Seeed-Studio/OSHW-Jetson-Series/README.md

# Open Source Hardware - NVIDIA Jetson Carrier Board

Copyright (c) [Seeed Studio](https://www.seeedstudio.com/). All rights reserved.

<div align="center">
    
</div>

## Overview

This project contains the open-source hardware design files for Seeed Studio's **NVIDIA Jetson hardware series** — including the `reComputer` and `reServer` carrier boards, mini PCs, and industrial computers based on **Jetson Nano, Jetson Xavier NX, Jetson Orin NX/Orin Nano, Jetson AGX Orin, and Jetson AGX Thor**.

For every product you will find its **BRD / DSN circuit design source files** (created in Cadence **Allegro 17.4**), **visualized PDF schematics**, plus the full supporting resource set: **datasheets, 3D models, mechanical drawings (DXF), user manuals, firmware, and certifications** (CE / EUDOC / FCC / KC / ROHS / REACH / UKDOC / UKCA).

## Product Matrix

### reComputer Jetson carrier boards & mini PCs

| Product | README | Highlights |
|---|---|---|
| [reComputer Industrial J201](/reComputer%20Jetson%20carrier%20board/reComputer%20Industrial%20J201/) | [README](/reComputer%20Jetson%20carrier%20board/reComputer%20Industrial%20J201/README.md) | Industrial carrier board for Jetson Xavier NX / TX2 NX |
| [reComputer Industrial J30-J40](/reComputer%20Jetson%20carrier%20board/reComputer%20Industrial%20J30-J40/) | — | Industrial carrier board series for Jetson Orin NX / Orin Nano |
| [reComputer J202](/reComputer%20Jetson%20carrier%20board/reComputer%20J202/) | [README](/reComputer%20Jetson%20carrier%20board/reComputer%20J202/README.md) | Carrier board for Jetson Xavier NX / TX2 NX |
| [reComputer J301-J401](/reComputer%20Jetson%20carrier%20board/reComputer%20J301-J401/) | — | Carrier board for Jetson Orin NX / Orin Nano |
| [reComputer J401](/reComputer%20Jetson%20carrier%20board/reComputer%20J401/) | [README](/reComputer%20Jetson%20carrier%20board/reComputer%20J401/README.md) | Carrier board for Jetson Orin NX / Orin Nano |
| [reComputer J401B](/reComputer%20Jetson%20carrier%20board/reComputer%20J401B/) | — | Carrier board for Jetson Orin NX / Orin Nano |
| [reComputer J101](/reComputer%20Jetson%20carrier%20board/reComputer%20J101/) | — | Carrier board for Jetson Nano / TX2 NX |
| [reComputer J1010](/reComputer%20Jetson%20carrier%20board/reComputer%20J1010/) | — | Carrier board & mini PC for Jetson Nano |
| [reComputer J1020 v2](/reComputer%20Jetson%20carrier%20board/reComputer%20J1020%20v2/) | — | Carrier board & mini PC for Jetson Xavier NX |
| [reComputer Classic J501](/reComputer%20Jetson%20carrier%20board/reComputer%20Classic%20J501/) | — | Carrier board for Jetson AGX Orin |
| [reComputer Mini J401](/reComputer%20Jetson%20carrier%20board/reComputer%20Mini%20J401/) | — | Mini PC for Jetson Orin NX / Orin Nano |
| [reComputer Mini J501](/reComputer%20Jetson%20carrier%20board/reComputer%20Mini%20J501/) | — | Mini PC for Jetson AGX Orin |
| [reComputer Robotics J401](/reComputer%20Jetson%20carrier%20board/reComputer%20Robotics%20J401/) | — | Robotics carrier board for Jetson Orin NX / Orin Nano |
| [reComputer Robotics J501](/reComputer%20Jetson%20carrier%20board/reComputer%20Robotics%20J501/) | — | Robotics carrier board for Jetson AGX Orin |
| [reComputer Robotics J601](/reComputer%20Jetson%20carrier%20board/reComputer%20Robotics%20J601/) | — | Robotics carrier board for Jetson AGX Thor |
| [reComputer Rugged J401](/reComputer%20Jetson%20carrier%20board/reComputer%20Rugged%20J401/) | — | Rugged carrier board for Jetson Orin NX / Orin Nano |
| [reComputer Super J401](/reComputer%20Jetson%20carrier%20board/reComputer%20Super%20J401/) | — | High-performance carrier board for Jetson Orin NX / Orin Nano |
| [reComputer A203 v2](/reComputer%20Jetson%20carrier%20board/reComputer%20A203%20v2/) | — | Mini PC for Jetson Orin Nano / Orin NX |
| [reComputer A205](/reComputer%20Jetson%20carrier%20board/reComputer%20A205/) | — | Mini PC for Jetson Orin NX |
| [reComputer A205E](/reComputer%20Jetson%20carrier%20board/reComputer%20A205E/) | — | Legacy A205E mini PC for Jetson Orin NX |
| [reComputer A206](/reComputer%20Jetson%20carrier%20board/reComputer%20A206/) | — | Mini PC for Jetson Orin NX / Orin Nano |
| [reComputer A608](/reComputer%20Jetson%20carrier%20board/reComputer%20A608/) | — | Mini PC for Jetson Orin NX / Orin Nano |
| [reComputer A203E](/reComputer%20Jetson%20carrier%20board/reComputer%20A203E/) | — | Legacy A203E mini PC for Jetson Orin Nano |
| [Mini AI Computer T906](/reComputer%20Jetson%20carrier%20board/Mini%20AI%20Computer%20T906/) | — | AI computer with Jetson Orin NX / Orin Nano |
| [Jetson SUB Mini PC](/reComputer%20Jetson%20carrier%20board/Jetson%20SUB%20Mini%20PC/) | — | Legacy Jetson SUB Mini PC |
| [Jetson Xavier AGX H01](/reComputer%20Jetson%20carrier%20board/Jetson%20Xavier%20AGX%20H01/) | — | Carrier board & dev kit for Jetson AGX Xavier |
| [Jetson-Mate](/reComputer%20Jetson%20carrier%20board/Jetson-Mate/) | — | Expansion board and accessory pack |

> 27 reComputer / mini-PC products above. Design-source carriers (BRD/DSN/PDF) are archived for the main boards; the remaining folders carry full asset sets (datasheet / 3D / schematic / firmware / certificates) per product.

### reServer Jetson carrier boards

| Product | README | Highlights |
|---|---|---|
| [reServer Industrial J401](/reServer%20Jetson%20carrier%20board/reServer%20Industrial%20J401/) | [README](/reServer%20Jetson%20carrier%20board/reServer%20Industrial%20J401/README.md) | Industrial carrier board for Jetson Orin NX / Orin Nano |
| [reServer Industrial J30-J40](/reServer%20Jetson%20carrier%20board/reServer%20Industrial%20J30-J40/) | — | Industrial carrier board series |
| [reServer Industrial J501](/reServer%20Jetson%20carrier%20board/reServer%20Industrial%20J501/) | — | Industrial carrier board for Jetson AGX Orin |
| [reServer J2032](/reServer%20Jetson%20carrier%20board/reServer%20J2032/) | [README](/reServer%20Jetson%20carrier%20board/reServer%20J2032/README.md) | Carrier board for Jetson Xavier NX / TX2 NX |

## Repository Structure

```
.
├── LICENSE
├── README.md
├── reComputer Jetson carrier board/   # one folder per reComputer product
│   ├── <product>/
│   │   ├── README.md                  # product overview (for main boards)
│   │   ├── Datasheet/                 # datasheets & pin descriptions
│   │   ├── Schematic/                 # DSN sources + PDF schematics
│   │   ├── Layout/                    # BRD layout files + PDF previews
│   │   ├── 3D Model/                  # STP / STL 3D models
│   │   ├── Mechanical/                # DXF mechanical drawings
│   │   ├── Manual/                    # user manuals, assembly & reference guides
│   │   ├── Firmware/                  # firmware / driver packages
│   │   └── Certificate/               # CE / EUDOC / FCC / KC / ROHS / REACH / UKDOC / UKCA
│   └── Jetpack resource bundles       # flash & peripheral assets (per product)
└── reServer Jetson carrier board/     # one folder per reServer product
    └── <product>/                     # same structure as reComputer
```

> **Note on large files:** 3D CAD files larger than GitHub's 100 MiB per-file limit are shipped compressed as `.stp.gz` / `.step.gz` (same content, ~5–10× smaller) — e.g. `reServer Industrial J501/…/RESERVER_AGX_ORIN_CARRIER_BOARD.stp.gz` and `reComputer Robotics J601/…/reComputer_J601.step.gz`.

## Open-Hardware Design Files

The design files were prepared in Cadence **Allegro 17.4**. Per main carrier board:

- **BRD** and **PDF** files → product **`/Layout`** subdirectory
- **DSN** files → product **`/Schematic`** subdirectory
- **PDF** visualized schematics → product **`/Schematic`** subdirectory

## Product Documentation

Beyond the open-hardware design files, every product folder archives the complete supporting documentation:

- **Datasheet/** — official datasheets, pin descriptions, carrier-board specifications
- **3D Model/** — STEP / STL mechanical models of boards and mini PCs
- **Mechanical/** — DXF drawings (outline, mounting holes, connectors)
- **Manual/** — getting-started, assembly, and reference guides
- **Firmware/** — BSP / driver / flashing packages per board
- **Certificate/** — per-SKU compliance certificates (CE, EUDOC, FCC, KC, ROHS, REACH, UKDOC, UKCA)

See the [project wiki](https://wiki.seeedstudio.com/NVIDIA_Jetson/) for the full hardware-interfaces and flashing documentation for each product.

## Related Links

- **[Wiki]** [reComputer J202 carrier board](https://wiki.seeedstudio.com/reComputer_J2021_J202_Flash_Jetpack/)
- **[Wiki]** [reComputer J401 carrier board](https://wiki.seeedstudio.com/J401_carrierboard_Hardware_Interfaces_Usage/)
- **[Wiki]** [reComputer Industrial Getting Started](https://wiki.seeedstudio.com/reComputer_Industrial_Getting_Started/)
- **[Wiki]** [reServer Industrial Getting Started](https://wiki.seeedstudio.com/reServer_Industrial_Getting_Started/)
- **[Wiki]** [reServer J2032 Getting Started](https://wiki.seeedstudio.com/reServer_J2032_Getting_Started/)
- **[Course]** [YOLOv8 on NVIDIA Jetson](https://wiki.seeedstudio.com/YOLOv8-DeepStream-TRT-Jetson/)
- **[Course]** [Custom Local LLM](https://wiki.seeedstudio.com/Finetune_LLM_on_Jetson/)
- **[Course]** [Local Voice Chatbot](https://wiki.seeedstudio.com/Local_Voice_Chatbot/)
- **[Course]** [A-LOAM 3D SLAM](https://wiki.seeedstudio.com/a_loam/)
- **[🛒 Buy]** [reComputer industrial J201](https://www.seeedstudio.com/reComputer-Industrial-J2012-p-5685.html)
- **[🛒 Buy]** [reComputer J202](https://www.seeedstudio.com/reComputer-J202-Carrier-Board-for-Jetson-Xavier-NX-p-5397.html)
- **[🛒 Buy]** [reComputer J401](https://www.seeedstudio.com/reComputer-J401-Carrier-Board-for-Jetson-Orin-NX-Orin-Nano-p-5636.html)
- **[🛒 Buy]** [reServer industrial J401](https://www.seeedstudio.com/reServer-industrial-J4012-p-5747.html)
- **[🛒 Buy]** [reServer J2032](https://www.seeedstudio.com/reServer-Jetson-20-1-H2-p-5337.html)

## Customization

Seeed Agile ODM Service empowers device makers and integrators with our customizable services tailored to their specific hardware needs. Learn more at **https://www.seeedstudio.com/odm**

### Seeed ODM Custom Design for NVIDIA Jetson includes:
- **Modify form factors**
- **Image flashing**
- **Customize logo**

## Licensing

This project is published under the [Apache-2.0](./LICENSE) license.
