Seeed-Studio/OSHW-Jetson-Series/reComputer Jetson carrier board/reComputer J401/README.md

# reComputer J401 - Carrier Board for Jetson Orin NX/Orin Nano

Copyright (c) [Seeed Studio](https://www.seeedstudio.com/). All rights reserved.

<div align="center">
    
</div>

## KeyFeatures
- **Exceptional Performance Carrier Board**: Support the NVIDIA Jetson Orin NX/Orin Nano module, leveraging powerful computing power to take on tough tasks with ease.
- **Versatile Connectivity**: Offer 1x Gigabit Ethernet port for networking, 4x USB 3.2 Type-A (10Gbps) ports,1x USB2.0 Type-C port, 1x CAN connector for fast data transfer.
- **Flexible Storage and Wireless Expansion**: Mount with 1x M.2 Key M 2280 and 1x M.2 Key E slots, offering ample space for flexible storage and wireless connectivity expansion.
- **Advanced Peripherals Supported**: Assemble 2x 15 pins CSI camera connector, 1x HDMI 2.1, 1x fan, 1x RTC for multiple peripherals.
- **Wide Range of Input Voltages**: From 9-19V DC, providing flexibility in power supply options.
- **Flexible [Customization](https://www.seeedstudio.com/odm.html)**: inlcudes changing accessories modules, logo, and hardware interfaces modification based on original design.

## Project structure 
The main directory contains subdirectories for reComputer and reServer hardware open-source files, a **LICENSE** file, and a **README** file. The subdirectories reComputer and reServer provide the **BRD**, **DSN** circuit design source files, and visualized **PDF** schematic files for the following five carrier boards. 

Specifically, 
- the **BRD** and **PDF** files are placed in the each product's **/Layout** subdirectory, 
- the **DSN** files in the each product's **/Schematic** subdirectory.

The design files were preapared in Cadence **Allegro 17.4**.

## Related Links
For more information on the carrier board, please refer to the following links:
- **[Wiki]** [reComputer J202 carrier board](https://wiki.seeedstudio.com/reComputer_J2021_J202_Flash_Jetpack/);
- **[Wiki]** [reComputer J401 carrier board](https://wiki.seeedstudio.com/J401_carrierboard_Hardware_Interfaces_Usage/);
- **[Wiki]** [reComputer Industrial Getting Started](https://wiki.seeedstudio.com/reComputer_Industrial_Getting_Started/);
- **[Wiki]** [reServer Industrial Getting Started](https://wiki.seeedstudio.com/reServer_Industrial_Getting_Started/);
- **[Wiki]** [reServer J2032 Getting Started](https://wiki.seeedstudio.com/reServer_J2032_Getting_Started/);
- **[Course]** [YOLOv8 on NVIDIA Jetson](https://wiki.seeedstudio.com/YOLOv8-DeepStream-TRT-Jetson/)
- **[Course]** [Custom Local LLM](https://wiki.seeedstudio.com/Finetune_LLM_on_Jetson/)
- **[Course]** [Local Voice Chatbot](https://wiki.seeedstudio.com/Local_Voice_Chatbot/)
- **[Course]** [A-LOAM 3D SLAM](https://wiki.seeedstudio.com/a_loam/)
- **[🛒Buy]** [reComputer industrial J201](https://www.seeedstudio.com/reComputer-Industrial-J2012-p-5685.html);
- **[🛒Buy]**[reComputer J202](https://www.seeedstudio.com/reComputer-J202-Carrier-Board-for-Jetson-Xavier-NX-p-5397.html);
- **[🛒Buy]**[reComputer J401](https://www.seeedstudio.com/reComputer-J401-Carrier-Board-for-Jetson-Orin-NX-Orin-Nano-p-5636.html);
- **[🛒Buy]**[reServer industrial J401](https://www.seeedstudio.com/reServer-industrial-J4012-p-5747.html);
- **[🛒Buy]**[reServer J2032](https://www.seeedstudio.com/reServer-Jetson-20-1-H2-p-5337.html);

## Customization 
Seeed Agile ODM Service empowers device makers and integrators with our customizable services tailored to their specific hardware needs. Learn more at **https://www.seeedstudio.com/odm**

### Seeed ODM Custom Design for NVIDIA Jetson includes:
- **Modify form factors;**
- **Image flashing;**
- **Customize logo**

## Licensing
This project is published under the [Apache-2.0](../../LICENSE) license.
