Seeed-Studio/OSHW-Jetson-Series/reComputer Jetson carrier board/Jetson SUB Mini PC/Certificate/102110637-CE.pdf

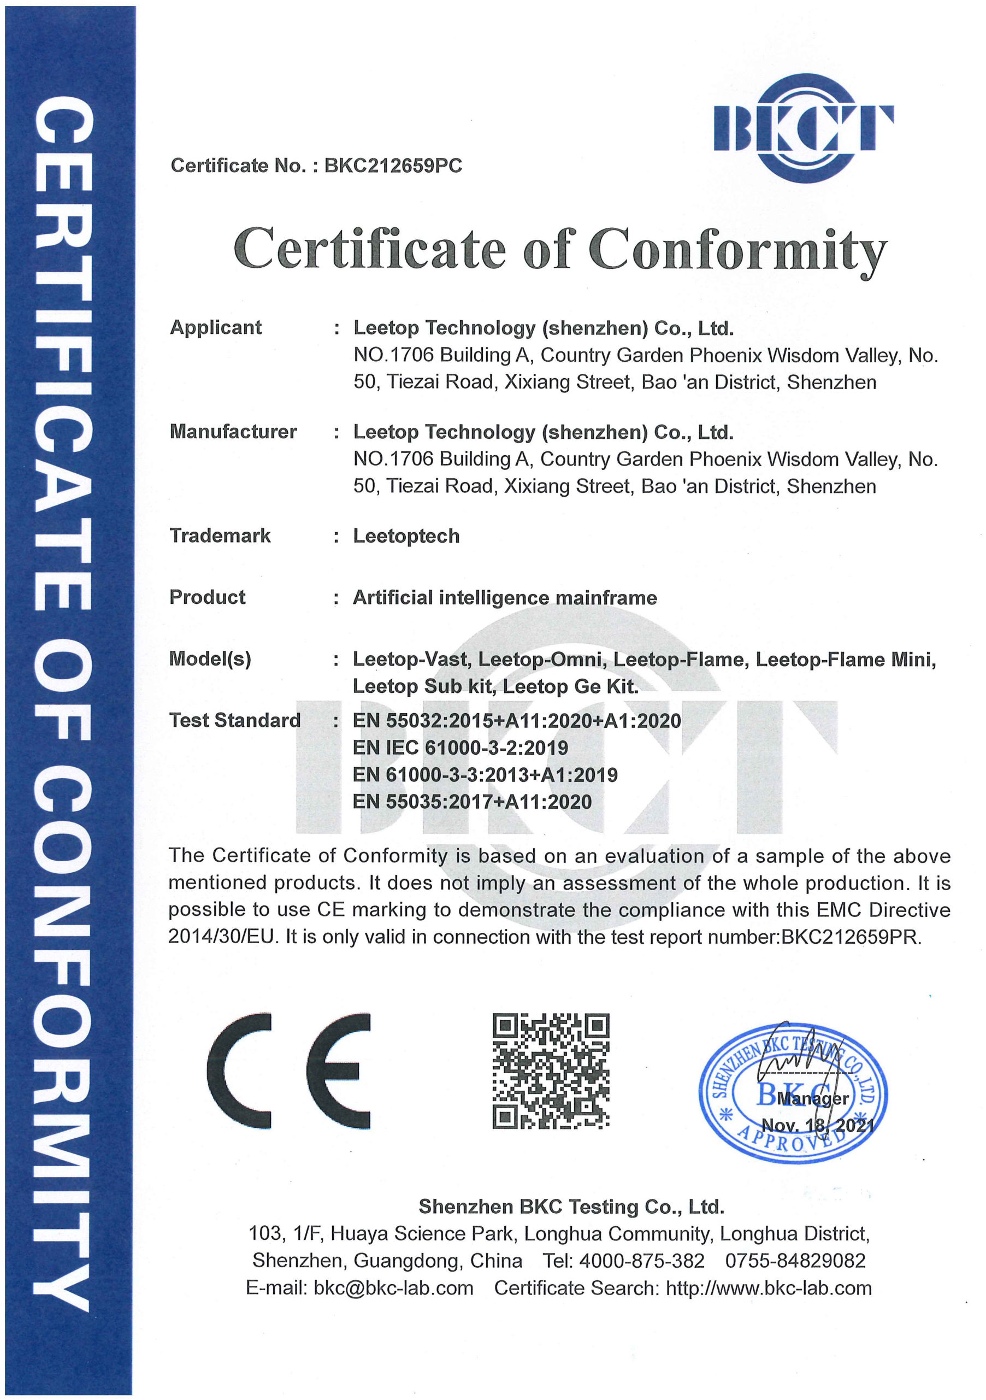
[picture p1: page 1]
