Seeed-Studio/OSHW-Jetson-Series/reComputer Jetson carrier board/Jetson SUB Mini PC/Certificate/102110637-EUDOC.pdf

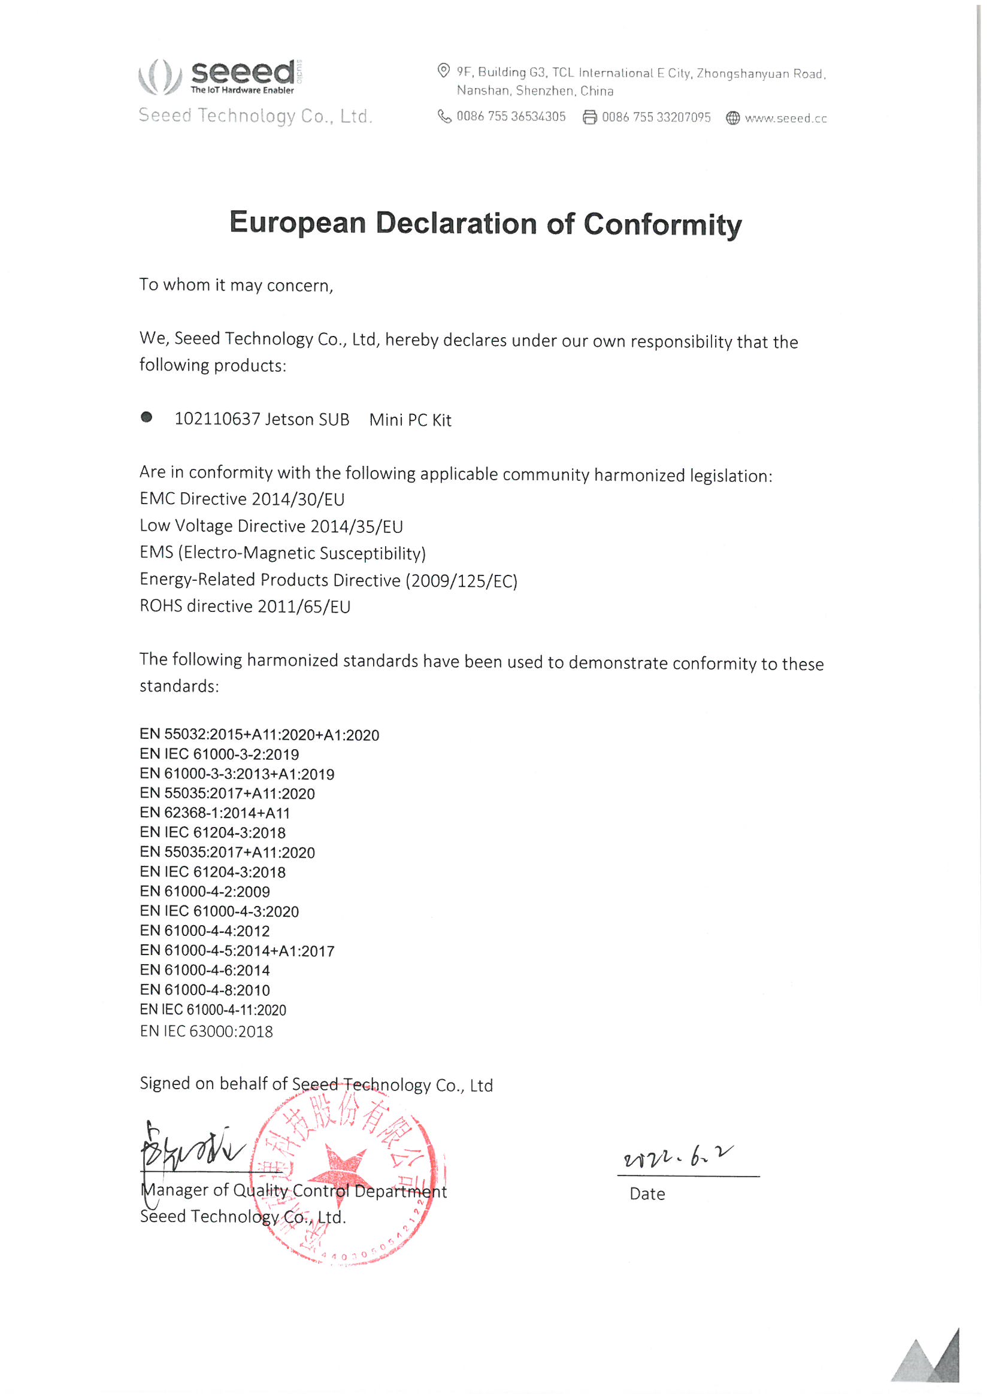
[picture p2: page 1]
