Seeed-Studio/OSHW-Jetson-Series/reComputer Jetson carrier board/Jetson SUB Mini PC/Certificate/102110637-FCC.pdf

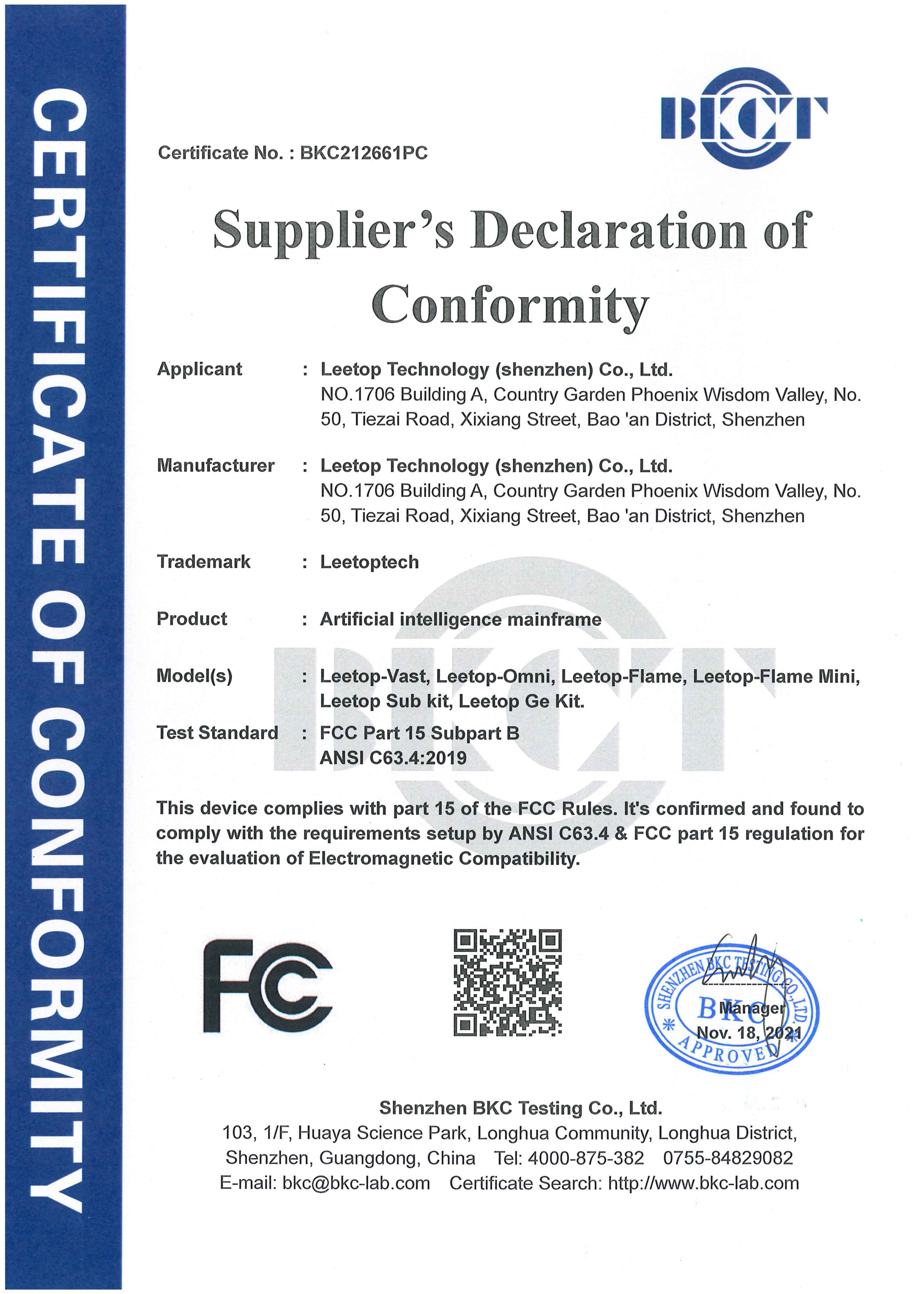
[picture p3: page 1]
