Seeed-Studio/OSHW-Jetson-Series/reComputer Jetson carrier board/Jetson SUB Mini PC/Certificate/102110637-UKDOC.pdf

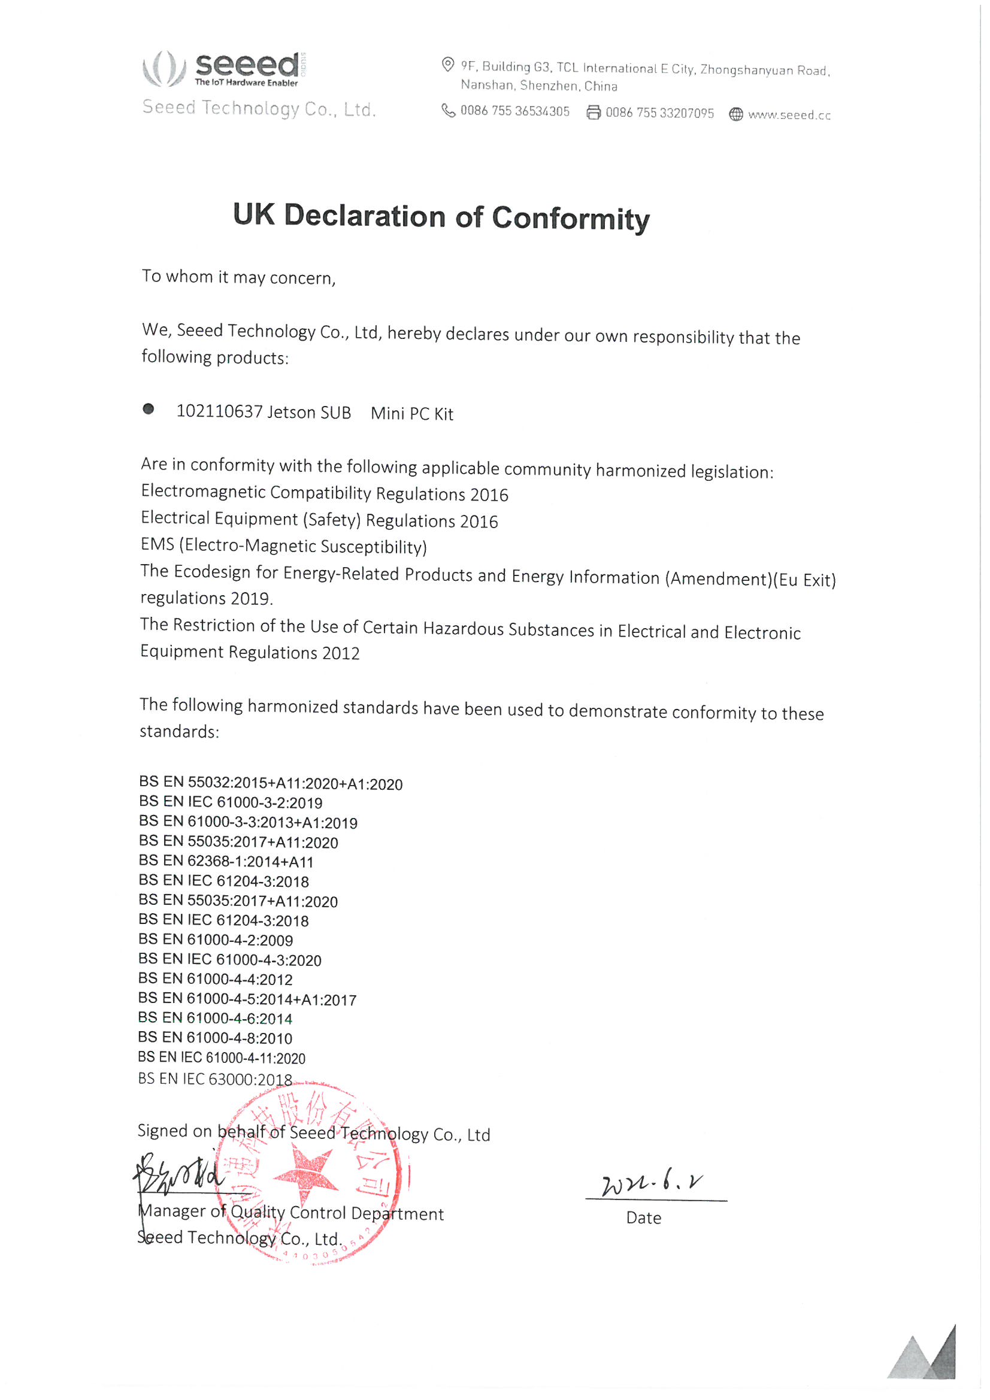
[picture p4: page 1]
