Seeed-Studio/OSHW-Jetson-Series/reComputer Jetson carrier board/Jetson Xavier AGX H01/Certificate/110991666-EUDOC.pdf

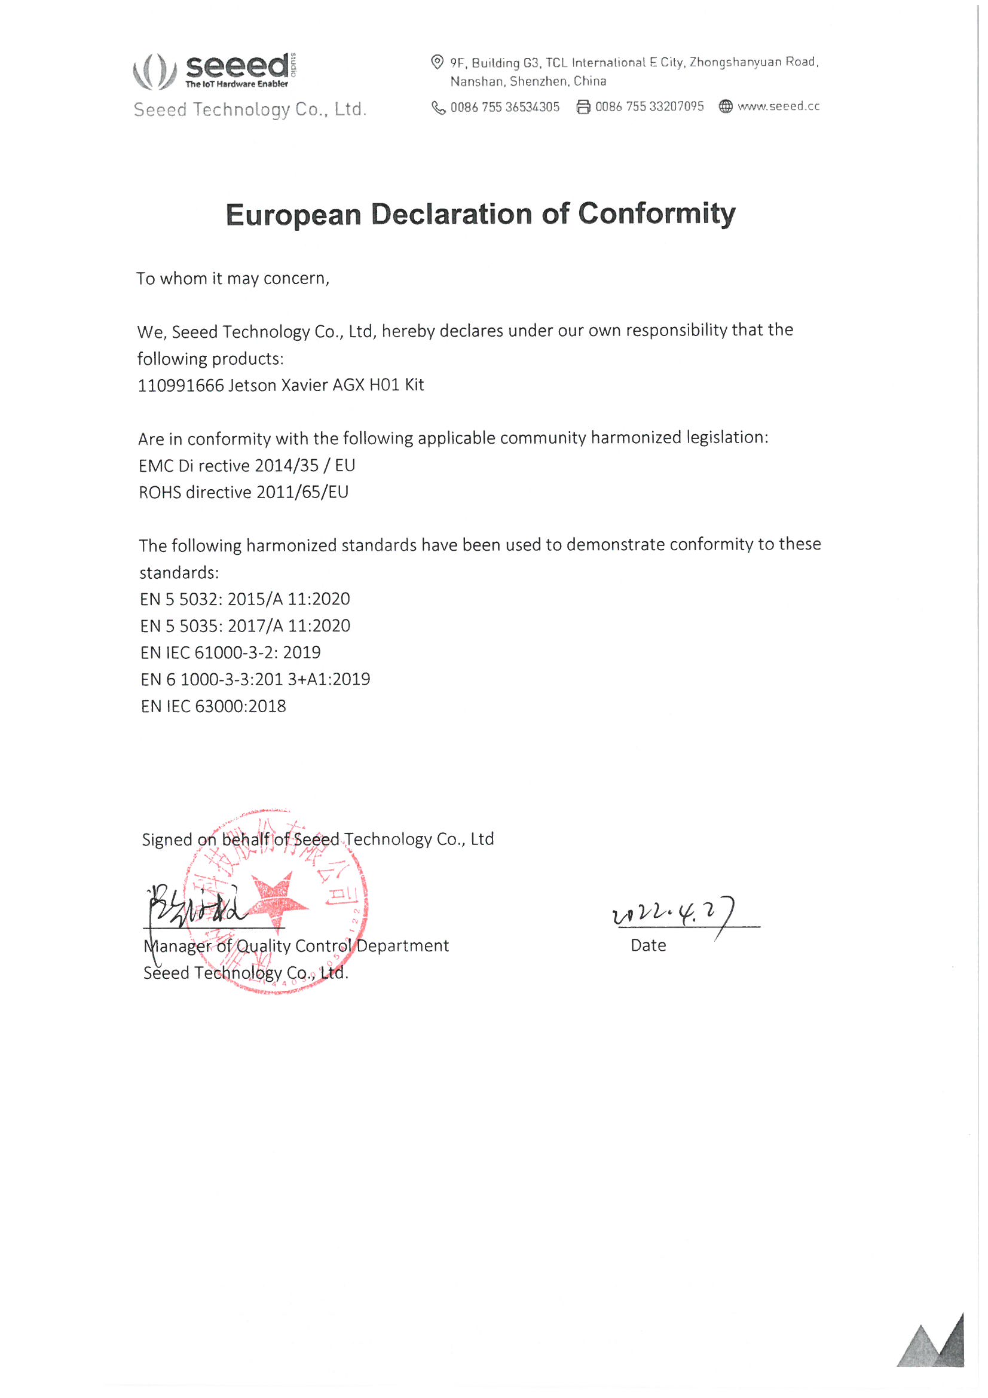
[picture p5: page 1]
