Seeed-Studio/OSHW-Jetson-Series/reComputer Jetson carrier board/Jetson Xavier AGX H01/Certificate/110991666-UKDOC.pdf

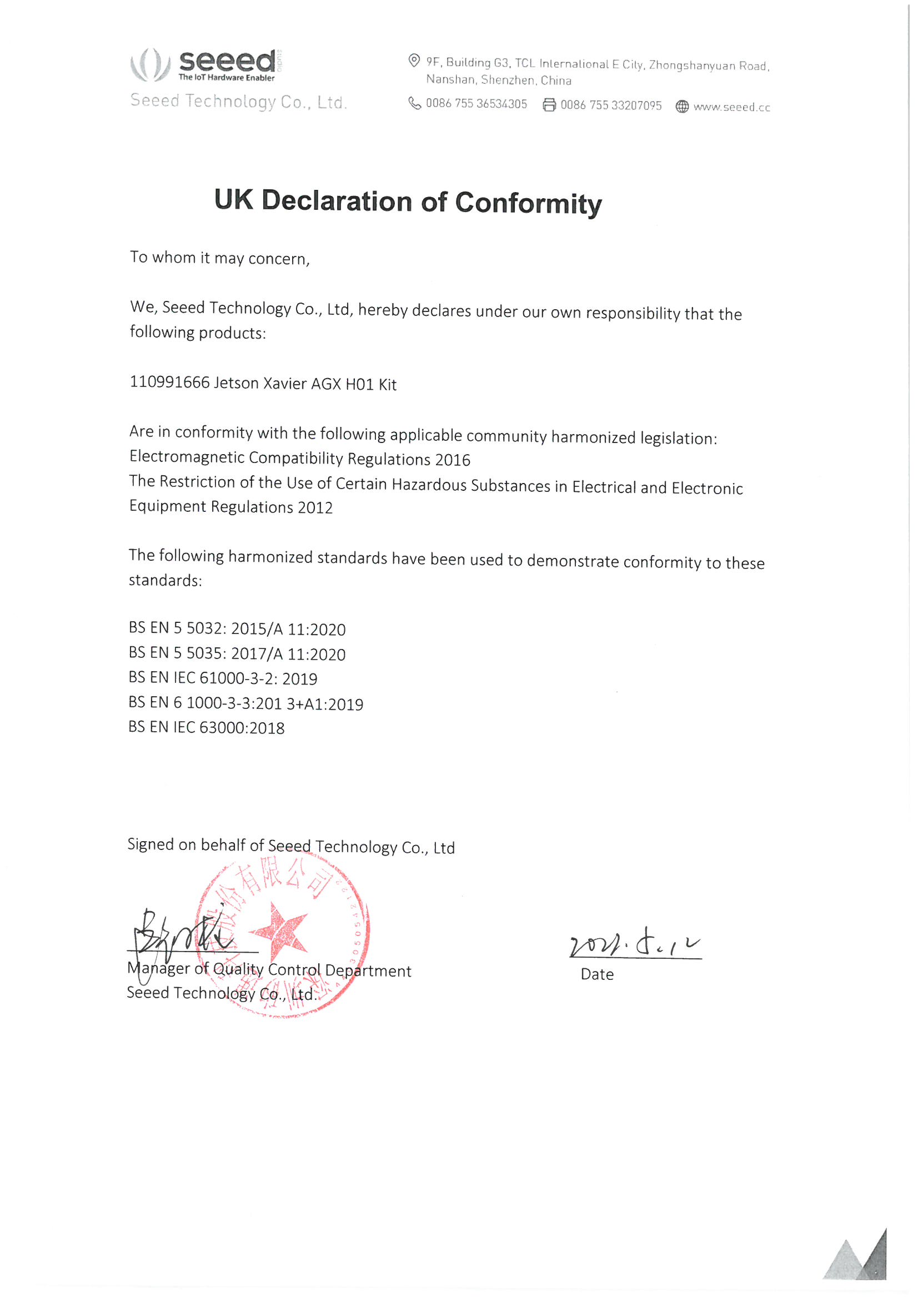
[picture p6: page 1]
