Seeed-Studio/OSHW-Jetson-Series/reComputer Jetson carrier board/Jetson Xavier AGX H01/Certificate/114110207-CE.pdf

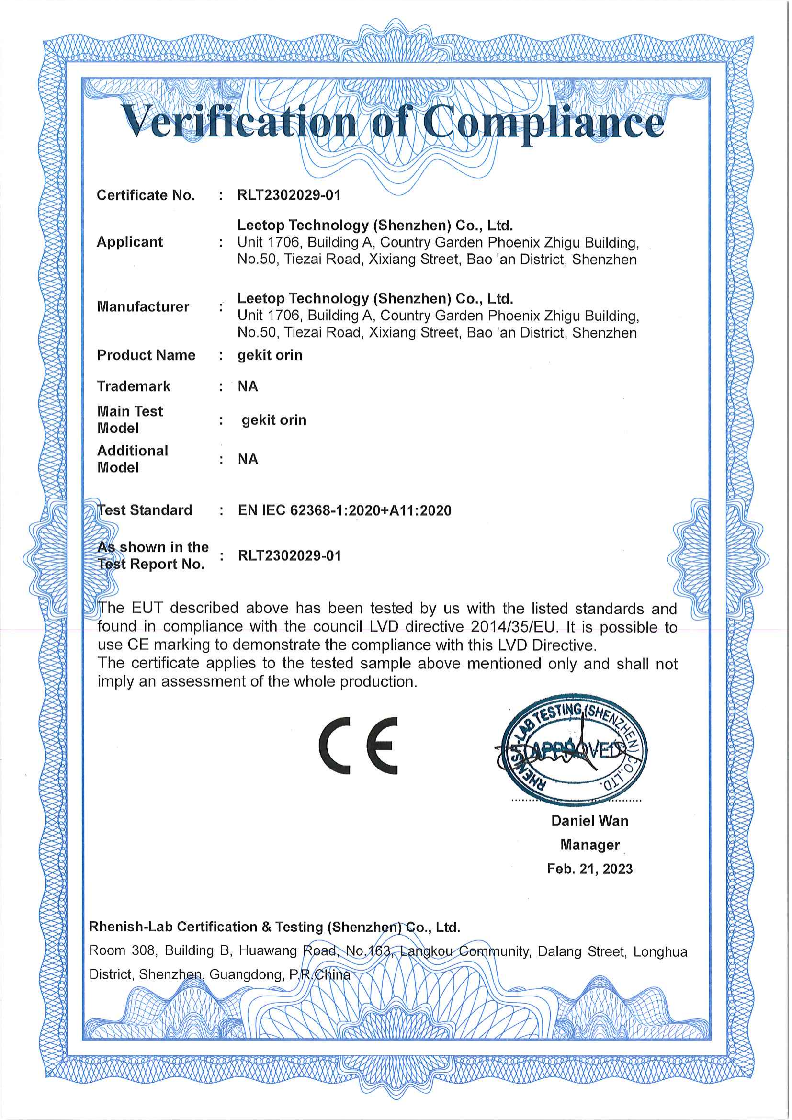
[picture p7: page 1]
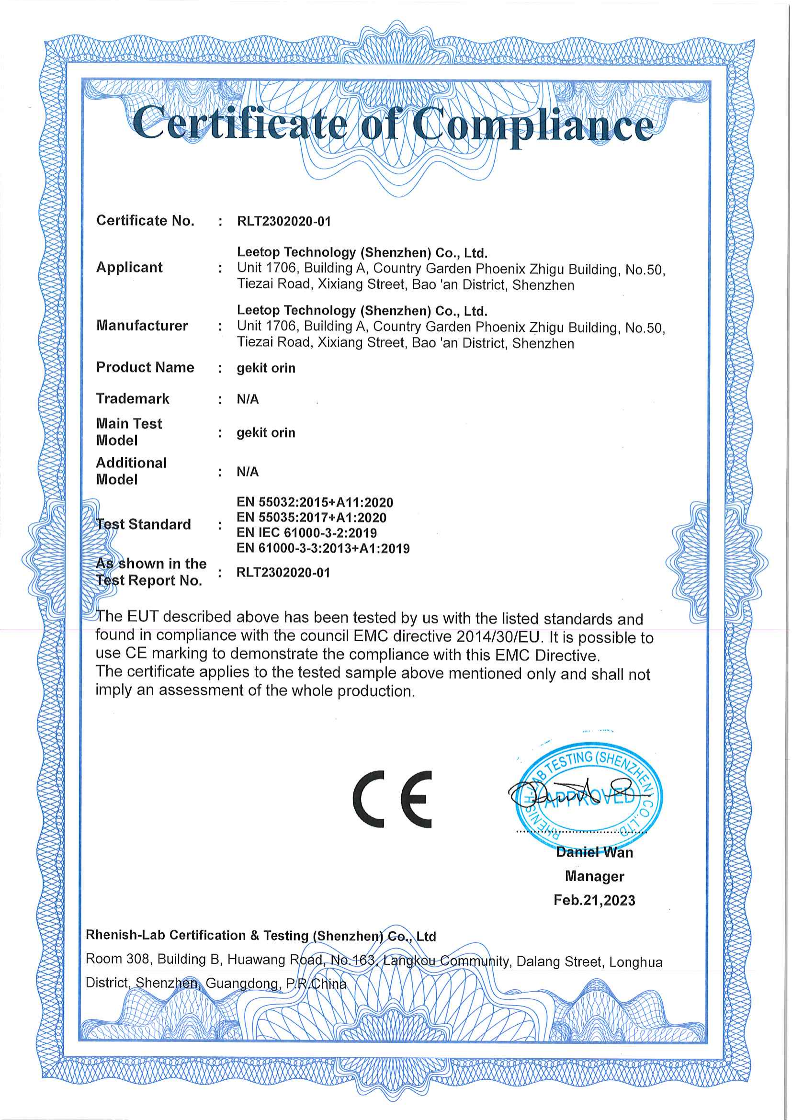
[picture p8: page 2]
