Seeed-Studio/OSHW-Jetson-Series/reComputer Jetson carrier board/Jetson Xavier AGX H01/Certificate/114110207-EUDOC.pdf

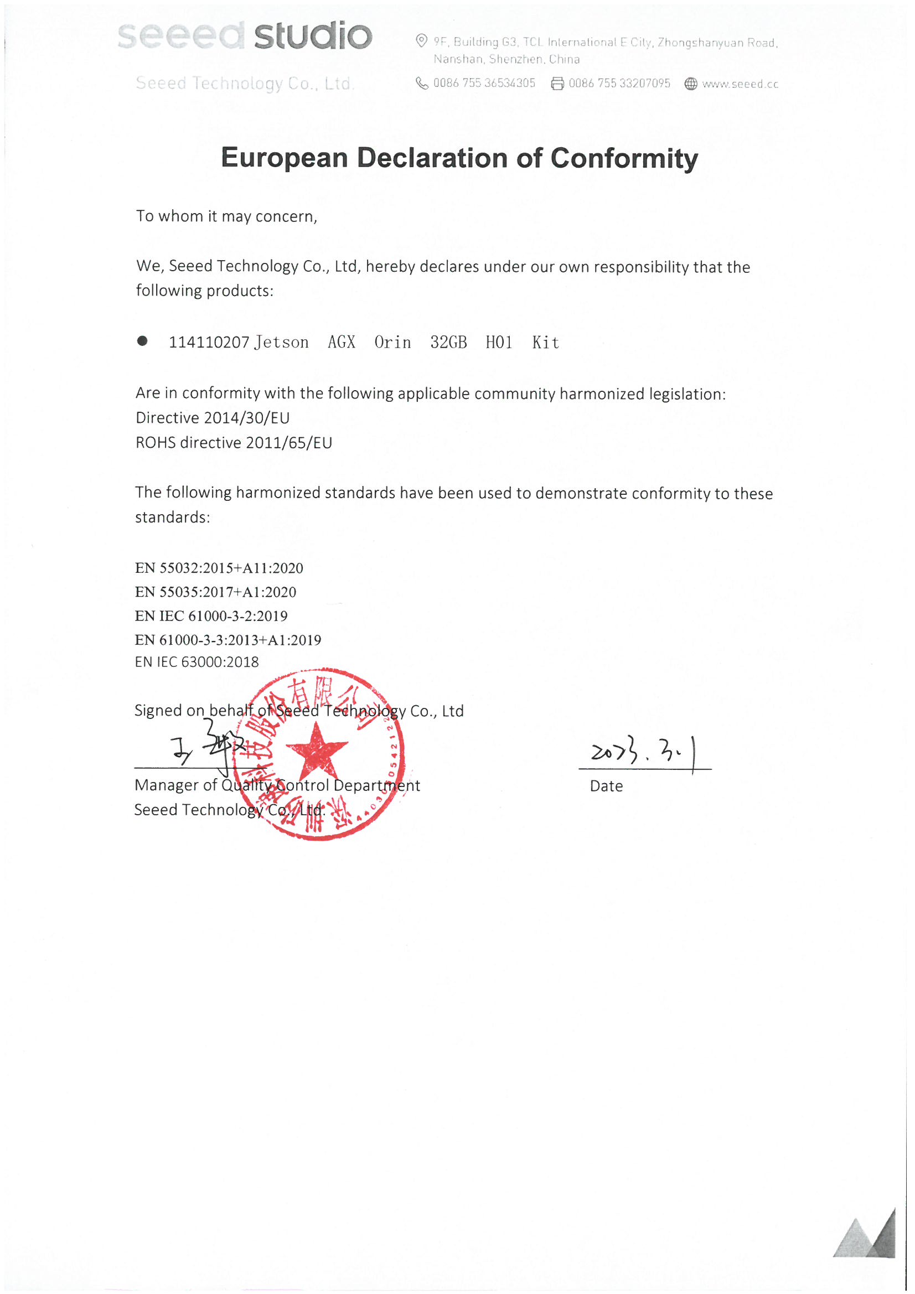
[picture p9: page 1]
