Seeed-Studio/OSHW-Jetson-Series/reComputer Jetson carrier board/Jetson Xavier AGX H01/Certificate/114110207-FCC.pdf

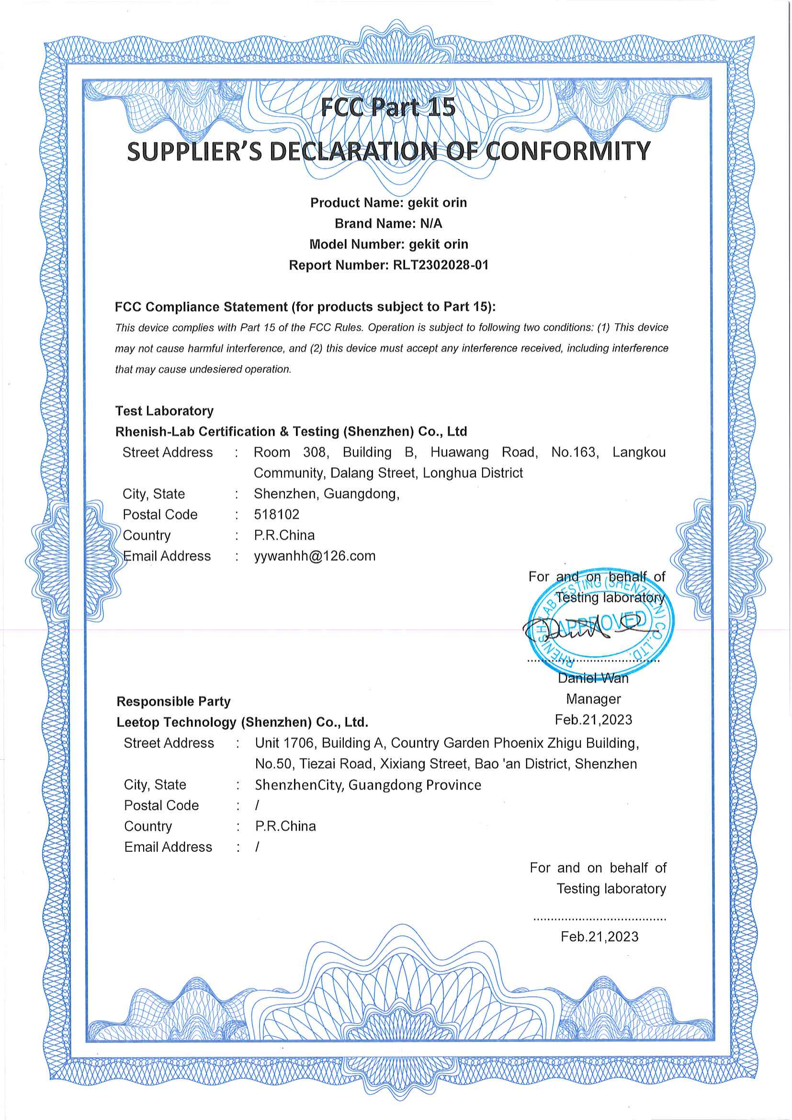
[picture p10: page 1]
