Seeed-Studio/OSHW-Jetson-Series/reComputer Jetson carrier board/Jetson Xavier AGX H01/Certificate/114110207-ROHS.pdf

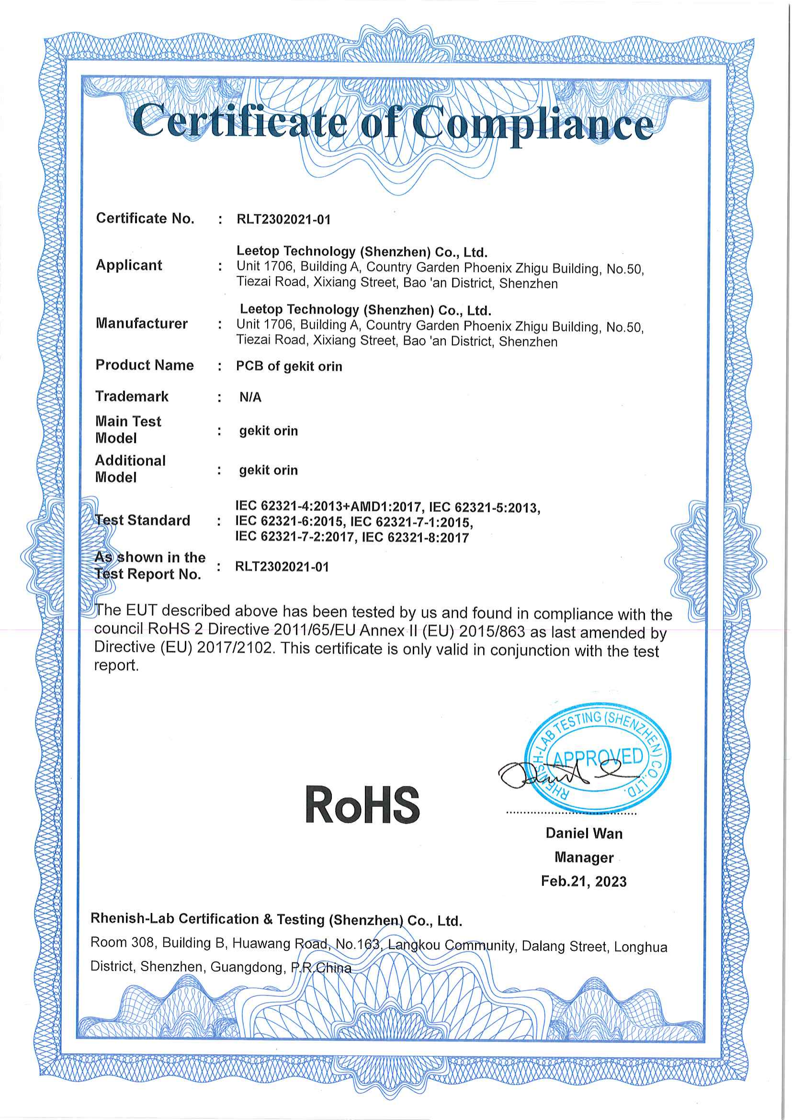
[picture p11: page 1]
