Seeed-Studio/OSHW-Jetson-Series/reComputer Jetson carrier board/reComputer A203 v2/Certificate/103110043-CE.pdf

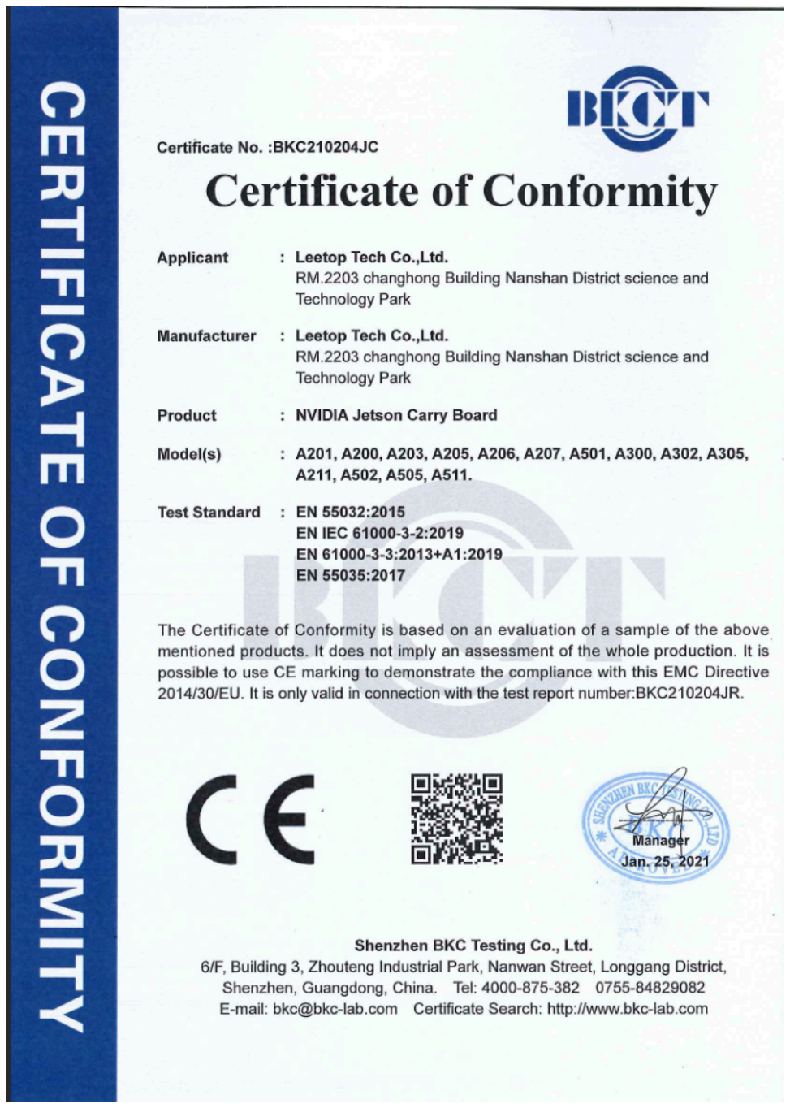
[picture p12: page 1]
