Seeed-Studio/OSHW-Jetson-Series/reComputer Jetson carrier board/reComputer A203 v2/Certificate/103110043-EUDOC.pdf

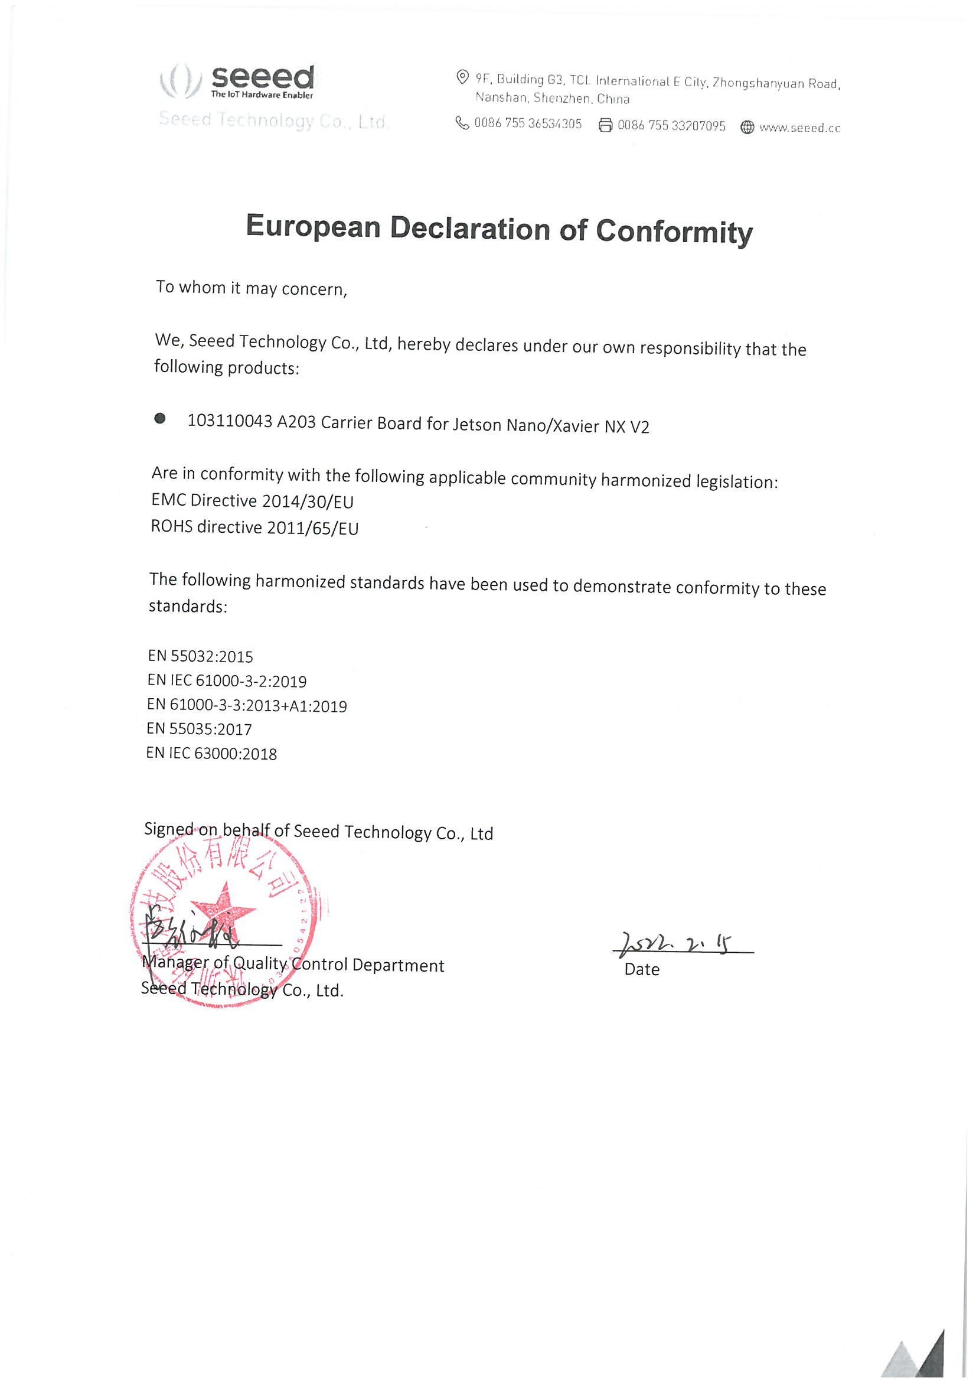
[picture p13: page 1]
