Seeed-Studio/OSHW-Jetson-Series/reComputer Jetson carrier board/reComputer A203 v2/Certificate/103110043-FCC.pdf

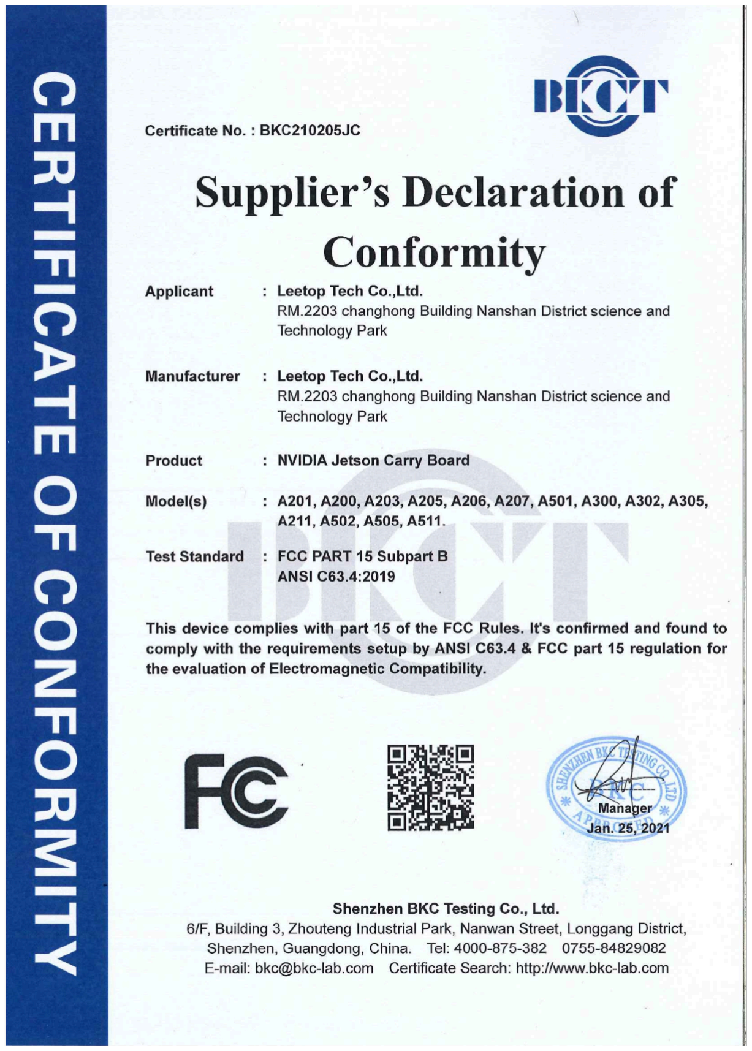
[picture p14: page 1]
