Seeed-Studio/OSHW-Jetson-Series/reComputer Jetson carrier board/reComputer A203 v2/Certificate/103110043-UKDOC.pdf

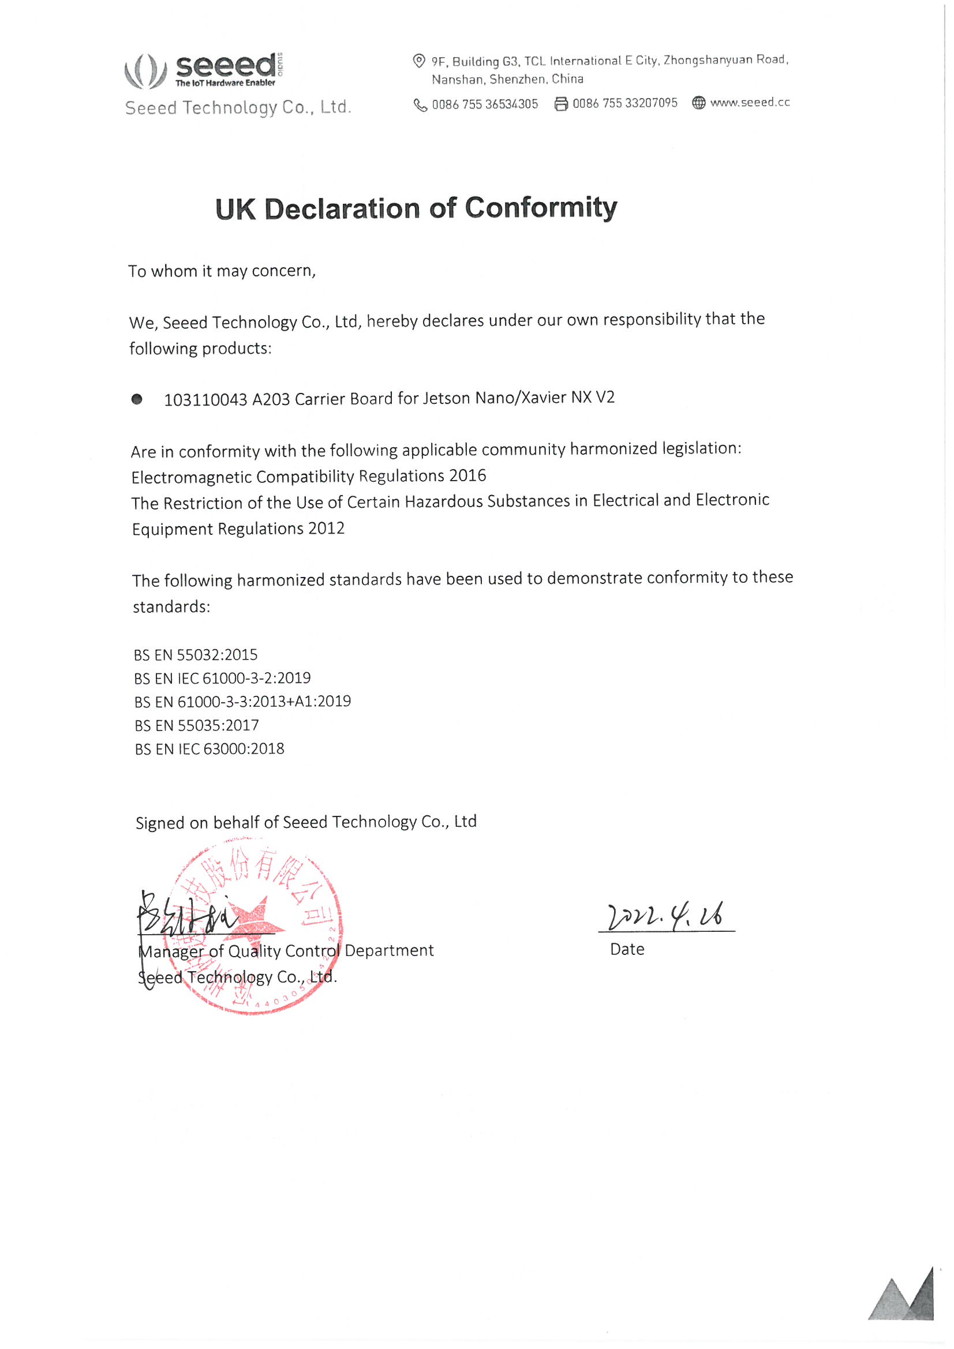
[picture p15: page 1]
