Seeed-Studio/OSHW-Jetson-Series/reComputer Jetson carrier board/reComputer A203 v2/Certificate/114110049-EUDOC.pdf

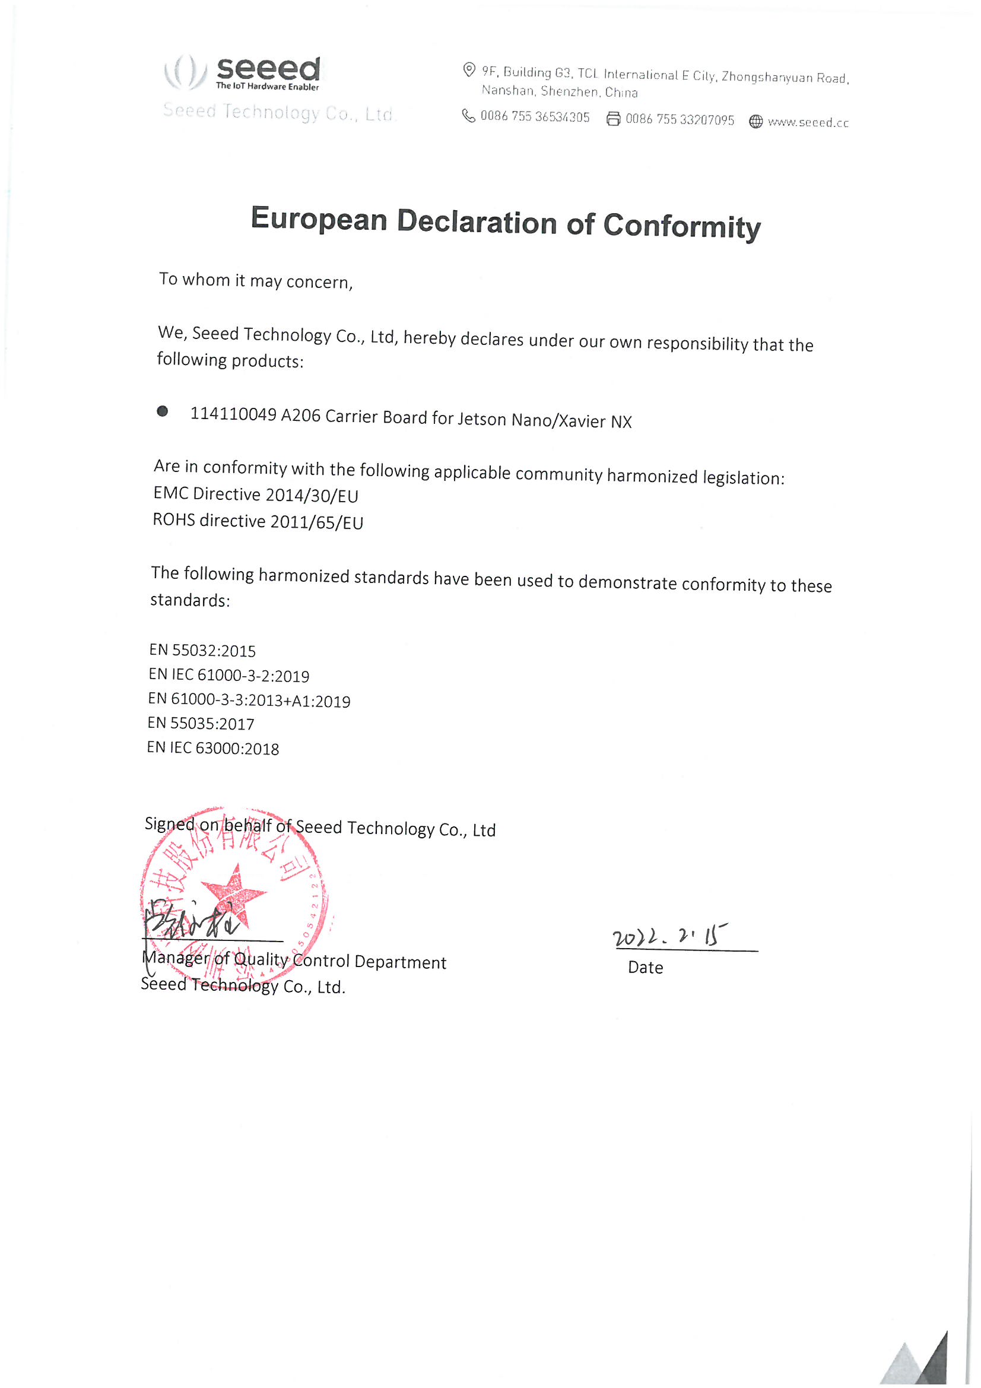
[picture p16: page 1]
