Seeed-Studio/OSHW-Jetson-Series/reComputer Jetson carrier board/reComputer A203 v2/Certificate/114110049-UKDOC.pdf

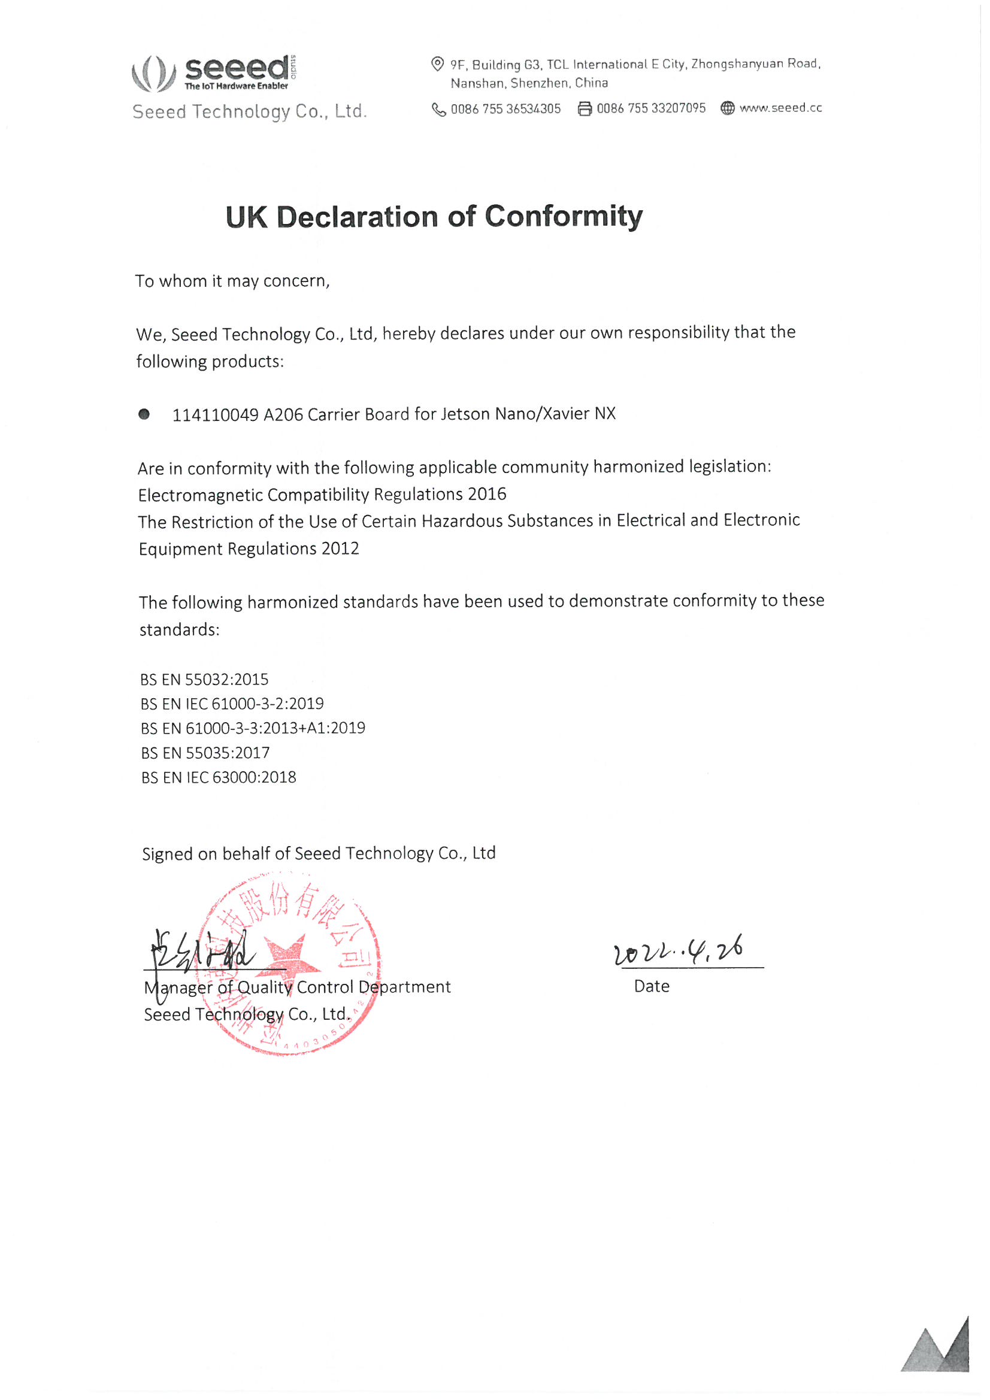
[picture p17: page 1]
