Seeed-Studio/OSHW-Jetson-Series/reComputer Jetson carrier board/reComputer A205/Certificate/114110048-EUDOC.pdf

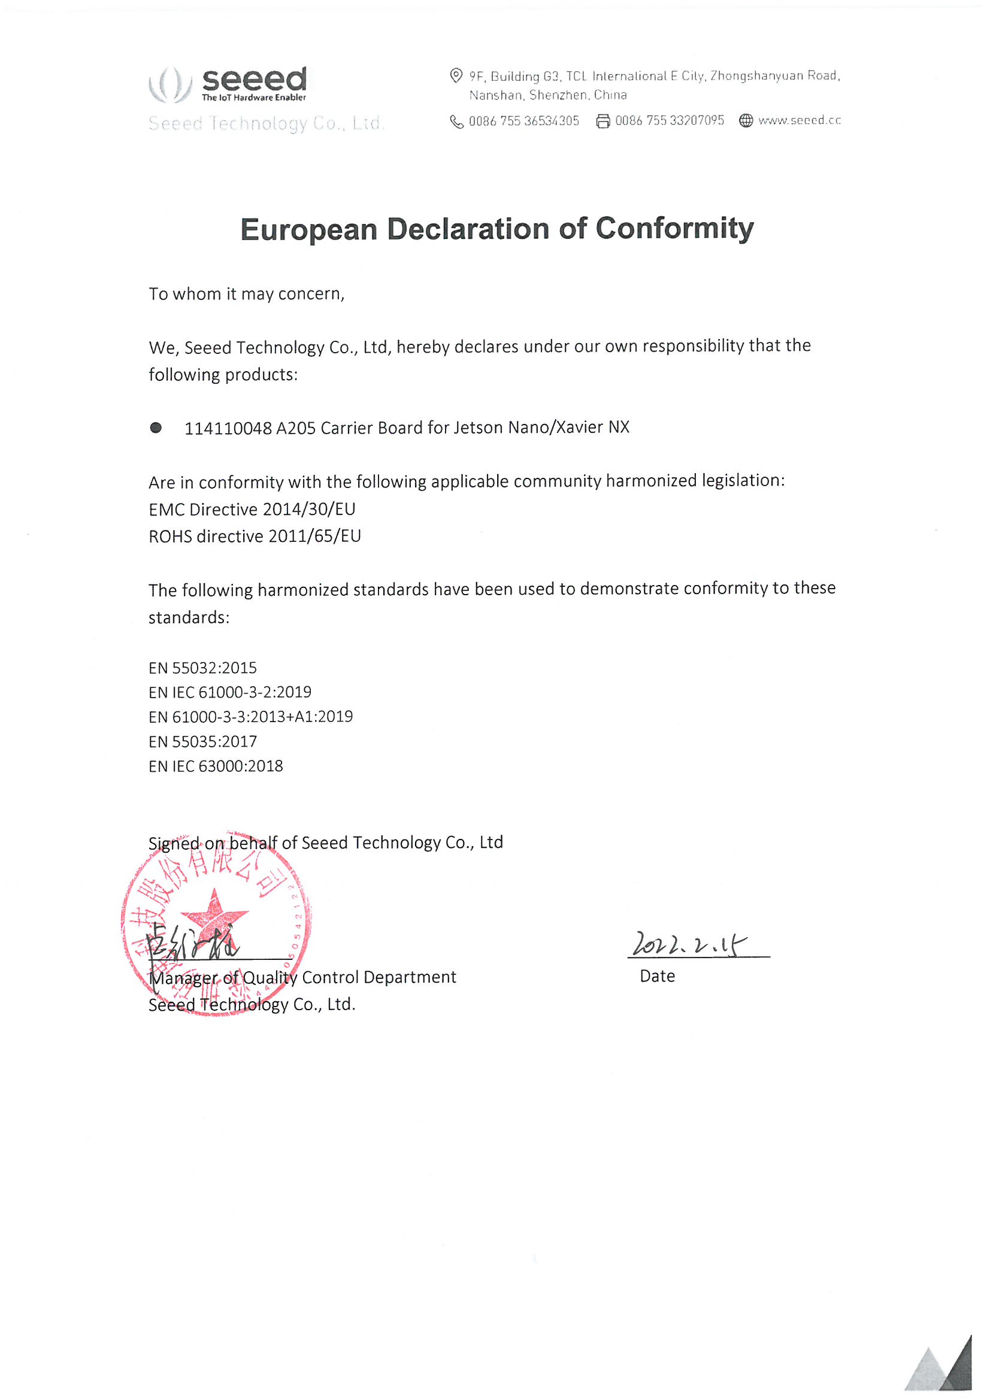
[picture p18: page 1]
