Seeed-Studio/OSHW-Jetson-Series/reComputer Jetson carrier board/reComputer A205/Certificate/114110048-UKDOC.pdf

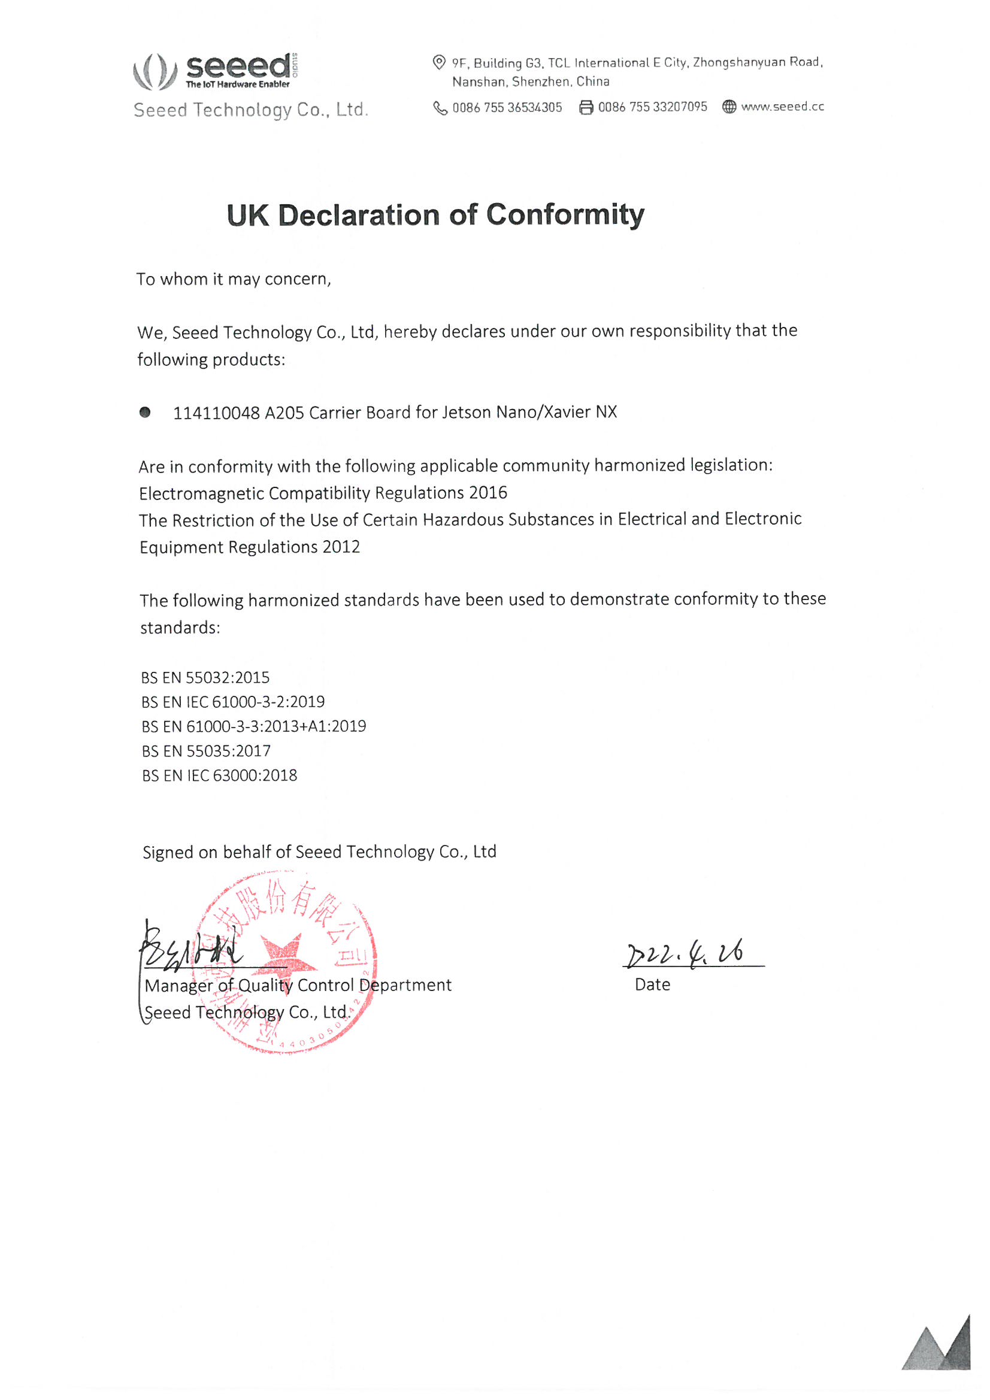
[picture p19: page 1]
