Seeed-Studio/OSHW-Jetson-Series/reComputer Jetson carrier board/reComputer A608/Certificate/102110840-CE.pdf

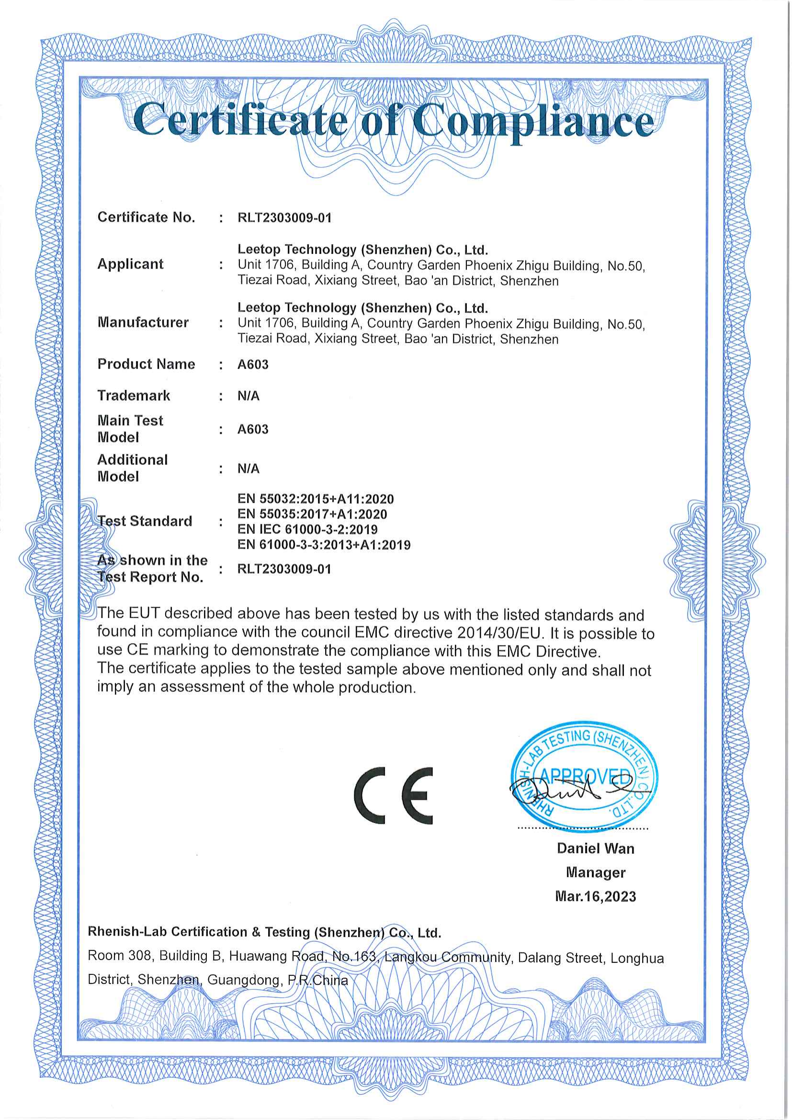
[picture p20: page 1]
