Seeed-Studio/OSHW-Jetson-Series/reComputer Jetson carrier board/reComputer A608/Certificate/102110840-EUDOC.pdf

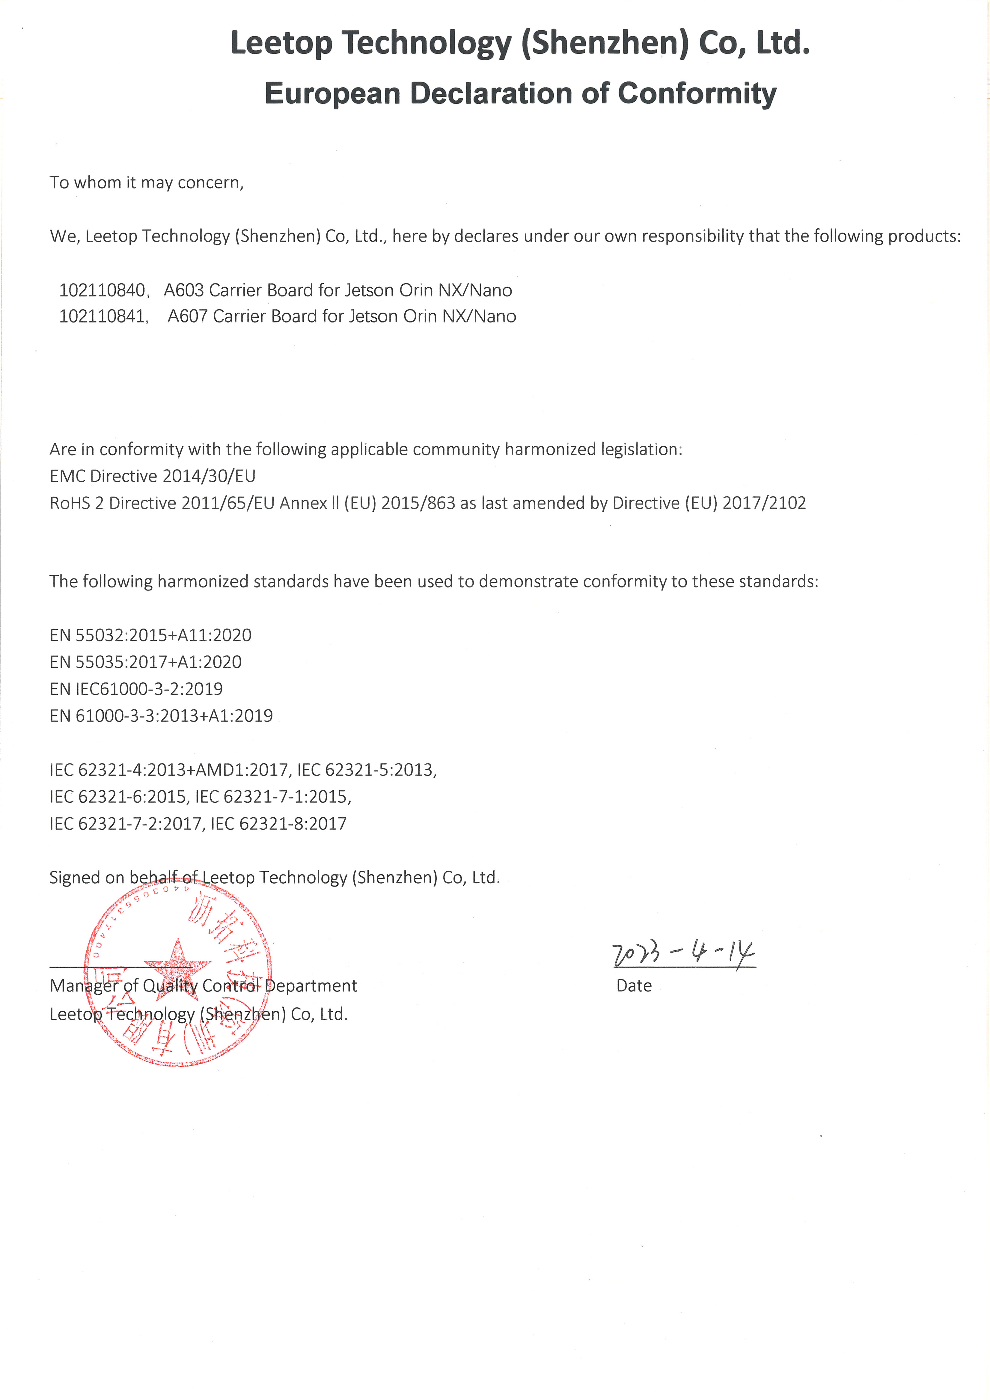
[picture p21: page 1]
