Seeed-Studio/OSHW-Jetson-Series/reComputer Jetson carrier board/reComputer A608/Certificate/102110840-ROHS.pdf

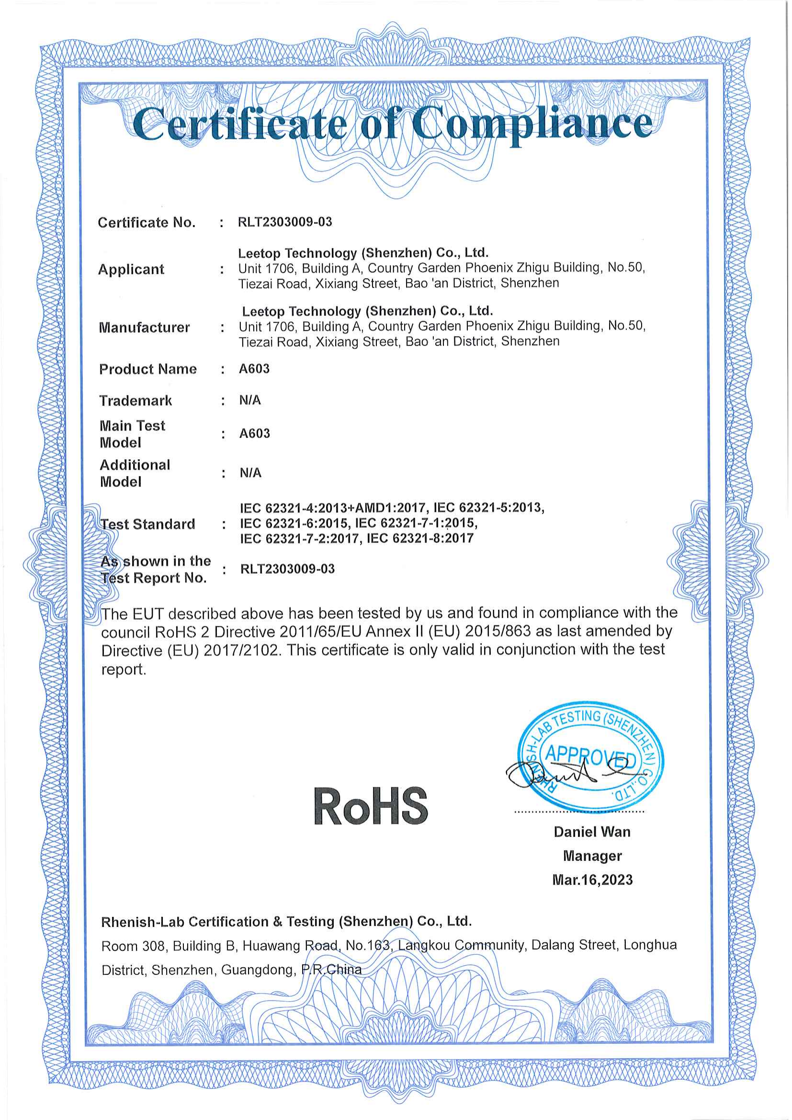
[picture p22: page 1]
