Seeed-Studio/OSHW-Jetson-Series/reComputer Jetson carrier board/reComputer A608/Certificate/102110841-CE.pdf

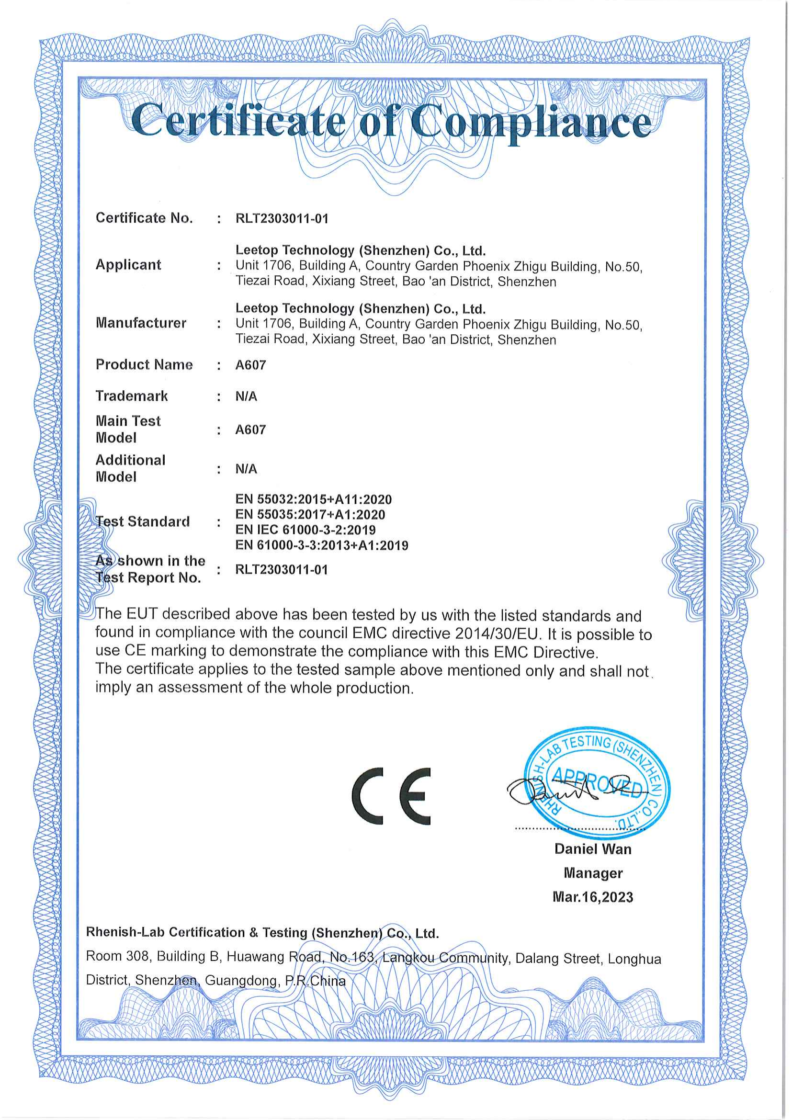
[picture p23: page 1]
