Seeed-Studio/OSHW-Jetson-Series/reComputer Jetson carrier board/reComputer A608/Certificate/102110841-ROHS.pdf

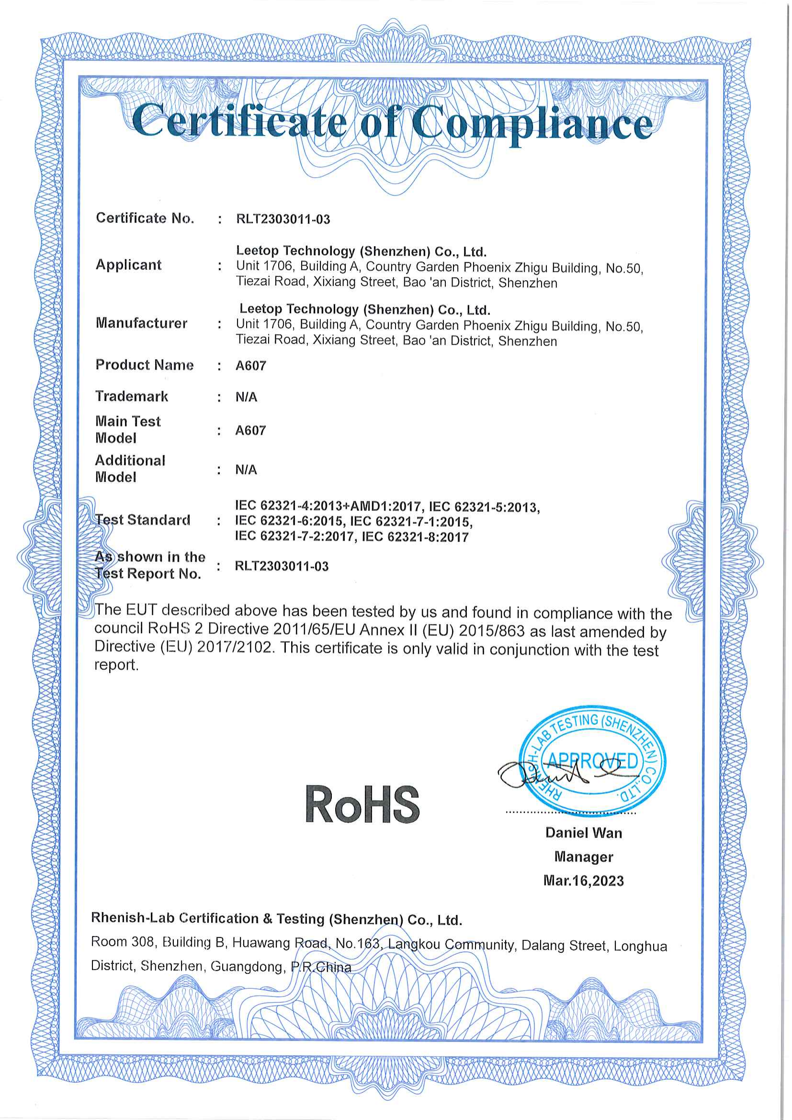
[picture p24: page 1]
