Seeed-Studio/OSHW-Jetson-Series/reComputer Jetson carrier board/reComputer A608/Certificate/105110001-EUDOC.pdf

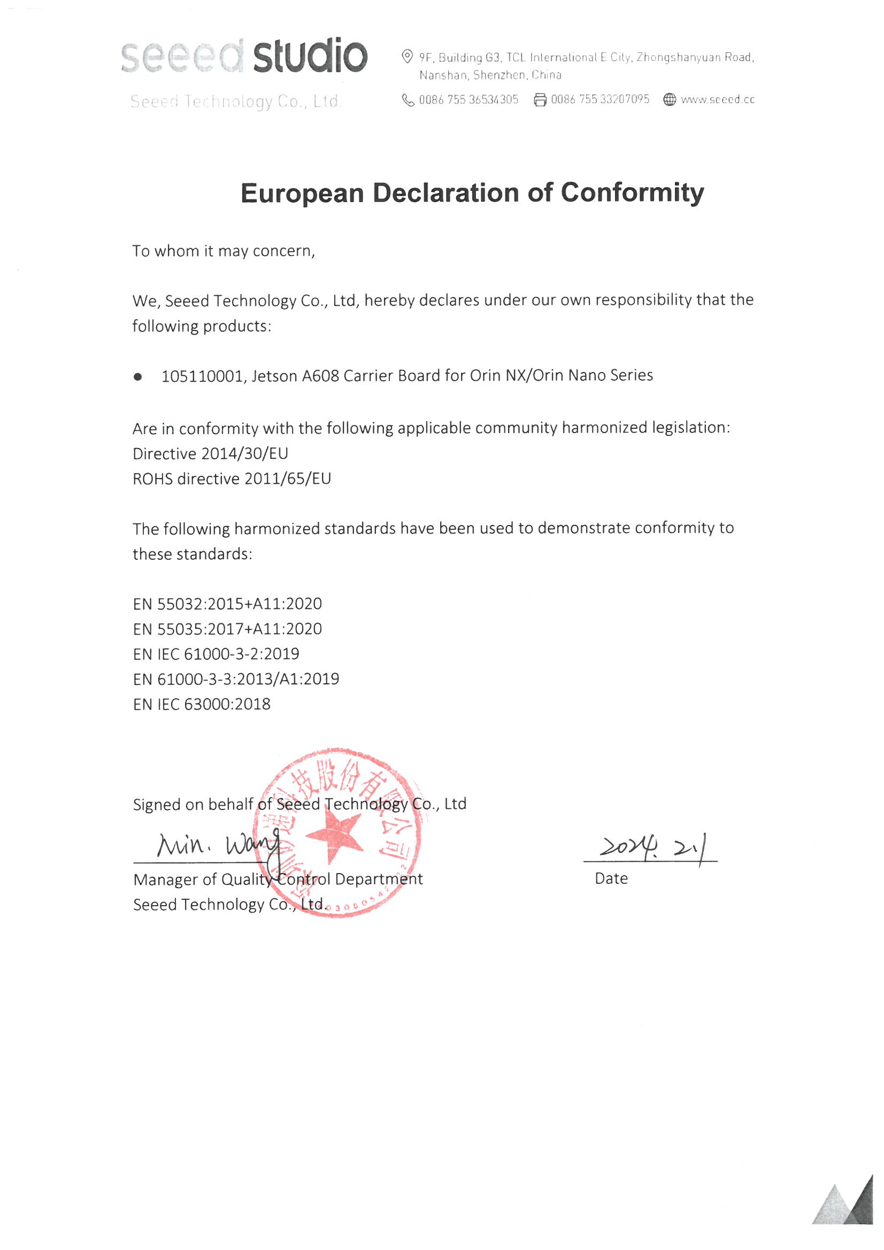
[picture p25: page 1]
