Seeed-Studio/OSHW-Jetson-Series/reComputer Jetson carrier board/reComputer A608/Certificate/105110001-UKDOC.pdf

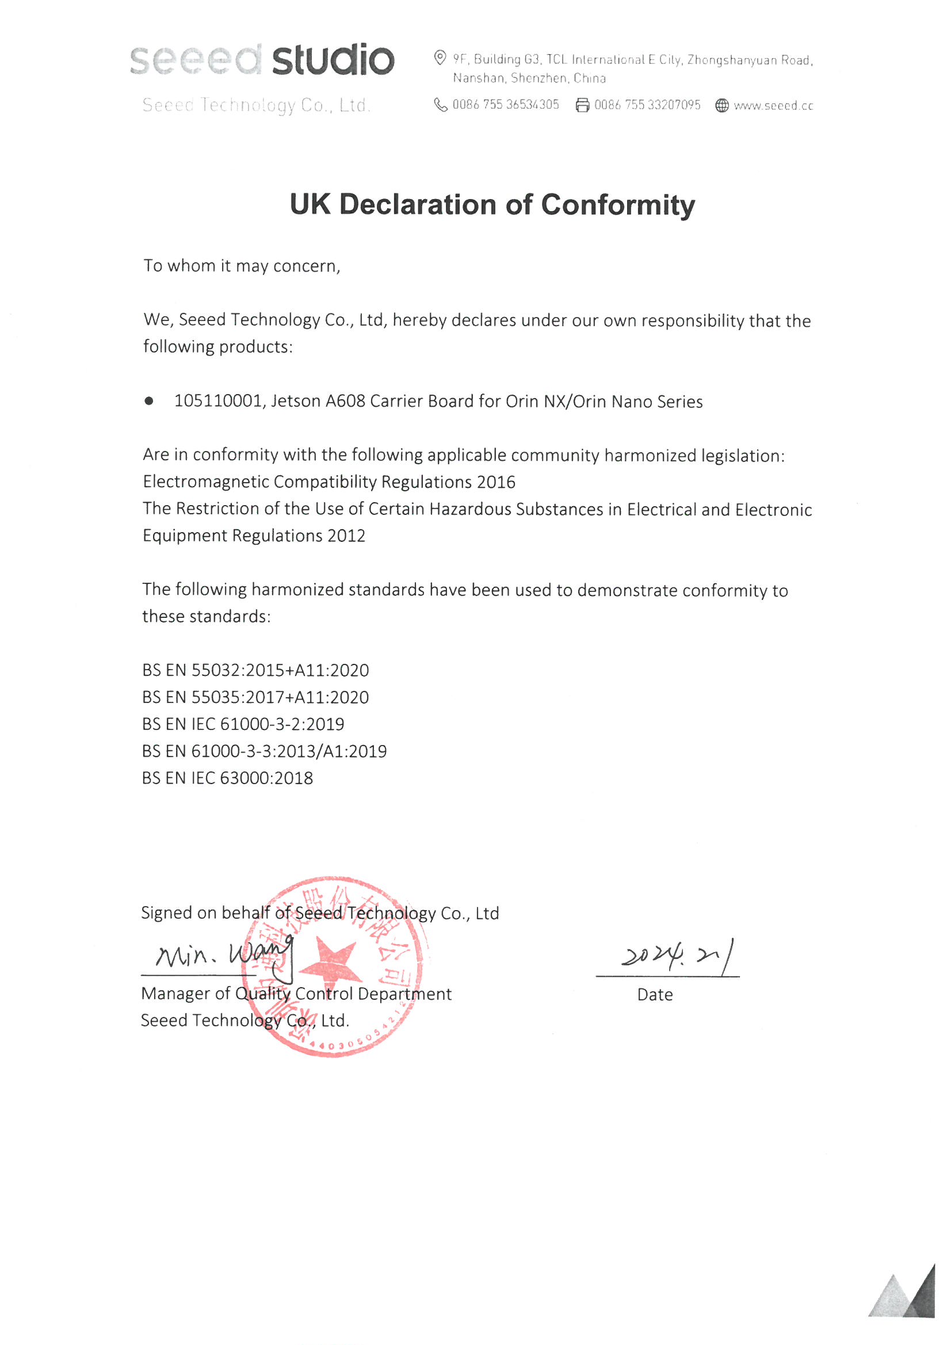
[picture p26: page 1]
