Seeed-Studio/OSHW-Jetson-Series/reComputer Jetson carrier board/Jetson Xavier AGX H01/3D Model/GEKIT_A505_整机3D.stl

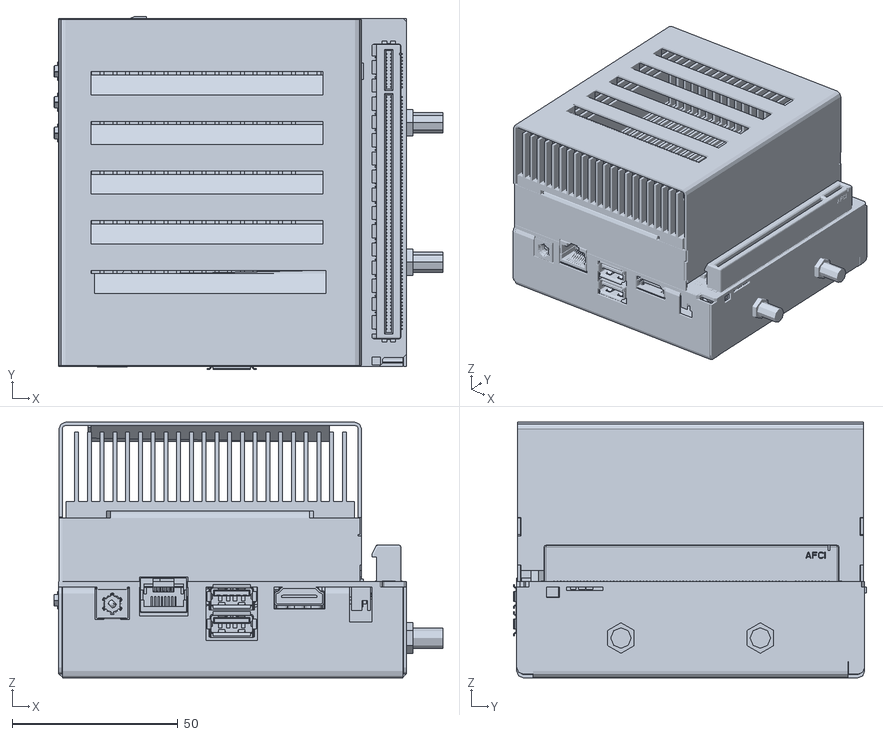
[picture p27: CAD file, 2026-10-08]
reComputer Jetson carrier board/Jetson Xavier AGX H01/3D Model/GEKIT_A505_整机3D.stl
117.5 x 106.7 x 77.2
