Seeed-Studio/OSHW-Jetson-Series/reComputer Jetson carrier board/reComputer A203 v2/3D Model/203_paba.stp

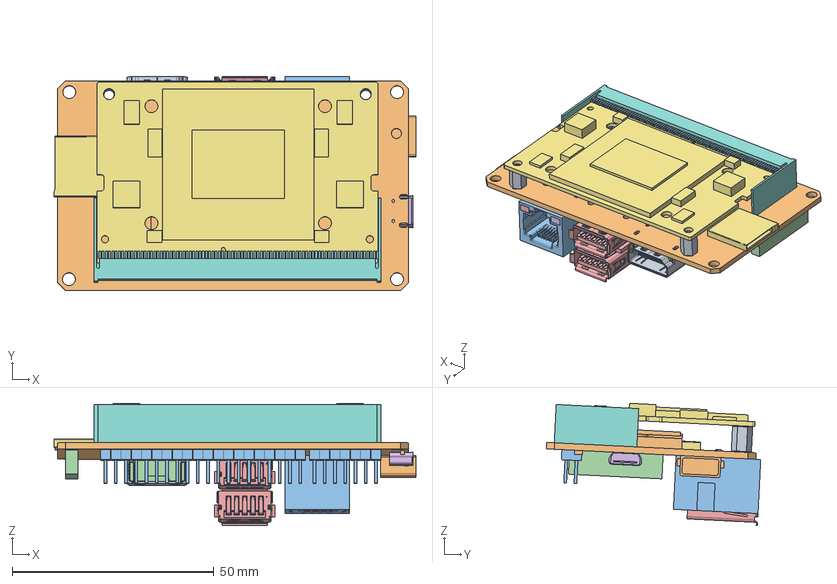
[picture p28: CAD file, 2026-10-08]
reComputer Jetson carrier board/reComputer A203 v2/3D Model/203_paba.stp
89.7 x 53.1 x 30.3 mm
WAIK_1_3_7_1_2_1_1_1_1_1_1
ADMI2E549752QKYR_5_19_2_1_2_1_1
HHF-14A000-2SA-N_2_19_3_1_1_1_1
M-UB04-H-A0_1_19_2_1_2_1_1_1_1_ x 2
DIANYUAN_1_2_1_1_3_1_1_1_1_1_1
TF_CARD_1_10_1_2_1_1_1_1_1_1
HXB_1_3_1_1_1_1_1_1_1_1_1
M3X6_5MM_2_1_1_1_1_1_1_1_1_1 x 2
DY_1_2_1_1_1_1_1_1
MANIFOLD_SOLID_BREP_207417_1_1_ x 27
FIT_1_1
LED1_1_1
LED2_1_1
P3636-ENVELOPE_2_3_1_1_1_1_1
