Seeed-Studio/OSHW-Jetson-Series/reComputer Jetson carrier board/reComputer A203E/3D Model/A203_Mini_PC_3D.stp

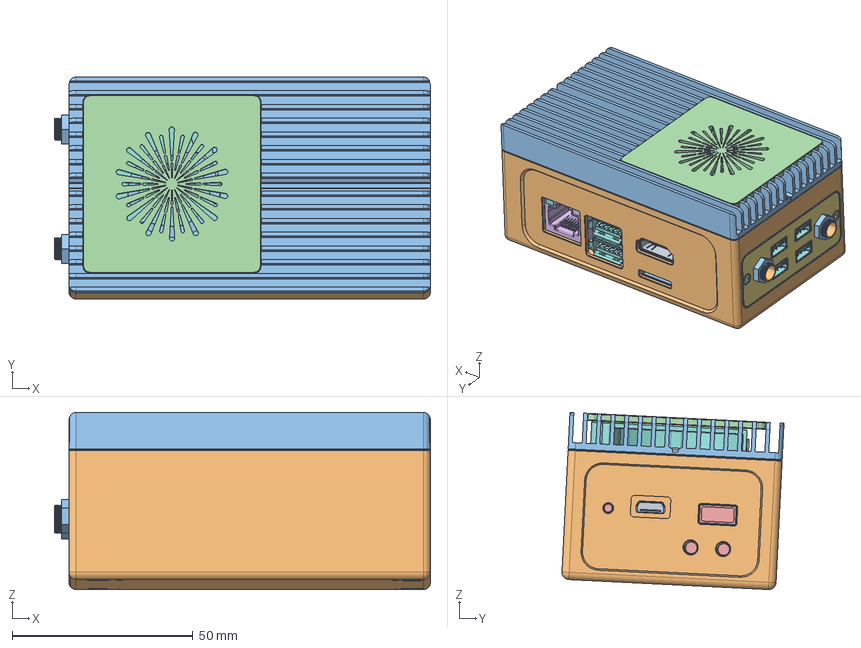
[picture p29: CAD file, 2026-10-08]
reComputer Jetson carrier board/reComputer A203E/3D Model/A203_Mini_PC_3D.stp
104.0 x 61.4 x 49.0 mm
WK-A_33_2_1_17_2_1_5
SRK_100X60X10_16_1_1_4_2_6_10
GB-1_11_1_1_1_1_1_3
WAIK_1_3_7_1_2_1_1_1_1_1_1
ADMI2E549752QKYR_5_19_2_1_2_1_1
HHF-14A000-2SA-N_2_19_3_1_1_1_1
M-UB04-H-A0_1_19_2_1_2_1_1_1_1_ x 2
DIANYUAN_1_2_1_1_3_1_1_1_1_1_1
TF_CARD_1_10_1_2_1_1_1_1_1_1
HXB_1_3_1_1_1_1_1_1_1_1_1
M3X6_5MM_2_1_1_1_1_1_1_1_1_1 x 2
DY_1_2_1_1_1_1_1_1
MANIFOLD_SOLID_BREP_207417_1_1_ x 35
FIT_1_1
LED1_1_1
LED2_1_1
PM_20_254_2_ASM_2_1_1_1_1_2_1_1
XJ_PCB_5_3_1_1_1_6_1_1_1
SIM_11_2_1_1_1_1_1_1_1_1
XP_1_1_1_1_1
KK1_19_2_1_1_1_1_1 x 2
5G_1_1_1_1_1_1_1_1_1
CEB-1_1_1_3
4PIN_DZ_1_1 x 4
CB_PCB_1_1
TX-1_1_1_1_1_1_1_1 x 2
TX-LS_1_1_1_1_1_1_1_1_1_1 x 2
M2X4_1_1_1 x 3
LED_4_1_1
P3636-ENVELOPE_2_3_1_1_1_1_1
M2_5X10_1 x 4
A201023042G-BASE-20170713_1_1
4007-COVER-1029_6_1_1
JD_1_1 x 4
