Seeed-Studio/OSHW-Jetson-Series/reComputer Jetson carrier board/reComputer A205/3D Model/FL_A205_PCBA_3D.stp

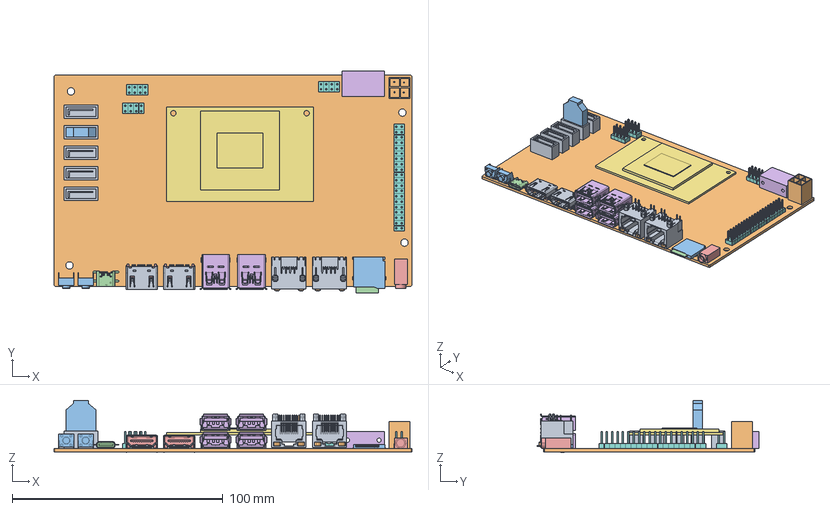
[picture p30: CAD file, 2026-10-08]
reComputer Jetson carrier board/reComputer A205/3D Model/FL_A205_PCBA_3D.stp
169.9 x 105.6 x 24.9 mm
PCB_205_1
NO_OFF_1 x 2
TYPE_C_1
HDMI_1_1 x 2
PRT0017_1_1 x 4
PRT0018_1_1 x 4
PRT0019_1_1 x 2
PRT0020_1_1 x 2
PRT0021_1_1 x 2
PRT0022_1_1 x 2
PRT0023_1_1 x 2
PRT0024_1_1 x 2
PRT0025_1_1 x 2
PRT0026_1_1 x 2
PRT0027_1_1 x 2
PRT0028_1_1 x 2
PRT0029_1_1 x 2
TF_1_1
CARD_1
E_JACK_1
DC_2PIN_1
HX_PCB_1
DY_254 x 32
STA_JT x 5
CT_11
STA_JT_1
