Seeed-Studio/OSHW-Jetson-Series/reComputer Jetson carrier board/reComputer A205E/3D Model/A205E_PCBA_3D.stp

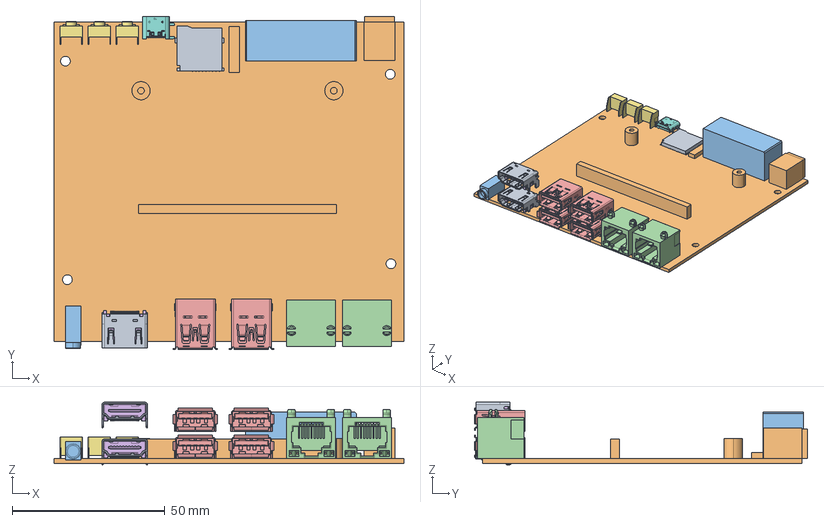
[picture p31: CAD file, 2026-10-08]
reComputer Jetson carrier board/reComputer A205E/3D Model/A205E_PCBA_3D.stp
114.6 x 109.1 x 20.5 mm
A205E_PCB_2_2_3_1_1_1_2
EJ_4_1_1_4_1_1_2_1_1_1
ADMI2E549752QKYR_5_4_1_1_3_1_3_ x 2
M-UB04-H-A0_1_4_1_1_3_1_1_2_1_1 x 4
HHF-14A000-2SA-N_2_19_3_1_1_3_1 x 2
KK1_4_1_1_3_1_1_2_1_1_1 x 3
T-C_4_1_1_3_2_1_2_1_1_1
MANIFOLD_SOLID_BREP_335740_1_1_
DC-1_3_2_1_2_1_1_1
2X10PIN_DZ_2_2_1_2_1_1_1
