Seeed-Studio/OSHW-Jetson-Series/reComputer Jetson carrier board/reComputer A206/3D Model/nk_206_pcb_A.stp

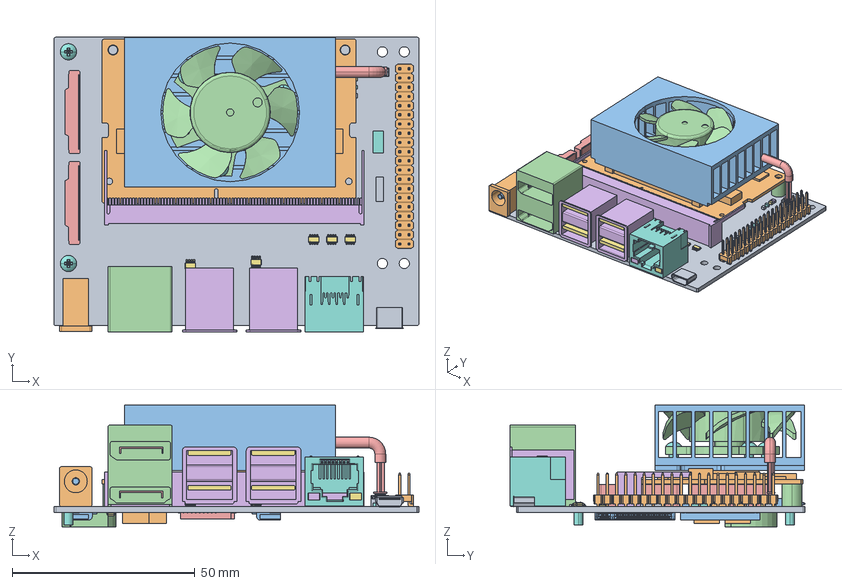
[picture p32: CAD file, 2026-10-08]
reComputer Jetson carrier board/reComputer A206/3D Model/nk_206_pcb_A.stp
100.0 x 80.7 x 33.4 mm
206-PCB
DC-1
ZZ-DC
DP_HDMI
DP_XX
USB_3 x 2
USB_X x 2
FLY_CORE x 2
ADMI2E549752QKYR_5_19_2_3
DIANYUAN_1_1
M2_5_CU
HDMI x 2
HXB_1_3_1_1_1_1_1_1_1
PRT0001
PRT0002
PRT0003 x 2
DC_12
SD
MANIFOLD_SOLID_BREP_335740_1_1_
D1_1
D_2
SPM-M2-L5 x 5
FE
P3636-ENVELOPE_2_3_1_1_1
LF_NX_001___V1_1_10_20
FENGSHAN_1
XC_1
