Seeed-Studio/OSHW-Jetson-Series/reComputer Jetson carrier board/reComputer A608/3D Model/A607_pcba.stp

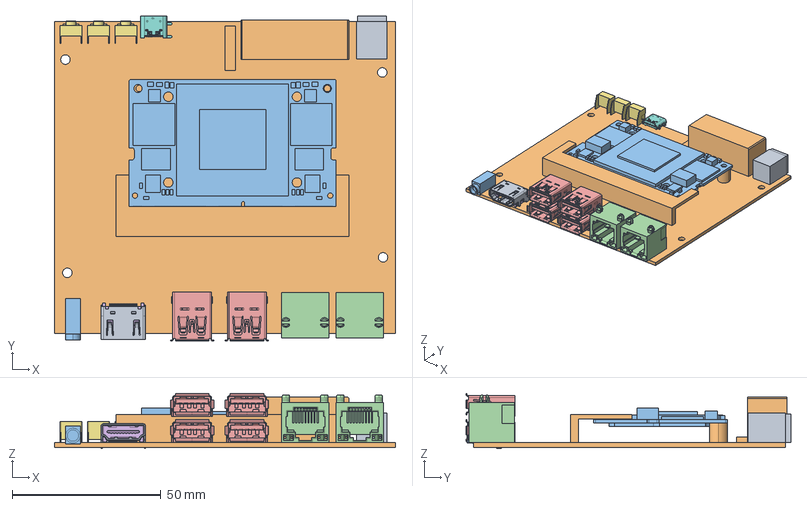
[picture p33: CAD file, 2026-10-08]
reComputer Jetson carrier board/reComputer A608/3D Model/A607_pcba.stp
114.6 x 109.1 x 18.6 mm
PRT0005_1
PRT0006_1
PRT0007_1 x 2
PRT0008_1 x 4
PRT0009_1
PRT0011_1 x 3
PRT0012_1
PRT0014_1
PRT0015_1
ORIN_NX_PCBA
