Seeed-Studio/OSHW-Jetson-Series/reComputer Jetson carrier board/reComputer Robotics J401/Mechanical/Mechanical_reComputer_Robotics_PCBA.dxf

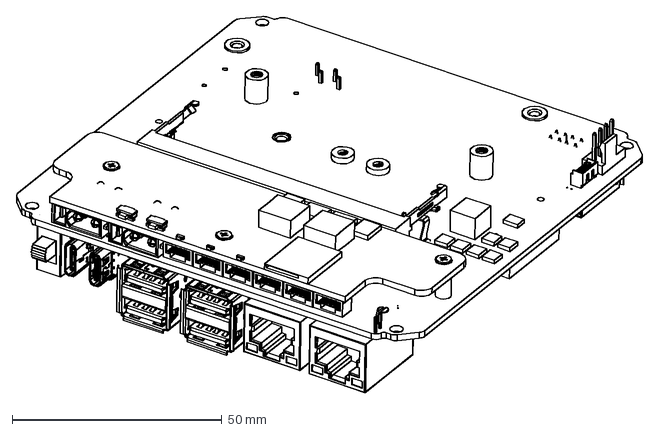
[picture p34: CAD file, 2026-10-08]
reComputer Jetson carrier board/reComputer Robotics J401/Mechanical/Mechanical_reComputer_Robotics_PCBA.dxf
149.3 x 89.7 mm
