Seeed-Studio/OSHW-Jetson-Series/reComputer Jetson carrier board/reComputer Super J401/Mechanical/Mechanical_reComputer_Super_PCBA.dxf

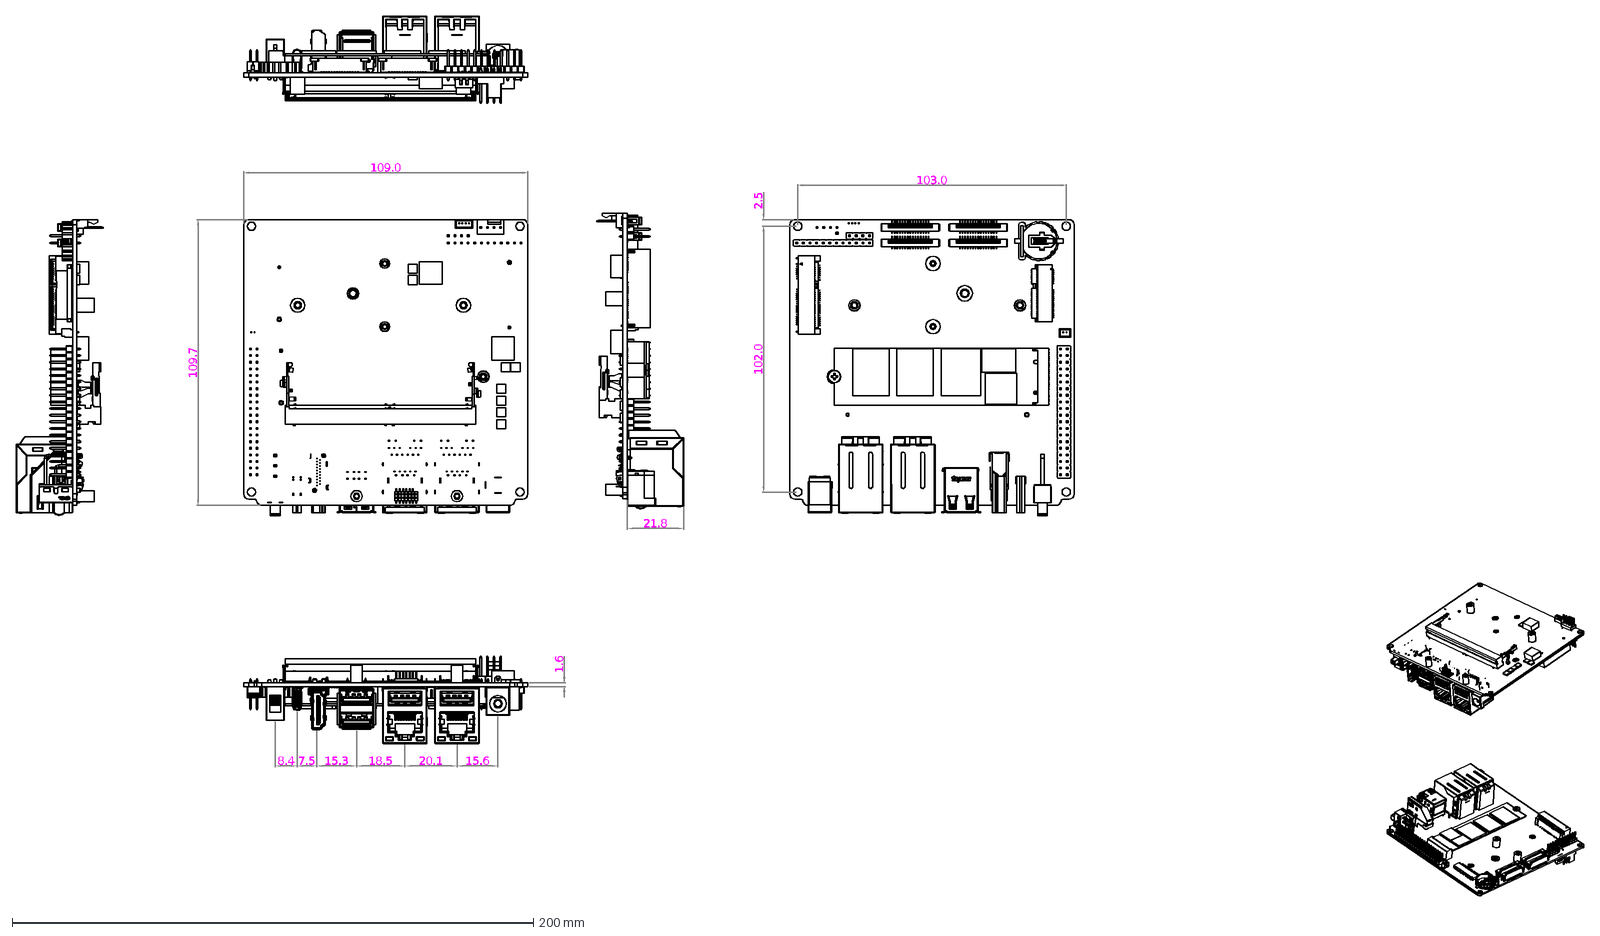
[picture p35: CAD file, 2026-10-08]
reComputer Jetson carrier board/reComputer Super J401/Mechanical/Mechanical_reComputer_Super_PCBA.dxf
109.0
109.7
103.0
102.0
2.5
1.6
21.8
8.4
7.5
15.3
20.1
18.5
15.6
