Seeed-Studio/OSHW-Jetson-Series/reComputer Jetson carrier board/reComputer A205E/3D Model/A205E_Mini_PC_3D.stp

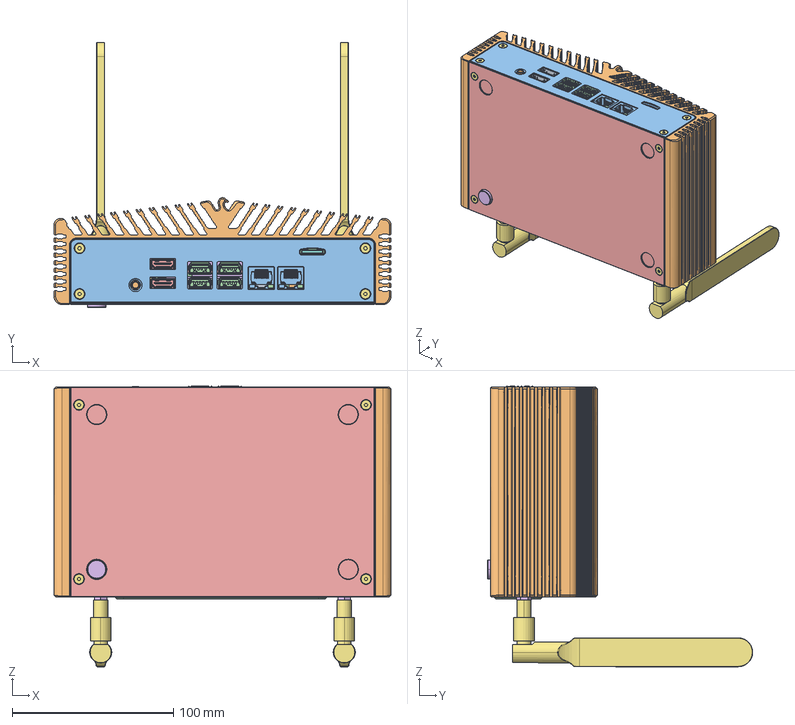
[picture p36: CAD file, 2026-10-08]
reComputer Jetson carrier board/reComputer A205E/3D Model/A205E_Mini_PC_3D.stp
209.0 x 164.6 x 174.0 mm
A_9_1_2_1_2
B_7_1_2_15_3
C_6_1_2_1_4
D_7_1_1_4_3
MANIFOLD_SOLID_BREP_157436_1_1_
PM-1_ASM_4_ASM_1_ASM_1_ASM_1_AS
0000_T_ASM_4_ASM_1_ASM_1_ASM_1_ x 2
P-M3-6_5_1_1_2_1 x 16
M3_6_4_1_1_2_1 x 3
L_ZHIJIA_1_1
A205E_PCB_2_2_3_1_1_1
EJ_4_1_1_4_1_1_2_1_1
ADMI2E549752QKYR_5_4_1_1_3_1_3_ x 2
M-UB04-H-A0_1_4_1_1_3_1_1_2_1_1 x 4
HHF-14A000-2SA-N_2_19_3_1_1_3_1 x 2
CPU_6_1_1_3_1_1_2_1_1
KK1_4_1_1_3_1_1_2_1_1 x 3
T-C_4_1_1_3_2_1_2_1_1
MANIFOLD_SOLID_BREP_335740_1_1_
DC-1_3_2_1_2_1_1
2X10PIN_DZ_2_2_1_2_1_1
MBXJ_1_14_1_2
TX-1_4_1_1_1 x 2
TX-LS_4_1_1_1_1 x 2
0000_TX_1_1_1_1_1 x 2
LED_1
LED_2
LED_3
LED_4
PIN
LED6 x 2
LED8 x 2
817_44502_002_04_Y0509-1__S1_0_
A205___8_06_1_1_3
PM_20_254_2_ASM_2_1_1_1_1_2_1_1
XJ_PCB_5_3_1_1_1_6_1_1_1
SIM_11_2_1_1_1_1_1_1_1_1
XP_1_1_1_1_1
KK1_19_2_1_1_1_1_1 x 2
5G_1_1_1_1_1_1_1_1_1
M2_5X8 x 2
R2662 x 2
