Seeed-Studio/OSHW-Jetson-Series/reComputer Jetson carrier board/reComputer A608/3D Model/A608_3D_File.stp

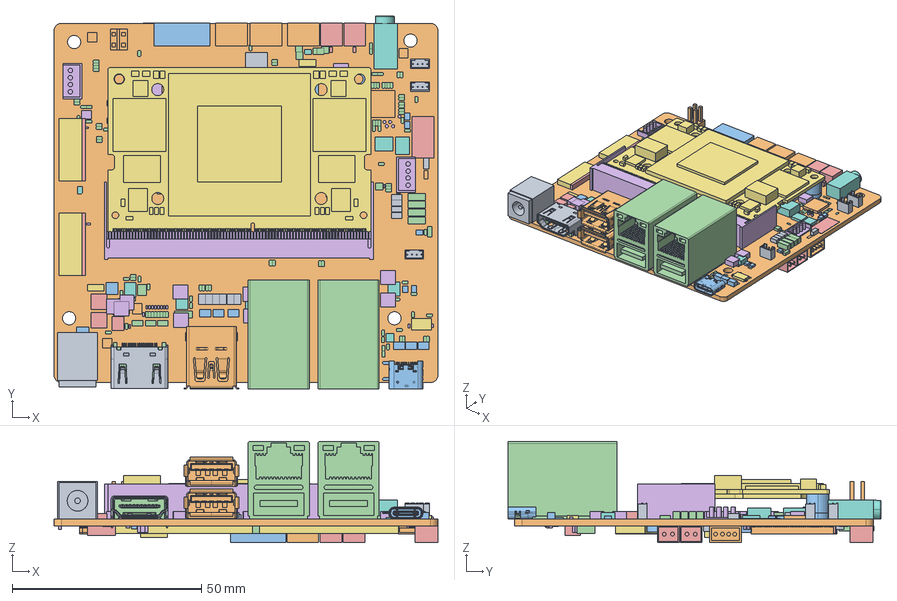
[picture p39: CAD file, 2026-10-08]
reComputer Jetson carrier board/reComputer A608/3D Model/A608_3D_File.stp
101.5 x 98.6 x 26.7 mm
A608_V10_20230724_1_2
SOT_523_1_1 x 12
C1206_1_1 x 7
SOT23-6_1_1
RT8279GSP_1_1
MWSA0605S_1_1
MULTI_SMD_DFN08_SON08_1_1 x 2
XSOP10_P050_030X030_1_1
XTAL-3225-4P-TXC_1_1_1 x 4
USON_10_1_1X2_6_1_1 x 9
SOT23-5_1_7X3_1_1
C0402_1_1 x 32
SOT_23_THIN_1_1 x 2
MWSA0503S_1_1 x 2
LCM_2012_1_1 x 12
QFN48_6X6_1_1 x 2
H3_6_1_4 x 6
TSLP10_P050_025X010_1_1 x 3
CON_067_M2_KEY_E_C_1_3
QFN010R_P040_0018X0014_1_1
ZIF_0_5PITCH_22P_2MM_1_2 x 2
DFN08_P040_018X012_1_1 x 2
QFN28_5X5_1_1
PI3AUX221ZTAEX_1_1
SO8_1_1 x 2
LED_0603_1_1
1_25MMPITCH_4PIN_SMD_MOLEX_1_1
R1206_1_1 x 2
SOT-23-5_1_6X3_1_1 x 4
QFN088Q_1_1
GH1_25_WT_4P_1_3 x 5
CON_067_M2_KEY_B_30X42_52_1_4
DFN08_P050_030X020_T016X016_1_1
TP-0_8_1_1 x 11
VQFN_20_4_5X2_5_1_1
X2QFN_1_6X1_6_1_1
SC70-5_1_1 x 4
MARK_1_1 x 6
SIM-12707H137_1_2
DFN1006-2L_1_1 x 6
ZIF_0_5PITCH_8P_2MM_1_3 x 2
Q_FET_N_ENH_SC70_6_1_1 x 2
L2016_1_1
C0805_1_1 x 10
C0603_1_1 x 5
GH1_25_WT_9P_1_2 x 2
SOD523_1_1
SMB_1_1
B550C_1_1
R0402_1_1 x 2
R0805_1_1
QFN020Q_T018X018_1_1
QFN_20_4_65X3_65_1_1 x 2
CON_2X2_2_54_SMD_1_3
SOT-23_1_1
SC70_5_1_1
DFN_3X3_1_1 x 2
SOT323_1_1 x 3
CON_067_SMT_M2_KEY_M_1_3
IND_SMD_0603_1_1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
