Seeed-Studio/OSHW-Jetson-Series/(list of files, cad)

Other CAD files:
reComputer Jetson carrier board/reComputer A203 v2/Mechanical/A203_V2_BOTTOM.dwg
reComputer Jetson carrier board/reComputer A205/Mechanical/A205_BOTTOM.dwg
reComputer Jetson carrier board/reComputer A206/Mechanical/A206_BOTTOM.dwg
reComputer Jetson carrier board/reComputer A203 v2/Mechanical/A203_V2_top.dwg
reComputer Jetson carrier board/reComputer A205/Mechanical/A205_TOP.dwg
reComputer Jetson carrier board/reComputer A206/Mechanical/A206_TOP.dwg
reComputer Jetson carrier board/reComputer Super J401/Mechanical/Mechanical_reComputer_Super.dxf
