Seeed-Studio/OSHW-Jetson-Series/reComputer Jetson carrier board/reComputer Super J401/Datasheet/reComputer_Super_Temperature_Test_Report.pdf

reComputer Super

© 2008-2025 Seeed Technology Co., Ltd. All rights reserved. | 1 / 4

# reComputer Super

# Temperature Test Report

Test | Conditions | Results
Temperature Humidity Biased | 65℃ / 85% RH, 168 hours, Power ON | Pass
Operational Low Temp | -20℃, 24 hours, Full load operation | Pass
Operational High Temp | 65℃, 24 hours, Full load operation, 25W mode; 60℃, 4.5 hours, Full load operation, 40W mode | Pass

Test Conditions:
- CPU & GPU at full load, 40W mode
- Fan at full speed
- 2*USB HUB each loaded with 2A, no display connected
Chamber Temperature | Operation Time | Input Voltage | Module Mode | CPU Frequency | GPU Frequency | CPU Temperature | GPU Temperature | Power
60℃ | 4.5H | 19V | 40W | ～1.5GHz | 1.2GHz | 92.6℃ | 90℃ | ～33.6W
65℃ | 4.5H | 19V | 25W | ～0.8GHz | 0.4GHz | 95.8℃ | 98.9℃ | ～18W

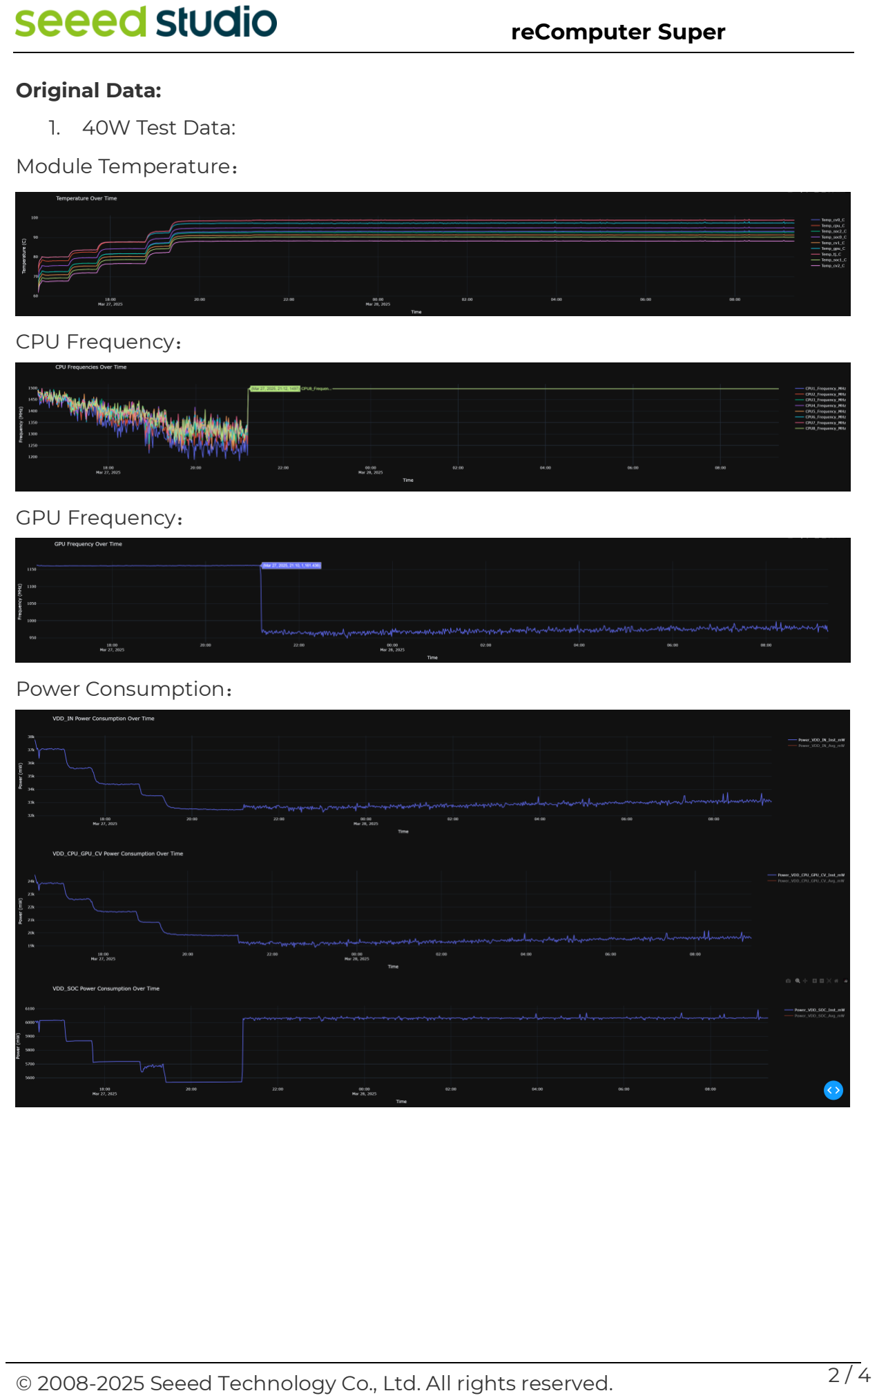
[picture p40: page 2]

© 2008-2025 Seeed Technology Co., Ltd. All rights reserved. | 2 / 4

Original Data:
1. 40W Test Data:
Module Temperature：

CPU Frequency：

GPU Frequency：

Power Consumption：

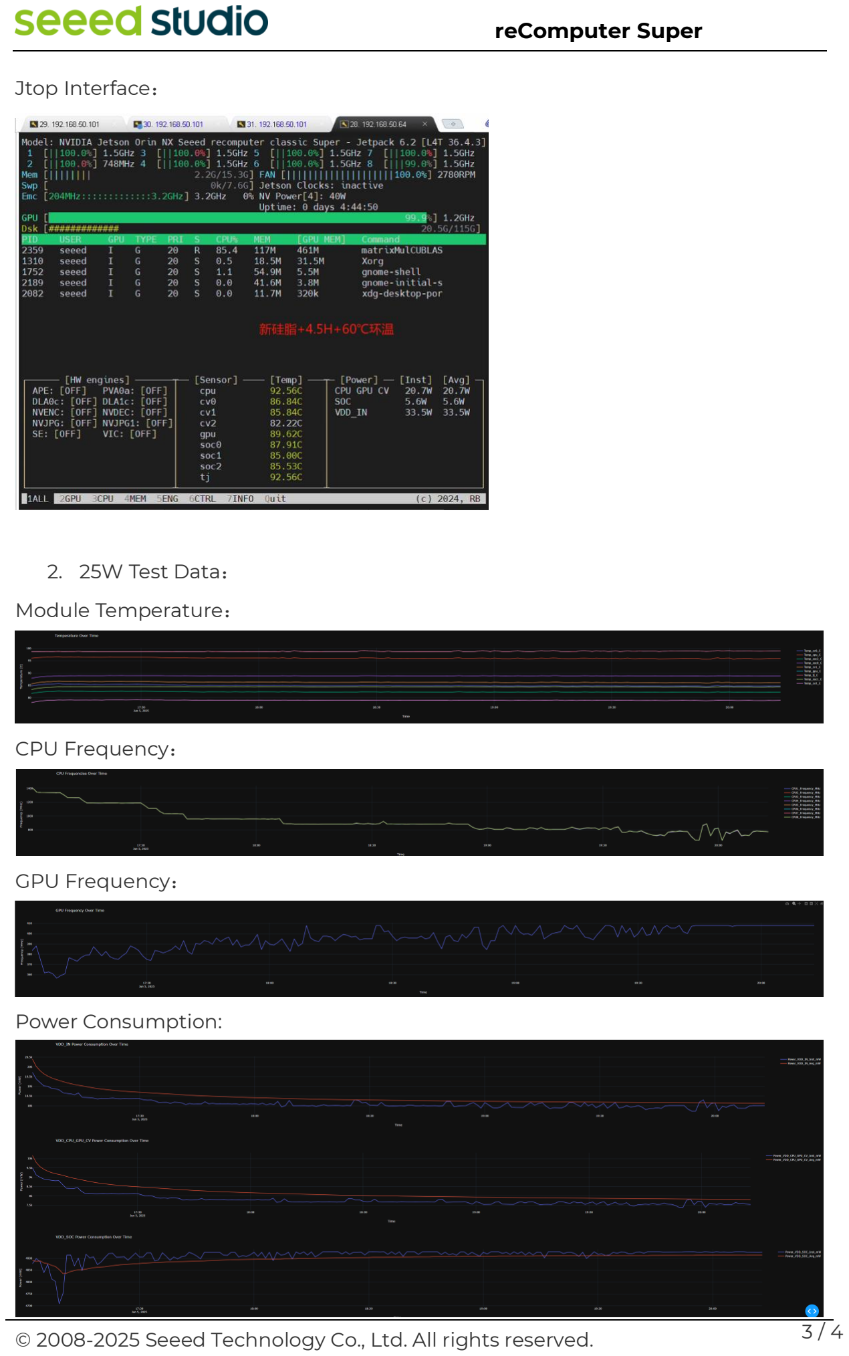
[picture p41: page 3]

© 2008-2025 Seeed Technology Co., Ltd. All rights reserved. | 3 / 4

Jtop Interface：

2. 25W Test Data：
Module Temperature：

CPU Frequency：

GPU Frequency：

Power Consumption:

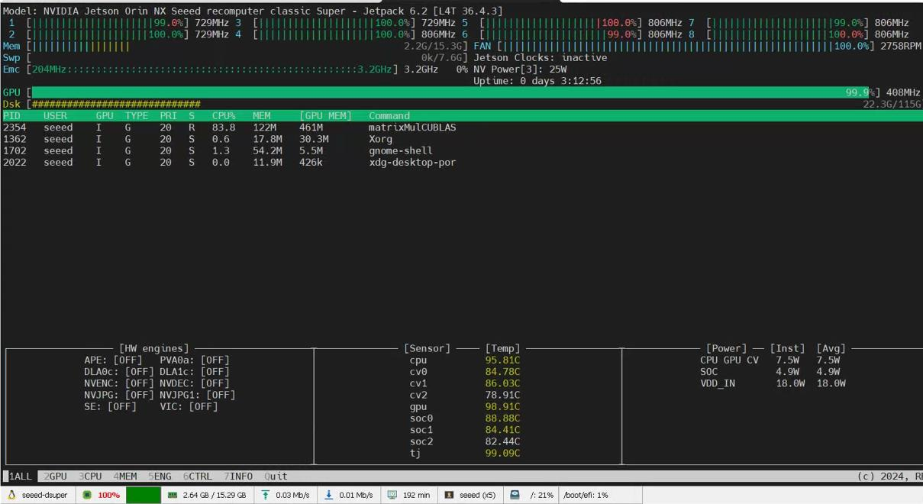
[picture p42: figure]

© 2008-2025 Seeed Technology Co., Ltd. All rights reserved. | 4 / 4

Jtop Interface：
