Seeed-Studio/OSHW-Jetson-Series/(threads)

Thread 1 (2025-04-01):

Is J401 support Orin nx super mode?

kyo-tom, 2025-04-01:
Is J401 support Orin nx super mode?

bigbearishappy, 2025-04-07:
Sorry, J401 don't support Orin nx super mode. Because the VDD_IN on J401 carrier board is 5V now. But the the super mode with orin nx need 8V on VDD_IN.

Closed 2025-04-08.

Thread 2 (2025-07-09):

Dual IMX477 Cameras on J401 Carrier Board?

kneave, 2025-07-09:
I've been trying to get help running two IMX477 cameras for over a week now, they're apparently supported but I cant get one to work when plugged in to CAM0.

Info at the following link, I'm not sure if Seeed care about the forums at all or just expect the community to provide support for them, I'm regretting giving them money either way and right now there's zero chance of us using them as a supplier for the product we're developing.

If anyone can shed some light on this, I'd appreciate it.

https://forum.seeedstudio.com/t/dual-imx477-cameras-with-jetson-orin-nano-j401-board/292999

ackPeng, 2025-07-11:
@kneave HI, thank you very much for your use. I just tested it and there are indeed some problems. I will continue to debug and share with you any progress. I am very sorry for the bad experience you have. If you have any questions in the future, you can raise an issue on GitHub so that I can see it more promptly.

kneave, 2025-07-11:
Thank you for confirming that, good to know it wasn't me doing something stupid!

ackPeng, 2025-07-11:
Of course, I tested the imx219 and imx477 cameras, and they both failed to work properly on CAM1. It seems that there is something wrong with CSI2 or some other configuration.

ackPeng, 2025-07-14:
Select dual-channel imx477 in jetson-io, then restart, and light up the camera after restart. Then I found that CAM0 can work normally, but CAM1 can't

kneave, 2025-07-14:
That's really odd, cam1 has always worked for me and it's always cam0 that doesn't.

Are there any logs or config info I cam get you to compare systems?

ackPeng, 2025-07-15:
[csi_camera.tar.gz](https://github.com/user-attachments/files/21225080/csi_camera.tar.gz)

ackPeng, 2025-07-15:
@kneave Please try using this overlay. After my test, both cameras can work.

kneave, 2025-07-15:
I copied these files to `/boot` and renamed them to overwrite the existing files, the ones you provided have `seeed` at the end which didn't match the originals.

Looks like this has solved the issue, thanks for that, but I need to do more testing to confirm image quality and performance is ok.

kneave, 2025-07-18:
I'm seeing some strange behaviour but I think that's due to compression artifacts, I can consistently stream from both cameras now at least.

Considering the fix is adjusting one of the device trees, can you see how long this issue has been present for please? I'm intrigued as to how this wasn't spotted in testing?

Closed 2025-07-21.
