Seeed-Studio/OSHW-Jetson-Series/reComputer Jetson carrier board/Jetson-Mate/Schematic/Jetson-Mate-Schematics-V1.0.pdf

# Revision History

Oct. 16 2020 | 1. Initial release v1.0

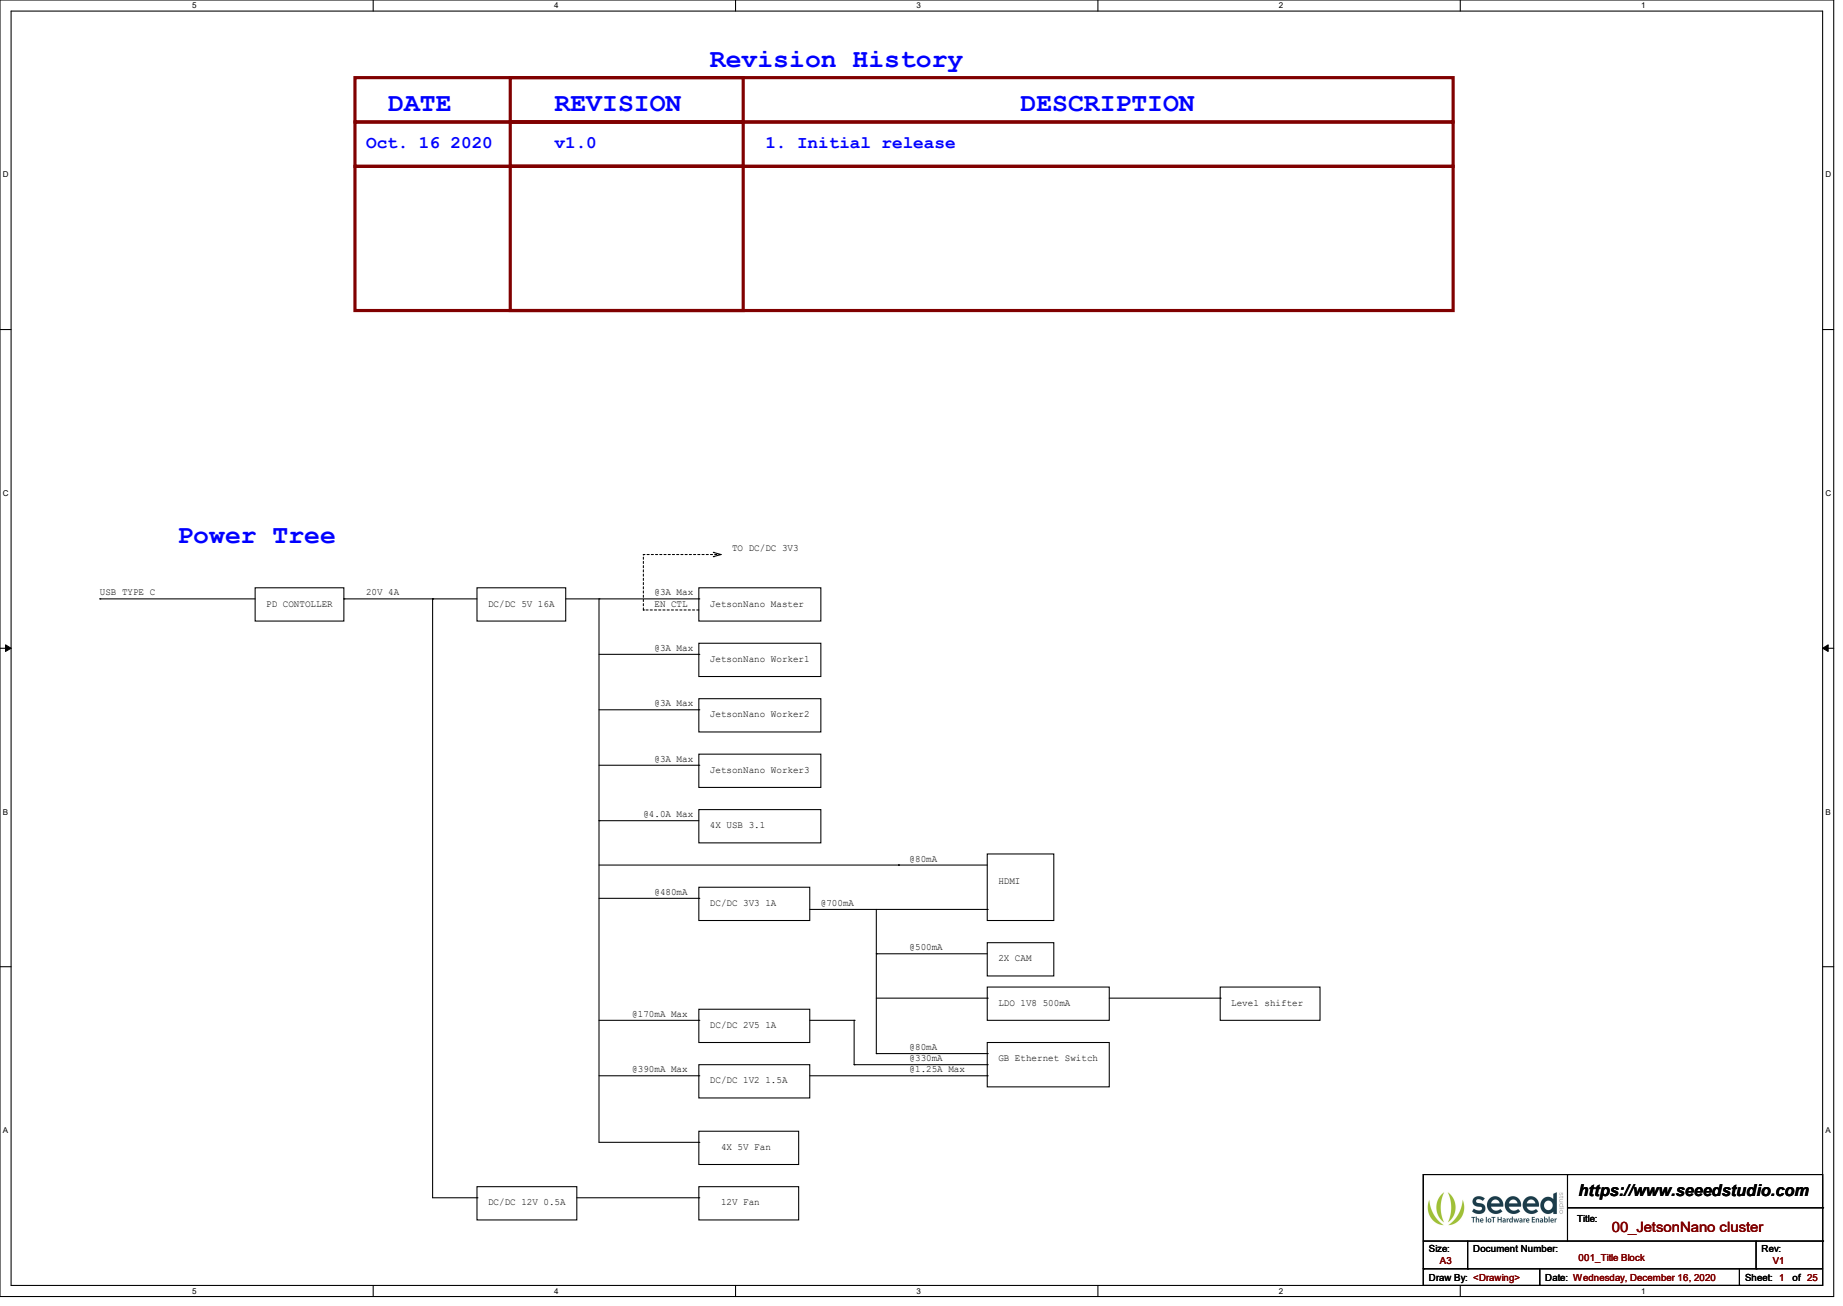
[picture p43: page 1]
USB TYPE C; JetsonNano Master; JetsonNano Worker1; JetsonNano Worker2; JetsonNano Worker3; @3A Max; EN CTL; 12V Fan; @390mA Max; 2X CAM; 4X USB 3.1; @170mA Max; @4.0A Max; @1.25A Max; HDMI; PD CONTOLLER; 4X 5V Fan; LDO 1V8 500mA; Level shifter; DATE; DESCRIPTION REVISION; Power Tree; Title: Size:; Document Number:; Rev: Draw By:; Date:; Sheet:; https://www.seeedstudio.com A3; V1 <Drawing>; Wednesday, December 16, 2020; 00_JetsonNano cluster 001_Title Block Title: Size: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

GB Ethernet Switch

# CAM[0..6] PWR_BUTT0 PWR_BUTT1 PWR_BUTT2 PWR_BUTT3

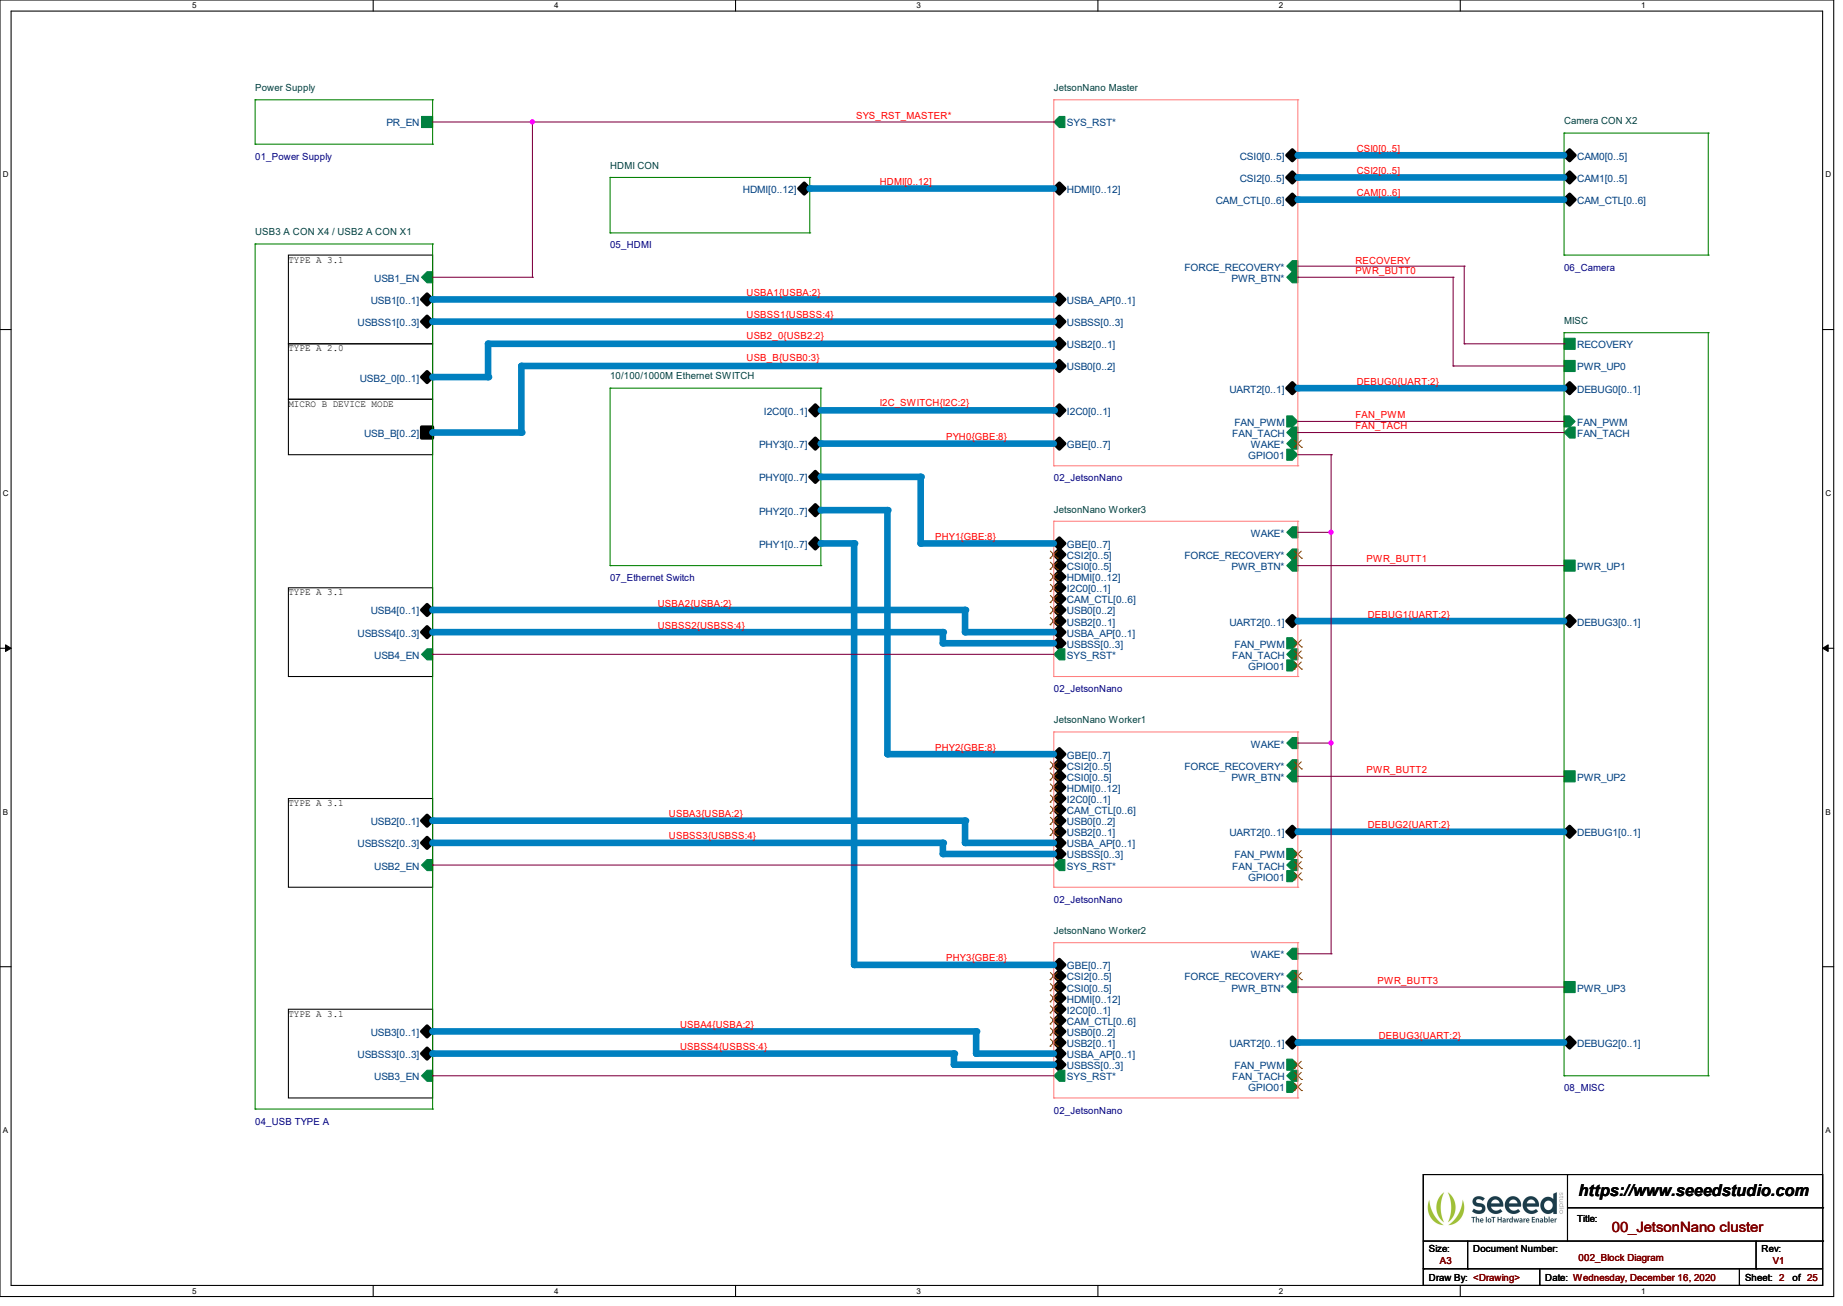
[picture p44: page 2]
TYPE A 3.1; TYPE A 2.0; https://www.seeedstudio.com A3; V1 <Drawing>; Wednesday, December 16, 2020; 00_JetsonNano cluster 002_Block Diagram; HDMI CON; 05_HDMI; HDMI[0..12]; JetsonNano Worker2; 02_JetsonNano GBE[0..7] USB0[0..2] USBA_AP[0..1] USBSS[0..3] HDMI[0..12] CAM_CTL[0..6] CSI2[0..5] CSI0[0..5] SYS_RST*; PWR_BTN* FORCE_RECOVERY* USB2[0..1]; UART2[0..1] FAN_TACH; FAN_PWM WAKE* GPIO01; USB3 A CON X4 / USB2 A CON X1; 04_USB TYPE A; USB1[0..1]; USB2[0..1] USB3[0..1]; USBSS1[0..3]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

MISC
PWR_UP0 PWR_UP1 PWR_UP2 PWR_UP3
DEBUG0{UART:2} DEBUG1{UART:2} DEBUG2{UART:2} DEBUG3{UART:2}

MICRO B DEVICE MODE

USBA3{USBA:2} USBSS3{USBSS:4} USBA4{USBA:2} USBSS4{USBSS:4}

# TYPE C 20V IN 4A

R0402 R9

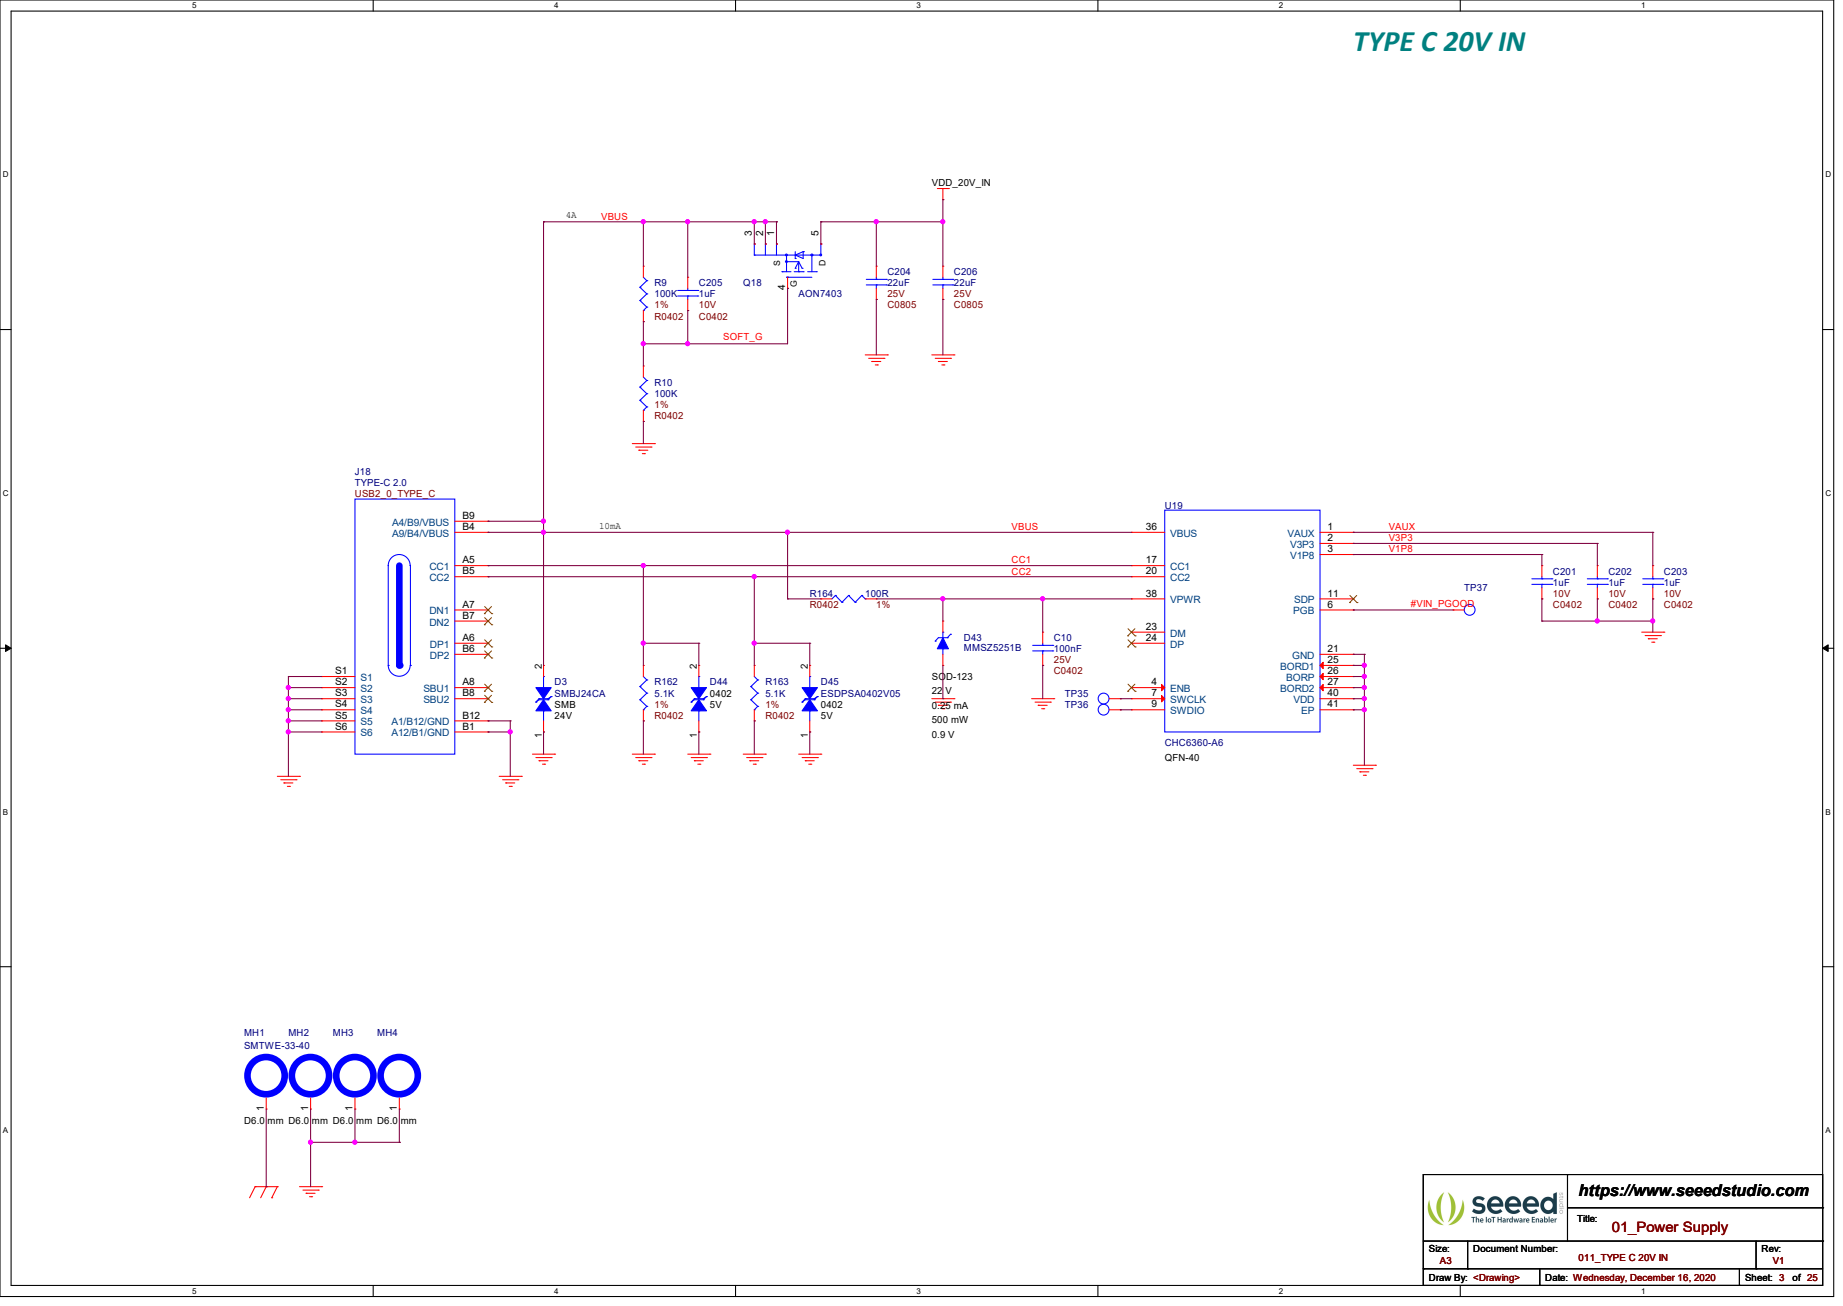
[picture p45: page 3]

# POWER SUPPLY FOR JETSON VDD_20V_IN

25VR84 | 105K R0402 | 1%

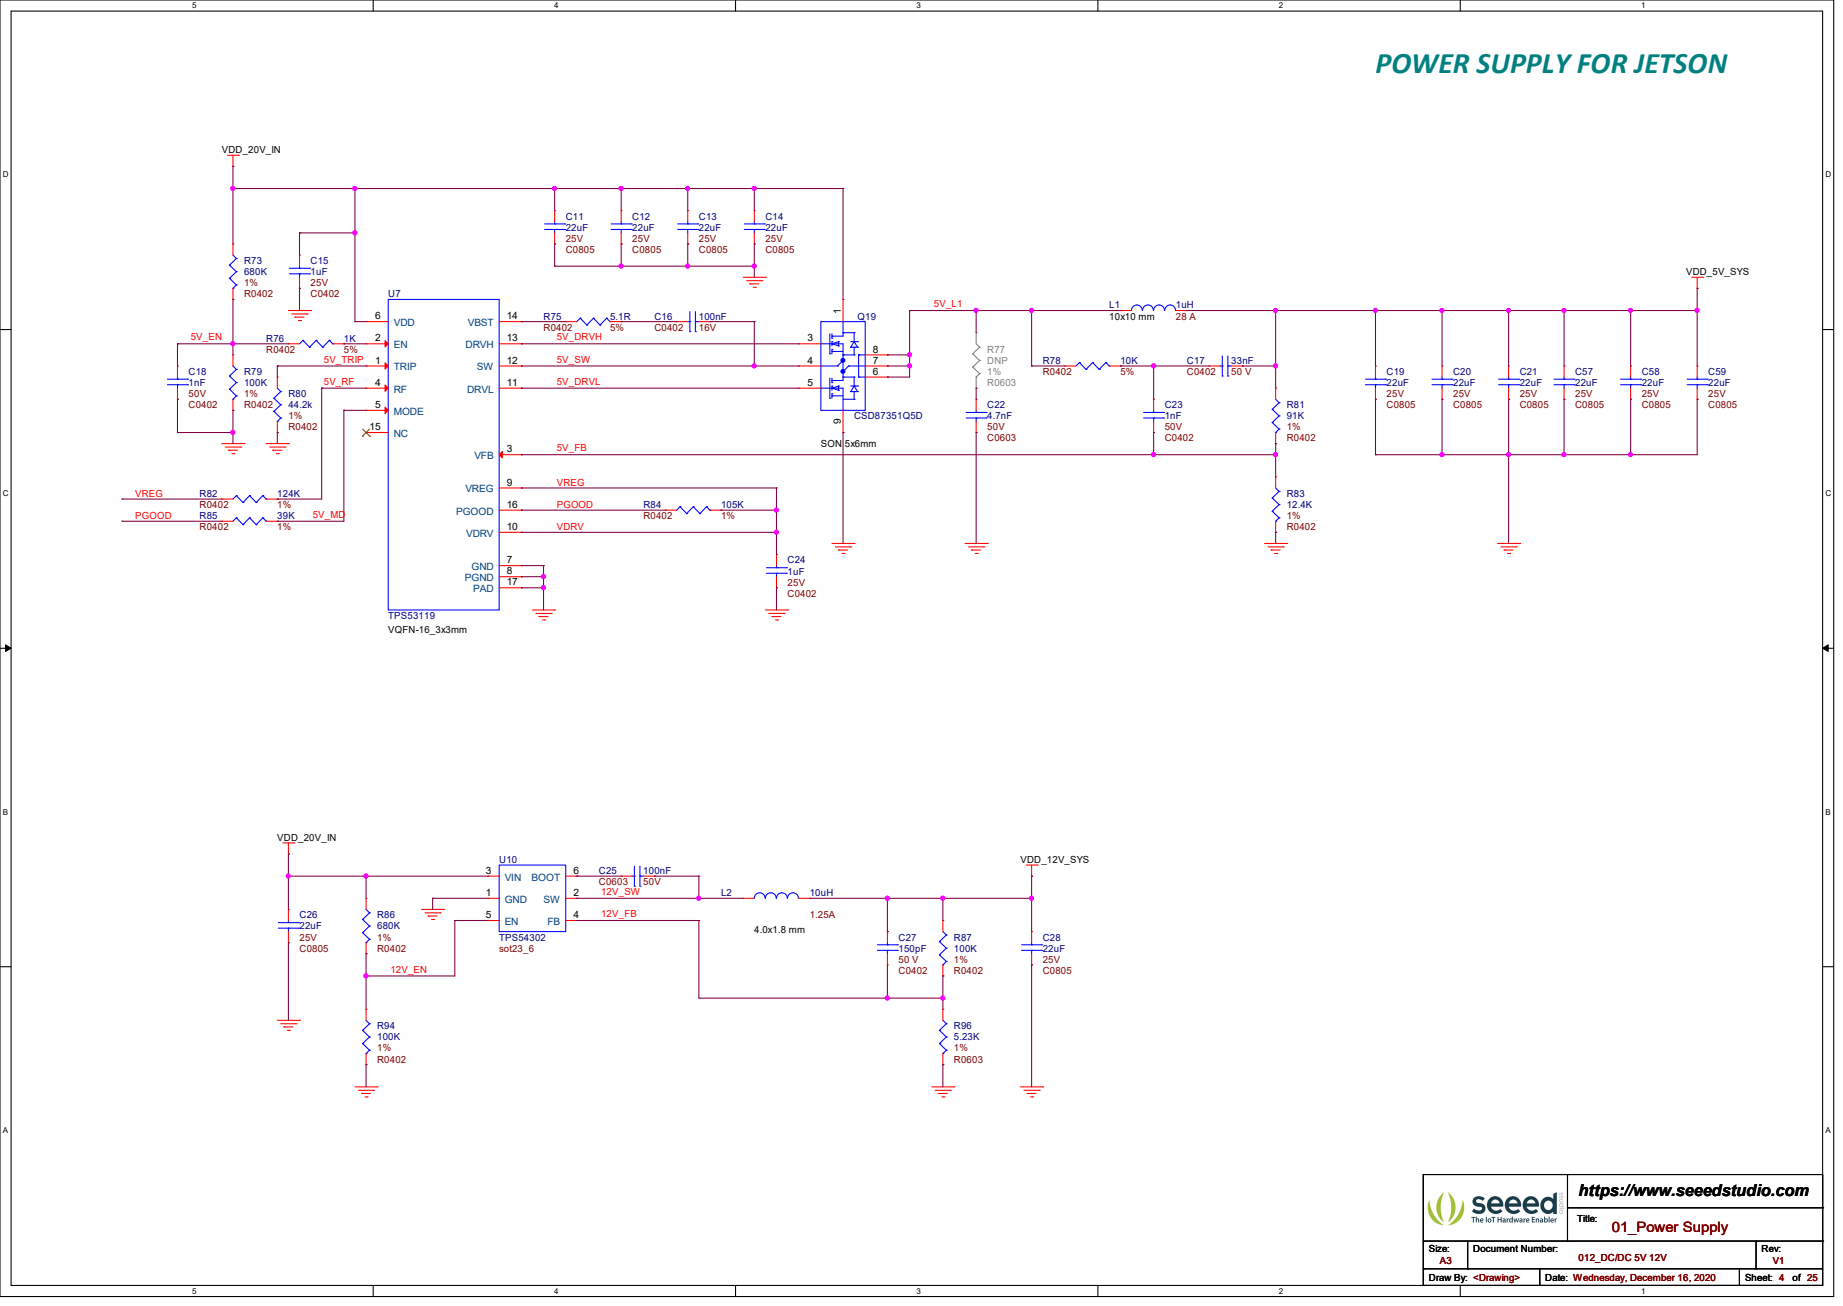
[picture p46: page 4]

# POWER SUPPLY FOR PERIPHERALS

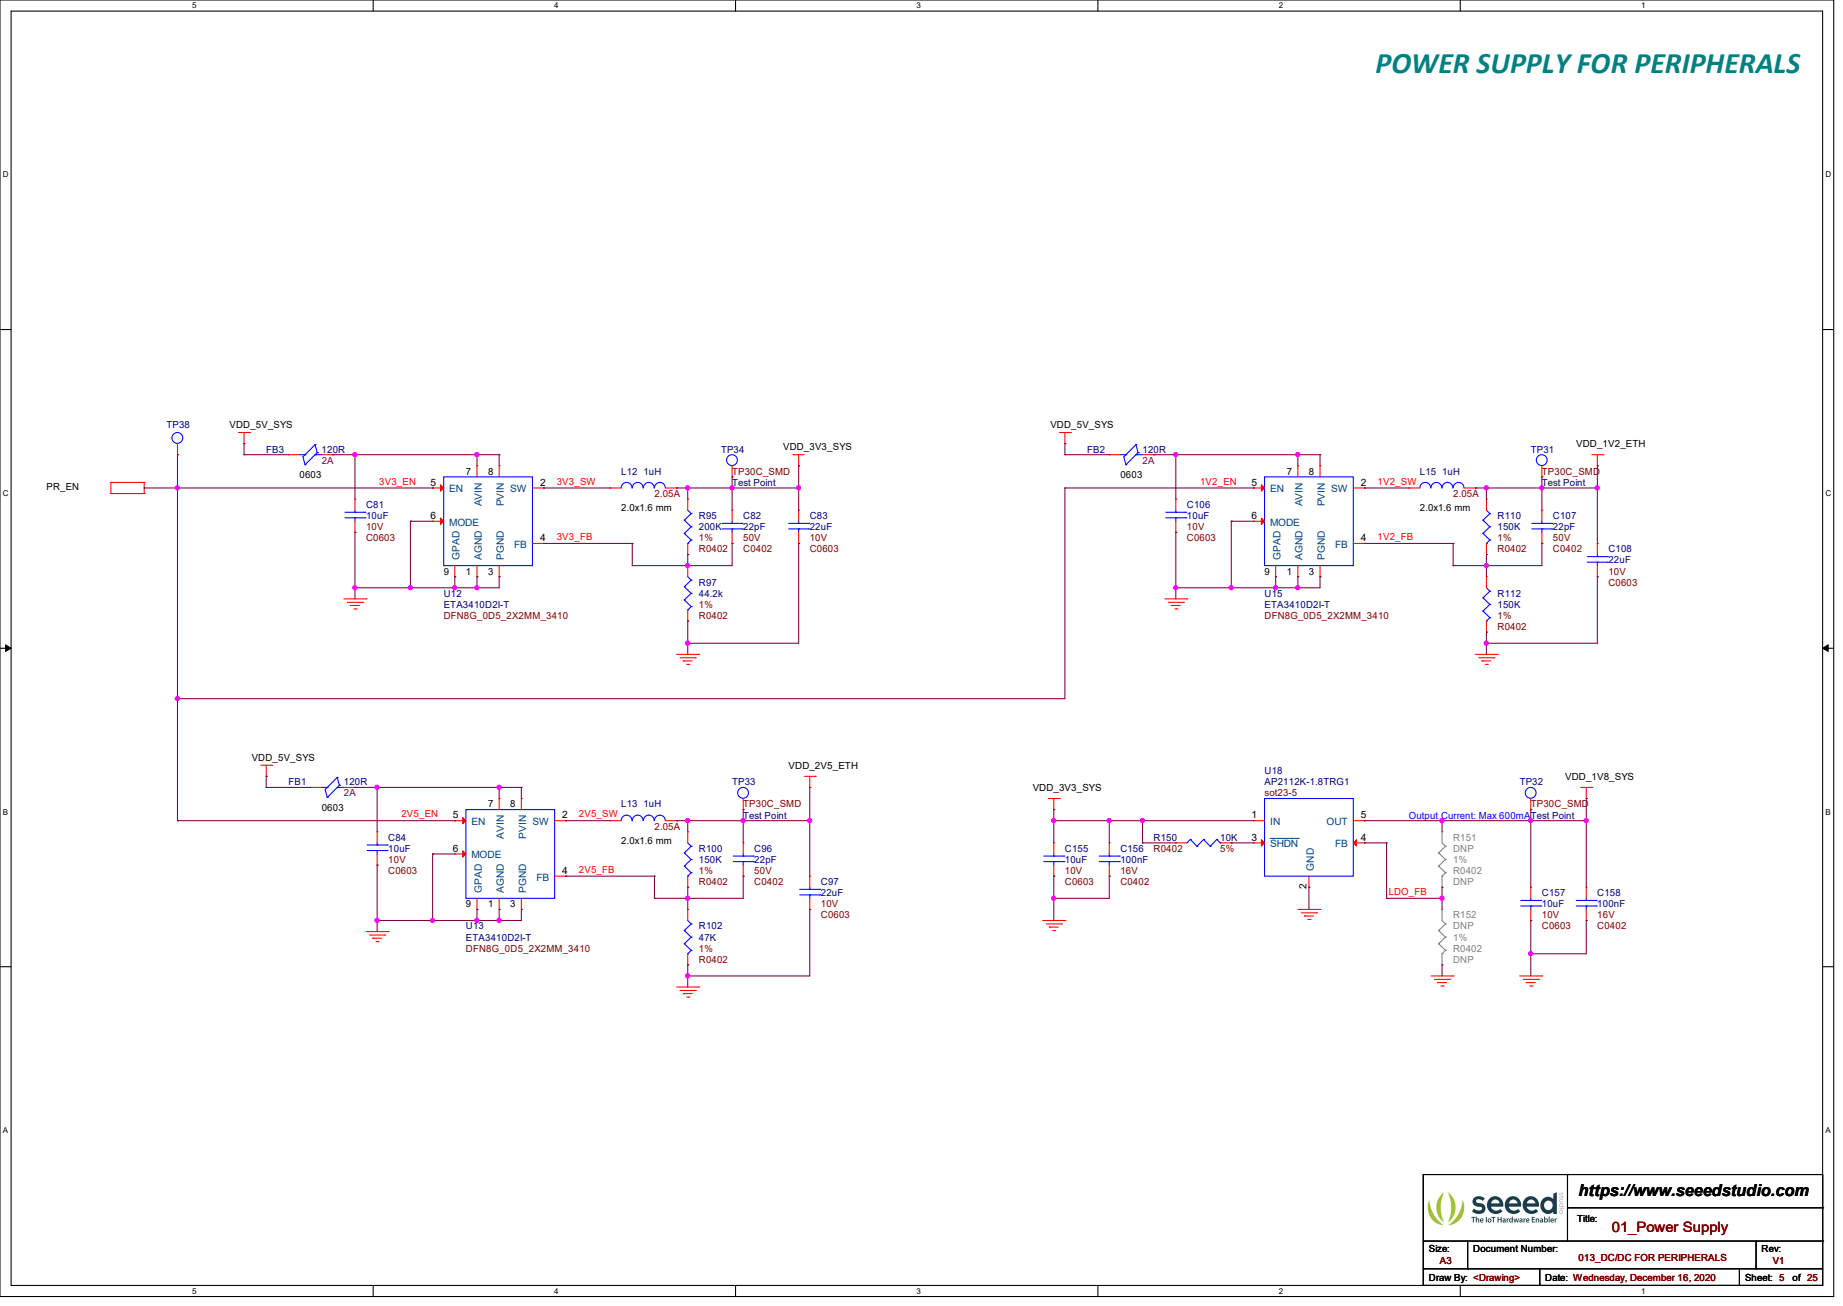
[picture p47: page 5]

01_Power Supply 013_DC/DC FOR PERIPHERALS

# UART, I2C, CAN and GPIOs

B2 | A | C1 B C2 | Q3

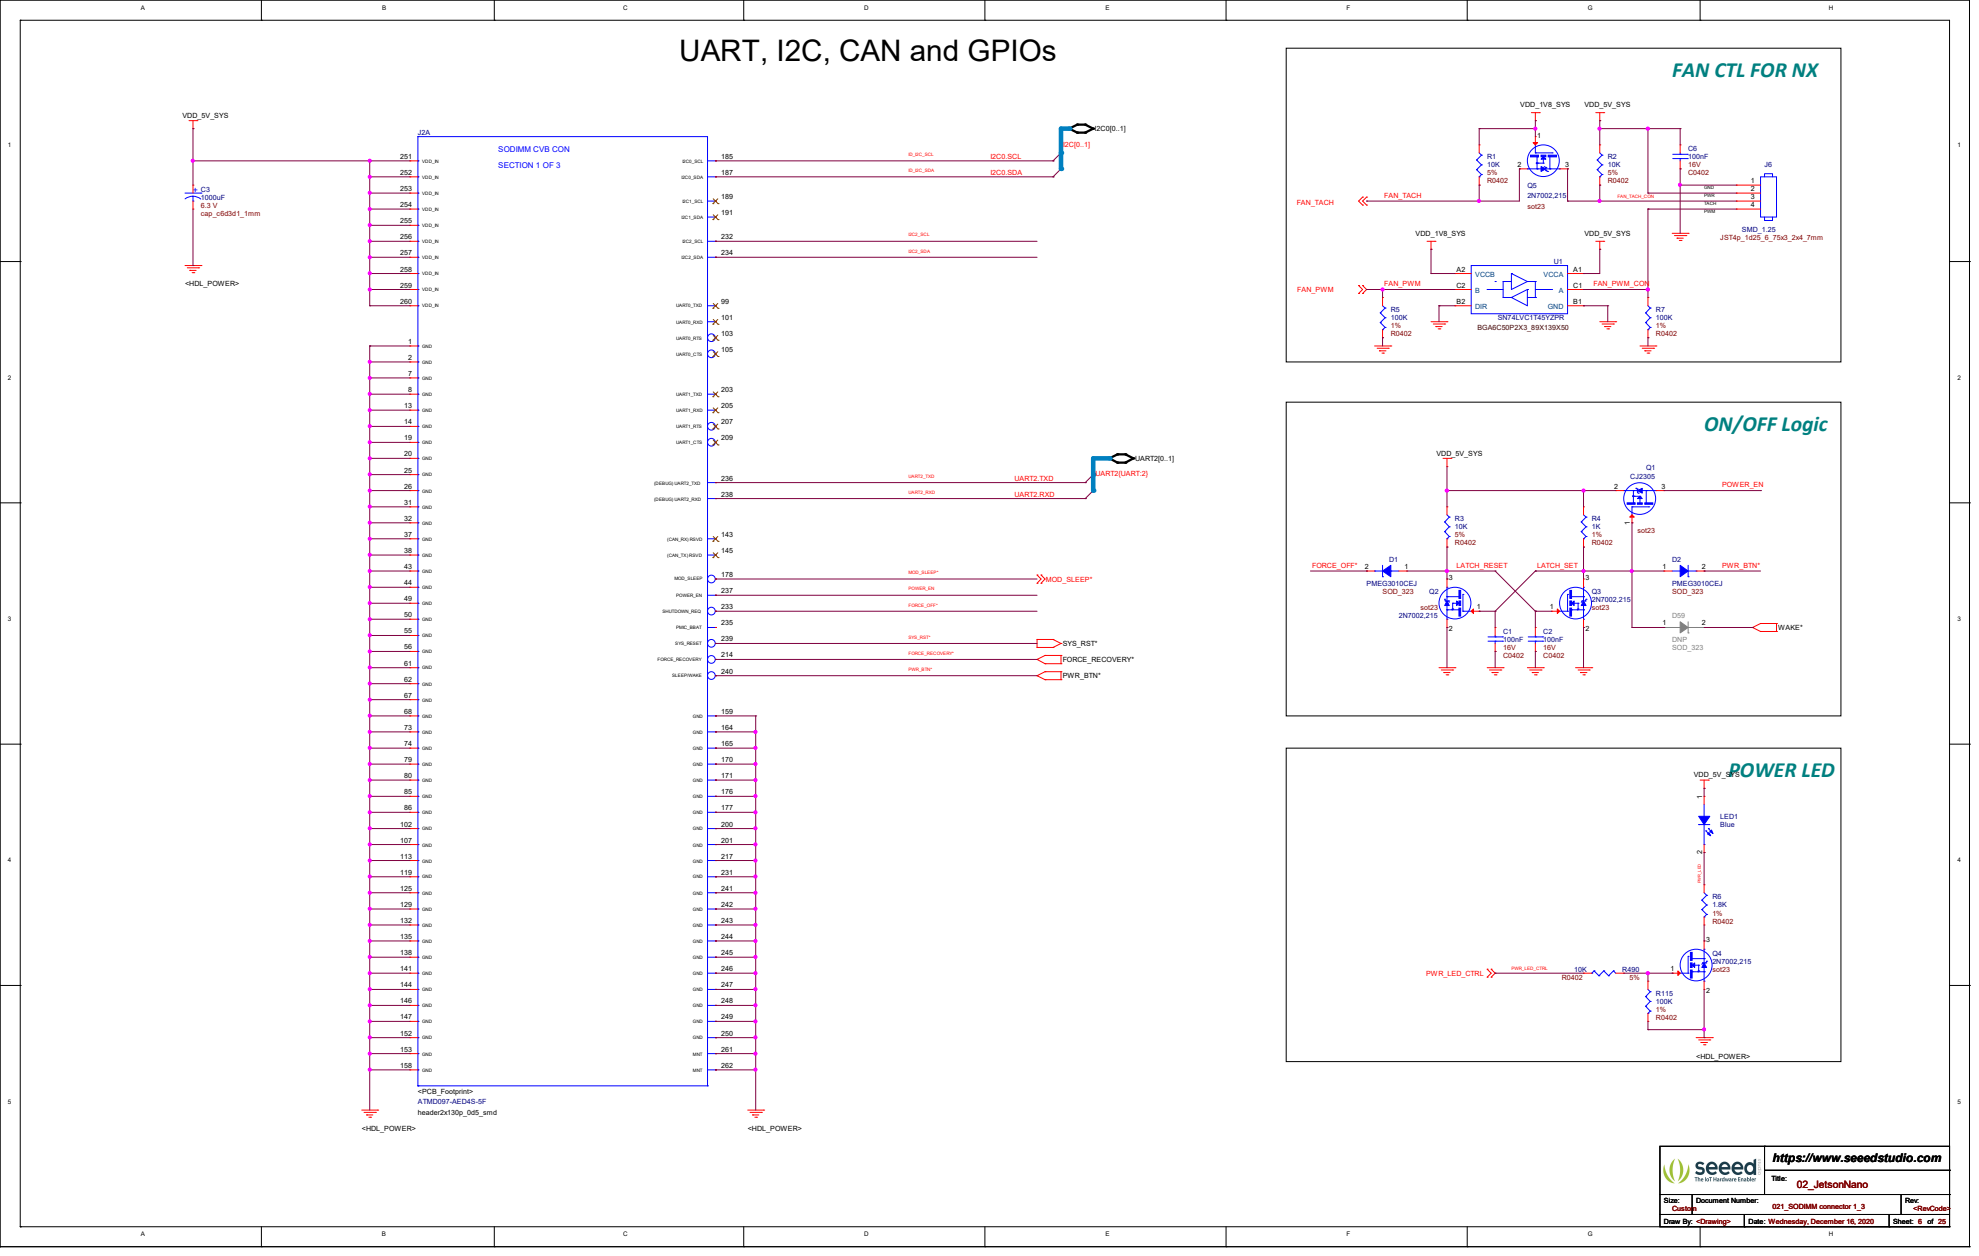
[picture p48: page 6]

# UART, I2C, CAN and GPIOs

B2 | A | C1 B C2 | Q16

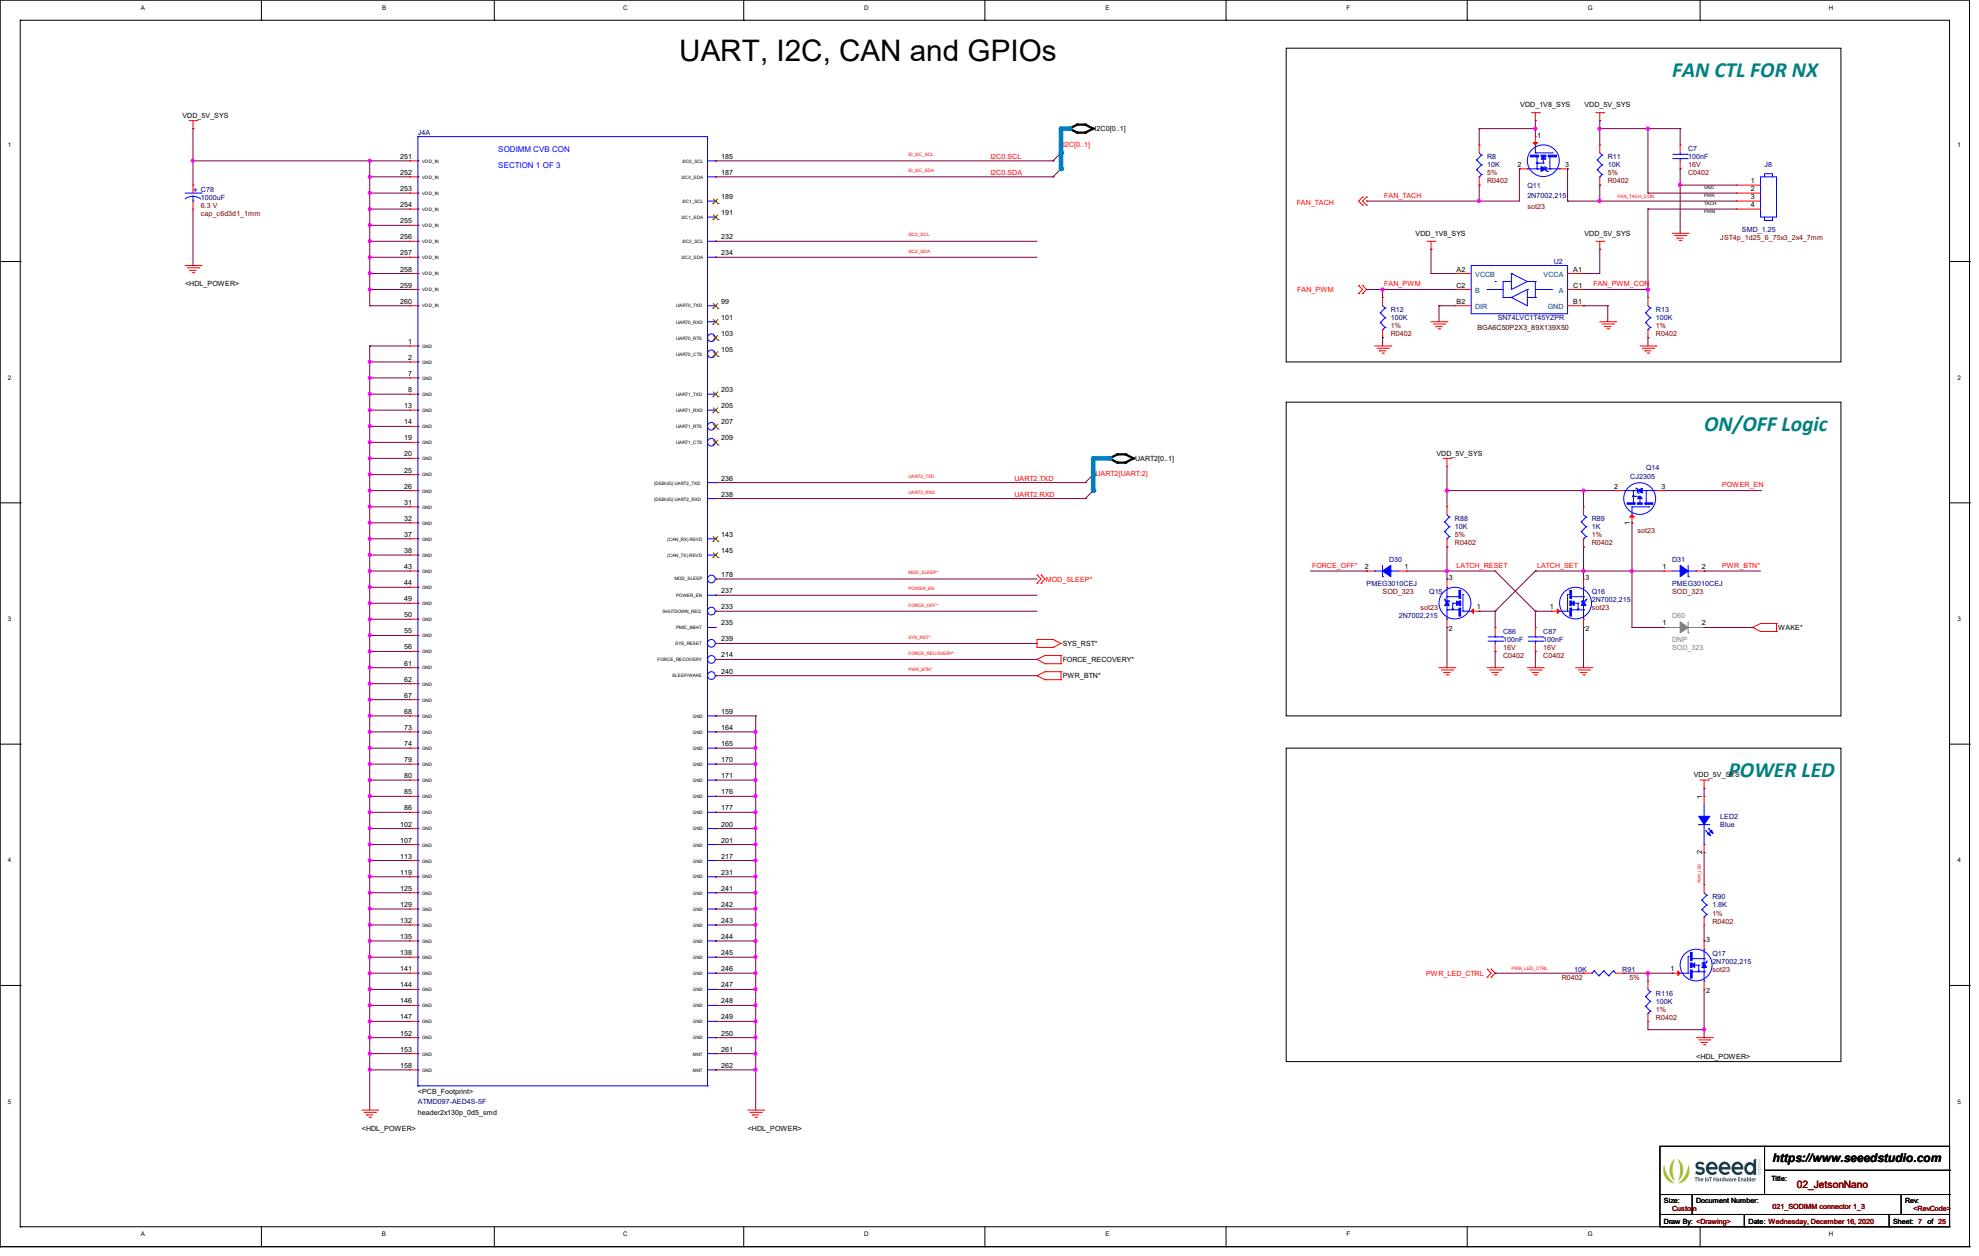
[picture p49: page 7]

# UART, I2C, CAN and GPIOs

B2 | A | C1 B C2 | Q22

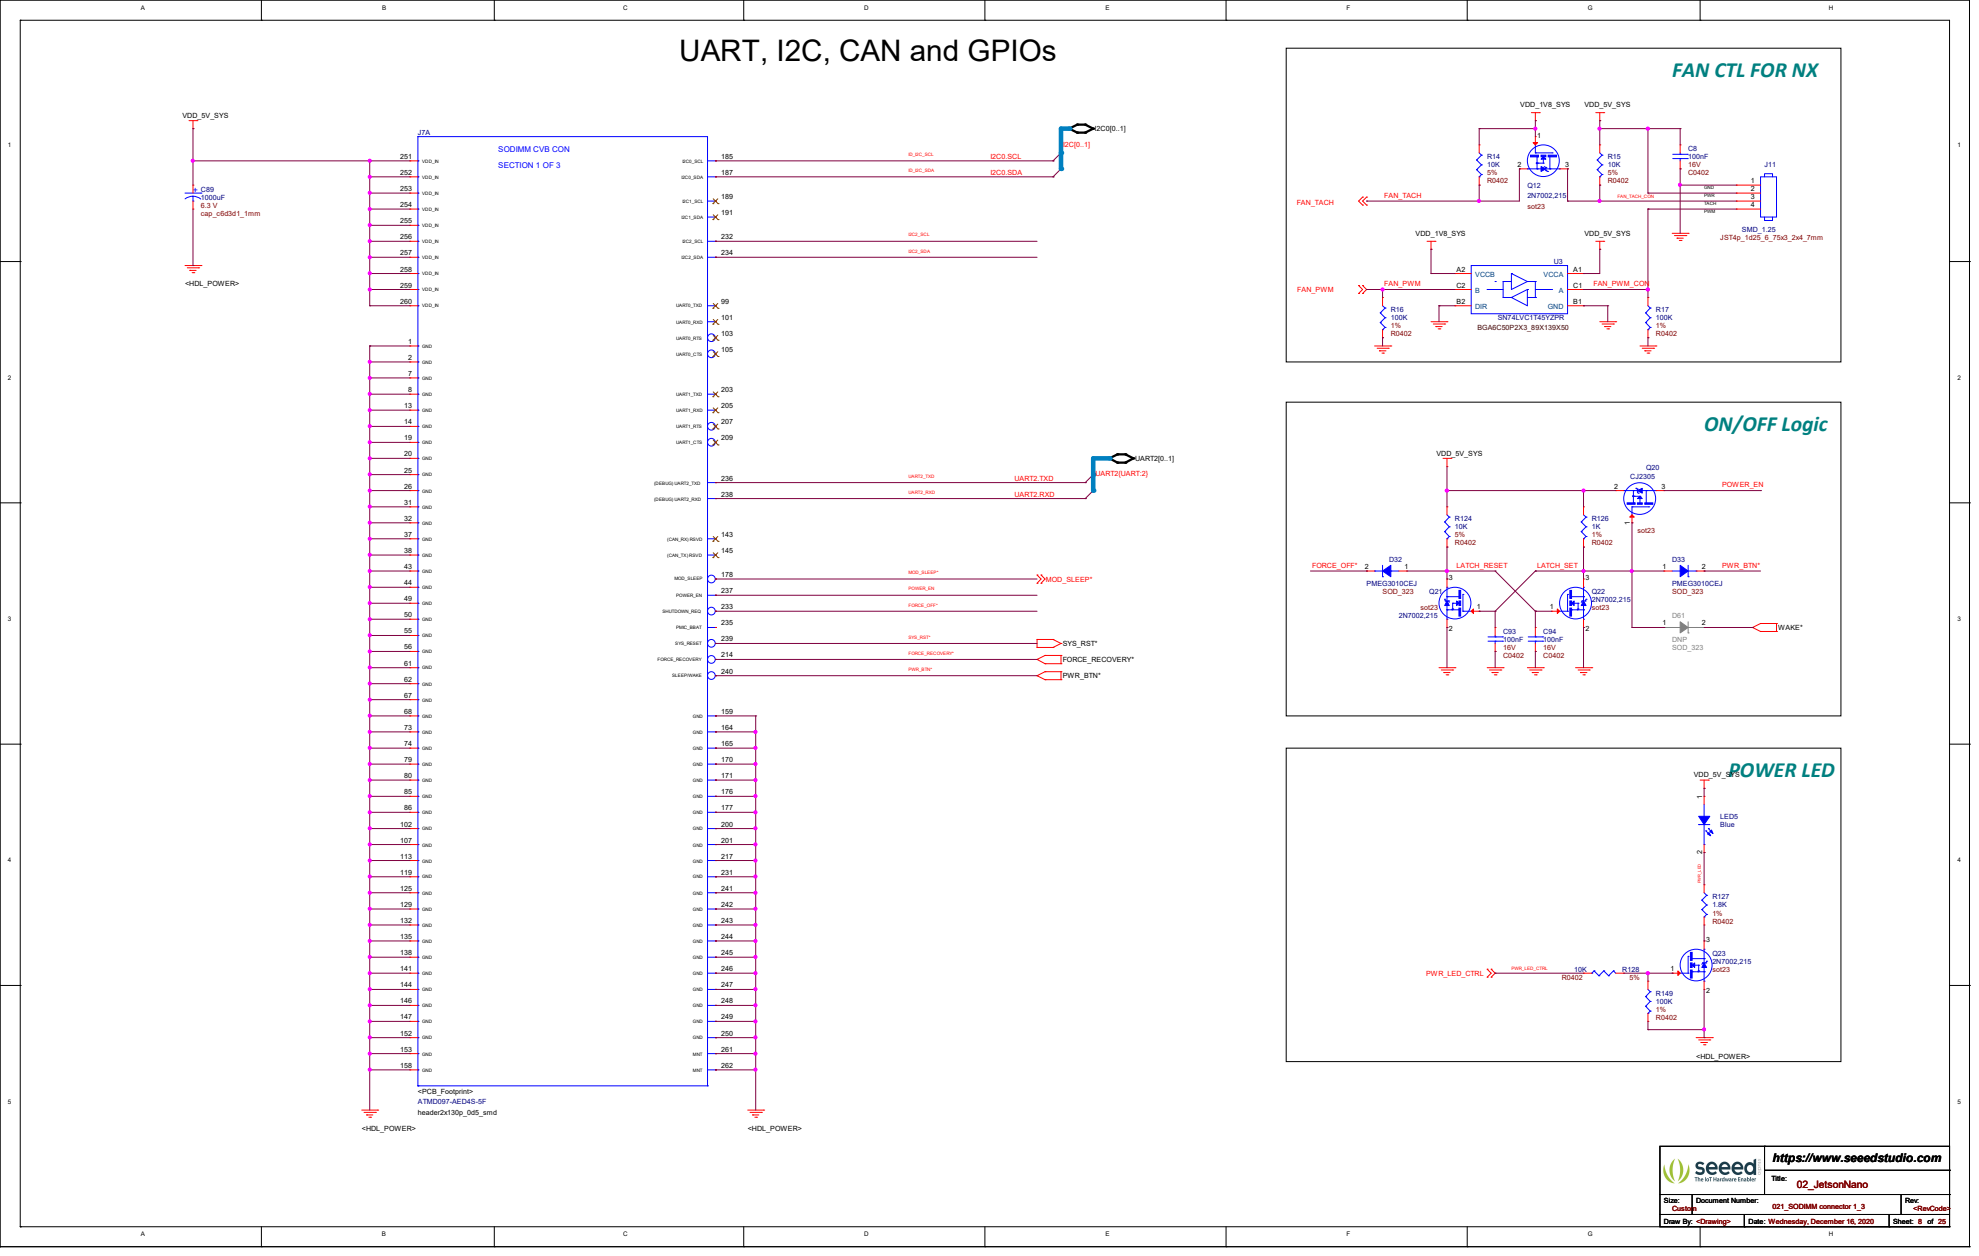
[picture p50: page 8]

# UART, I2C, CAN and GPIOs

B2 | A | C1 B C2 | Q30

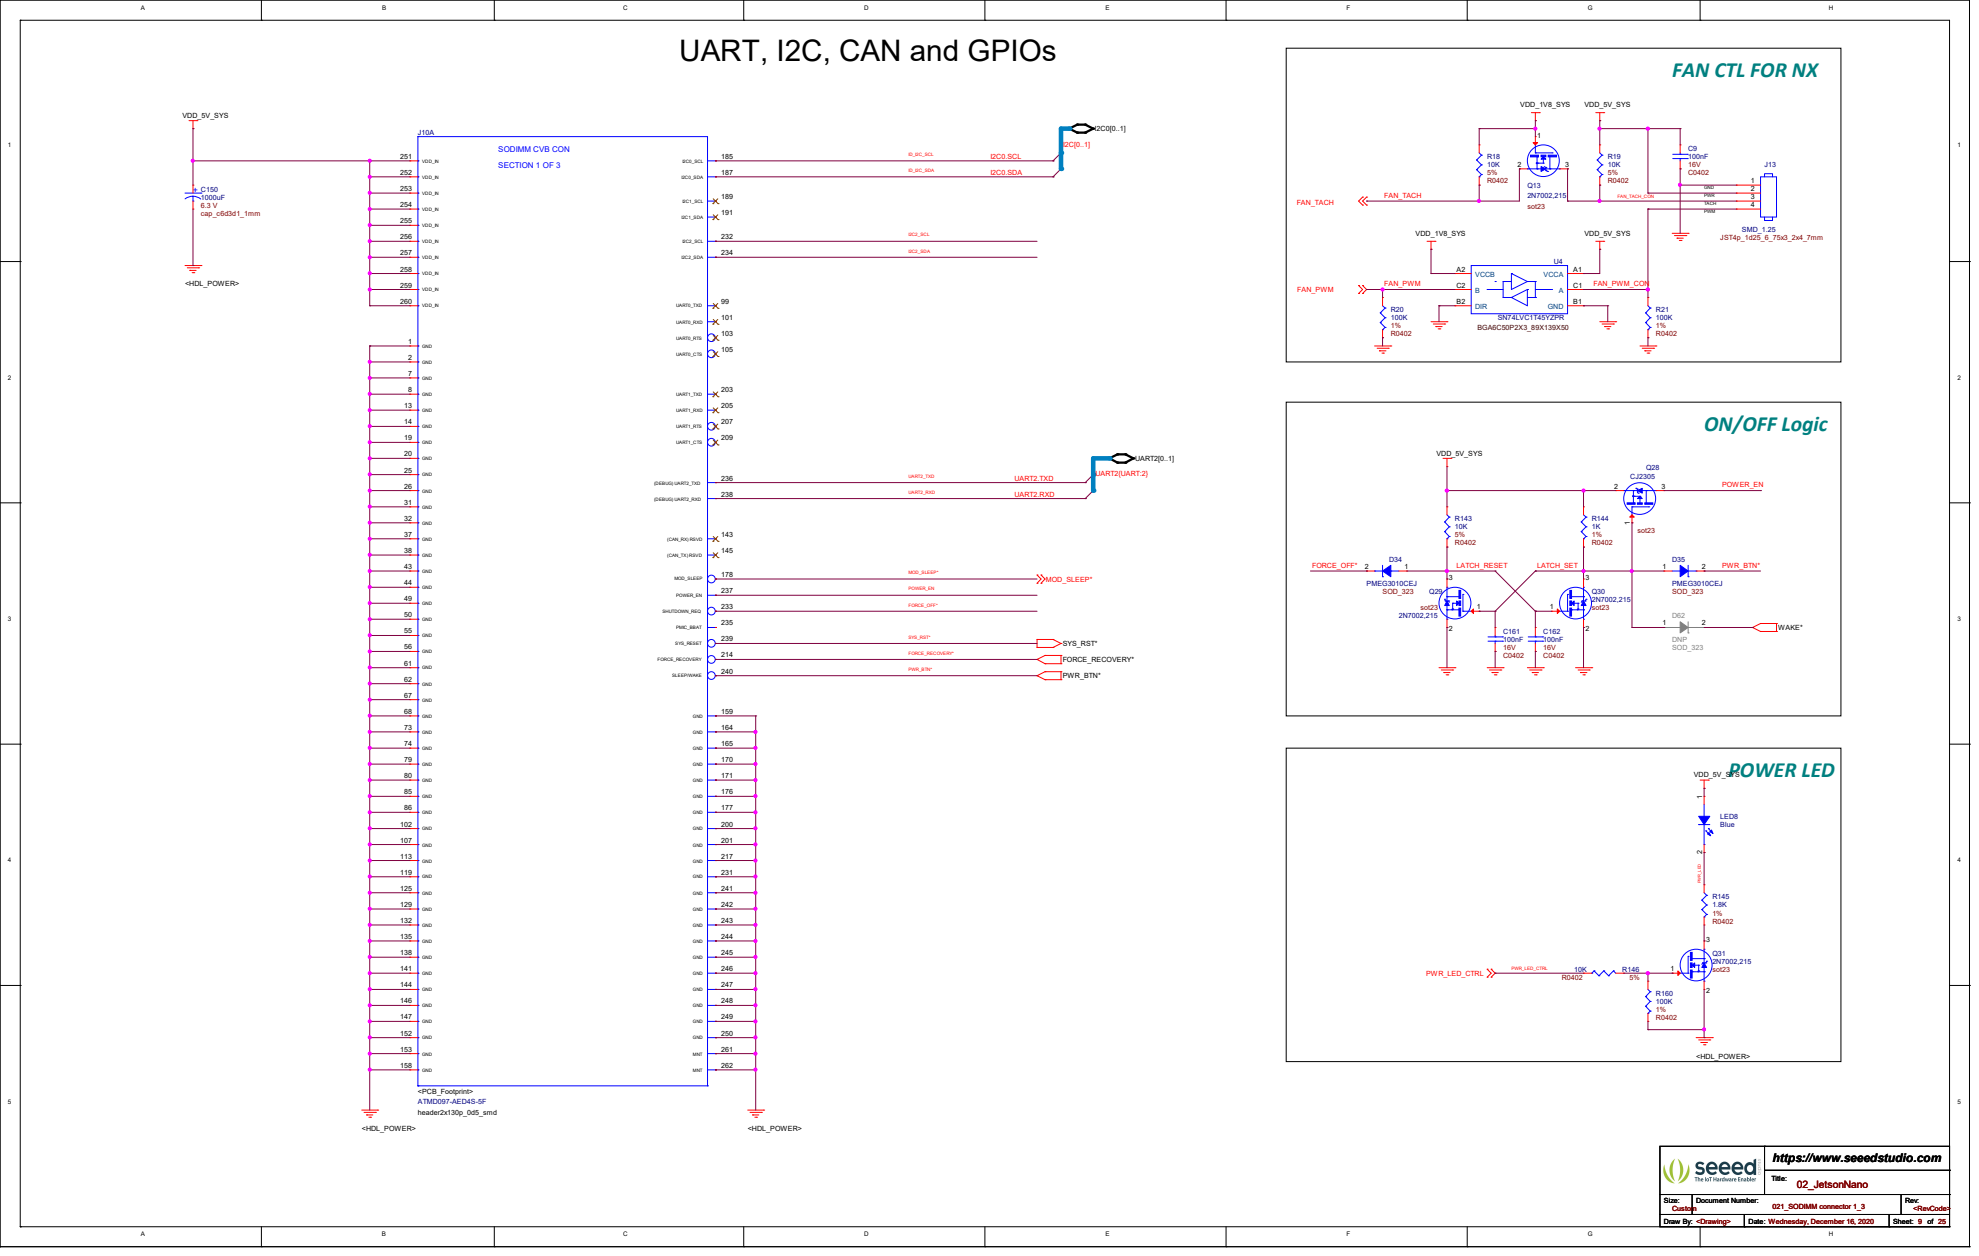
[picture p51: page 9]

# GPIOs, USB2.0, I2S, SPI, GBe and CSI

# USB0[0..2] USBA_AP[0..1] USB2[0..1]

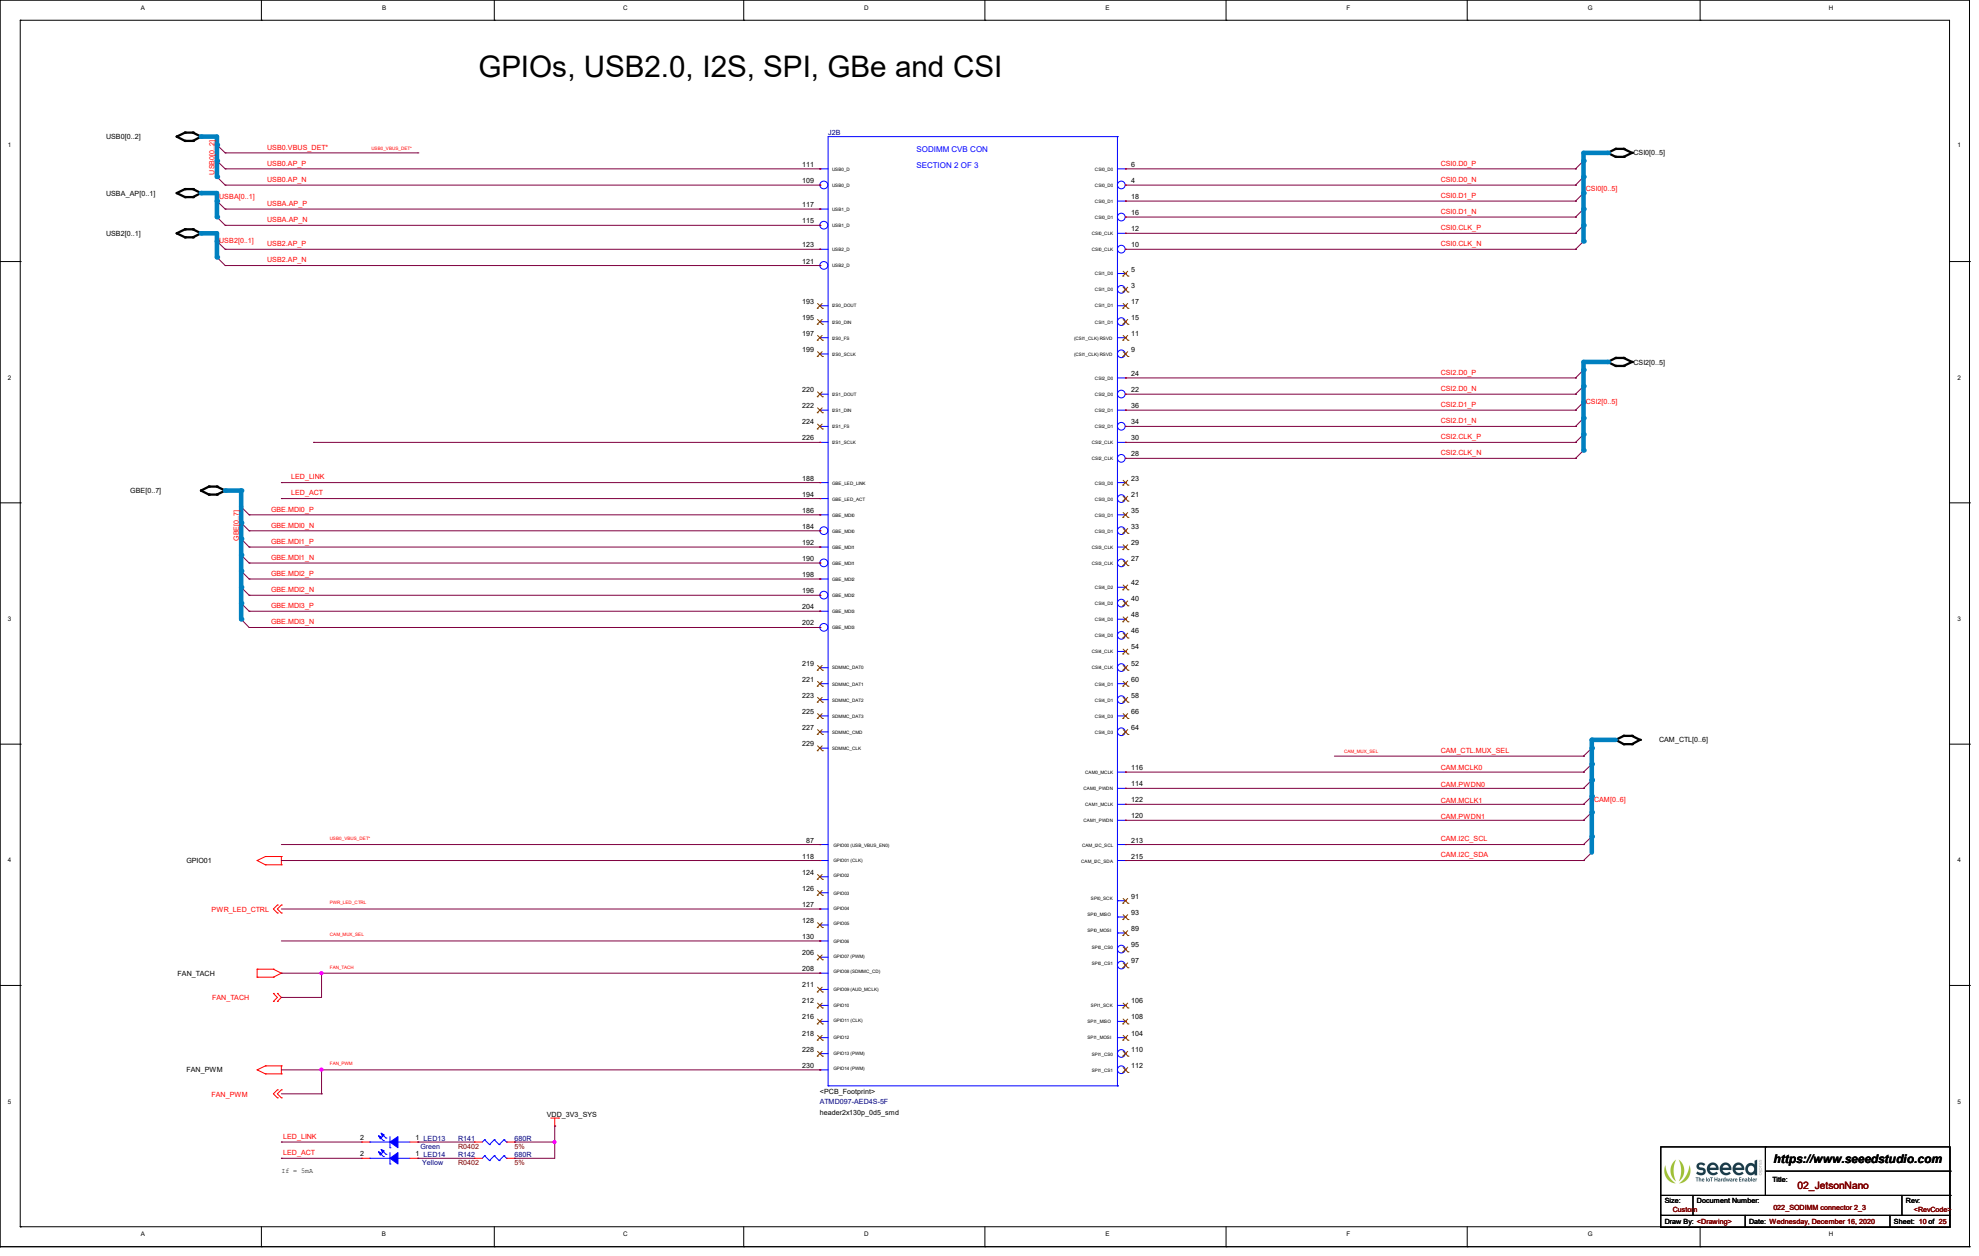
[picture p52: page 10]
CSI0[0..5] CSI2[0..5] GBE[0..7]; CAM_CTL[0..6] FAN_PWM; GPIO01 FAN_TACH; VDD_3V3_SYS; FAN_TACH; PWR_LED_CTRL FAN_PWM; Title: Size:; Document Number:; Rev: Draw By:; Date:; Sheet:; https://www.seeedstudio.com Custom; <RevCode>; <Drawing>; Wednesday, December 16, 2020; 02_JetsonNano; 022_SODIMM connector 2_3 Title: Size:; 022_SODIMM connector 2_3 R142; LED13 Green; SECTION 2 OF 3; <PCB_Footprint> ATMD097-AED4S-5F; header2x130p_0d5_smd; CSI1_D0; CSI0_D0; (CSI1_CLK) RSVD; CSI0_CLK; CSI1_D1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

SODIMM CVB CON J2B

LED_LINK GBE.MDI0_N GBE.MDI0_P GBE.MDI1_N GBE.MDI1_P GBE.MDI2_N GBE.MDI2_P GBE.MDI3_N GBE.MDI3_P

CAM.MCLK0 CAM.PWDN0 CAM.MCLK1 CAM.PWDN1 CAM.I2C_SCL CAM.I2C_SDA

# GPIOs, USB2.0, I2S, SPI, GBe and CSI

# USB0[0..2] USBA_AP[0..1] USB2[0..1]

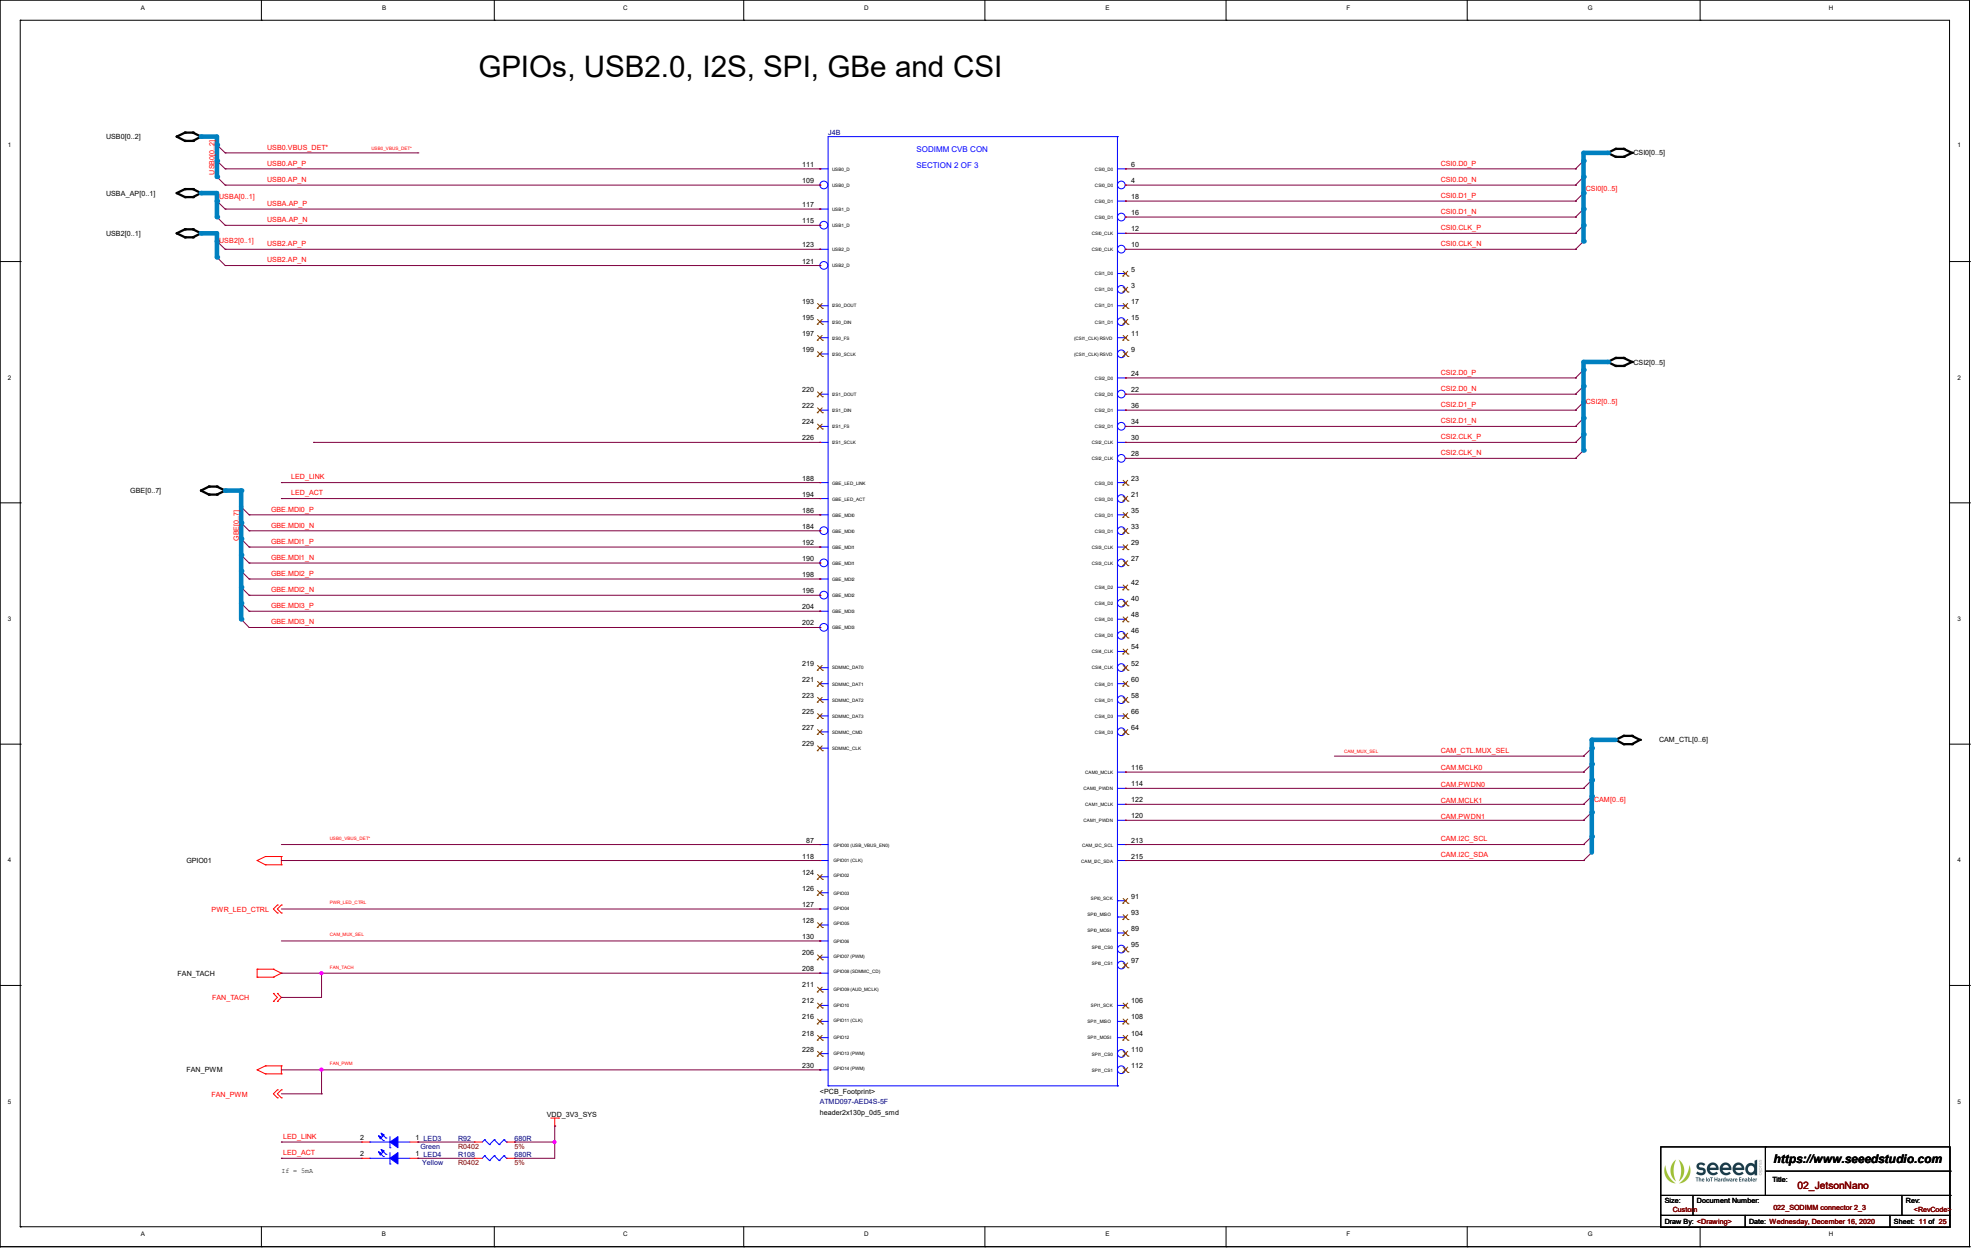
[picture p53: page 11]
CSI0[0..5] CSI2[0..5] GBE[0..7]; CAM_CTL[0..6] FAN_PWM; GPIO01 FAN_TACH; VDD_3V3_SYS; FAN_TACH; PWR_LED_CTRL FAN_PWM; Title: Size:; Document Number:; Rev: Draw By:; Date:; Sheet:; https://www.seeedstudio.com Custom; <RevCode>; <Drawing>; Wednesday, December 16, 2020; 02_JetsonNano; 022_SODIMM connector 2_3 Title: Size:; 022_SODIMM connector 2_3 R108; LED3 Green; SECTION 2 OF 3; <PCB_Footprint> ATMD097-AED4S-5F; header2x130p_0d5_smd; CSI1_D0; CSI0_D0; (CSI1_CLK) RSVD; CSI0_CLK; CSI1_D1; CSI0_D1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

SODIMM CVB CON J4B

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

CAM.MCLK0 CAM.PWDN0 CAM.MCLK1 CAM.PWDN1 CAM.I2C_SCL CAM.I2C_SDA

# GPIOs, USB2.0, I2S, SPI, GBe and CSI

# USB0[0..2] USBA_AP[0..1] USB2[0..1]

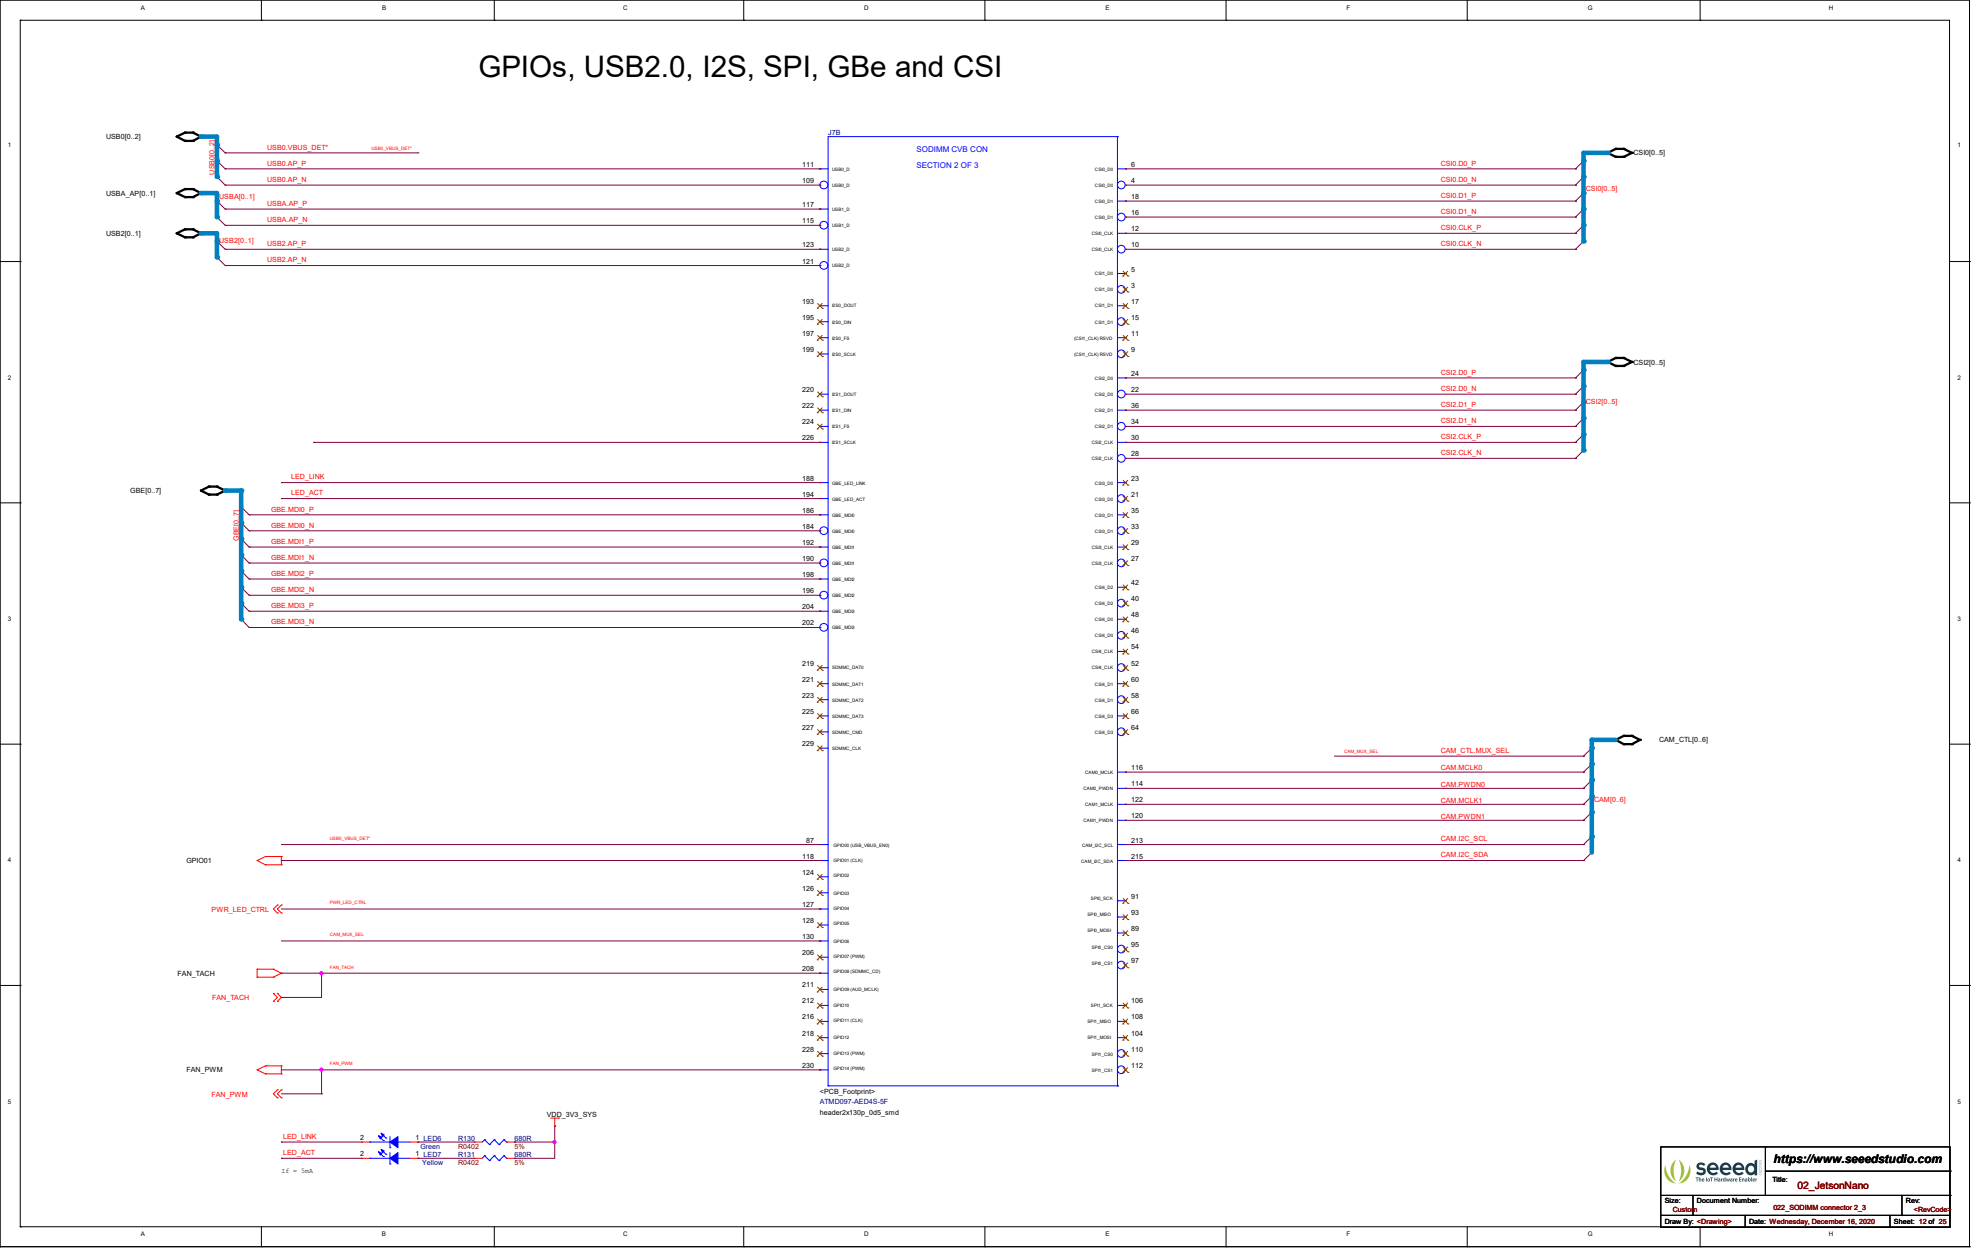
[picture p54: page 12]
CSI0[0..5] CSI2[0..5] GBE[0..7]; CAM_CTL[0..6] FAN_PWM; GPIO01 FAN_TACH; VDD_3V3_SYS; FAN_TACH; PWR_LED_CTRL FAN_PWM; Title: Size:; Document Number:; Rev: Draw By:; Date:; Sheet:; https://www.seeedstudio.com Custom; <RevCode>; <Drawing>; Wednesday, December 16, 2020; 02_JetsonNano; 022_SODIMM connector 2_3 Title: Size:; 022_SODIMM connector 2_3 R131; LED6 Green; SECTION 2 OF 3; <PCB_Footprint> ATMD097-AED4S-5F; header2x130p_0d5_smd; CSI1_D0; CSI0_D0; (CSI1_CLK) RSVD; CSI0_CLK; CSI1_D1; CSI0_D1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

SODIMM CVB CON J7B

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

CAM.MCLK0 CAM.PWDN0 CAM.MCLK1 CAM.PWDN1 CAM.I2C_SCL CAM.I2C_SDA

# GPIOs, USB2.0, I2S, SPI, GBe and CSI

# USB0[0..2] USBA_AP[0..1] USB2[0..1]

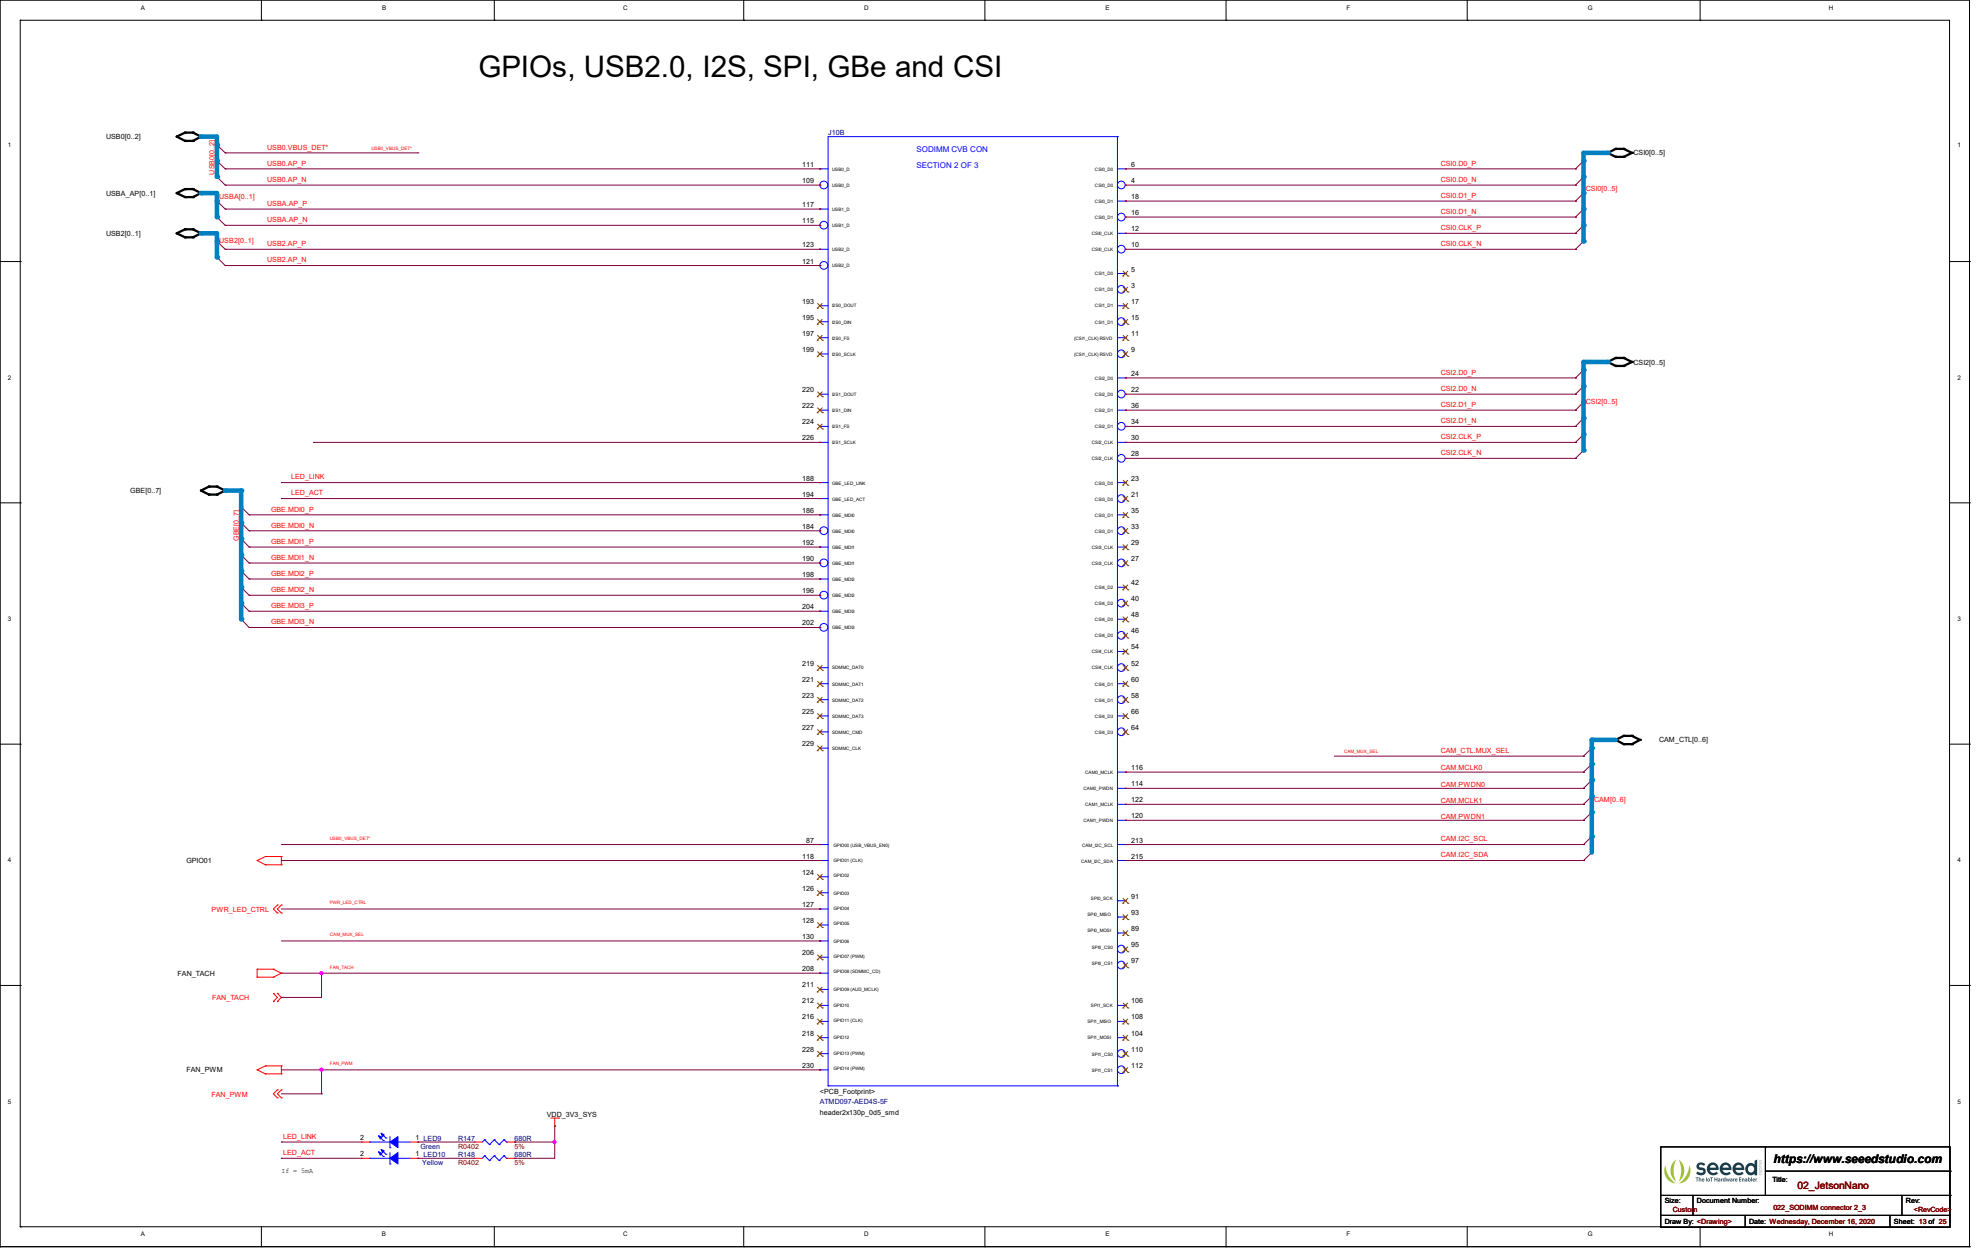
[picture p55: page 13]
CSI0[0..5] CSI2[0..5] GBE[0..7]; CAM_CTL[0..6] FAN_PWM; GPIO01 FAN_TACH; VDD_3V3_SYS; FAN_TACH; PWR_LED_CTRL FAN_PWM; Title: Size:; Document Number:; Rev: Draw By:; Date:; Sheet:; https://www.seeedstudio.com Custom; <RevCode>; <Drawing>; Wednesday, December 16, 2020; 02_JetsonNano; 022_SODIMM connector 2_3 Title: Size:; 022_SODIMM connector 2_3 R148; LED9 Green; SECTION 2 OF 3; <PCB_Footprint> ATMD097-AED4S-5F; header2x130p_0d5_smd; CSI1_D0; CSI0_D0; (CSI1_CLK) RSVD; CSI0_CLK; CSI1_D1; CSI0_D1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

SODIMM CVB CON J10B

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

CAM.MCLK0 CAM.PWDN0 CAM.MCLK1 CAM.PWDN1 CAM.I2C_SCL CAM.I2C_SDA

# HDMI, DP, DSI, USBSS and PCIe

# DSI_CLK 77

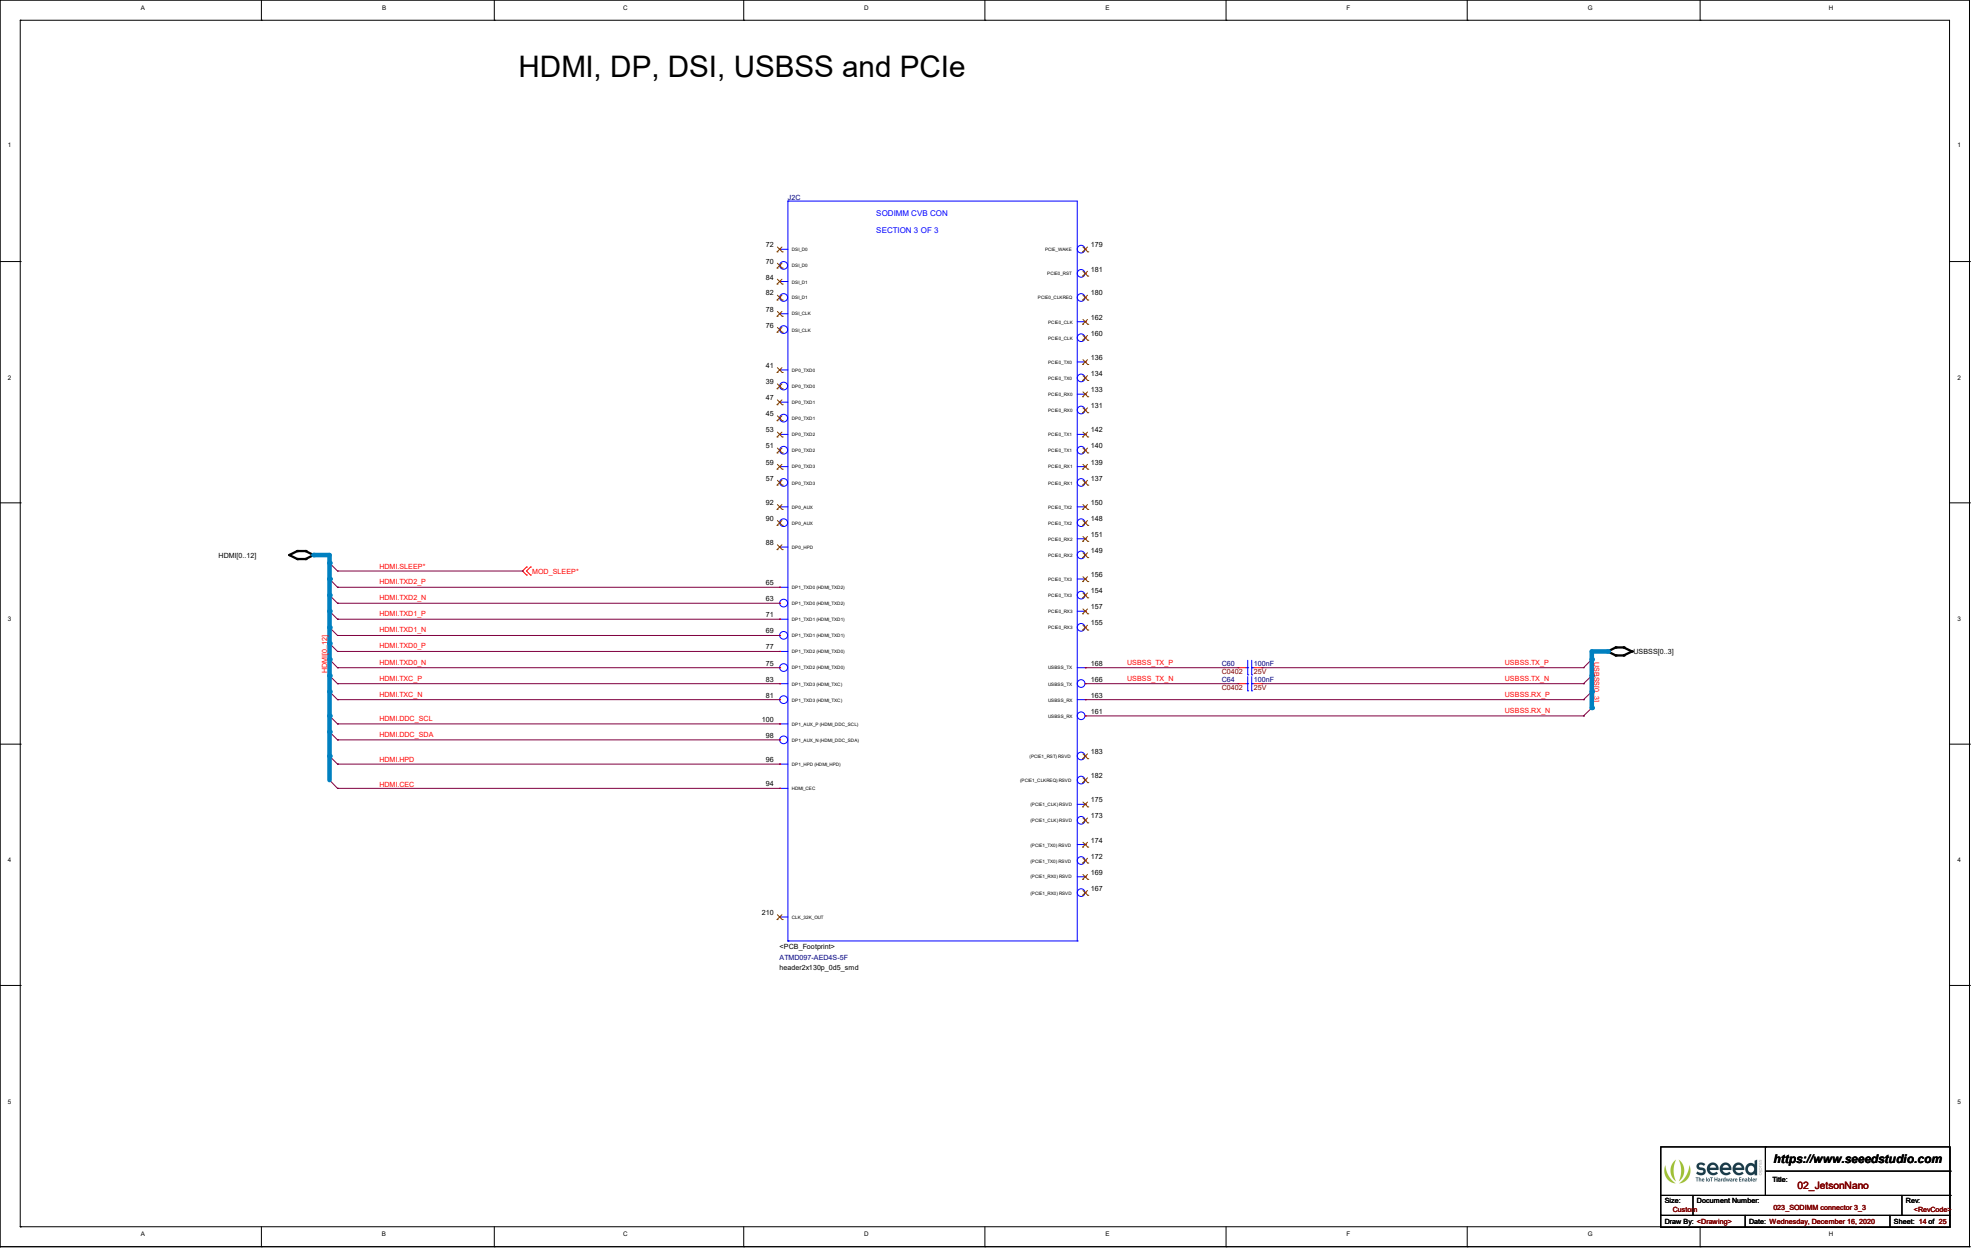
[picture p56: page 14]
USBSS[0..3] HDMI[0..12]; MOD_SLEEP*; Title: Size:; Document Number:; Rev: Draw By:; Date:; Sheet:; https://www.seeedstudio.com Custom; <RevCode>; <Drawing>; Wednesday, December 16, 2020; 02_JetsonNano; 023_SODIMM connector 3_3 Title: Size:; 023_SODIMM connector 3_3; SECTION 3 OF 3; <PCB_Footprint> ATMD097-AED4S-5F; header2x130p_0d5_smd; DP0_TXD0 41 DP0_TXD0 45; DP0_TXD1 47 DP0_TXD1 51; DP0_TXD2 53 DP0_TXD2 57; DP0_TXD3 59 DP0_TXD3 63; DP1_TXD0 (HDMI_TXD2) 65 DP1_TXD0 (HDMI_TXD2) 69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

SODIMM CVB CON J2C

HDMI.DDC_SCL HDMI.DDC_SDA HDMI.HPD

# HDMI, DP, DSI, USBSS and PCIe

# DSI_CLK 77

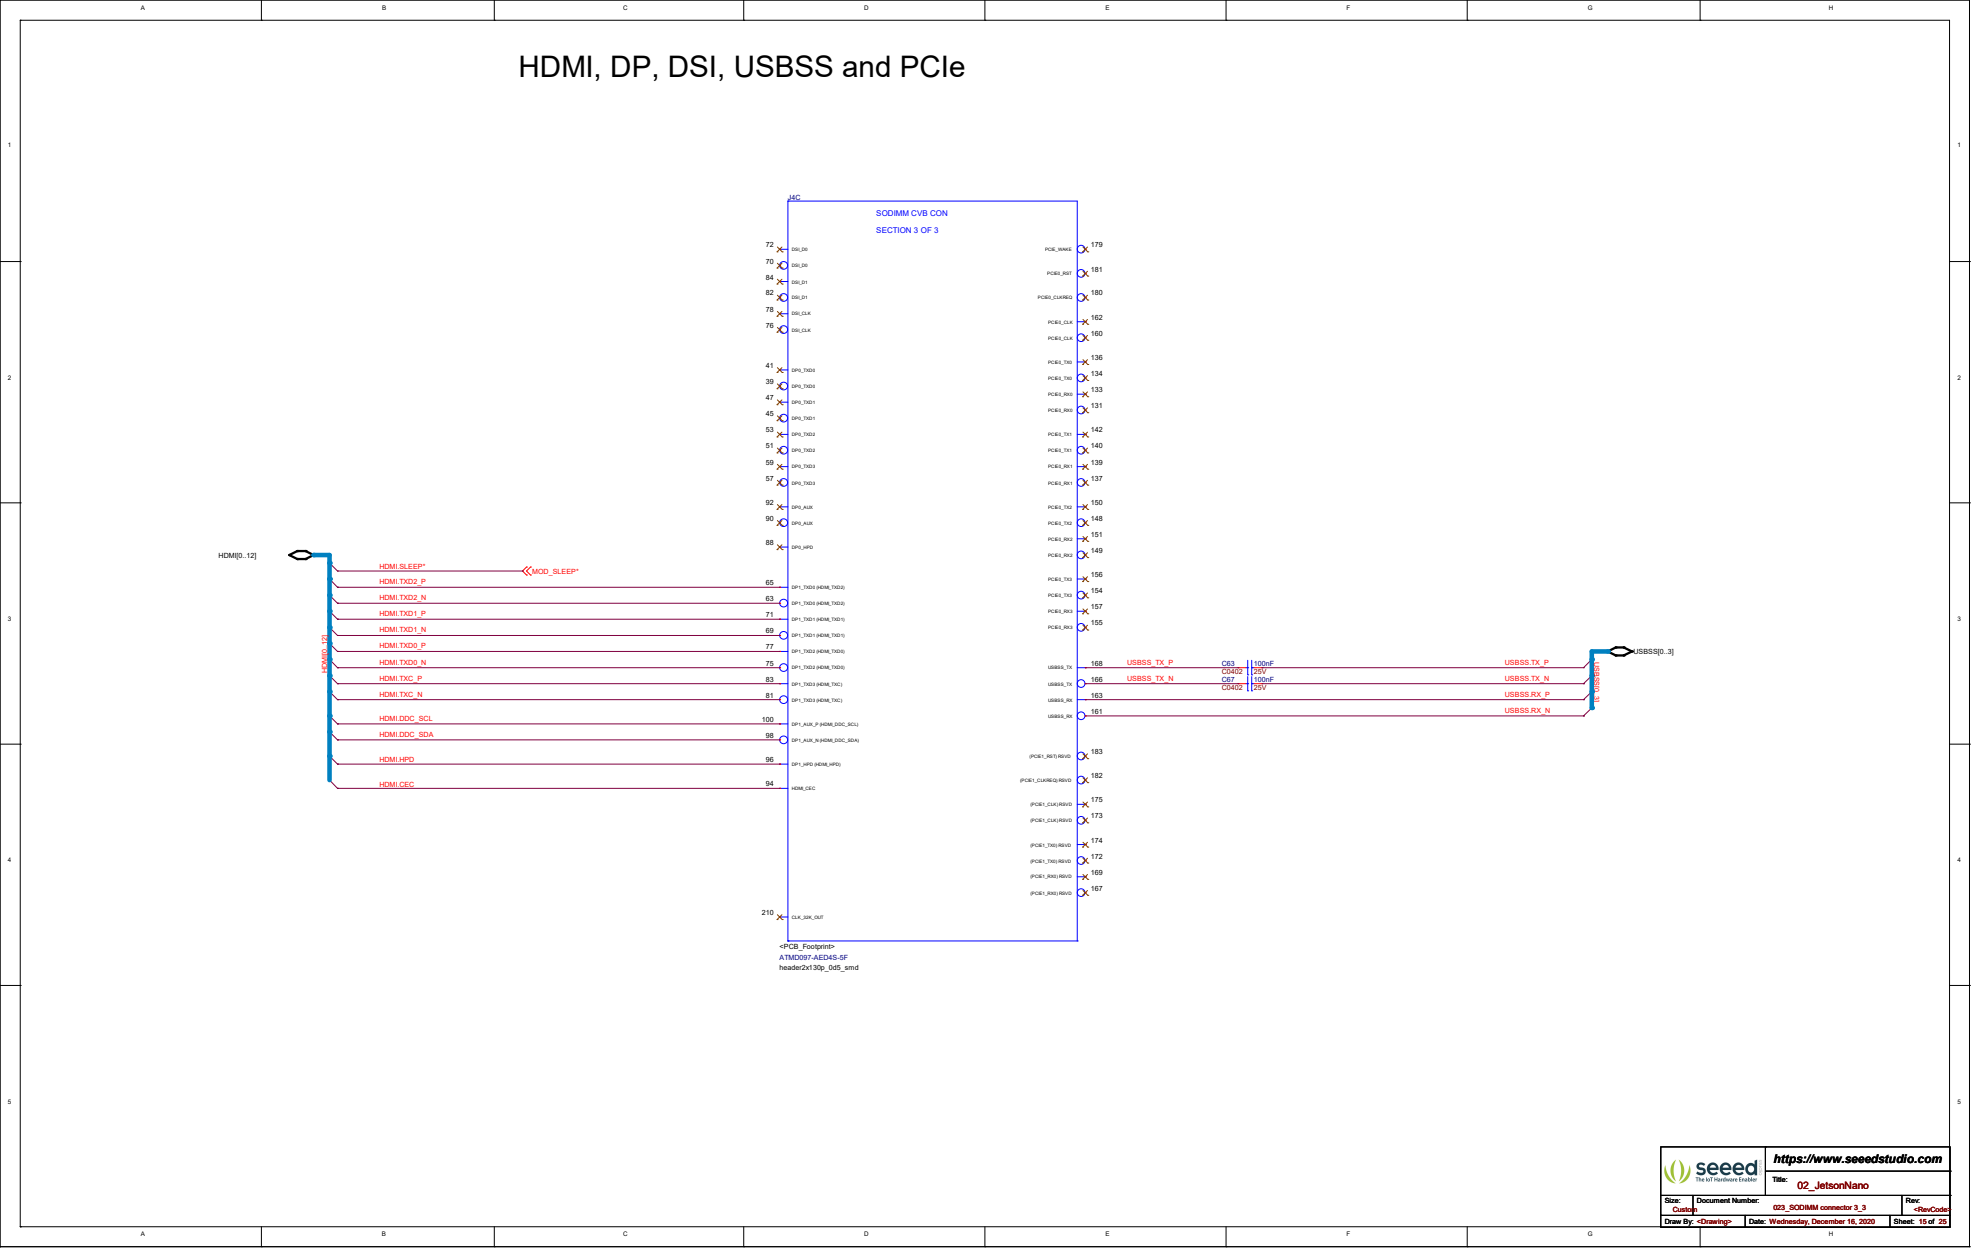
[picture p57: page 15]
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

SODIMM CVB CON J4C

HDMI.DDC_SCL HDMI.DDC_SDA HDMI.HPD

# HDMI, DP, DSI, USBSS and PCIe

# DSI_CLK 77

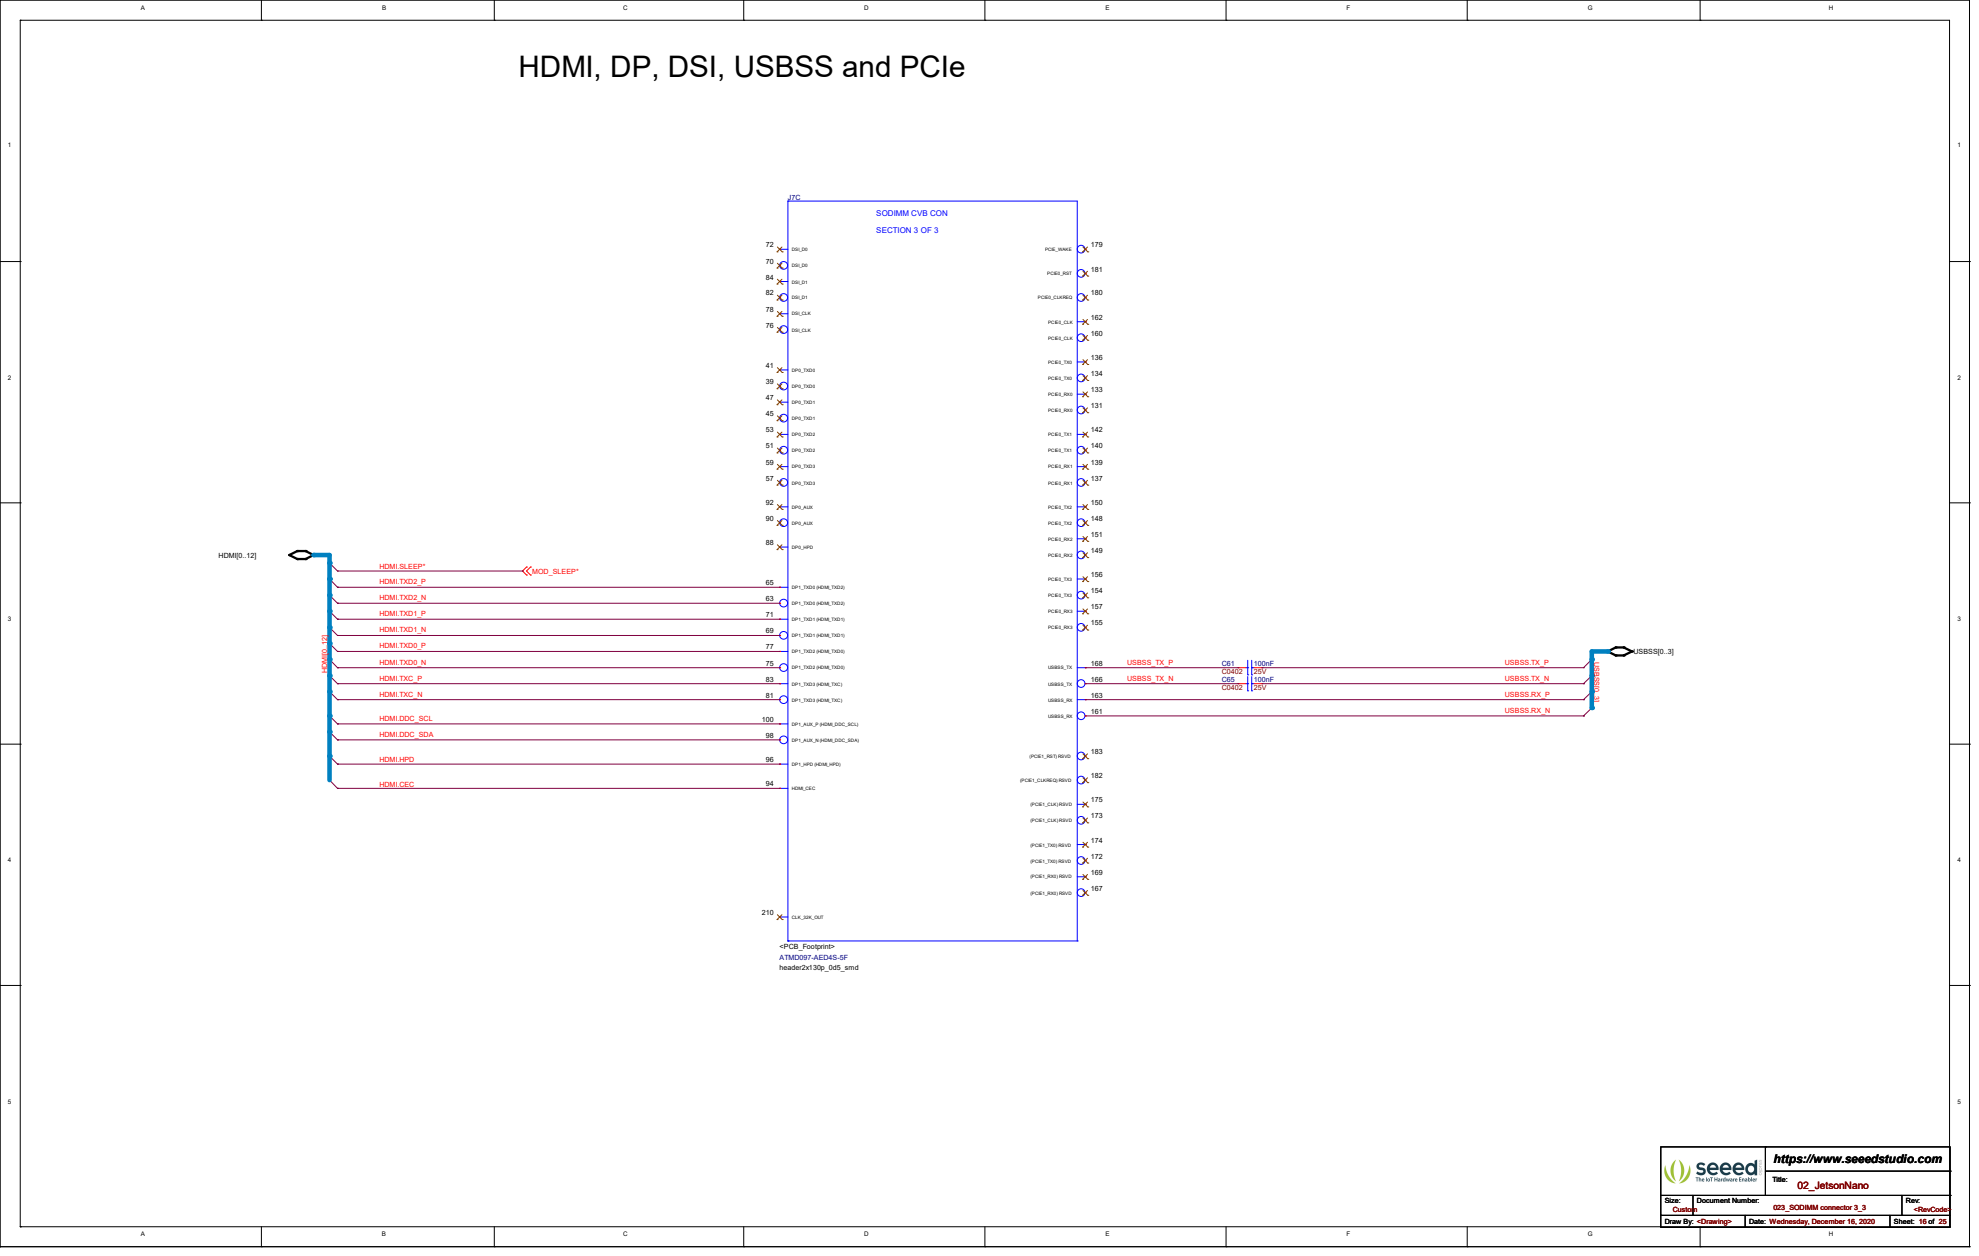
[picture p58: page 16]
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

SODIMM CVB CON J7C

HDMI.DDC_SCL HDMI.DDC_SDA HDMI.HPD

# HDMI, DP, DSI, USBSS and PCIe

# DSI_CLK 77

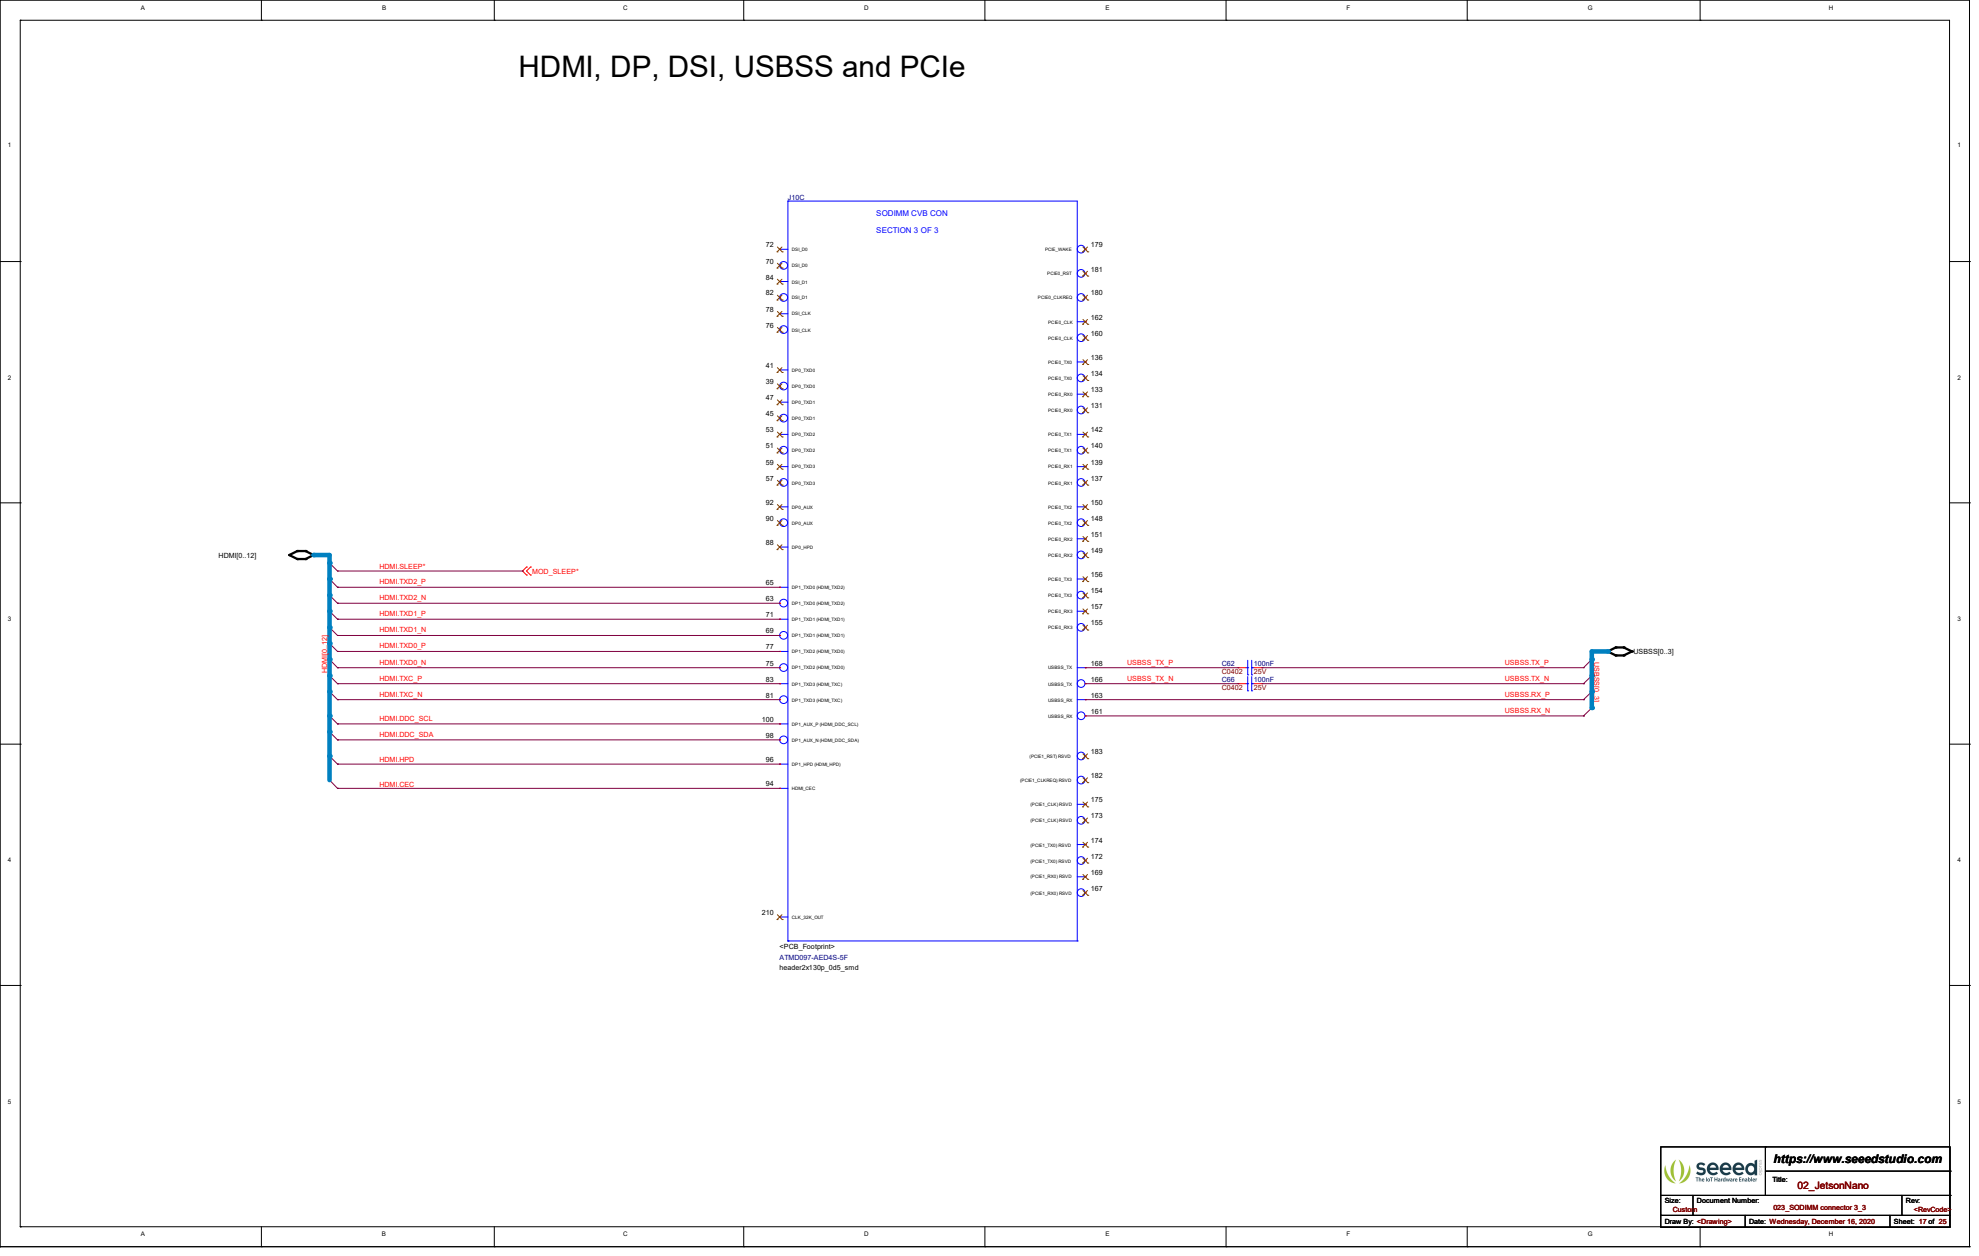
[picture p59: page 17]
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

SODIMM CVB CON J10C

HDMI.DDC_SCL HDMI.DDC_SDA HDMI.HPD

# USB 3.1 TYPE A x2 1A

# 25V D40B

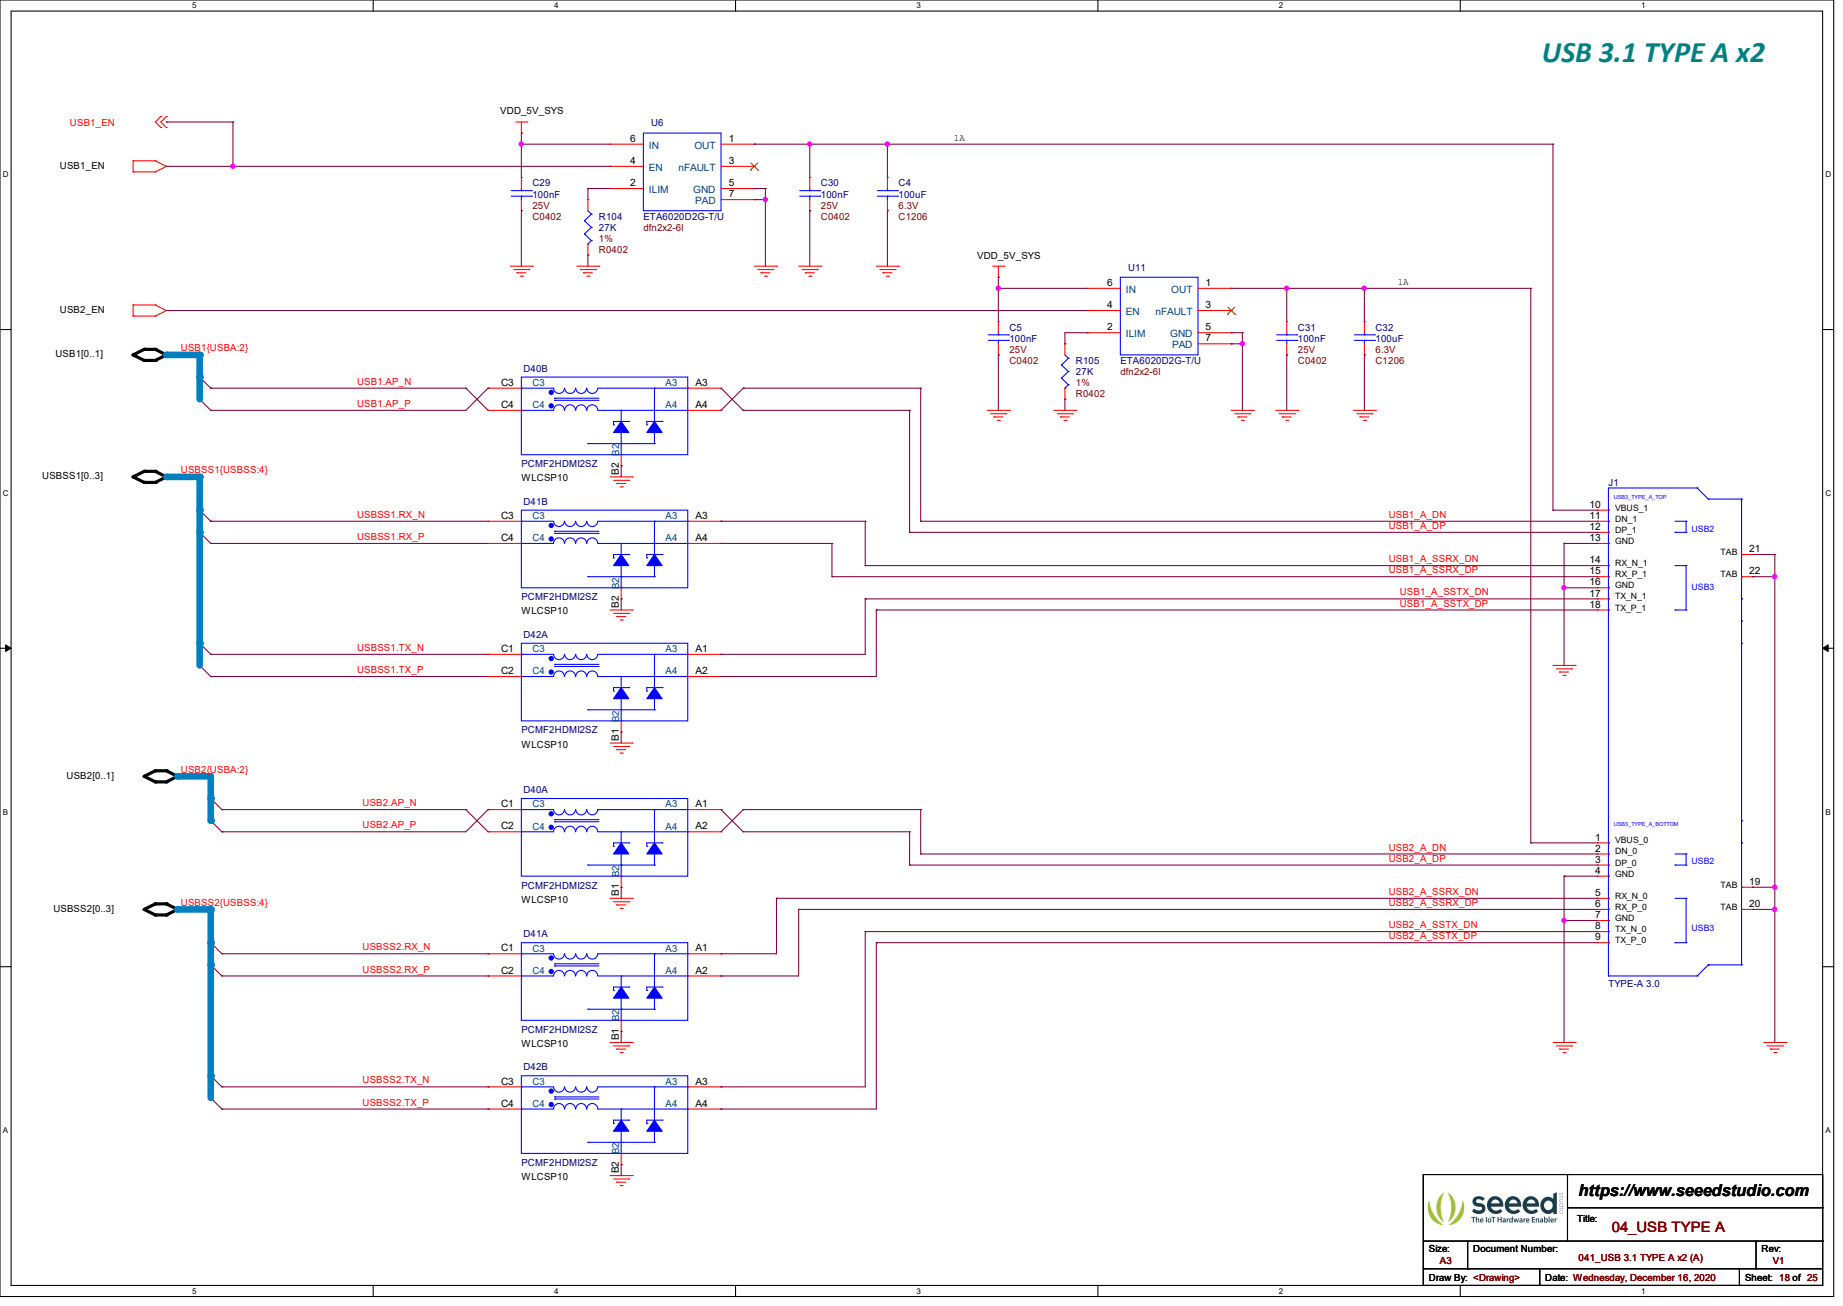
[picture p60: page 18]

# USB 3.1 TYPE A x2 1A

# 25V D38B

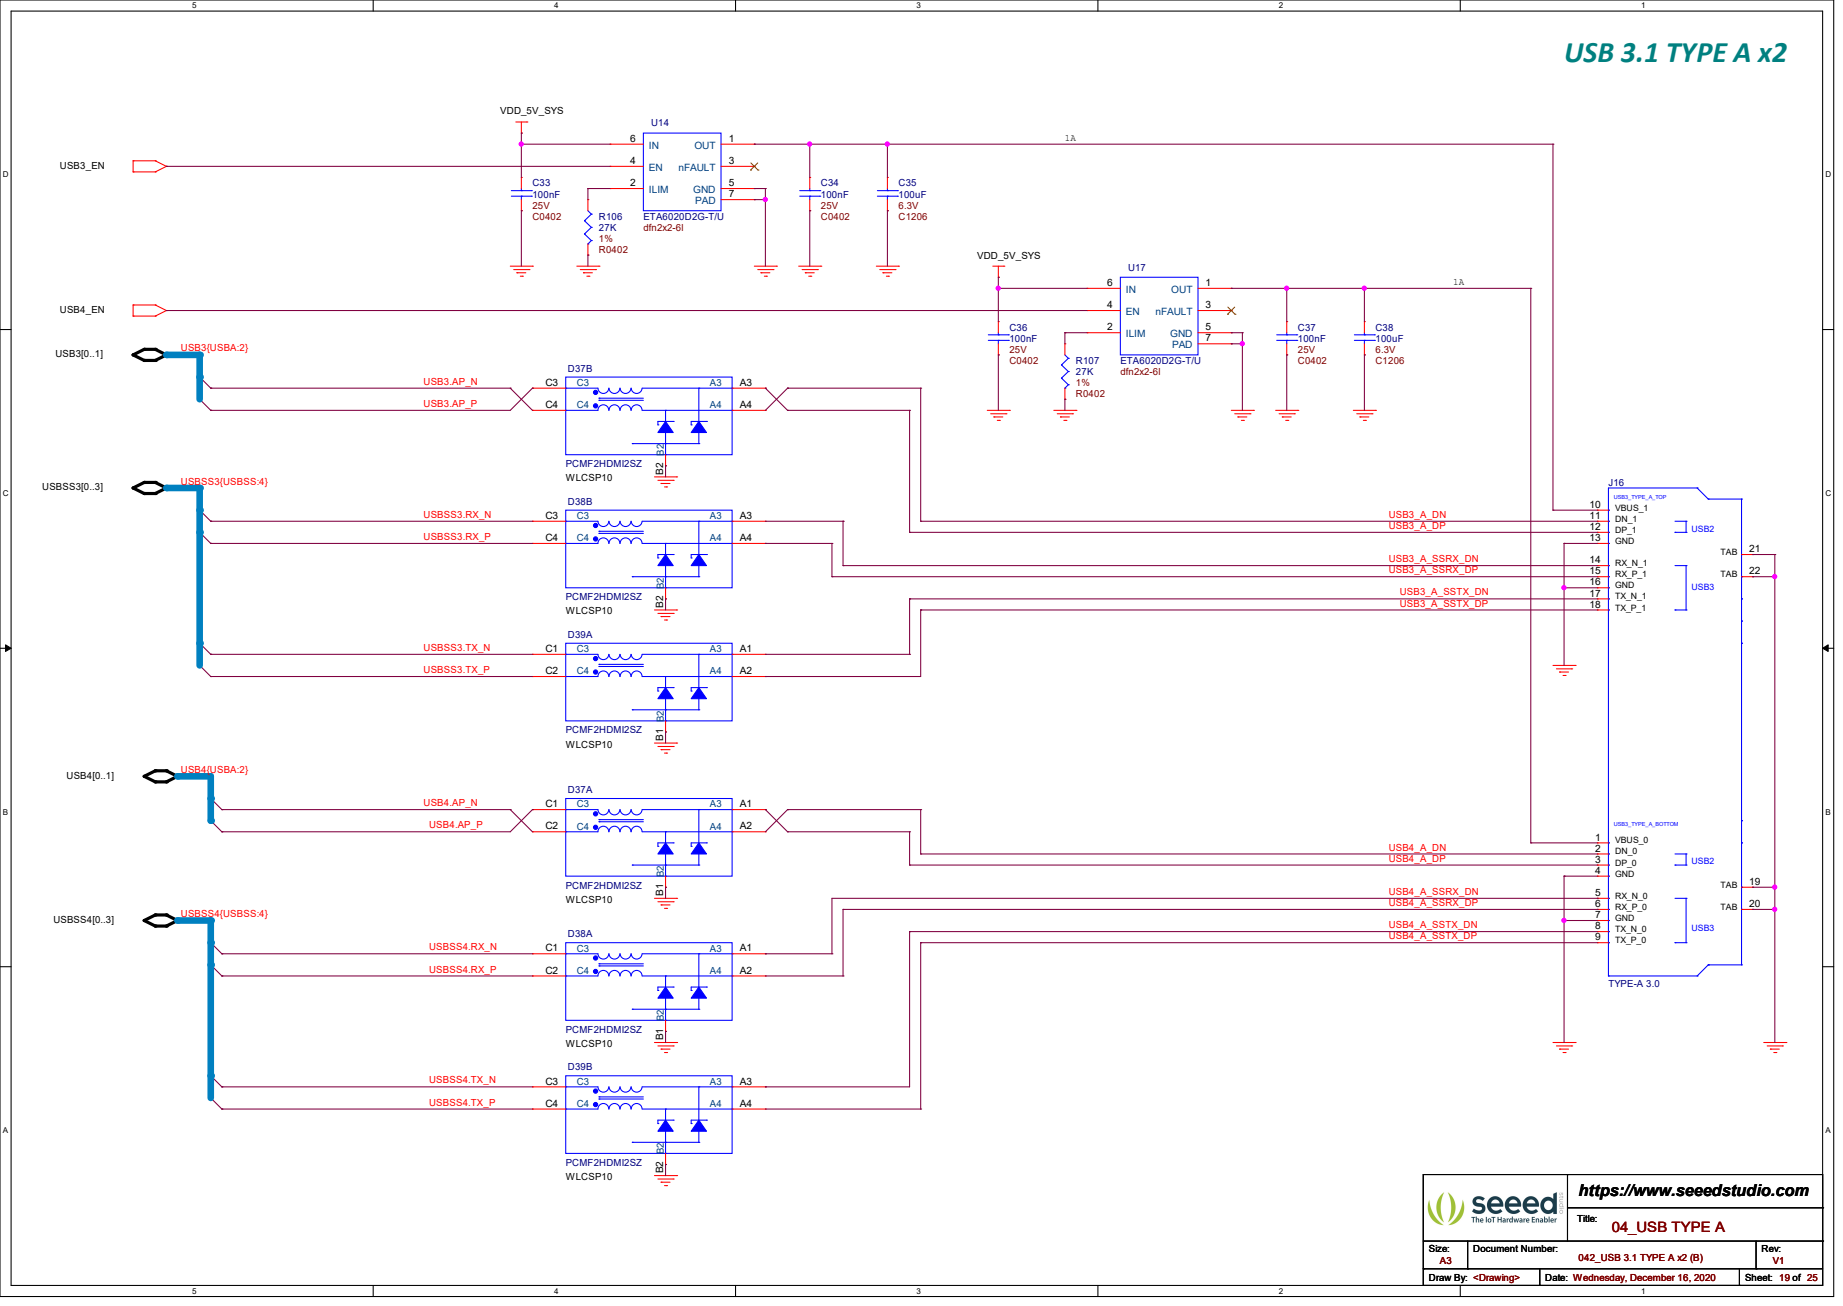
[picture p61: page 19]

# USB 2.0 TYPE A

# USB2_0[0..1] USB_B[0..2]

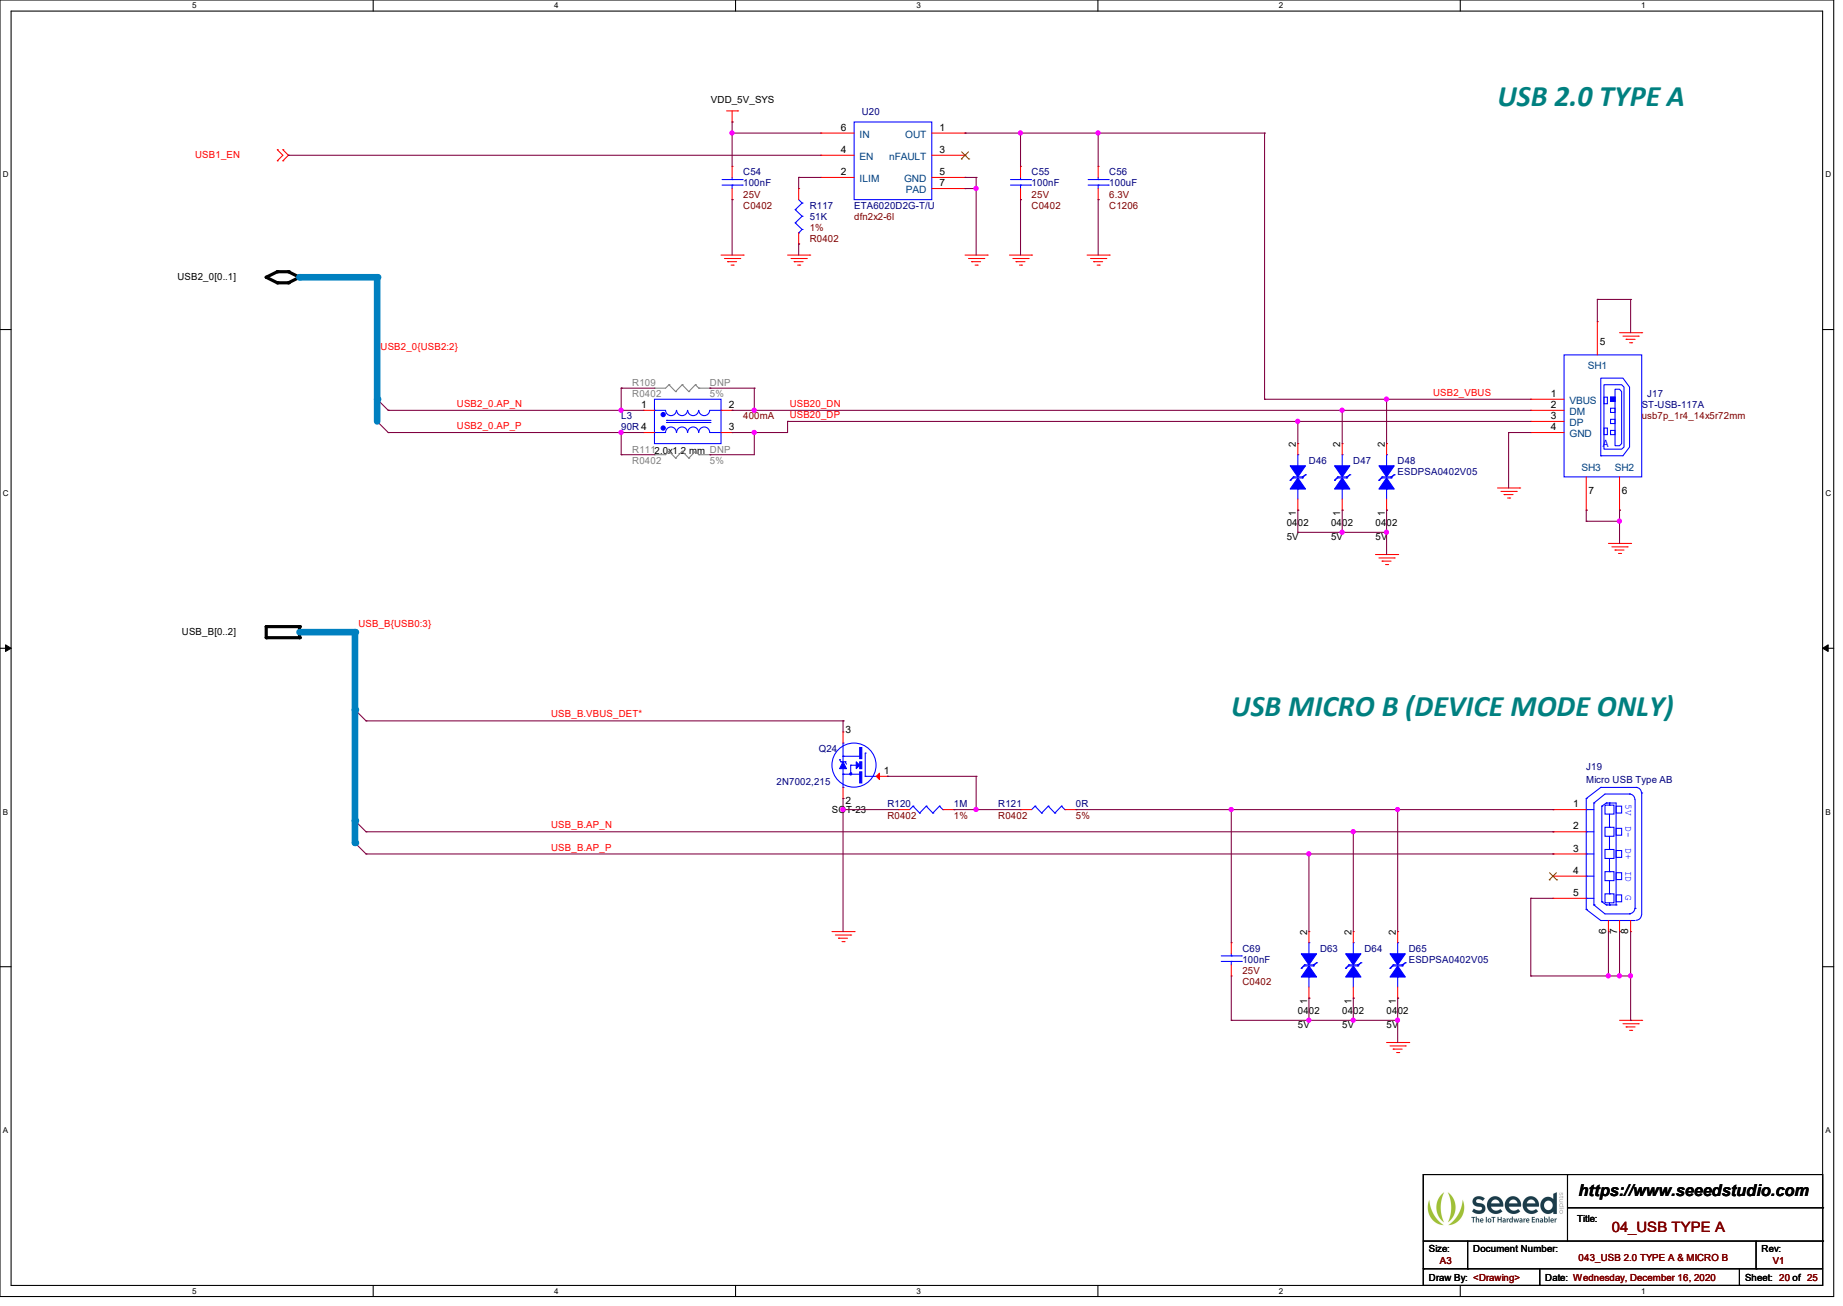
[picture p62: page 20]

USB MICRO B (DEVICE MODE ONLY)

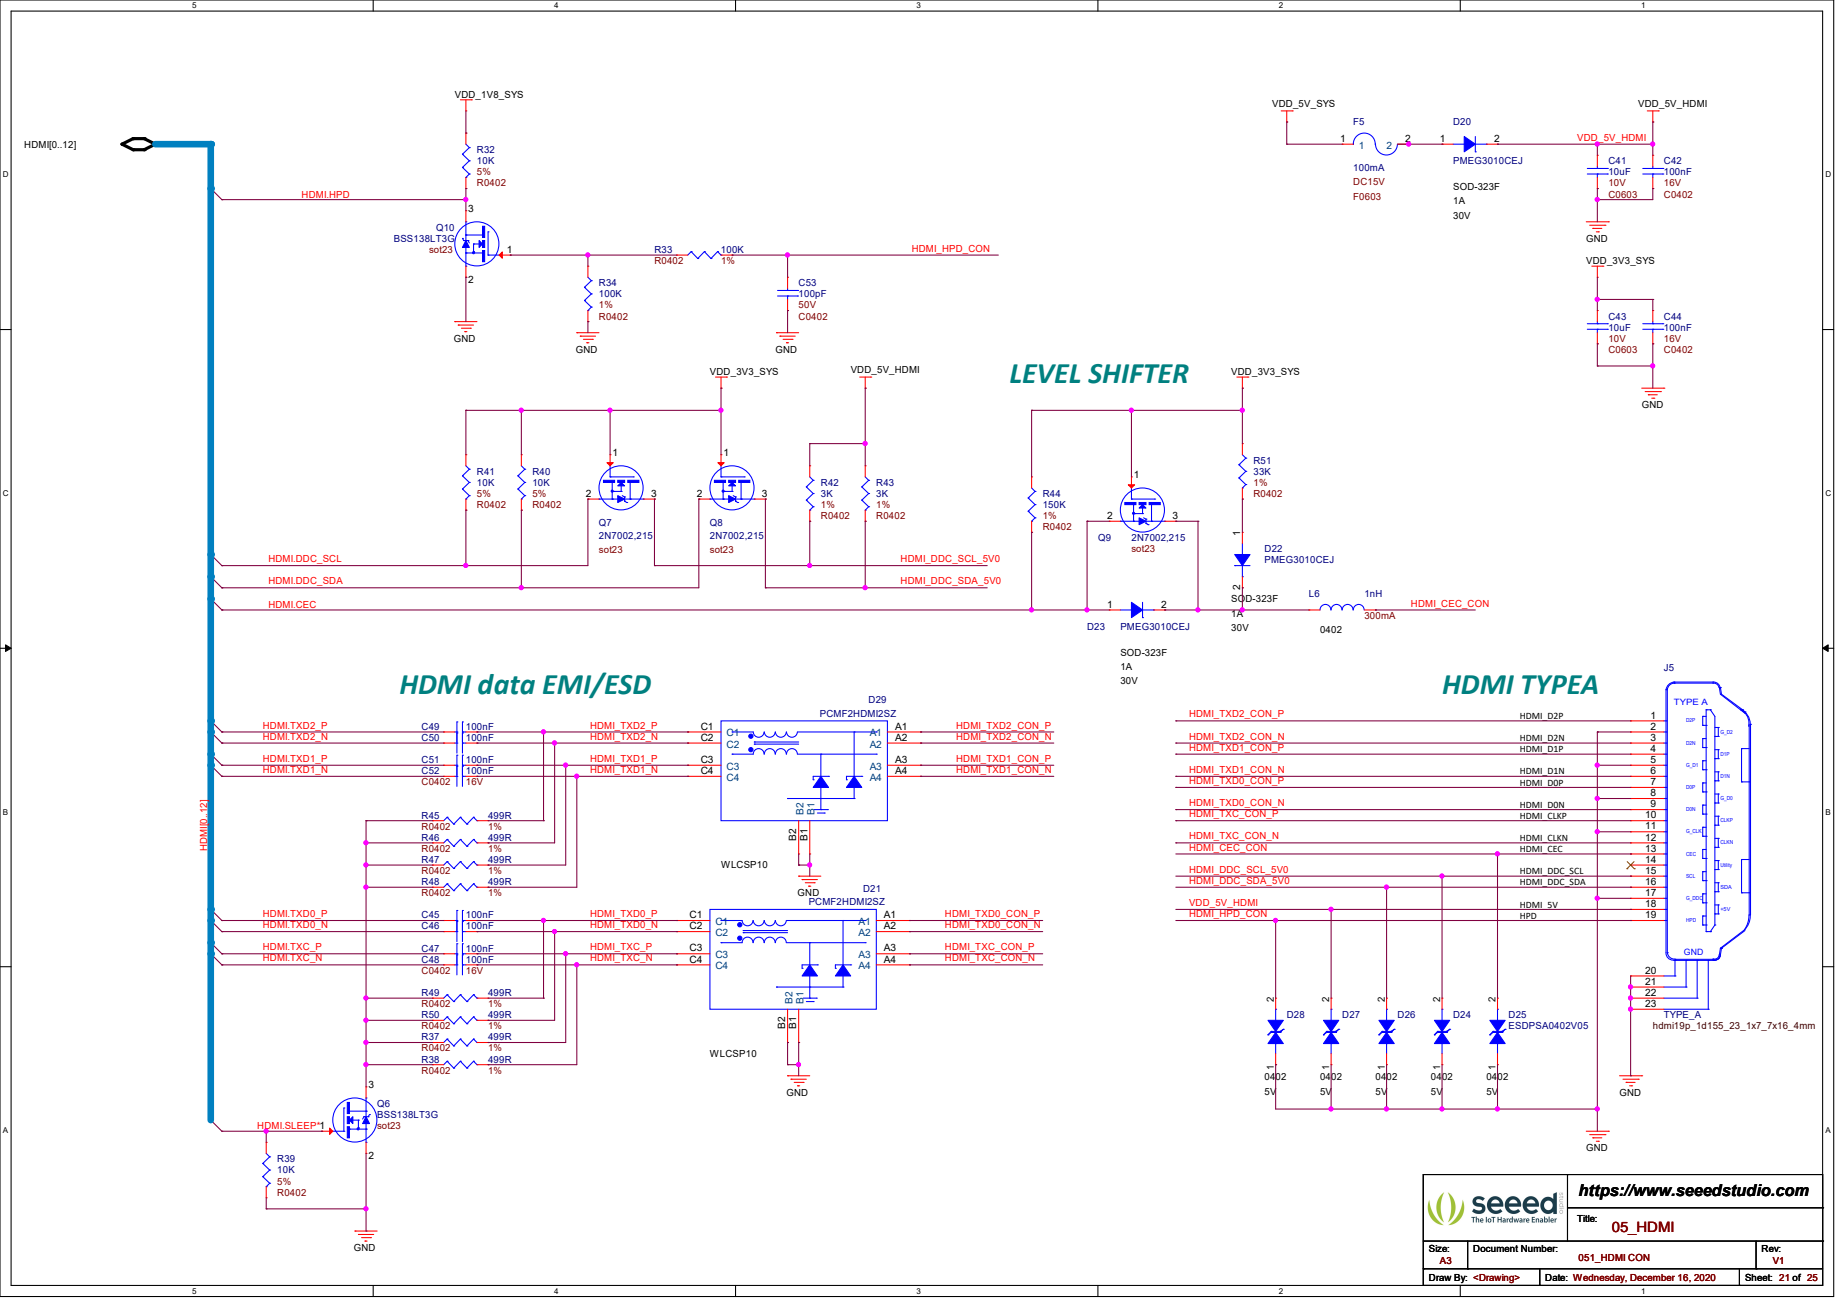
[picture p63: page 21]

# CAMERA CONNECTOR

# J15 YL002-007

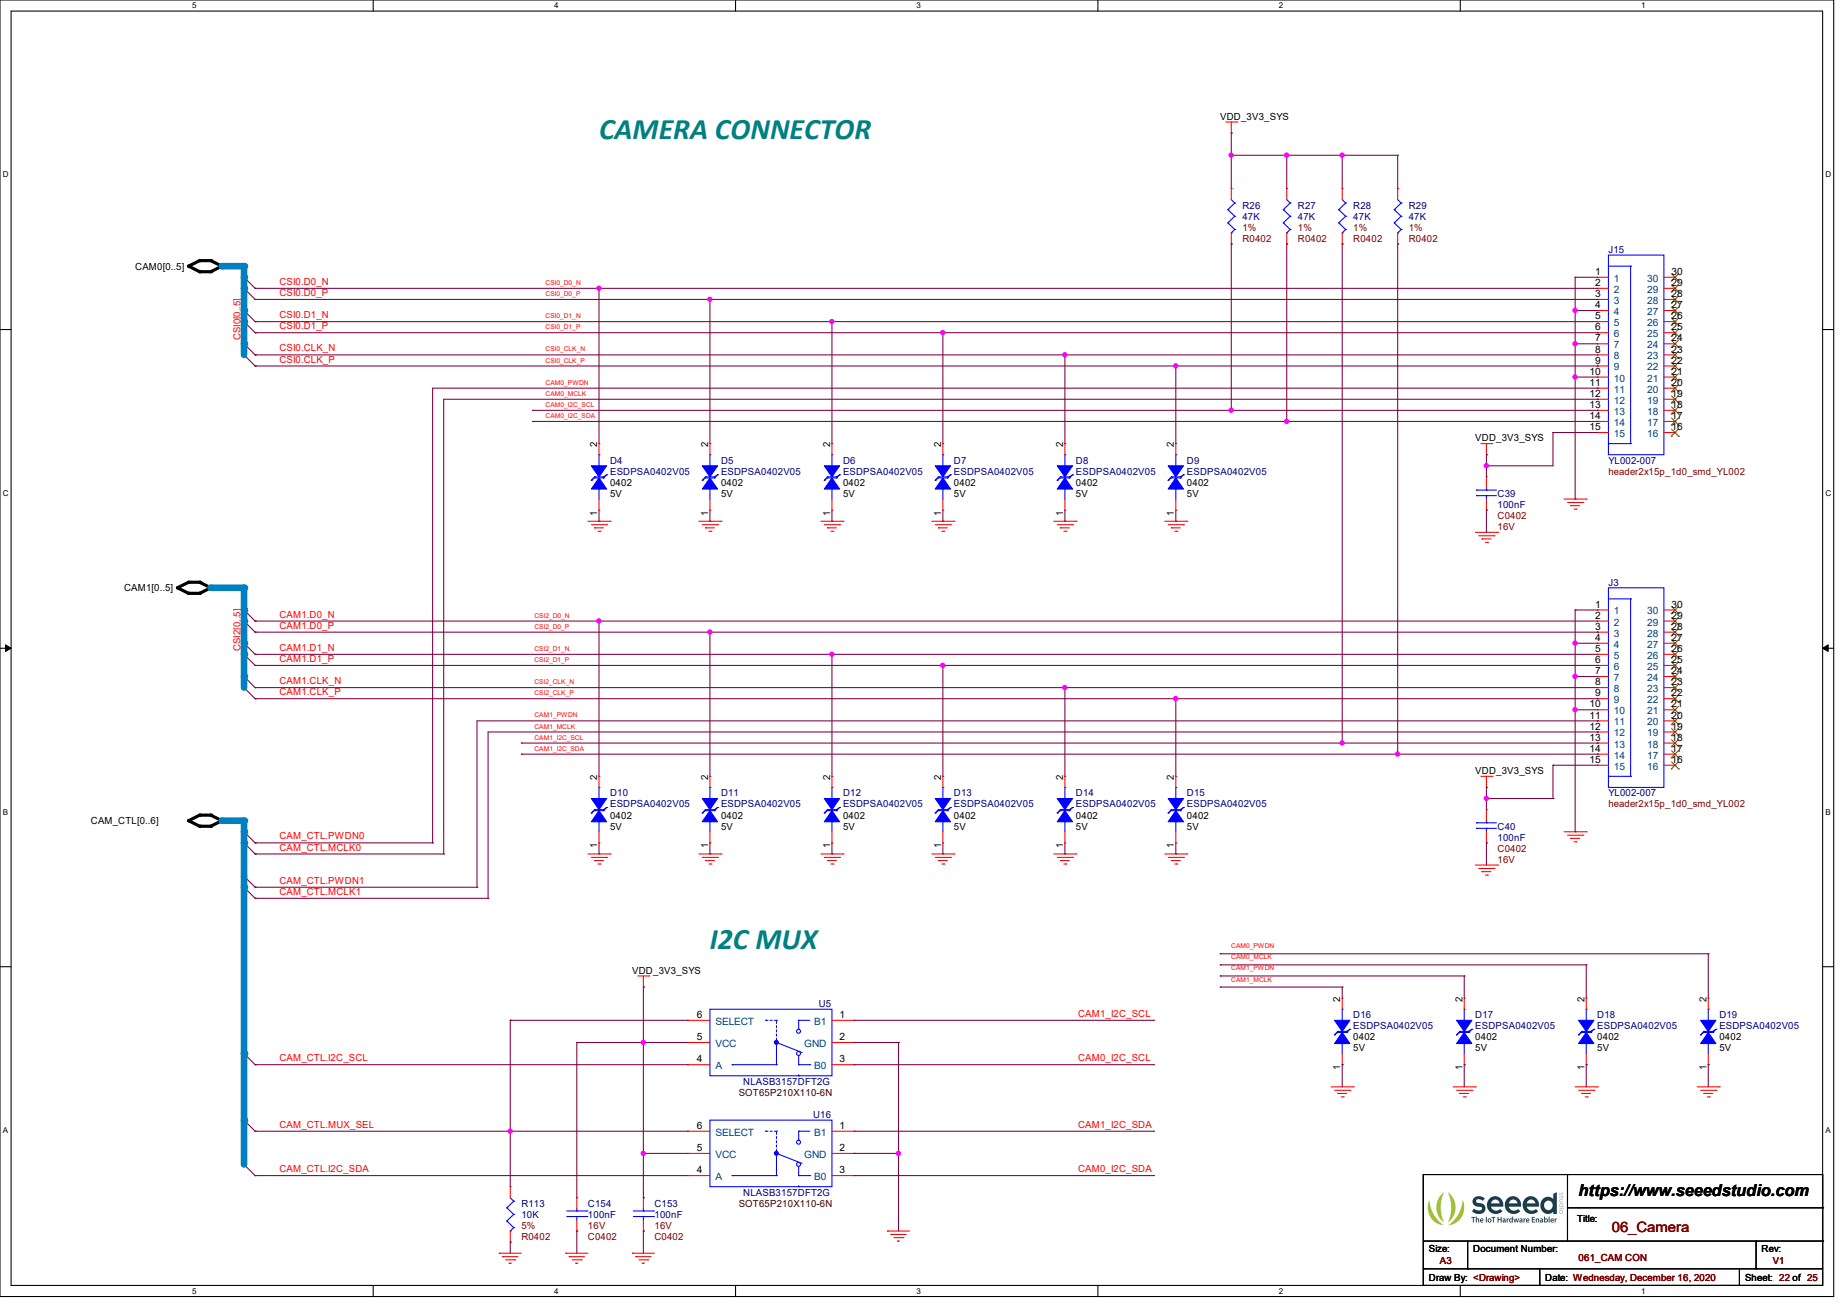
[picture p64: page 22]

# GIGABIT ETHERNET SWITCH

C123 | 100nF C116 | 100nF

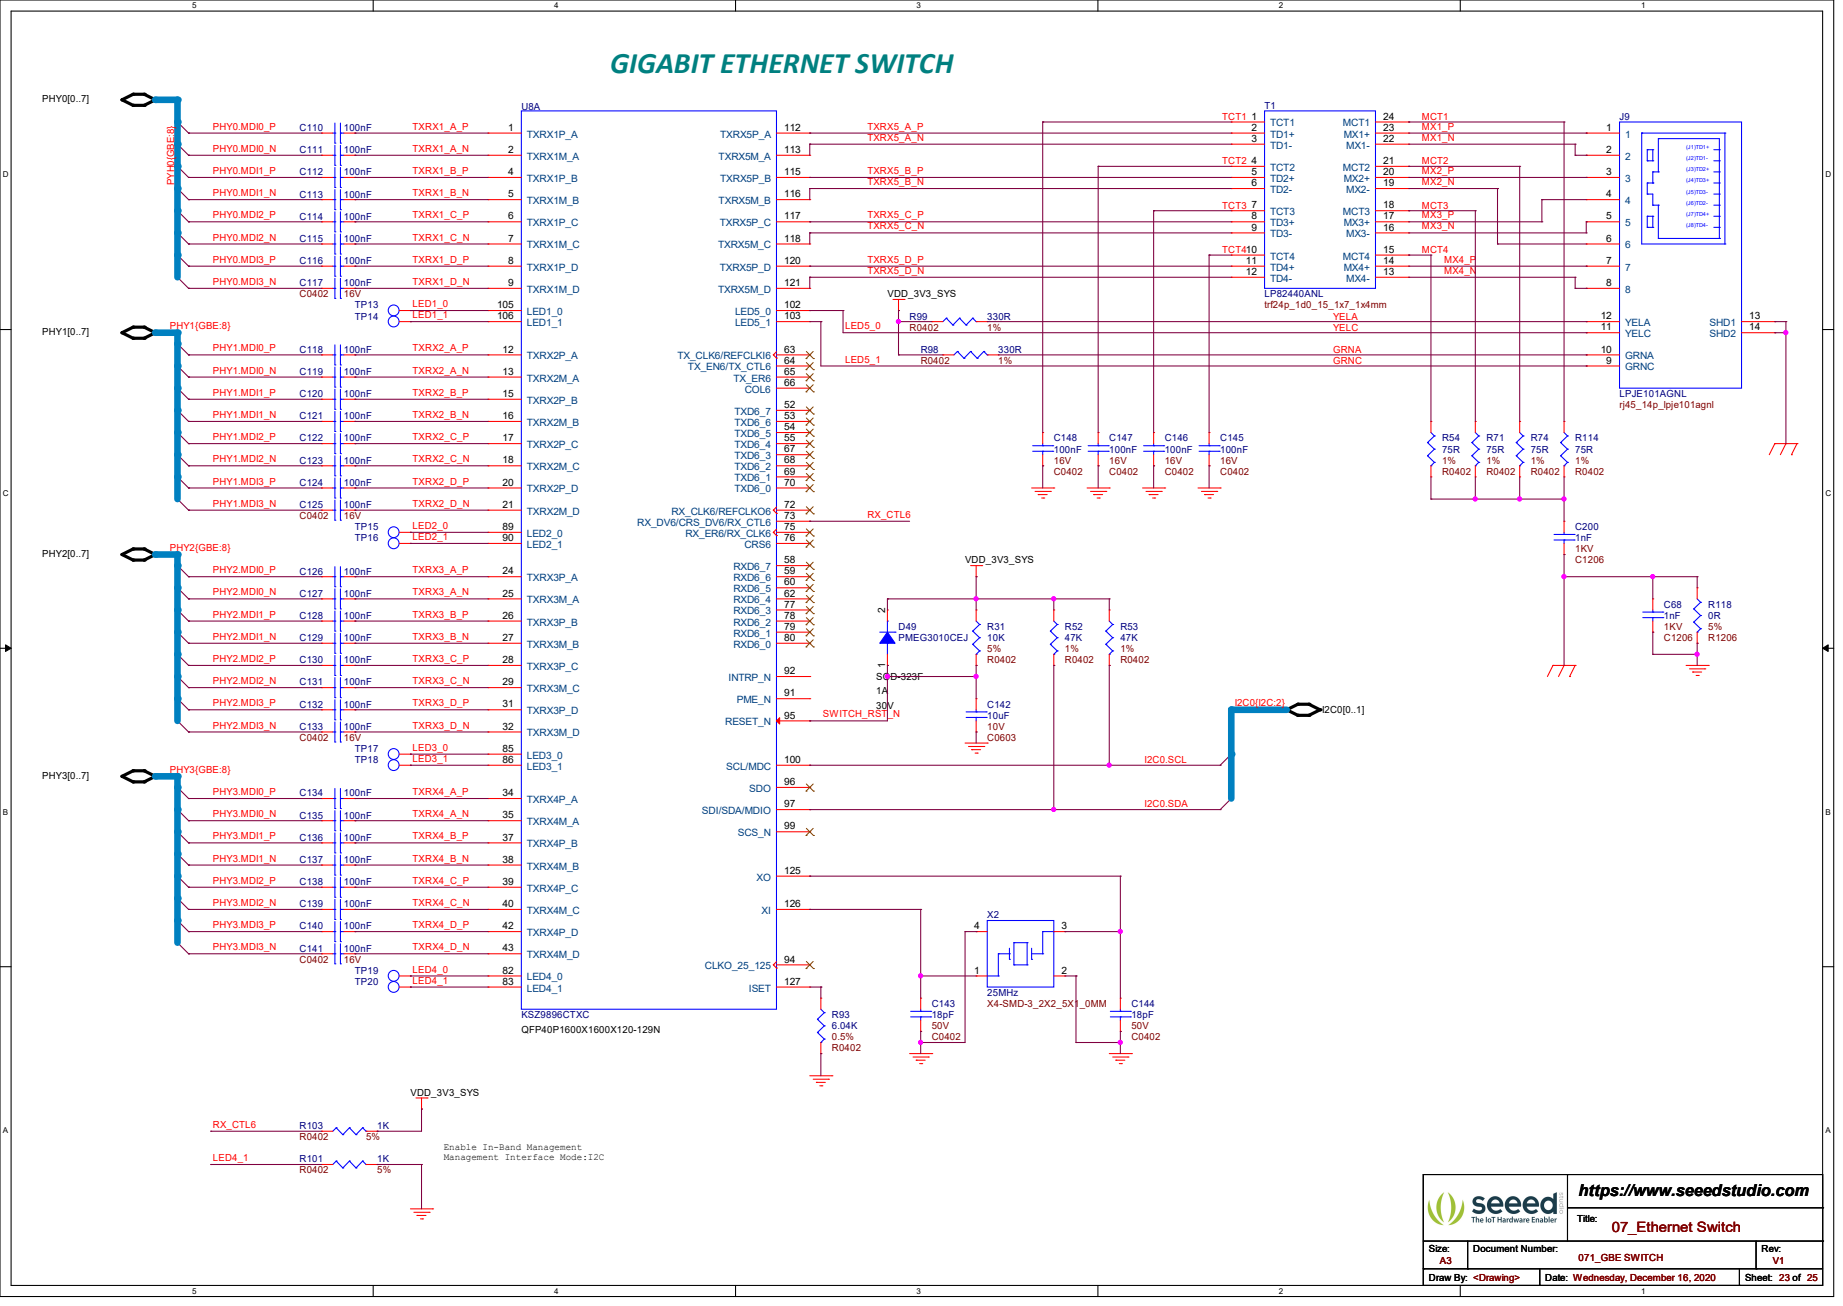
[picture p65: page 23]

INTRP_N 92 PME_N 91 RESET_N 95 RXD6_0 80 RXD6_1 79 RXD6_2 78 RXD6_3 77 RXD6_4 62 RXD6_5 60 RXD6_6 59 RXD6_7 58 RX_CLK6/REFCLKO6 72 RX_DV6/CRS_DV6/RX_CTL6 73 RX_ER6/RX_CLK6 75 SCL/MDC 100 SCS_N 99 SDI/SDA/MDIO 97 SDO 96 XI 126 CLKO_25_125 94

A A Enable In-Band Management

GIGABIT ETHERNET SWITCH POWER | VDD_3V3_SYS

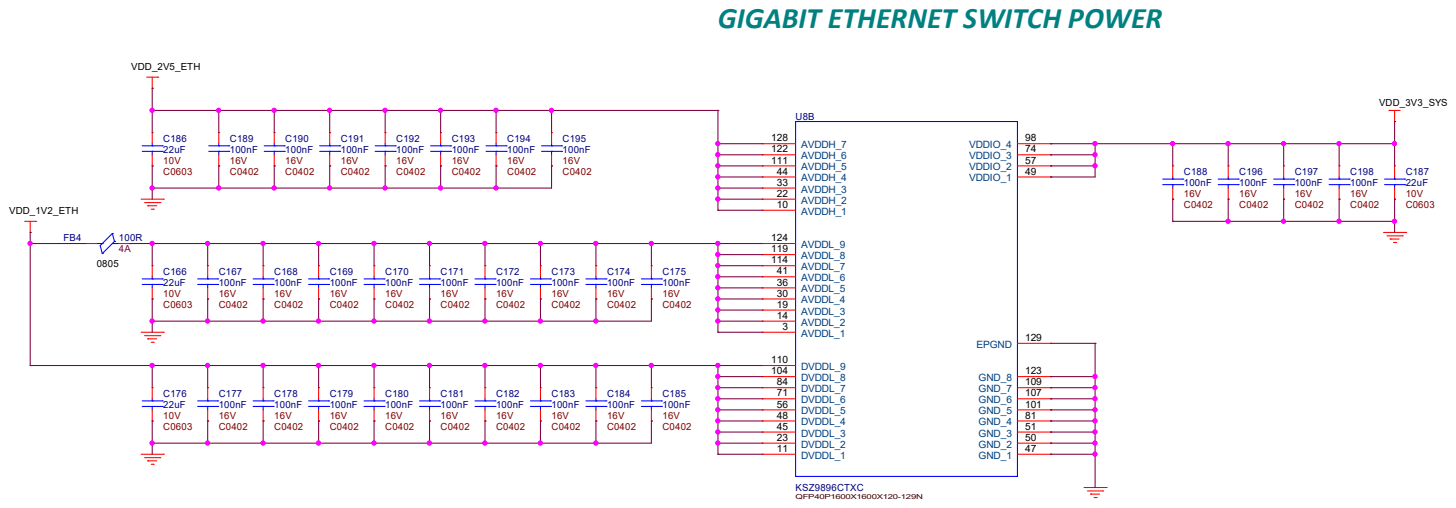
[picture p66: page 24]

# DEBUG INTERFACE

# U23 TXS0108ERGYR

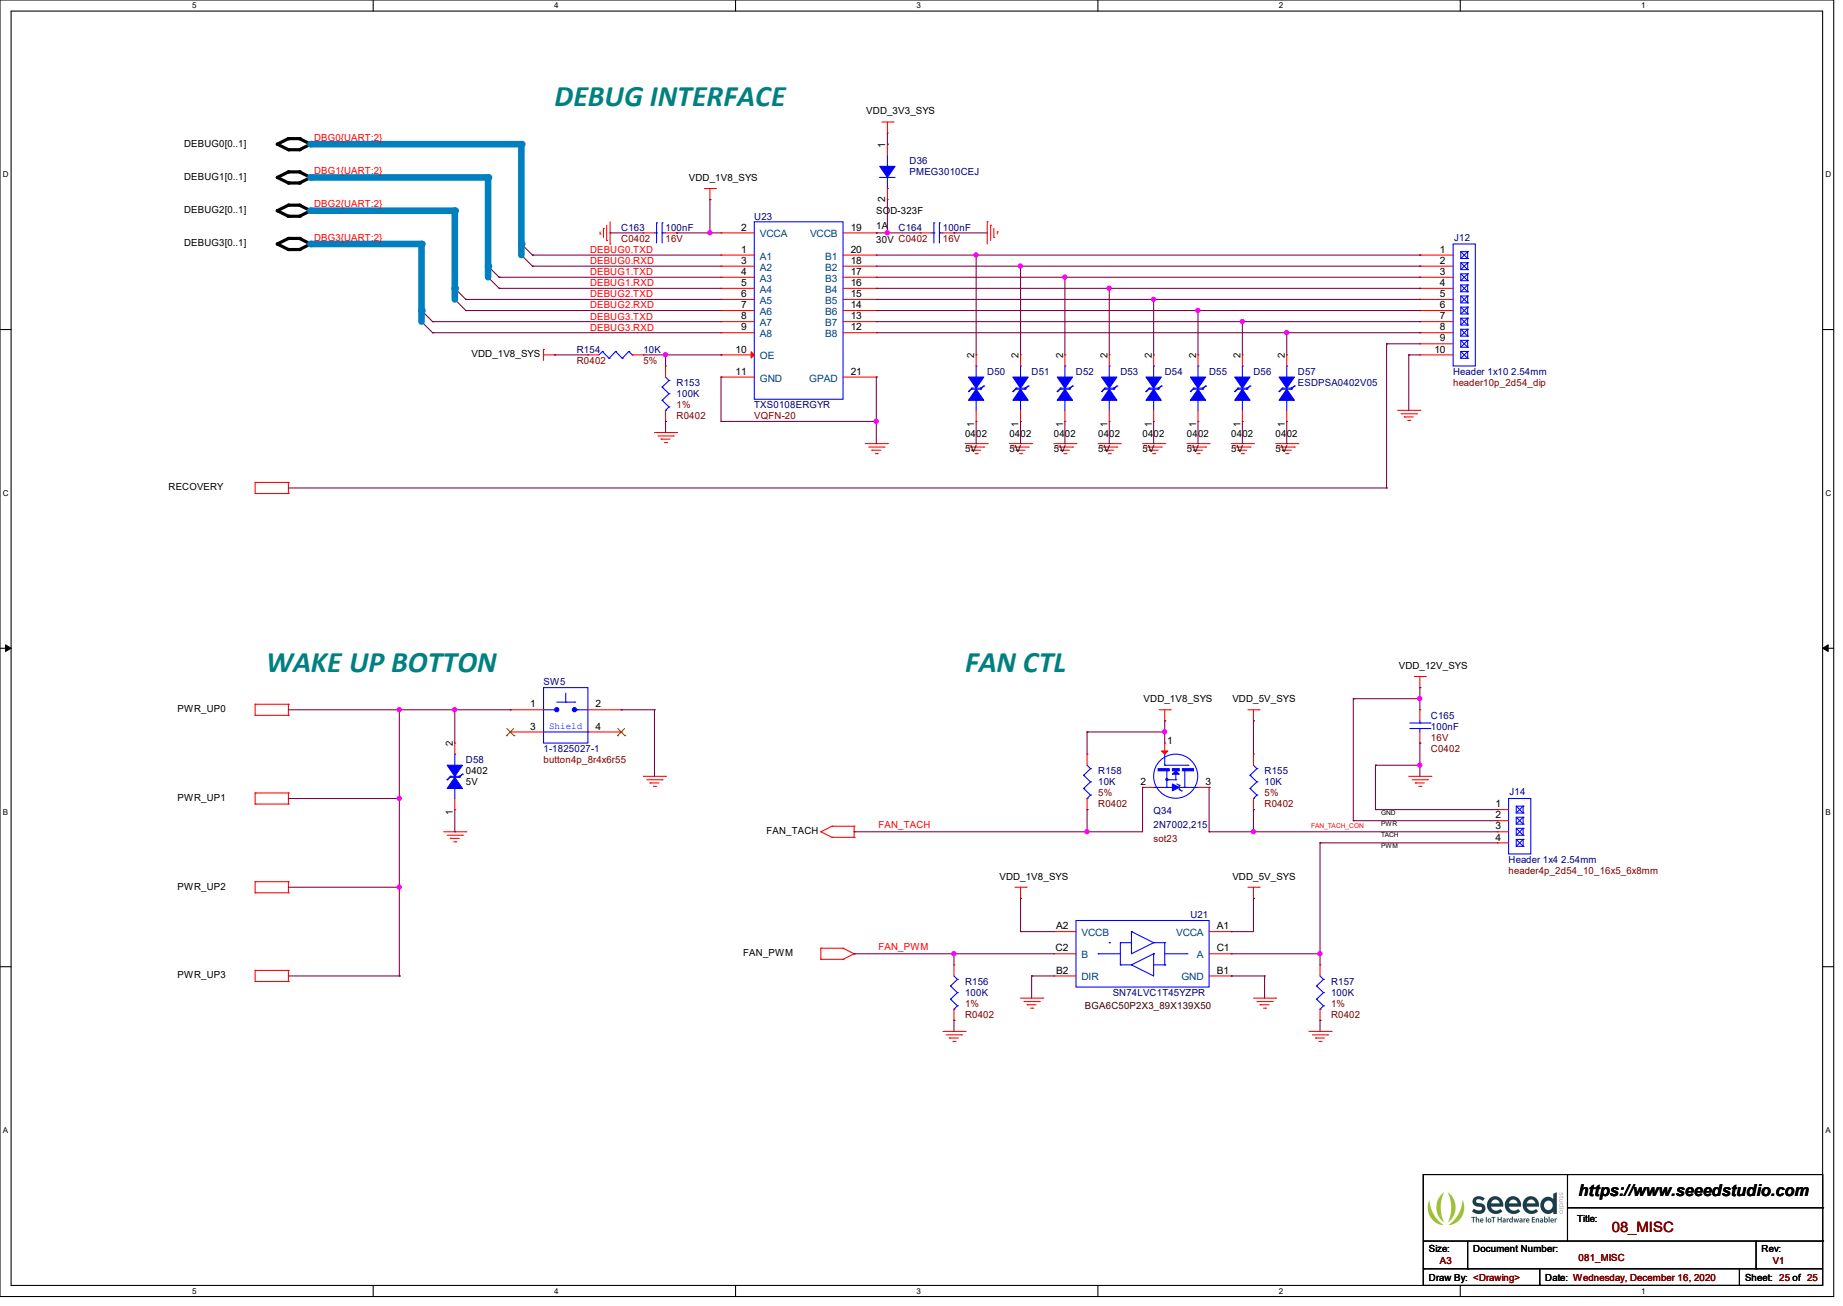
[picture p67: page 25]

DBG0{UART:2} DBG1{UART:2} DBG2{UART:2} DBG3{UART:2}
