Seeed-Studio/OSHW-Jetson-Series/reComputer Jetson carrier board/reComputer J1010/Schematic/reComputer J101_V2.0_SCH_240822.pdf

DATE | SCH Name | DESCRIPTION

# 01 Table of Contents

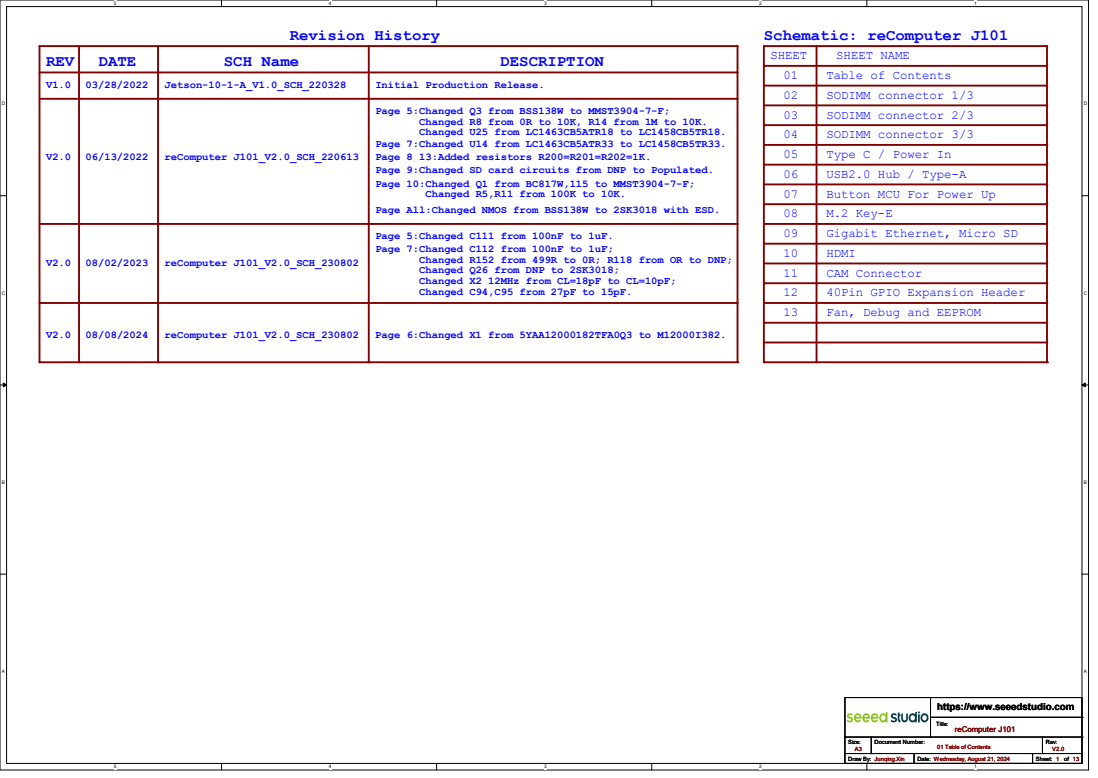
[picture p91: page 1]

02 | SODIMM connector 1/3
03 | SODIMM connector 2/3
04 | SODIMM connector 3/3
05 | Type C / Power In
06 | USB2.0 Hub / Type-A
07 | Button MCU For Power Up
08 | M.2 Key-E

Page 5:Changed Q3 from BSS138W to MMST3904-7-F;

Changed R8 from 0R to 10K, R14 from 1M to 10K.
Changed U25 from LC1463CB5ATR18 to LC1458CB5TR18.

Page 7:Changed U14 from LC1463CB5ATR33 to LC1458CB5TR33.
Page 8 13:Added resistors R200=R201=R202=1K.
Page 9:Changed SD card circuits from DNP to Populated.
Page 10:Changed Q1 from BC817W,115 to MMST3904-7-F;

Page All:Changed NMOS from BSS138W to 2SK3018 with ESD.

Page 5:Changed C111 from 100nF to 1uF.
Page 7:Changed C112 from 100nF to 1uF;

Gigabit Ethernet, Micro SD

Changed R152 from 499R to 0R; R118 from OR to DNP;
Changed Q26 from DNP to 2SK3018;
Changed X2 12MHz from CL=18pF to CL=10pF;
Changed C94,C95 from 27pF to 15pF.

10 | HDMI
11 | CAM Connector
12 | 40Pin GPIO Expansion Header

13 Fan, Debug and EEPROM

reComputer J101 01 Table of Contents

# UART, I2C, CAN and GPIOs

ID_I2C_SCL | [12] UART0_TXD | [8] UART0_RXD | [8] UART0_RTS | [8] UART0_CTS | [8] UART1_TXD | [12] UART1_RXD | [12] UART1_RTS | [12] UART1_CTS | [12] UART2_TXD | [13] UART2_RXD | [13] MOD_SLEEP* | [9,10,13] POWER_EN | [7] SHUTDOWN_REQ* | [7] SYS_RST* | [7,13] FORCE_RECOVERY* | [13]

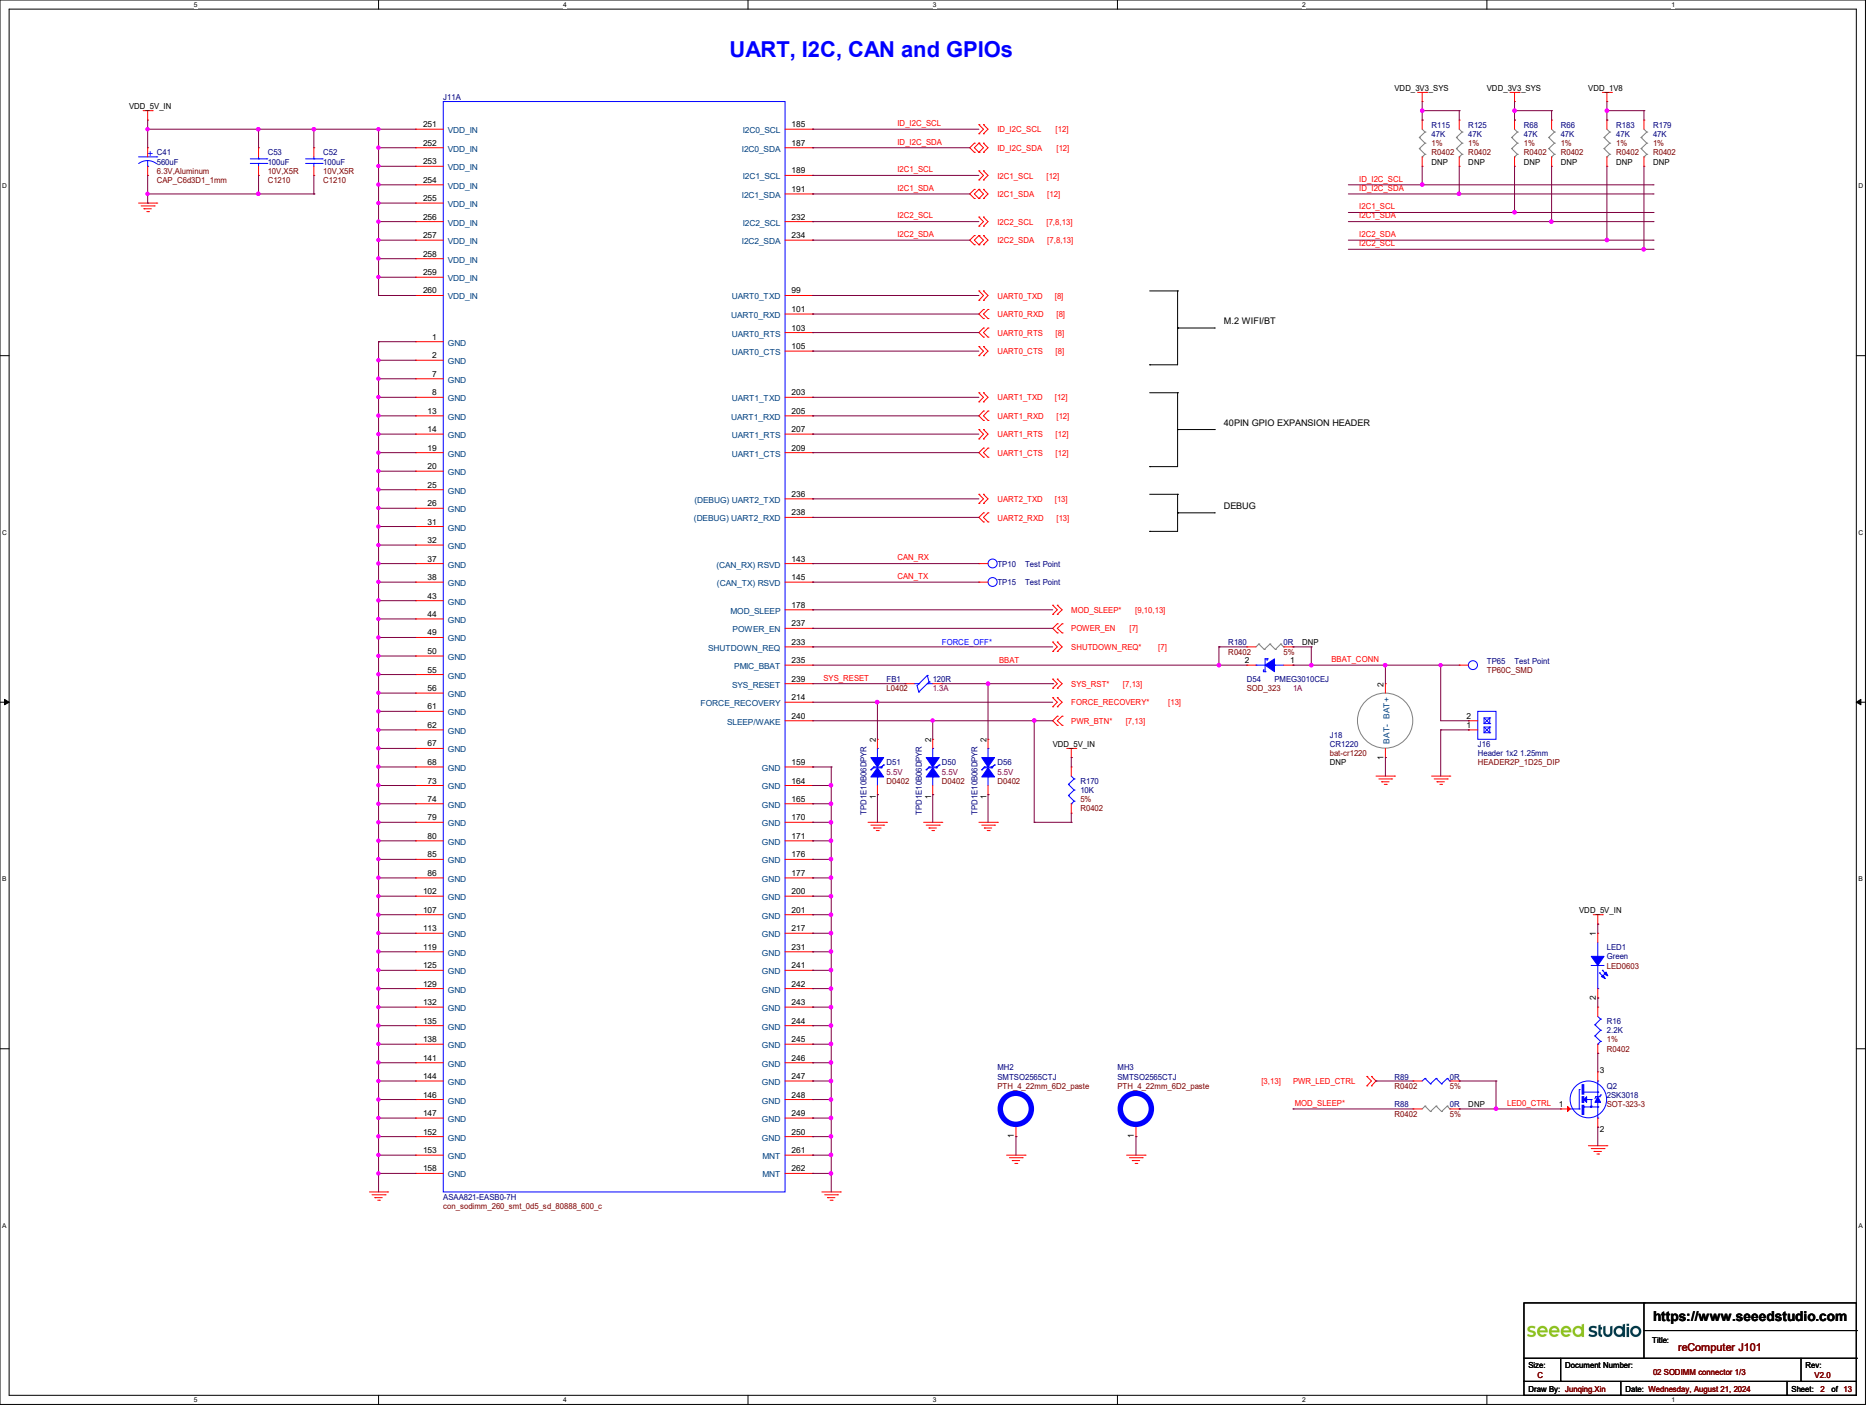
[picture p92: page 2]

VDD_IN 251 VDD_IN 252 VDD_IN 253 VDD_IN 254 VDD_IN 255 VDD_IN 256 VDD_IN 257 VDD_IN 258 VDD_IN 259 VDD_IN 260 GND 1 GND 2 GND 7 GND 8 GND 13 GND 14 GND 19 GND 20 GND 25 GND 26 GND 31 GND 32 GND 37 GND 38 GND 43 GND 44 GND 49 GND 50 GND 55 GND 56 GND 61 GND 62 GND 67 GND 68 GND 73 GND 74 GND 79 GND 80 GND 85 GND 86 GND 102 GND 107 GND 113 GND 119 GND 125 GND 129 GND 132 GND 135 GND 138 GND 141 GND 144 GND 146 GND 147 GND 152 GND 153 GND 158

# GPIOs, USB2.0, I2S, SPI, GBe and CSI

# TP32 Test Point TP35 Test Point TP47 Test Point

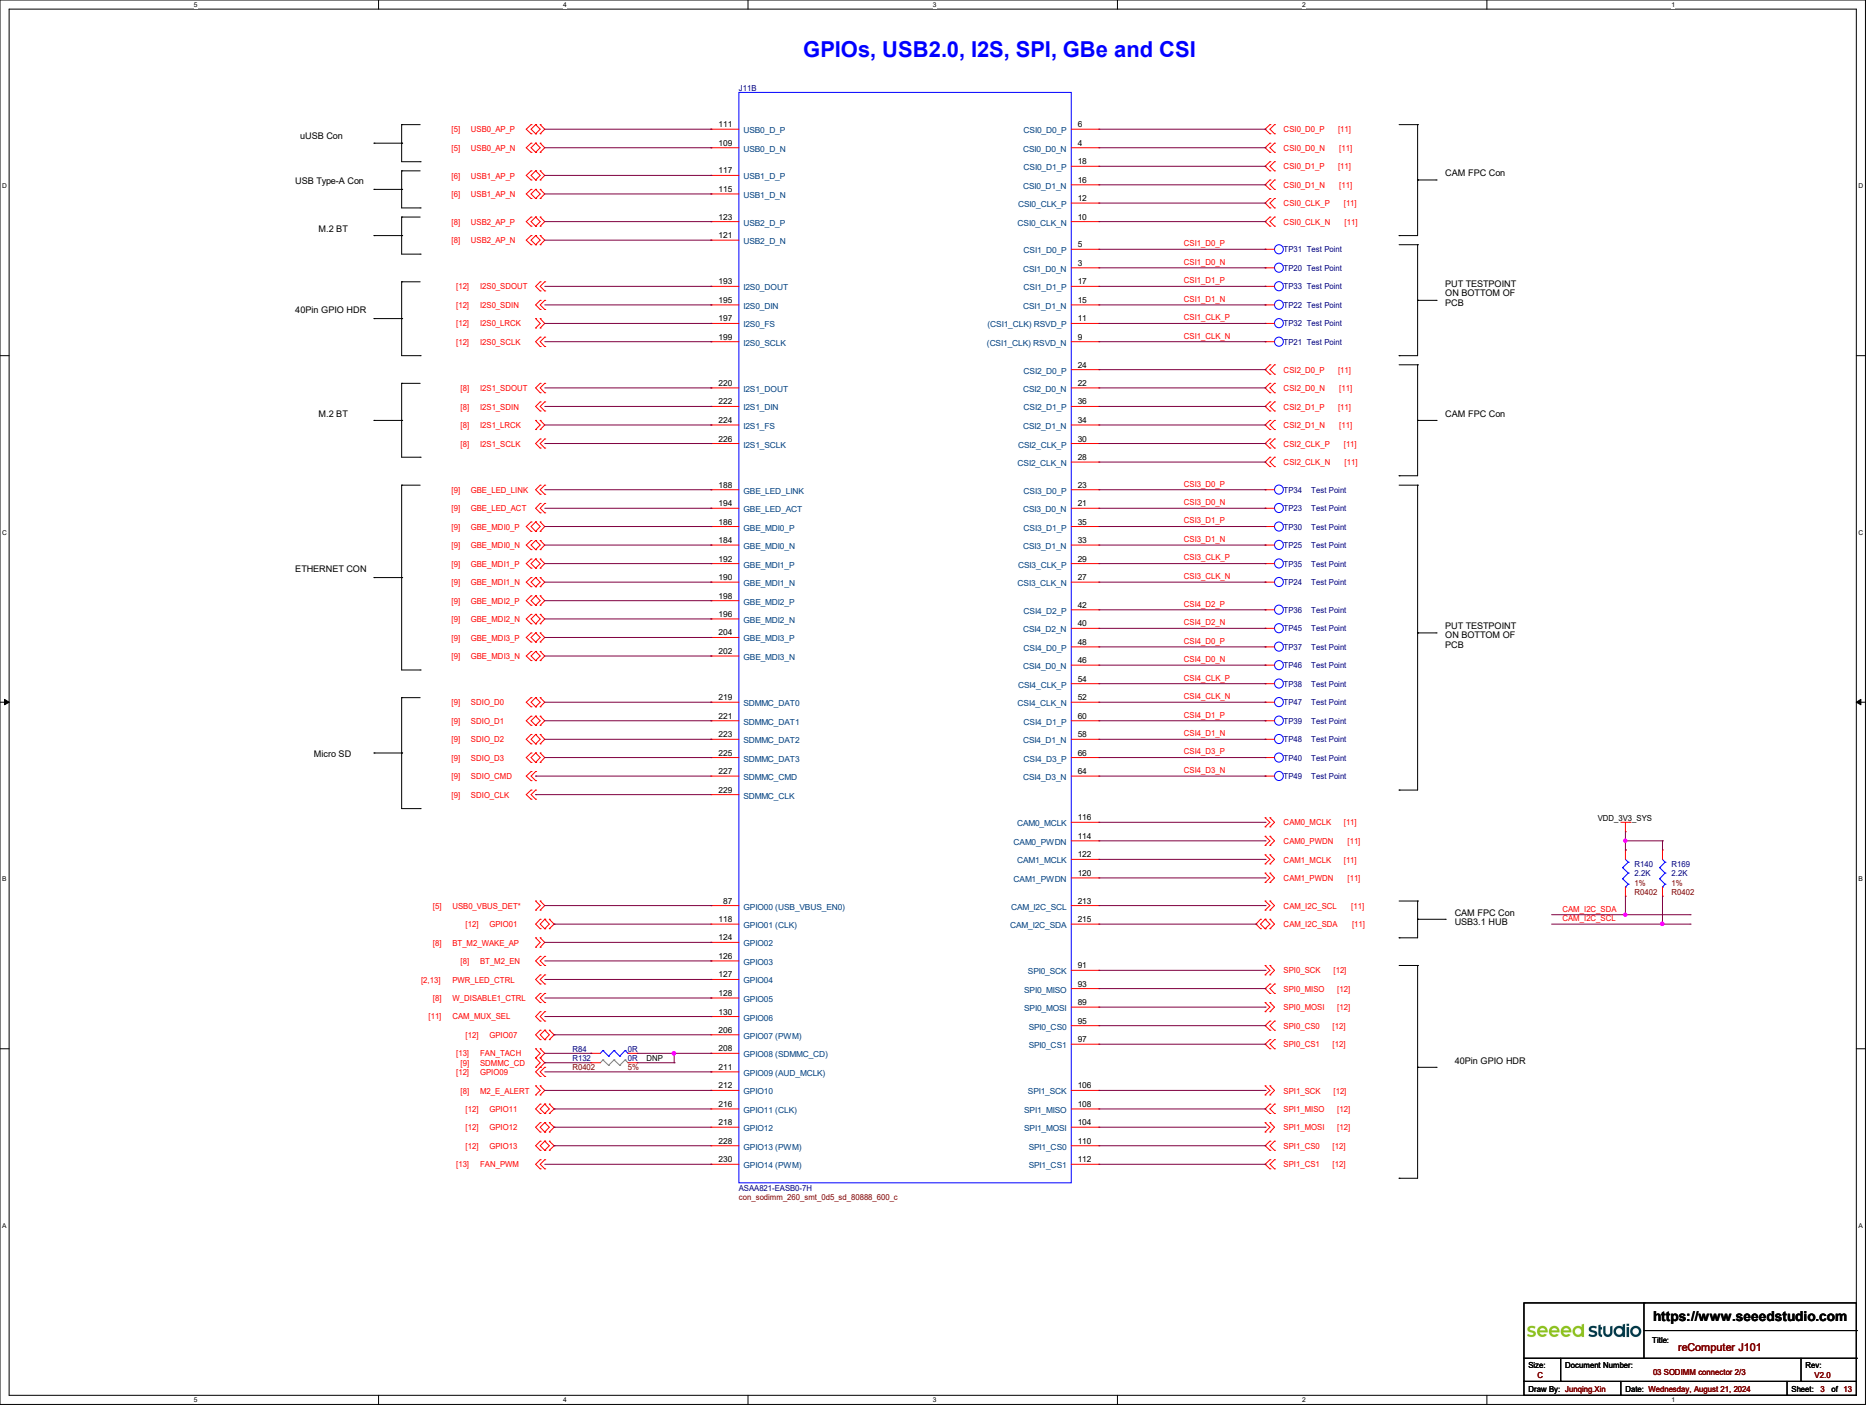
[picture p93: page 3]

I2S1_SCLK 226 GBE_LED_LINK 188 GBE_LED_ACT 194 GBE_MDI0_P 186 GBE_MDI0_N 184 GBE_MDI1_P 192 GBE_MDI1_N 190 GBE_MDI2_P 198 GBE_MDI2_N 196 GBE_MDI3_P 204 GBE_MDI3_N 202 SDMMC_DAT0 219 SDMMC_DAT1 221 SDMMC_DAT2 223 SDMMC_DAT3 225 SDMMC_CMD 227 SDMMC_CLK 229 GPIO00 (USB_VBUS_EN0) 87 GPIO01 (CLK) 118 GPIO02 124 GPIO03 126 GPIO04 127 GPIO05 128 GPIO06 130 GPIO07 (PWM) 206 GPIO08 (SDMMC_CD) 208 GPIO09 (AUD_MCLK) 211 GPIO10 212 GPIO11 (CLK) 216 GPIO12 218 GPIO13 (PWM) 228 GPIO14 (PWM) 230

CAM FPC Con
TP34 Test Point TP36 Test Point TP48 Test Point TP23 Test Point
TP45 Test Point TP40 Test Point TP30 Test Point

R0402 TP37 Test Point TP49 Test Point TP25 Test Point

# HDMI, DP, DSI, USBSS and PCIe

# Test Point TP41 Test Point TP28

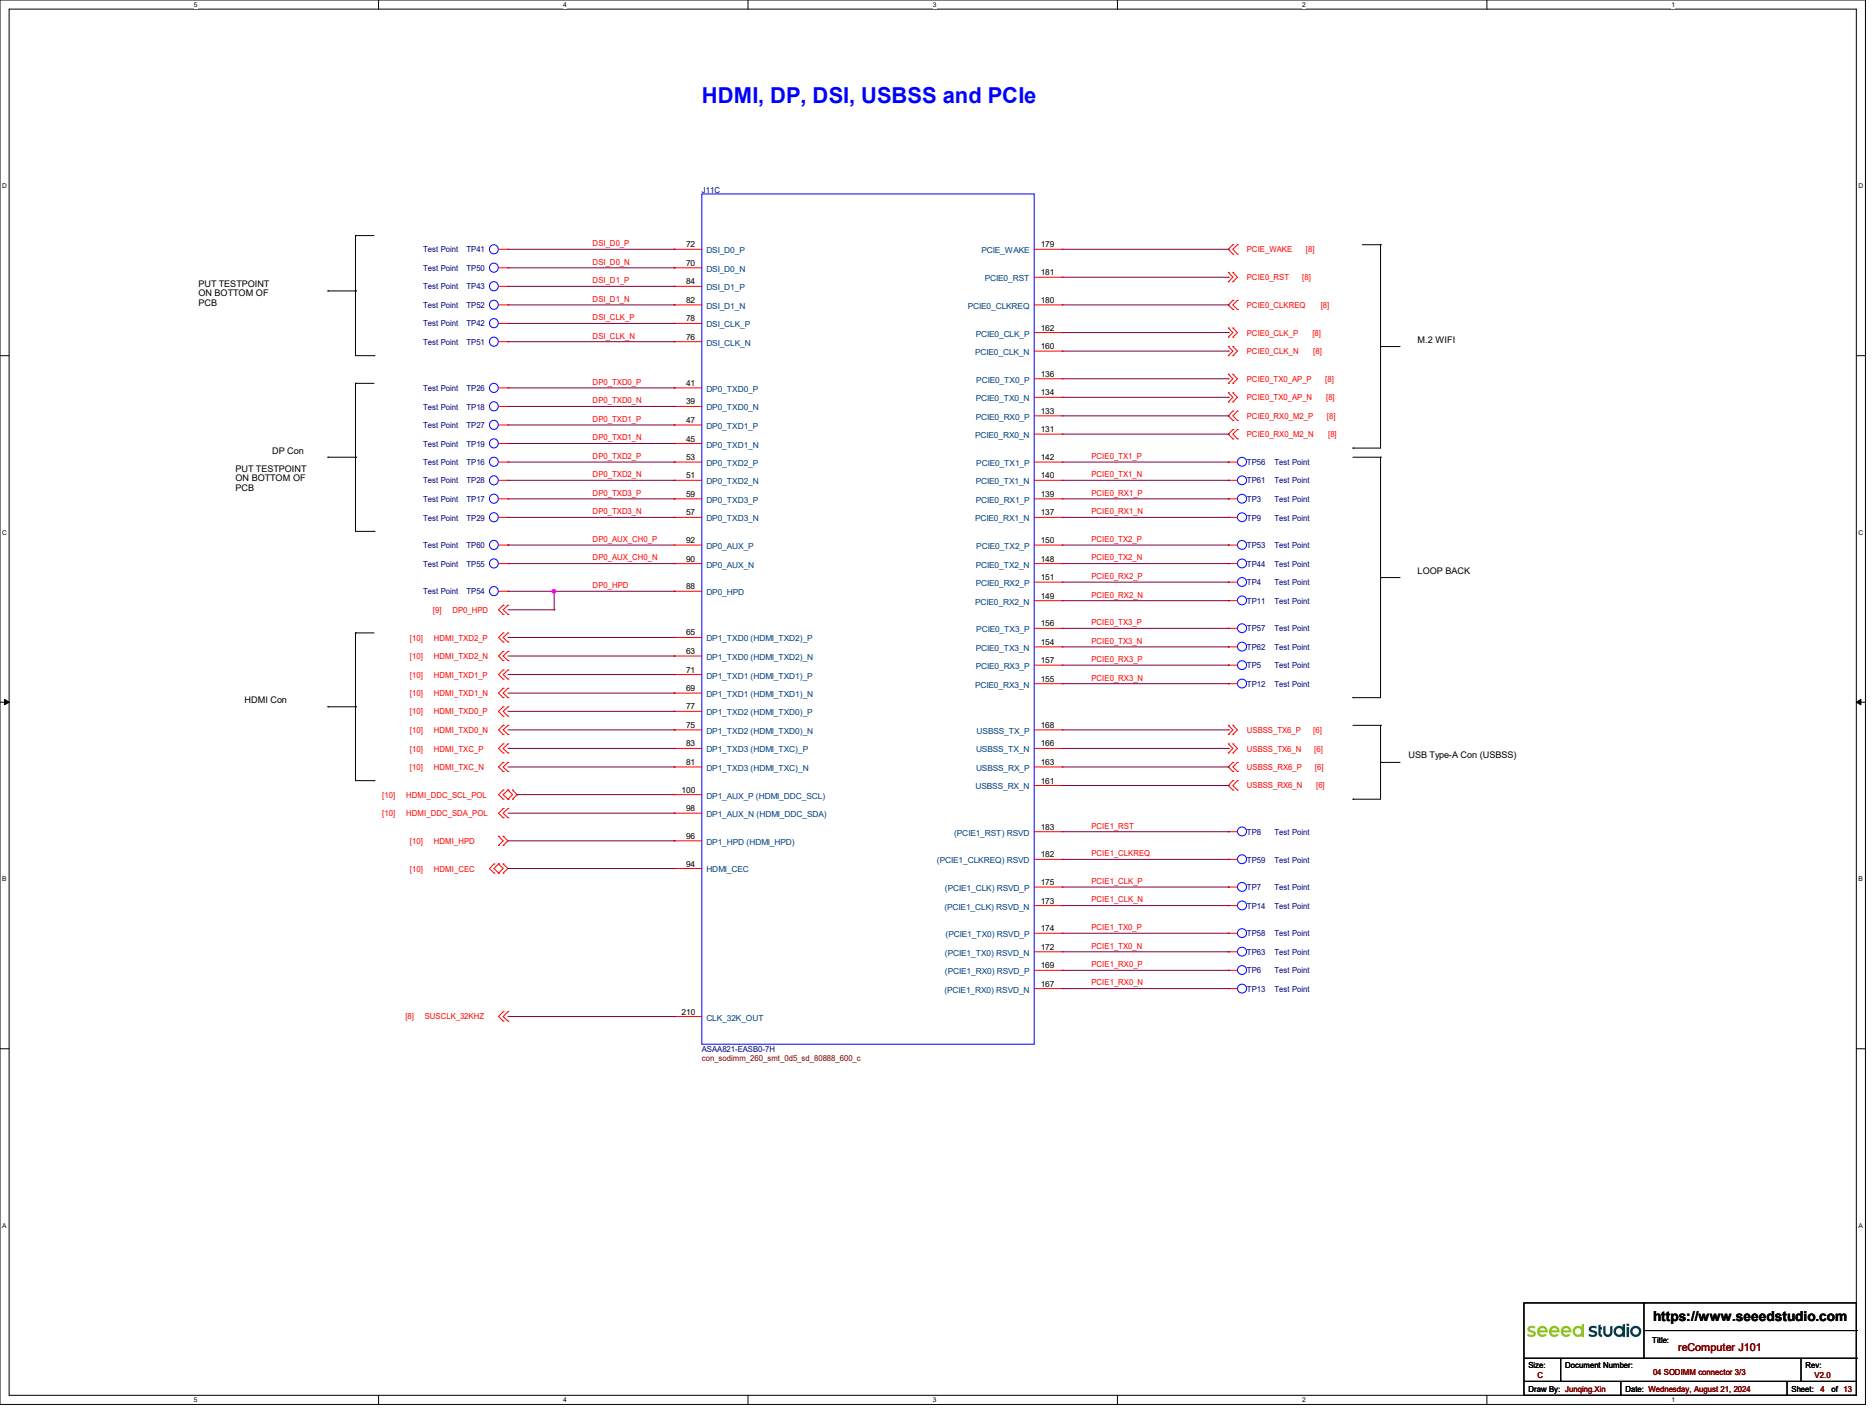
[picture p94: page 4]

Test Point TP51 Test Point TP19

TP44 Test Point Test Point TP54 Test Point TP16

TP11 Test Point TP56 Test Point Test Point TP17

USB Type-A Con (USBSS)

# USB Type C 1

## MAX: 3A

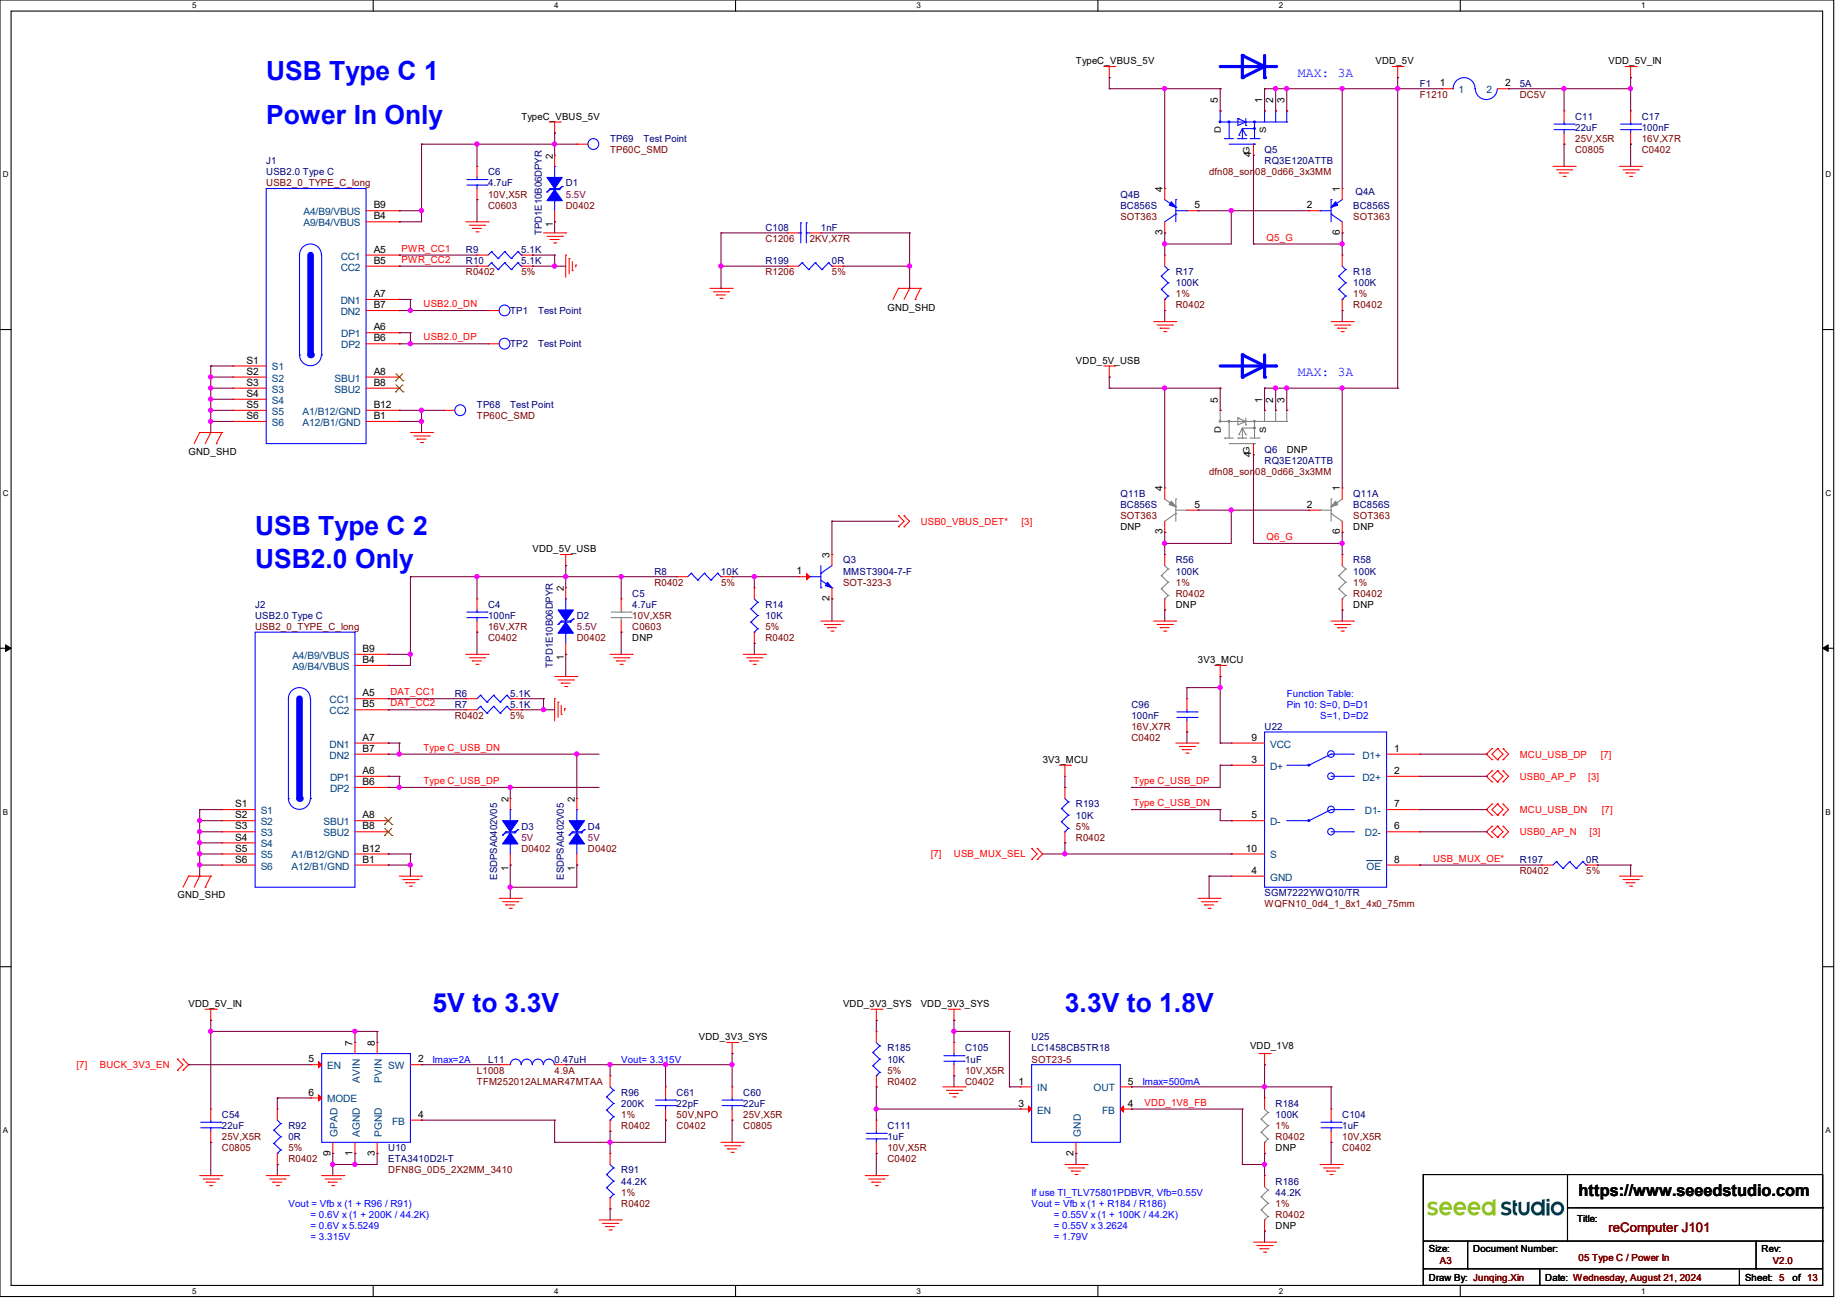
[picture p95: page 5]

USB2_0_TYPE_C_long CC1 A5 DP1 A6 DN1 A7 SBU1 A8 A1/B12/GND B12 A12/B1/GND B1 A9/B4/VBUS B4 CC2 B5 DP2 B6 DN2 B7 SBU2 B8 A4/B9/VBUS B9 S1 S1 S2 S2 S3 S3 S4 S4 S5 S5 S6 S6

reComputer J101 05 Type C / Power In

# LED2 23 PWRJ 24 GND_EP 25

# XRSTJ BUSJ VBUSM

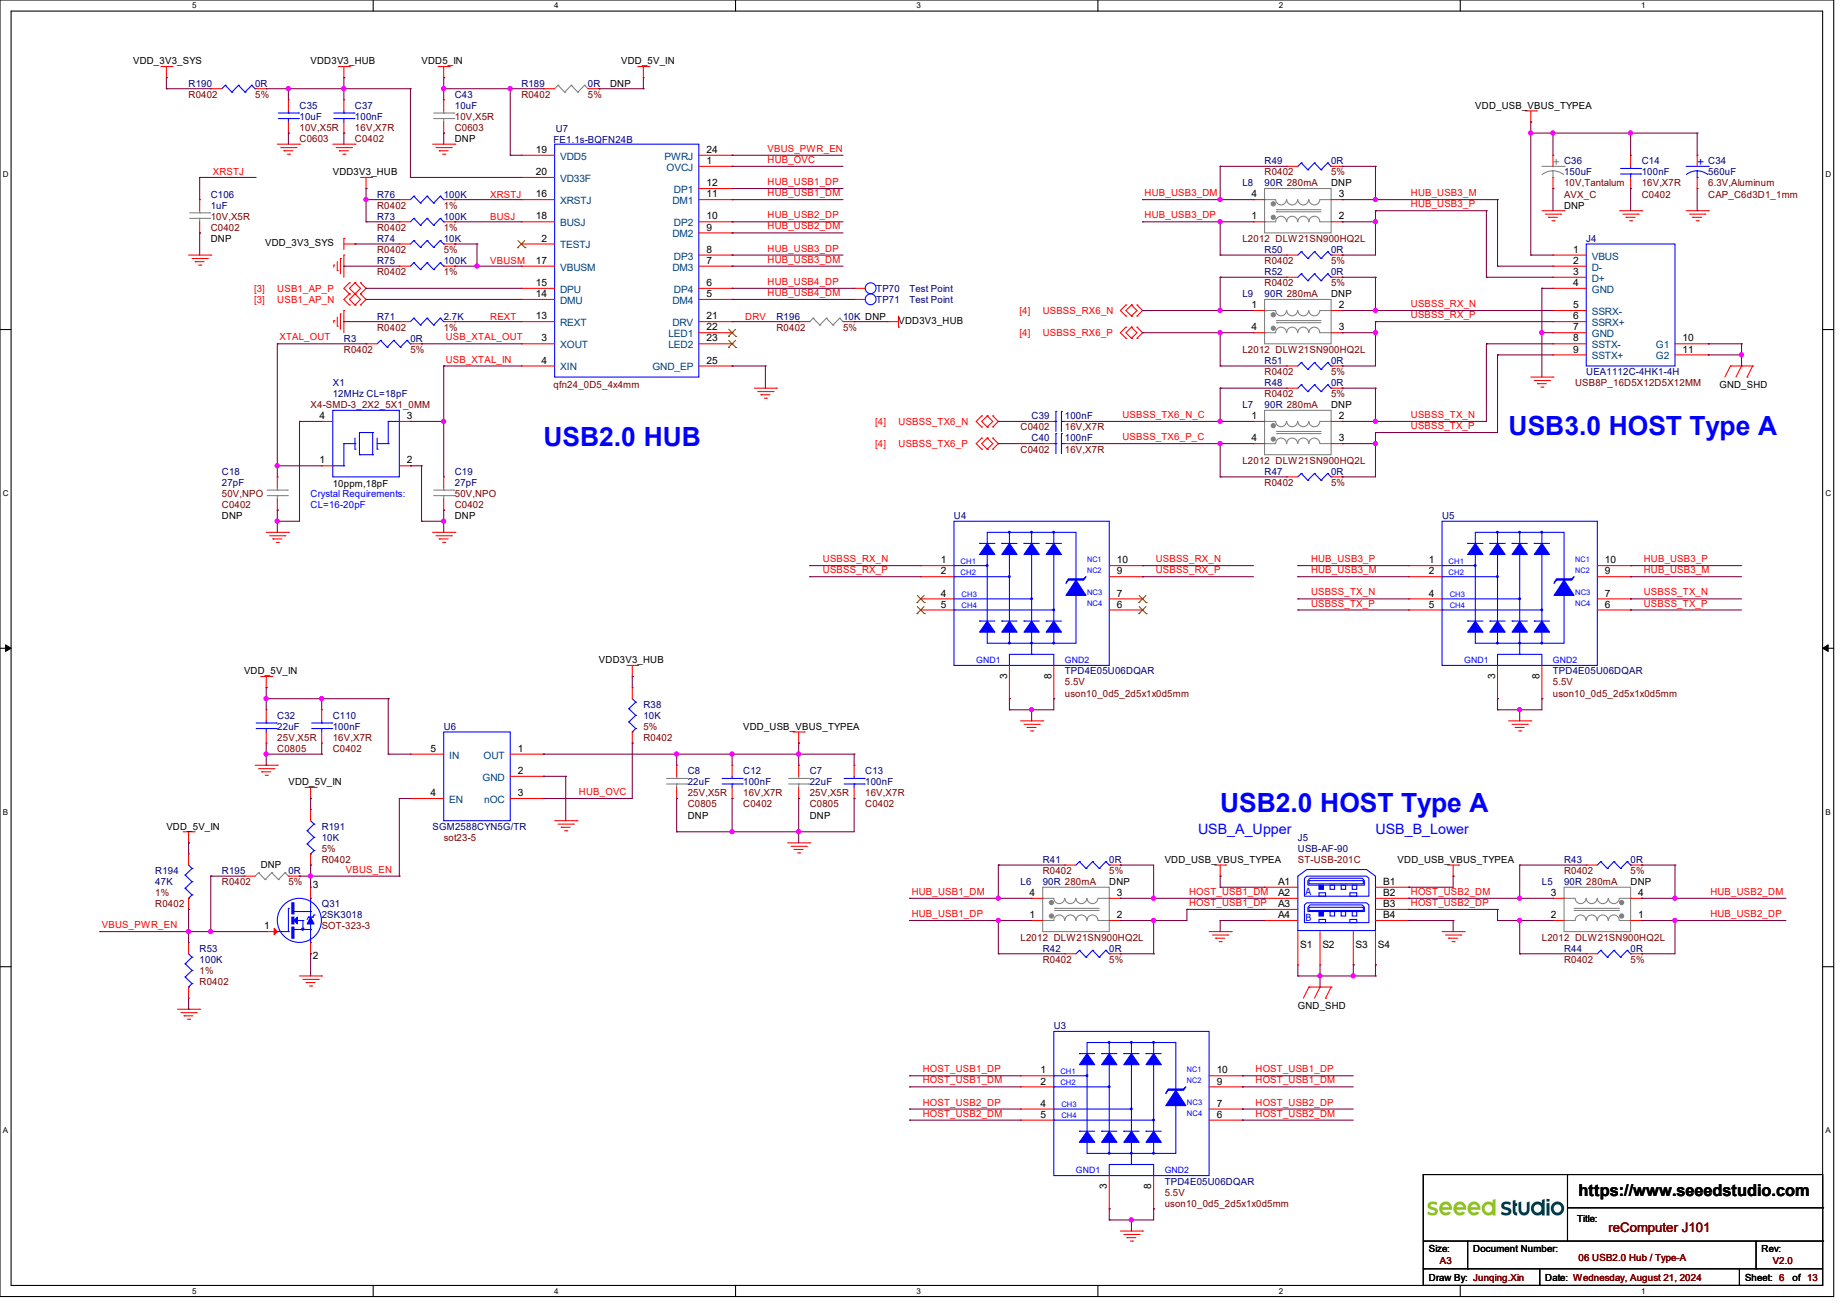
[picture p96: page 6]

USB3.0 HOST Type A Crystal Requirements:
USB2.0 HUB CL=16-20pF

# Button MCU For Power Up

# MCU

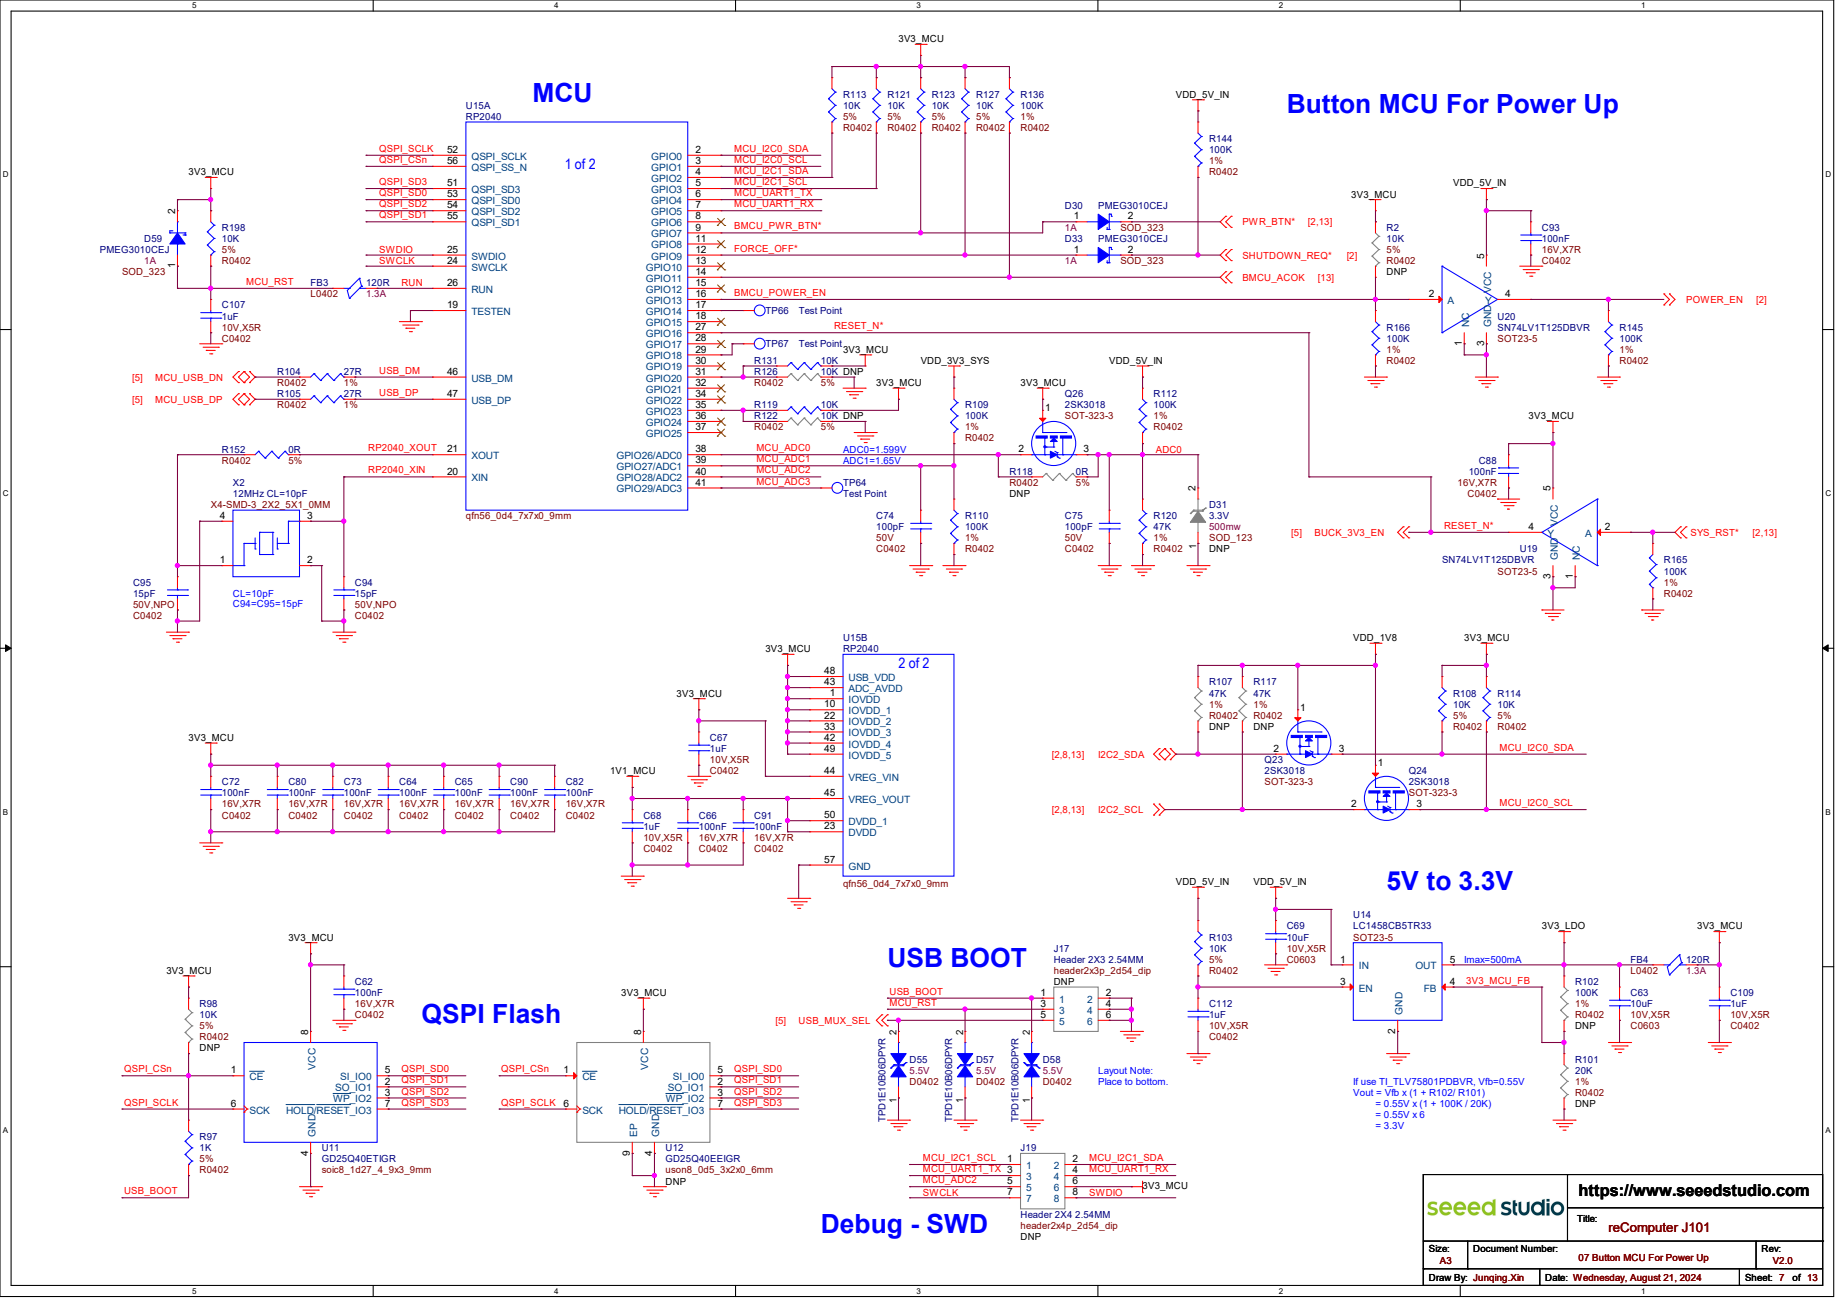
[picture p97: page 7]

GPIO0 2 GPIO1 3 GPIO2 4 GPIO3 5 GPIO4 6 GPIO5 7 GPIO6 8 GPIO7 9 GPIO8 11 GPIO9 12 GPIO10 13 GPIO11 14 GPIO12 15 GPIO13 16 GPIO14 17 GPIO15 18 GPIO16 27 GPIO17 28 GPIO18 29 GPIO19 30 GPIO20 31 GPIO21 32 GPIO22 34 GPIO23 35 GPIO24 36 GPIO25 37 GPIO26/ADC0 38 GPIO27/ADC1 39 GPIO28/ADC2 40 GPIO29/ADC3 41 RUN 26 SWCLK 24 SWDIO 25 TESTEN 19 XIN 20 XOUT 21

reComputer J101 07 Button MCU For Power Up

LED1# (I)(OD) 6 PCM_CLK/I2S_SCK(I/O)(0/1.8V) 8 PCM_SYNC/I2S_WS(I/O)(0/1.8V) 10 PCM_IN/I2S_SD_IN(I)(0/1.8V) 12 PCM_OUT/I2S_SD_OUT(O)(0/1.8V) 14 LED2#(I)(OD) 16 GND 18 UART_WAKE#(I)(0/3.3V) 20 UART_RXD(I)(0/1.8V) 22 UART_TXD(O)(0/1.8V) 32 UART_CTS(I)(0/1.8V) 34 UART_RTS(O)(0/1.8V) 36 VENDOR_DEFINED1 38 VENDOR_DEFINED2 40 VENDOR_DEFINED3 42 COEX3(I/O)(0/1.8V) 44 COEX2(I/O)(0/1.8V) 46 COEX1(I/O)(0/1.8V) 48 SUSCLK(32kHz) (O)(0/3.3V) 50 PERST0#(O)(0/3.3V) 52 W_DISABLE2#(O)(0/3.3V) 54 W_DISABLE1#(O)(0/3.3V) 56 I2C_DATA(I/O)(0/1.8V) 58 I2C_CLK(O)(0/1.8V) 60 ALERT#(I)(0/1.8V) 62 RSVD 64 UIM_SWP/PERST1# 66 UIM_POWER_SNK/CLKREQ1# 68 UIM_POWER_SRC/GPIO1/PEWAKE1# 70 3.3V 72 3.3V 74 | SH¹ ⁷⁶ SH² ⁷⁷ R201 | 1K R0402 | 5%

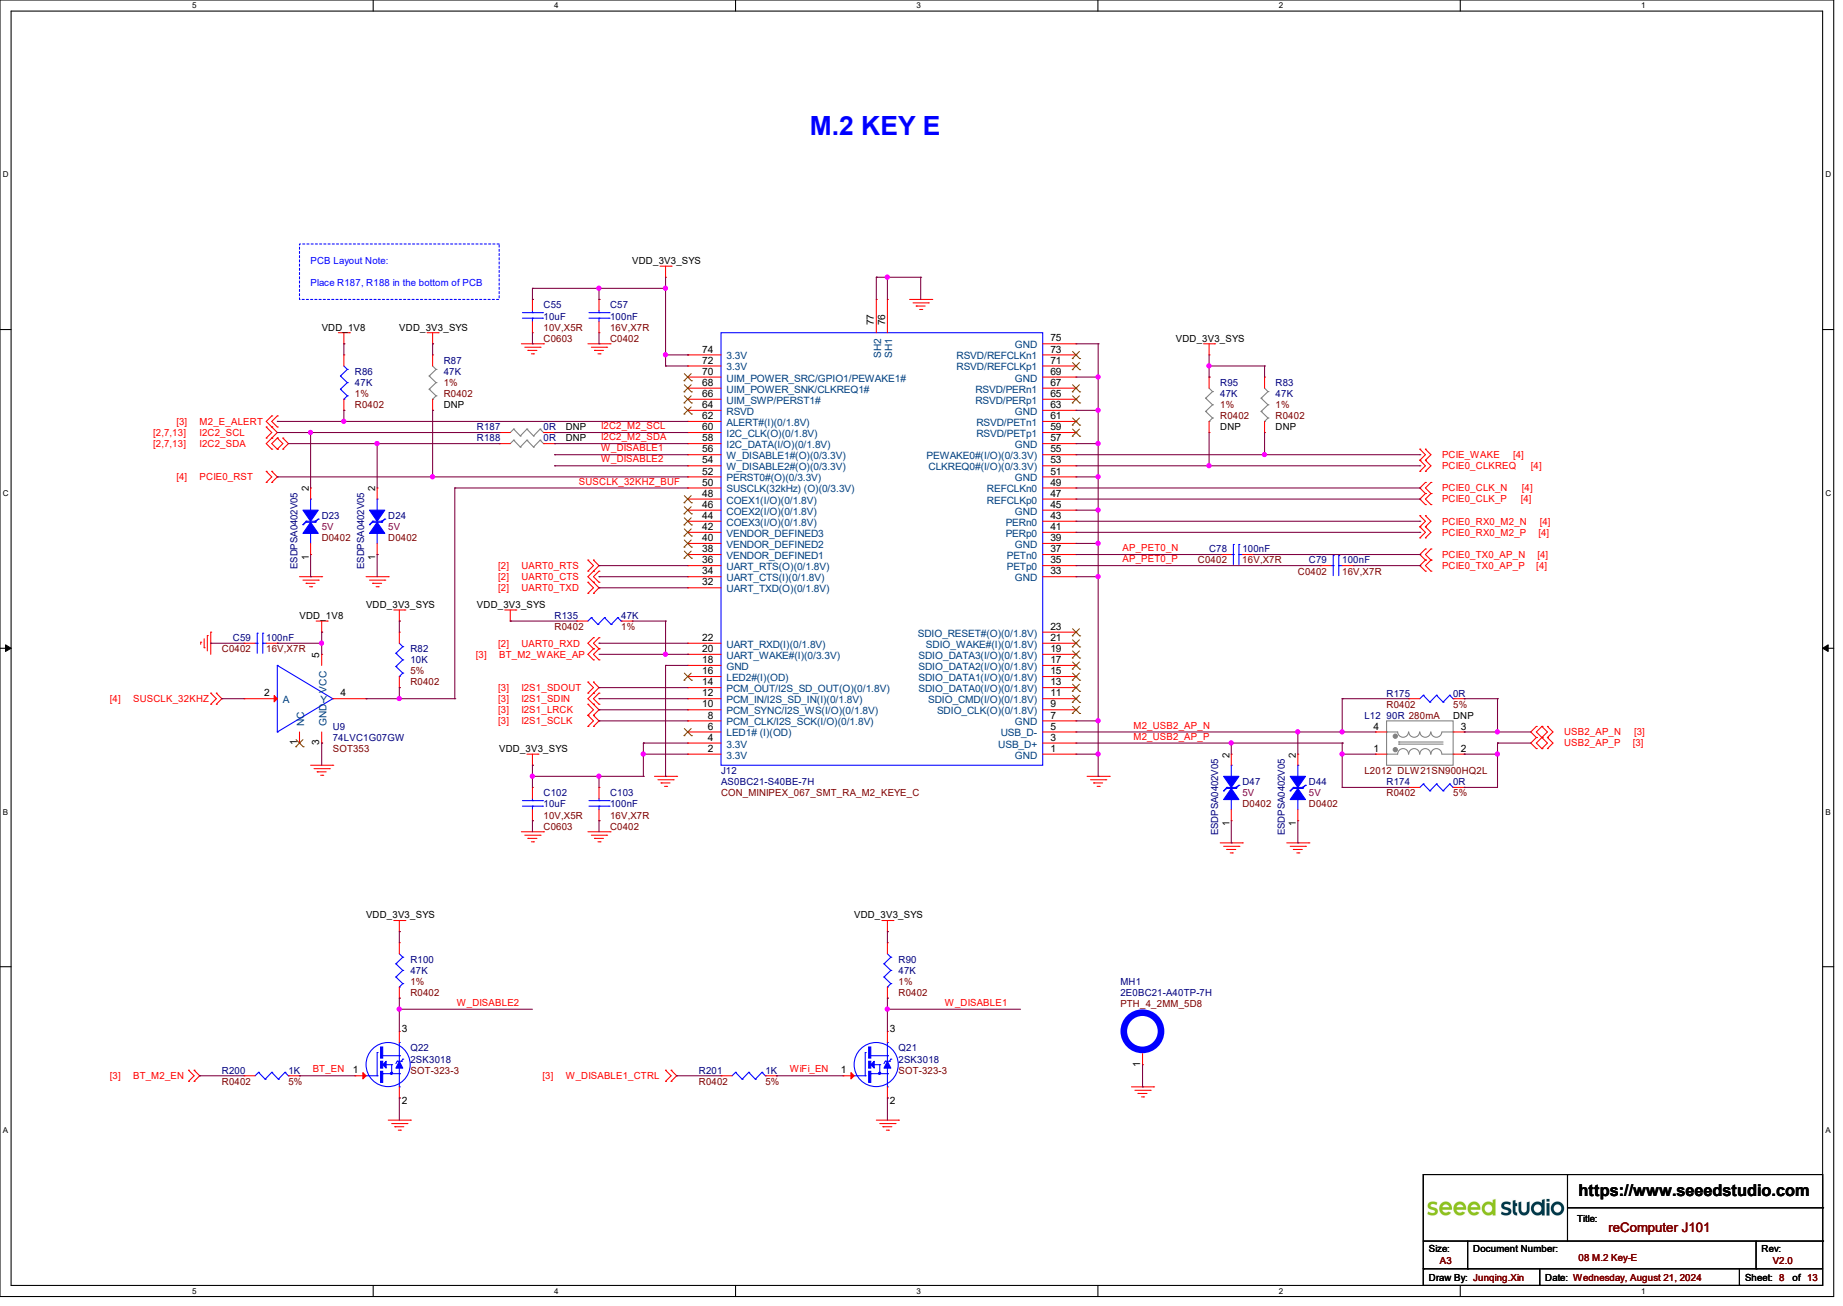
[picture p98: page 8]

Place R187, R188 in the bottom of PCB

# Gigabit Ethernet with PoE

SHIELD_1 19 | SHIELD_2 20 | MCT_1 4 | MCT_2 5

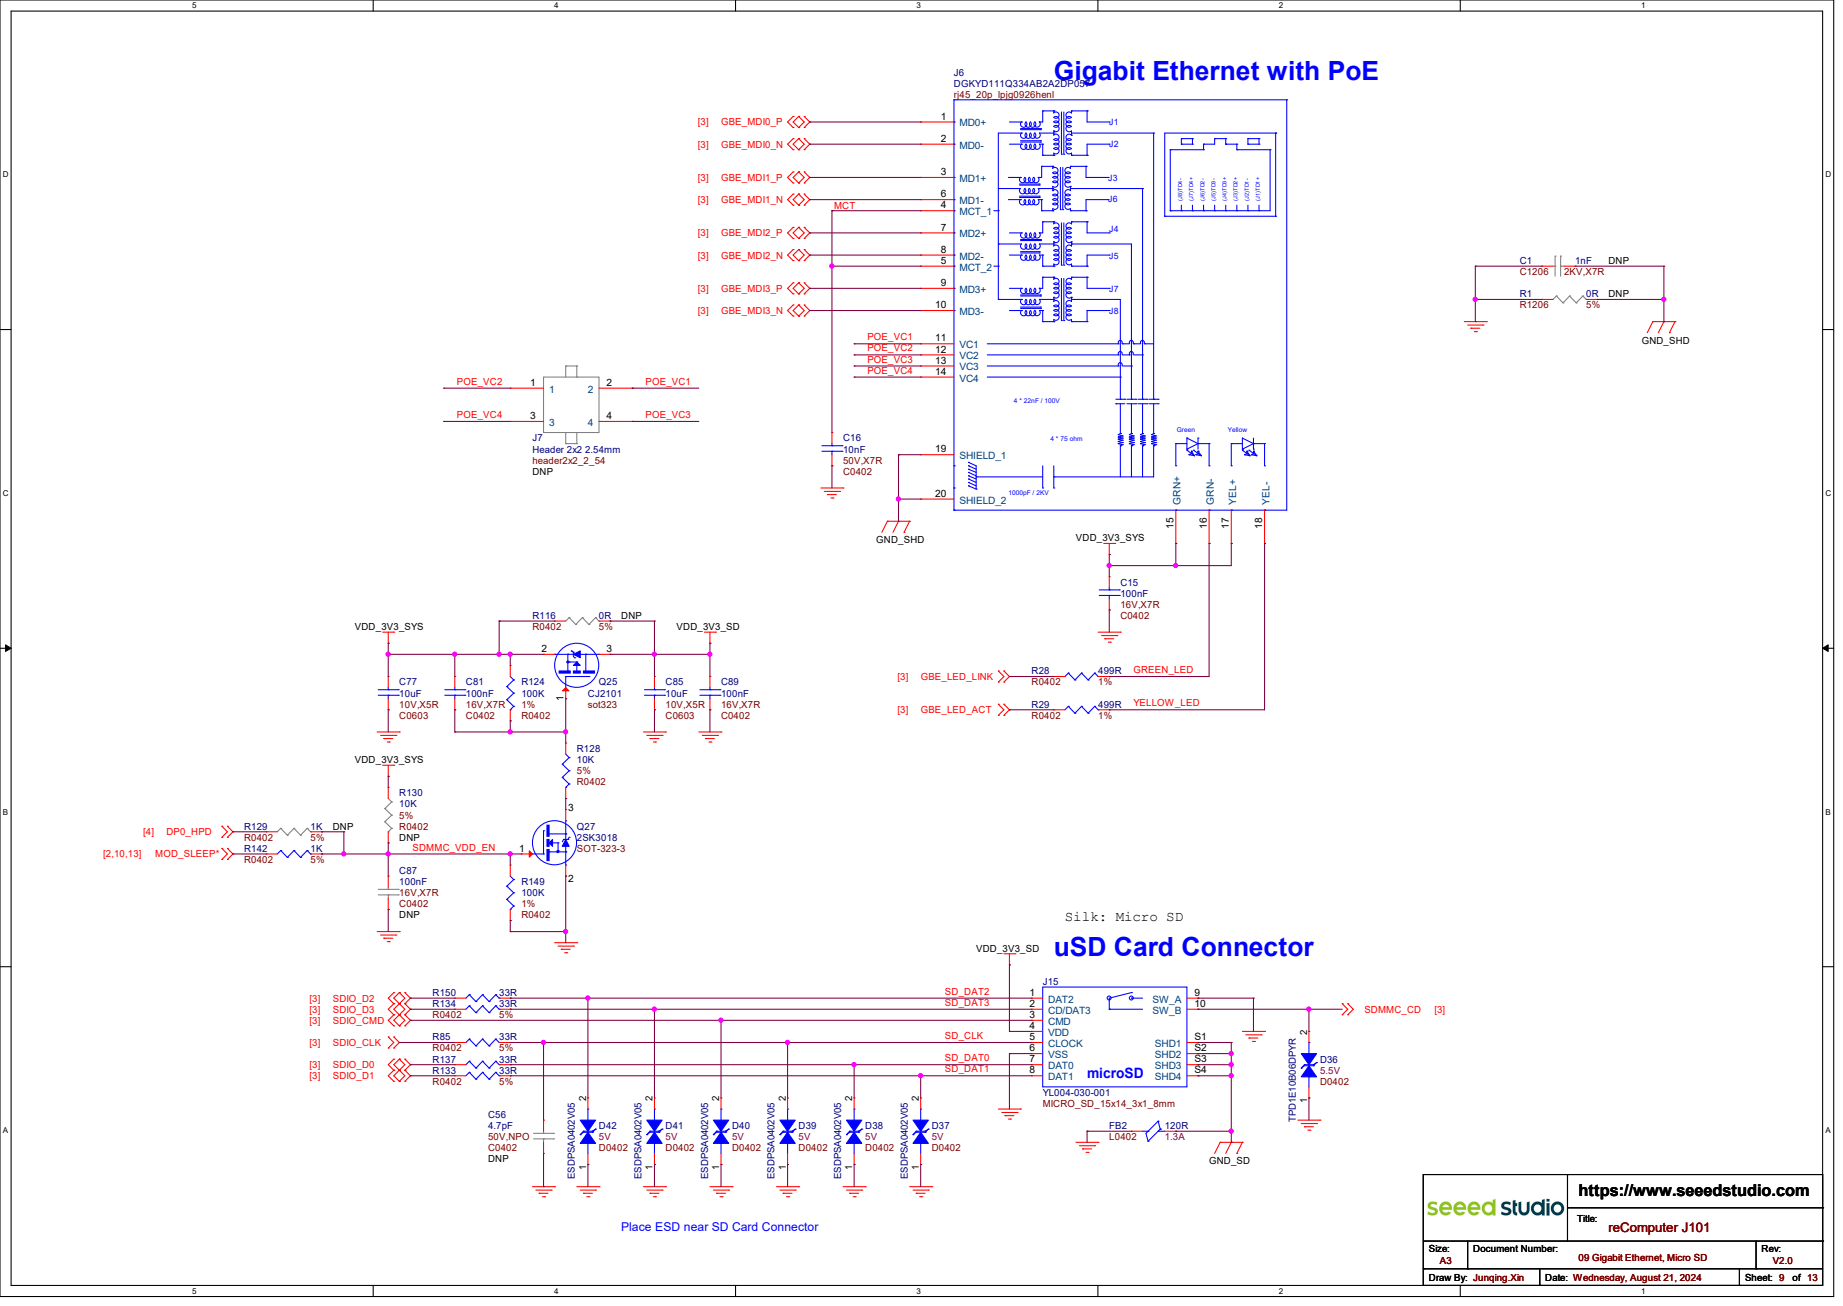
[picture p99: page 9]

Place ESD near SD Card Connector

reComputer J101 09 Gigabit Ethernet, Micro SD

# HDMI Connector

2 3 Q16

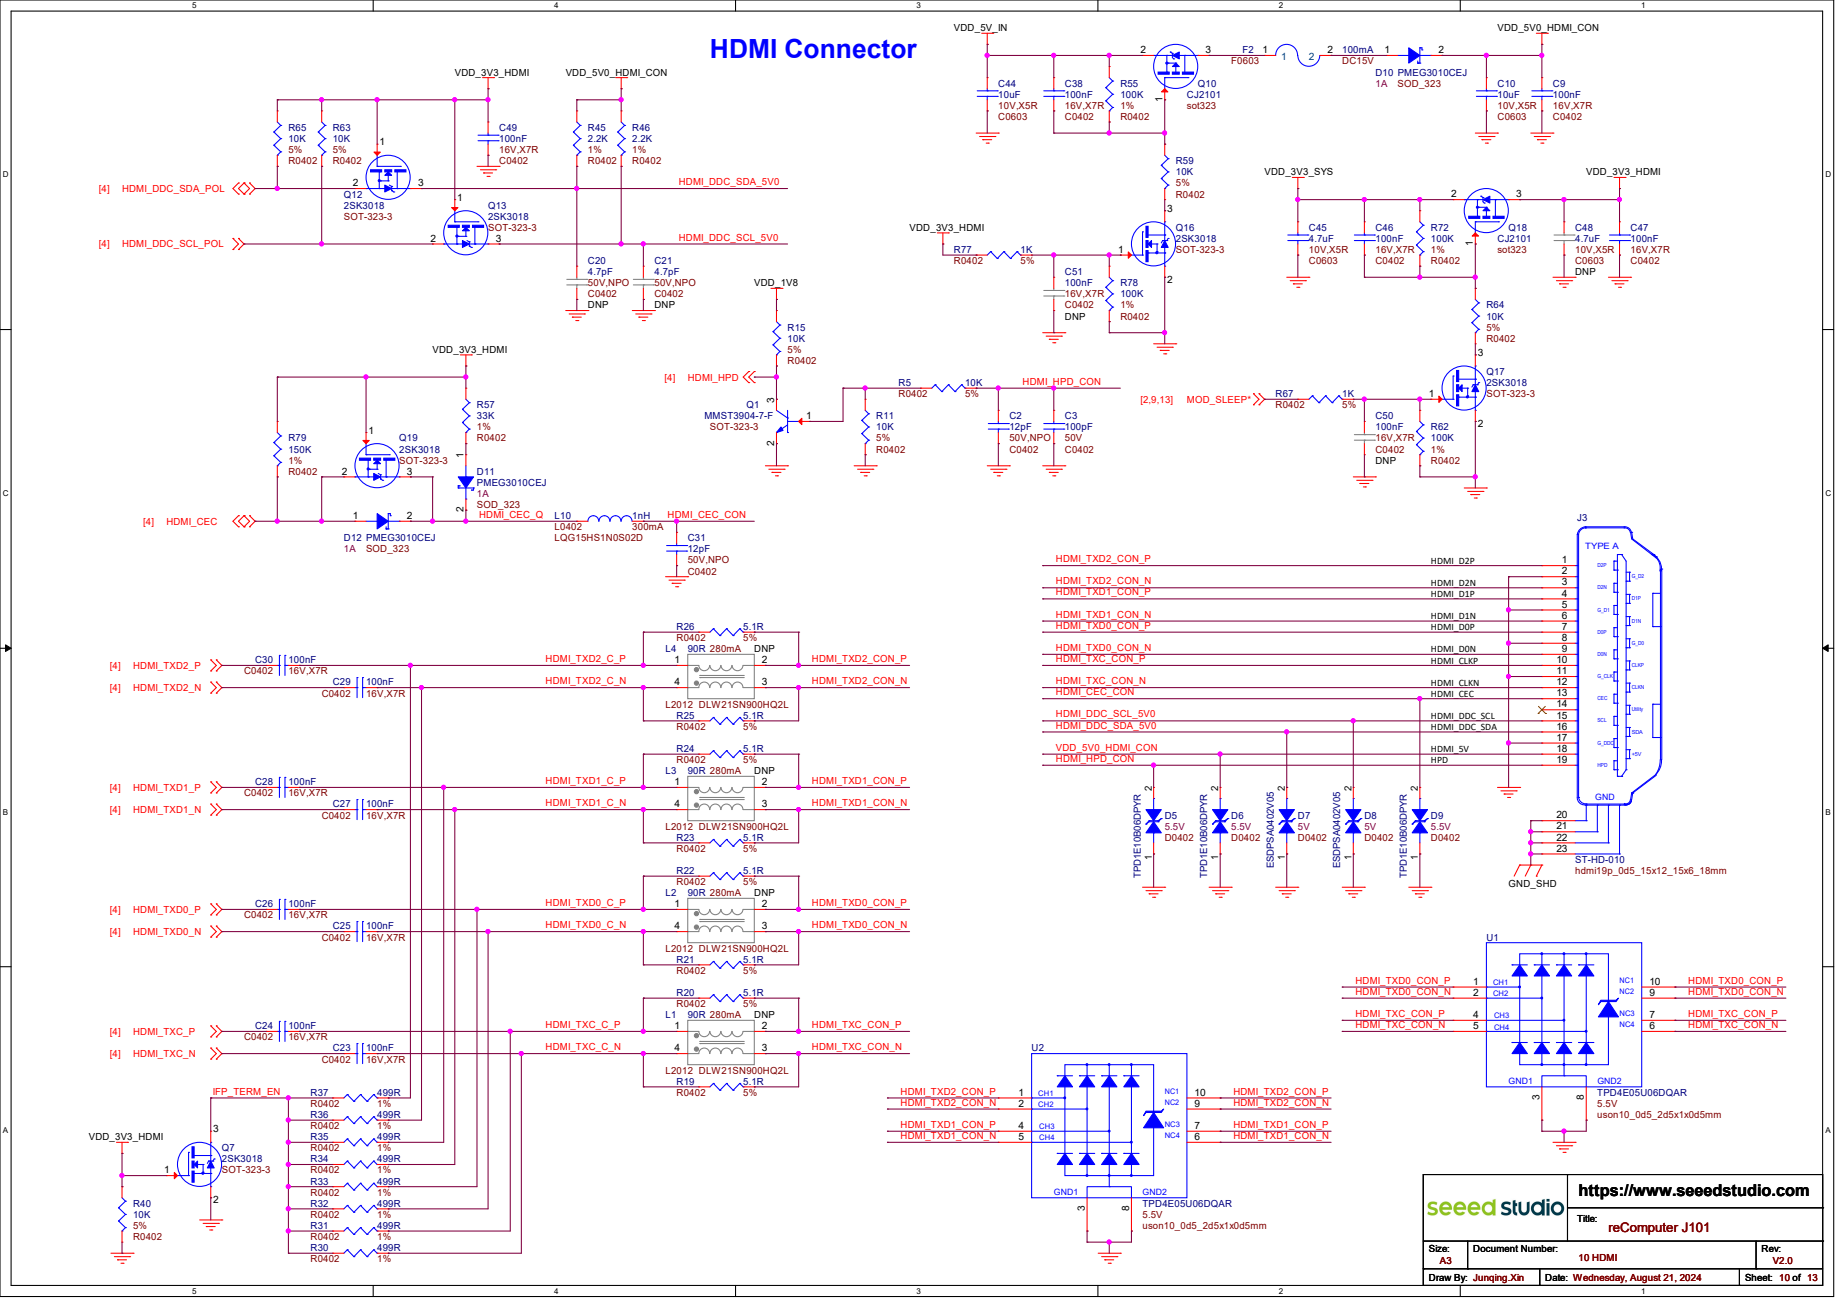
[picture p100: page 10]

# CSI CAM CONNECTOR

# J9YL002-007

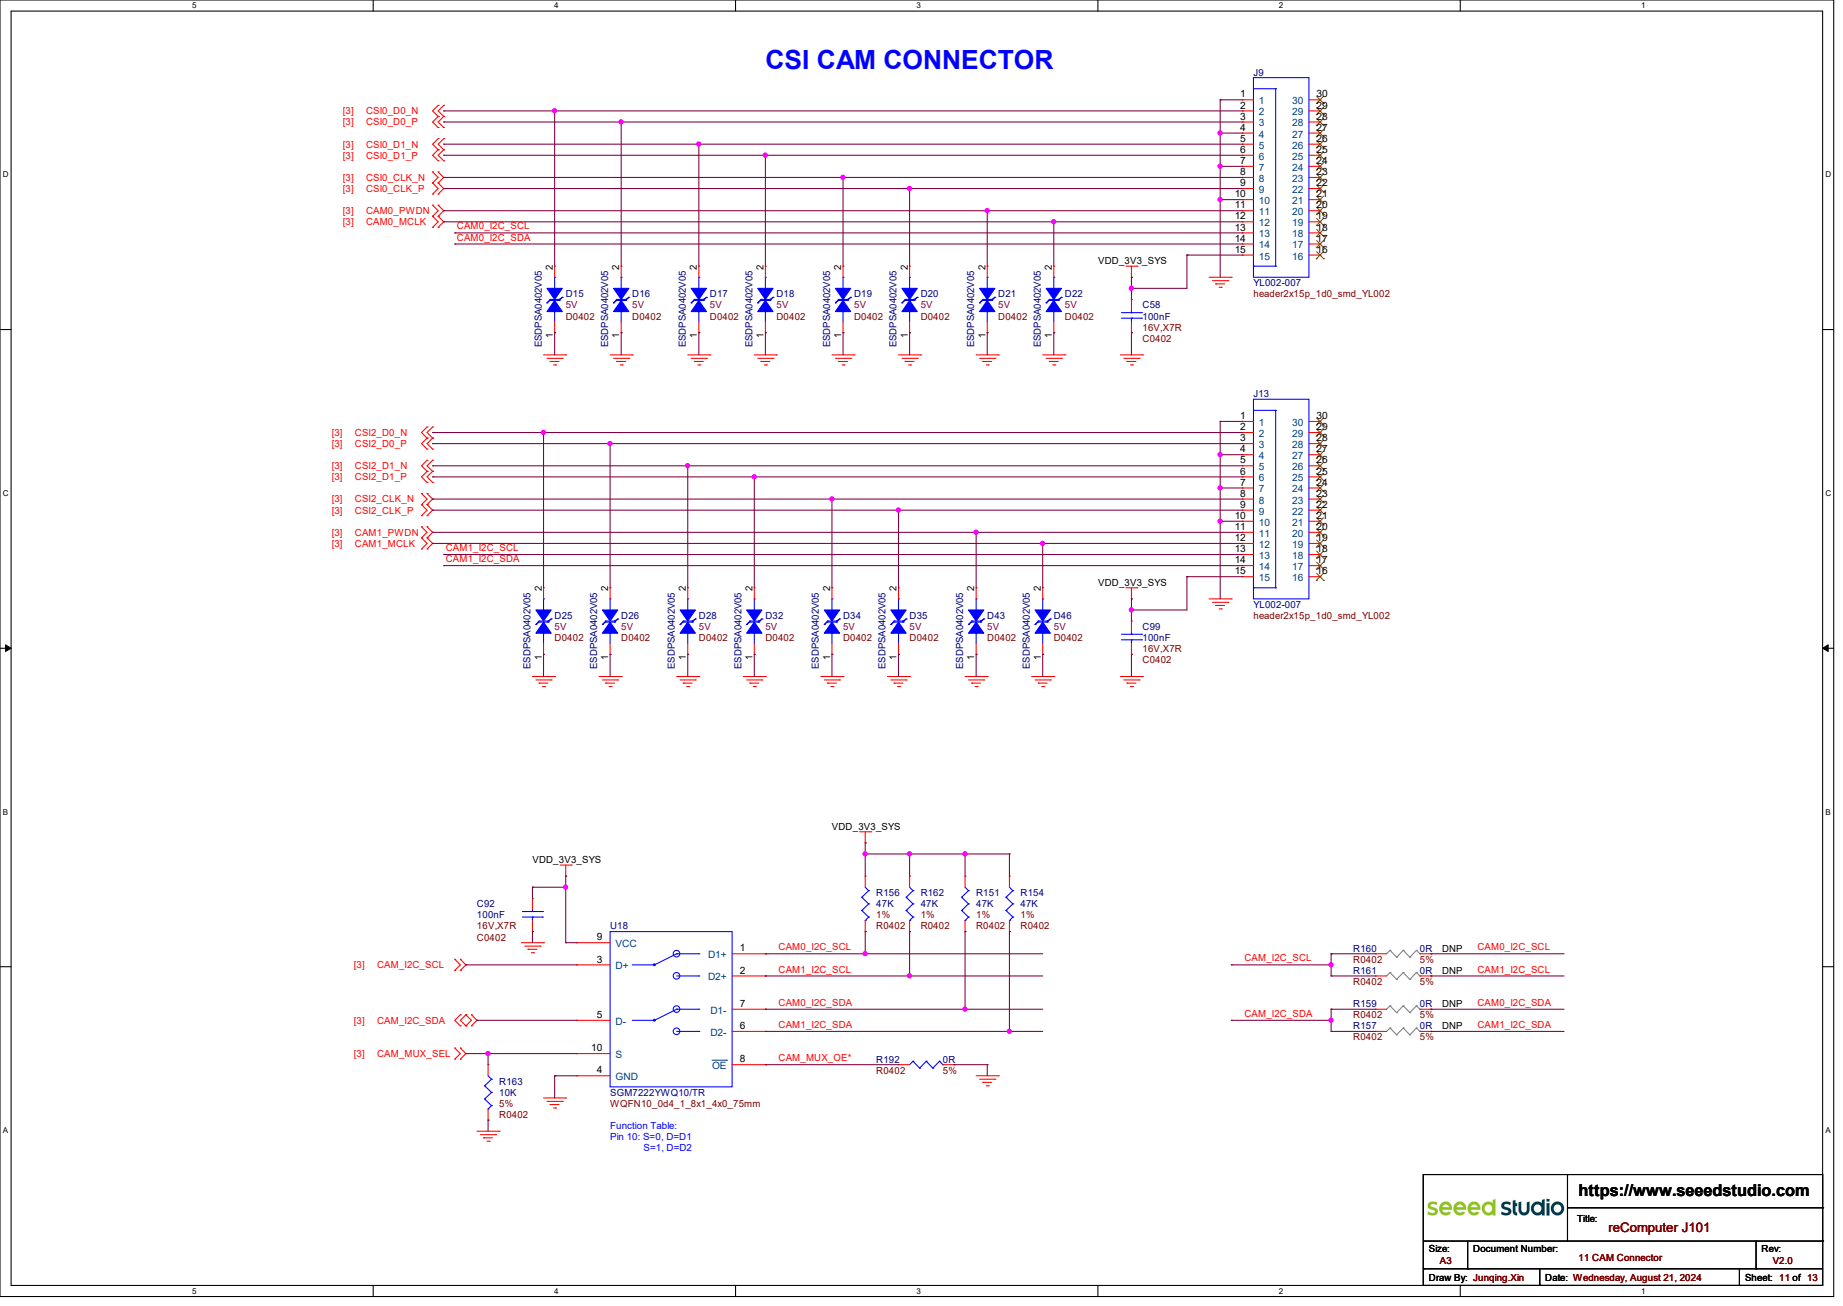
[picture p101: page 11]

# 40PIN GPIO EXPANSION HEADER & LEVEL SHIFTERS

# U16 TXB0108PWR

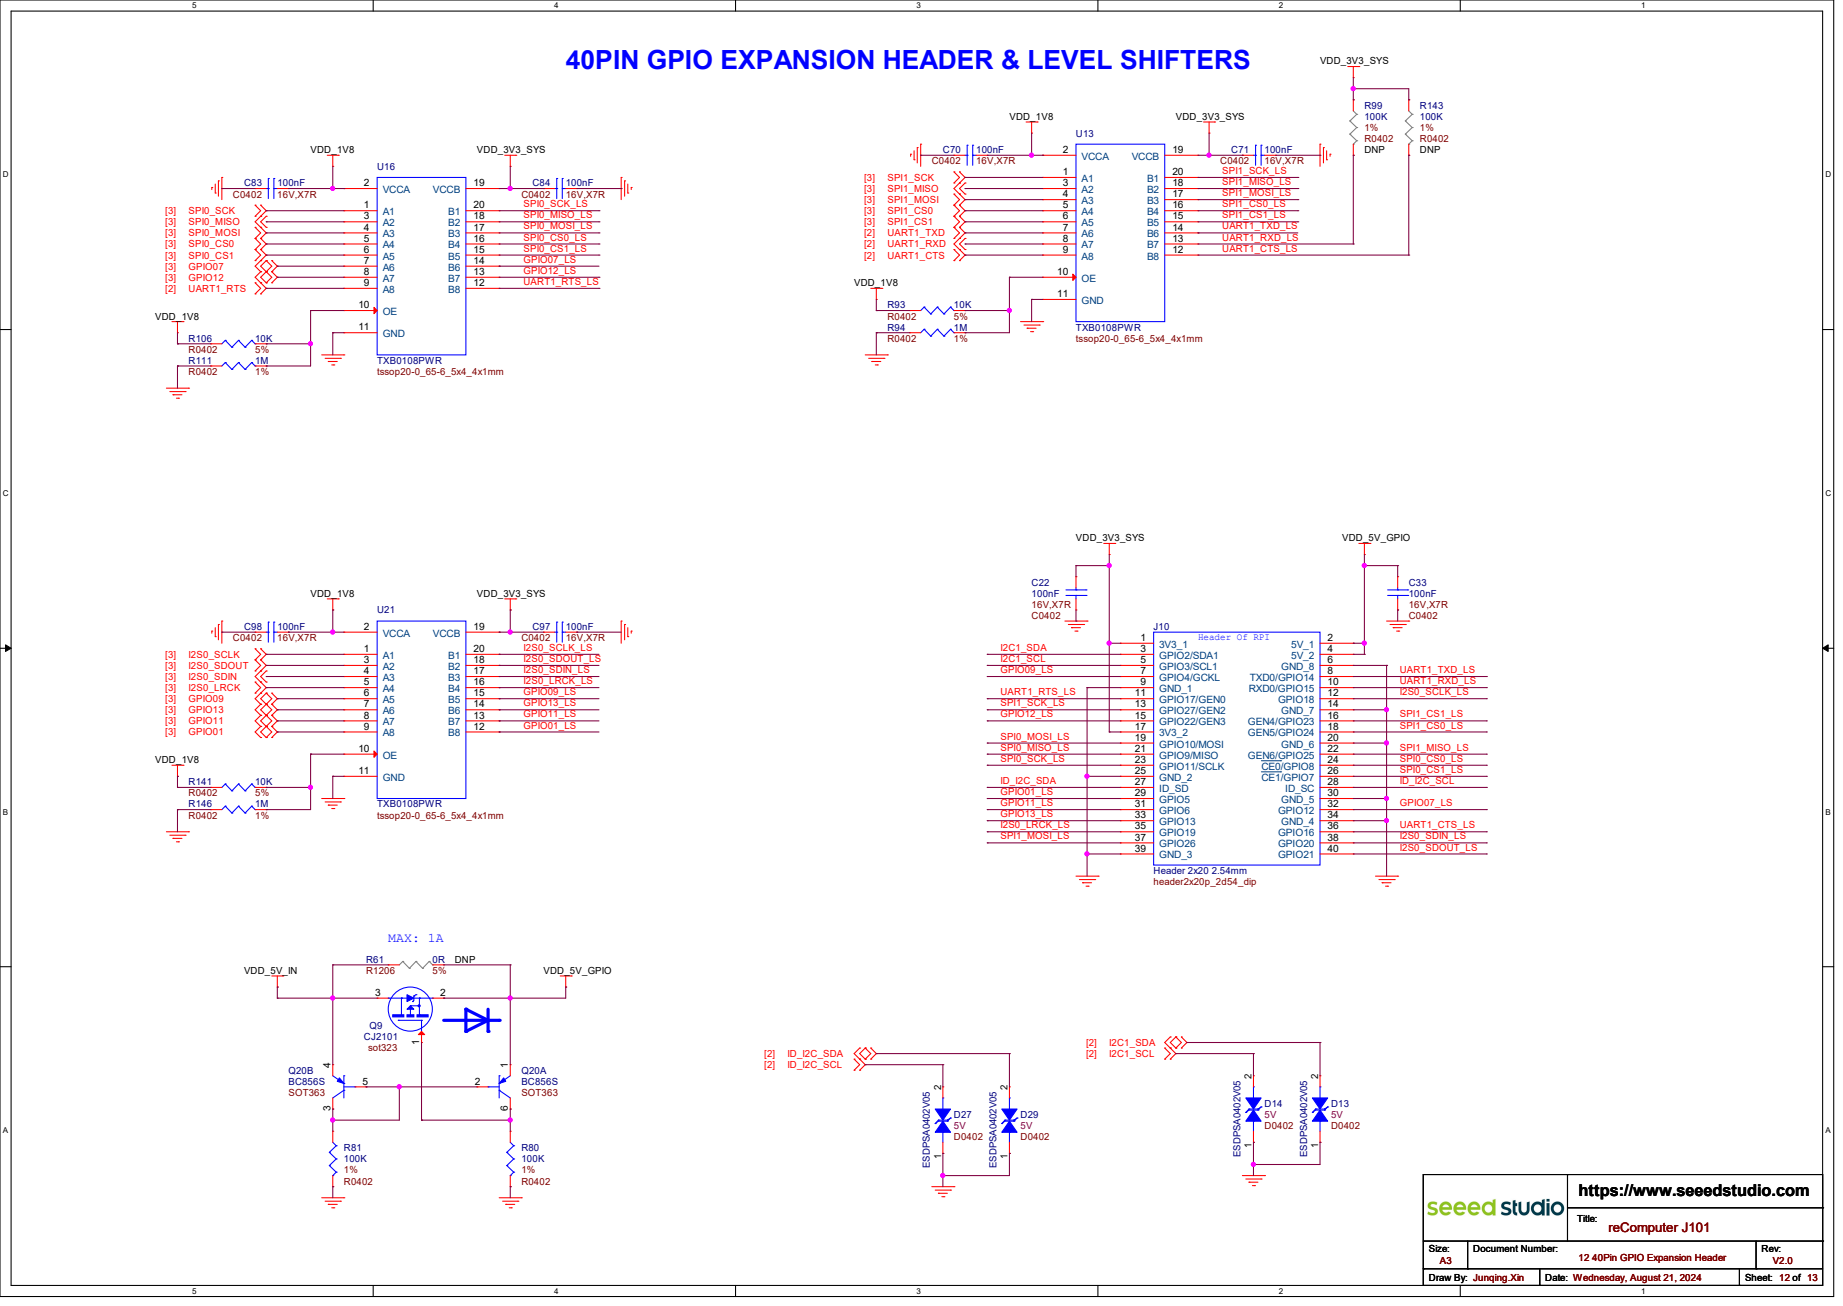
[picture p102: page 12]

reComputer J101 12 40Pin GPIO Expansion Header

SoC Fan Header 4pin | Carrier Board Config

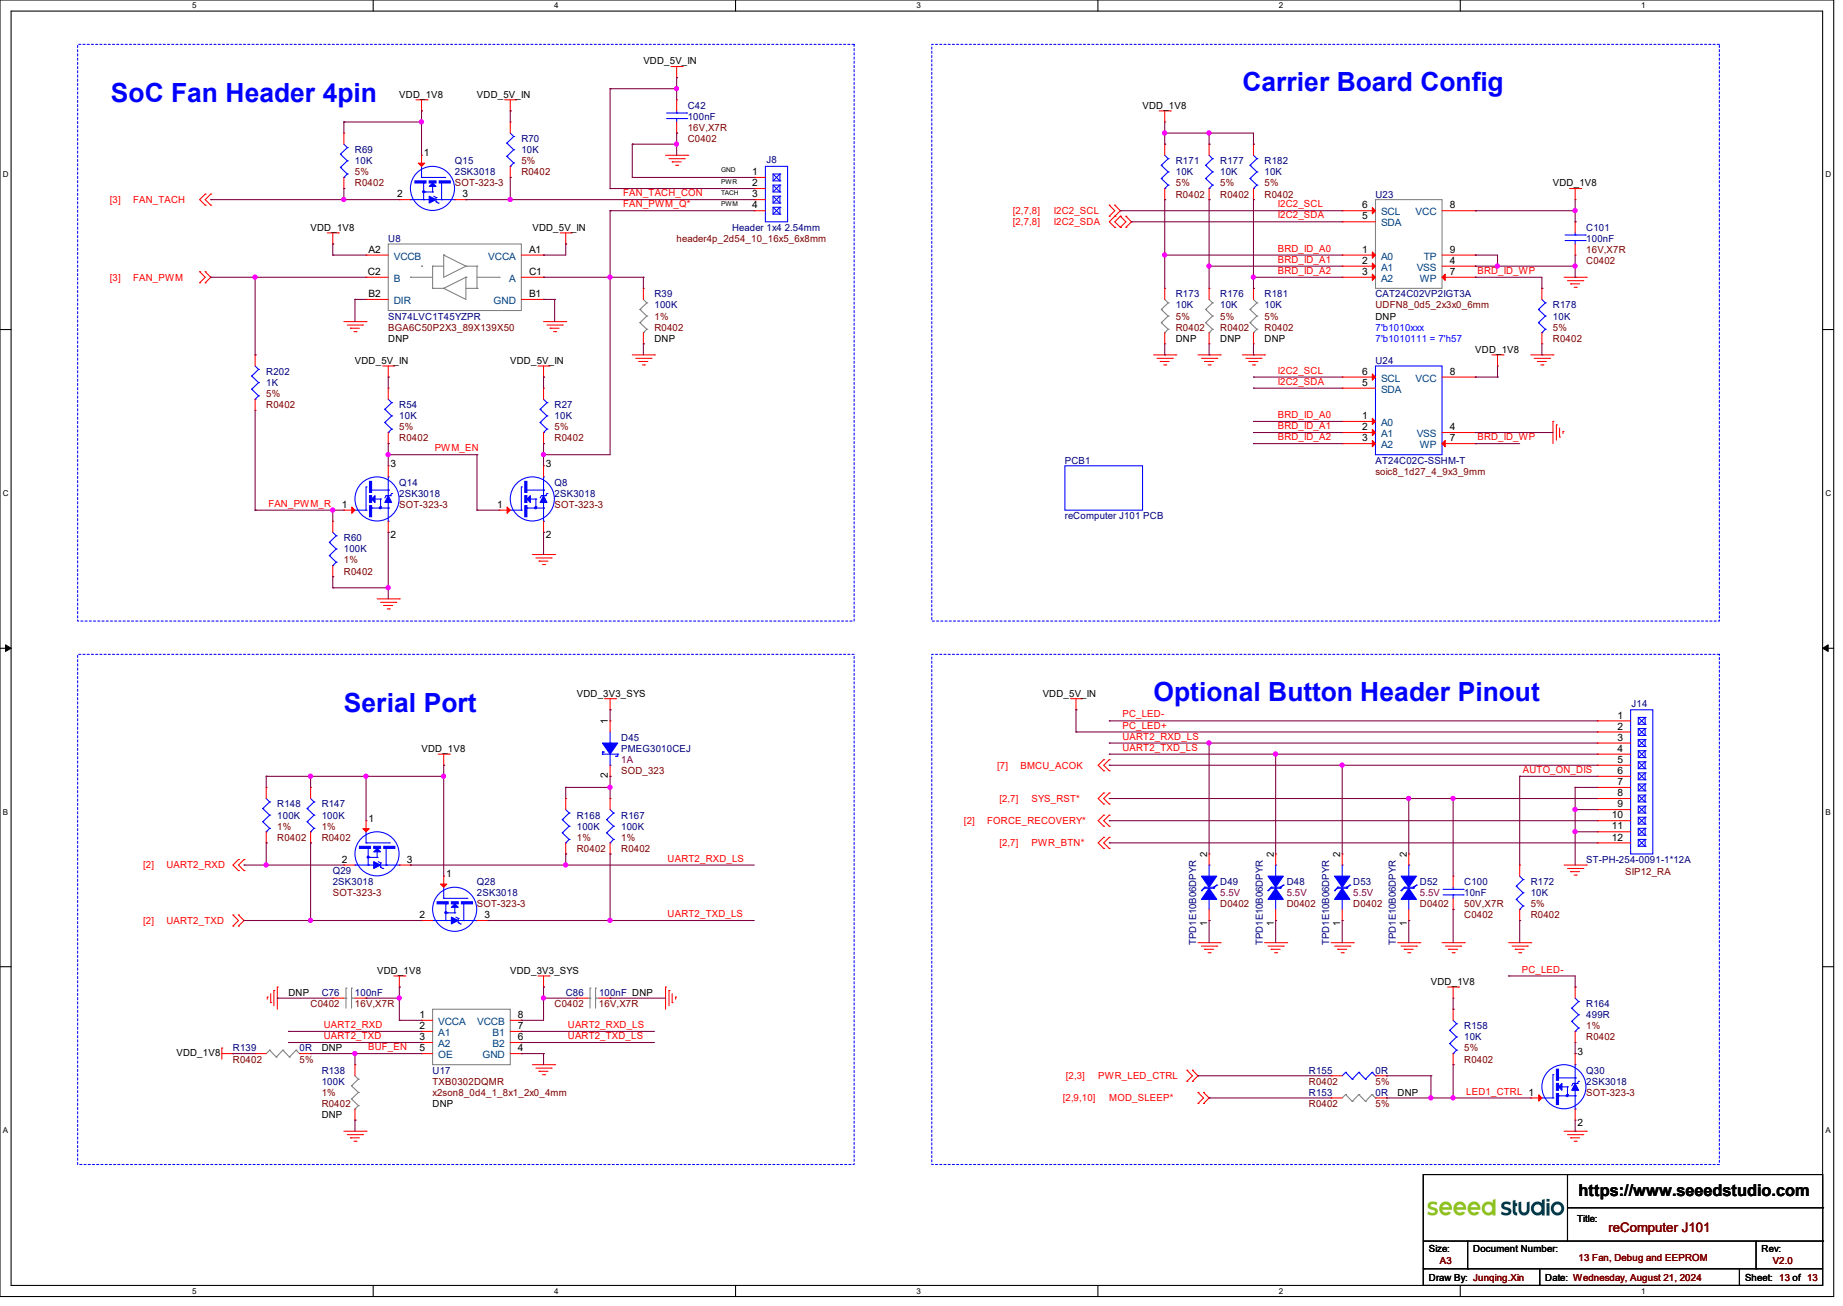
[picture p103: page 13]

reComputer J101 13 Fan, Debug and EEPROM
