Seeed-Studio/OSHW-Jetson-Series/reComputer Jetson carrier board/reComputer J1020 v2/Schematic/reComputer J202_V1.0_SCH_PDF_240822.pdf

02 | Block Diagram

# 03 Power Tree

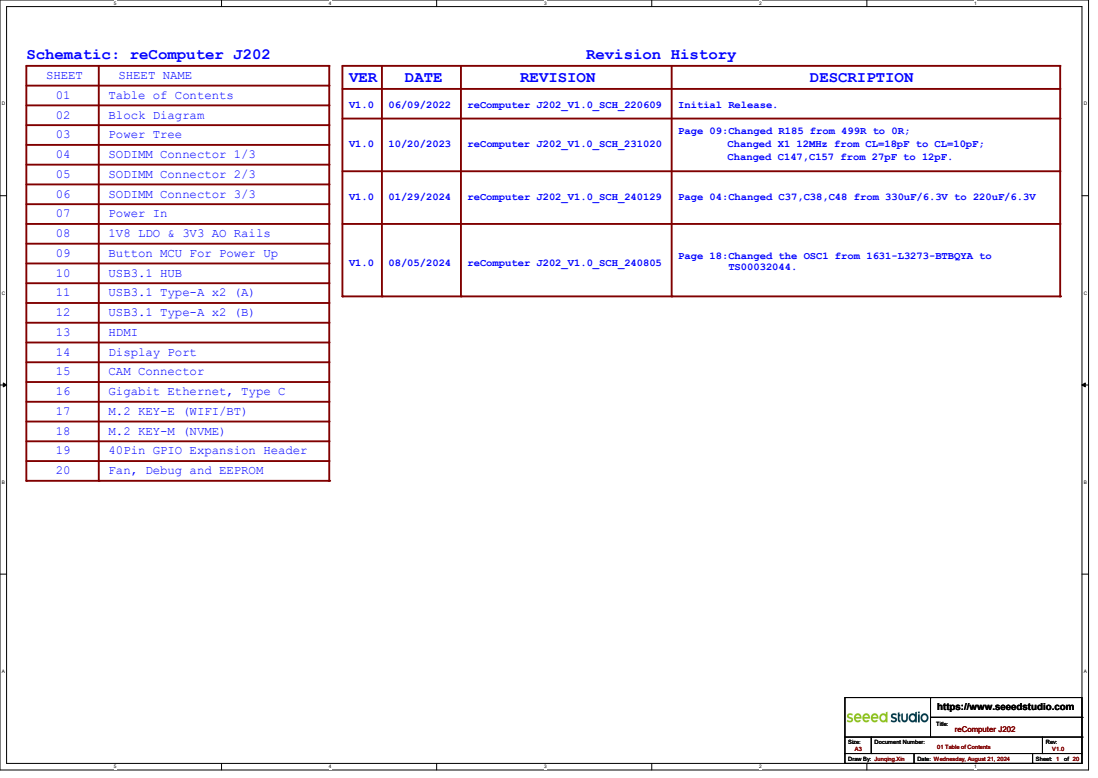
[picture p104: page 1]
SHEET NAME; REVISION; VER; Initial Release.; DESCRIPTION; reComputer J202_V1.0_SCH_220609; Revision History; DATE; reComputer J202_V1.0_SCH_240805; Page 18:Changed the OSC1 from 1631-L3273-BTBQYA to; Title: Size:; Document Number:; Rev: Draw By:; Date:; Sheet:; https://www.seeedstudio.com A3; Junqing.Xin; Wednesday, August 21, 2024; reComputer J202 01 Table of Contents Title: Size:

Schematic: reComputer J202
SHEET
01 Table of Contents

V1.0 | 10/20/2023 | reComputer J202_V1.0_SCH_231020 | Page 09:Changed R185 from 499R to 0R; Changed X1 12MHz from CL=18pF to CL=10pF; Changed C147,C157 from 27pF to 12pF.

04 | SODIMM Connector 1/3
05 | SODIMM Connector 2/3
06 | SODIMM Connector 3/3
07 | Power In

V1.0 | 01/29/2024 | reComputer J202_V1.0_SCH_240129 | Page 04:Changed C37,C38,C48 from 330uF/6.3V to 220uF/6.3V

1V8 LDO & 3V3 AO Rails

09 | Button MCU For Power Up
10 USB3.1 HUB
11 USB3.1 Type-A x2 (A)
12 | USB3.1 Type-A x2 (B)
13 HDMI
14 | Display Port
15 | CAM Connector
16 Gigabit Ethernet, Type C
17 | M.2 KEY-E (WIFI/BT)
18 | M.2 KEY-M (NVME)
19 | 40Pin GPIO Expansion Header
20 | Fan, Debug and EEPROM

reComputer J202 01 Table of Contents

# BASEBOARD CIRCUIT

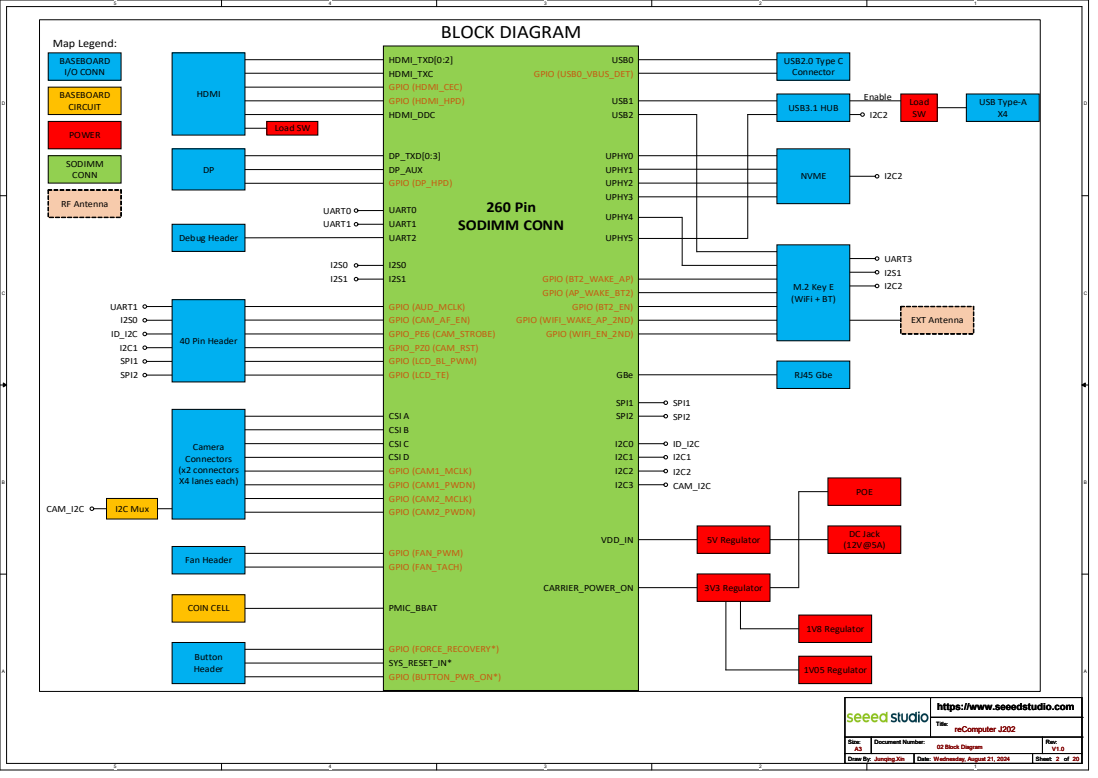
[picture p105: page 2]
POWER; BASEBOARD I/O CONN; SODIMM CONN; RF Antenna; Map Legend:; BLOCK DIAGRAM; HDMI_TXD[0:2]; HDMI; Load SW; HDMI_TXC GPIO (HDMI_CEC) GPIO (HDMI_HPD) HDMI_DDC; DP_TXD[0:3] DP_AUX GPIO (DP_HPD); UART0 UART1 UART2; GPIO (AUD_MCLK) GPIO (CAM_AF_EN) GPIO_PE6 (CAM_STROBE) GPIO_PZ0 (CAM_RST) GPIO (LCD_BL_PWM) GPIO (LCD_TE); CSI A CSI B CSI C CSI D GPIO (CAM1_MCLK) GPIO (CAM1_PWDN) GPIO (CAM2_MCLK) GPIO (CAM2_PWDN); GPIO (FAN_PWM) GPIO (FAN_TACH); PMIC_BBAT; SYS_RESET_IN*; GPIO (FORCE_RECOVERY*)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

reComputer J202 02 Block Diagram

# Jetson Xavier NX

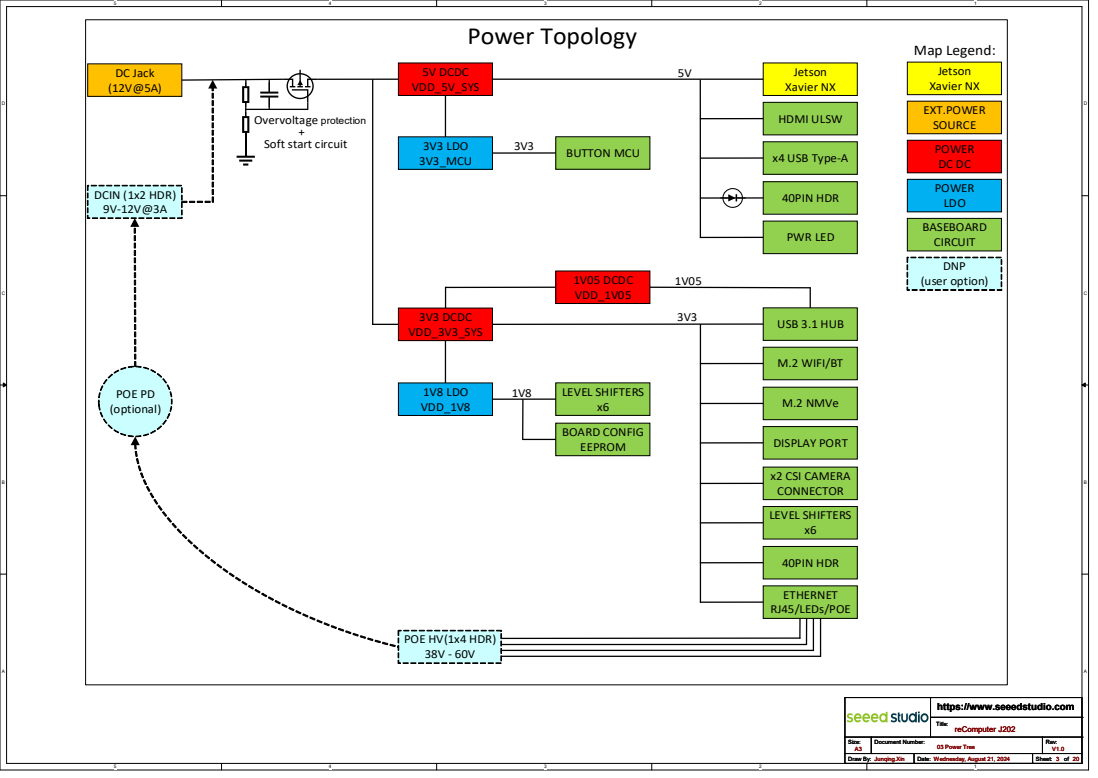
[picture p106: page 3]
BUTTON MCU; BOARD CONFIG EEPROM; LEVEL SHIFTERS x6; 3V3 DCDC VDD_3V3_SYS; 5V DCDC VDD_5V_SYS; 1V05 DCDC VDD_1V05; USB 3.1 HUB; M.2 WIFI/BT; M.2 NMVe; DISPLAY PORT; x2 CSI CAMERA CONNECTOR; 40PIN HDR; ETHERNET RJ45/LEDs/POE; HDMI ULSW; x4 USB Type-A; PWR LED; 3V3 LDO 3V3_MCU; 1V8 LDO VDD_1V8; DCIN (1x2 HDR) 9V-12V@3A; POE PD (optional); DC Jack (12V@5A); Jetson Xavier NX; EXT.POWER SOURCE; POWER DC DC; POWER LDO; BASEBOARD CIRCUIT; DNP (user option); Map Legend:; Power Topology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

Overvoltage protection
Soft start circuit +

POE HV(1x4 HDR)

reComputer J202 03 Power Tree

# UART, I2C, CAN and GPIOs

ID_I2C_SCL | [19] UART0_TXD | [17] UART0_RXD | [17] UART0_RTS | [17] UART0_CTS | [17] UART1_TXD | [19] UART1_RXD | [19] UART1_RTS | [19] UART1_CTS | [19] UART2_TXD | [20] UART2_RXD | [20] MOD_SLEEP* | [13,20] POWER_EN | [9,14] SHUTDOWN_REQ* | [7,9] SYS_RST* | [9,20] FORCE_RECOVERY* | [20]

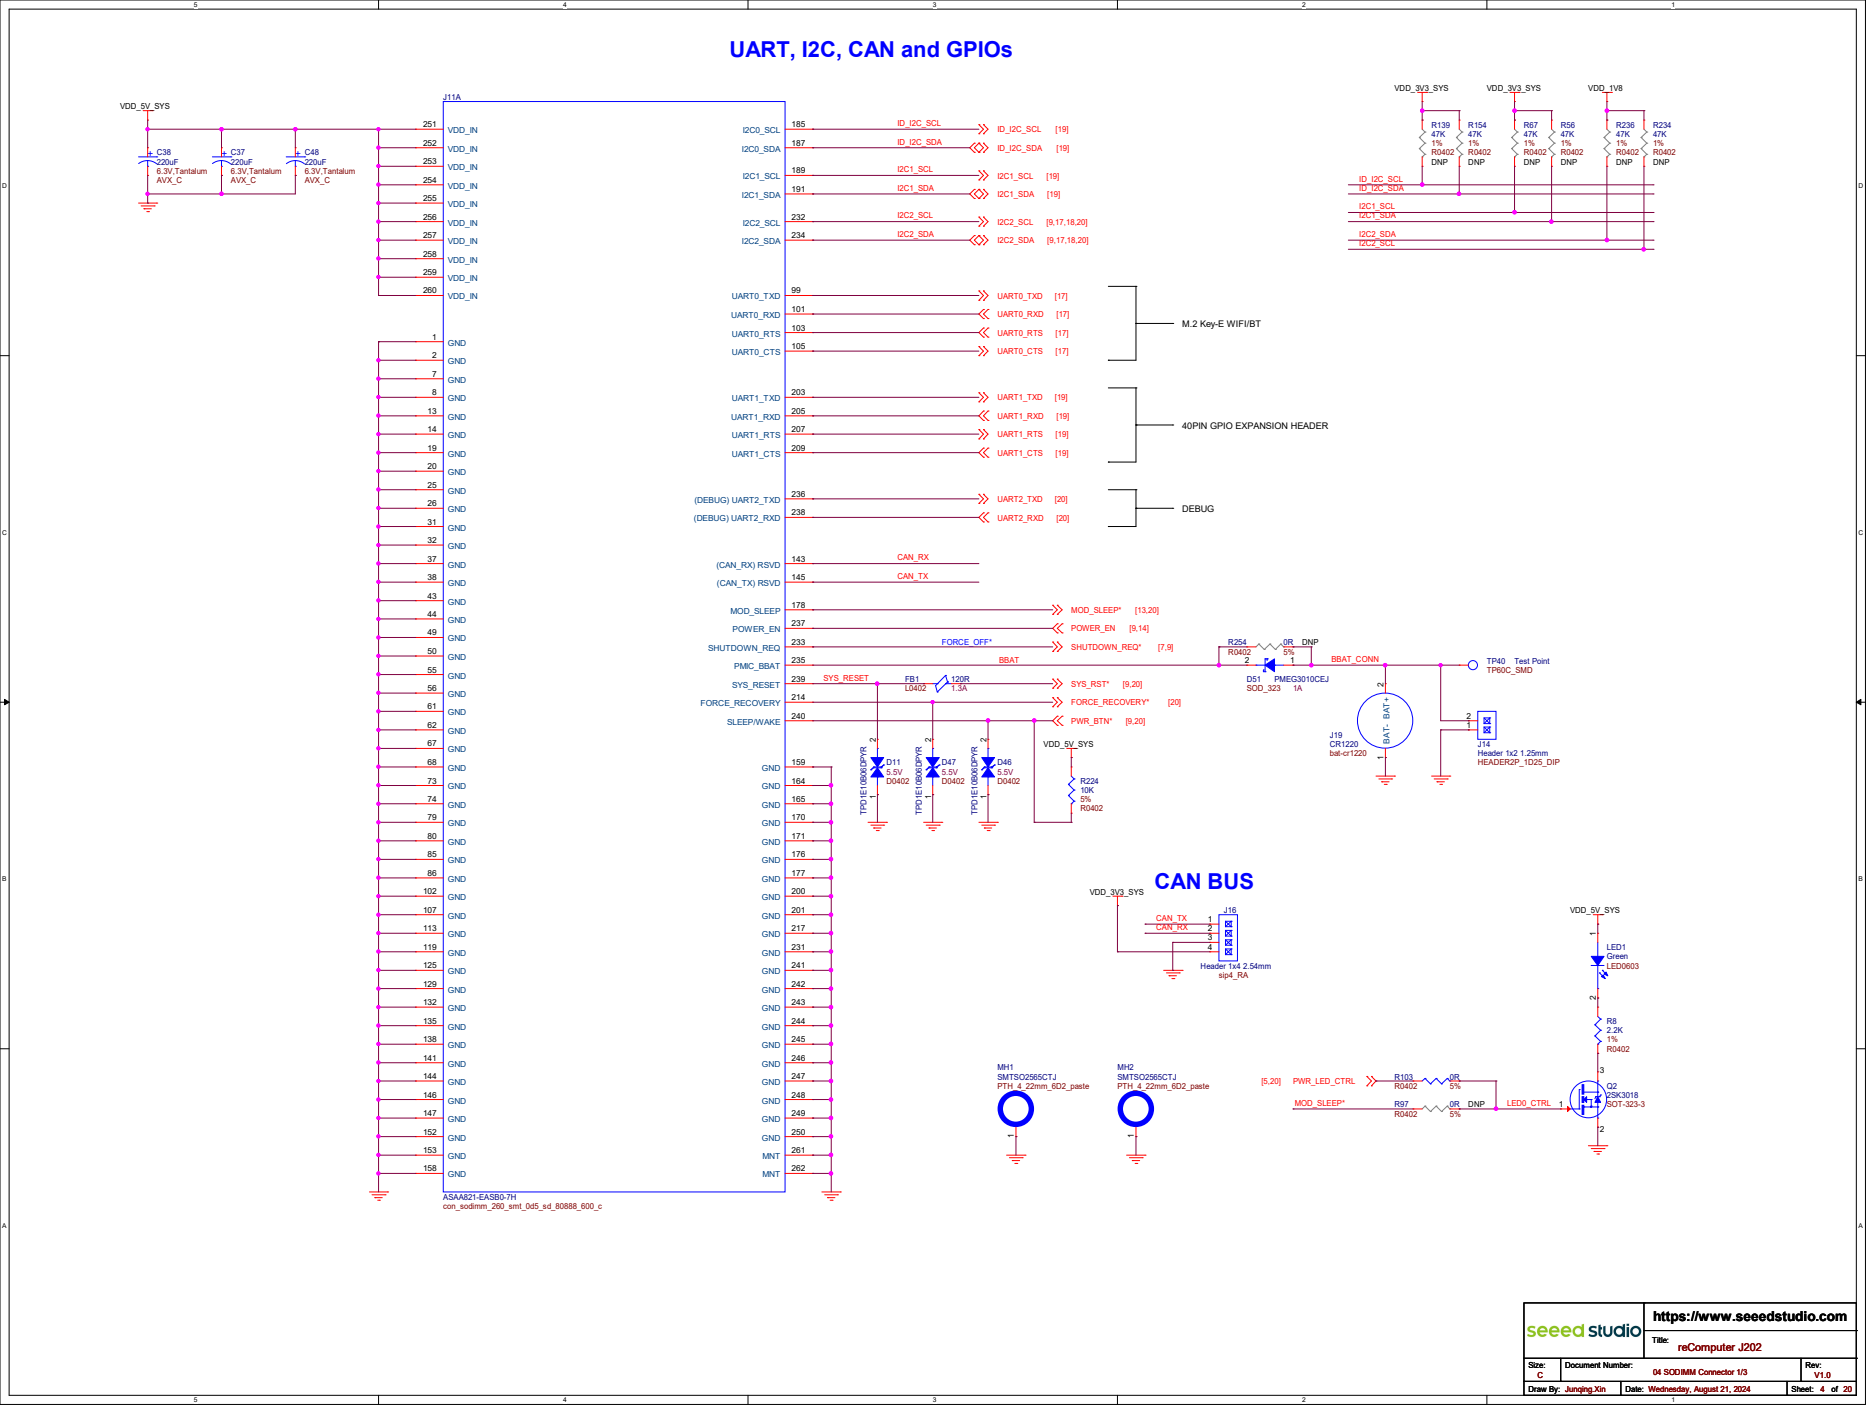
[picture p107: page 4]

VDD_IN 251 VDD_IN 252 VDD_IN 253 VDD_IN 254 VDD_IN 255 VDD_IN 256 VDD_IN 257 VDD_IN 258 VDD_IN 259 VDD_IN 260 GND 1 GND 2 GND 7 GND 8 GND 13 GND 14 GND 19 GND 20 GND 25 GND 26 GND 31 GND 32 GND 37 GND 38 GND 43 GND 44 GND 49 GND 50 GND 55 GND 56 GND 61 GND 62 GND 67 GND 68 GND 73 GND 74 GND 79 GND 80 GND 85 GND 86 GND 102 GND 107 GND 113 GND 119 GND 125 GND 129 GND 132 GND 135 GND 138 GND 141 GND 144 GND 146 GND 147 GND 152 GND 153 GND 158

# GPIOs, USB2.0, I2S, SPI, GBe and CSI

CSI0_D0_P 6 CSI0_D0_N 4 CSI0_D1_P 18 CSI0_D1_N 16 CSI0_CLK_P 12 CSI0_CLK_N 10 CSI1_D0_P 5 CSI1_D0_N 3 CSI1_D1_P 17 CSI1_D1_N 15

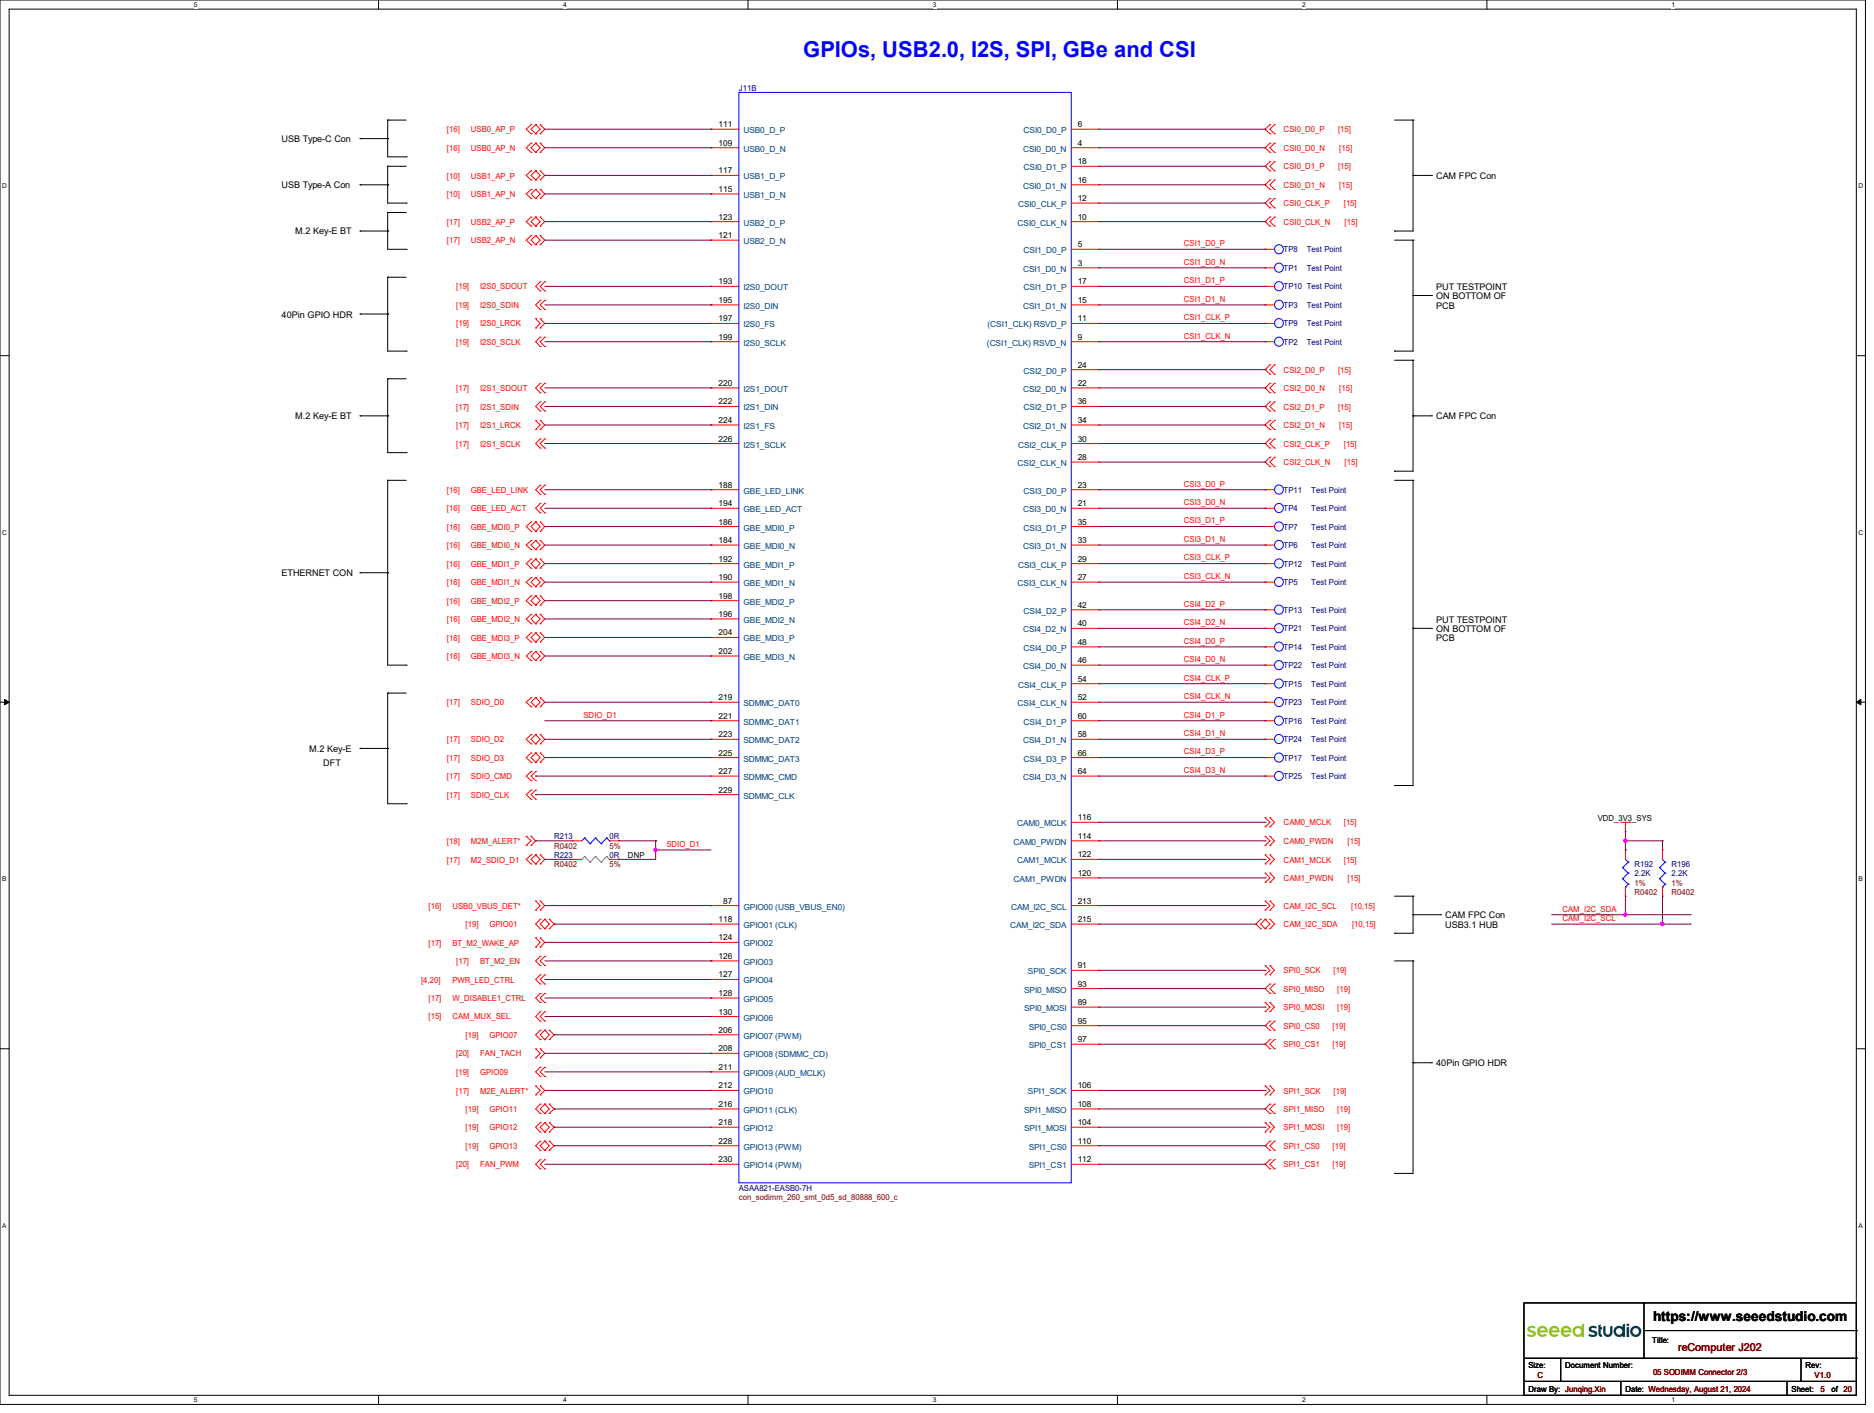
[picture p108: page 5]

[17] USB2_AP_N
I2S1_SCLK 226 GBE_LED_LINK 188 GBE_LED_ACT 194 GBE_MDI0_P 186 GBE_MDI0_N 184 GBE_MDI1_P 192 GBE_MDI1_N 190 GBE_MDI2_P 198 GBE_MDI2_N 196 GBE_MDI3_P 204 GBE_MDI3_N 202 SDMMC_DAT0 219 SDMMC_DAT1 221 SDMMC_DAT2 223 SDMMC_DAT3 225 SDMMC_CMD 227 SDMMC_CLK 229 GPIO00 (USB_VBUS_EN0) 87 GPIO01 (CLK) 118 GPIO02 124 GPIO03 126 GPIO04 127 GPIO05 128 GPIO06 130 GPIO07 (PWM) 206 GPIO08 (SDMMC_CD) 208 GPIO09 (AUD_MCLK) 211 GPIO10 212 GPIO11 (CLK) 216 GPIO12 218 GPIO13 (PWM) 228 GPIO14 (PWM) 230

CAM FPC Con
TP12 Test Point TP23 Test Point

# HDMI, DP, DSI, USBSS and PCIe

PCIE_WAKE | [17,18] PCIE0_RST | [18] PCIE0_CLKREQ | [18] PCIE0_CLK_P | [18] PCIE0_CLK_N | [18] PCIE0_TX0_P | [18] PCIE0_TX0_N | [18] PCIE0_RX0_P | [18] PCIE0_RX0_N | [18]

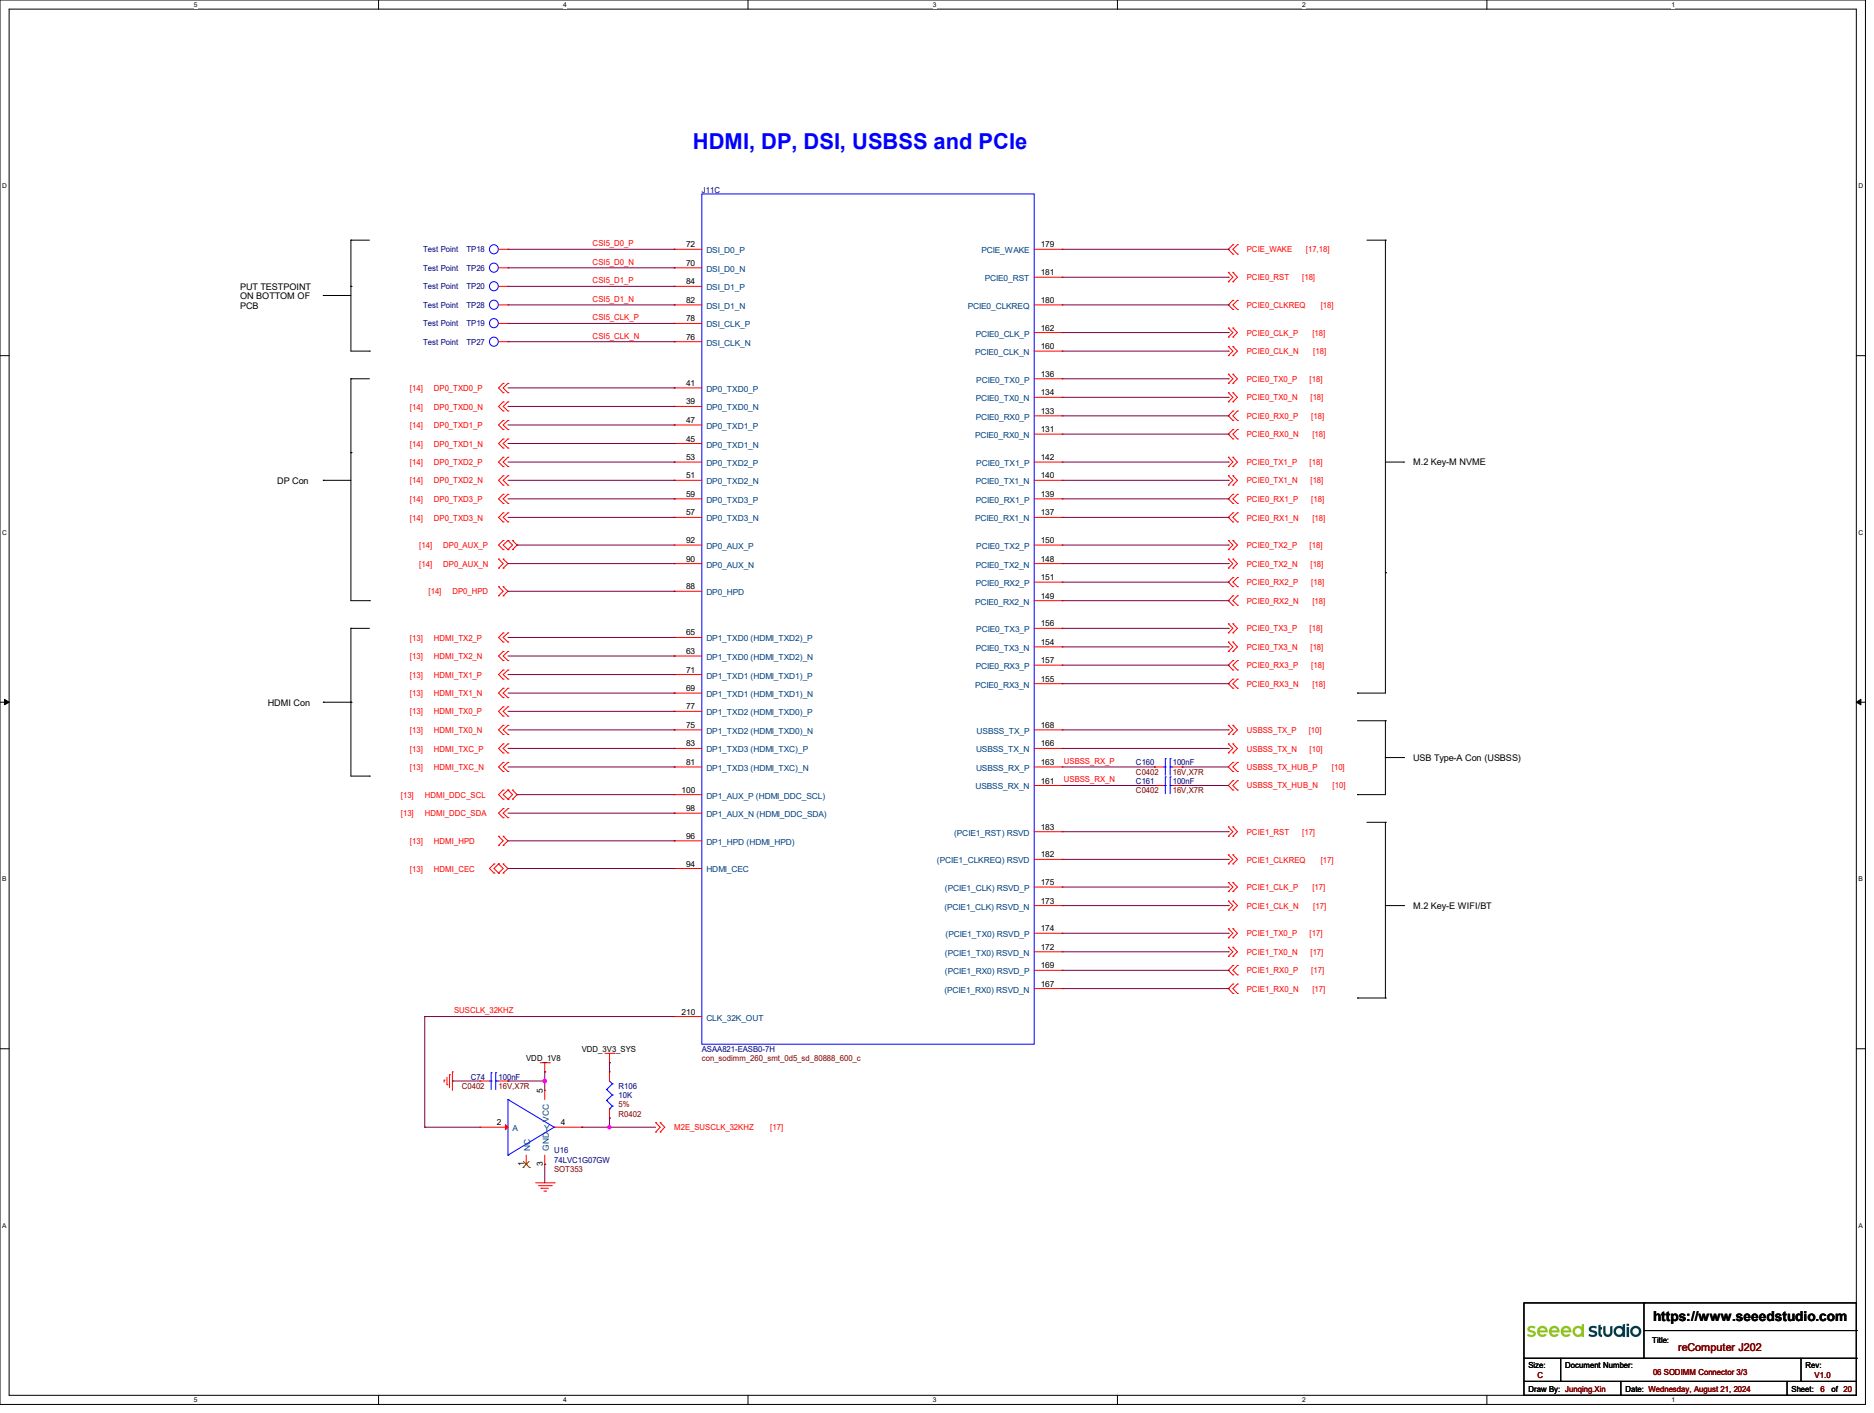
[picture p109: page 6]

Test Point TP18 Test Point TP26

USB Type-A Con (USBSS)

# U43 SOT23-5 DNP

R0805 C188

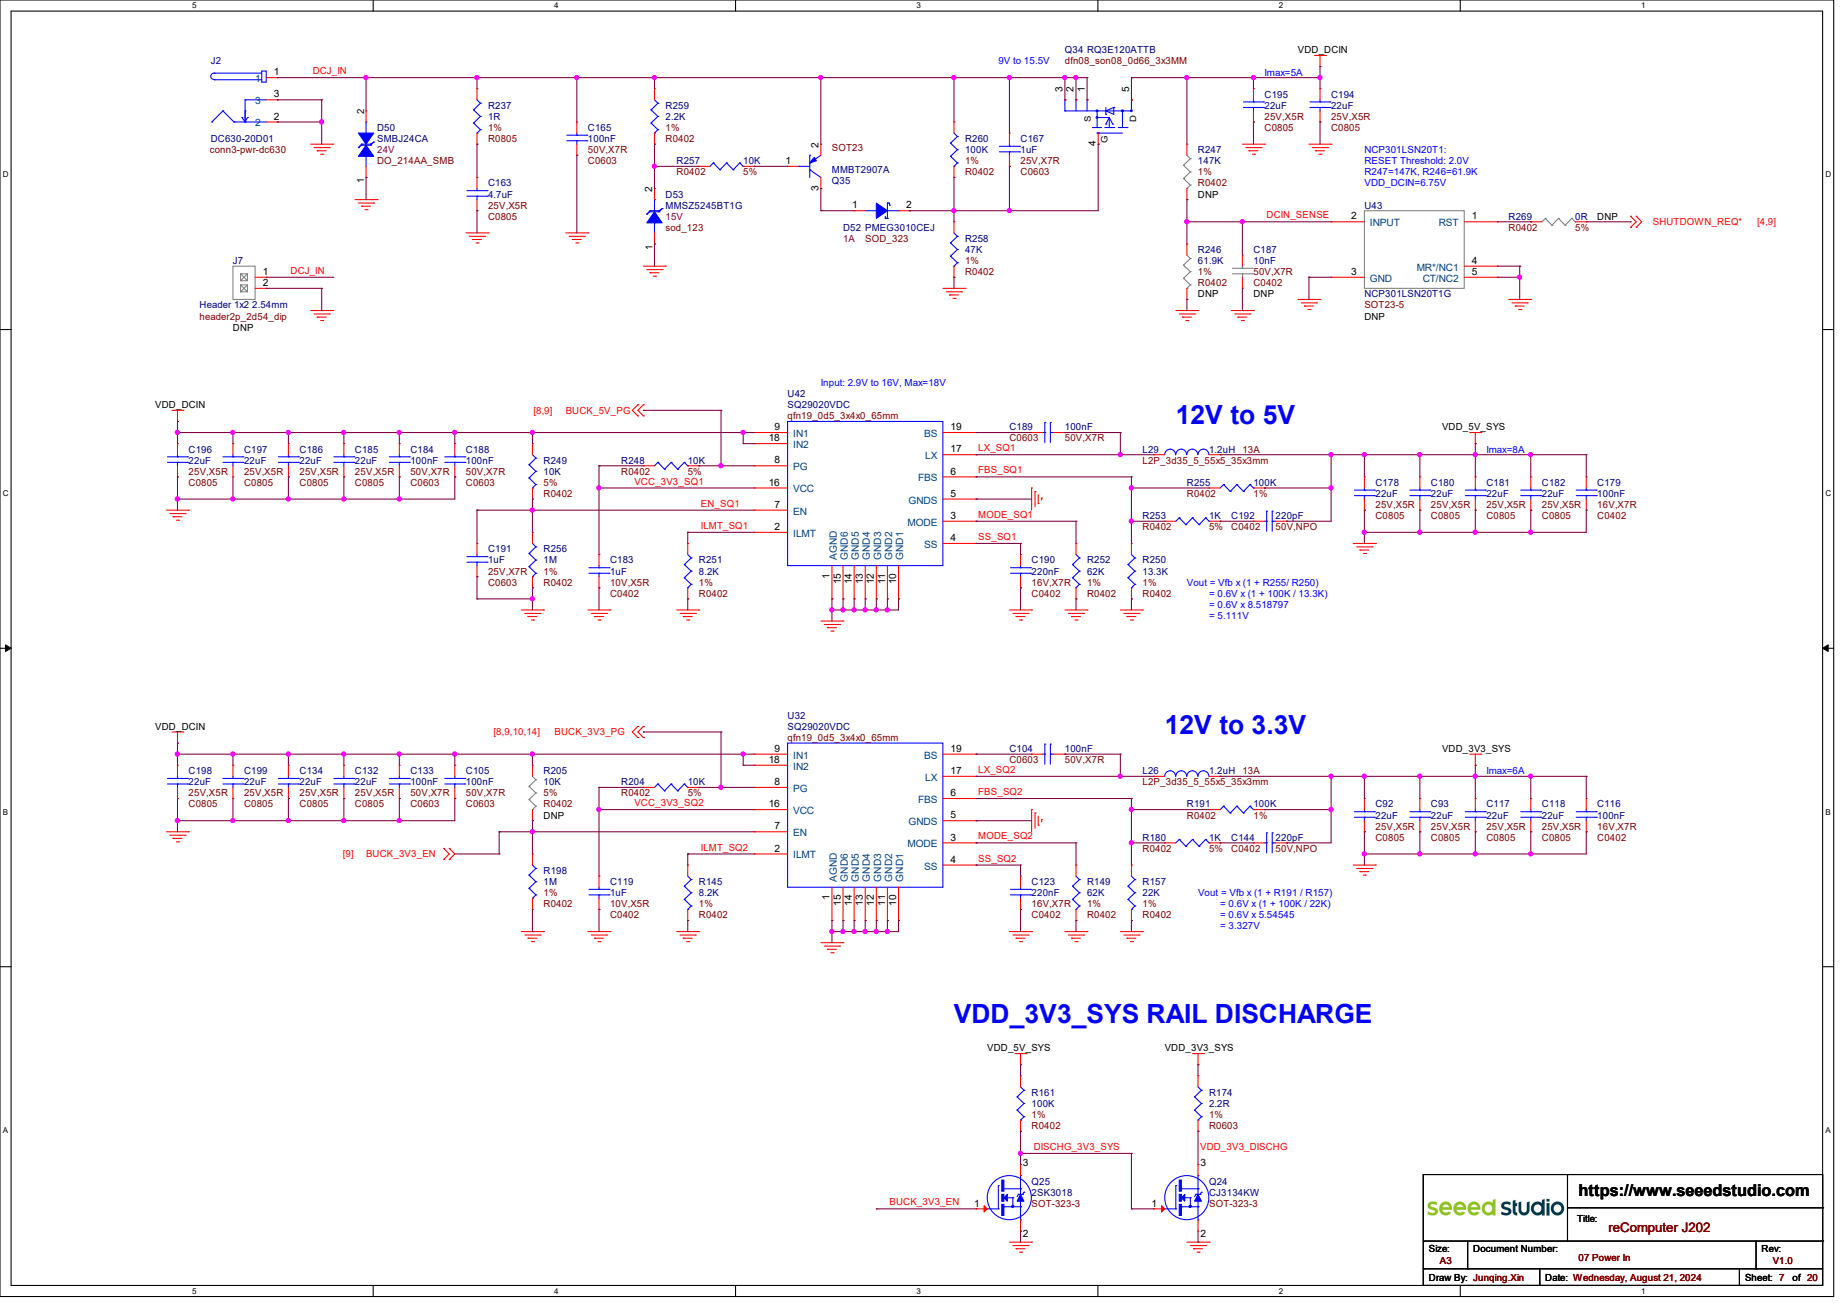
[picture p110: page 7]

# 3.3V to 1.8V

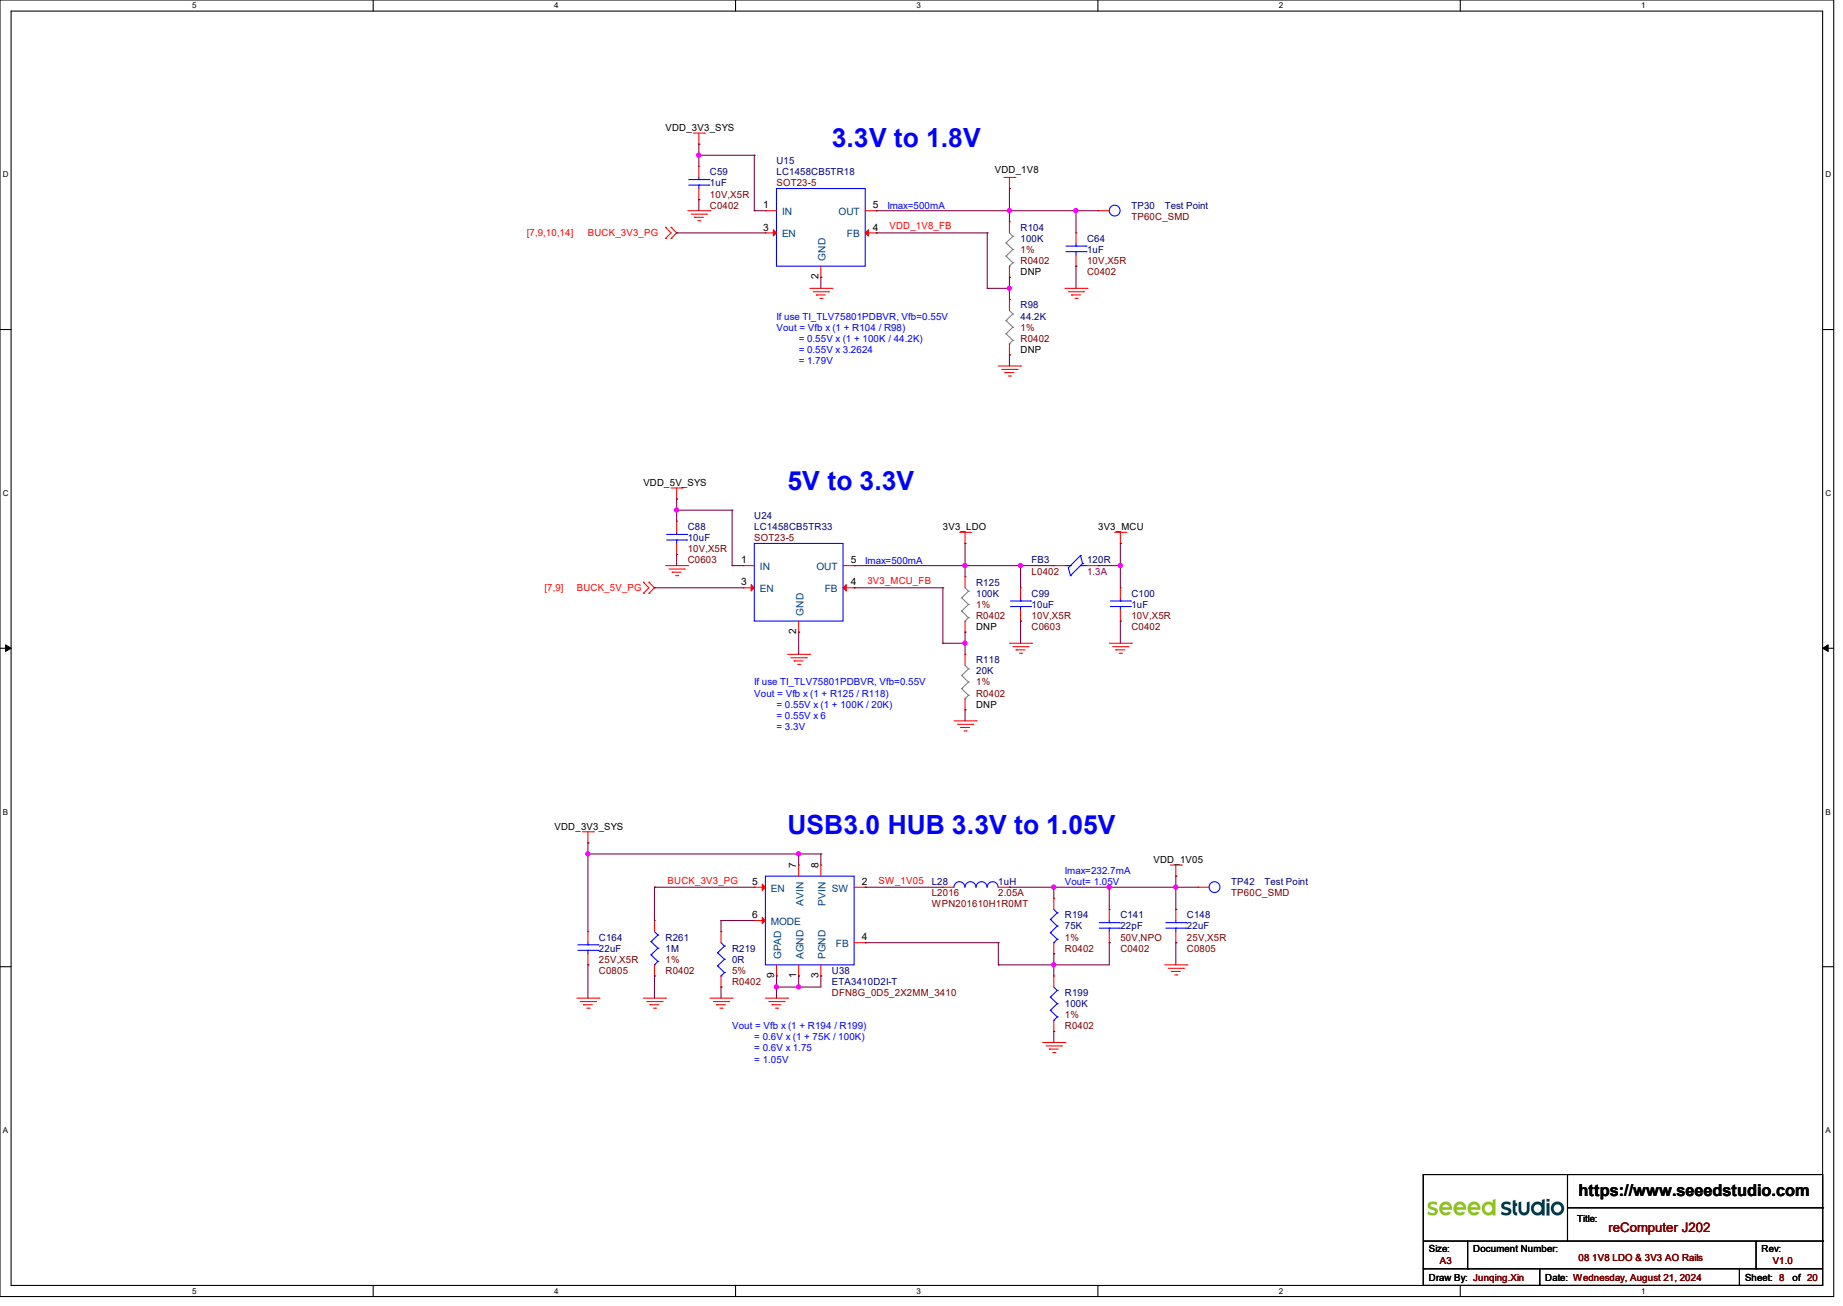
[picture p111: page 8]

reComputer J202 08 1V8 LDO & 3V3 AO Rails

# Button MCU For Power Up MCU

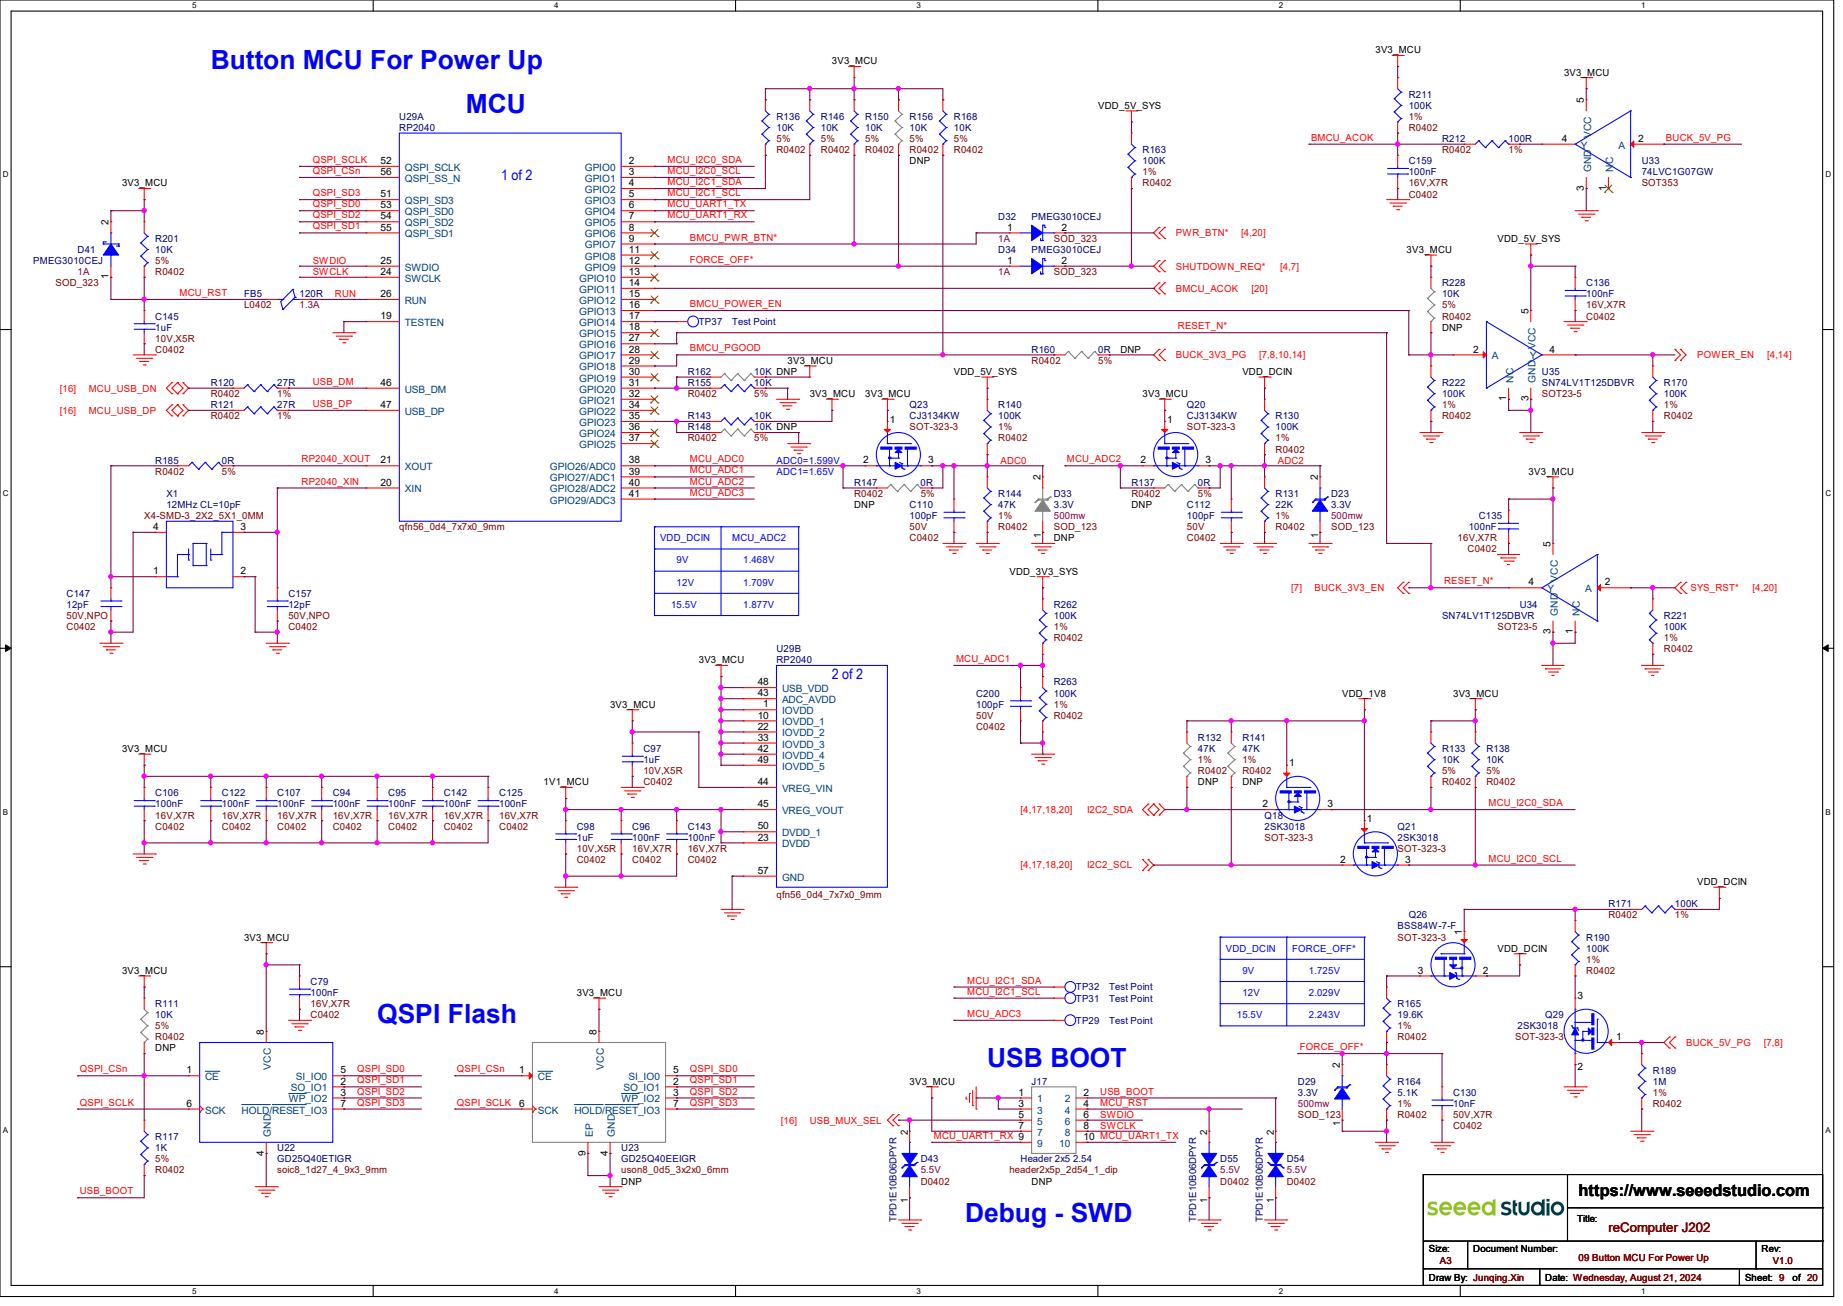
[picture p112: page 9]

GPIO0 2 GPIO1 3 GPIO2 4 GPIO3 5 GPIO4 6 GPIO5 7 GPIO6 8 GPIO7 9 GPIO8 11 GPIO9 12 GPIO10 13 GPIO11 14 GPIO12 15 GPIO13 16 GPIO14 17 GPIO15 18 GPIO16 27 GPIO17 28 GPIO18 29 GPIO19 30 GPIO20 31 GPIO21 32 GPIO22 34 GPIO23 35 GPIO24 36 GPIO25 37 GPIO26/ADC0 38 GPIO27/ADC1 39 GPIO28/ADC2 40 GPIO29/ADC3 41 RUN 26 SWCLK 24 SWDIO 25 TESTEN 19 XIN 20 XOUT 21

VDD_DCIN

9V | 1.468V | VDD_3V3_SYS

VDD_DCIN 9V | FORCE_OFF* 15.5V 1.725V

reComputer J202 09 Button MCU For Power Up

# VCC33_4 62 GPIO5/EXTPWRON/WAKE 63 GPIO6 / USBSUS 64 GPIO7 / SMDAT 65 GPIO8 / SMCLK 66

VDD_3 67 RESET# 68 USBLED1 / SPISI 69 USBLED2 / SPICK 70 USBLED3 / SPISO 71 USBLED4 / SPICS 72

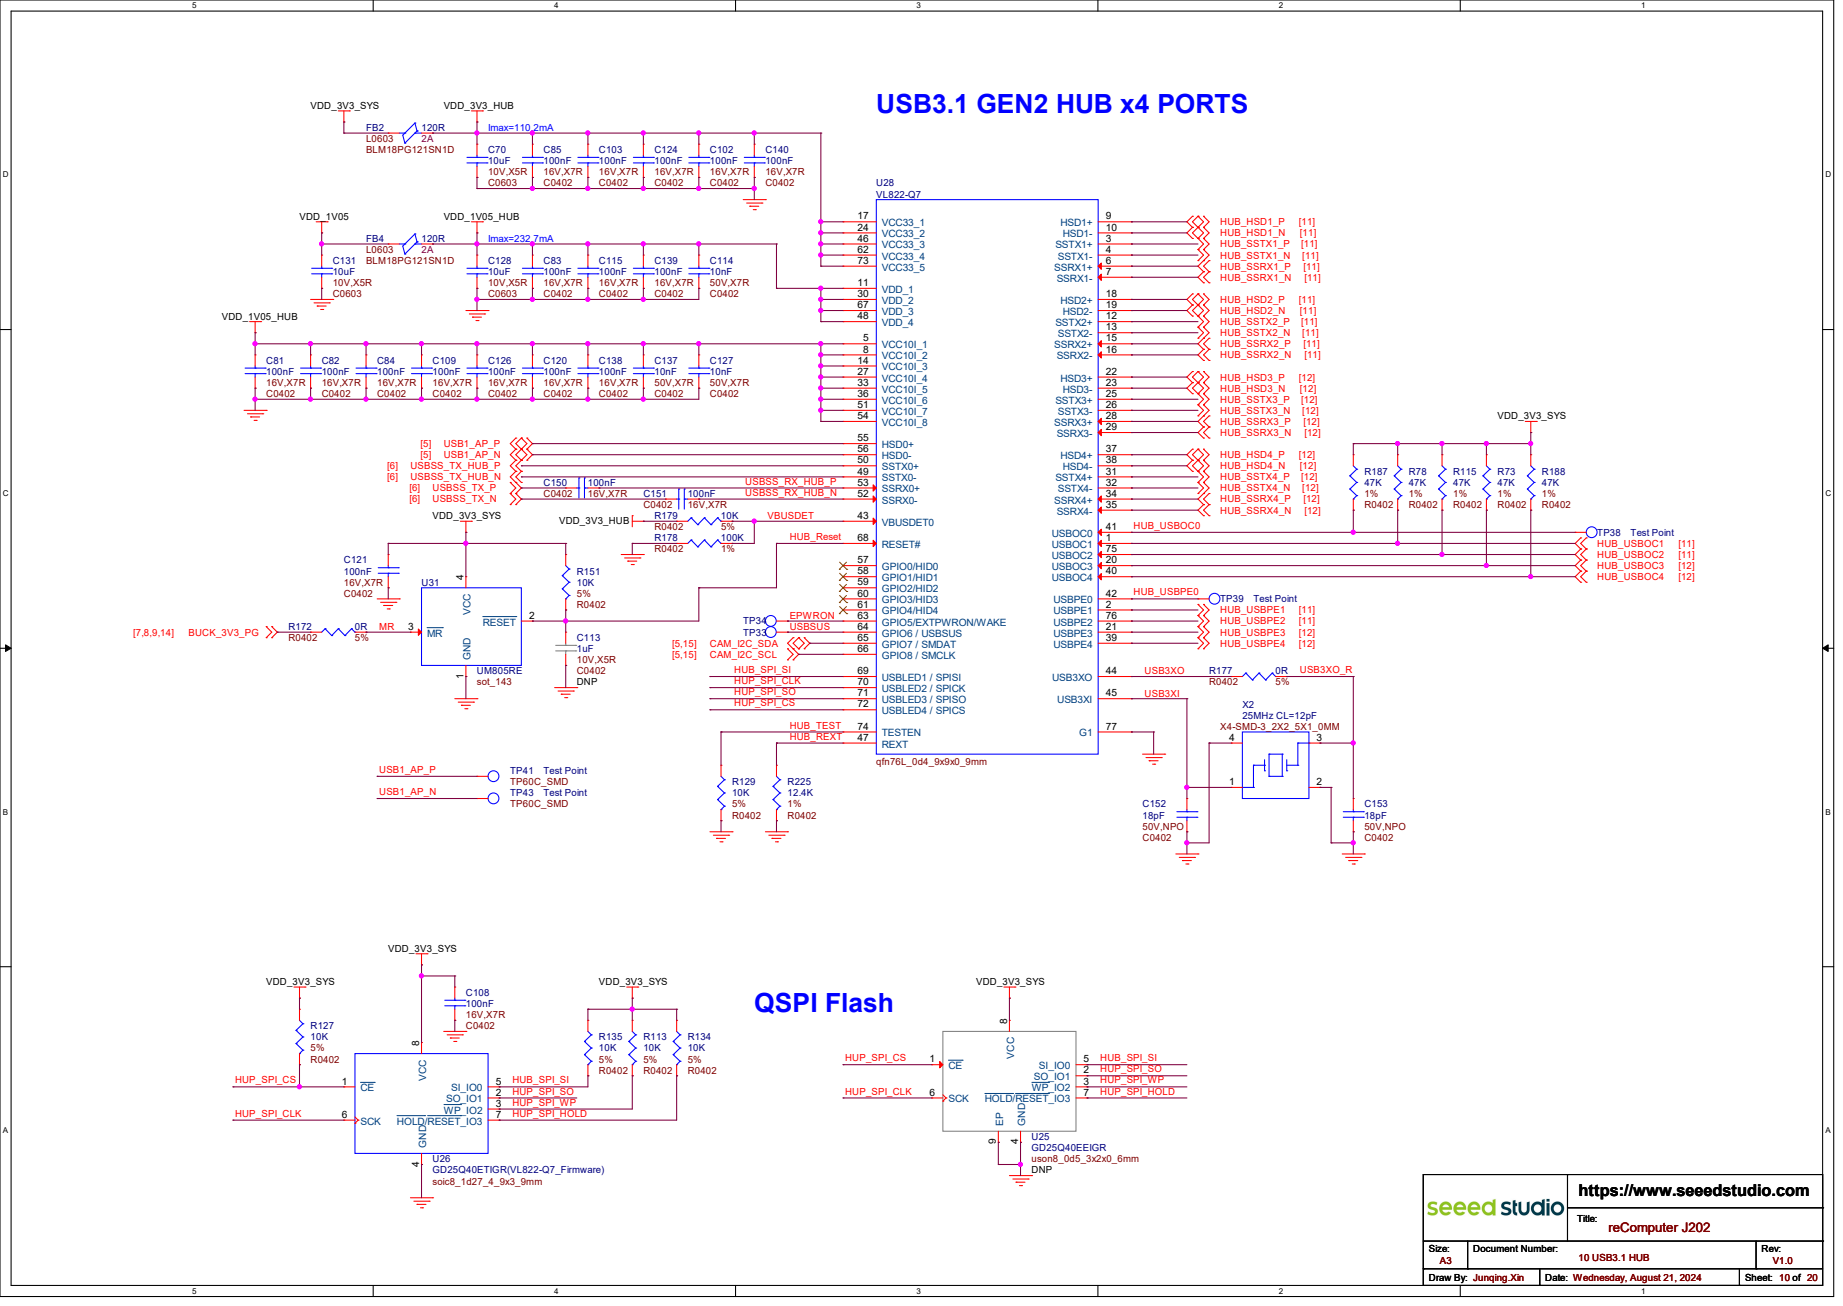
[picture p113: page 10]

# USB3.1 TYPE-A x2 (A)

# VDD_VBUS_A GND_SHD GND_SHD

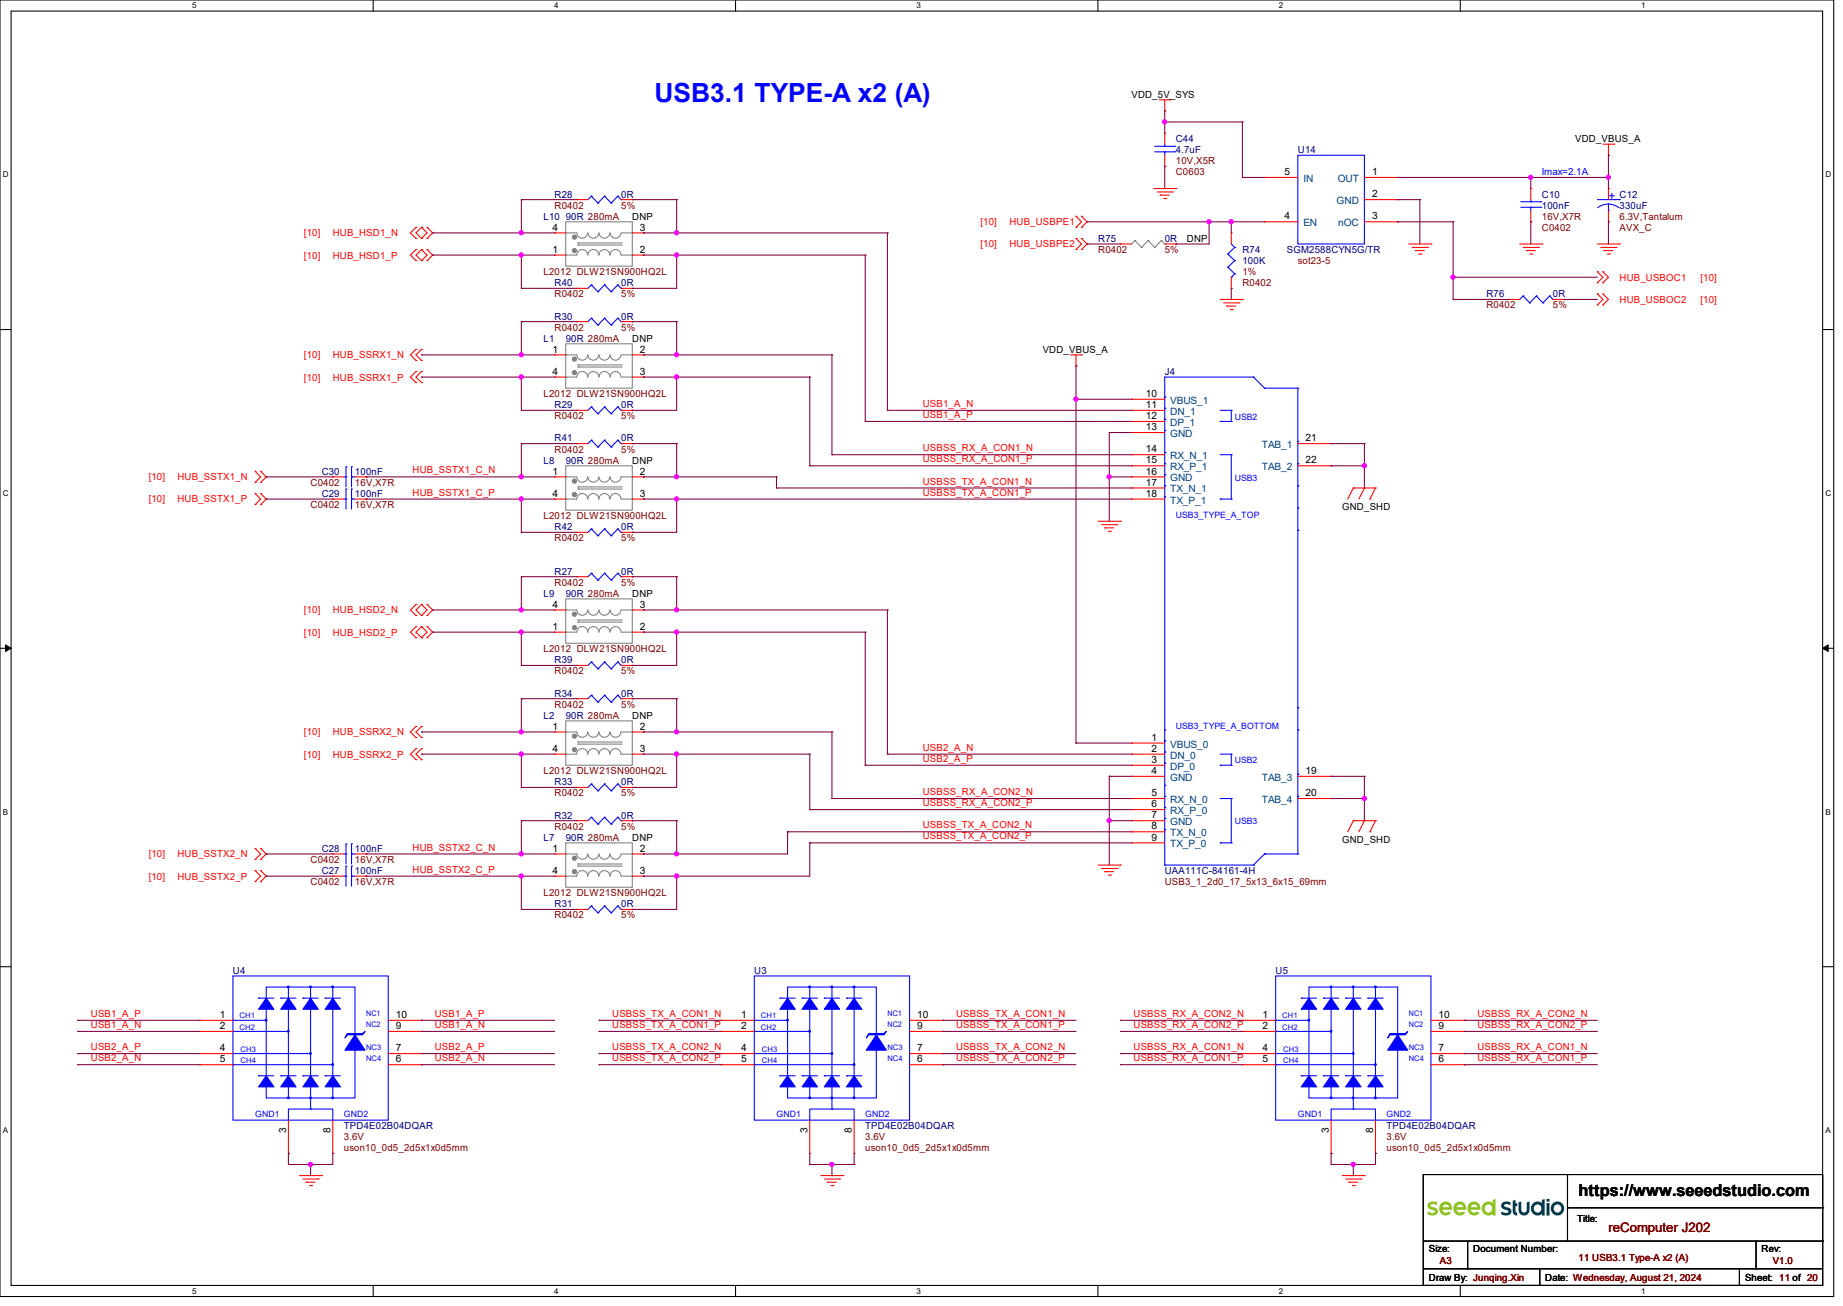
[picture p114: page 11]

# USB3.1 TYPE-A x2 (B)

# Imax=2.1A GND_SHD GND_SHD

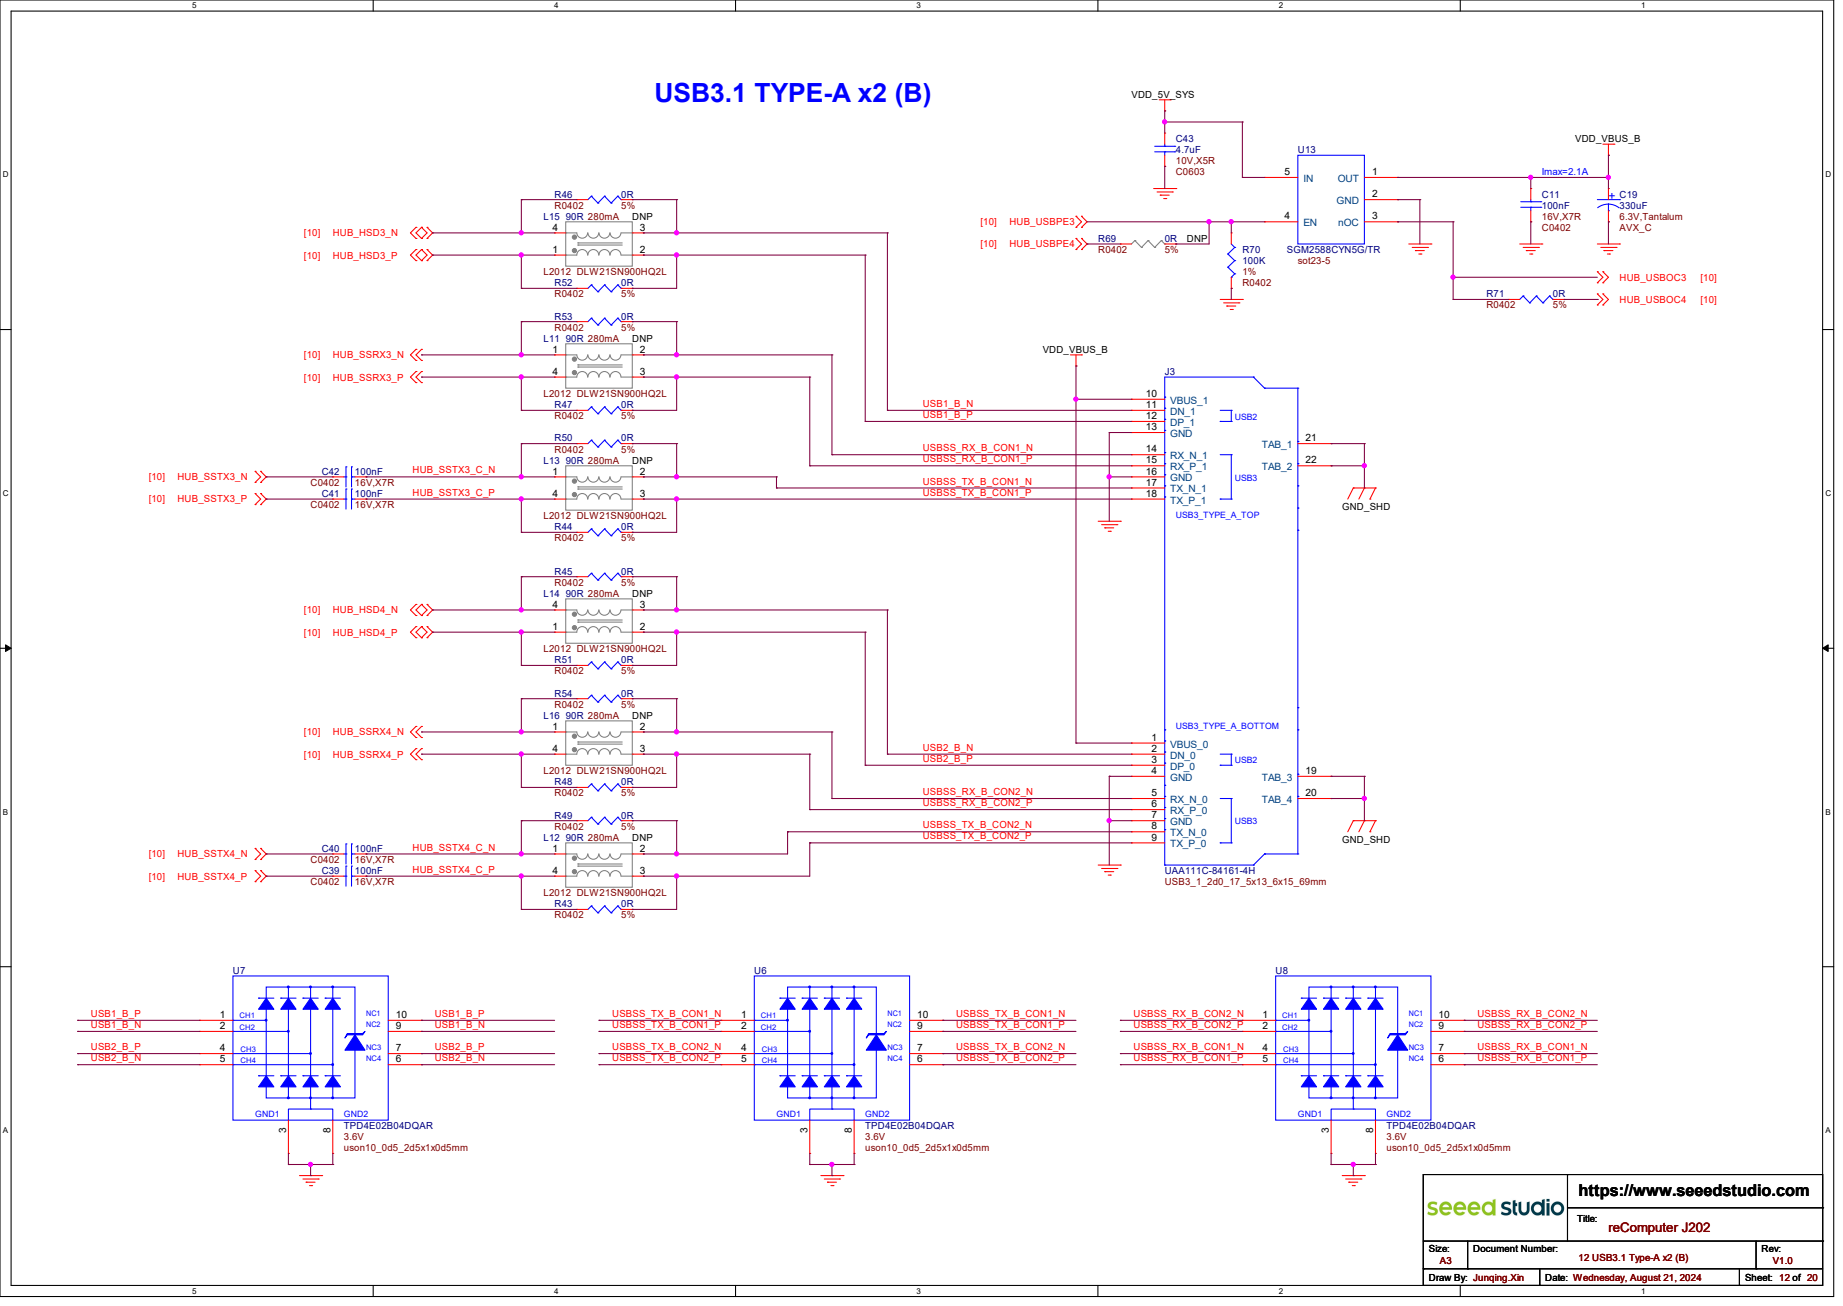
[picture p115: page 12]

# HDMI Connector

50V R122

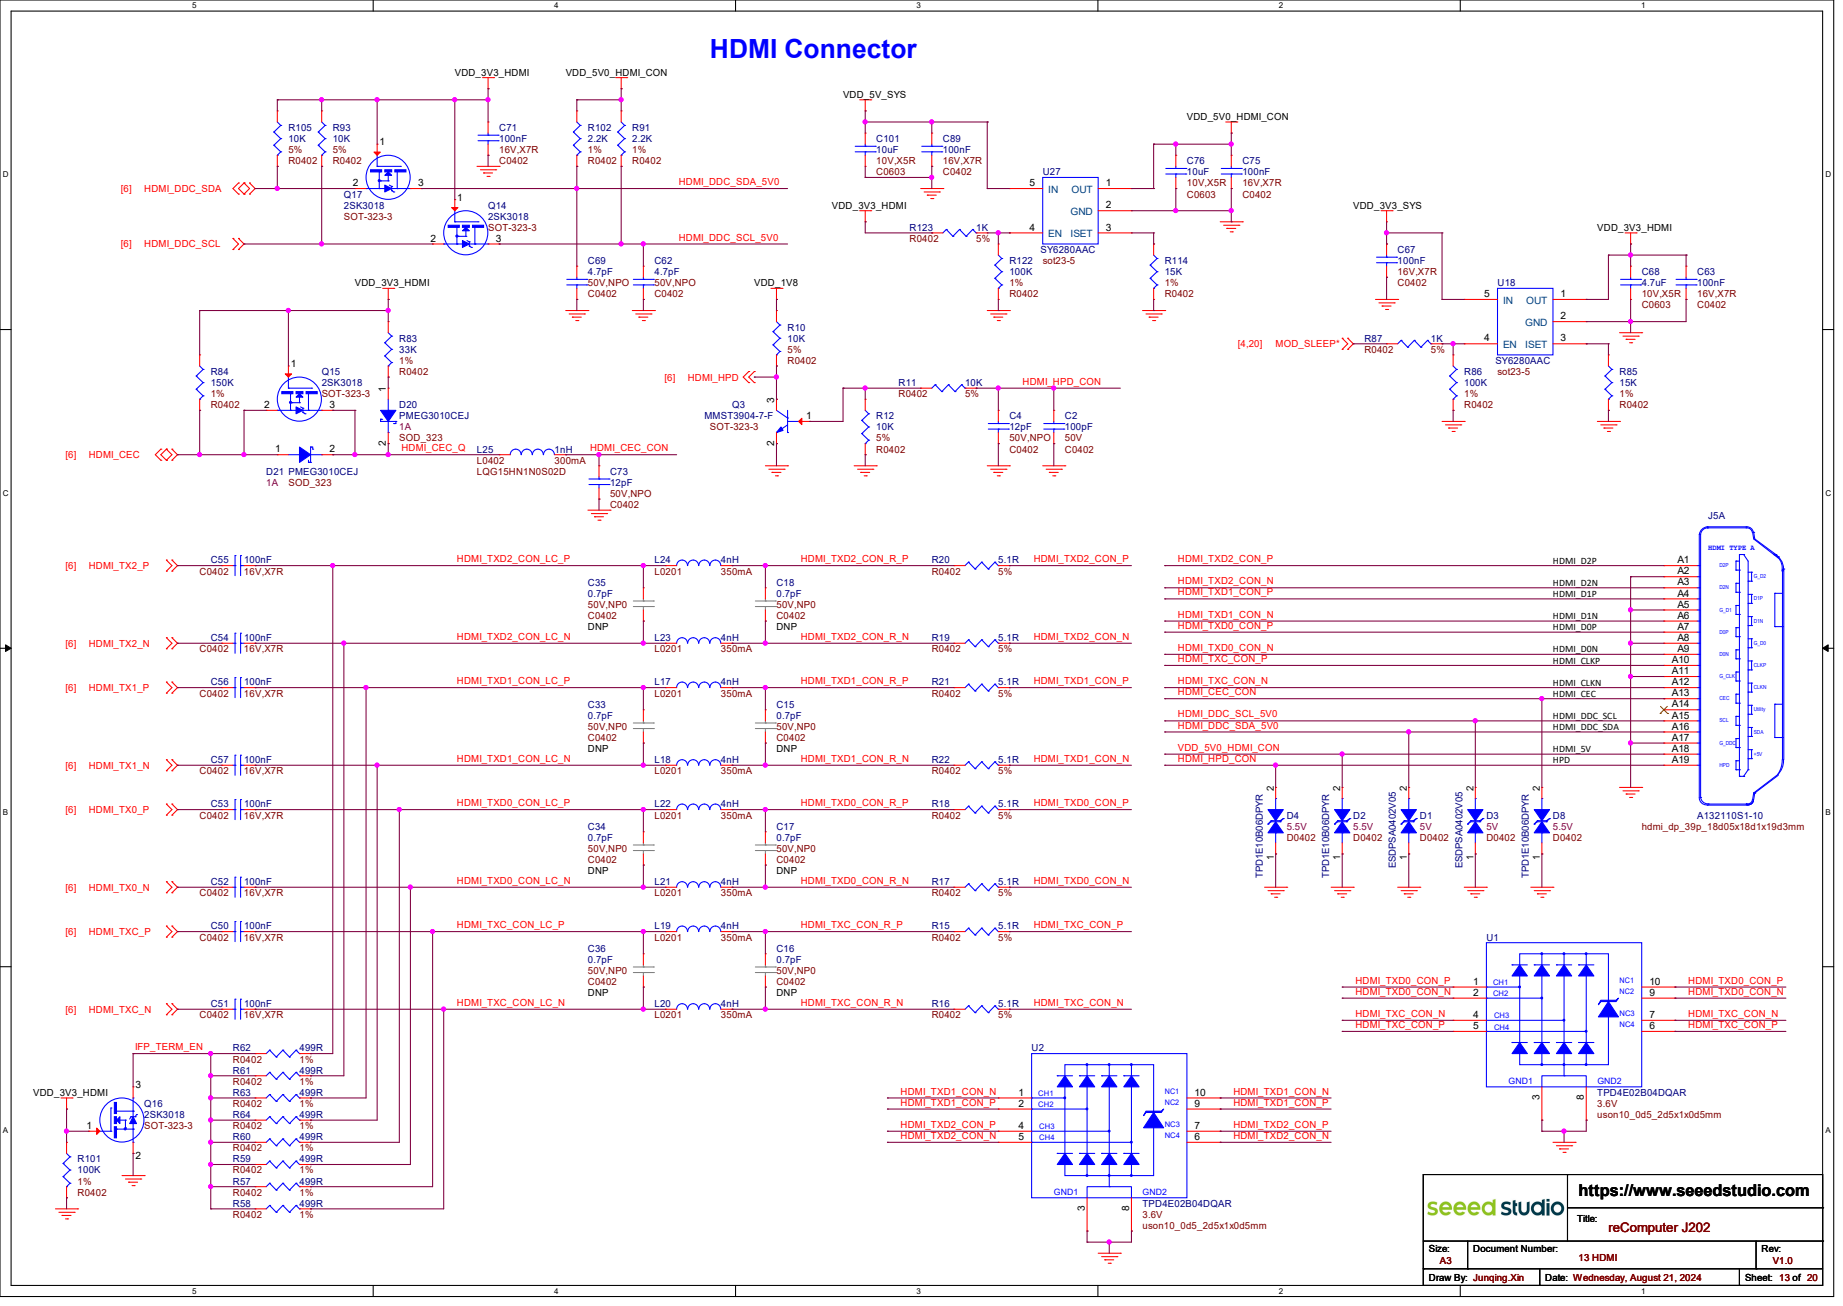
[picture p116: page 13]

# DisplayPort Connector

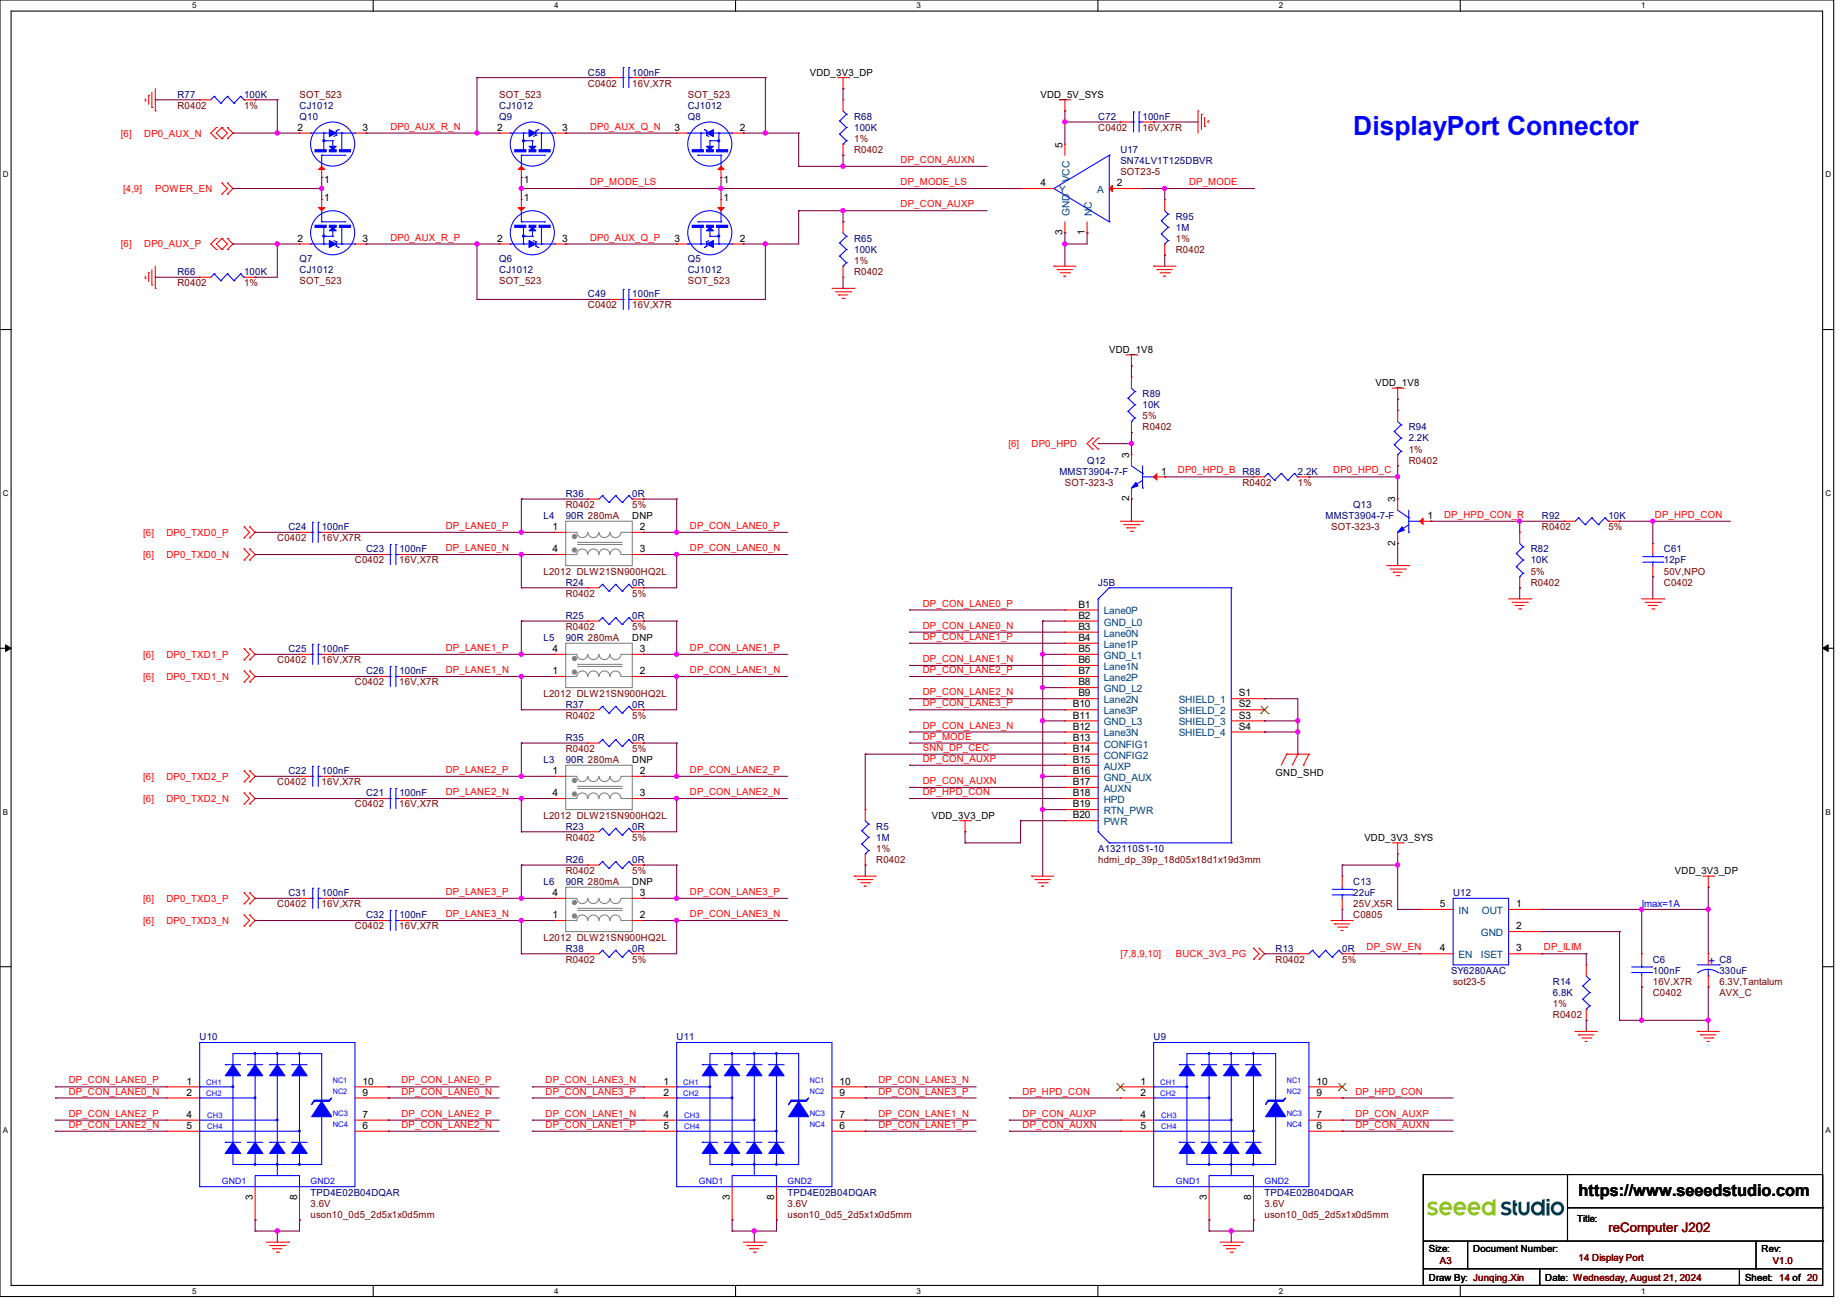
[picture p117: page 14]

# CSI CAM CONNECTOR

# J12 YL002-007

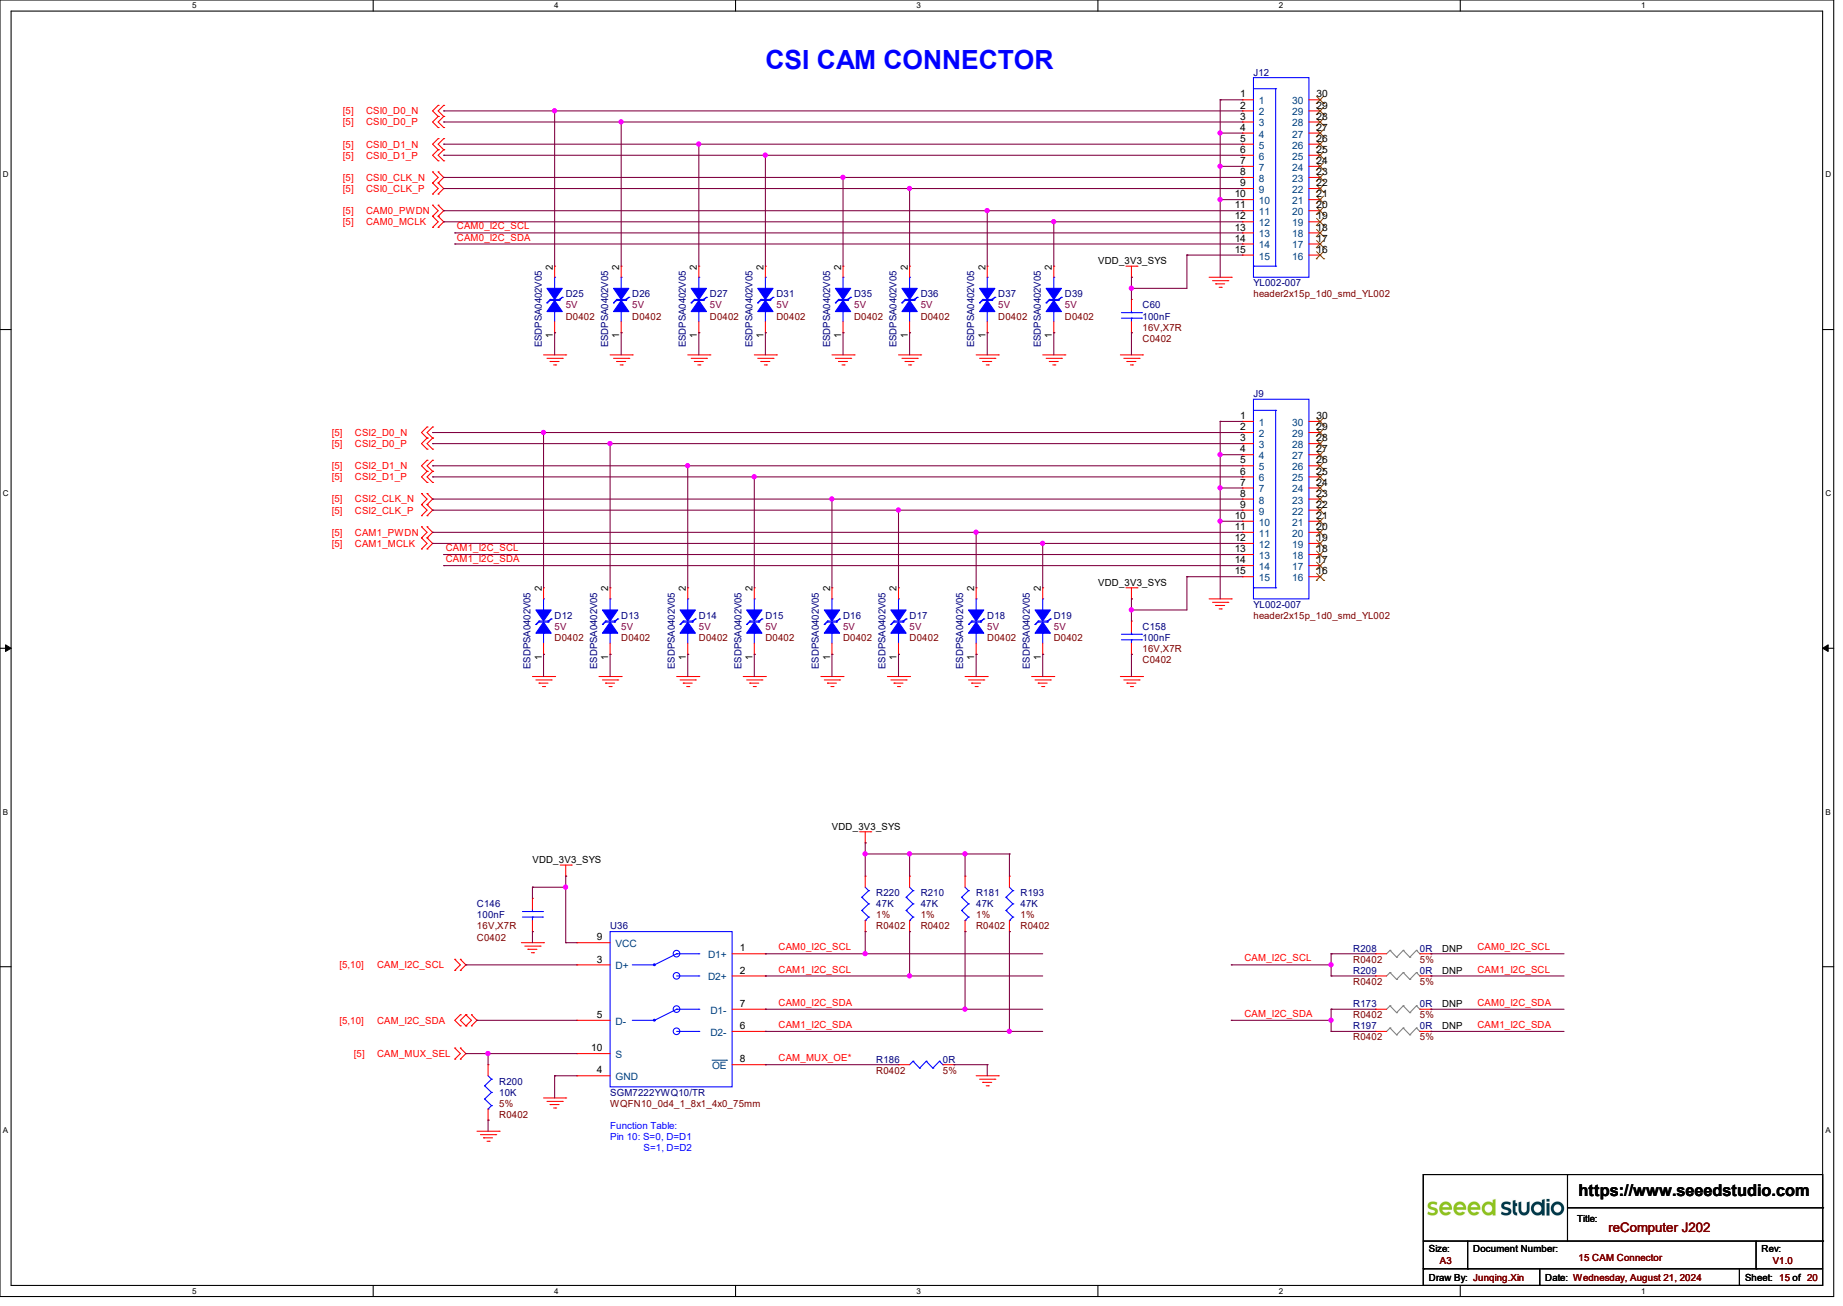
[picture p118: page 15]

# Gigabit Ethernet with PoE

SHIELD_1 19 | SHIELD_2 20 | MCT_1 4 | MCT_2 5

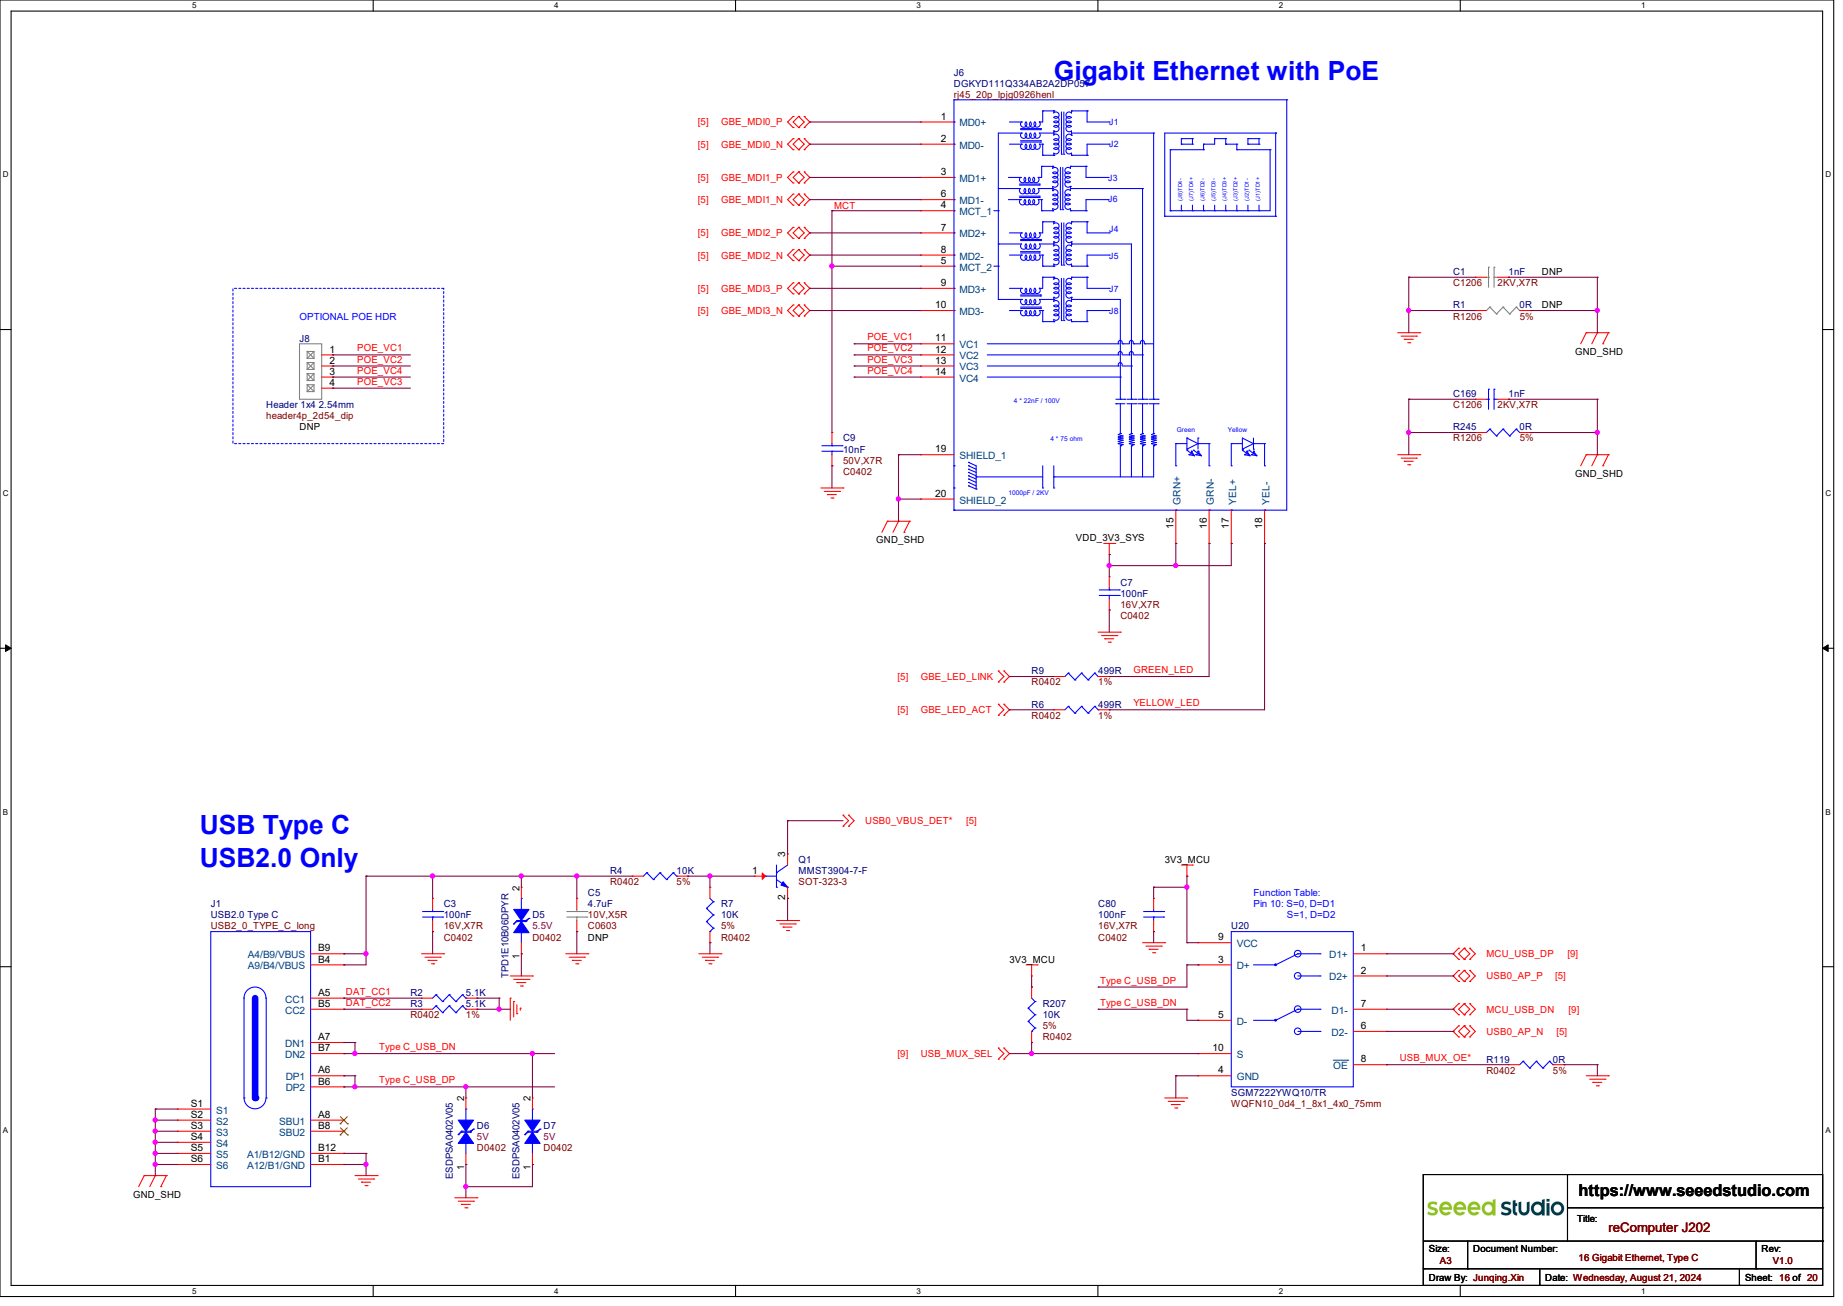
[picture p119: page 16]

reComputer J202 16 Gigabit Ethernet, Type C

# M.2 KEY-E (WIFI/BT)

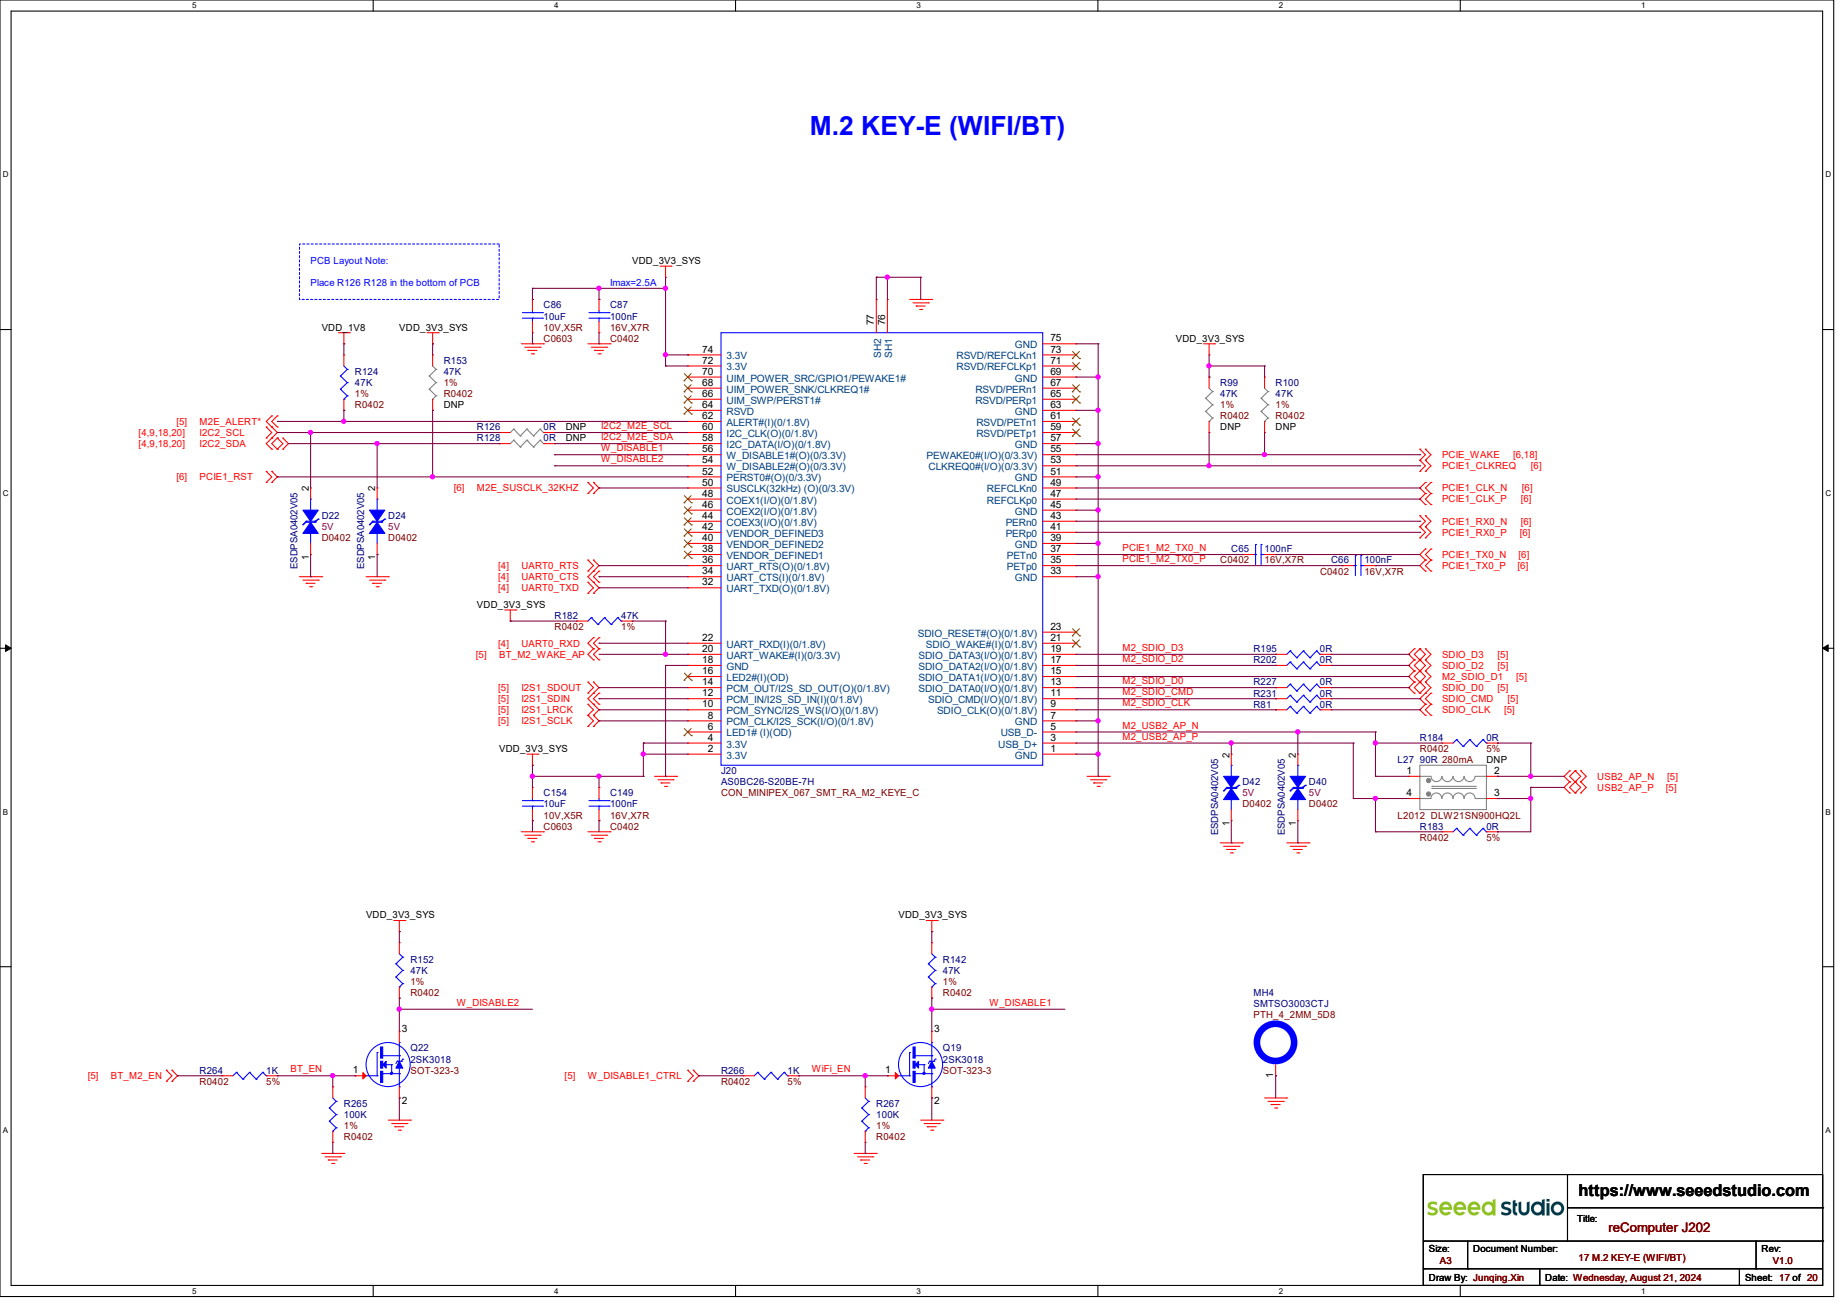
[picture p120: page 17]

Place R126 R128 in the bottom of PCB

reComputer J202 17 M.2 KEY-E (WIFI/BT)

# M.2 KEY-M (NVME)

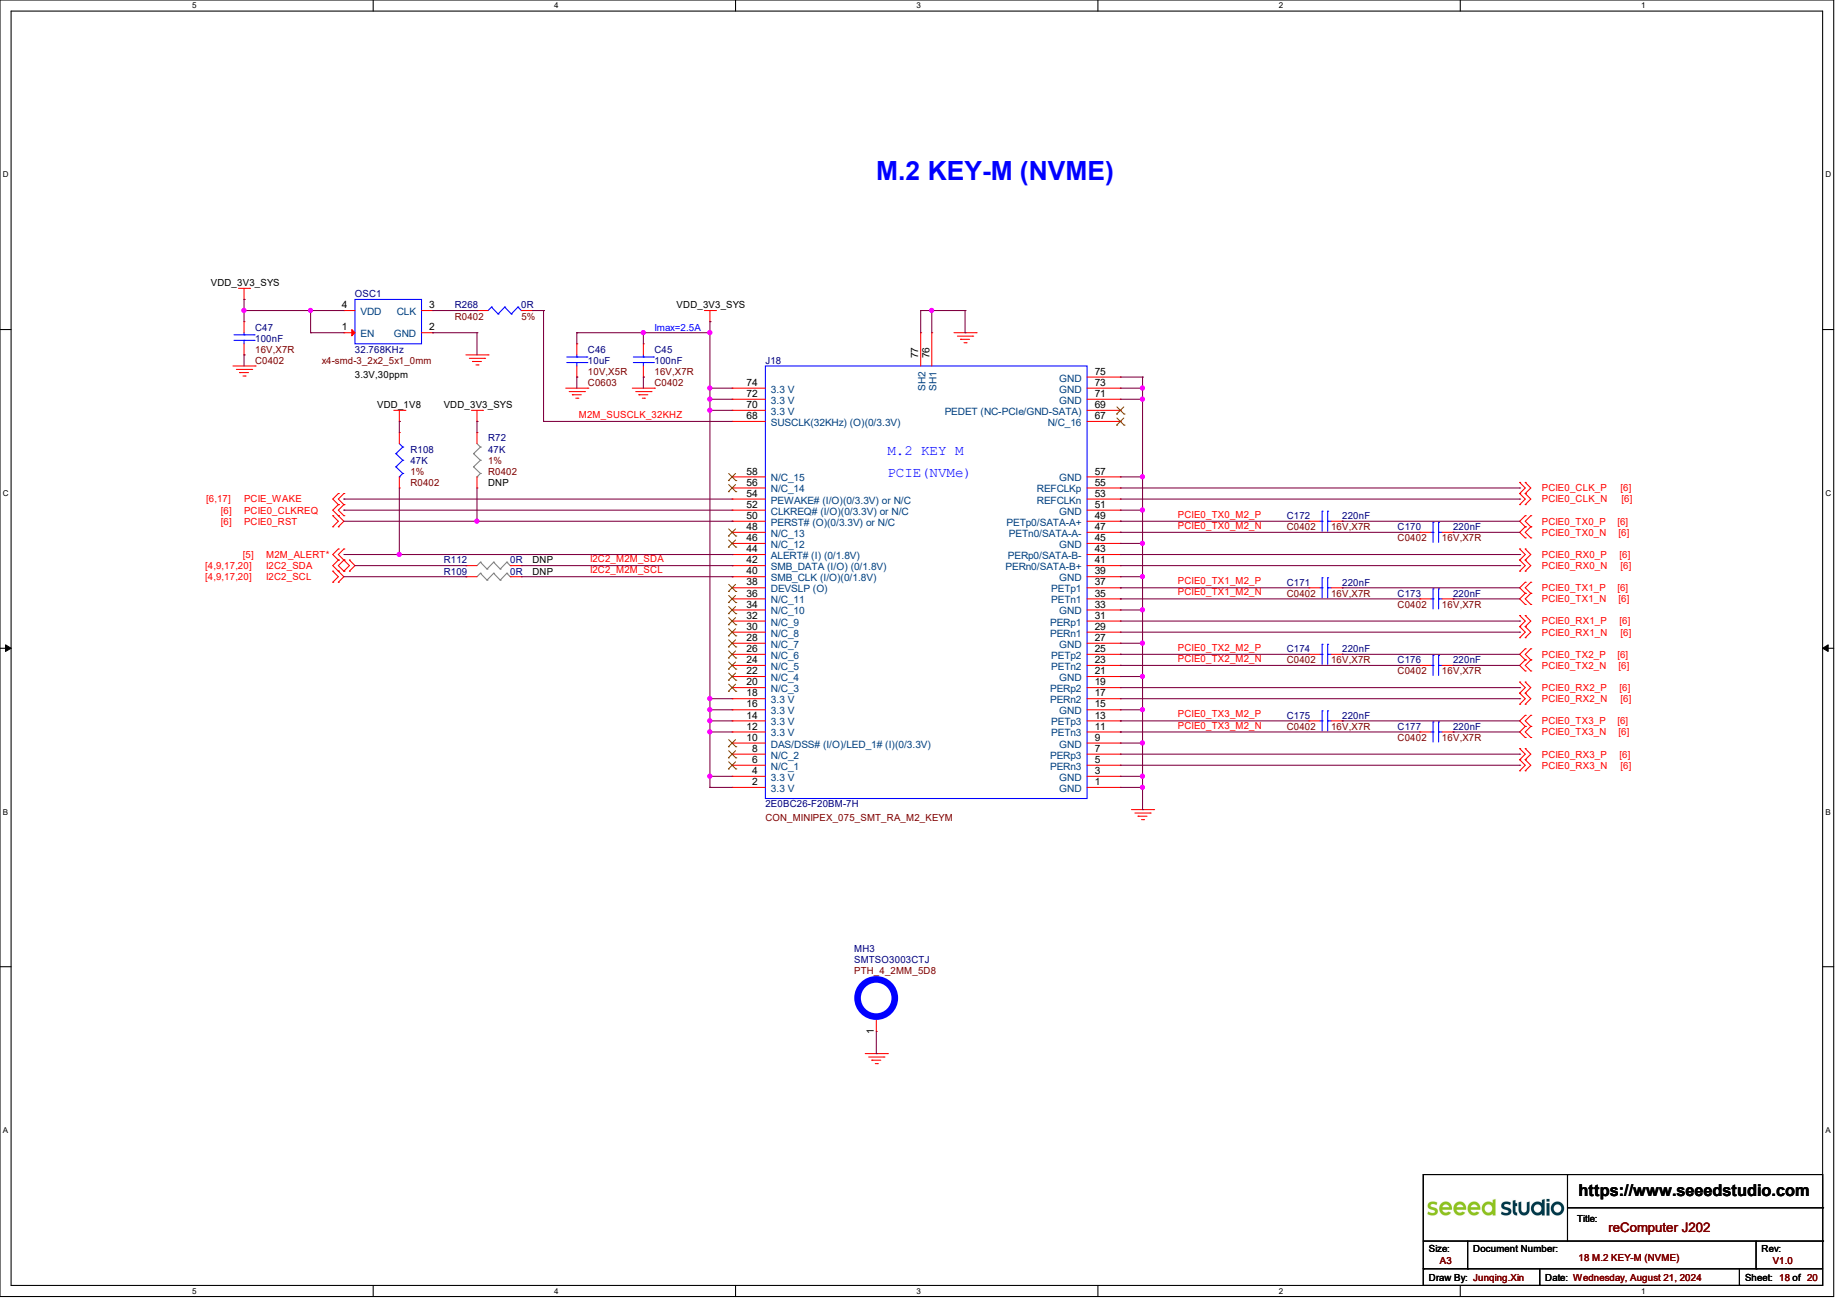
[picture p121: page 18]

# 40PIN GPIO EXPANSION HEADER & LEVEL SHIFTERS

# U19 TXB0108PWR

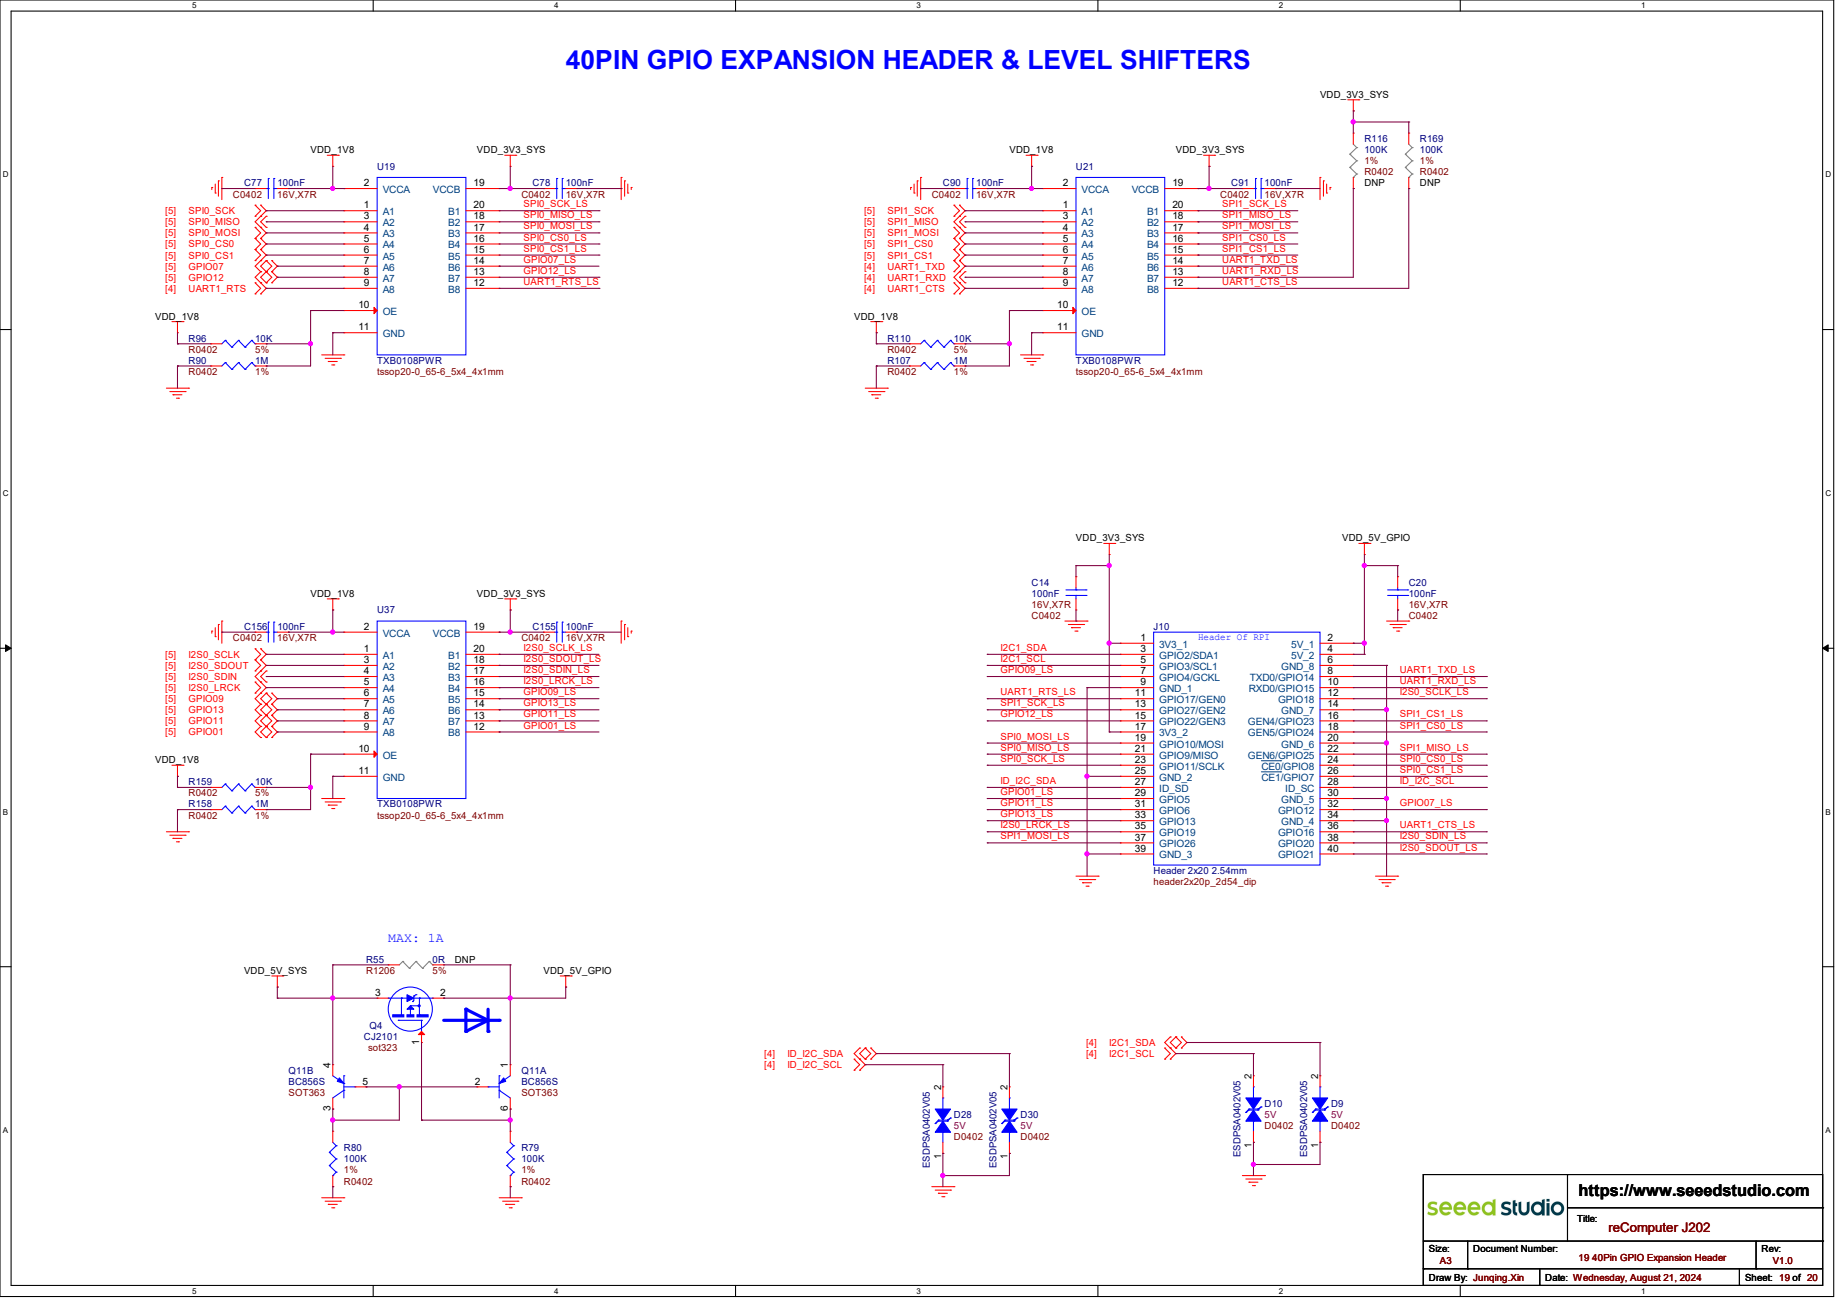
[picture p122: page 19]

reComputer J202 19 40Pin GPIO Expansion Header

SoC Fan Header 4pin | Carrier Board Config
R0402 R203

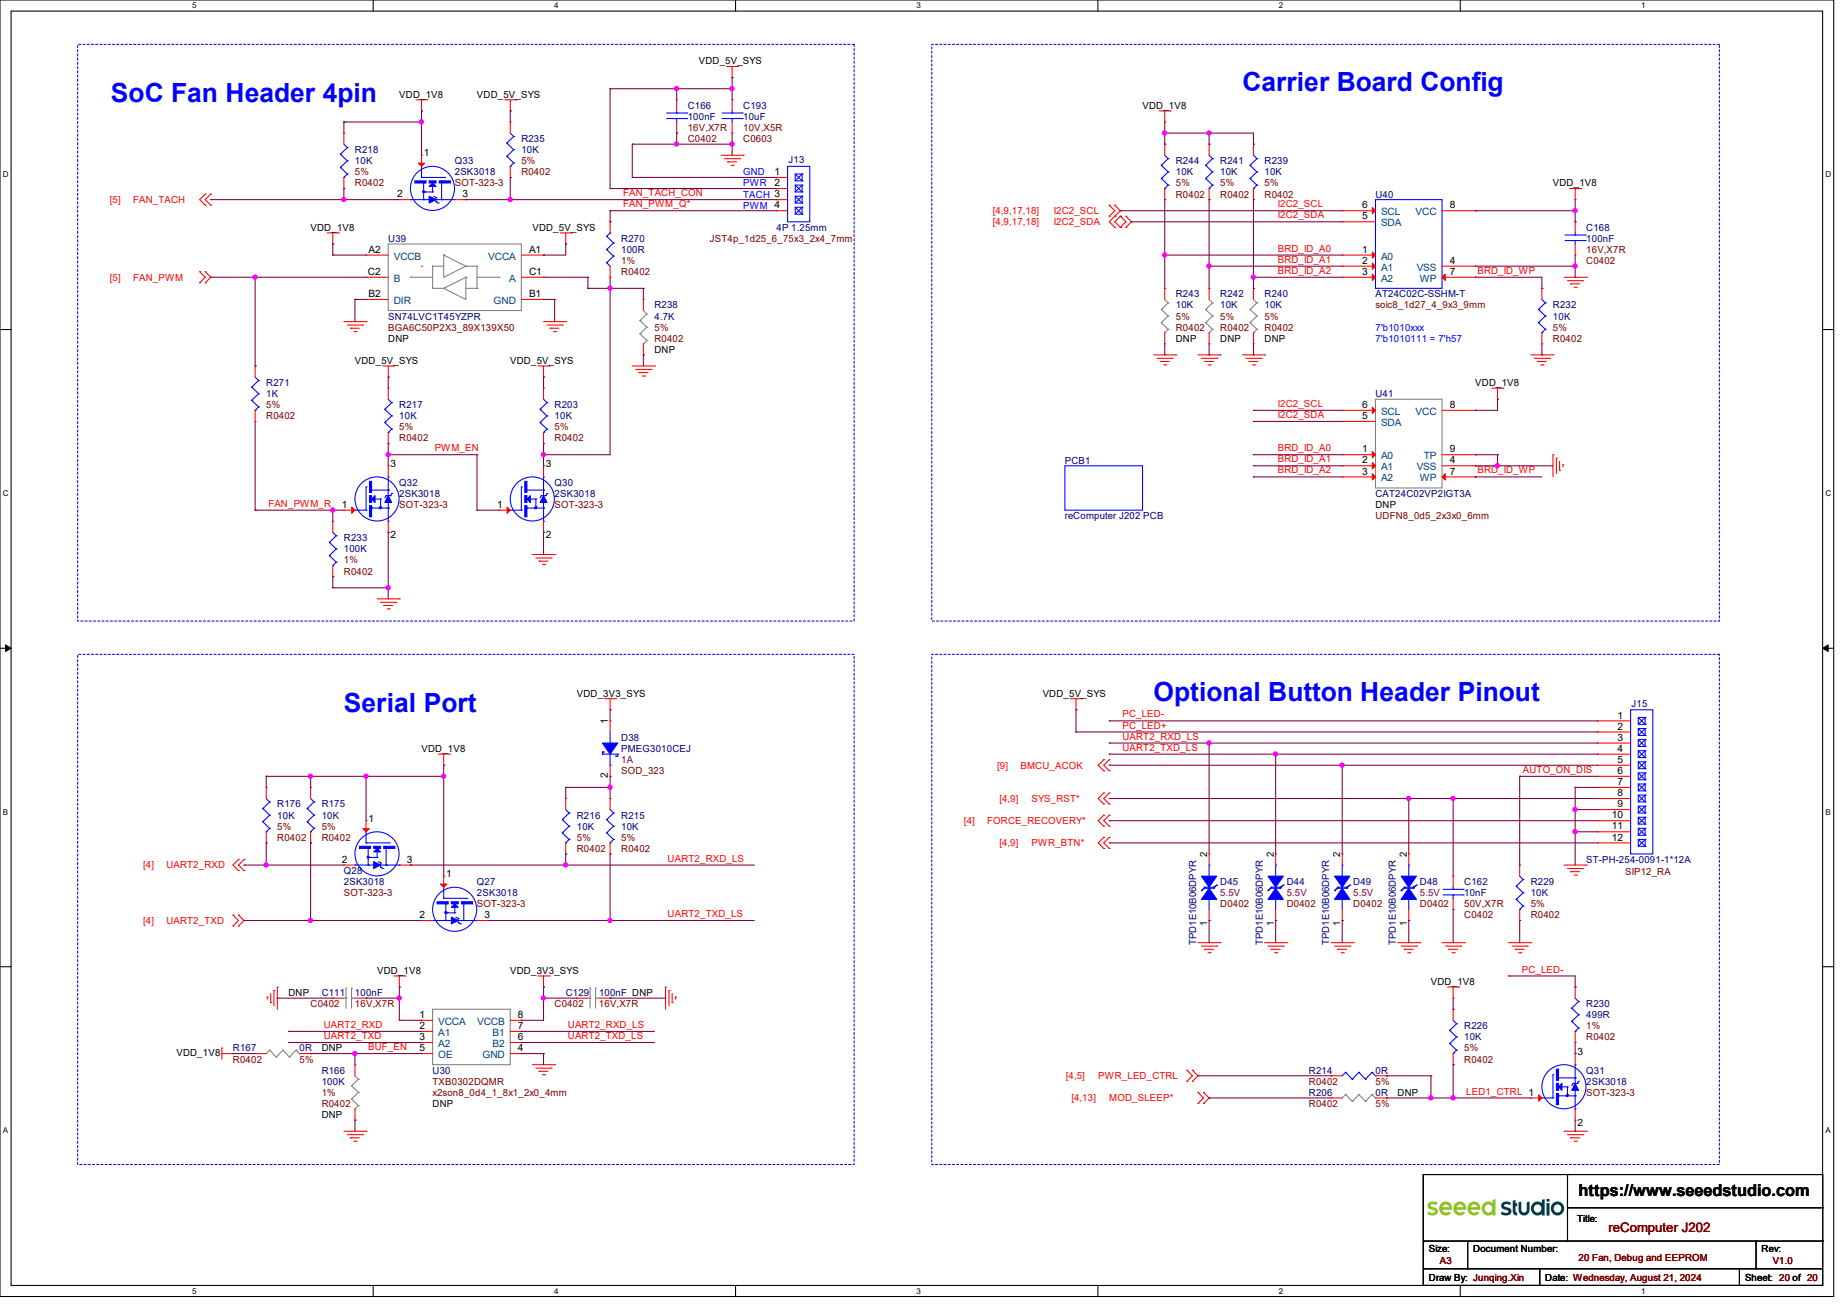
[picture p123: page 20]

reComputer J202 20 Fan, Debug and EEPROM
