Seeed-Studio/OSHW-Jetson-Series/reComputer Jetson carrier board/reComputer J401B/Schematic/reComputer_J401B_CarrierBoard_SCH_V1.0.pdf

DATE | REVISION | DESCRIPTION
01 | Table of Contents

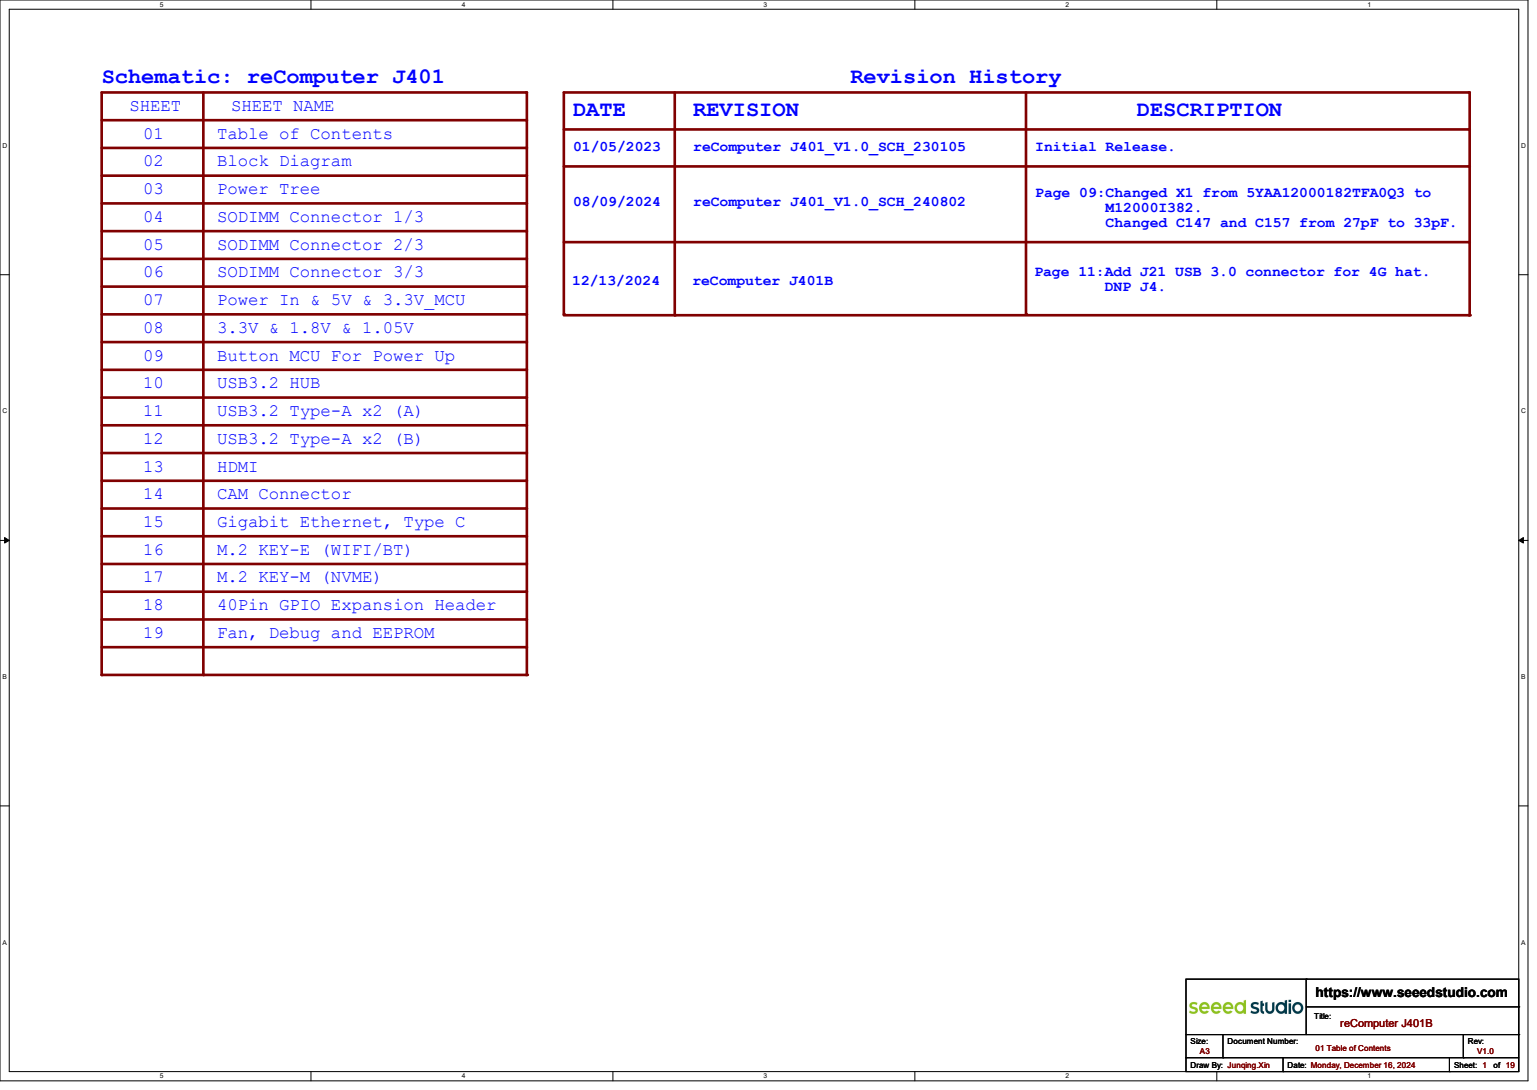
[picture p124: page 1]
Schematic: reComputer J401 SHEET NAME; SHEET; Revision History; Title:; Size:; Document Number:; Rev:; Draw By:; Date:; Sheet:; Junqing.Xin; Monday, December 16, 2024; reComputer J401B

01/05/2023 | reComputer J401_V1.0_SCH_230105 | Initial Release.
08/09/2024 | reComputer J401_V1.0_SCH_240802 | Page 09:Changed X1 from 5YAA12000182TFA0Q3 to M12000I382. Changed C147 and C157 from 27pF to 33pF.

02 | Block Diagram
03 | Power Tree
04 | SODIMM Connector 1/3
05 | SODIMM Connector 2/3
06 | SODIMM Connector 3/3
07 | Power In & 5V & 3.3V_MCU
08 | 3.3V & 1.8V & 1.05V
09 | Button MCU For Power Up
10 | USB3.2 HUB
11 | USB3.2 Type-A x2 (A)
12 | USB3.2 Type-A x2 (B)
13 | HDMI
14 | CAM Connector
15 | Gigabit Ethernet, Type C
16 | M.2 KEY-E (WIFI/BT)
17 | M.2 KEY-M (NVME)
18 | 40Pin GPIO Expansion Header
19 | Fan, Debug and EEPROM

12/13/2024 | reComputer J401B | Page 11:Add J21 USB 3.0 connector for 4G hat. DNP J4.

https://www.seeedstudio.com

01 Table of Contents

## BASEBOARD CIRCUIT

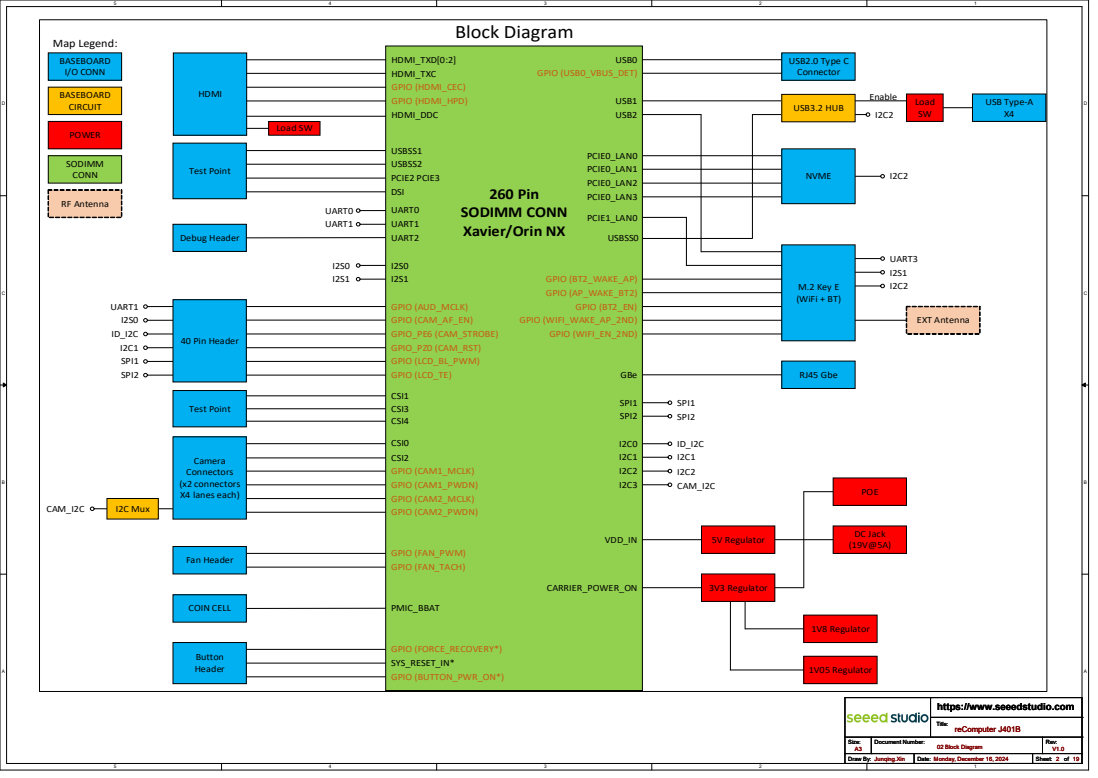
[picture p125: page 2]
POWER; BASEBOARD I/O CONN; SODIMM CONN; RF Antenna; Map Legend:; Block Diagram; USBSS2 PCIE2 PCIE3; UART0 UART1 UART2; GPIO (AUD_MCLK) GPIO (CAM_AF_EN) GPIO_PE6 (CAM_STROBE) GPIO_PZ0 (CAM_RST) GPIO (LCD_BL_PWM) GPIO (LCD_TE); CSI4; CSI3; CSI0 CSI2 GPIO (CAM1_MCLK) GPIO (CAM1_PWDN) GPIO (CAM2_MCLK) GPIO (CAM2_PWDN); GPIO (FAN_PWM) GPIO (FAN_TACH); PMIC_BBAT; SYS_RESET_IN*; GPIO (FORCE_RECOVERY*); GPIO (BUTTON_PWR_ON*); USB0; USB1 USB2; PCIE0_LAN0 PCIE0_LAN1 PCIE0_LAN2 PCIE0_LAN3; PCIE1_LAN0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

260 Pin
SODIMM CONN
Xavier/Orin NX

https://www.seeedstudio.com

# Jetson Xavier/Orin NX

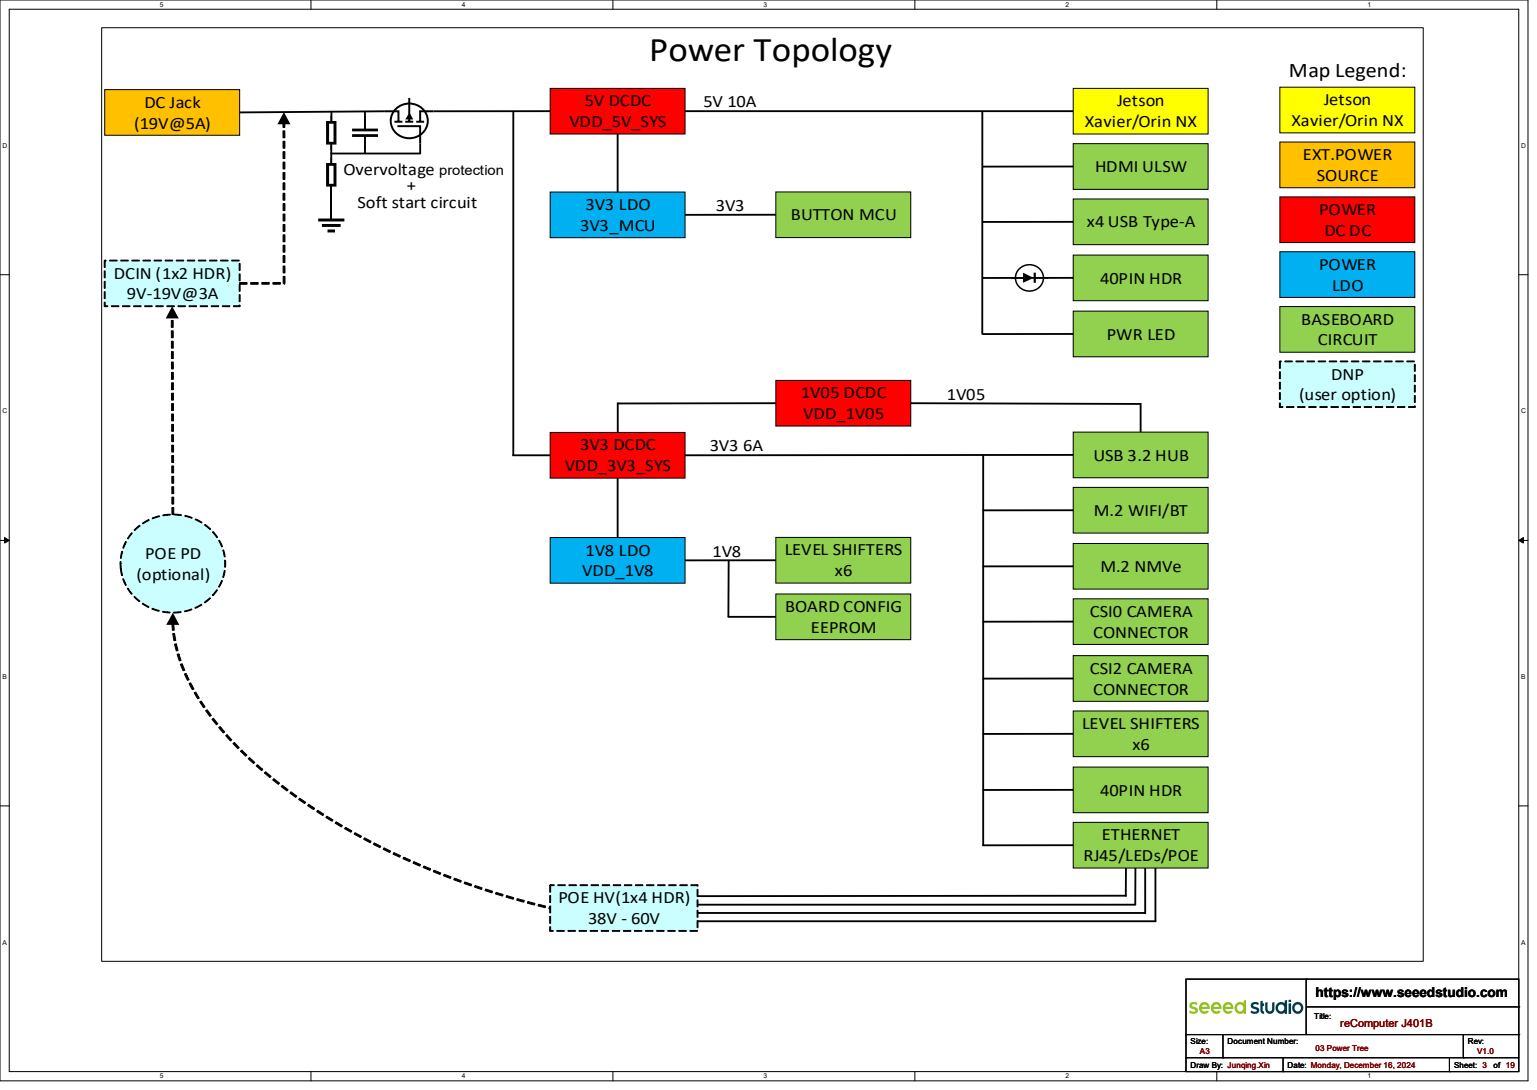
[picture p126: page 3]
BUTTON MCU; BOARD CONFIG EEPROM; LEVEL SHIFTERS x6; 3V3 DCDC VDD_3V3_SYS; 5V DCDC VDD_5V_SYS; 1V05 DCDC VDD_1V05; USB 3.2 HUB; M.2 WIFI/BT; M.2 NMVe; CSI0 CAMERA CONNECTOR; CSI2 CAMERA CONNECTOR; 40PIN HDR; ETHERNET RJ45/LEDs/POE; HDMI ULSW; x4 USB Type-A; 3V3 LDO 3V3_MCU; 1V8 LDO VDD_1V8; DCIN (1x2 HDR) 9V-19V@3A; POE PD (optional); DC Jack (19V@5A); Jetson Xavier/Orin NX EXT.POWER SOURCE POWER DC DC POWER LDO BASEBOARD CIRCUIT DNP (user option); Map Legend:; Power Topology; PWR LED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

Overvoltage protection
Soft start circuit

POE HV(1x4 HDR)

https://www.seeedstudio.com

# UART, I2C, CAN and GPIOs

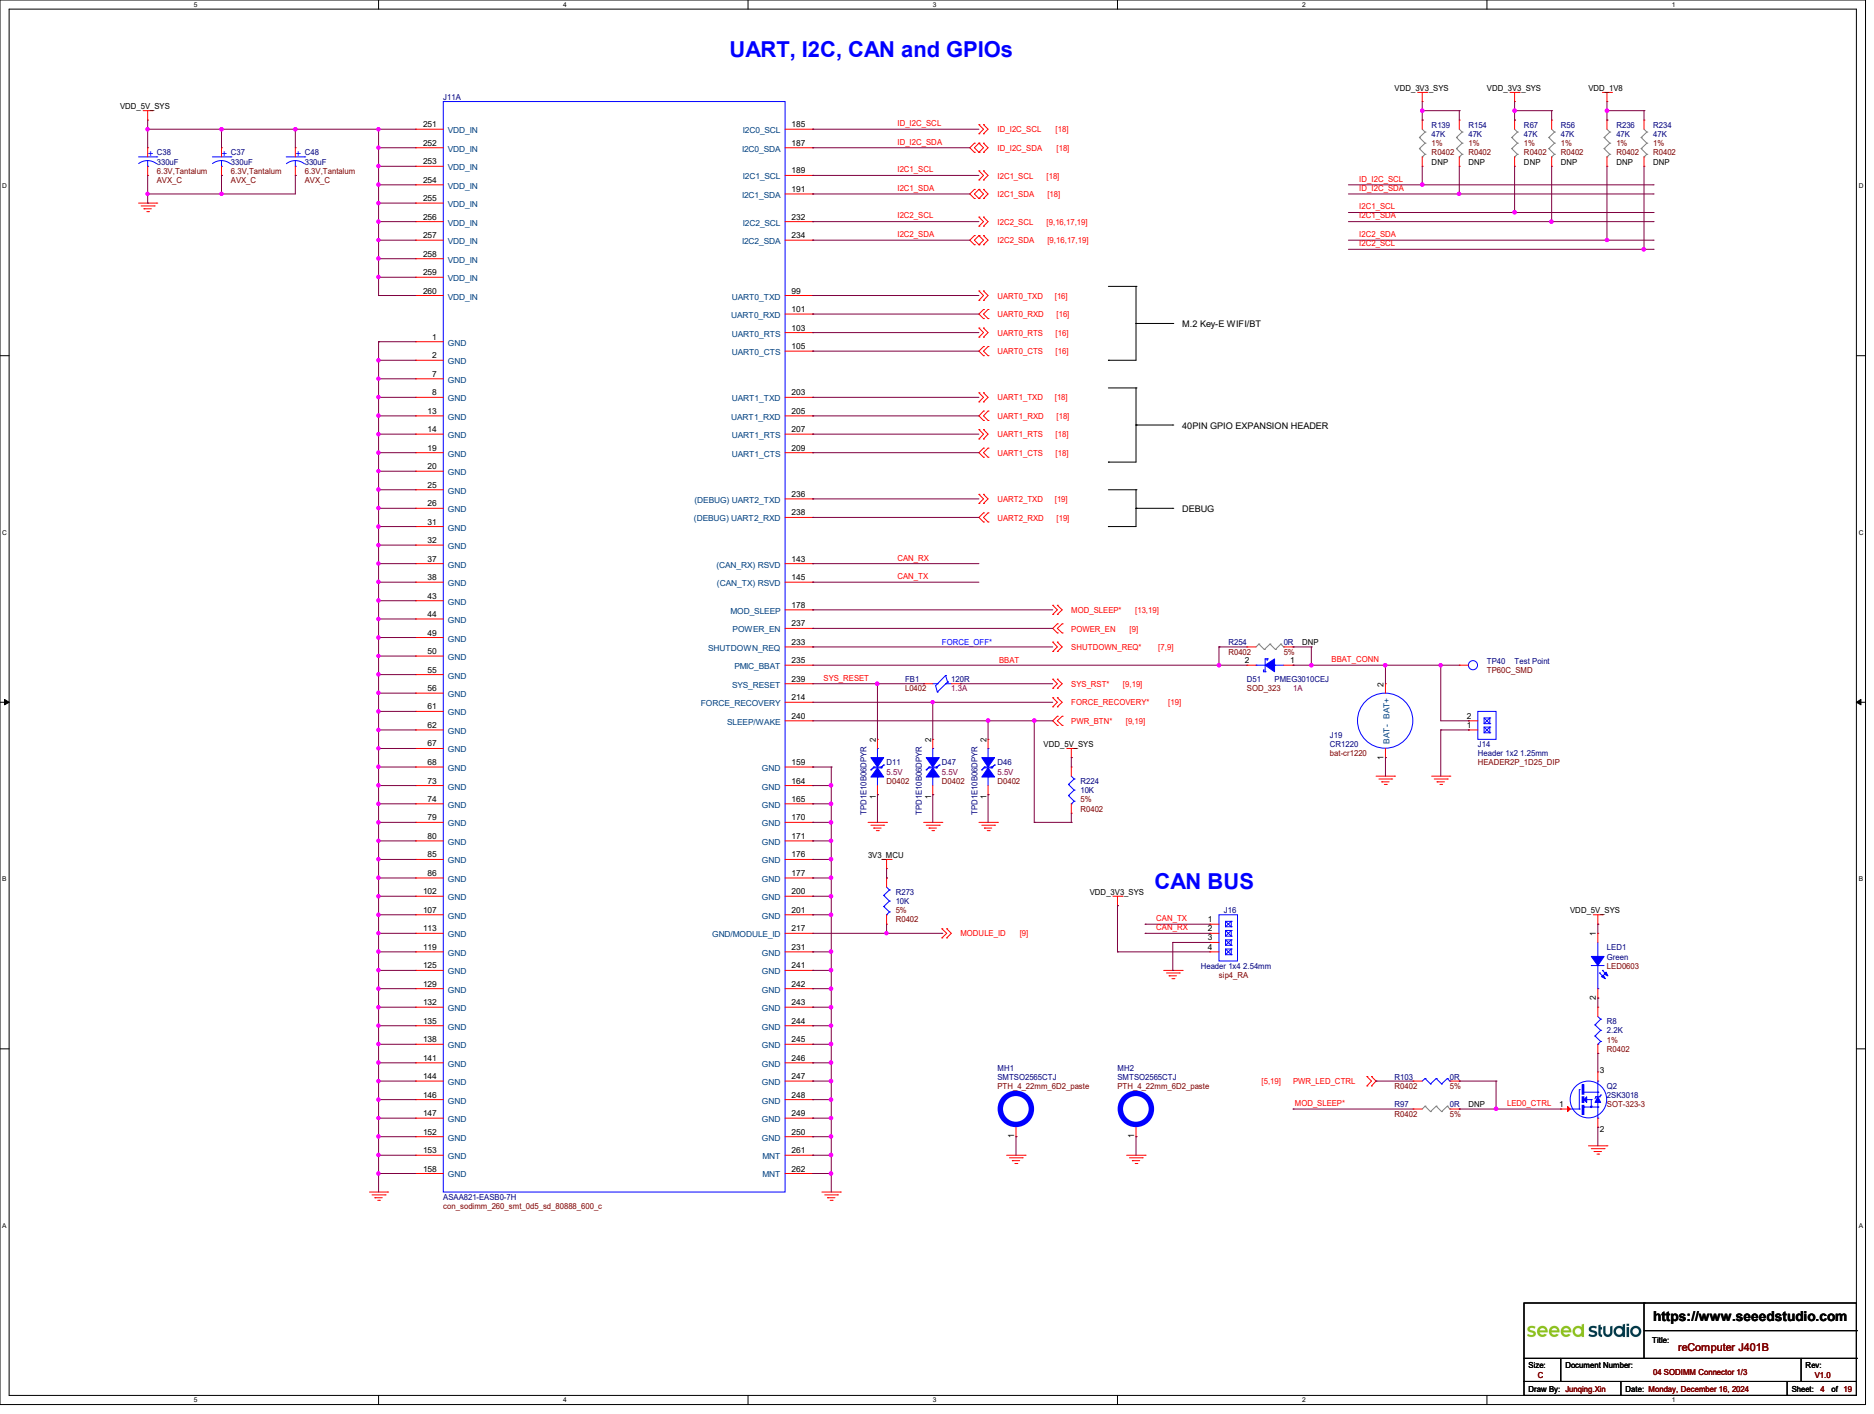
[picture p127: page 4]

https://www.seeedstudio.com

G

P

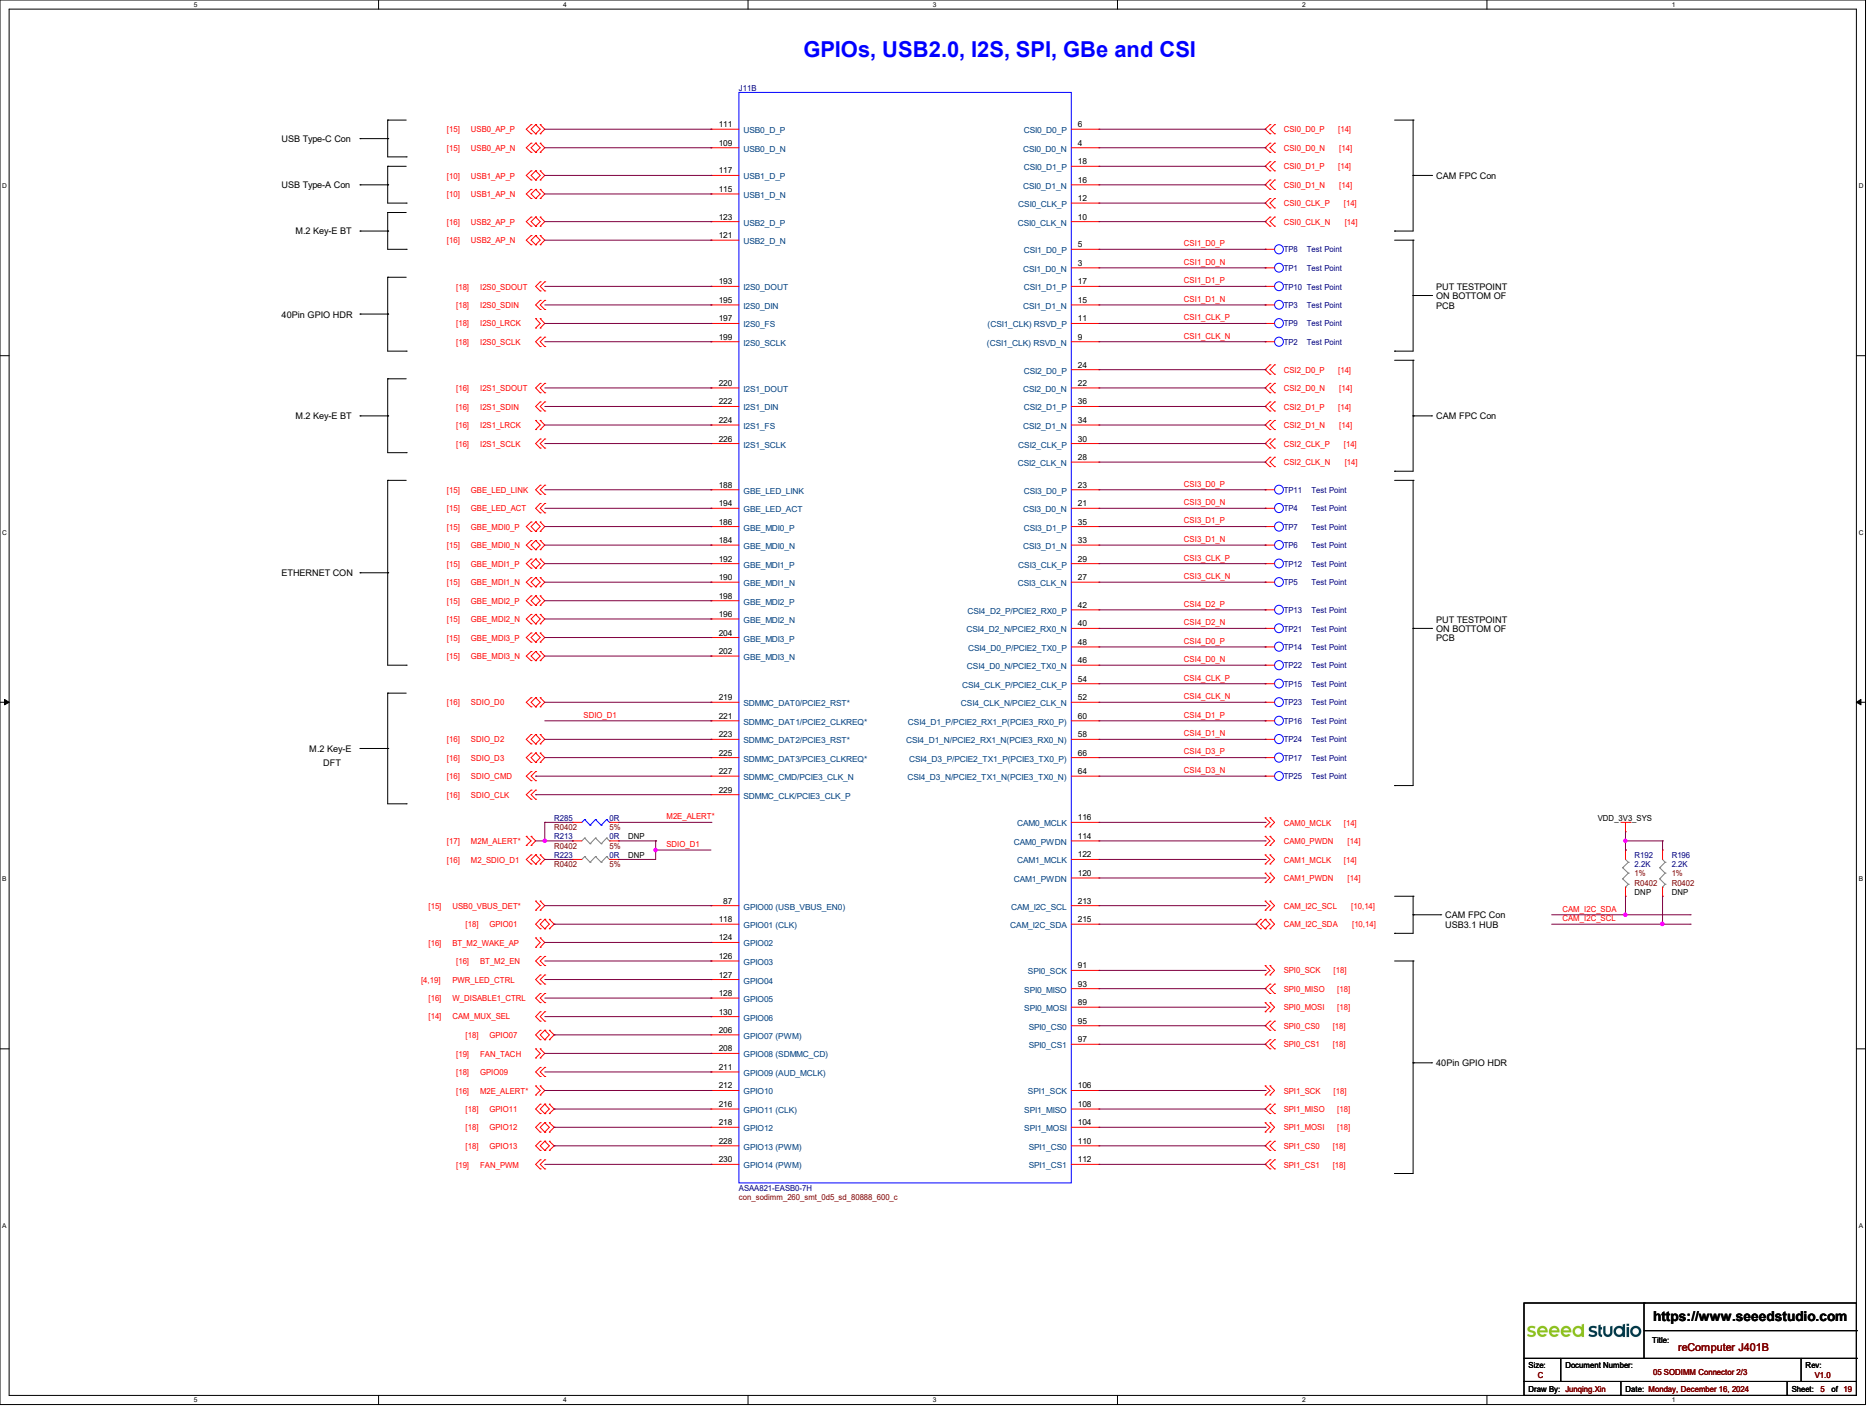
[picture p128: page 5]
Pin; PIO; OIN; DIN; LIN; MIS; DIS; DIO; Title: Size:; Document Number:; v: Draw By:; Date:; Sheet:; qin; g.Xin; DIM; oin; dim; CIE

# HDMI, DP, DSI, USBSS and PCIe

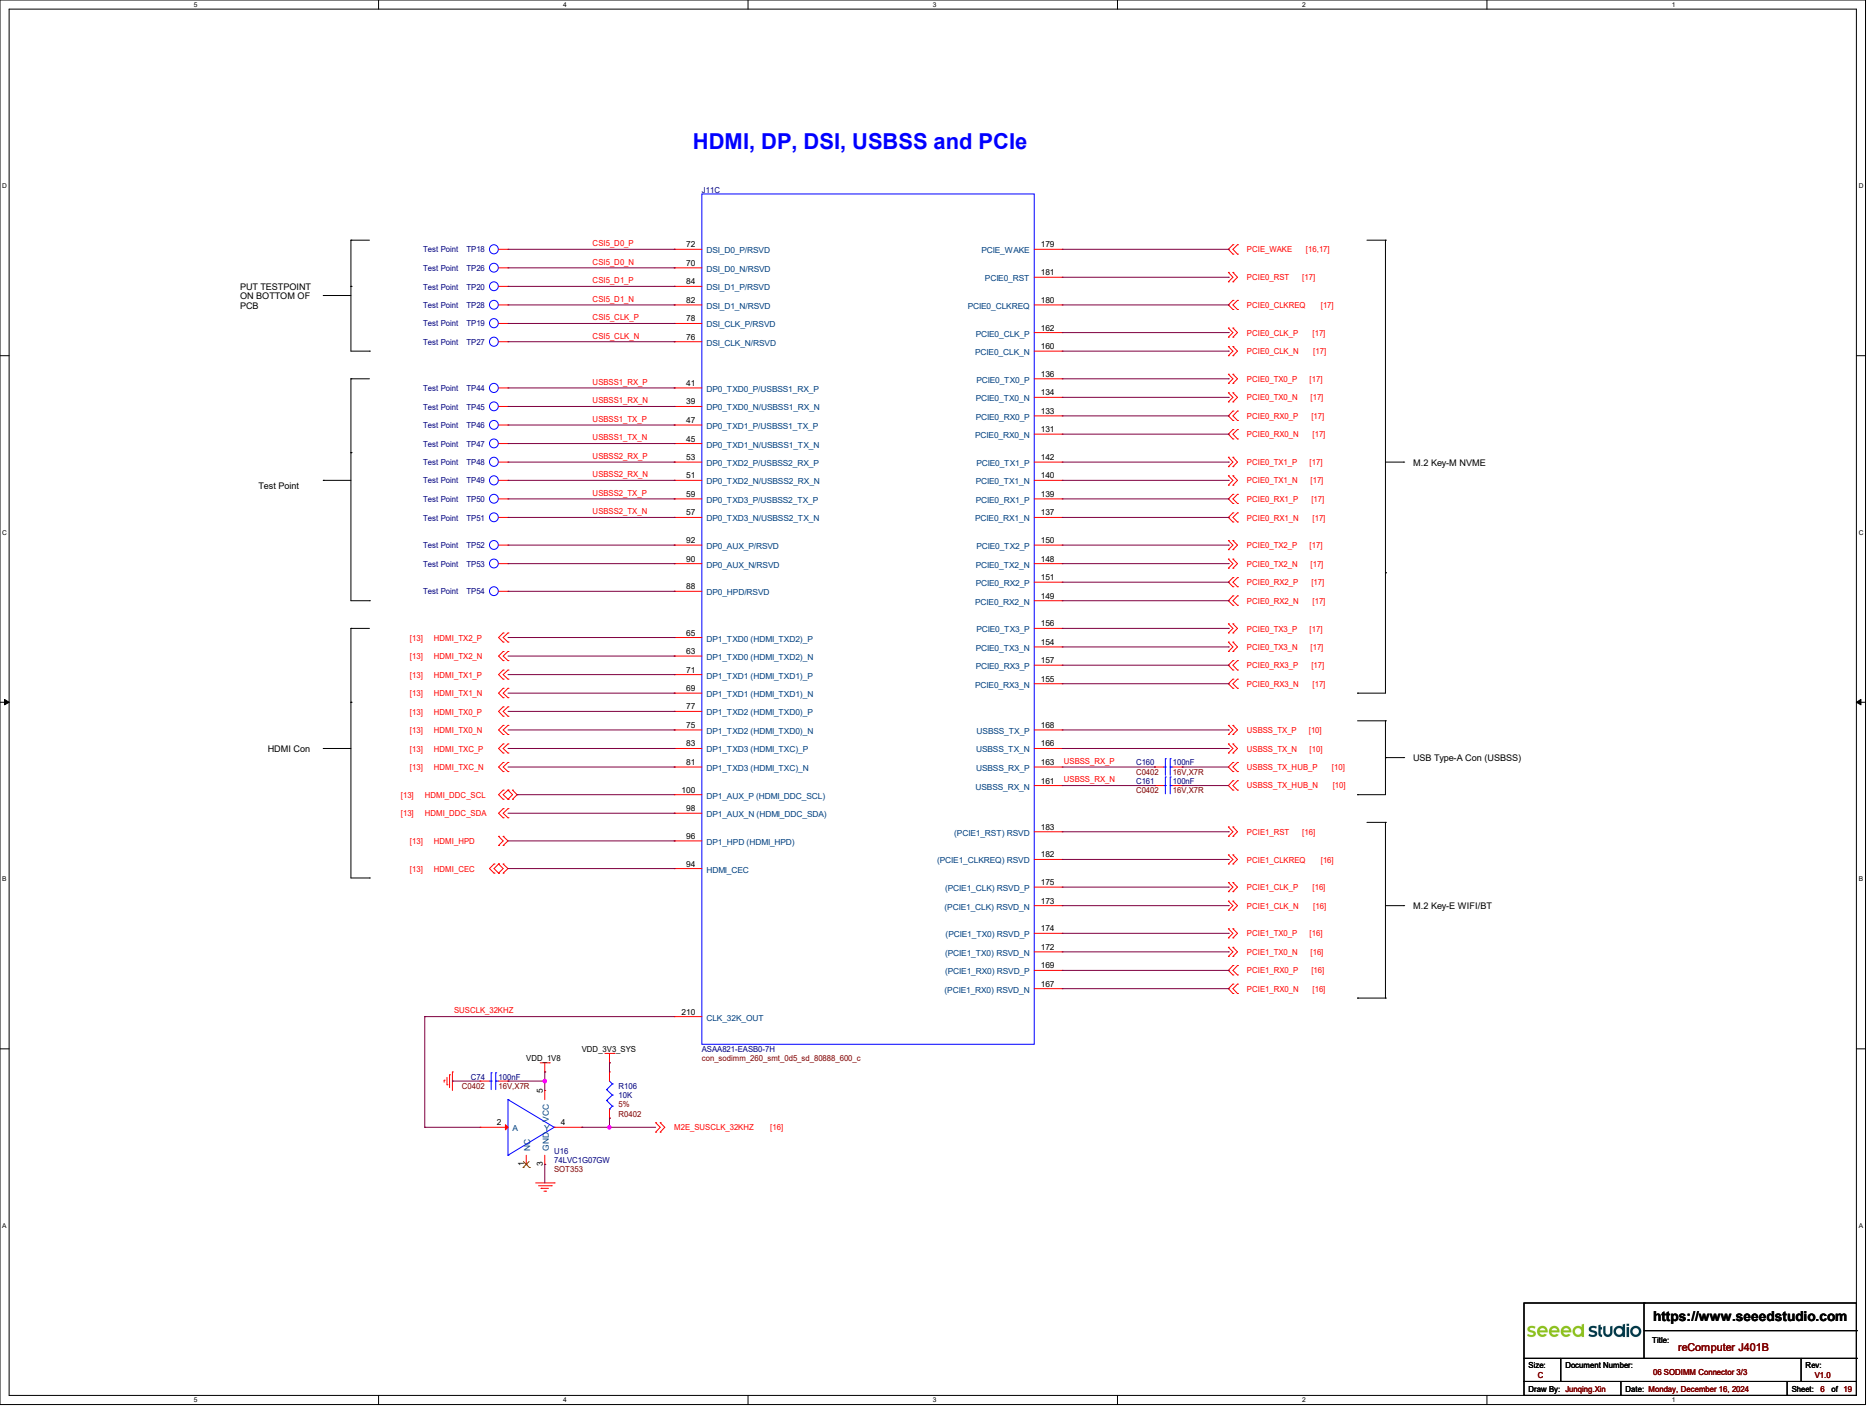
[picture p129: page 6]

USB Type-A Con (USBSS)

https://www.seeedstudio.com

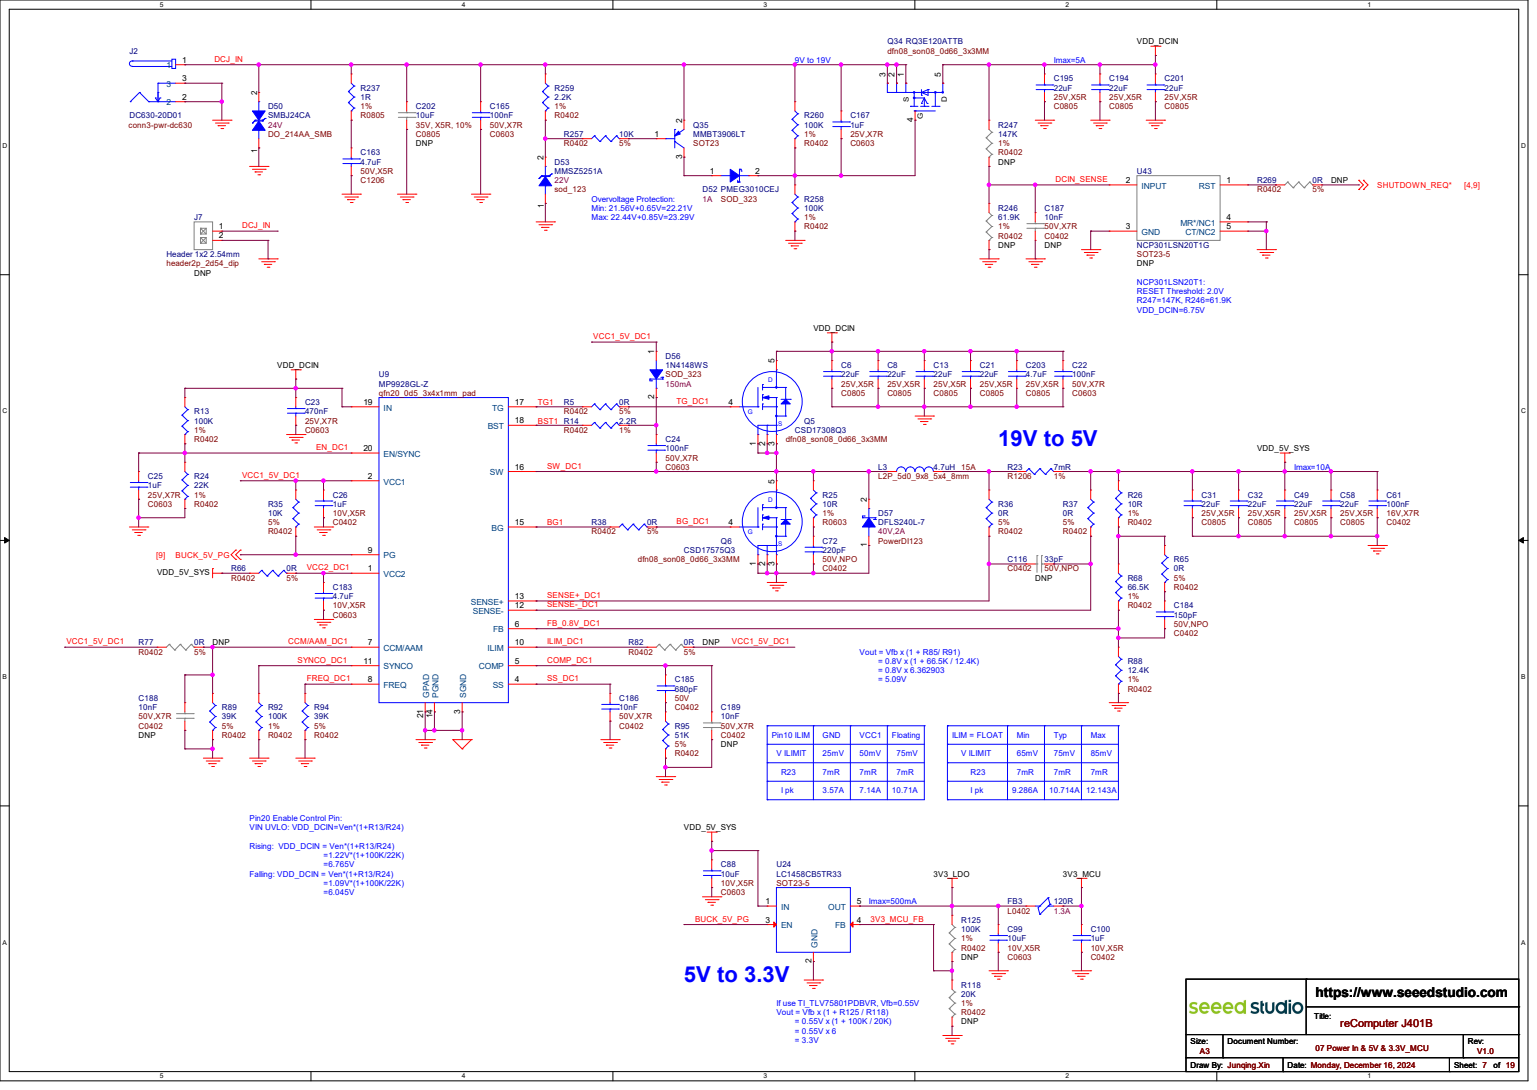
[picture p130: page 7]

https://www.seeedstudio.com

# 19V to 3.3V

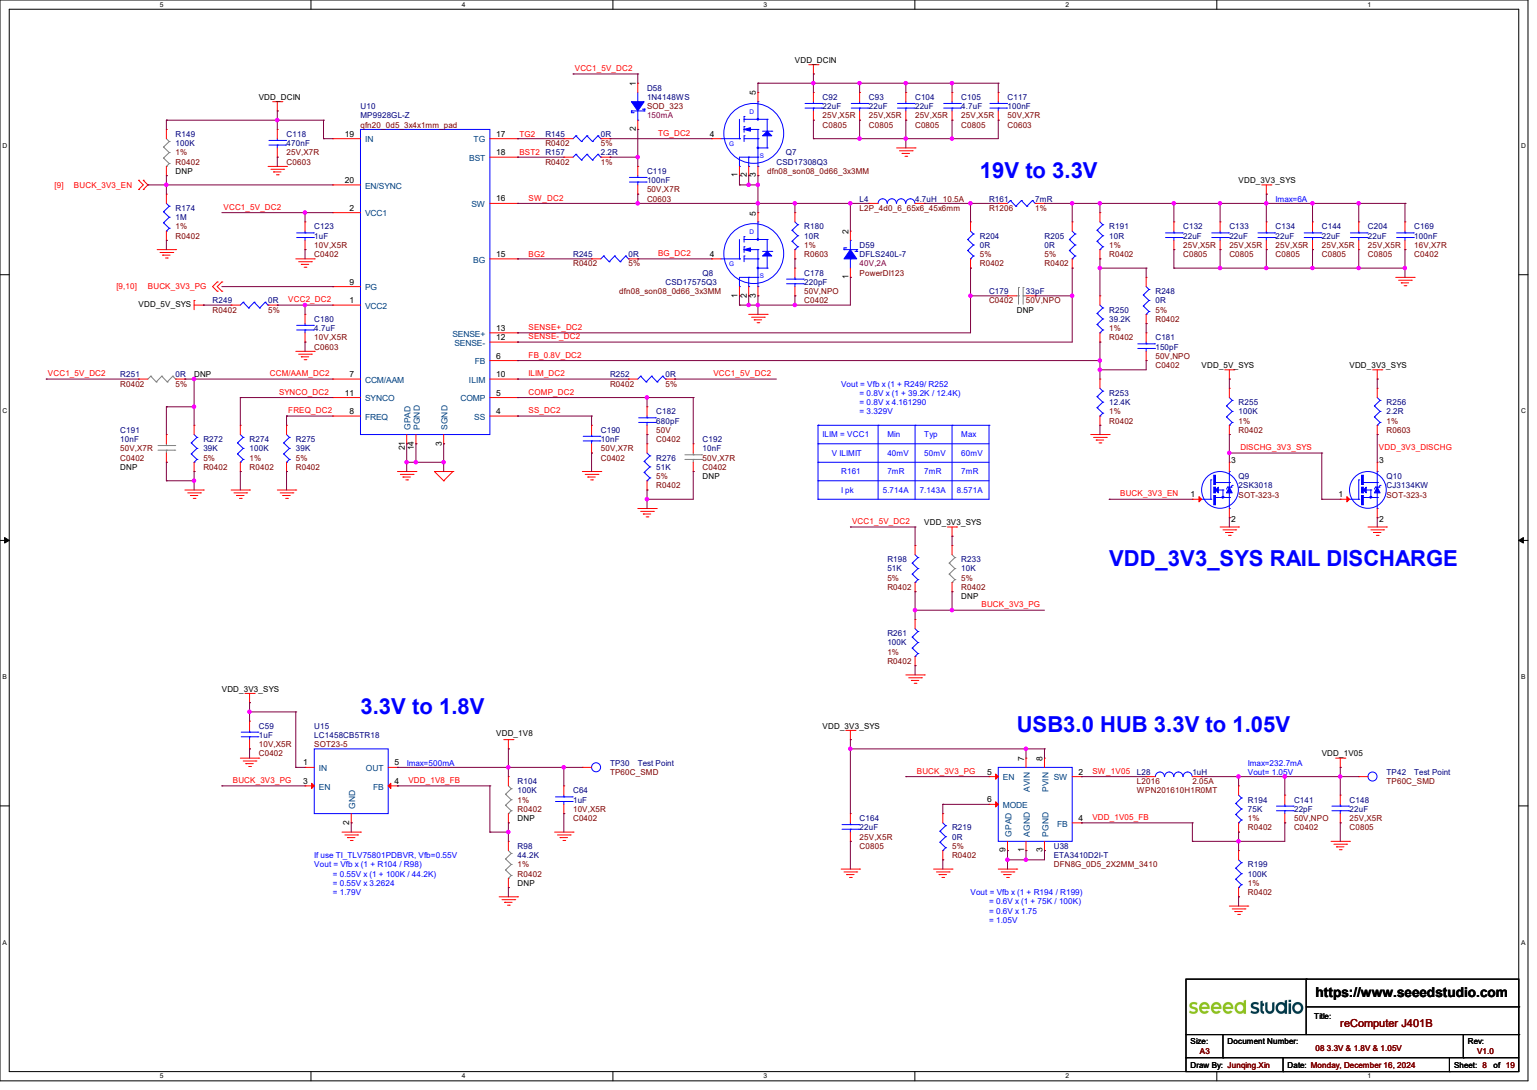
[picture p131: page 8]

ILIM = VCC1 | Min | Typ | Max
V ILIMIT | 40mV | 50mV | 60mV
R161 | 7mR | 7mR | 7mR
I pk | 5.714A | 7.143A | 8.571A

https://www.seeedstudio.com

# Button MCU For Power Up MCU

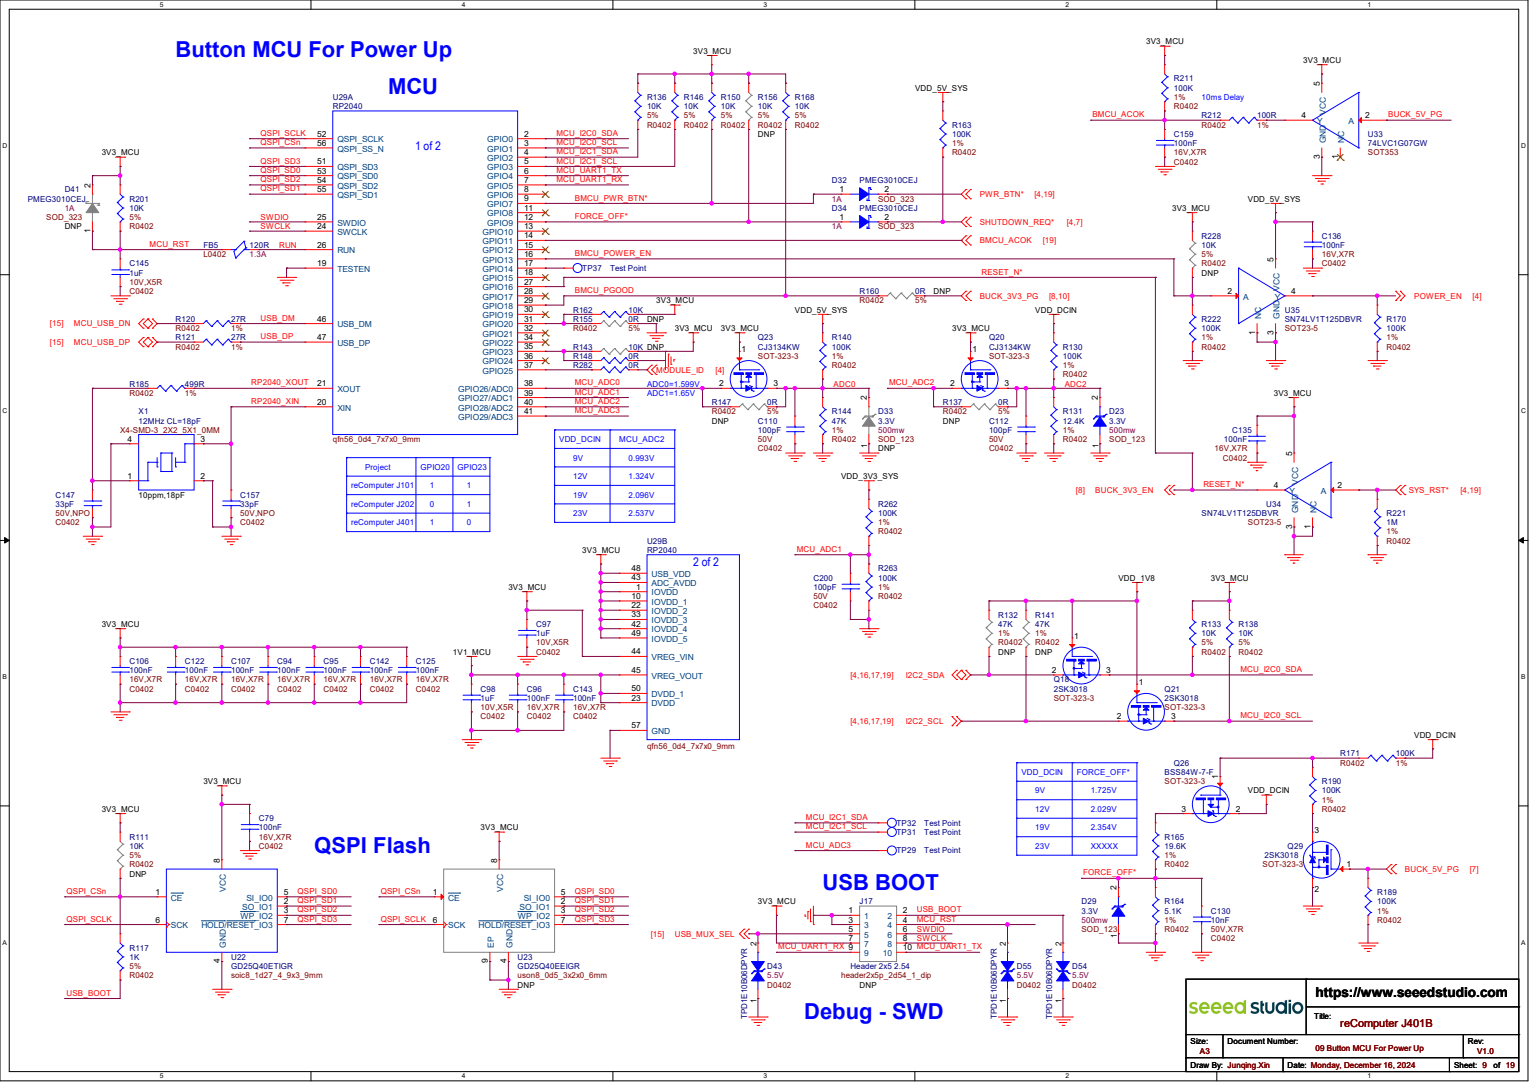
[picture p132: page 9]

VDD_DCIN | MCU_ADC2
9V | 0.993V
12V | 1.324V
19V | 2.096V
23V | 2.537V

reComputer J101 | 1 | 1
reComputer J202 | 0 | 1
reComputer J401 | 1 | 0

VDD_DCIN | FORCE_OFF*
9V | 1.725V
12V | 2.029V
19V | 2.354V
23V | XXXXX

https://www.seeedstudio.com

09 Button MCU For Power Up

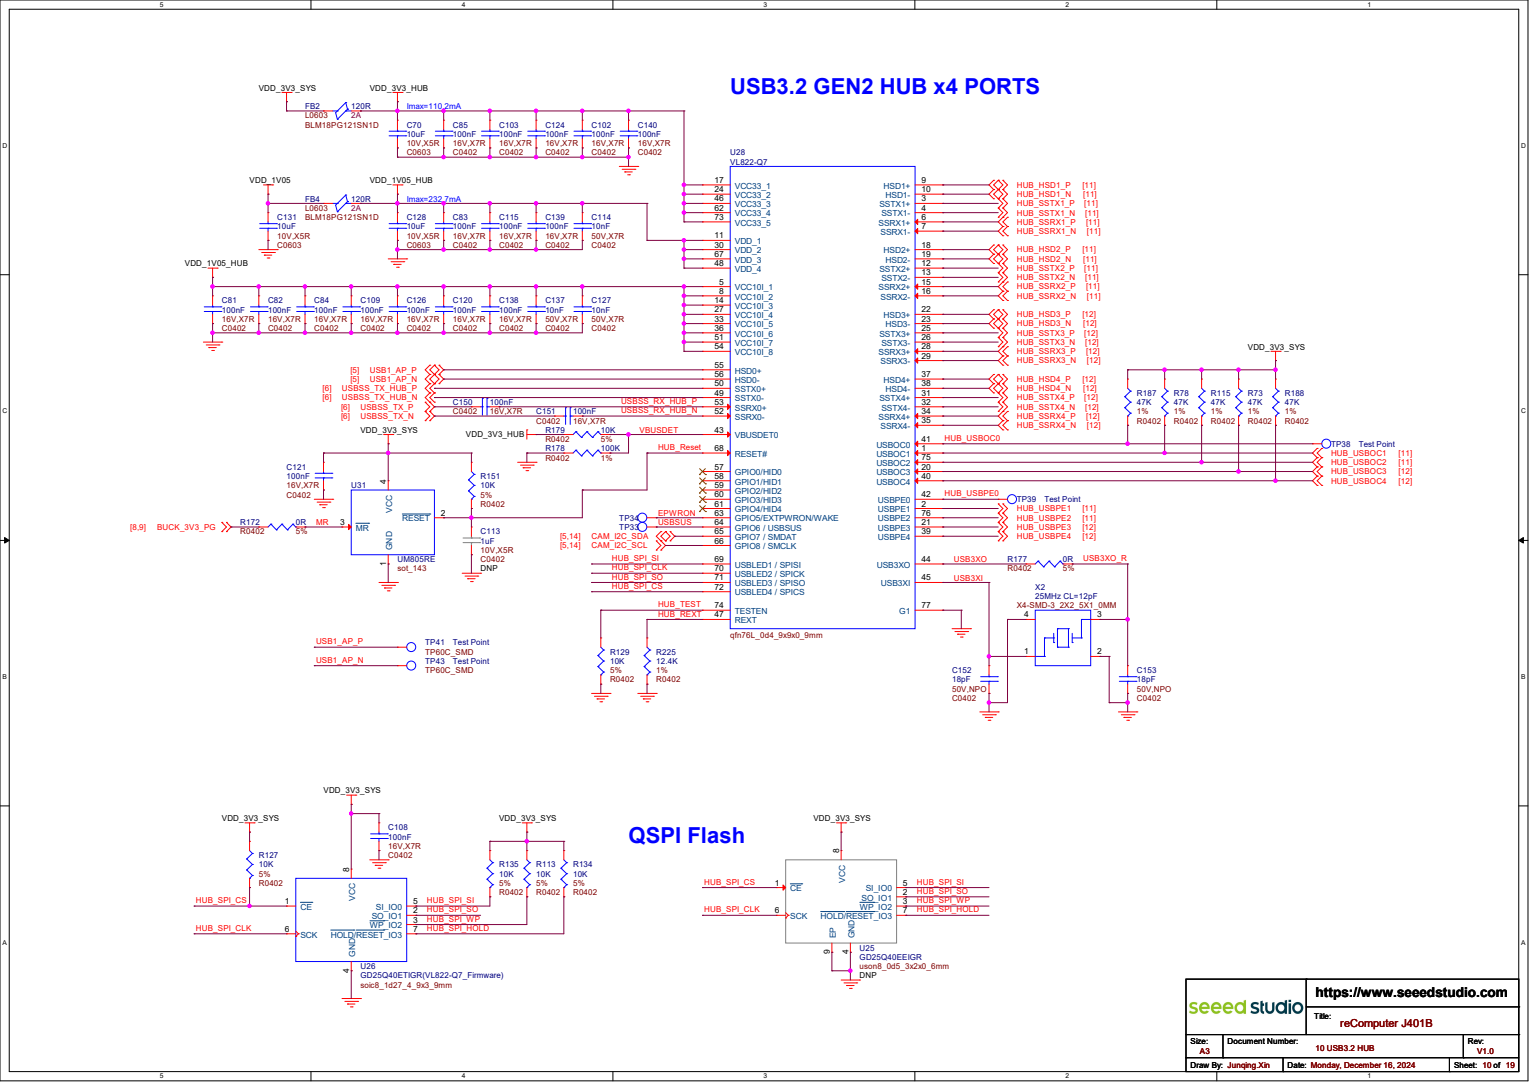
[picture p133: page 10]

https://www.seeedstudio.com

# USB3.2 TYPE-A x2 (A)

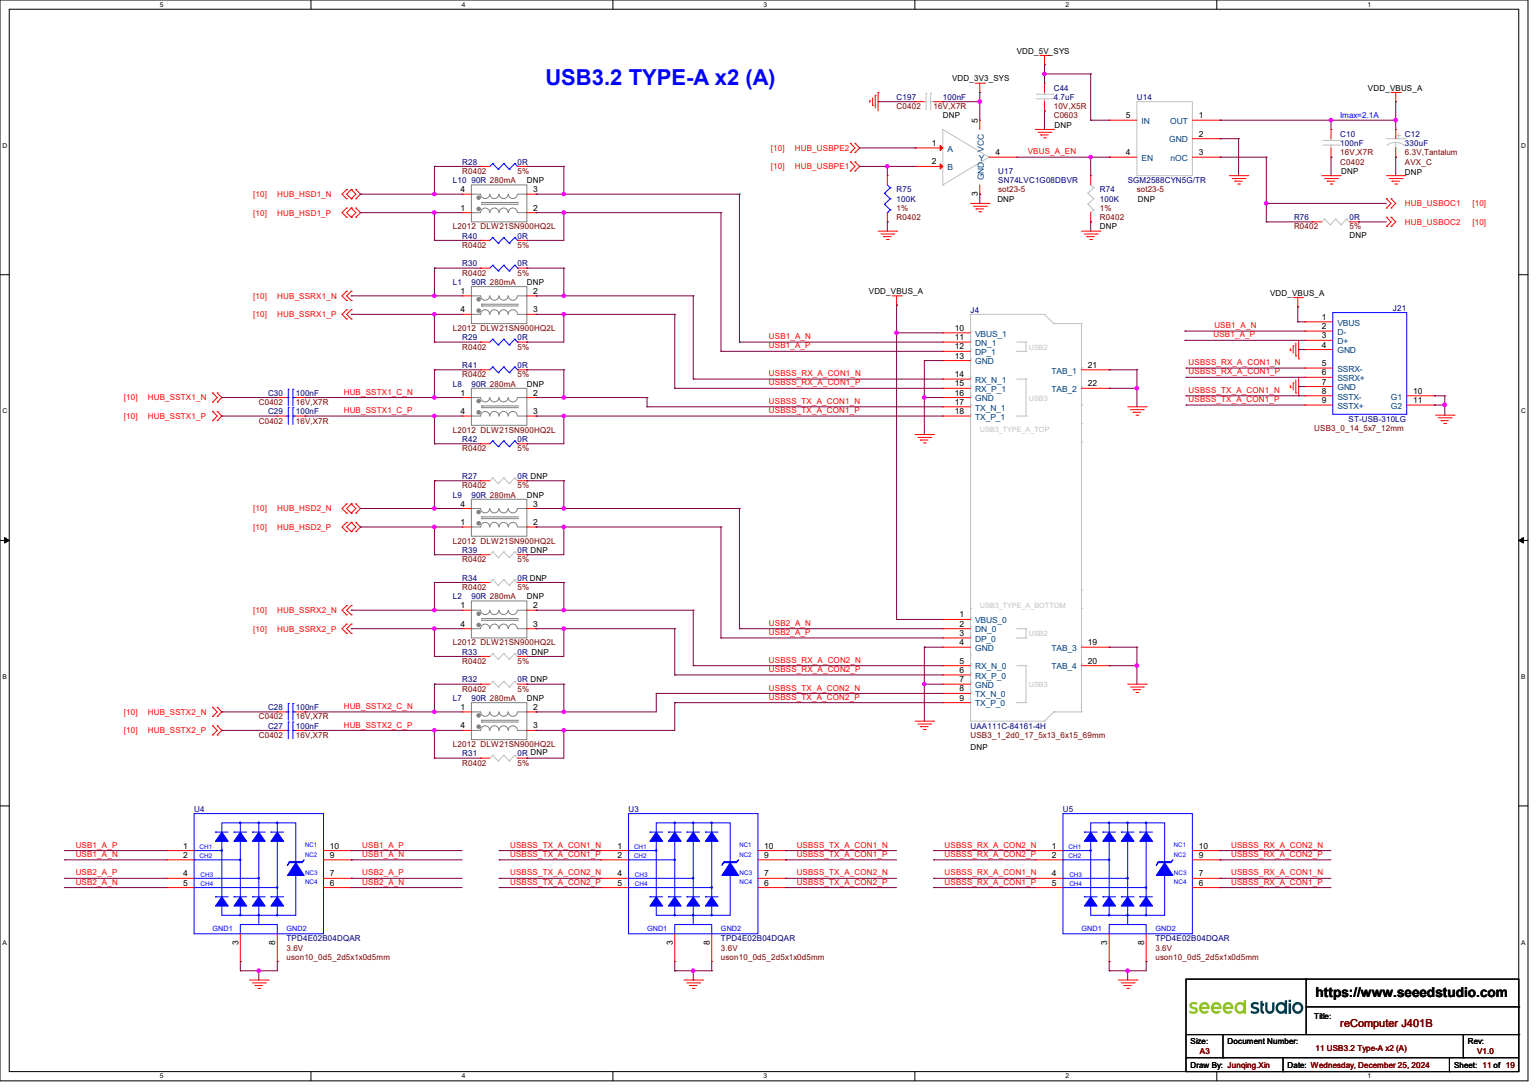
[picture p134: page 11]

https://www.seeedstudio.com

# USB3.2 TYPE-A x2 (B)

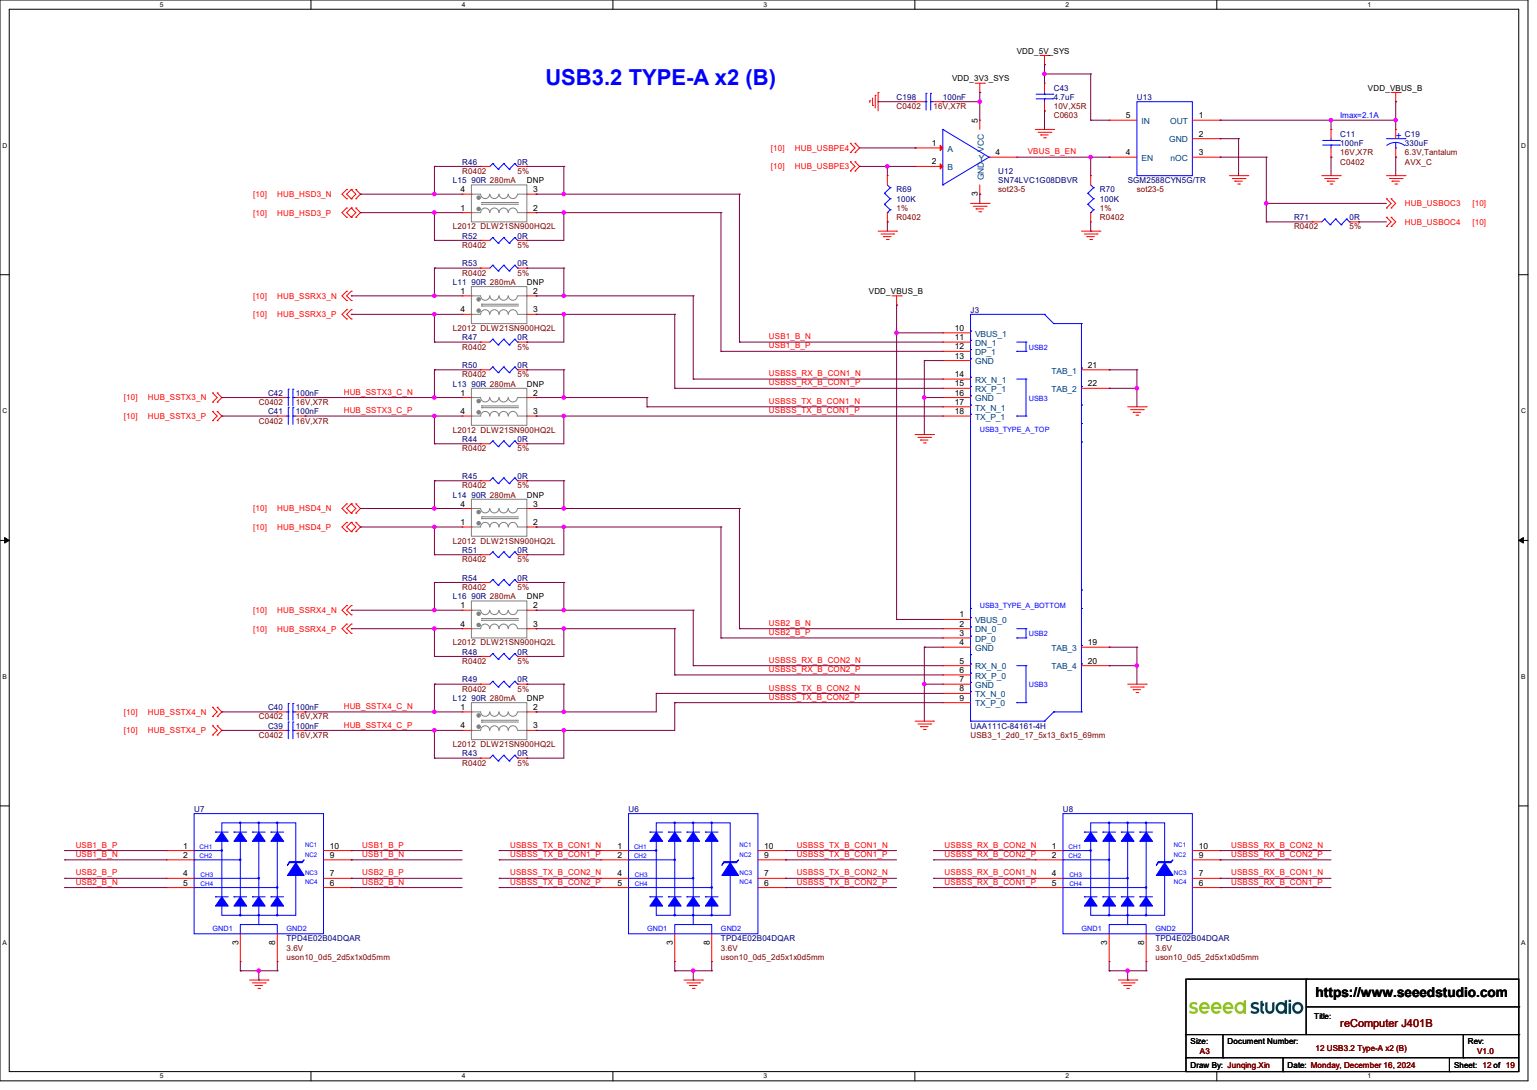
[picture p135: page 12]

https://www.seeedstudio.com

# HDMI Connector

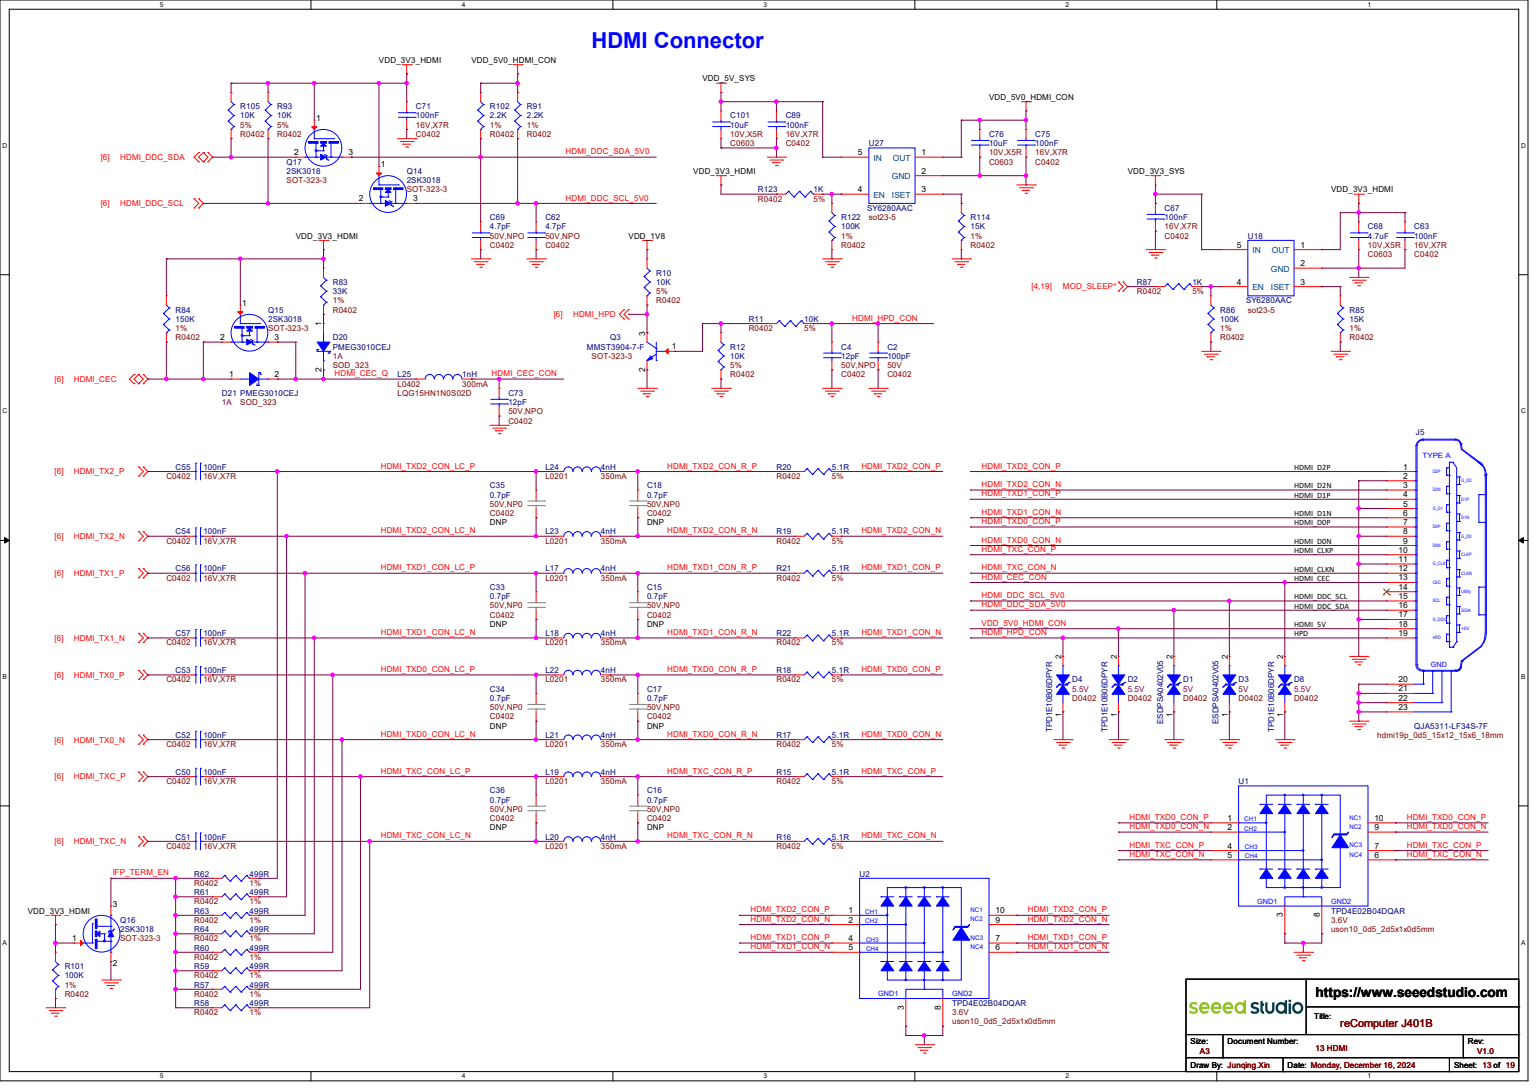
[picture p136: page 13]

https://www.seeedstudio.com

# CSI CAM CONNECTOR

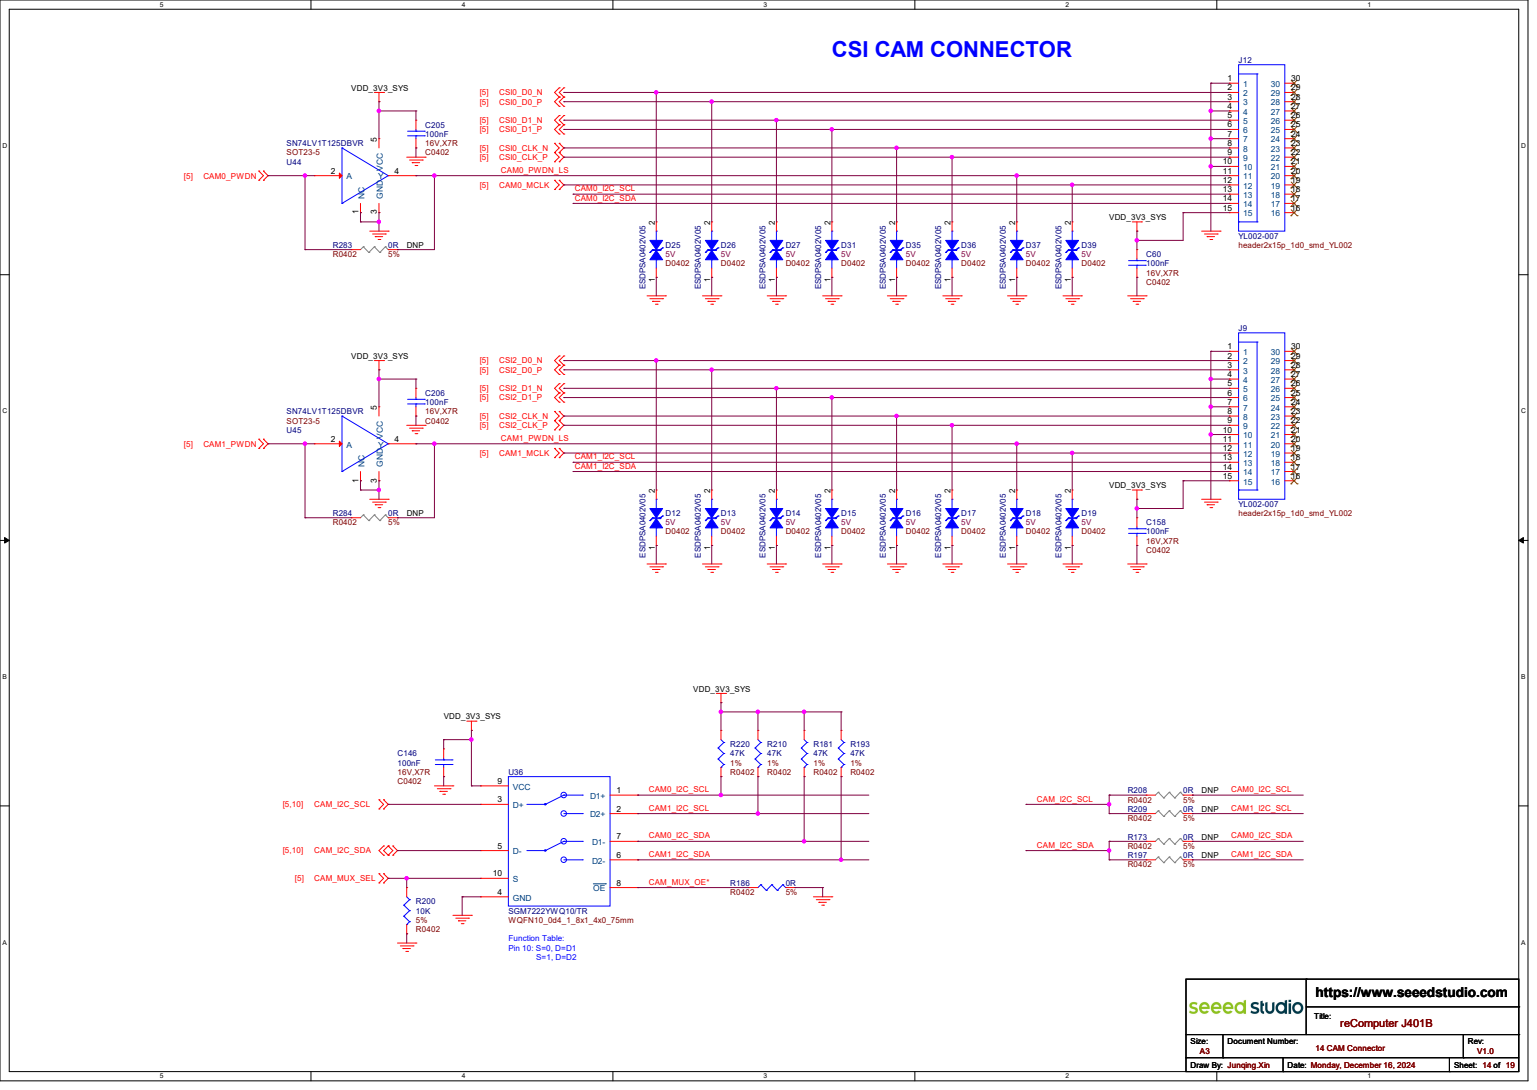
[picture p137: page 14]

https://www.seeedstudio.com

# Gigabit Ethernet with PoE

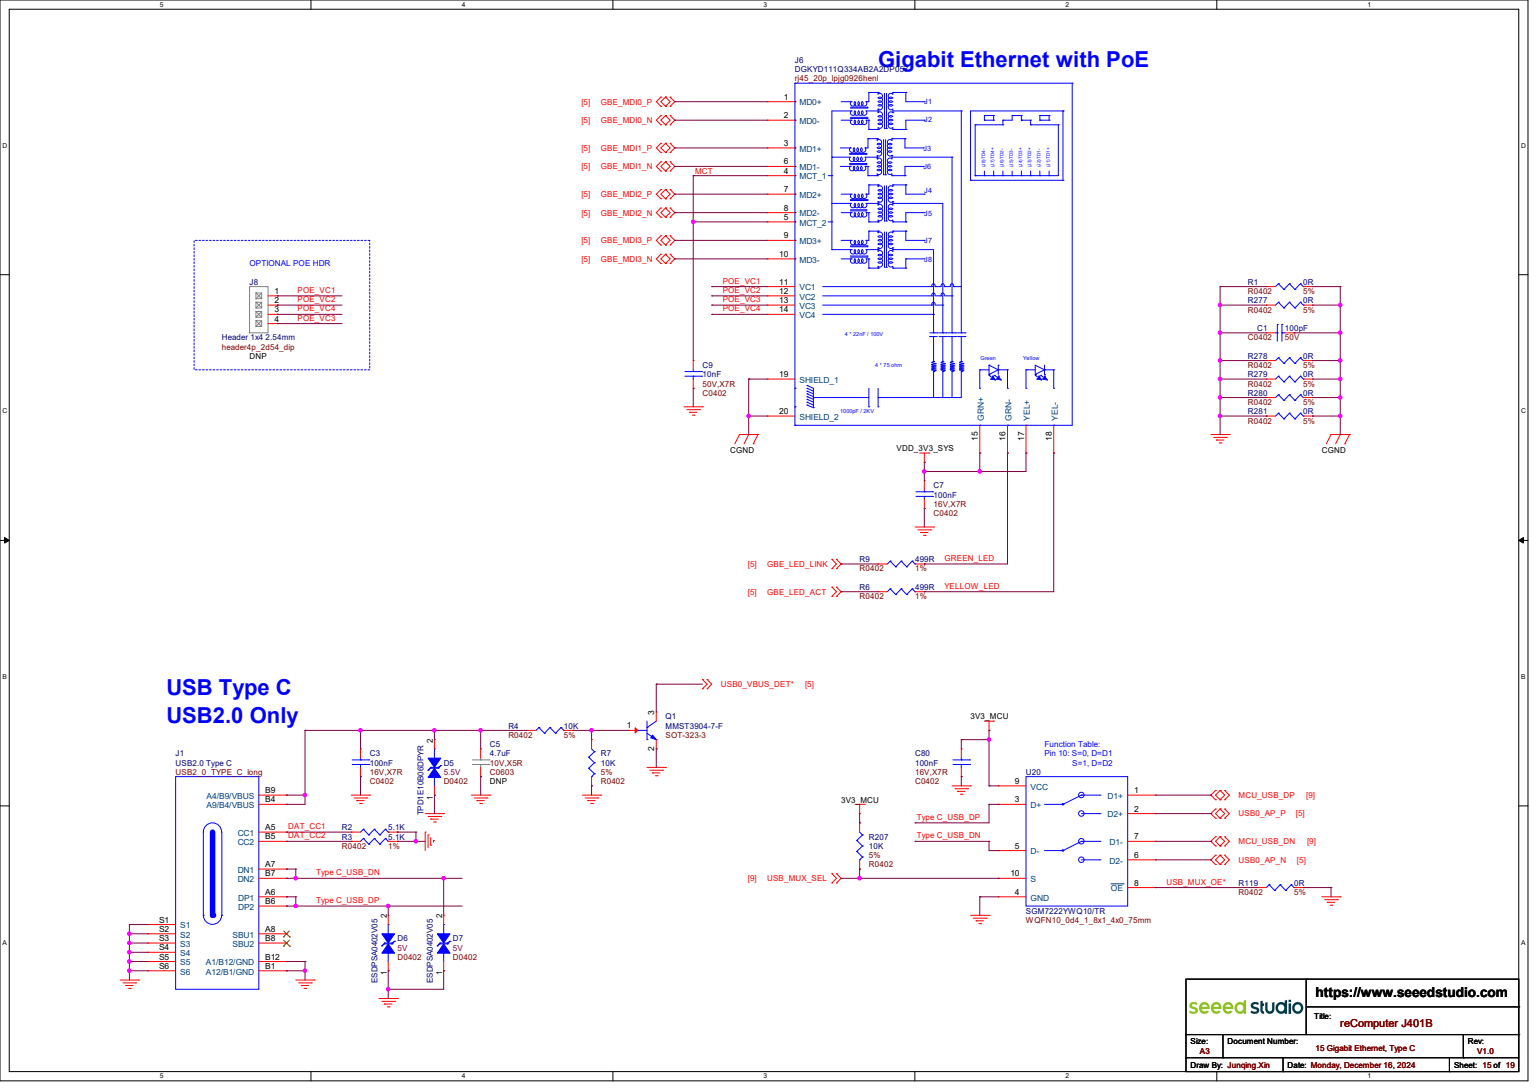
[picture p138: page 15]

https://www.seeedstudio.com

# M.2 KEY-E (WIFI/BT)

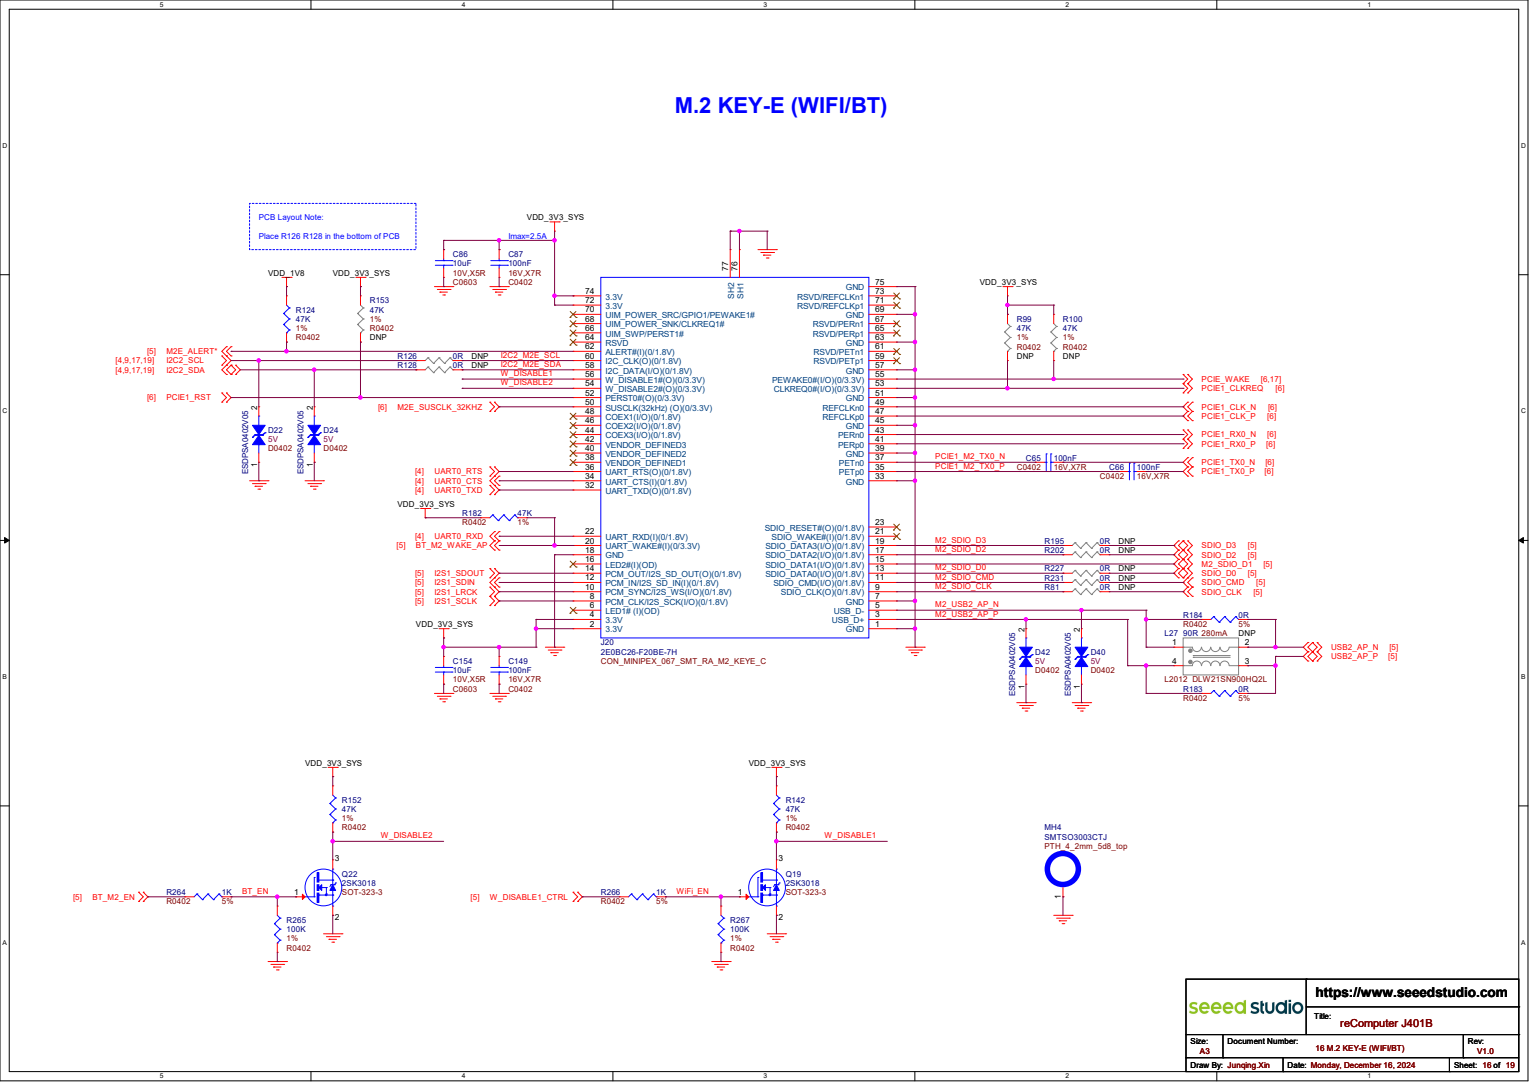
[picture p139: page 16]

PCB Layout Note:
Place R126 R128 in the bottom of PCB

https://www.seeedstudio.com

# M.2 KEY-M (NVME)

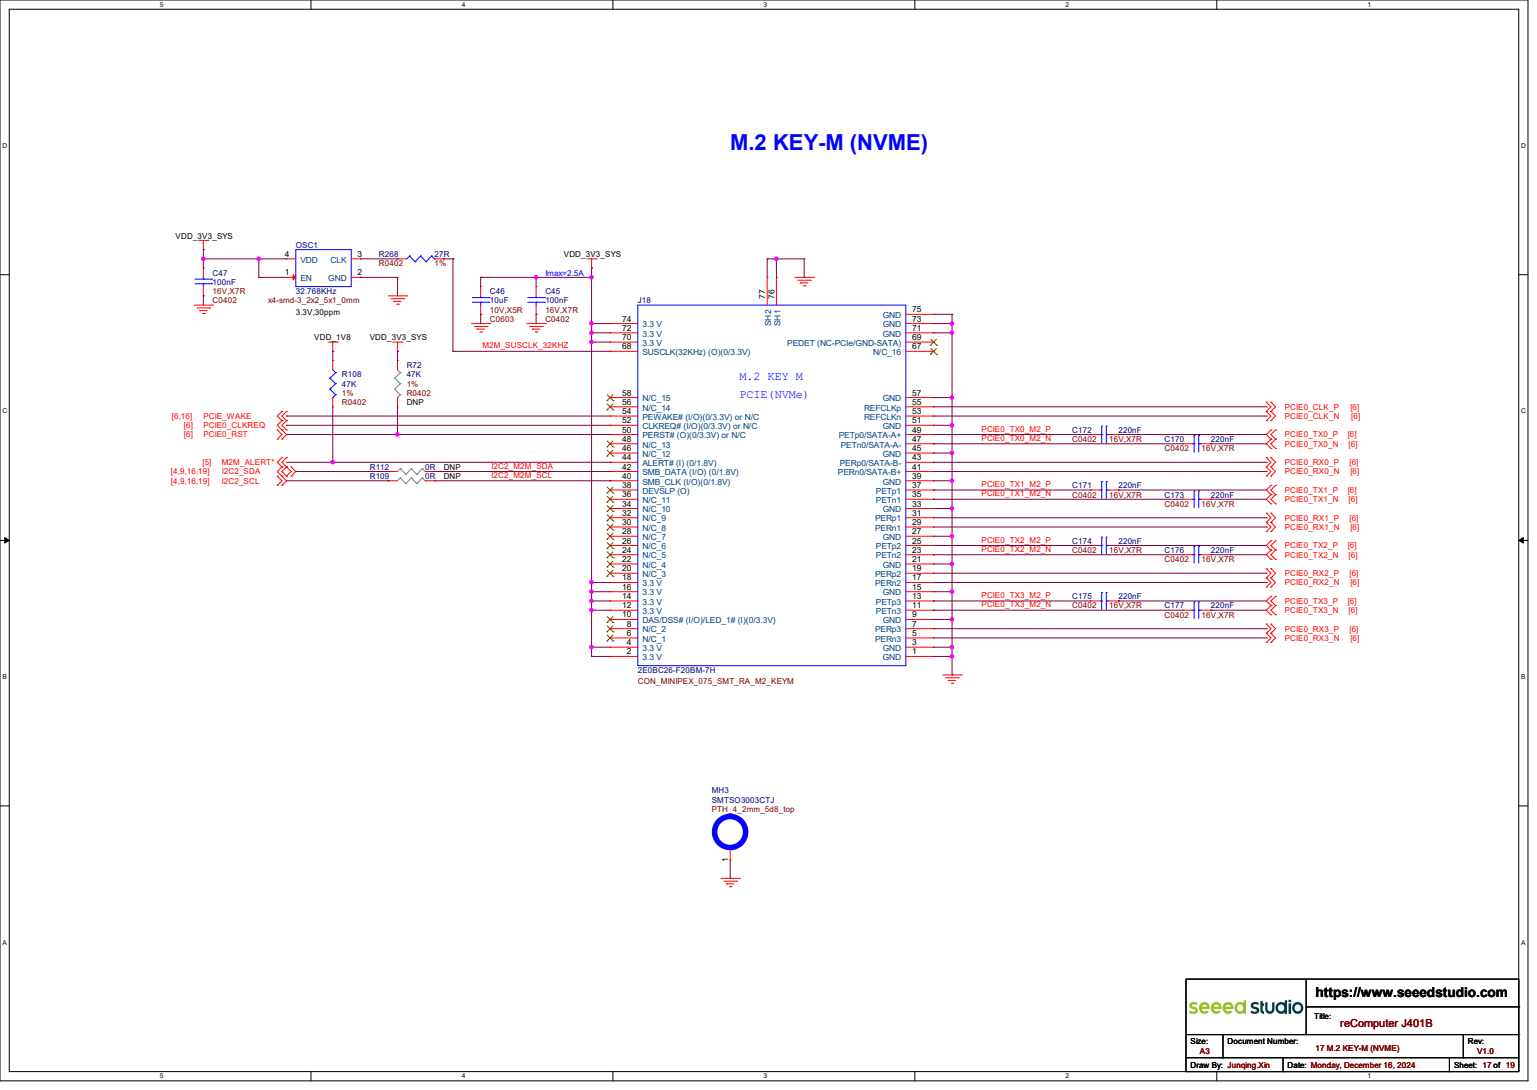
[picture p140: page 17]

PEDET (NC-PCIe/GND-SATA)
M.2 KEY M
PCIE(NVMe)

https://www.seeedstudio.com

# 40PIN GPIO EXPANSION HEADER & LEVEL SHIFTERS

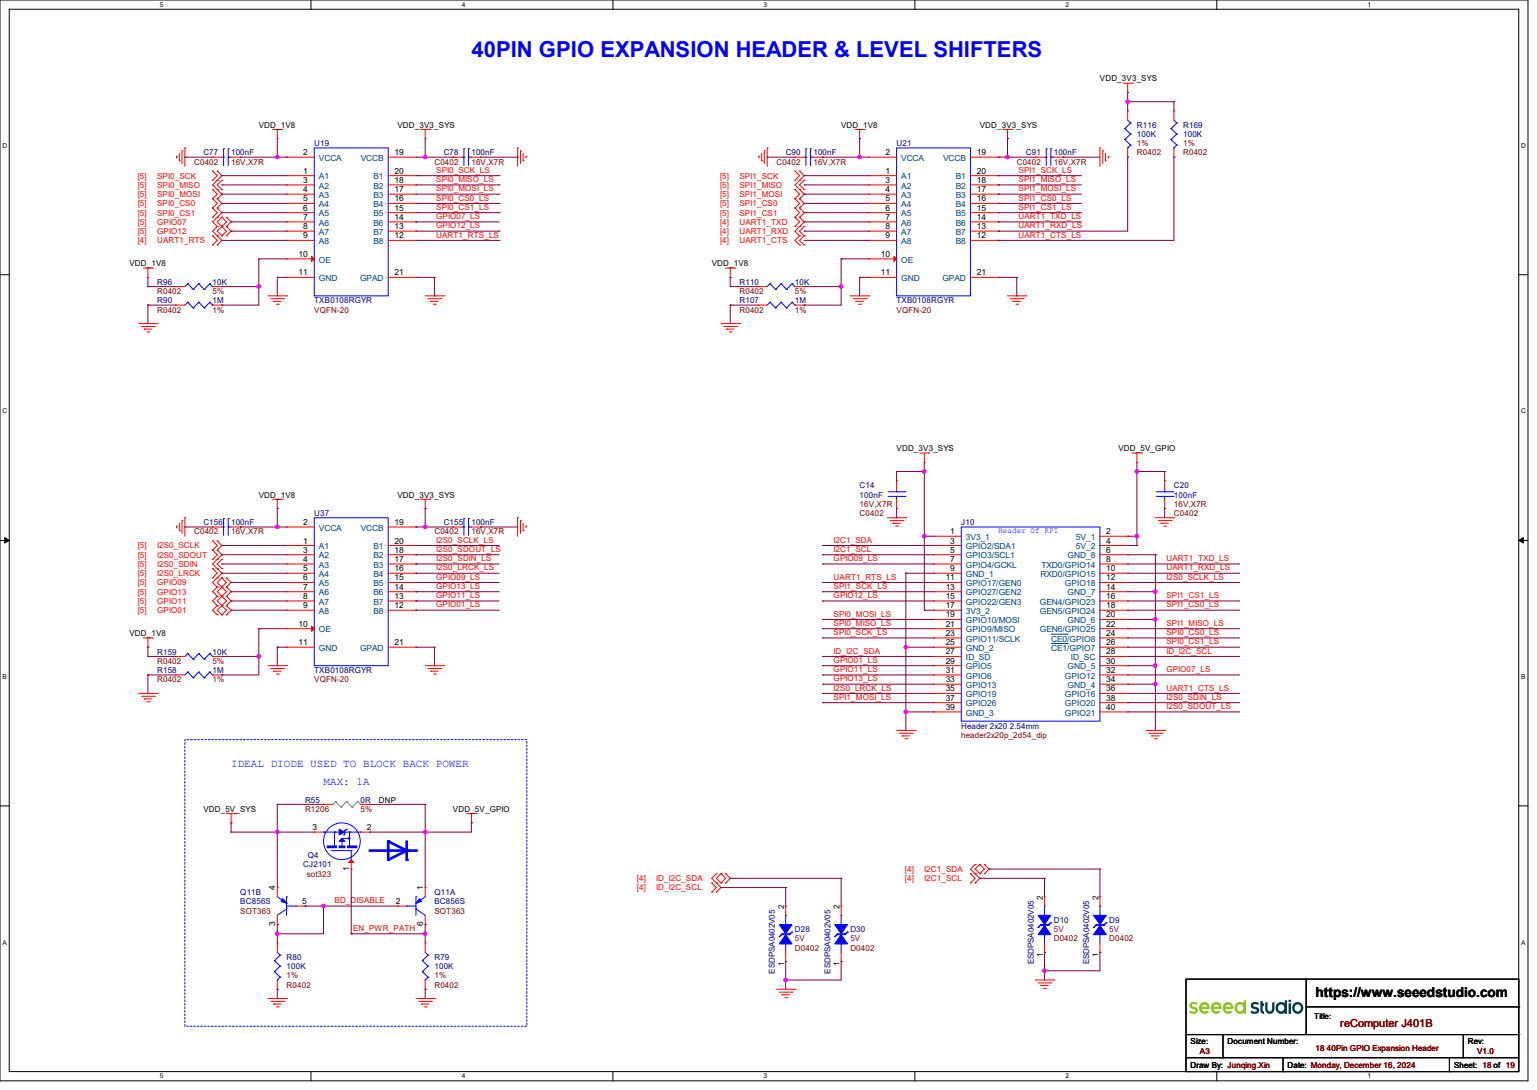
[picture p141: page 18]

IDEAL DIODE USED TO BLOCK BACK POWER

https://www.seeedstudio.com

# SoC Fan Header 4pin

# Carrier Board Config

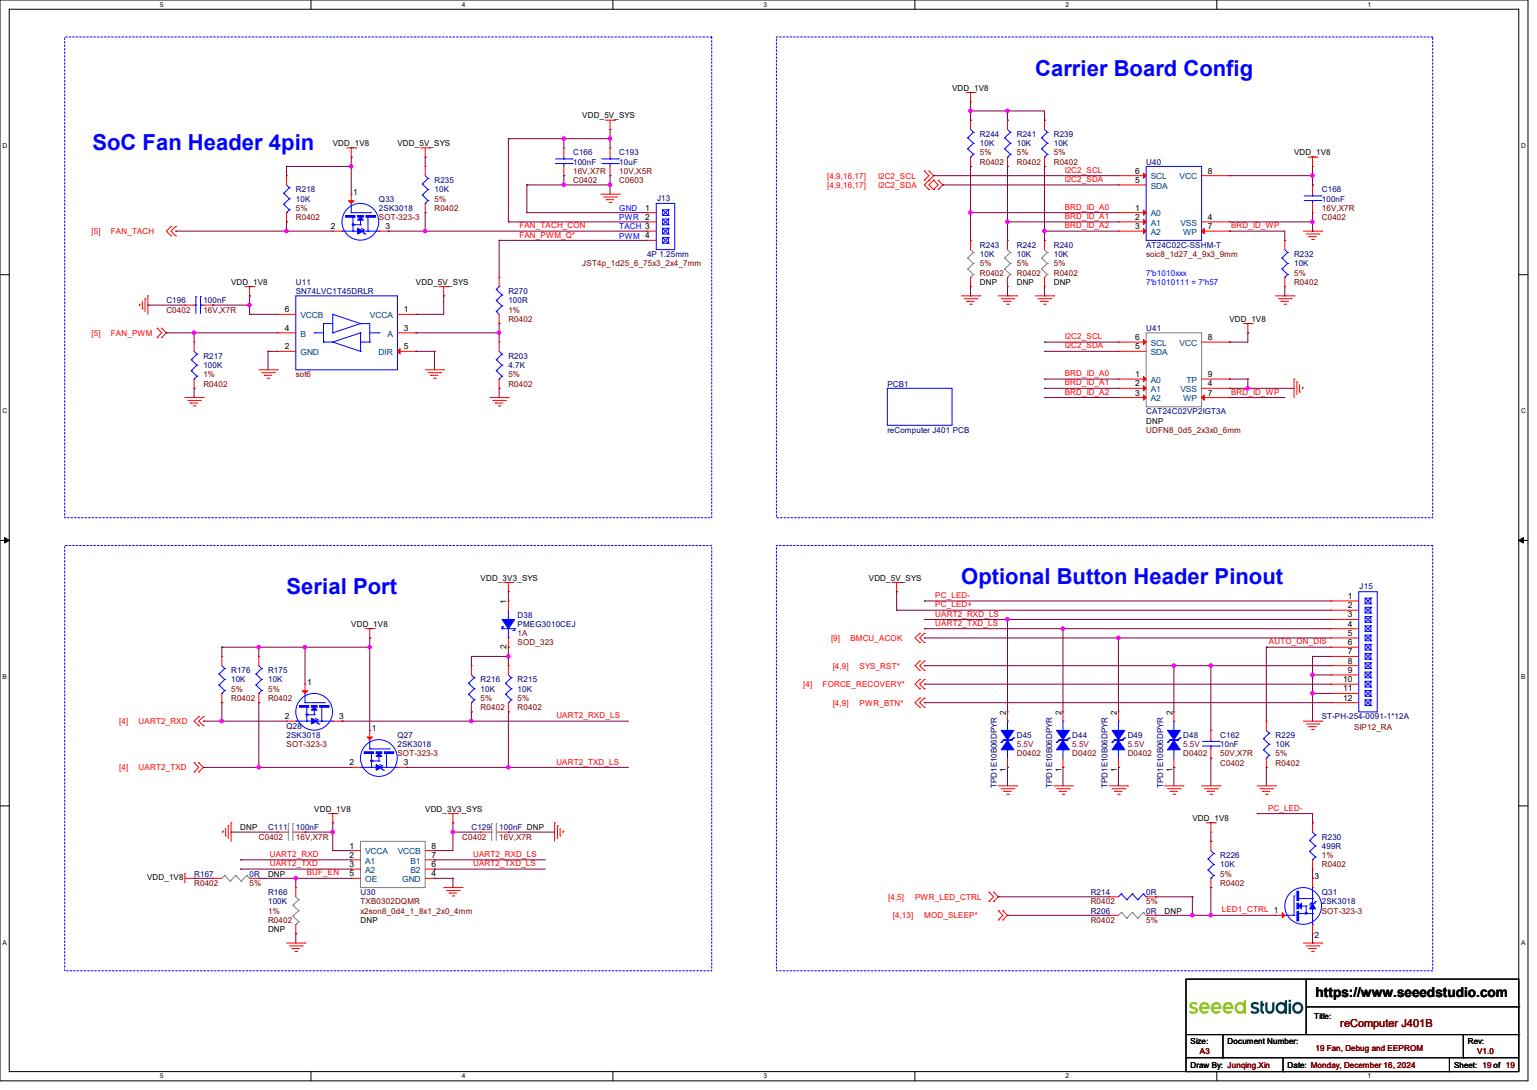
[picture p142: page 19]

Optional Button Header Pinout

https://www.seeedstudio.com

19 Fan, Debug and EEPROM
