Seeed-Studio/OSHW-Jetson-Series/reComputer Jetson carrier board/reComputer J401B/Schematic/reComputer_J401B_LTE_SCH_V1.0.pdf

## LTE_Module

## First release

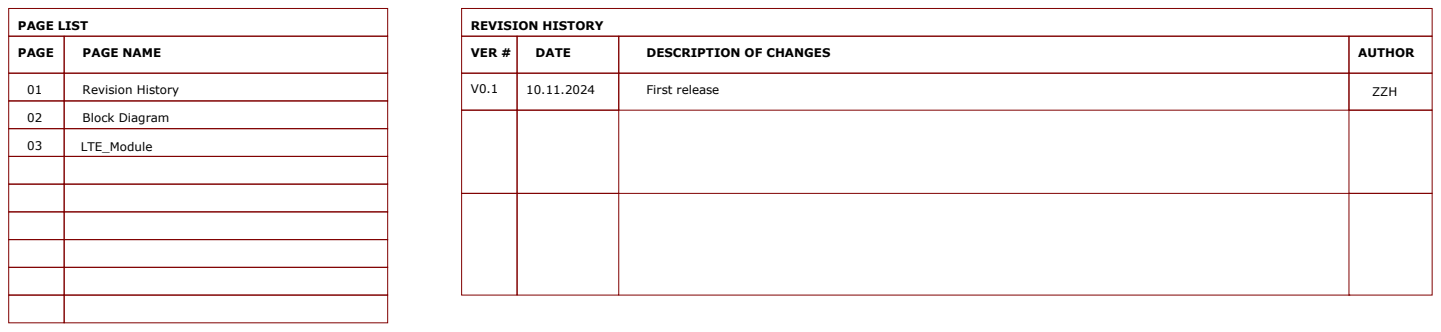
[picture p143: page 1]
PAGE LIST; Revision History; Block Diagram; DATE; PAGE; REVISION HISTORY; ZZH; PAGE NAME; VER #; DESCRIPTION OF CHANGES; AUTHOR; Size:; Document Number:; Rev:; Draw By:; Date:; Sheet:; Linus.Liao; Wednesday, November 20, 2024

https://www.seeedstudio.com

Title:
4G Hat for reComputer J401B

01 Title, Revision History

# 4G Hat for reComputer J401B Block Diagram

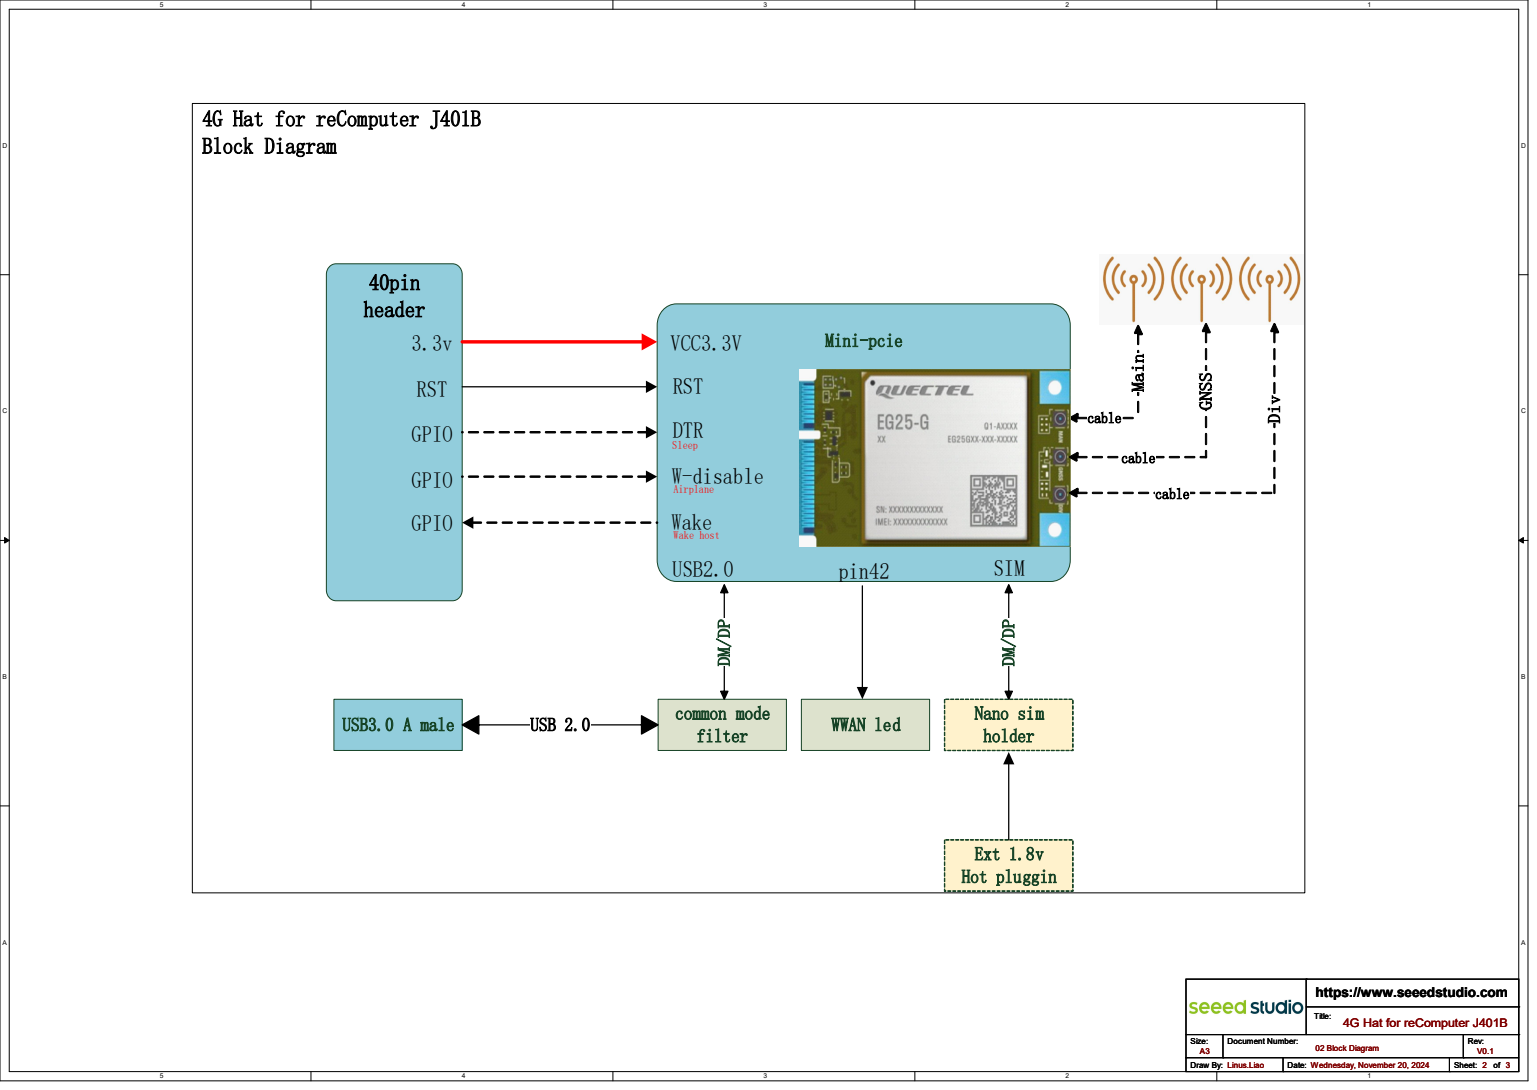
[picture p144: page 2]
common mode filter; cable; Mini-pcie; 40pin header; ain; NSS; Div; USB3.0 A male; USB 2.0; USB2.0; WWAN led; pin42; DTR; W-disable; Wake; RST; VCC3.3V; Sleep; Airplane; Wake host; GPIO; Nano sim holder; SIM; Ext 1.8v Hot pluggin; Linus.Liao; Wednesday, November 20, 2024; 02 Block Diagram

https://www.seeedstudio.com

# Mini PCIe 4G EG25G-S

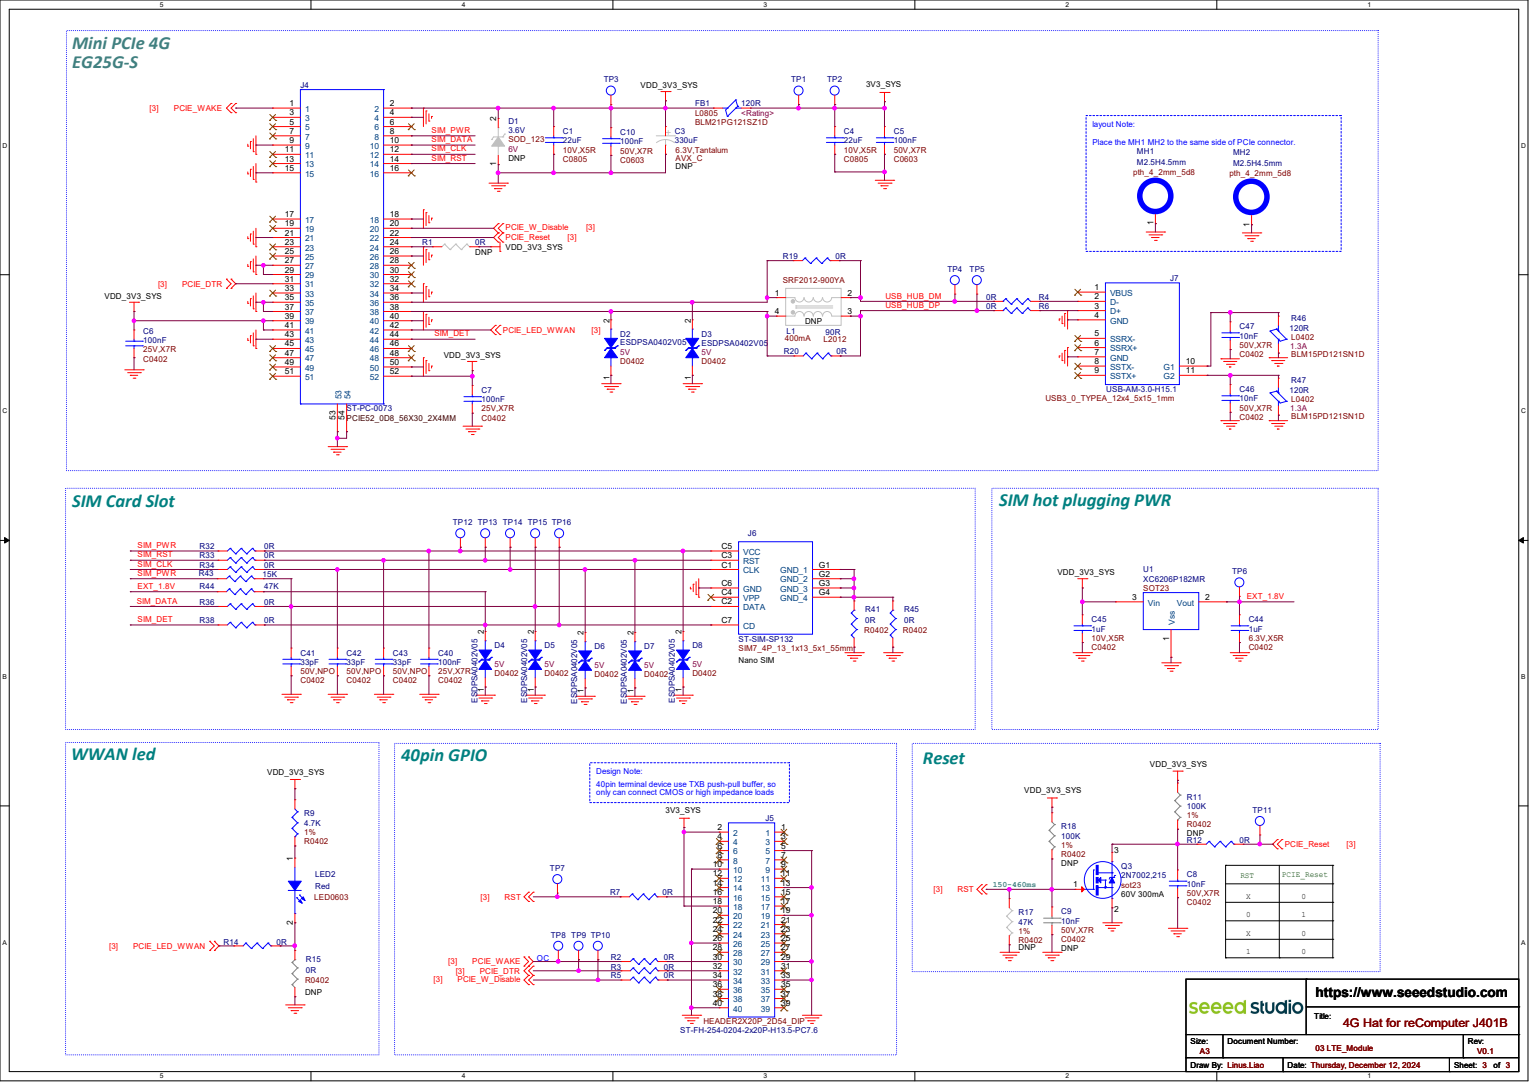
[picture p145: page 3]

layout Note:
Place the MH1 MH2 to the same side of PCIe connector.

Design Note:
40pin terminal device use TXB push-pull buffer, so
only can connect CMOS or high impedance loads

RST | PCIE_Reset

https://www.seeedstudio.com
