Seeed-Studio/OSHW-Jetson-Series/reComputer Jetson carrier board/reComputer Mini J501/Schematic/Power board for reComputer Mini J501_V1.0_SCH_251024.pdf

# 01 Table of Contents

02 | Block Diagram

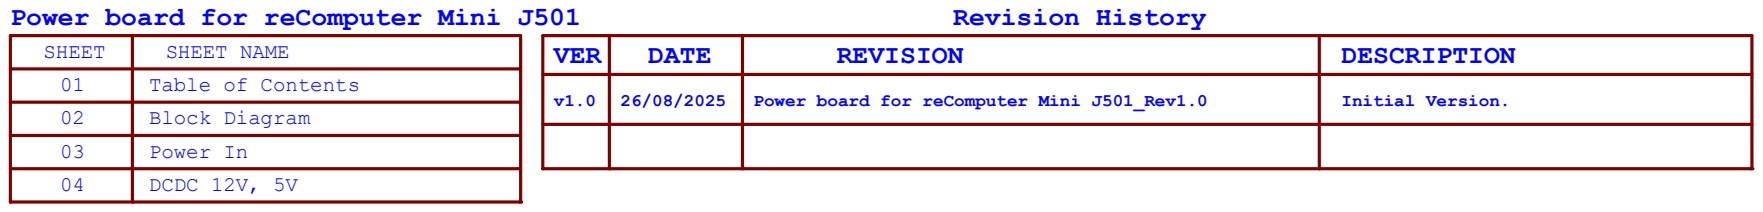
[picture p146: page 1]
SHEET NAME; VER; DATE; REVISION; DESCRIPTION; Revision History; Title: Size:; Document Number:; Rev: Date:; Sheet:; https://www.seeedstudio.com A3; v1.0 Thursday, October 16, 2025; Power board for J501 MINI 01 Table of Contents Title: Size:

Power board for reComputer Mini J501
SHEET

v1.0 | 26/08/2025 | Power board for reComputer Mini J501_Rev1.0 | Initial Version.

03 | Power In
04 DCDC 12V, 5V

Power board for J501 MINI 01 Table of Contents

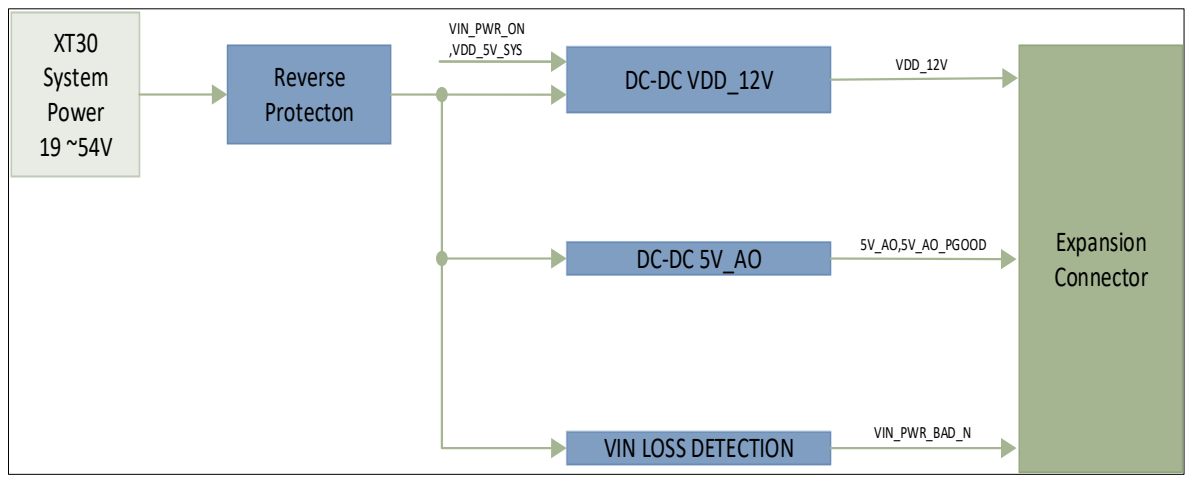
[picture p147: page 2]
XT30 System Power 19 ~54V; Reverse Protecton; DC-DC VDD_12V; VIN_PWR_ON ,VDD_5V_SYS; Expansion Connector; VIN_PWR_BAD_N; 5V_AO,5V_AO_PGOOD; VDD_12V; https://www.seeedstudio.com A3; v1.0 Thursday, October 16, 2025

VIN LOSS DETECTION

Power board for J501 MINI 02 Block Diagram

# 2.2uF x10 =22uF

# Vin protection

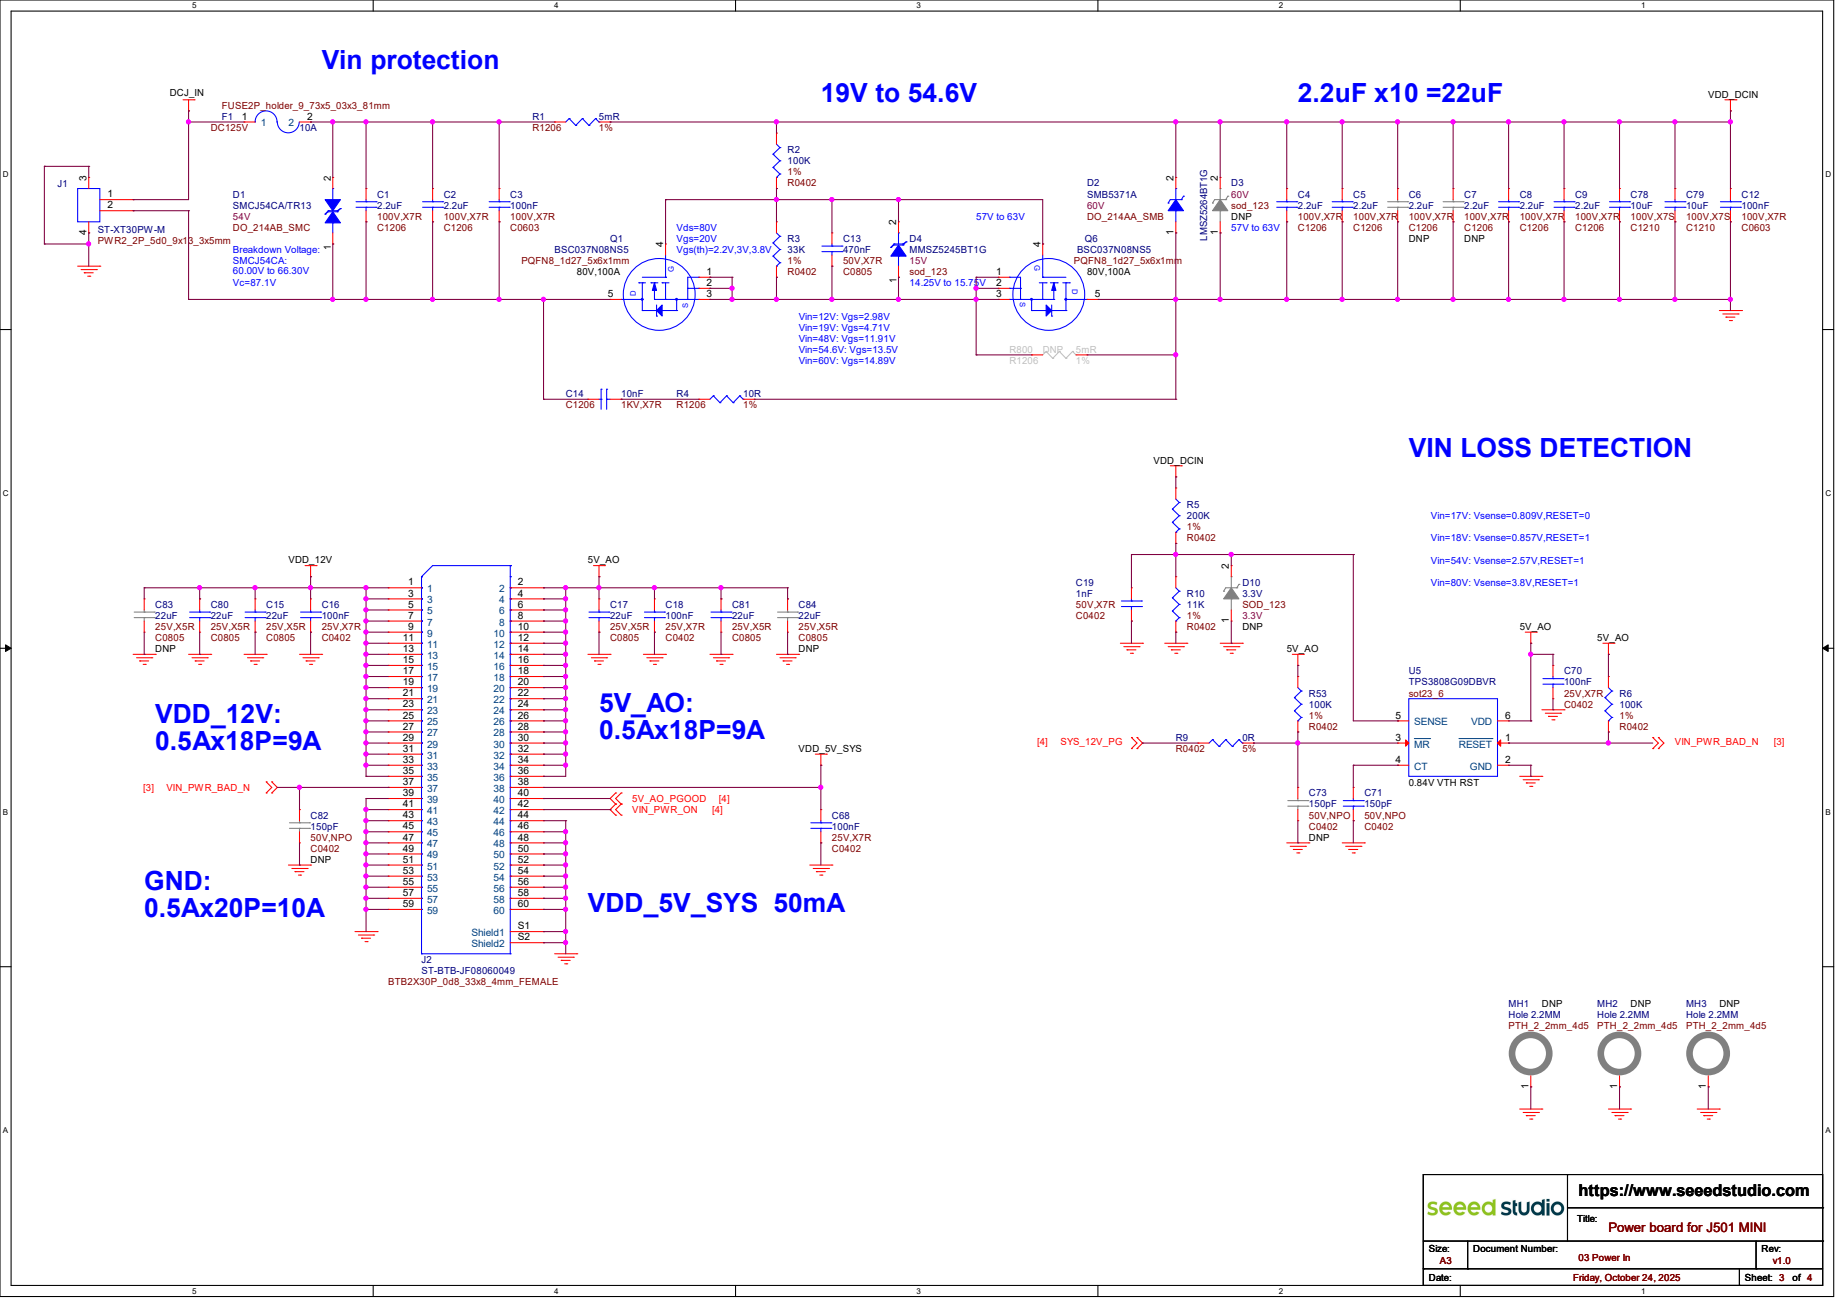
[picture p148: page 3]

Power board for J501 MINI 03 Power In

# VDD_12V

# 48V to 12V, Imax=9A

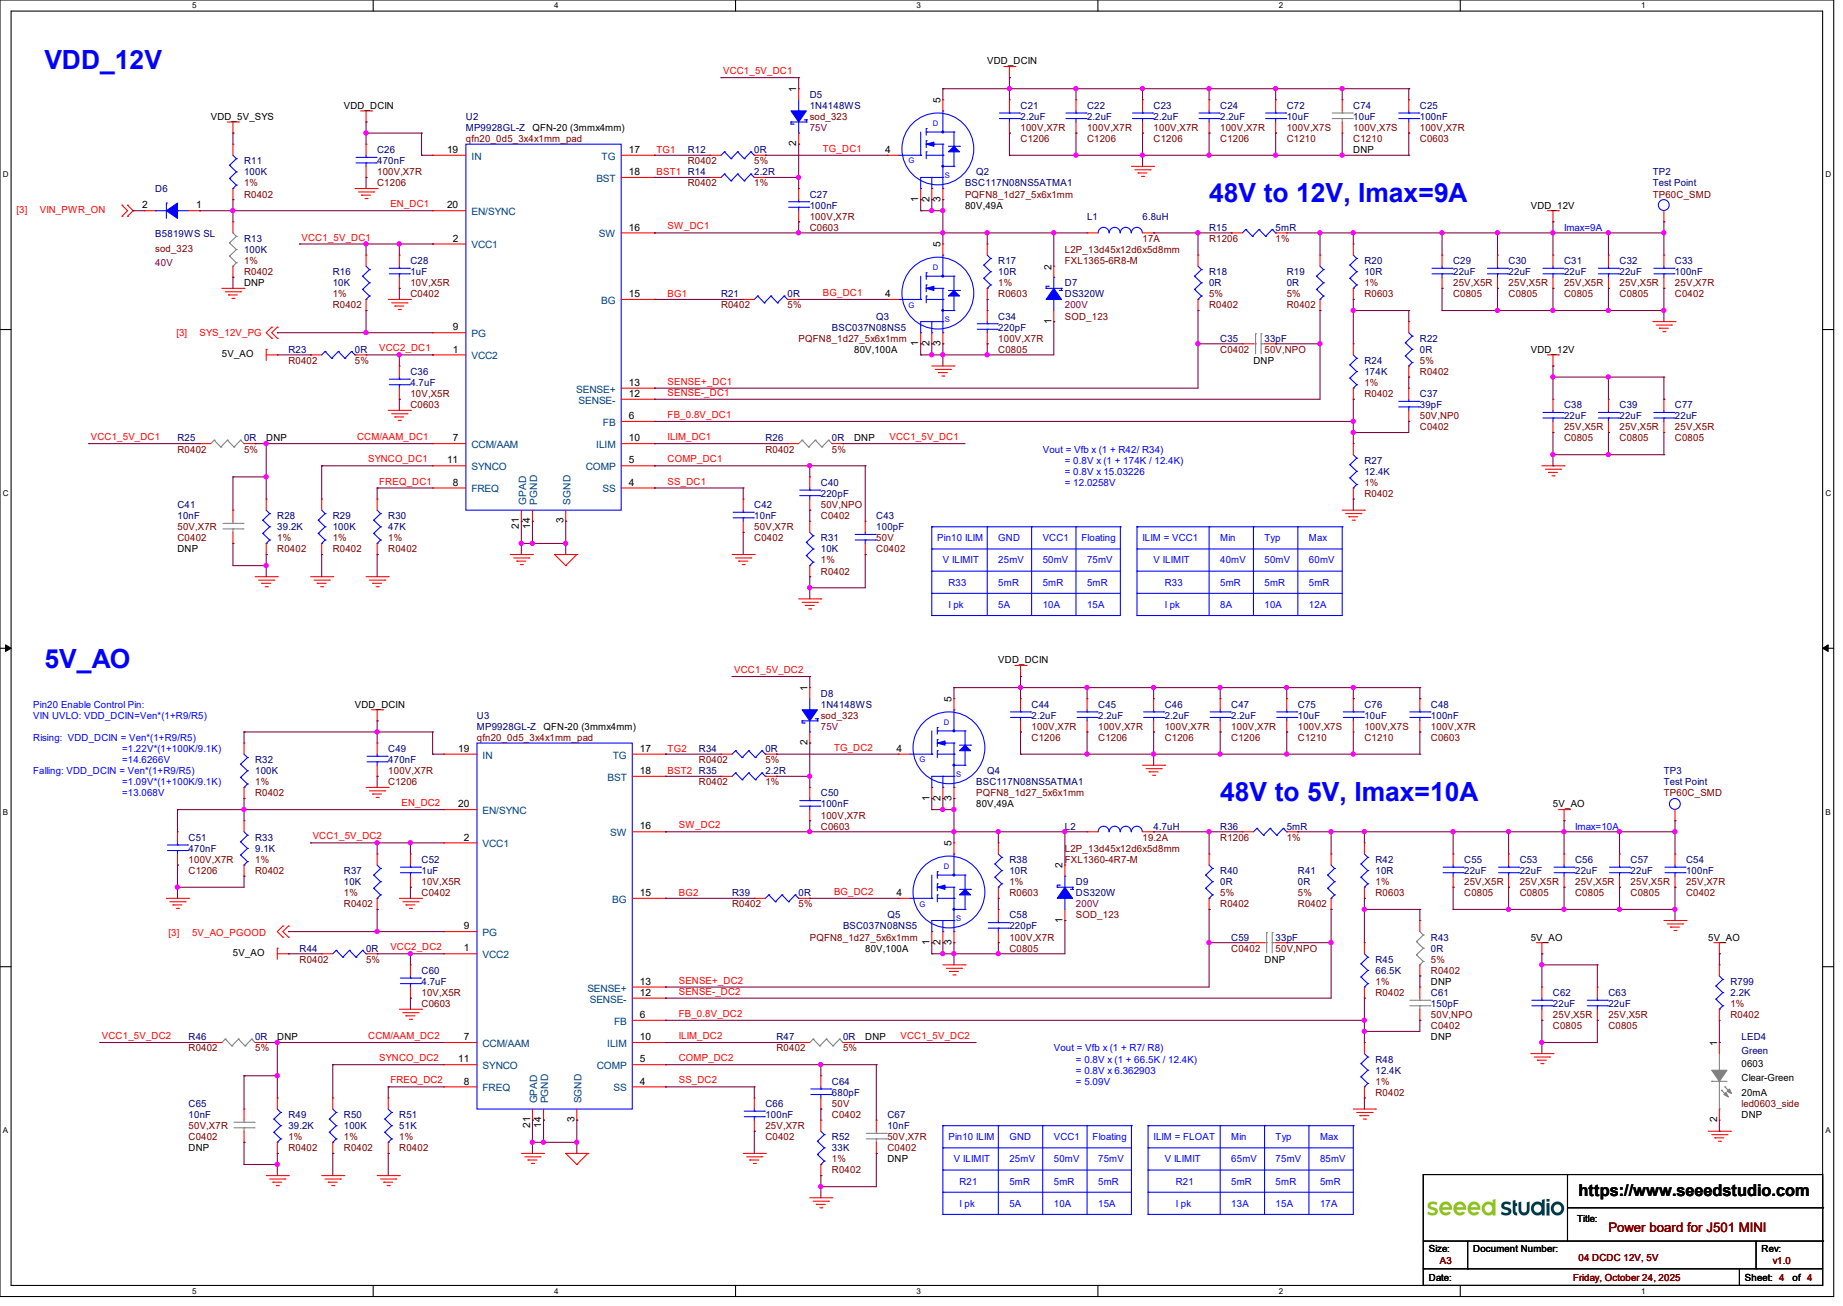
[picture p149: page 4]

3 SS 4 COMP 5 FB 6 CCM/AAM 7 FREQ 8 PG 9

48V to 5V, Imax=10A Pin20 Enable Control Pin:
VIN UVLO: VDD_DCIN=Ven*(1+R9/R5)

Power board for J501 MINI 04 DCDC 12V, 5V
