Seeed-Studio/OSHW-Jetson-Series/reComputer Jetson carrier board/reComputer Mini J501/Schematic/reComputer Mini J501 Carrier Board_Rev1.0_SCH_251027.pdf

# 01 Table of Contents

02 | Block Diagram

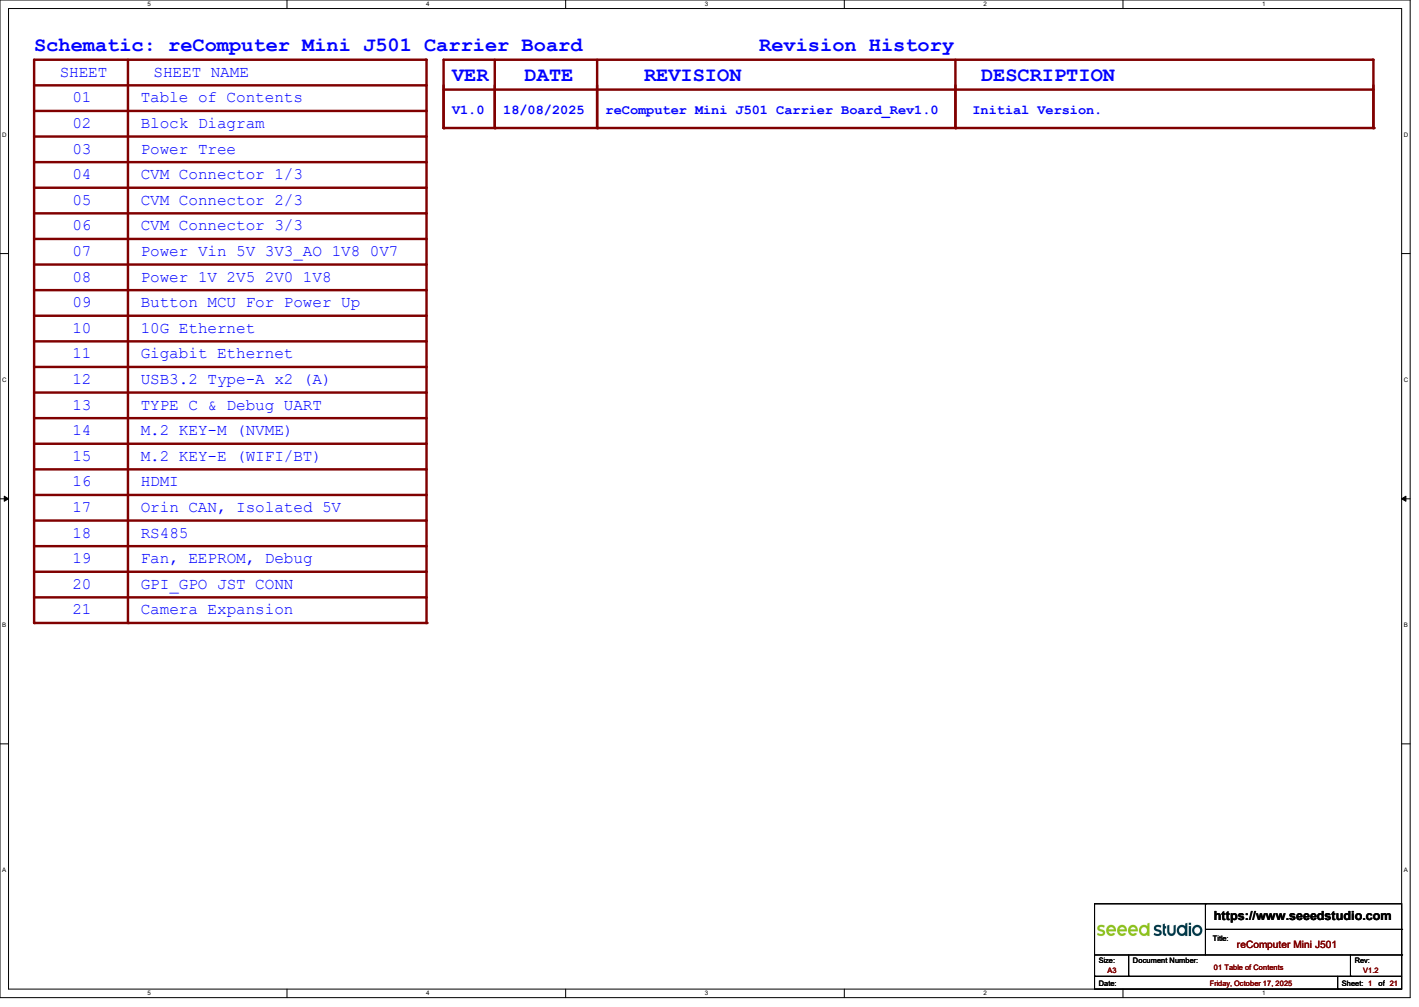
[picture p150: page 1]
SHEET NAME; VER; DATE; REVISION; DESCRIPTION; Revision History; Title: Size:; Document Number:; Rev: Date:; Sheet:; https://www.seeedstudio.com A3; V1.2 Friday, October 17, 2025; reComputer Mini J501 01 Table of Contents Title: Size:

Schematic: reComputer Mini J501 Carrier Board
SHEET

V1.0 | 18/08/2025 | reComputer Mini J501 Carrier Board_Rev1.0 | Initial Version.

03 | Power Tree
04 | CVM Connector 1/3
05 | CVM Connector 2/3
06 | CVM Connector 3/3
07 | Power Vin 5V 3V3_AO 1V8 0V7
08 | Power 1V 2V5 2V0 1V8
09 | Button MCU For Power Up
10 | 10G Ethernet
11 | Gigabit Ethernet
12 | USB3.2 Type-A x2 (A)
13 | TYPE C & Debug UART
14 | M.2 KEY-M (NVME)
15 | M.2 KEY-E (WIFI/BT)
16 | HDMI
17 Orin CAN, Isolated 5V
18 RS485
19 Fan, EEPROM, Debug
20 GPI_GPO JST CONN
21 Camera Expansion

reComputer Mini J501 01 Table of Contents

# Power Sequencer Regs

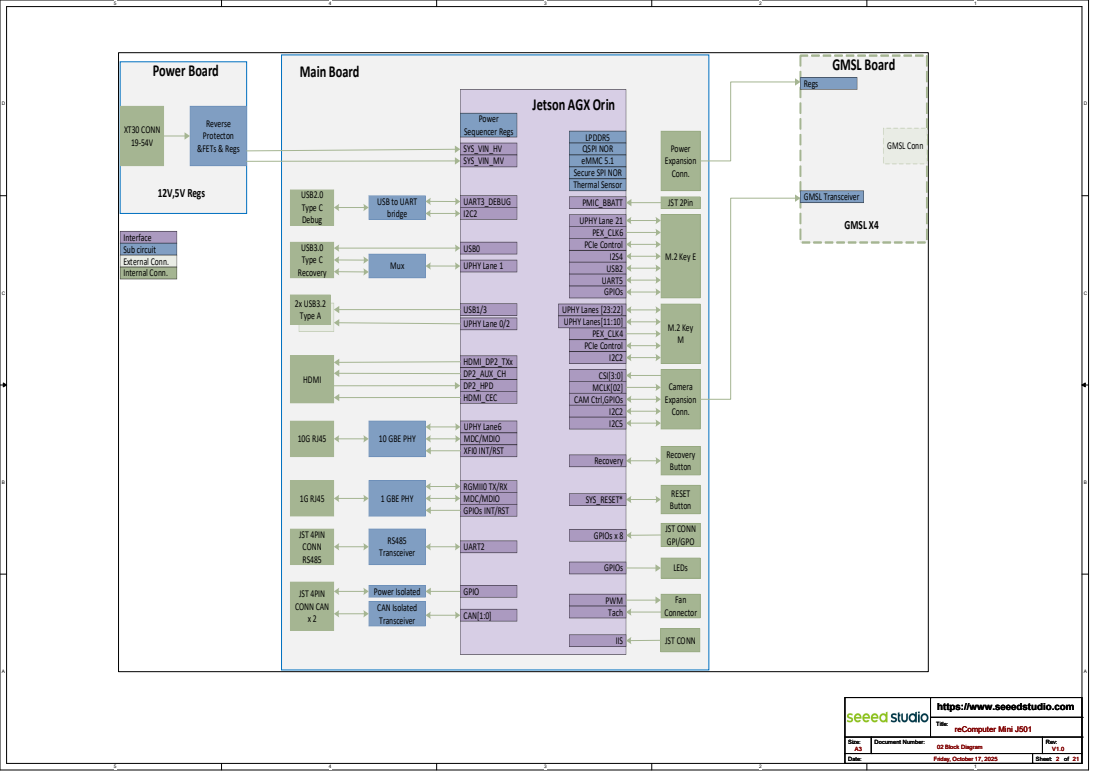
[picture p151: page 2]
USB2.0 Type C Debug; USB3.0 Type C Recovery; M.2 Key M; M.2 Key E; Camera Expansion Conn.; Fan Connector; JST 2Pin; 2x USB3.2 Type A; PMIC_BBATT; SYS_VIN_HV SYS_VIN_MV; USB0 UPHY Lane 1; UPHY Lane 21 PEX_CLK6; PCIe Control; USB2 UART5 GPIOs UPHY Lanes [23:22]; PEX_CLK4 PCIe Control I2C2; UPHY Lanes[11:10]; CSI[3:0] MCLK[02] CAM Ctrl,GPIOs I2C2 I2C5; JST CONN; PWM Tach; Mux; UART3_DEBUG I2C2; HDMI_DP2_TXx DP2_AUX_CH DP2_HPD HDMI_CEC; 10 GBE PHY; UPHY Lane6 MDC/MDIO XFI0 INT/RST; 1 GBE PHY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

GMSL Board Main Board

Jetson AGX Orin

USB to UART
bridge

RGMII0 TX/RX
MDC/MDIO
GPIOs INT/RST

GPI/GPO GPIOs x 8

reComputer Mini J501 02 Block Diagram

XT30 2+2

# System

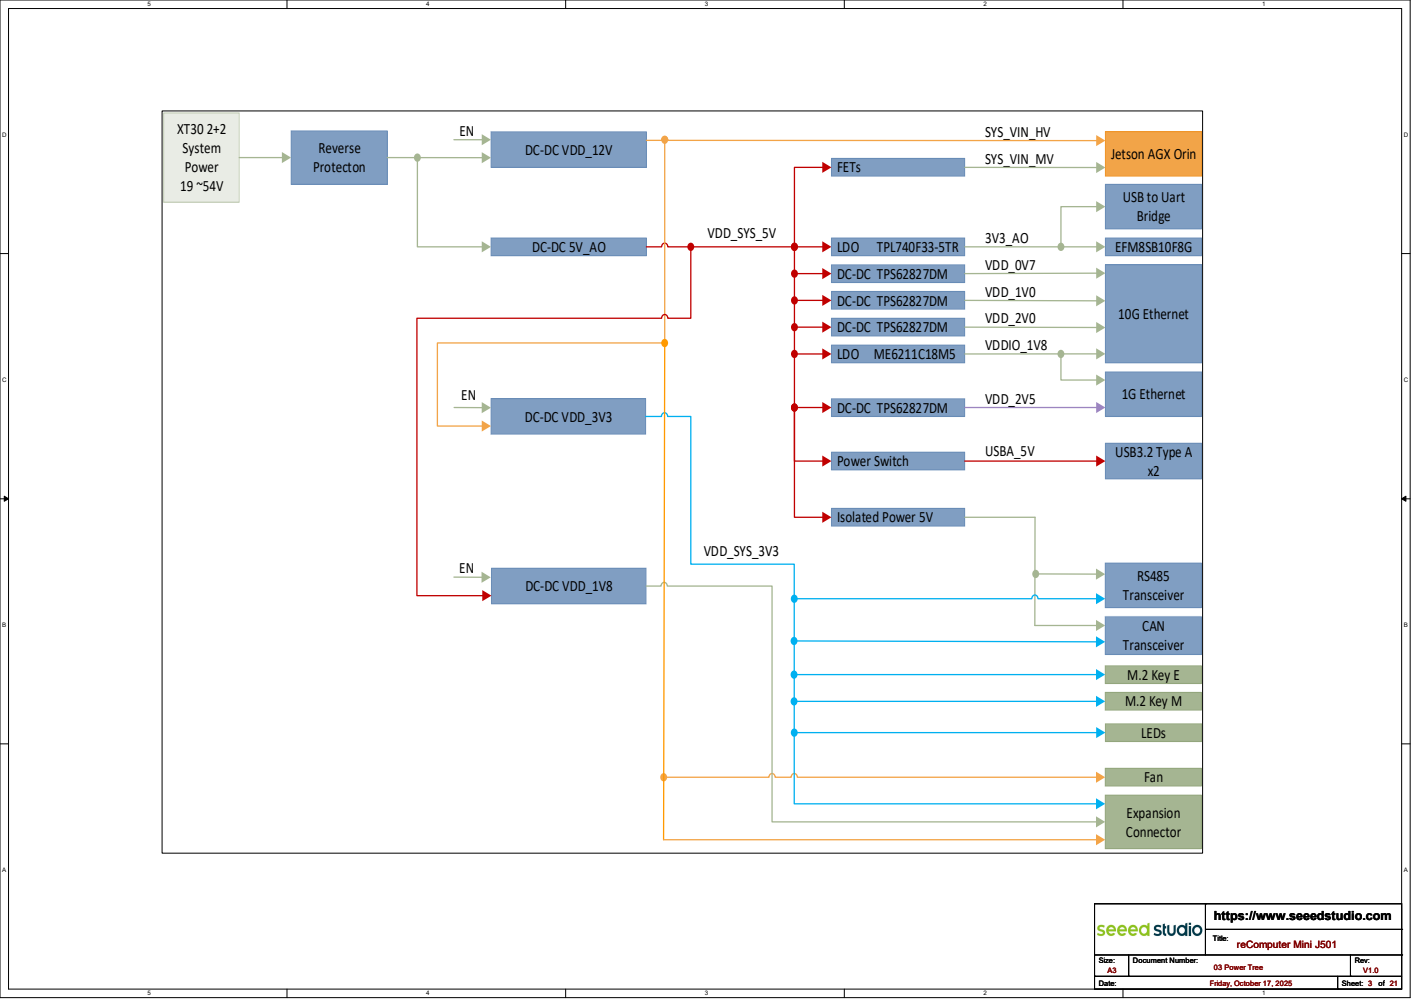
[picture p152: page 3]
Power 19 ~54V; Reverse Protecton; DC-DC VDD_12V; SYS_VIN_HV; FETs; SYS_VIN_MV; Jetson AGX Orin; LDO TPL740F33-5TR; EFM8SB10F8G; DC-DC VDD_3V3; DC-DC TPS62827DM; VDD_0V7; VDD_1V0; VDD_2V0; LDO ME6211C18M5; VDDIO_1V8; 10G Ethernet; 1G Ethernet; RS485 Transceiver; CAN Transceiver; M.2 Key M; M.2 Key E; Fan; VDD_SYS_3V3; DC-DC VDD_1V8; Expansion Connector; VDD_2V5; Isolated Power 5V; Power Switch; USB3.2 Type A; USBA_5V; LEDs; VDD_SYS_5V; https://www.seeedstudio.com A3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

USB to Uart
Bridge

reComputer Mini J501 03 Power Tree

J20 | GND_175 G20 | GND_174 E20 | GND_173 C20 | GND_172 A20 | GND_171 L21 | GND_170 J21 | GND_169 G21 | GND_168 E21 | GND_167 C21 | GND_166 A21 | GND_165 K22 | GND_164 H22 | GND_163 F22 | GND_162 D22 | GND_161 B22 | GND_160 K23 | GND_159 H23 | GND_158 F23 | GND_157 D23 | GND_156 B23 | GND_155 L24 | GND_154 J24 | GND_153 G24 | GND_152 E24 | GND_151 C24 | GND_150 A24 | GND_149 L25 | GND_148 J25 | GND_147 G25 | GND_146 E25 | GND_145 C25 | GND_144 A25 | GND_143 K26 | GND_142 H26 | GND_141 F26 | GND_140 D26 | GND_139 B26 | GND_138 K27 | GND_137 H27 | GND_136 F27 | GND_135 D27 | GND_134 B27 | GND_133 L28 | GND_132 J28 | GND_131 G28 | GND_130 E28 | GND_129 C28 | GND_128 A28 | GND_127 L29 | GND_126 J29 | GND_125 G29 | GND_124 E29 | GND_123 C29 | GND_122 A29 | GND_121 K30 | GND_120 H30 | GND_119 F30 | GND_118 D30 | GND_117 B30 | GND_116 K31 | GND_115 H31 | GND_114 F31 | GND_113 D31 | GND_112 B31 | GND_111 L32 | GND_110 J32 | GND_109 G32 | GND_108 E32 | GND_107 C32 | GND_106 A32 | GND_105 L33 | GND_104 J33 | GND_103 G33 | GND_102 E33 | GND_101 C33 | GND_100 A33 | GND_099 K34 | GND_098 H34 | GND_097 F34 | GND_096 D34 | GND_095 B34 | GND_094 K35 | GND_093 H35 | GND_092 F35 | GND_091 D35 | GND_090 B35 | GND_089 L36 | GND_088 J36 | GND_087 G36 | GND_086 E36 | GND_085 C36 | GND_084 A36 | GND_083 L37 | GND_082 J37 | GND_081 G37 | GND_080 E37 | GND_079 C37 | GND_078 A37 | GND_077 K38 | GND_076 H38 | GND_075 F38 | GND_074 D38 | GND_073 B38 | GND_072 K39 | GND_071 H39 | GND_070 F39 | GND_069 D39 | GND_068 B39 | GND_067 L40 | GND_066
B40 | FSI_GPIO02 D40 | FSI_GPIO01 F40 | FSI_GPIO00 H40 | MID1 K40 | MID0 J1 | SYS_VIN_HV_39 H1 | SYS_VIN_HV_38 G1 | SYS_VIN_HV_37 F1 | SYS_VIN_HV_36 E1 | SYS_VIN_HV_35 D1 | SYS_VIN_HV_34 C1 | SYS_VIN_HV_33 J2 | SYS_VIN_HV_32 H2 | SYS_VIN_HV_31 G2 | SYS_VIN_HV_30 F2 | SYS_VIN_HV_29 E2 | SYS_VIN_HV_28 D2 | SYS_VIN_HV_27 C2 | SYS_VIN_HV_26 K3 | SYS_VIN_HV_25 H3 | SYS_VIN_HV_24 F3 | SYS_VIN_HV_23 D3 | SYS_VIN_HV_22 B3 | SYS_VIN_HV_21 J63 | SYS_VIN_HV_20 G63 | SYS_VIN_HV_19 F63 | SYS_VIN_HV_18 E63 | SYS_VIN_HV_17 C63 | SYS_VIN_HV_16 B63 | SYS_VIN_HV_15 J64 | SYS_VIN_HV_14 H64 | SYS_VIN_HV_13 G64 | SYS_VIN_HV_12 F64 | SYS_VIN_HV_11 E64 | SYS_VIN_HV_10 D64 | SYS_VIN_HV_09 C64 | SYS_VIN_HV_08 J65 | SYS_VIN_HV_07 H65 | SYS_VIN_HV_06 G65 | SYS_VIN_HV_05 F65 | SYS_VIN_HV_04 E65 | SYS_VIN_HV_03 D65 | SYS_VIN_HV_02 C65 | SYS_VIN_HV_01 L22 | SYS_VIN_MV_10 L23 | SYS_VIN_MV_09 L26 | SYS_VIN_MV_08 L27 | SYS_VIN_MV_07 L30 | SYS_VIN_MV_06 L31 | SYS_VIN_MV_05 L34 | SYS_VIN_MV_04 L35 | SYS_VIN_MV_03 L38 | SYS_VIN_MV_02 L39 | SYS_VIN_MV_01

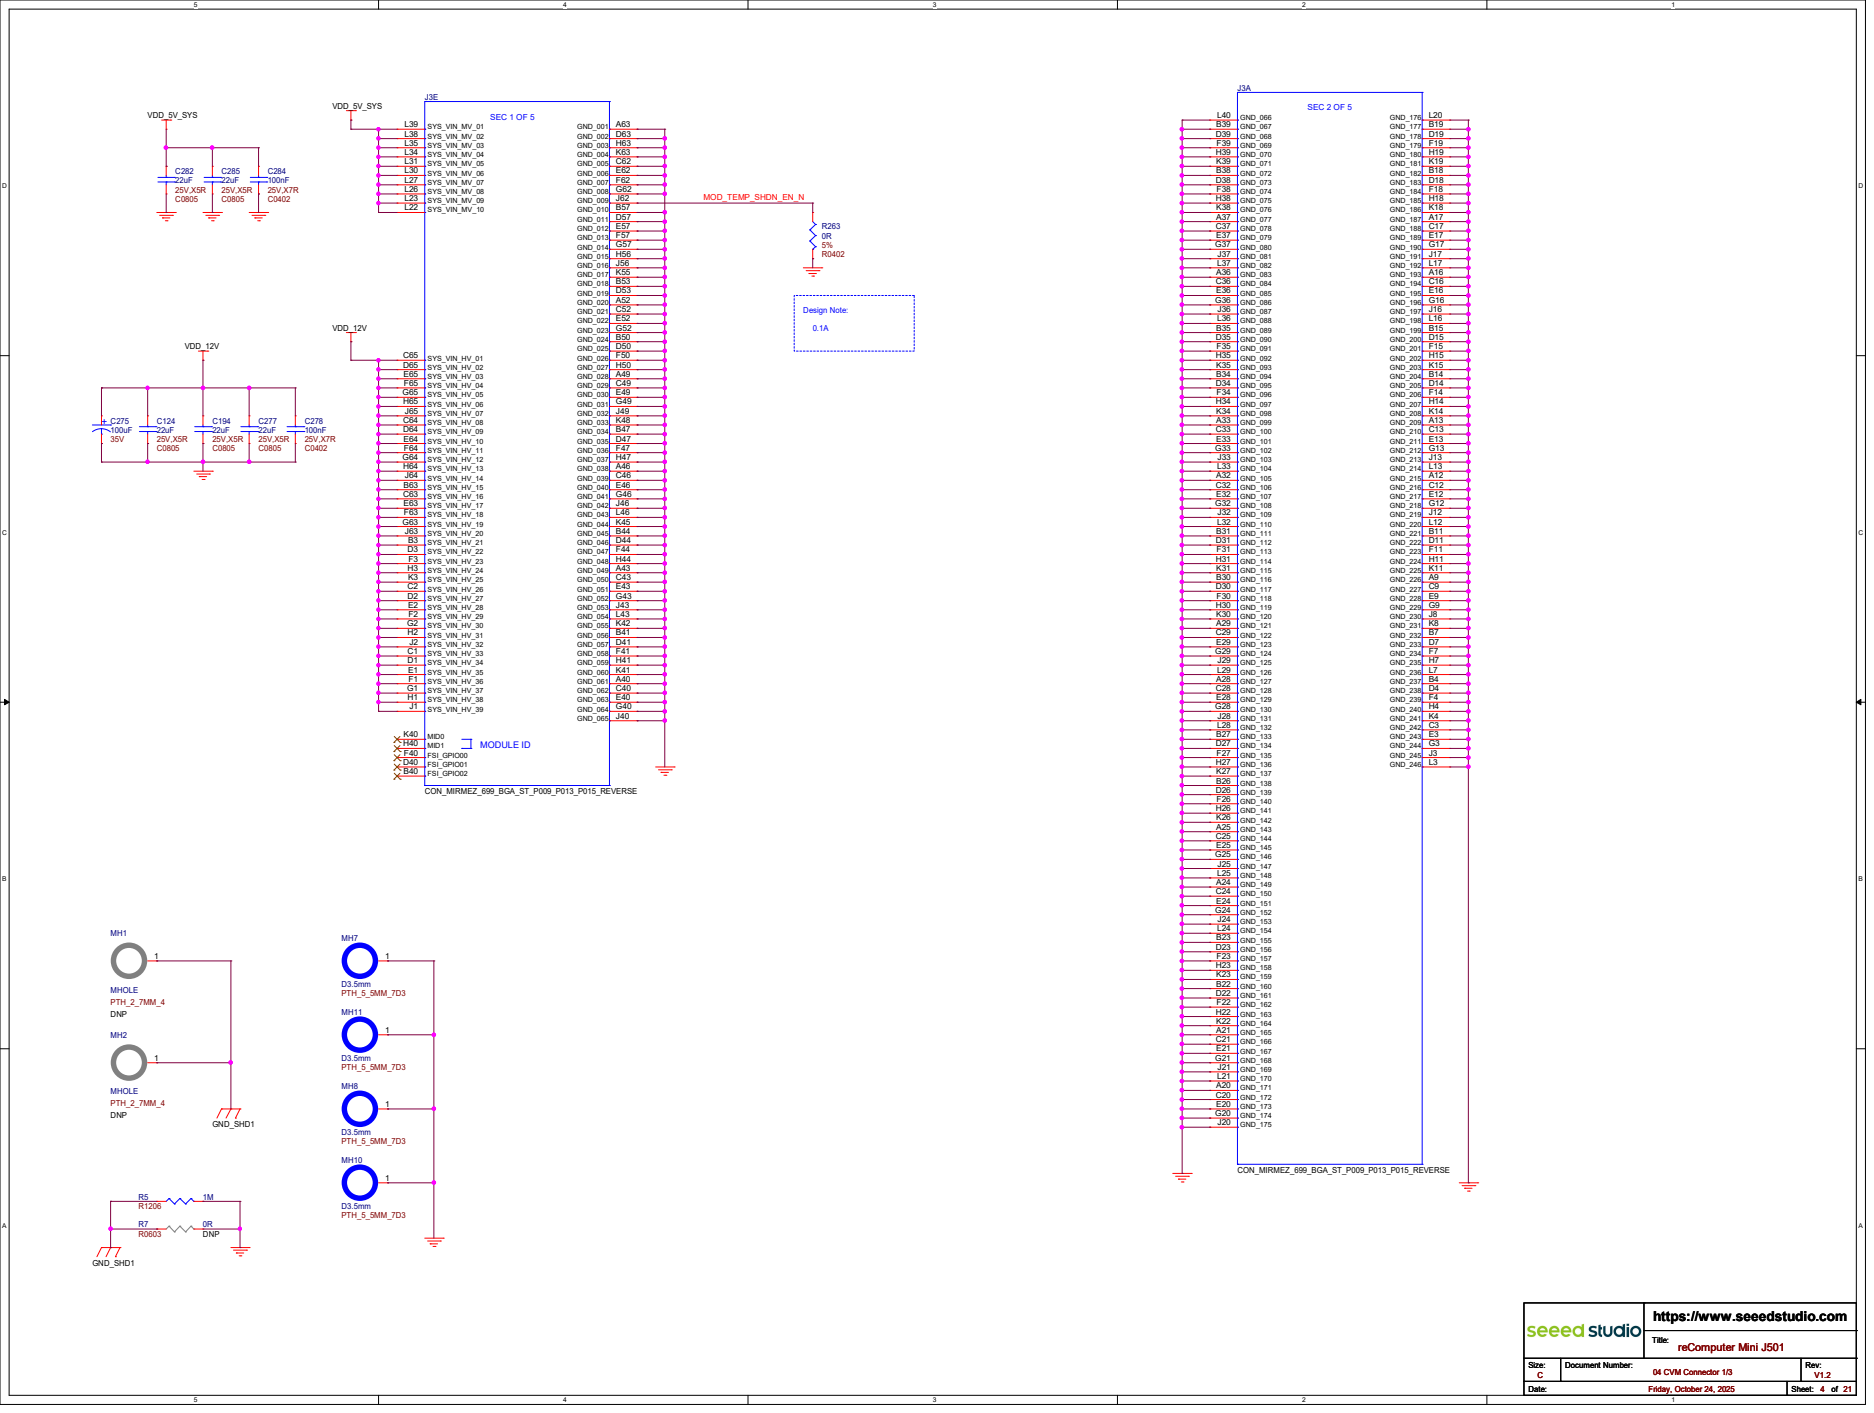
[picture p153: page 4]

reComputer Mini J501 04 CVM Connector 1/3

UART2_TXD | [18] UART2_RTS | [18] M2E_BT_DISABLE_N | [15] XFI0_RST_N | [10] UART5_TXD | [15] UART5_RTS | [15] CAM_SPI_SCK | [21] CAM_SPI_MOSI | [21] CAM_SPI_CS0 | [21] CAM_SPI_CS1 | [21]
TP25 | R89

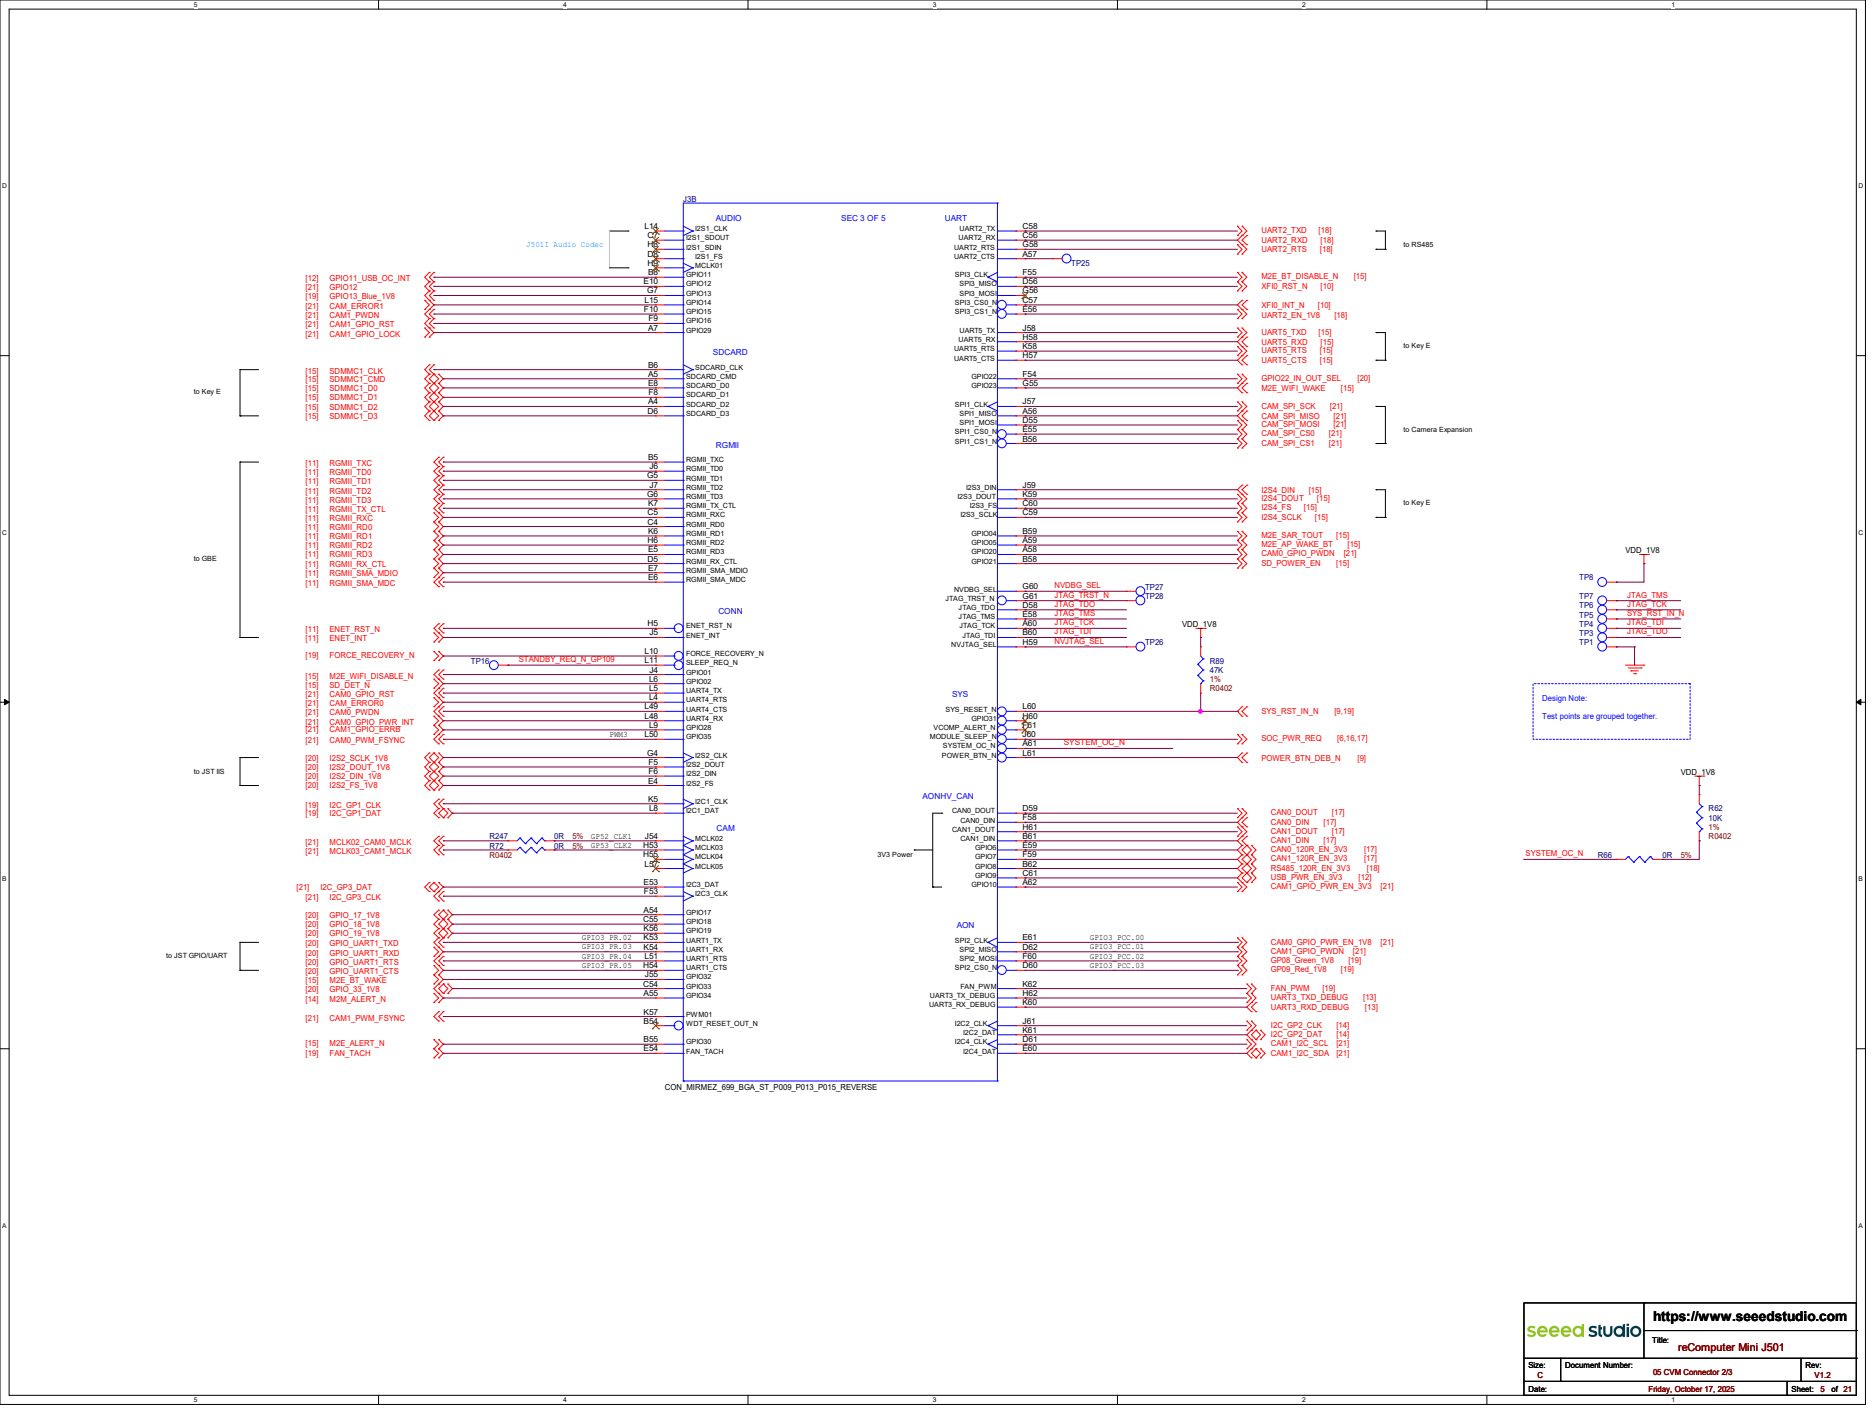
[picture p154: page 5]

reComputer Mini J501 05 CVM Connector 2/3

CSI_0_CLK_N [21] CSI_0_CLK_P [21] CSI_0_D0_N [21] CSI_0_D0_P [21] CSI_0_D1_N [21] CSI_0_D1_P [21] CSI_1_CLK_N [21] CSI_1_CLK_P [21] CSI_1_D0_N [21] CSI_1_D0_P [21] CSI_1_D1_N [21] CSI_1_D1_P [21] CSI_2_CLK_N [21] CSI_2_CLK_P [21] CSI_2_D0_N [21] CSI_2_D0_P [21] CSI_2_D1_N [21] CSI_2_D1_P [21] CSI_3_CLK_N [21] CSI_3_CLK_P [21] CSI_3_D0_N [21] CSI_3_D0_P [21] CSI_3_D1_N [21] CSI_3_D1_P [21] CSI_4_CLK_N [21] CSI_4_CLK_P [21] CSI_4_D0_N [21] CSI_4_D0_P [21] CSI_4_D1_N [21] CSI_4_D1_P [21] CSI_5_CLK_N [21] CSI_5_CLK_P [21] CSI_5_D0_N [21] CSI_5_D0_P [21] CSI_5_D1_N [21] CSI_5_D1_P [21] CSI_6_CLK_N [21] CSI_6_CLK_P [21] CSI_6_D0_N [21] CSI_6_D0_P [21] CSI_6_D1_N [21] CSI_6_D1_P [21] CSI_7_CLK_N [21] CSI_7_CLK_P [21] CSI_7_D0_N [21] CSI_7_D0_P [21] CSI_7_D1_N [21] CSI_7_D1_P [21]

UPHY_TX0_N | [12] UPHY_TX0_P [12] UPHY_TX1_P [13] UPHY_TX1_N | [13] UPHY_TX10_N | [14] UPHY_TX10_P [14] UPHY_TX11_N | [14] UPHY_TX11_P [14] UPHY_TX6_N | [10] UPHY_TX6_P [10] UPHY_RX0_N | [12] UPHY_RX0_P | [12] UPHY_RX1_N | [13] UPHY_RX1_P | [13] UPHY_RX6_N | [10] UPHY_RX6_P | [10] UPHY_RX10_N | [14] UPHY_RX10_P | [14] UPHY_RX11_N | [14] UPHY_RX11_P | [14] PCIE4_CLK_N [14] PCIE4_CLK_P [14] PCIE4_RST_N [14] PCIE4_CLKREQ_N | [14] UFS0_REF_CLK [14] UFS0_RST_N [14] PCIE_WAKE_N [14] USBC_VBUS [13] USBC_ID [13]

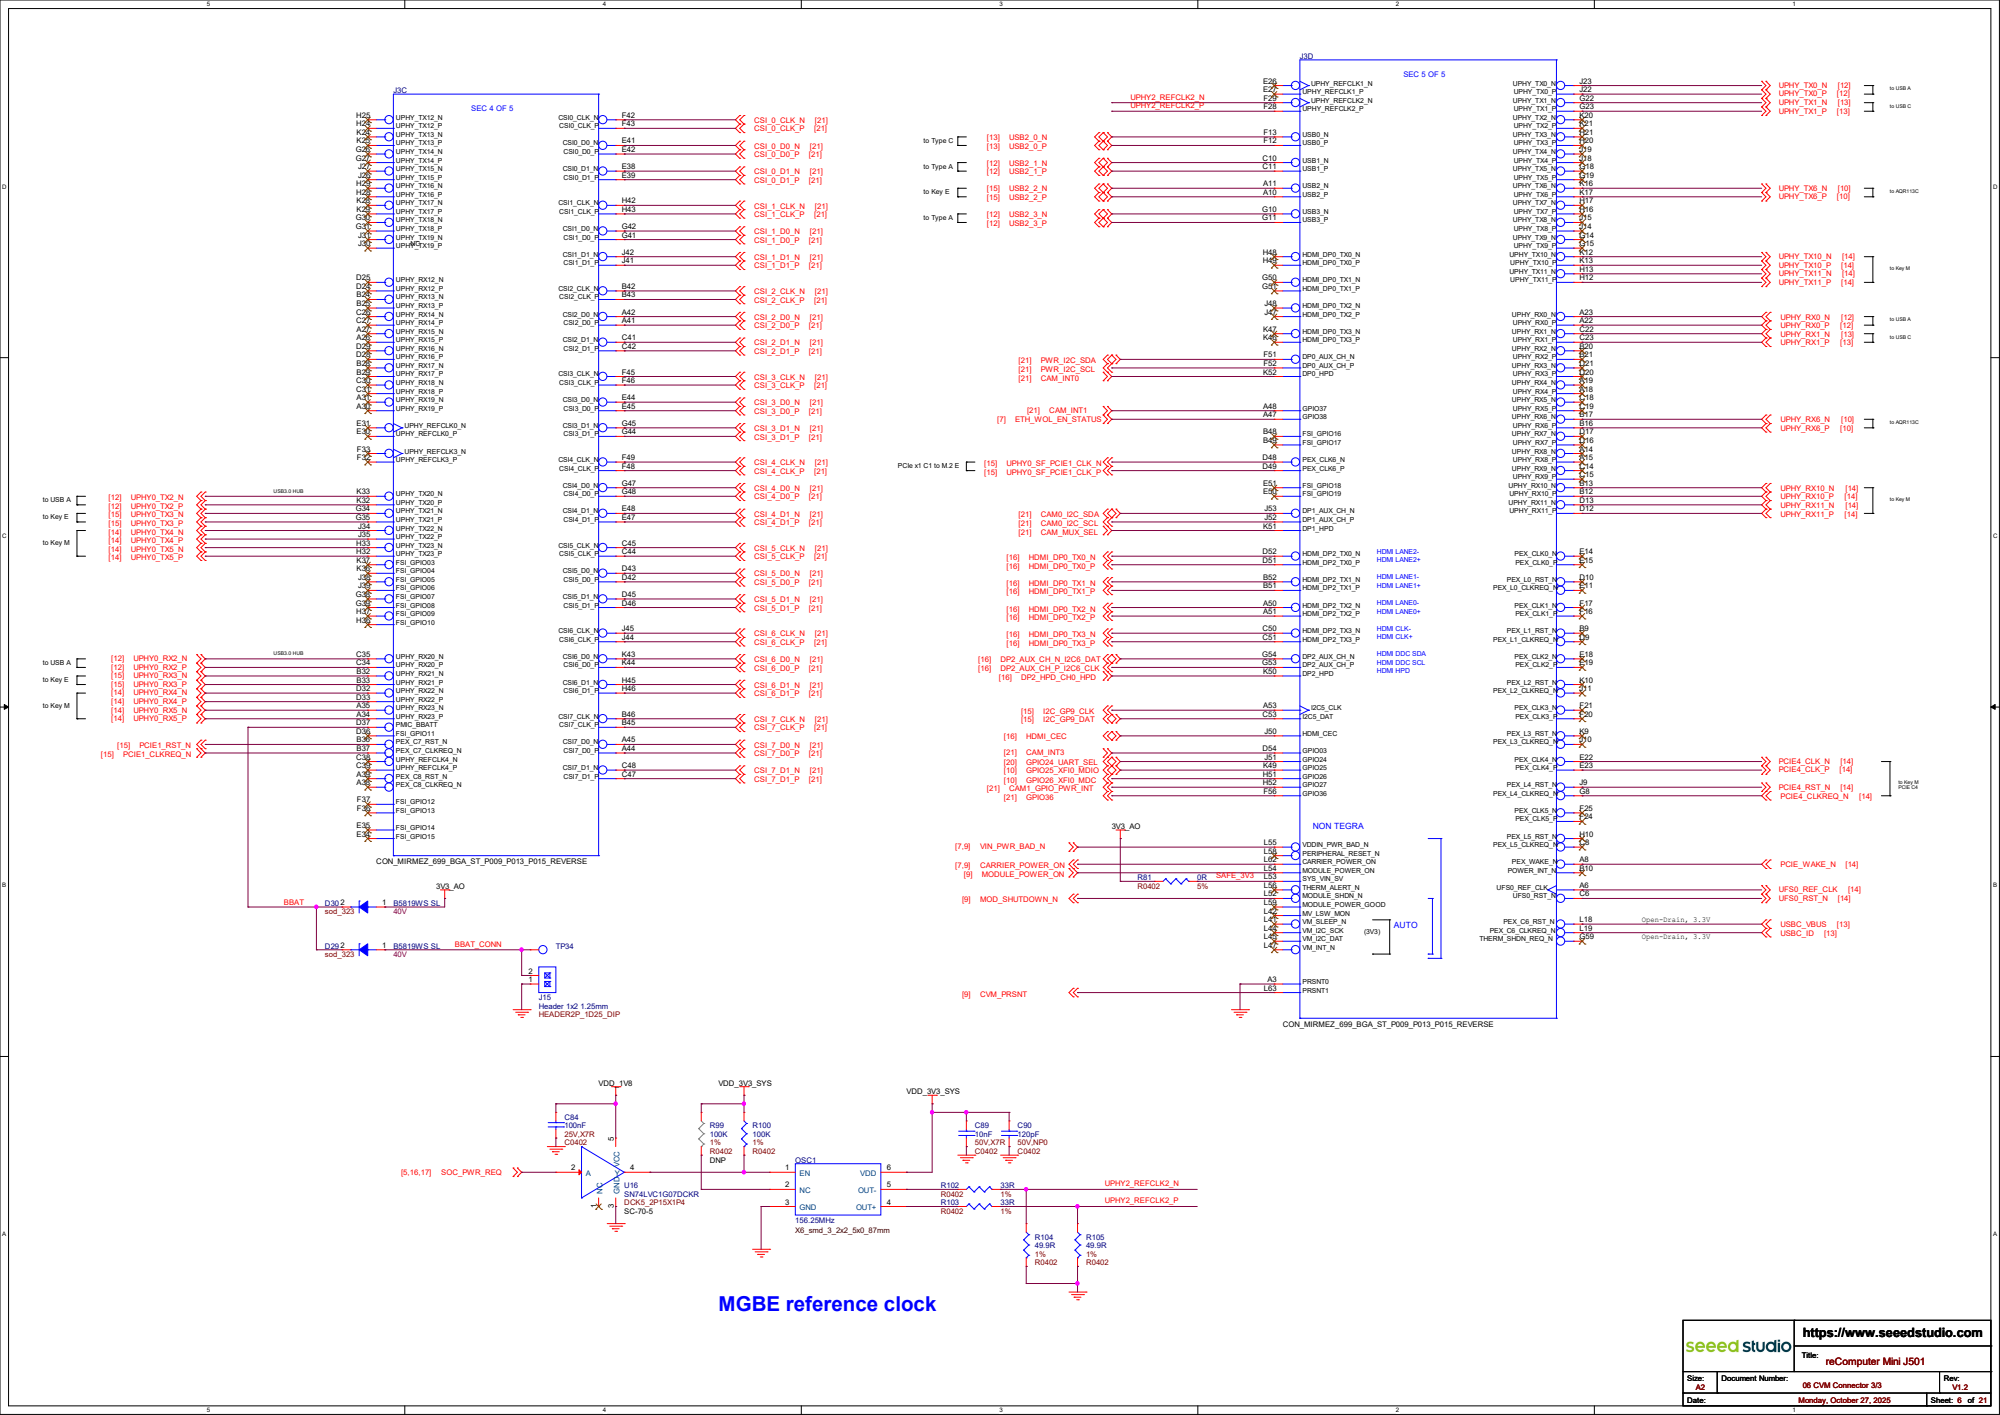
[picture p155: page 6]

reComputer Mini J501 06 CVM Connector 3/3 U16 SN74LVC1G07DCKR

# VDD_0V7

# VDD_12V:

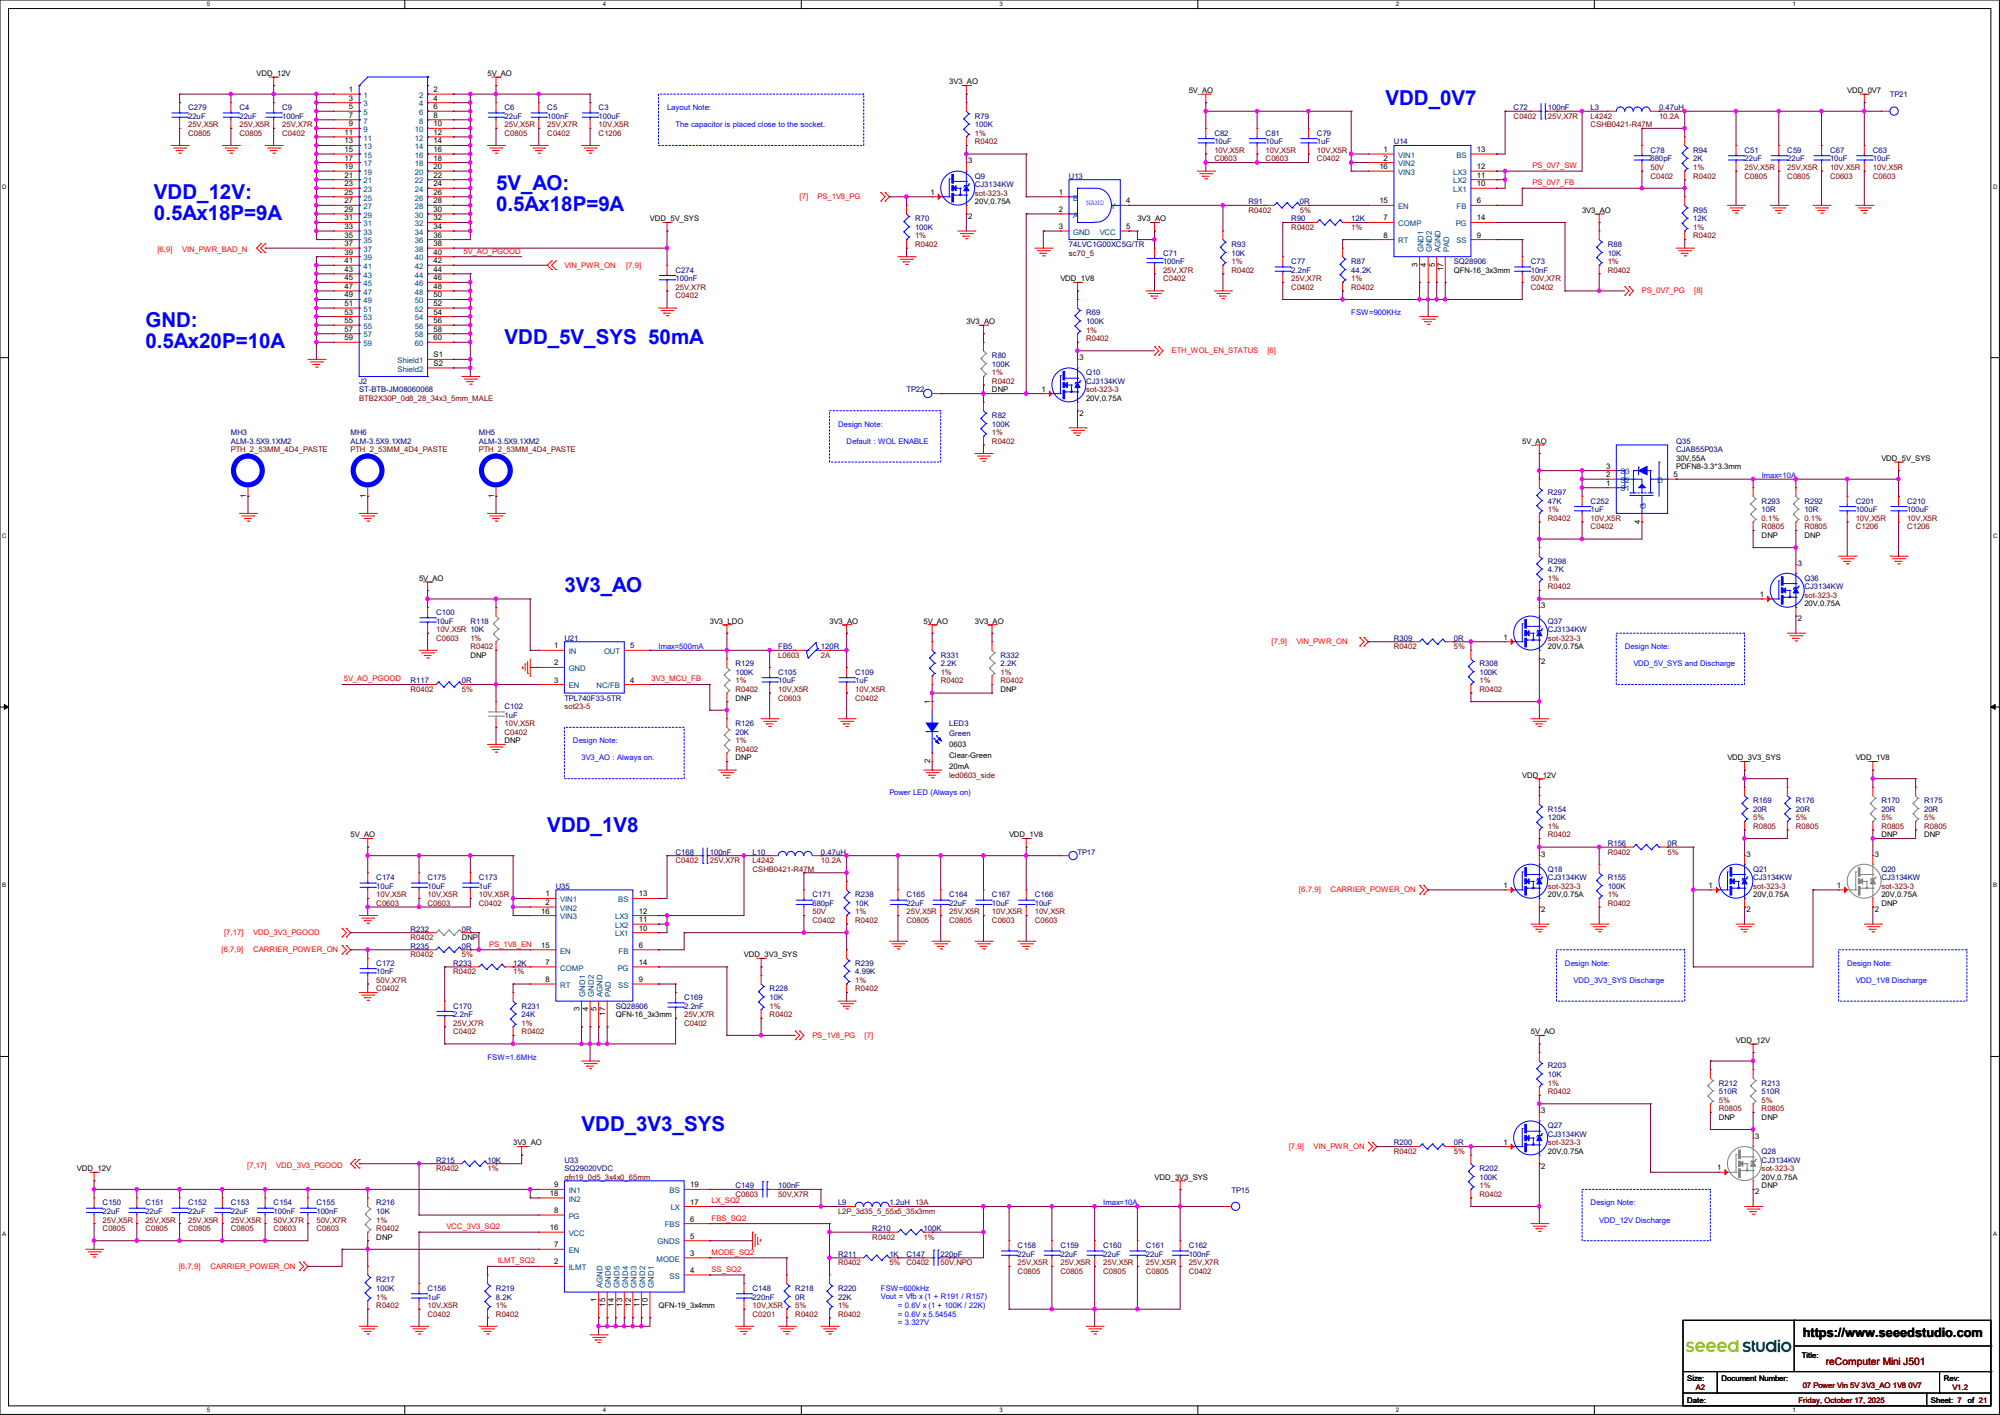
[picture p156: page 7]

Layout Note: The capacitor is placed close to the socket.

Imax=10A VDD_5V_SYS and Discharge Design Note: VDD_3V3_SYS Discharge Design Note: VDD_12V Discharge Design Note:

Design Note: Default : WOL ENABLE

Power LED (Always on)

# VDD_1V0

R0402 R78

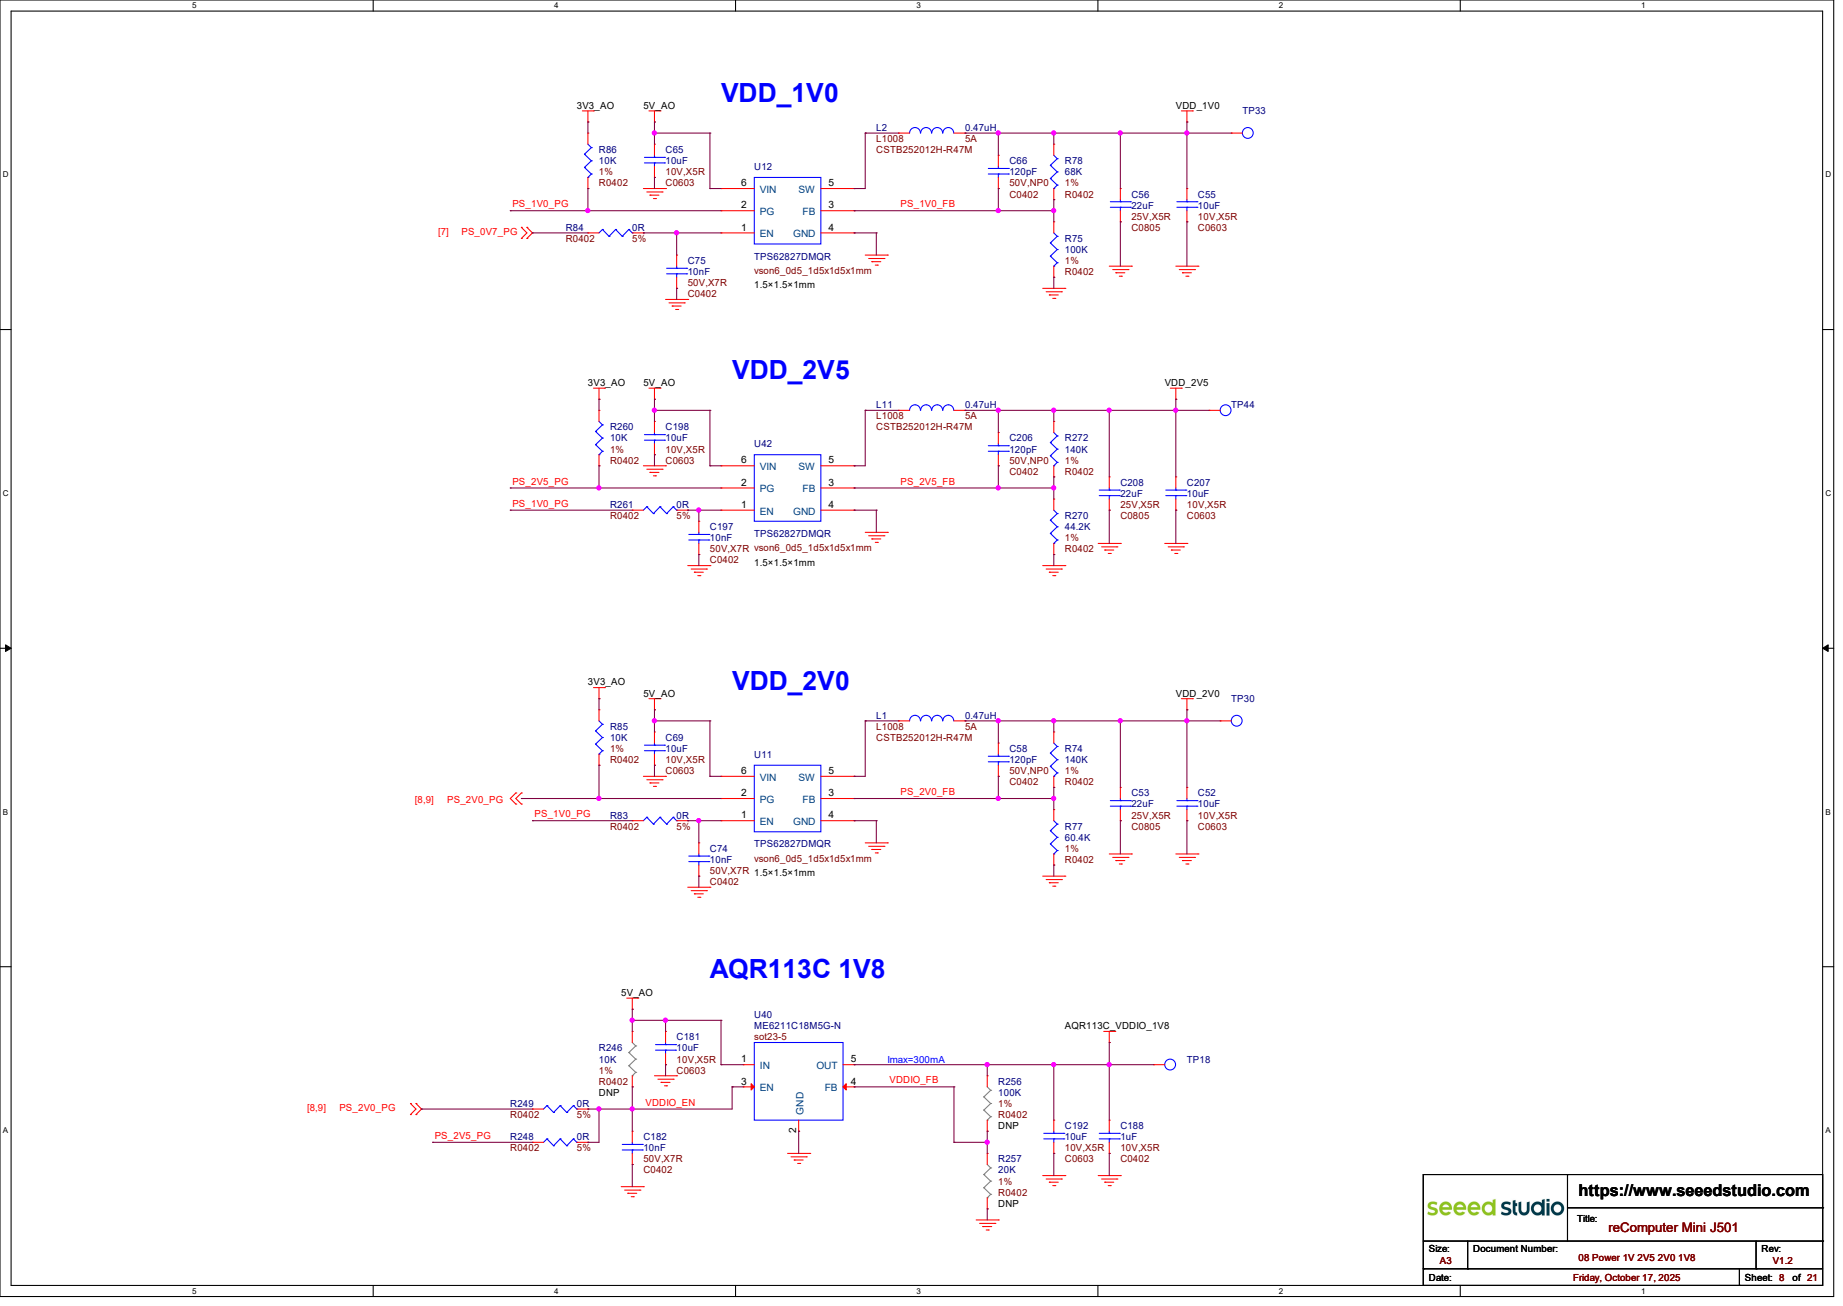
[picture p157: page 8]

# Debug - C2

# Button MCU For Power Up

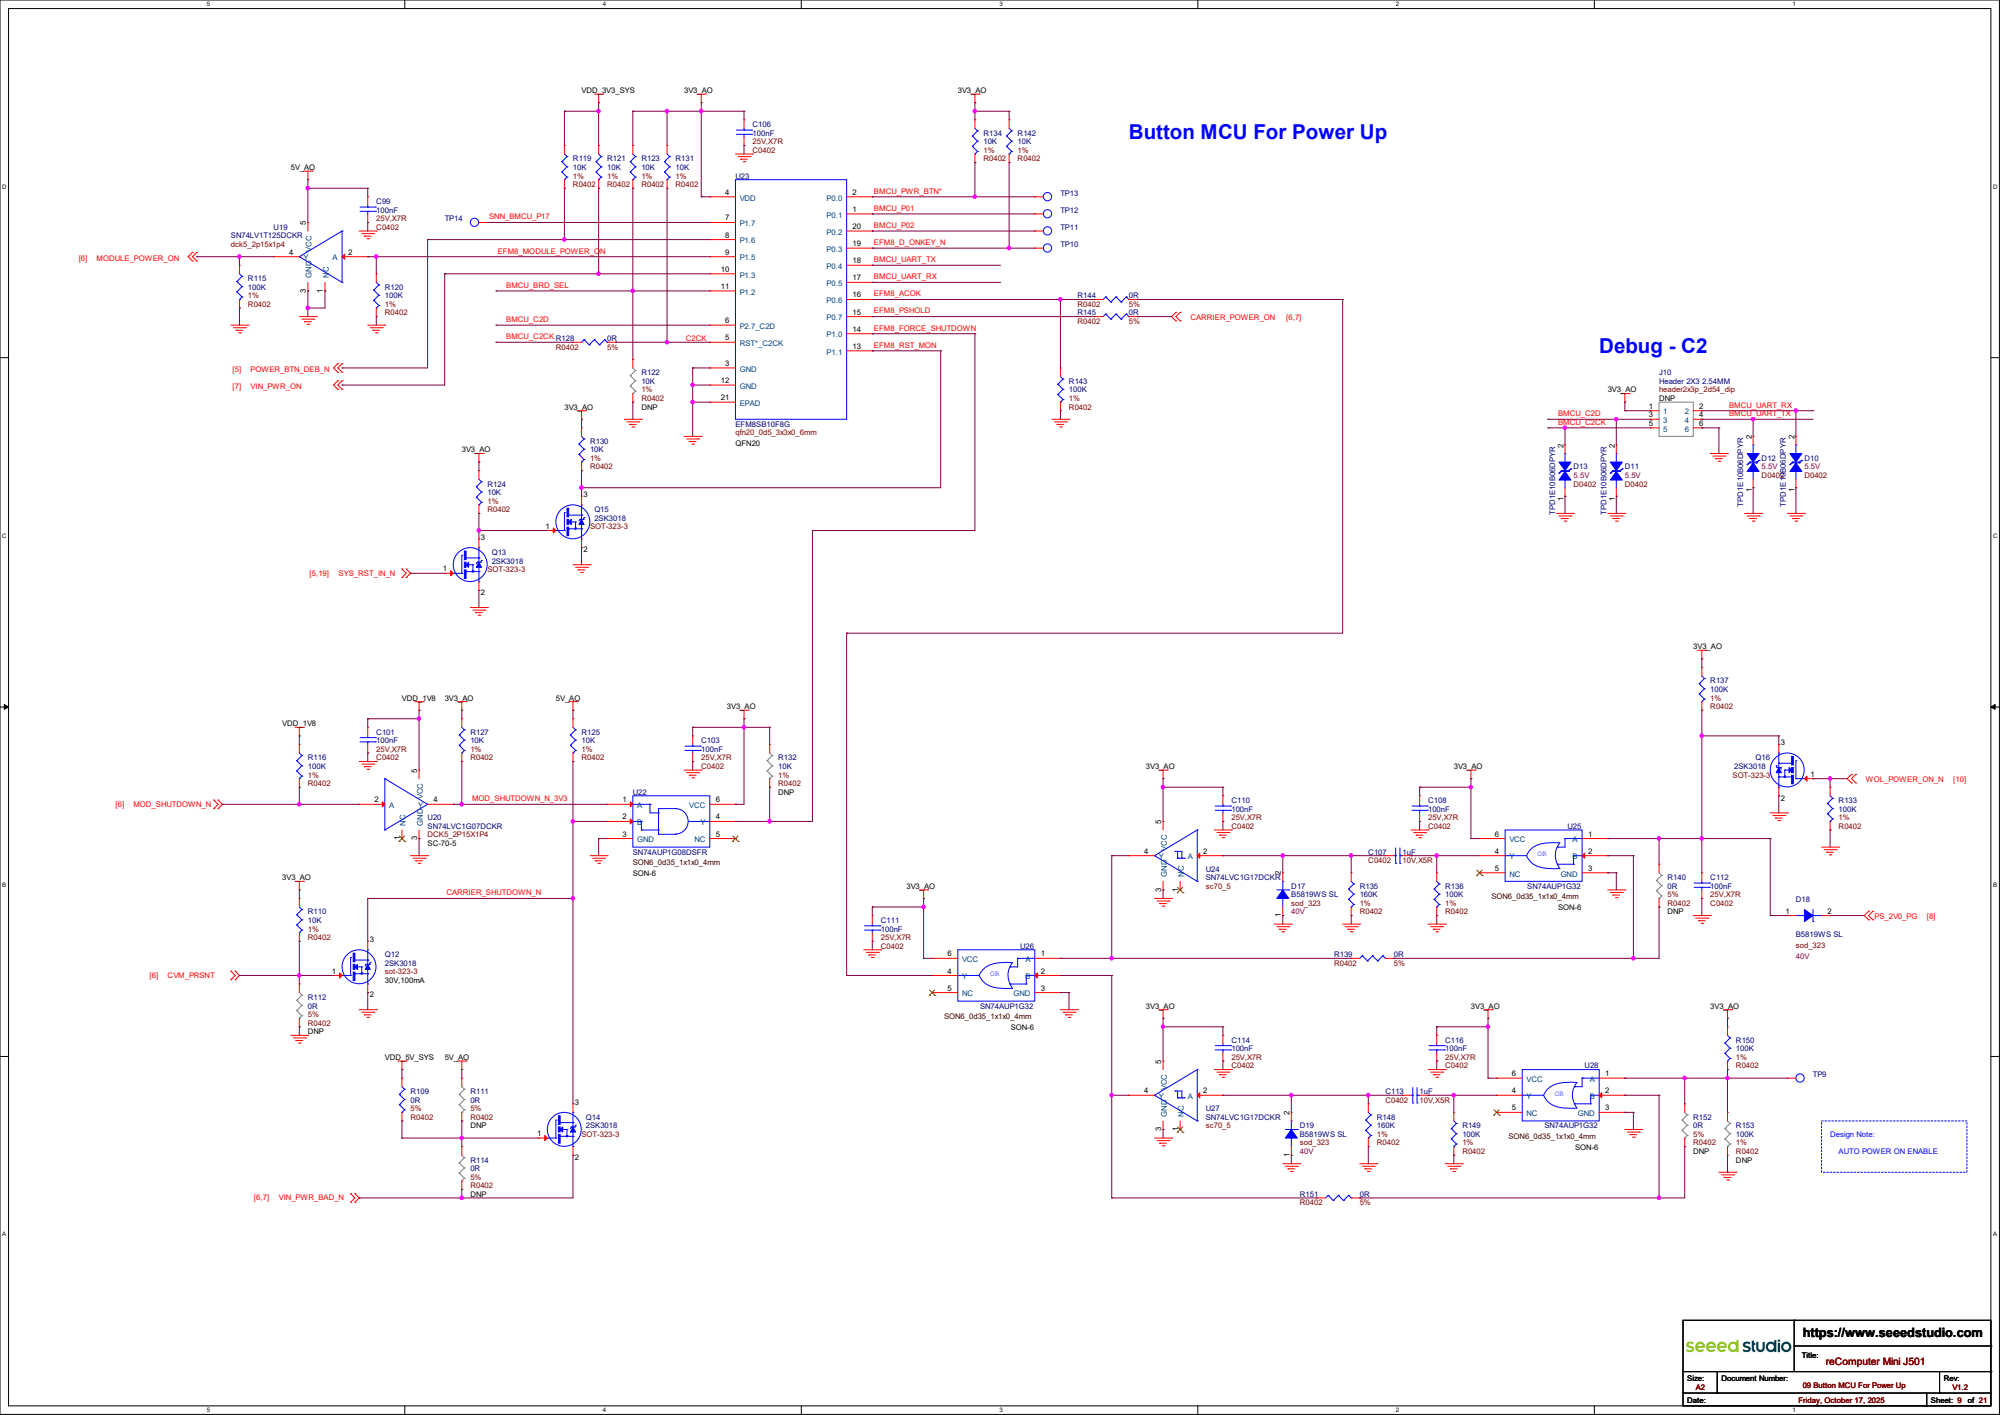
[picture p158: page 9]

AUTO POWER ON ENABLE Design Note:

reComputer Mini J501 09 Button MCU For Power Up R114

# B5 XTAL_O

# E8 XTAL_I D8 RX_N

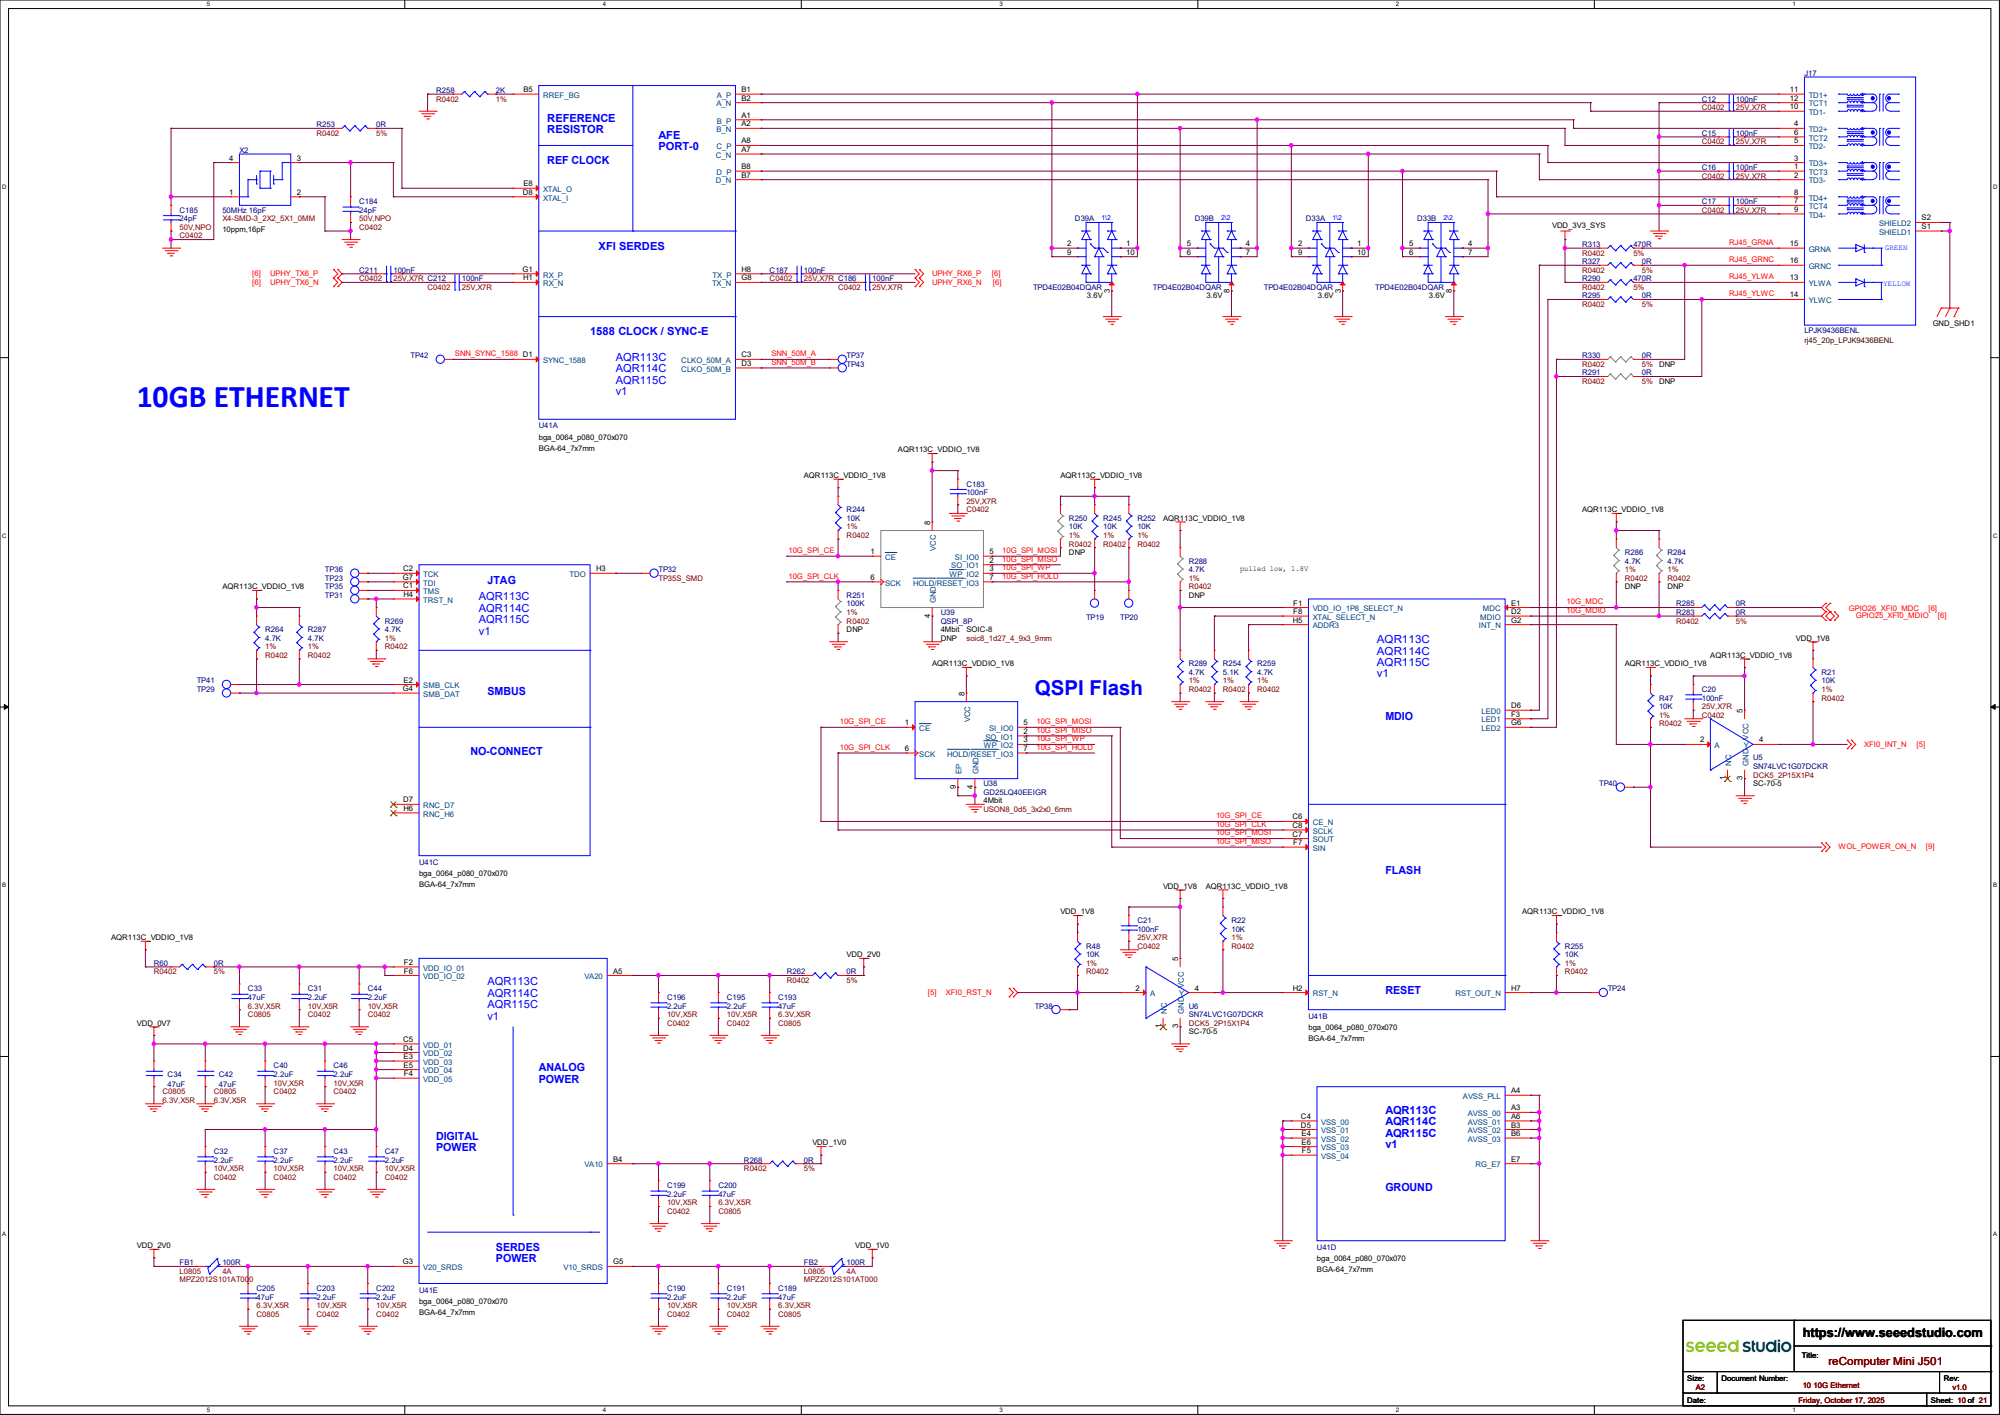
[picture p159: page 10]

# GB ETHERNET

# r0402 DNP PHY_VDDA_1V⁸_1 PHY_VDDA_1V⁸_2 PHY_TD_A_P PHY_TD_A_P

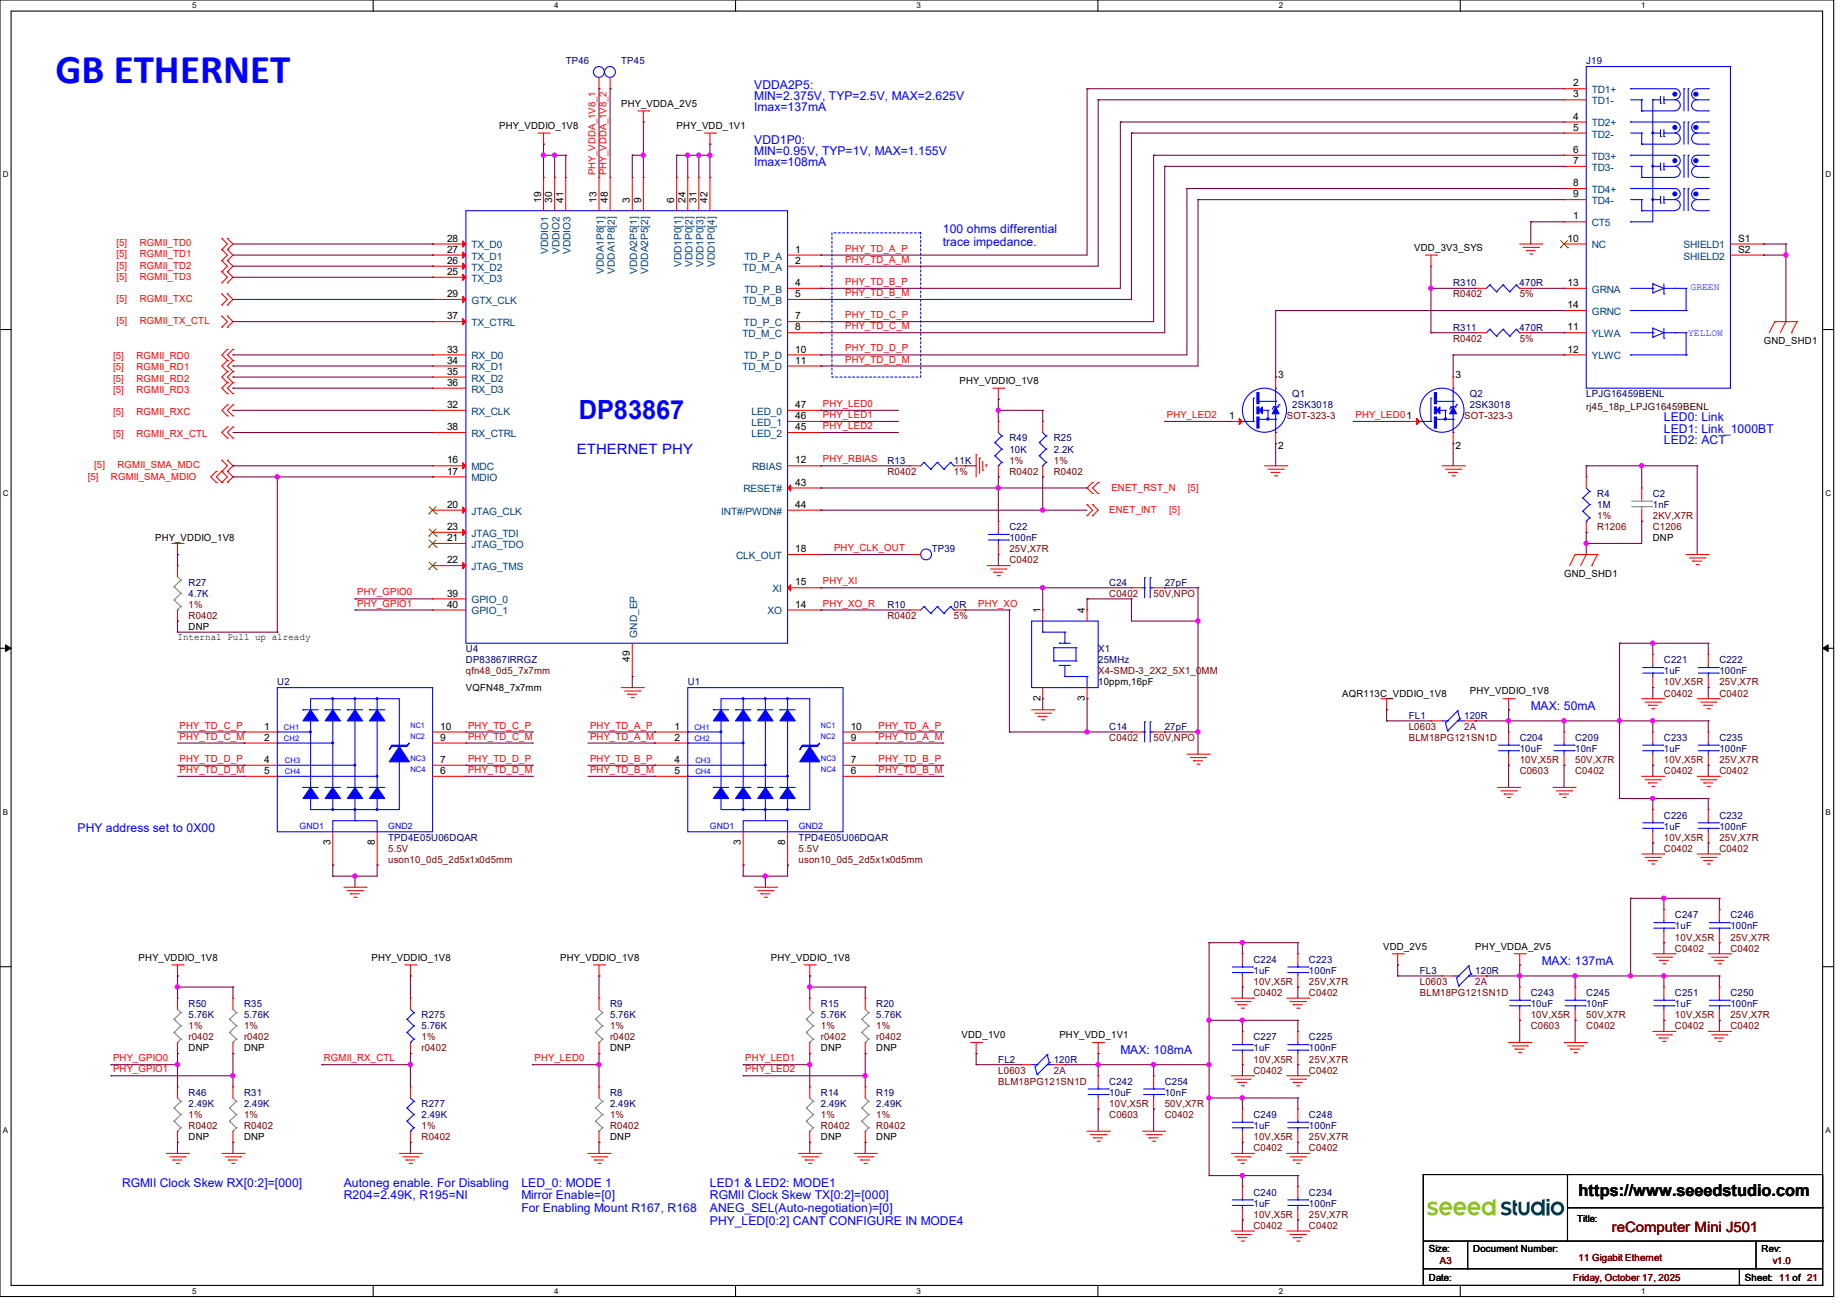
[picture p160: page 11]

PHY address set to 0X00

RGMII Clock Skew RX[0:2]=[000]

Autoneg enable. For Disabling

LED1 & LED2: MODE1
RGMII Clock Skew TX[0:2]=[000]
ANEG_SEL(Auto-negotiation)=[0]
PHY_LED[0:2] CANT CONFIGURE IN MODE4

# USB3.2 TYPE-A x2 (A)

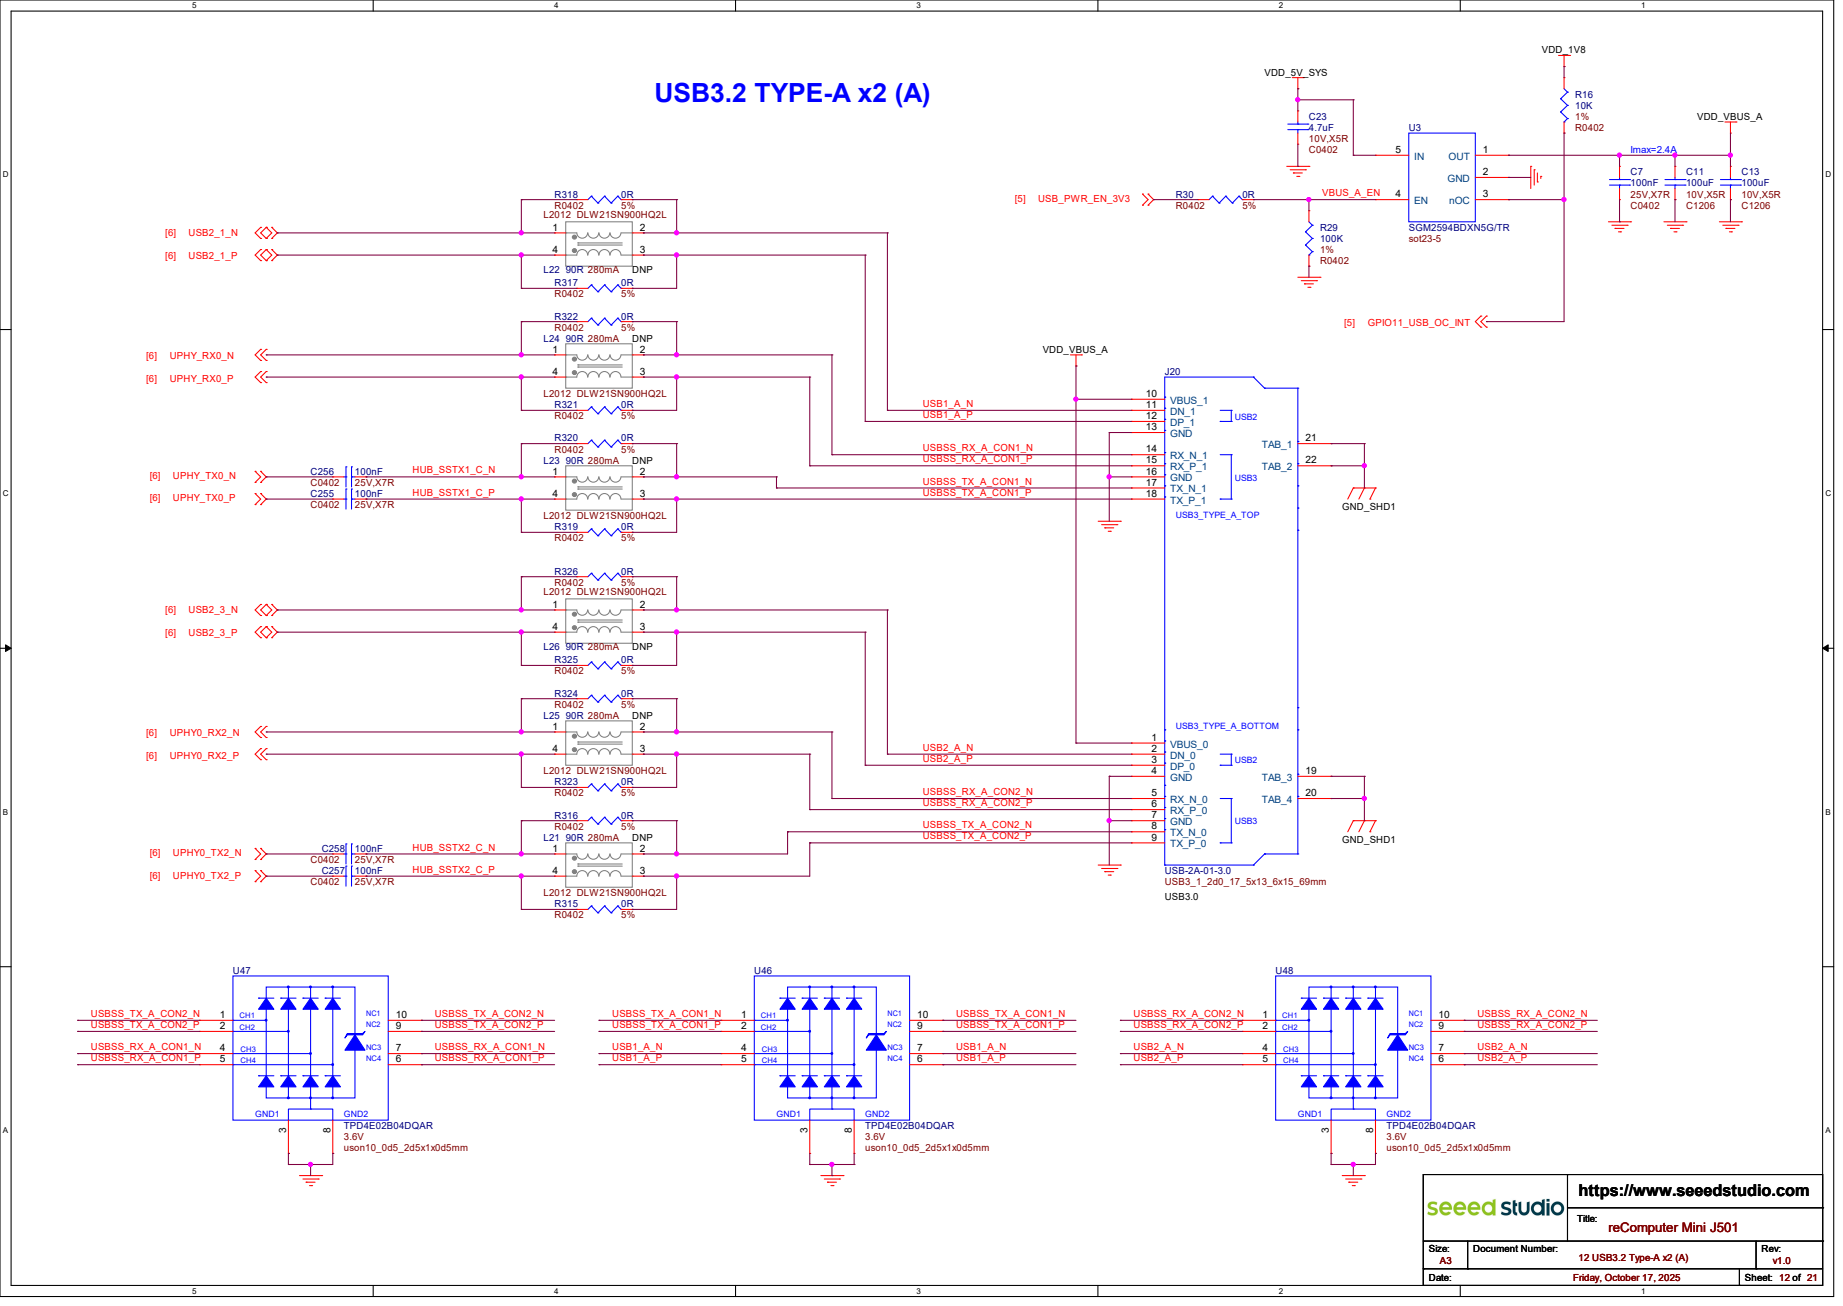
[picture p161: page 12]

# USB2.0 Only USB to UART

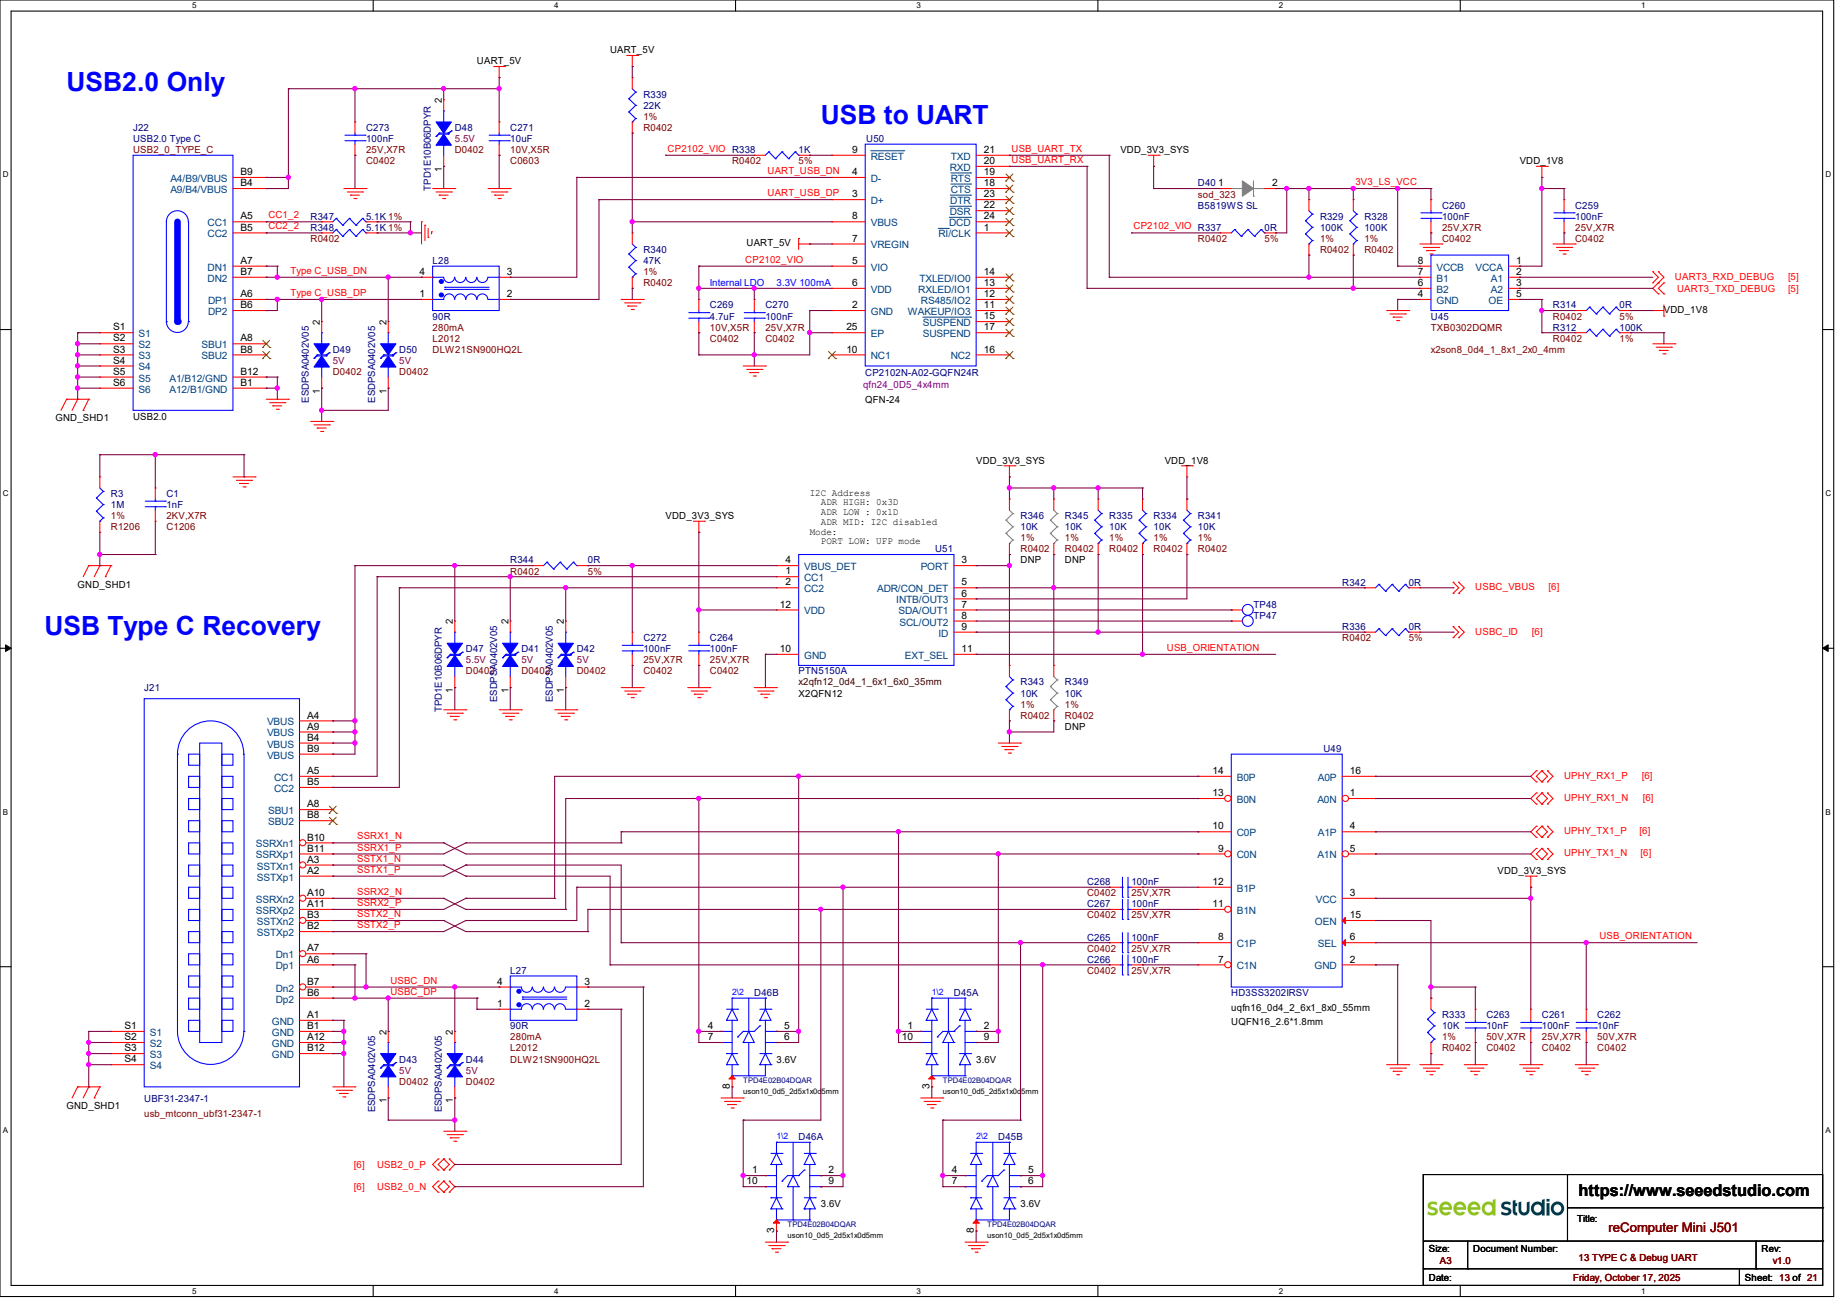
[picture p162: page 13]

ADR HIGH: 0x3D
ADR LOW : 0x1D
ADR MID: I2C disabled
Mode:
PORT LOW: UFP mode
U51 PTN5150A

reComputer Mini J501 13 TYPE C & Debug UART

# M.2 KEY-M (NVME)

## PCIE(NVMe) J4

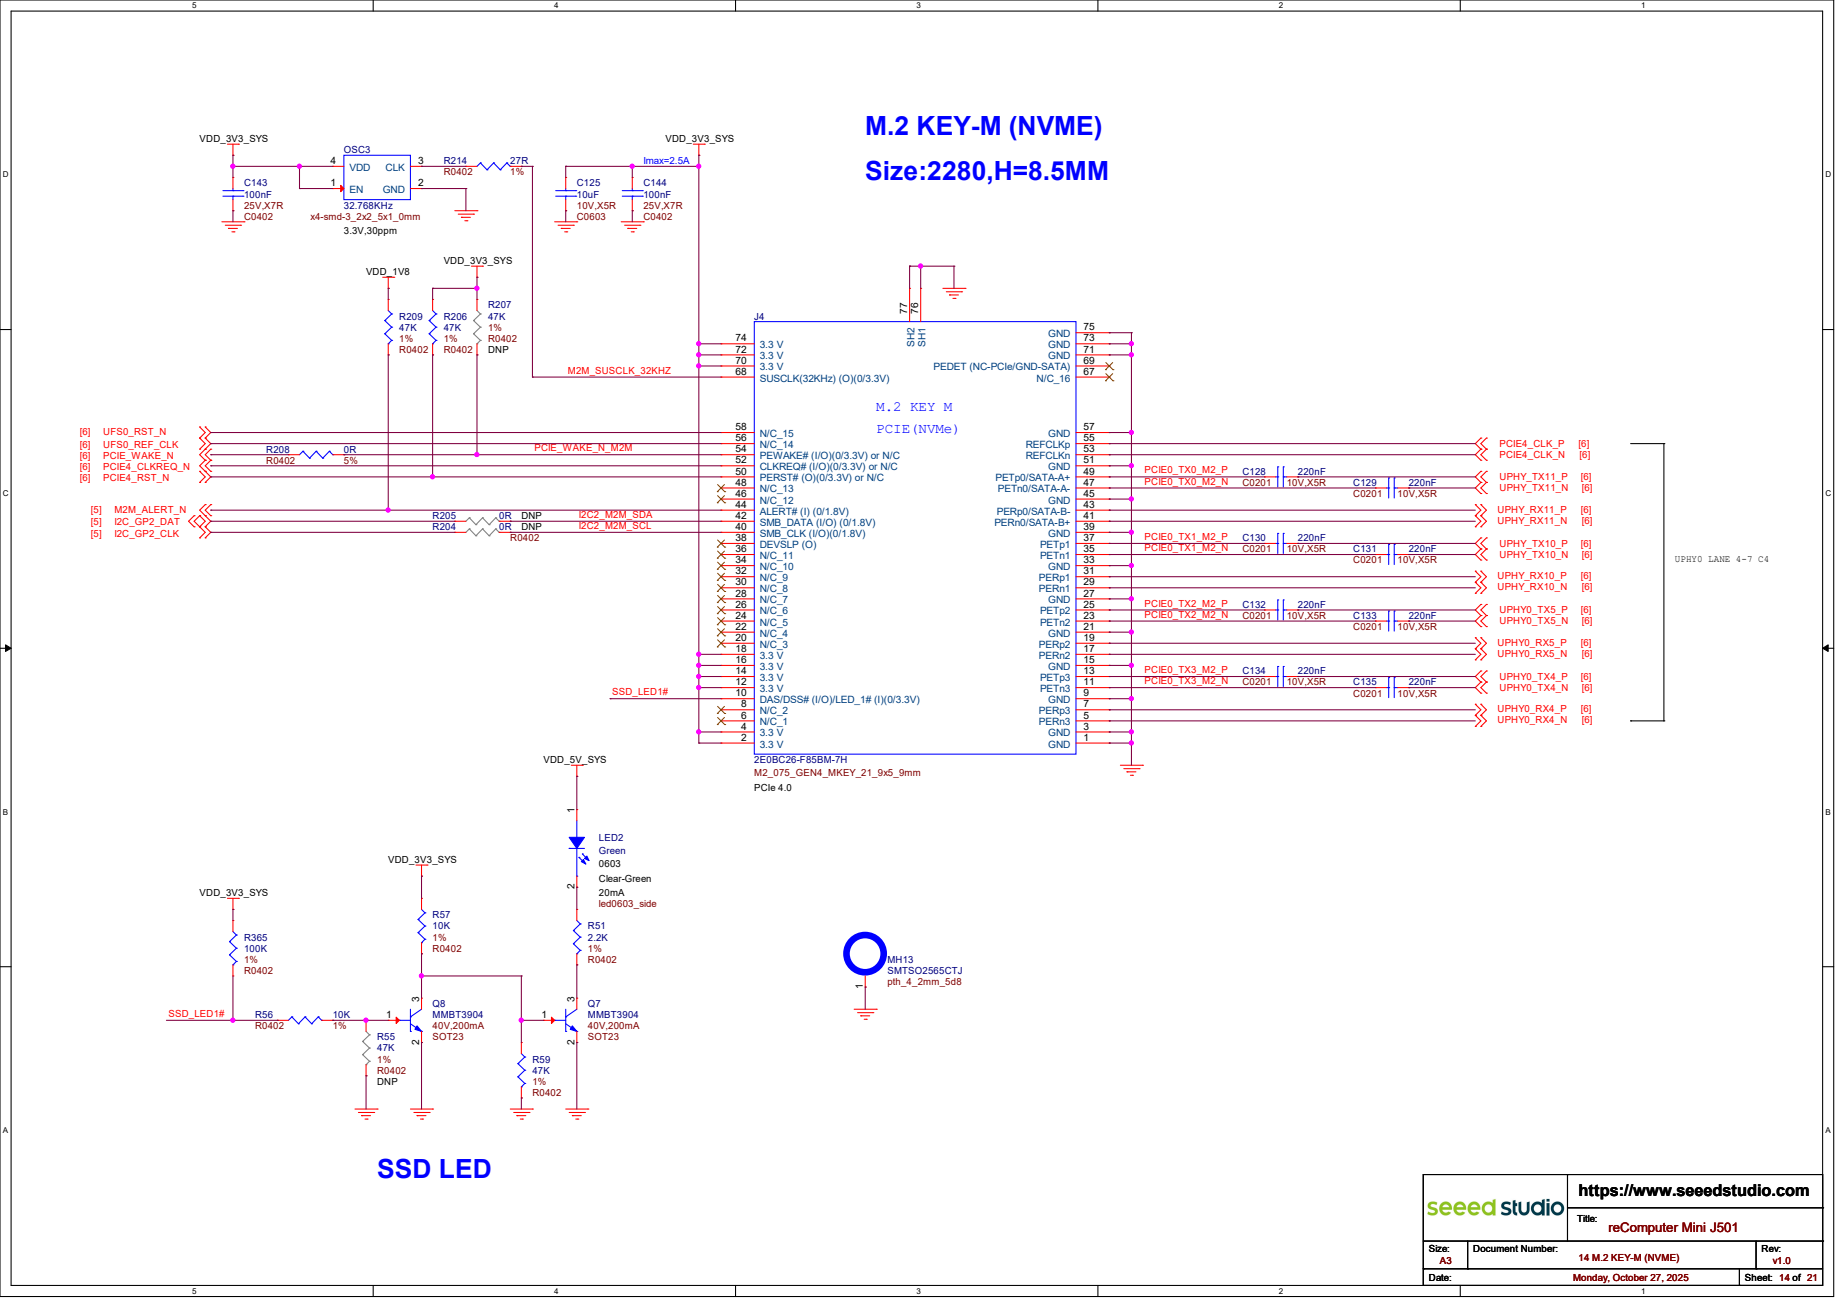
[picture p163: page 14]

reComputer Mini J501 14 M.2 KEY-M (NVME)

# M.2 KEY-E (WIFI/BT) Size:2230,H=2MM

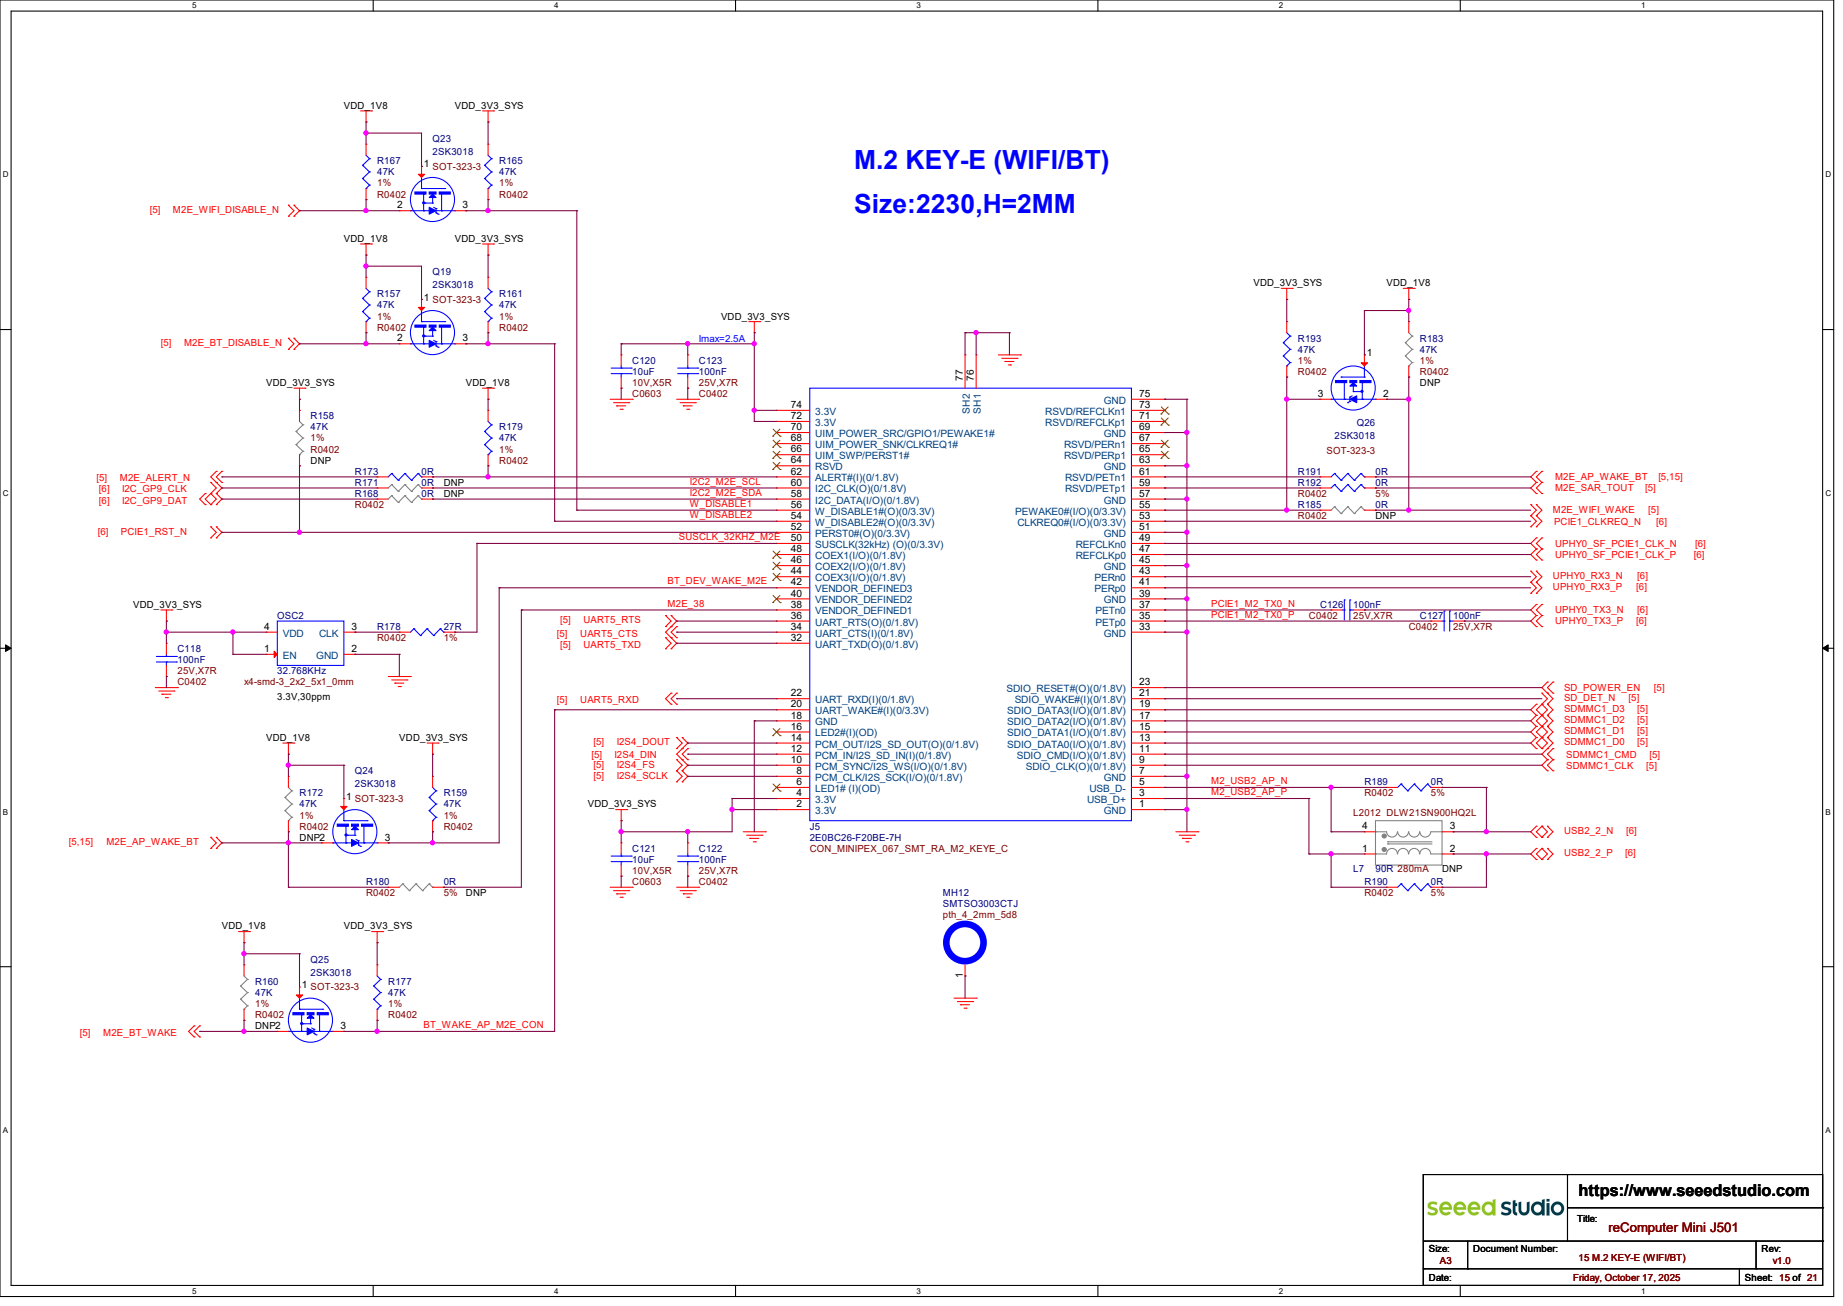
[picture p164: page 15]

reComputer Mini J501 15 M.2 KEY-E (WIFI/BT)

# HDMI Connector

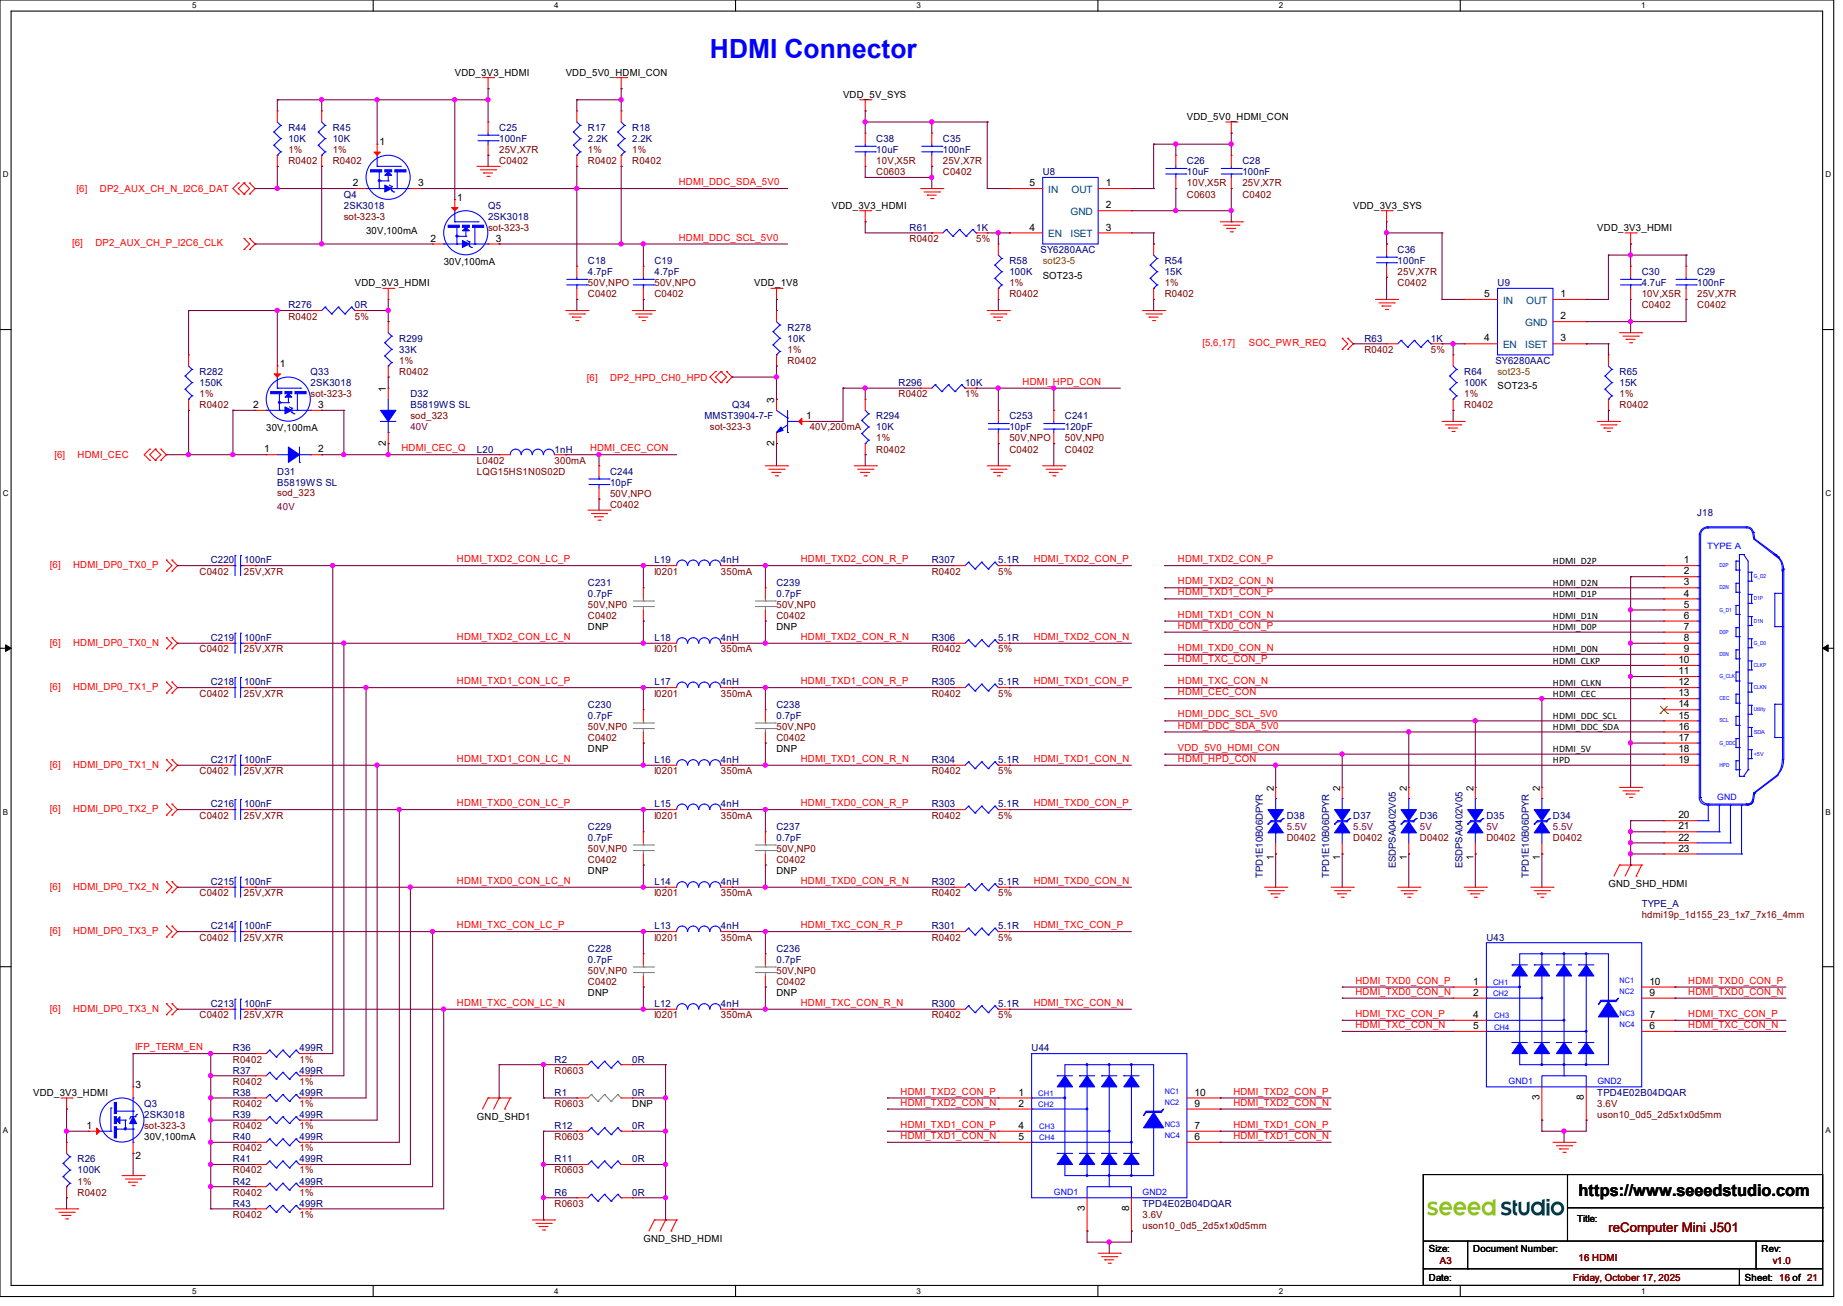
[picture p165: page 16]

# Isolated DCDC 5V to 5V

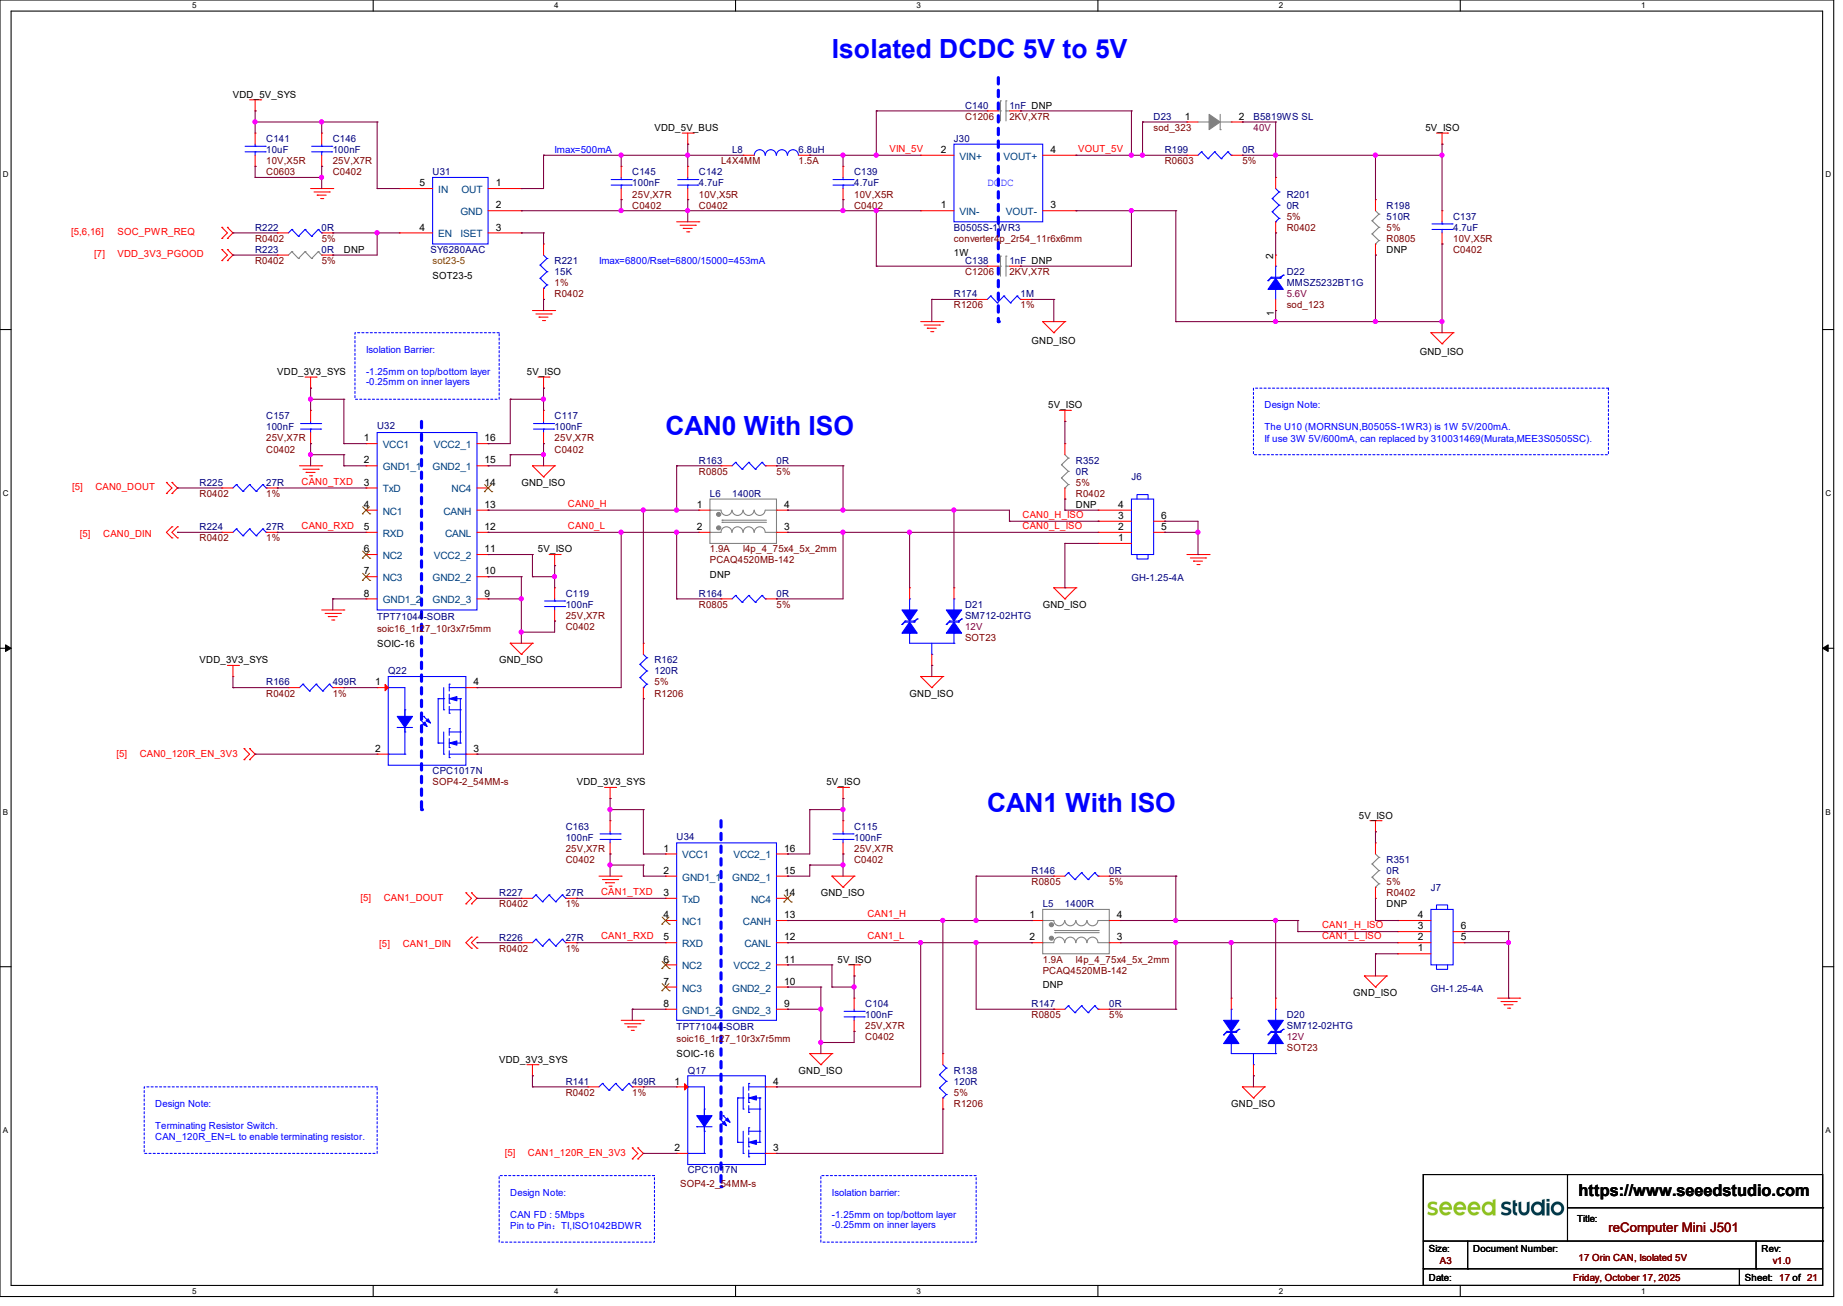
[picture p166: page 17]

Isolation Barrier: -1.25mm on top/bottom layer

If use 3W 5V/600mA, can replaced by 310031469(Murata,MEE3S0505SC).

-1.25mm on top/bottom layer
-0.25mm on inner layers

reComputer Mini J501 17 Orin CAN, Isolated 5V

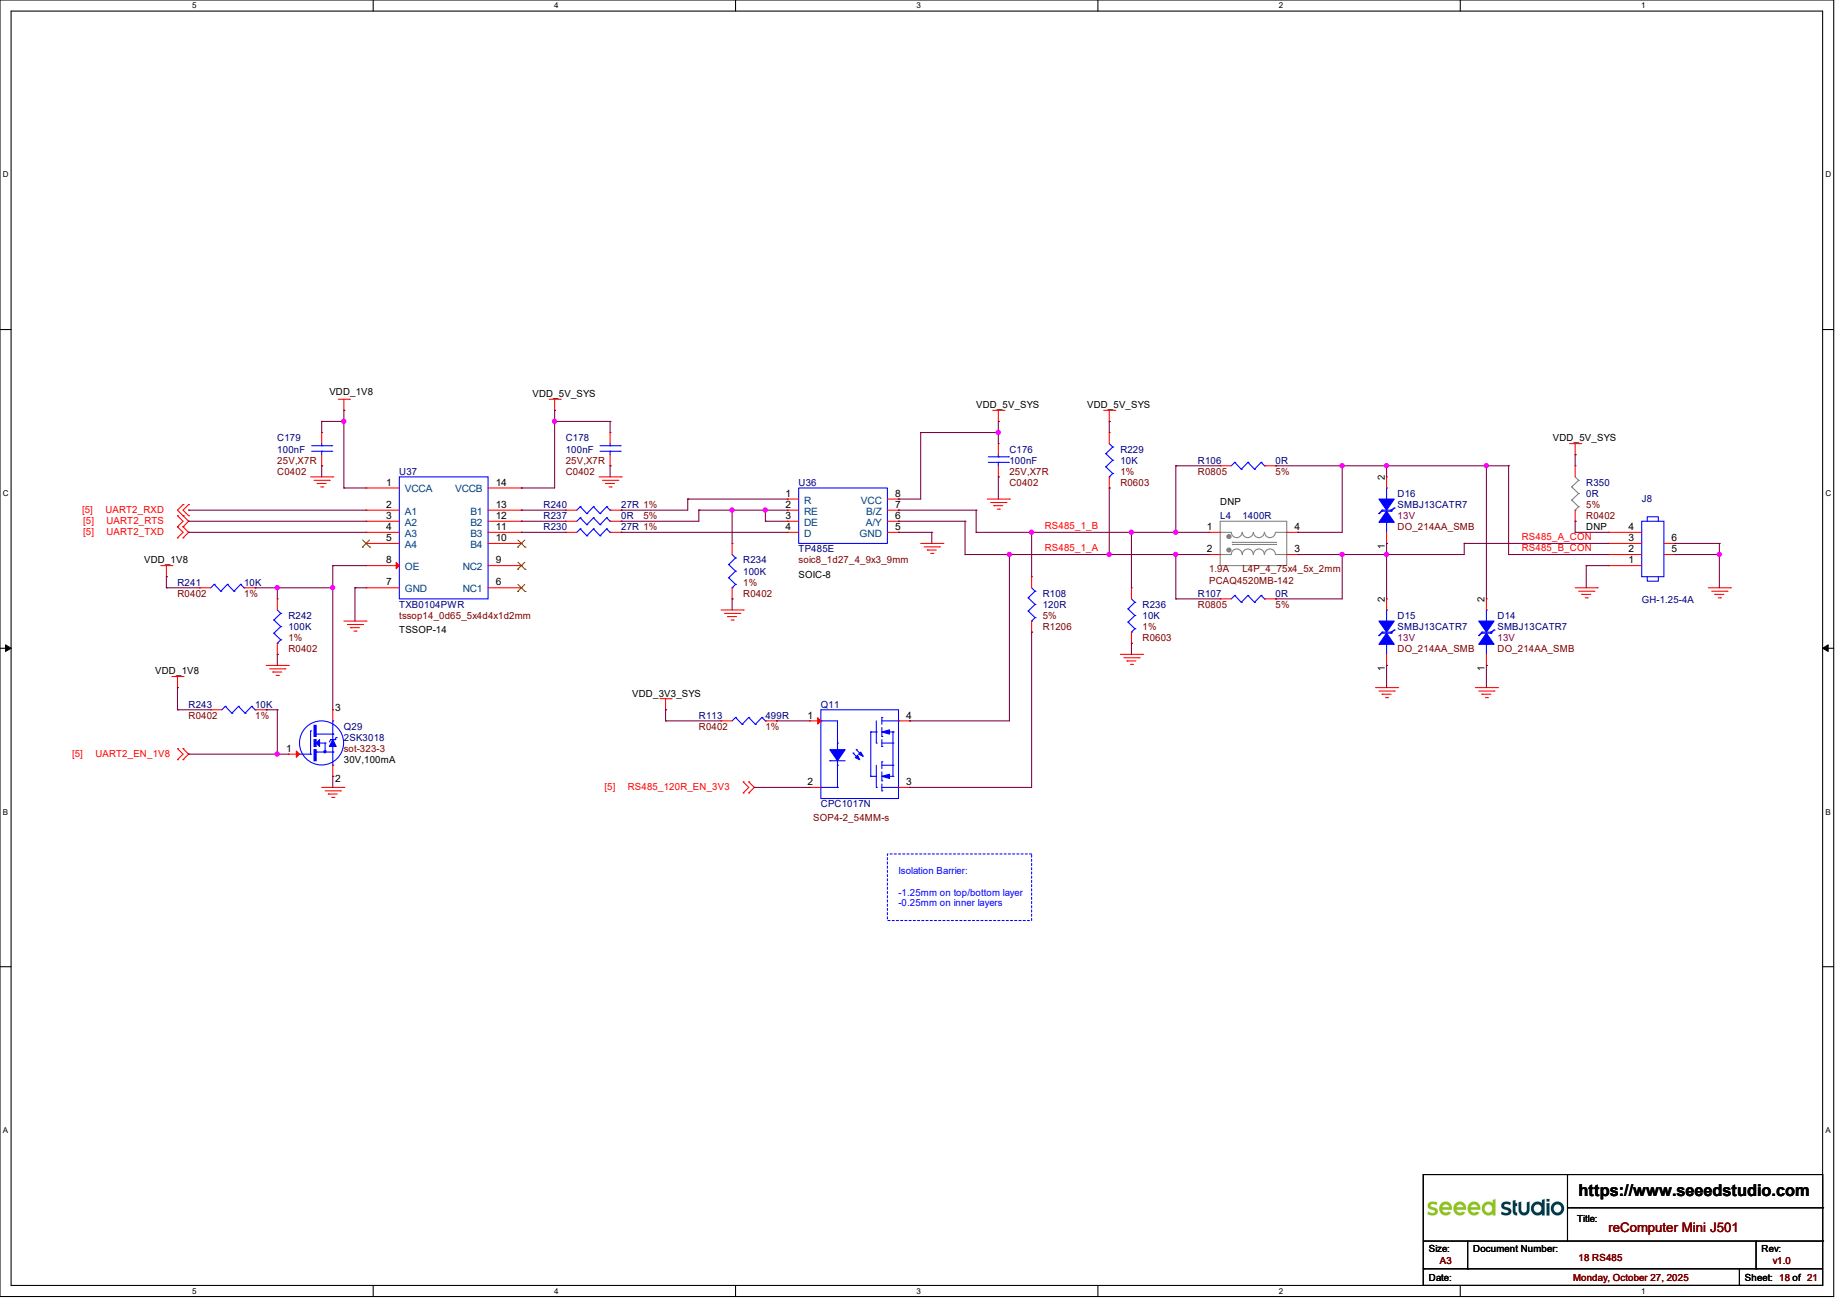
[picture p167: page 18]

-1.25mm on top/bottom layer
-0.25mm on inner layers

# 12V Fan Header 4pin

# Button

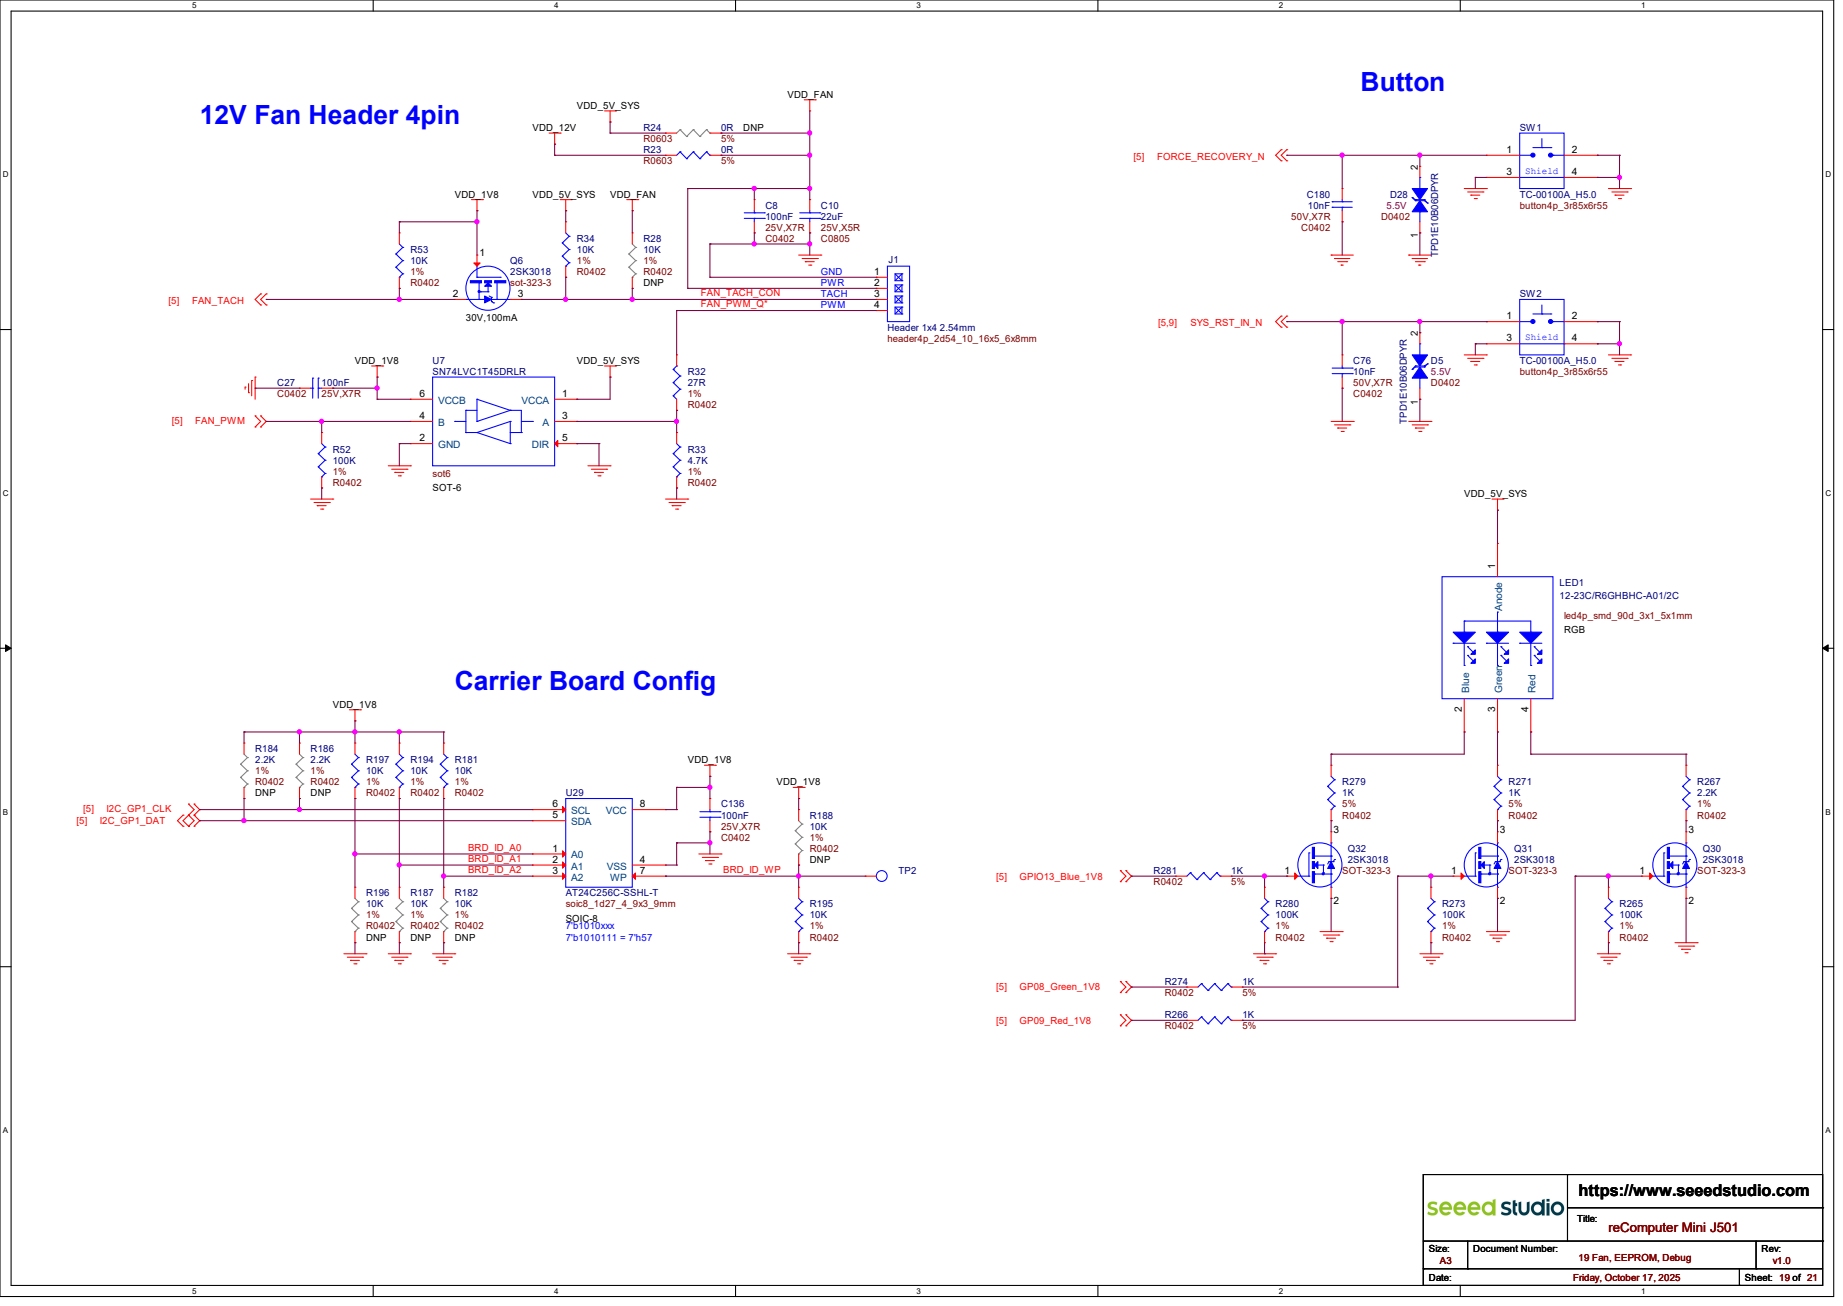
[picture p168: page 19]

reComputer Mini J501 19 Fan, EEPROM, Debug

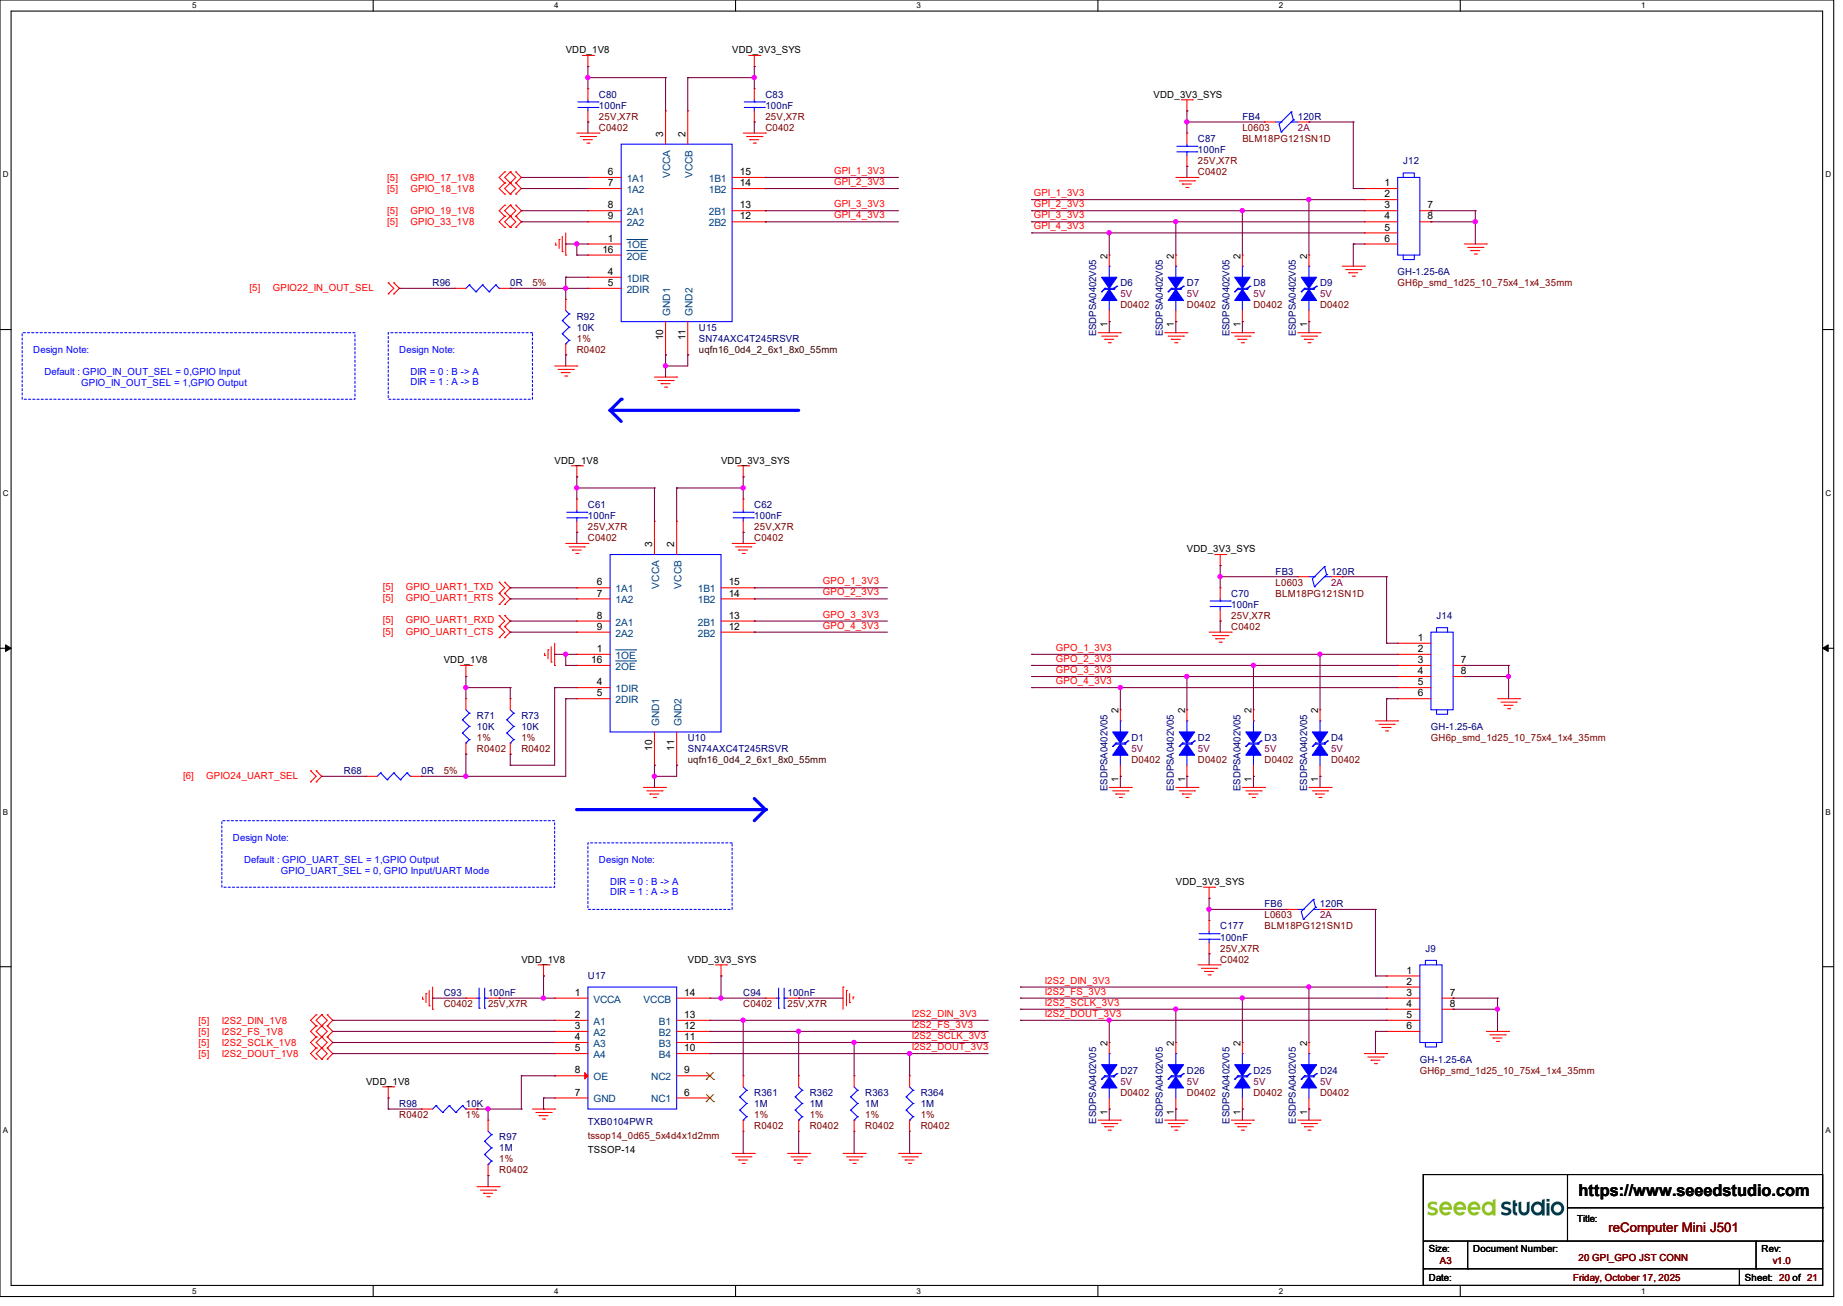
[picture p169: page 20]

DIR = 0 : B -> A DIR = 1 : A -> B Design Note: Default : GPIO_IN_OUT_SEL = 0,GPIO Input Design Note:

GPIO_UART_SEL = 0, GPIO Input/UART Mode

reComputer Mini J501 20 GPI_GPO JST CONN

## CSI 4

## CSI 5

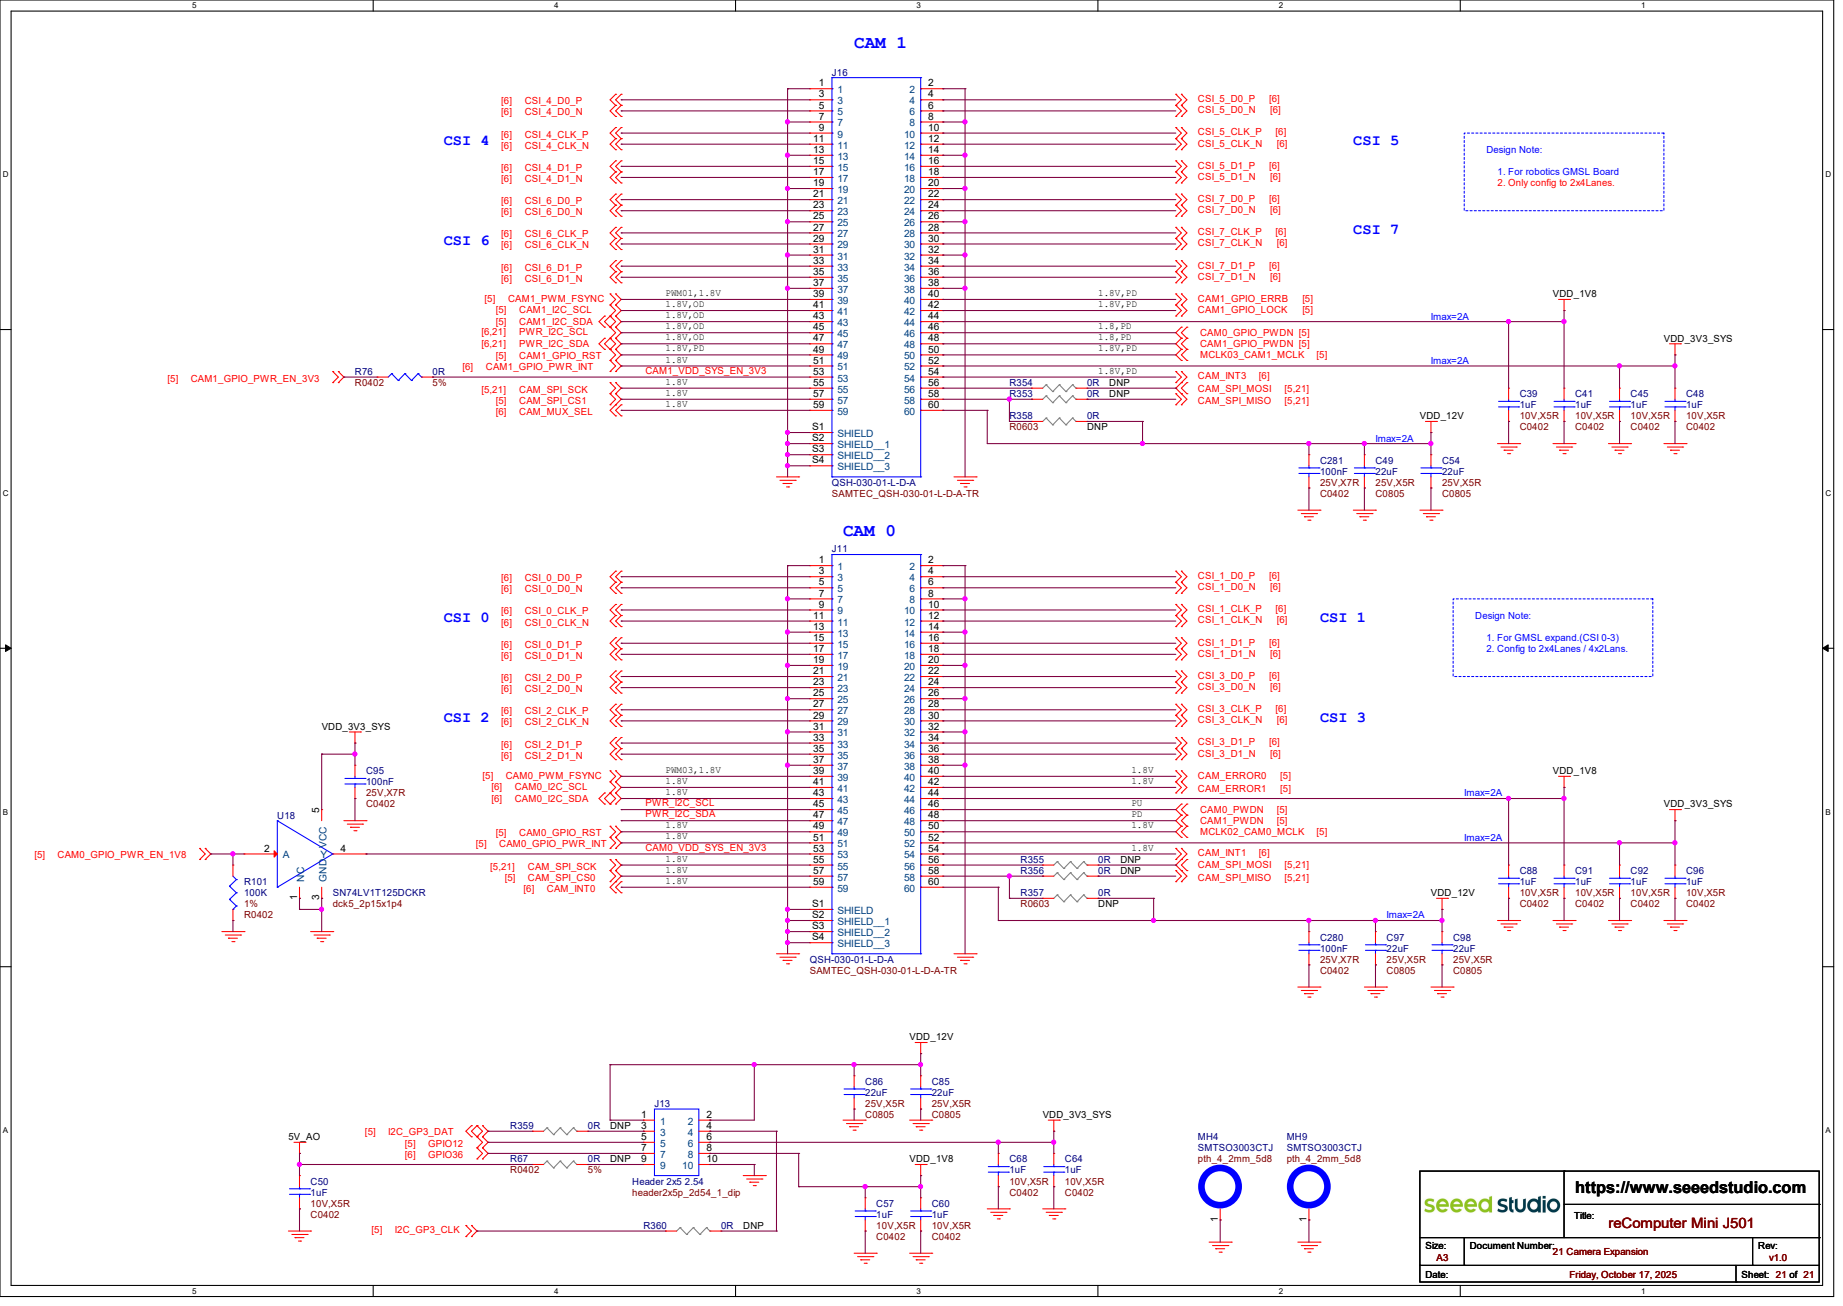
[picture p170: page 21]

1. For GMSL expand.(CSI 0-3) Design Note: 2. Config to 2x4Lanes / 4x2Lans.
