Seeed-Studio/OSHW-Jetson-Series/reComputer Jetson carrier board/reComputer Robotics J401/Schematic/GMSL board for reComputer Robotics_V1.0_SCH_250717.pdf

# 01 Table of Contents

02 | Block Diagram

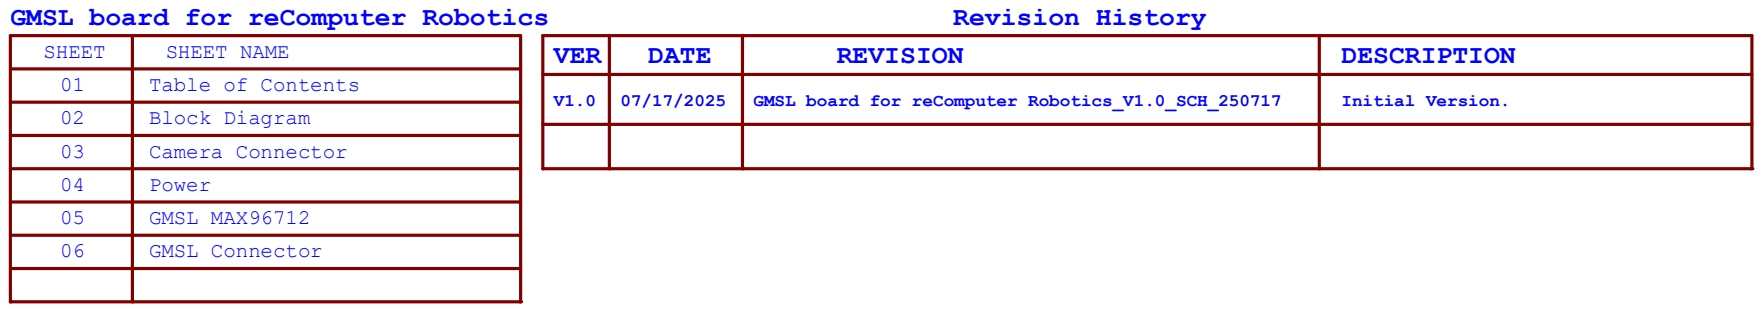
[picture p171: page 1]
SHEET NAME; VER; DATE; REVISION; DESCRIPTION; Revision History; Title: Size:; Document Number:; Rev: Draw By:; Date:; Sheet:; https://www.seeedstudio.com A3; Junqing.Xin; Friday, July 18, 2025; GMSL board for Robotics J401 01 Table of Contents Title: Size:

GMSL board for reComputer Robotics
SHEET

V1.0 | 07/17/2025 | GMSL board for reComputer Robotics_V1.0_SCH_250717 | Initial Version.

03 | Camera Connector
04 | Power
05 | GMSL MAX96712
06 | GMSL Connector

GMSL board for Robotics J401 01 Table of Contents

# Power Expansion

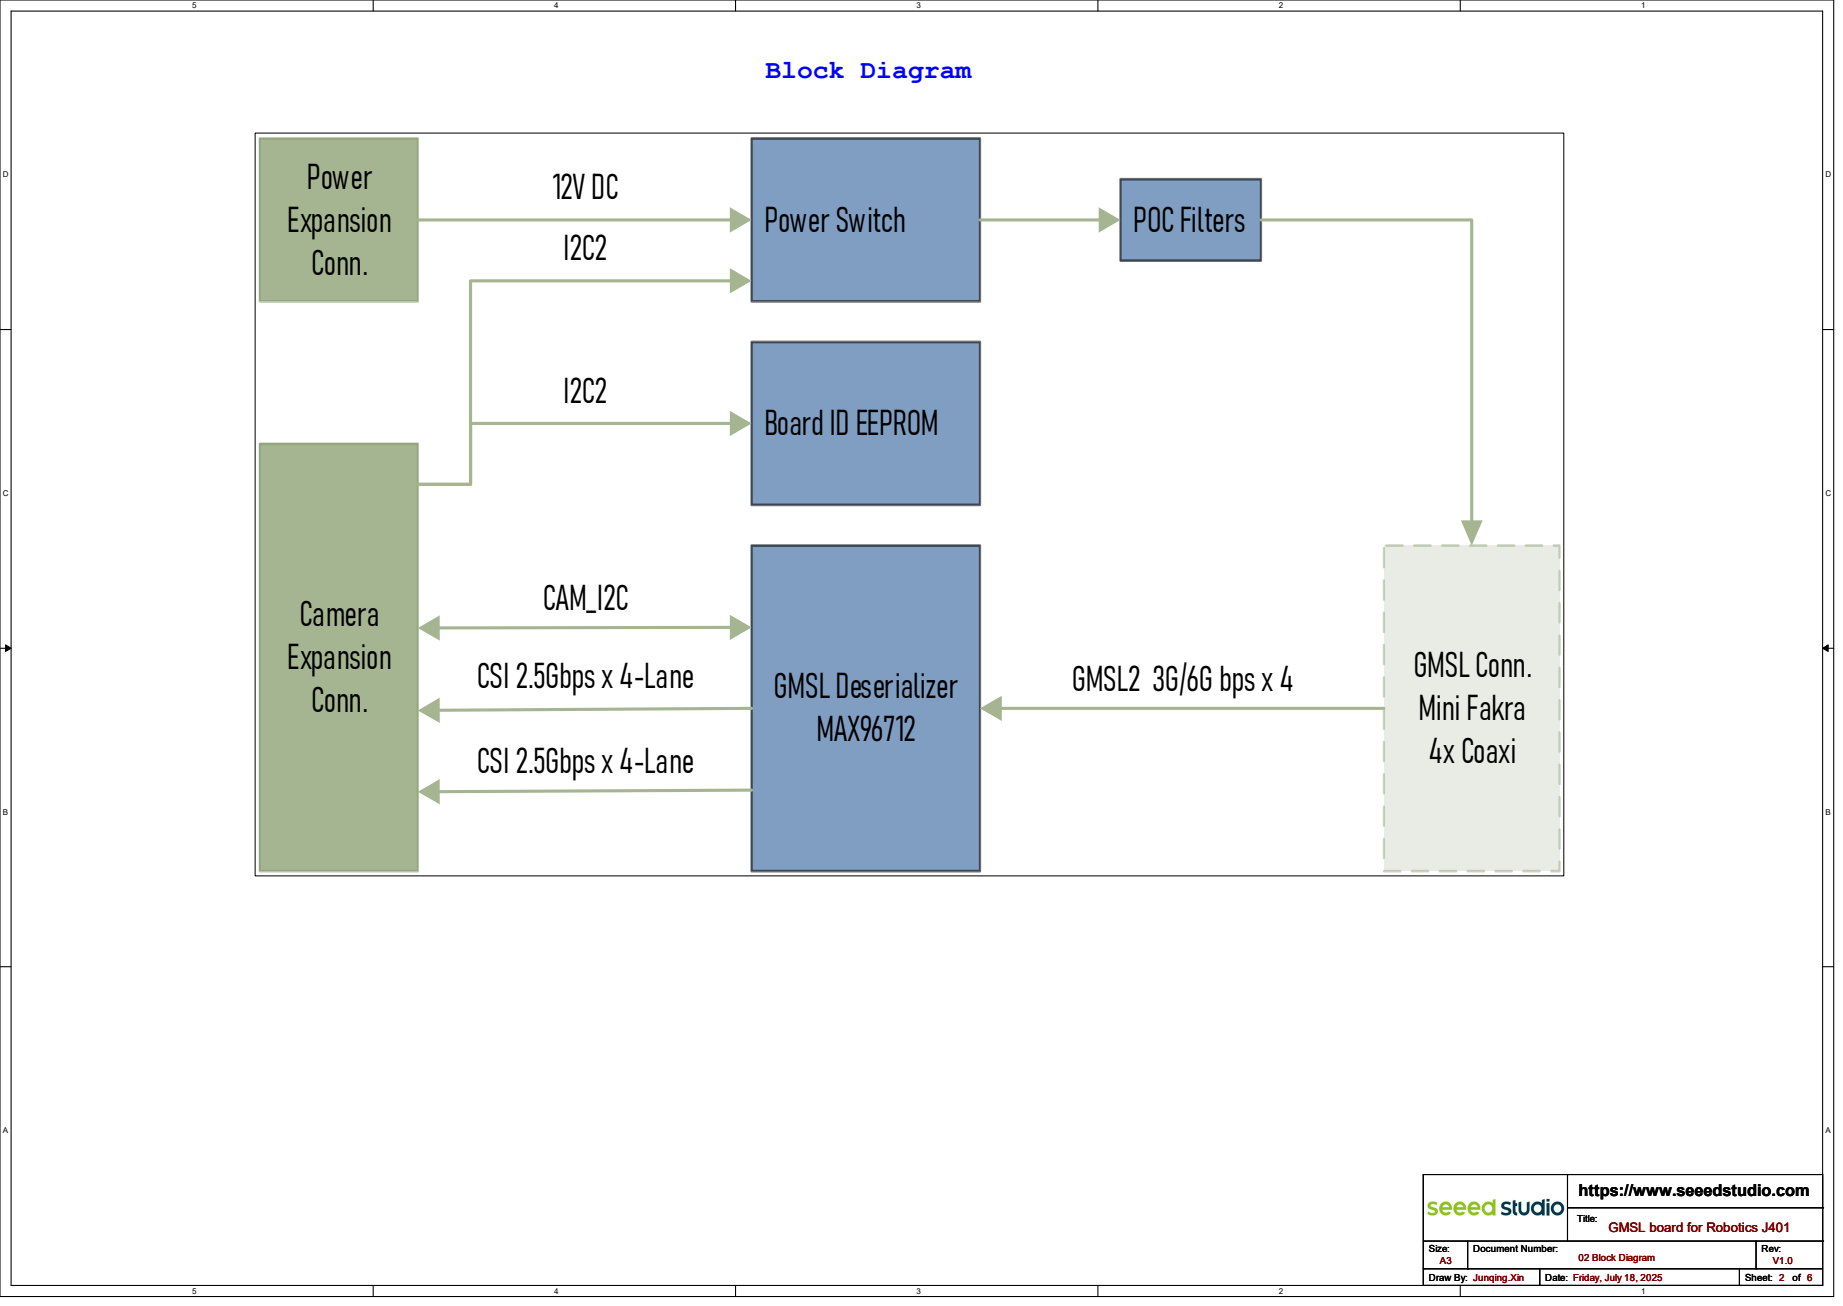
[picture p172: page 2]
Conn.; Camera Expansion; GMSL Deserializer; MAX96712; Power Switch; GMSL Conn. Mini Fakra 4x Coaxi; CSI 2.5Gbps x 4-Lane; GMSL2 3G/6G bps x 4; POC Filters; CAM_I2C; Block Diagram; https://www.seeedstudio.com A3; Junqing.Xin; Friday, July 18, 2025

Board ID EEPROM

GMSL board for Robotics J401 02 Block Diagram

# MIPI Connector

CSI1_D0_P | [5] CSI1_D0_N | [5] CSI1_CLK_P | [5] CSI1_CLK_N | [5] CSI1_D1_P | [5] CSI1_D1_N | [5] CSI3_D0_P | [5] CSI3_D0_N | [5] CSI3_CLK_P | [5] CSI3_CLK_N | [5] CSI3_D1_P | [5] CSI3_D1_N | [5]

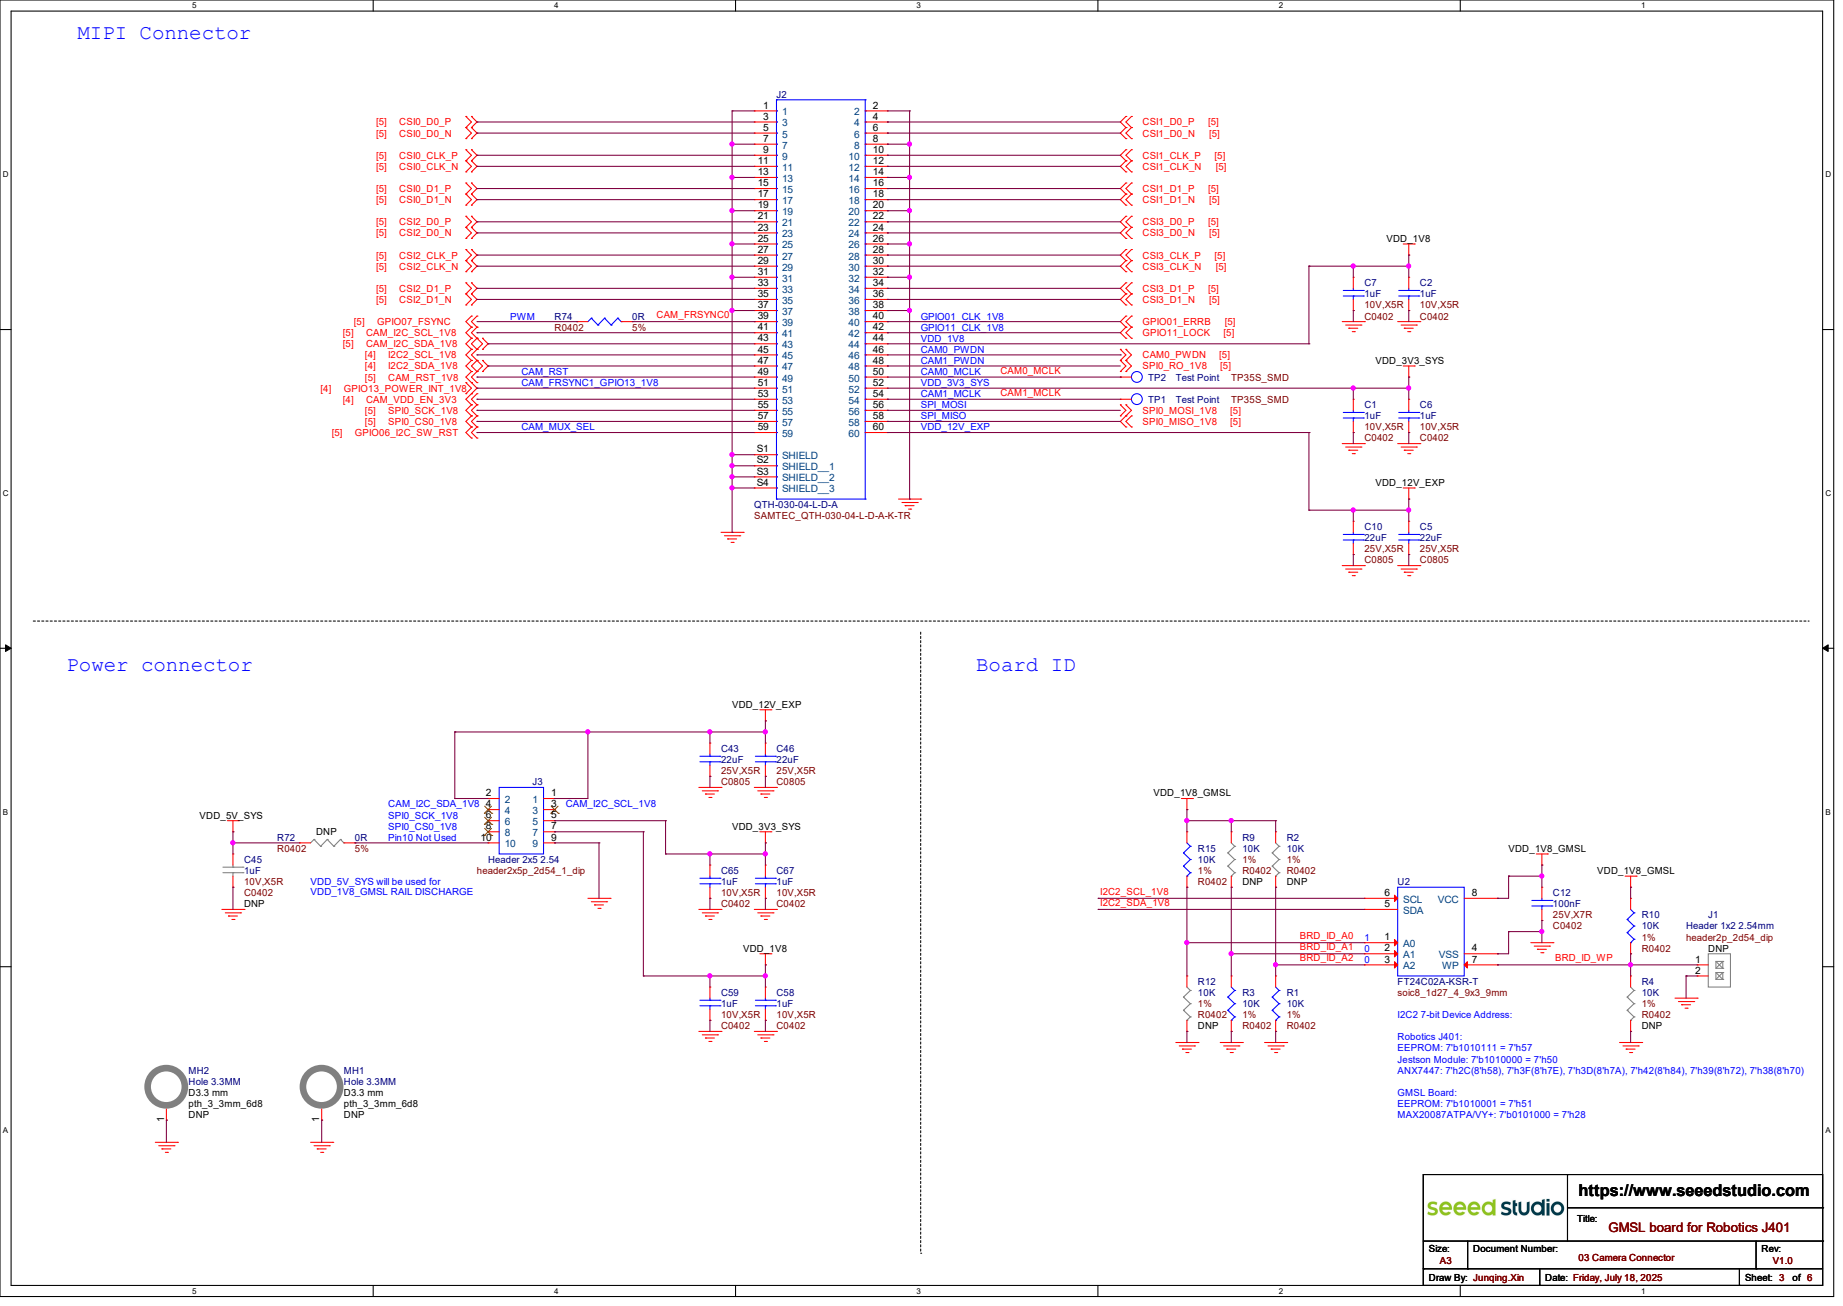
[picture p173: page 3]

VDD_5V_SYS will be used for
VDD_1V8_GMSL RAIL DISCHARGE

Jestson Module: 7'b1010000 = 7'h50 Robotics J401: ANX7447: 7'h2C(8'h58), 7'h3F(8'h7E), 7'h3D(8'h7A), 7'h42(8'h84), 7'h39(8'h72), 7'h38(8'h70) GMSL Board:
EEPROM: 7'b1010111 = 7'h57

GMSL board for Robotics J401 03 Camera Connector

# 3.3V to 1.2V

# 3.3V to 1.8V Optional

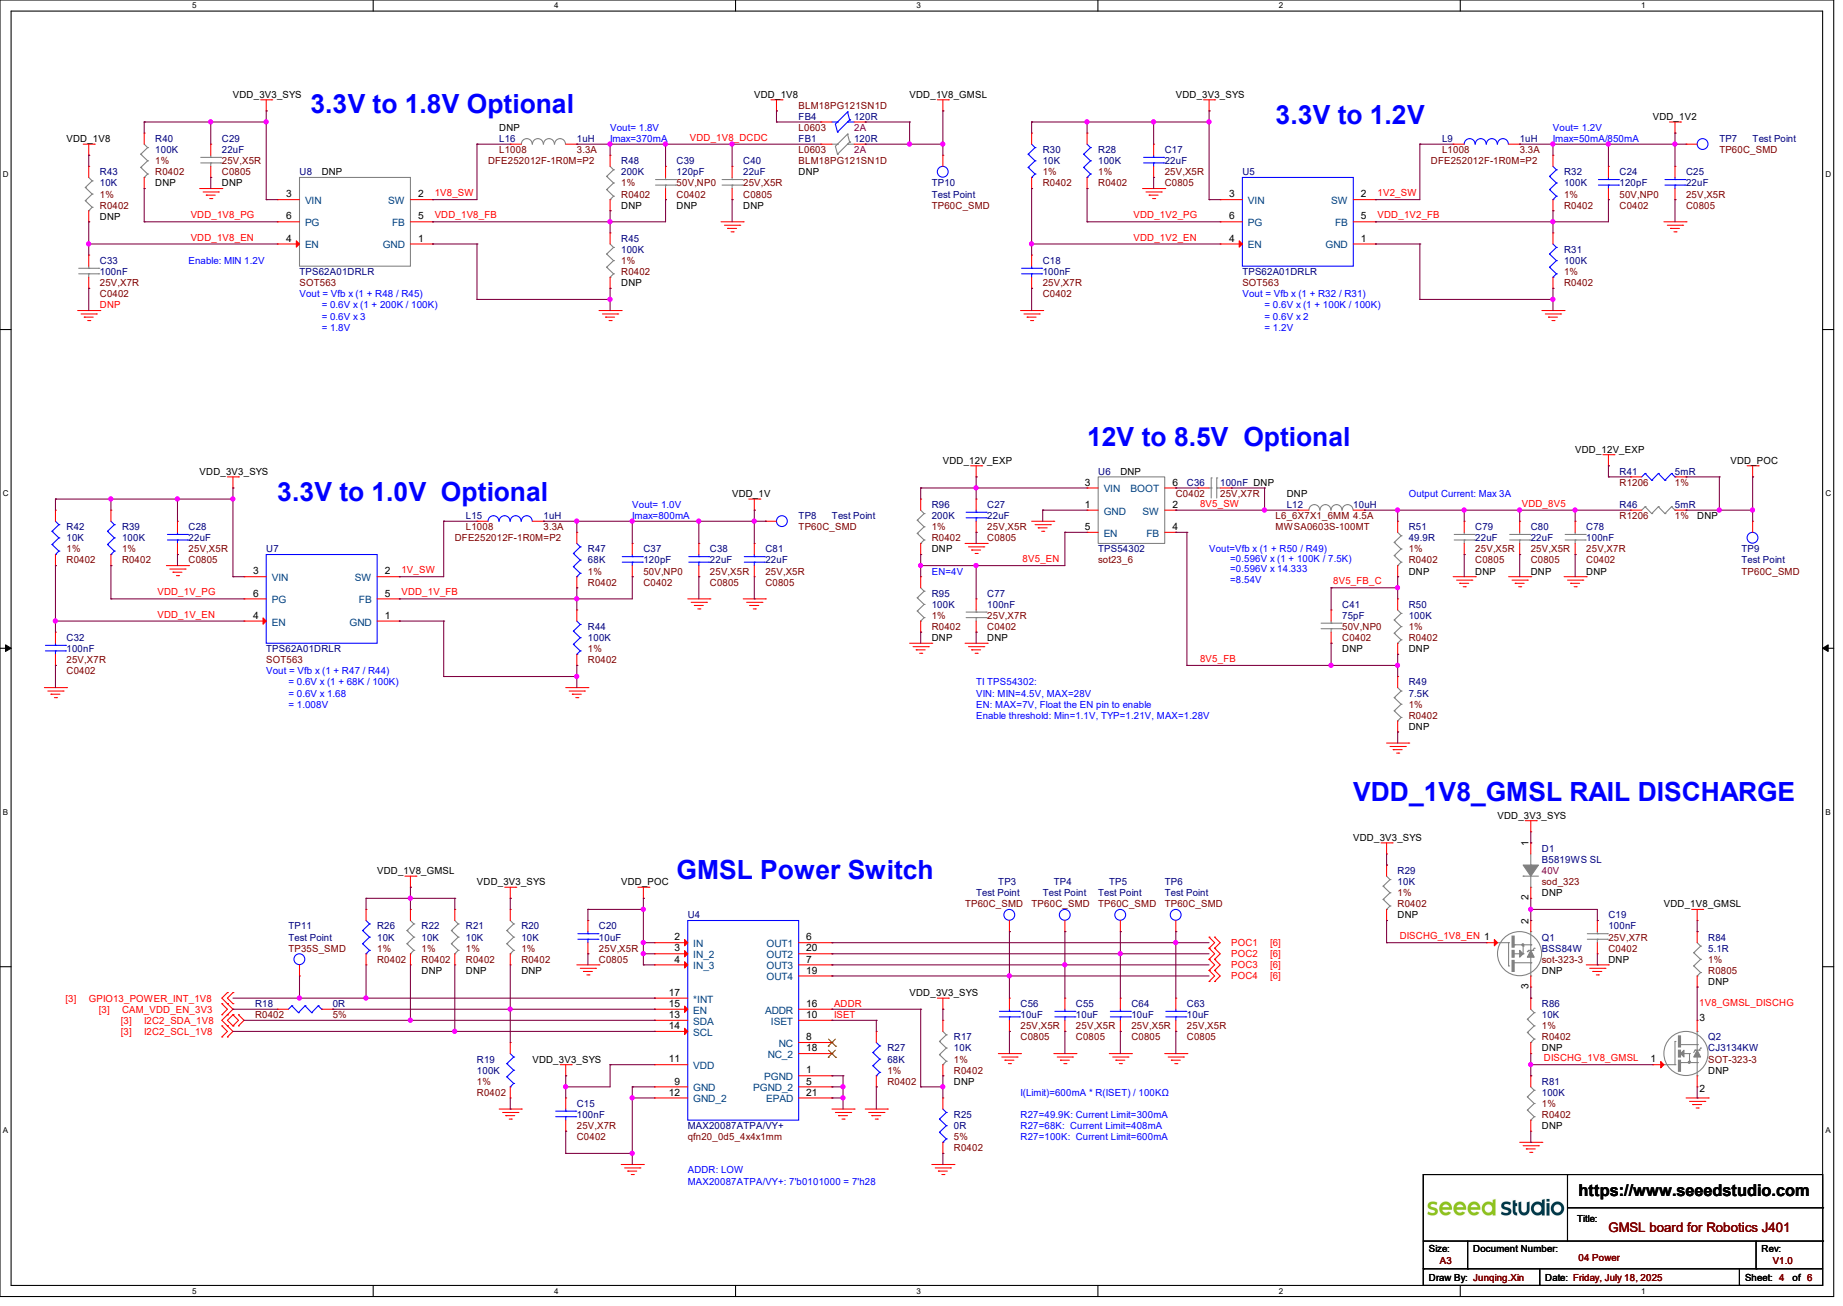
[picture p174: page 4]

R27=49.9K: Current Limit=300mA R27=100K: Current Limit=600mA
R27=68K: Current Limit=408mA

GMSL board for Robotics J401 04 Power

# R0402 DNP R63

A0 1 A1 2 RESET 3 | SD0 4 SC0 5 SD1 6 SC1 7 SD2 8 SC2 9 SD3 10 SC3 11 GND 12 | SD4 13 SC4 14 SD5 15 SC5 16 SD6 17 SC6 18 SD7 19 SC7 20 A2 21 SCL 22 SDA 23 VCC 24

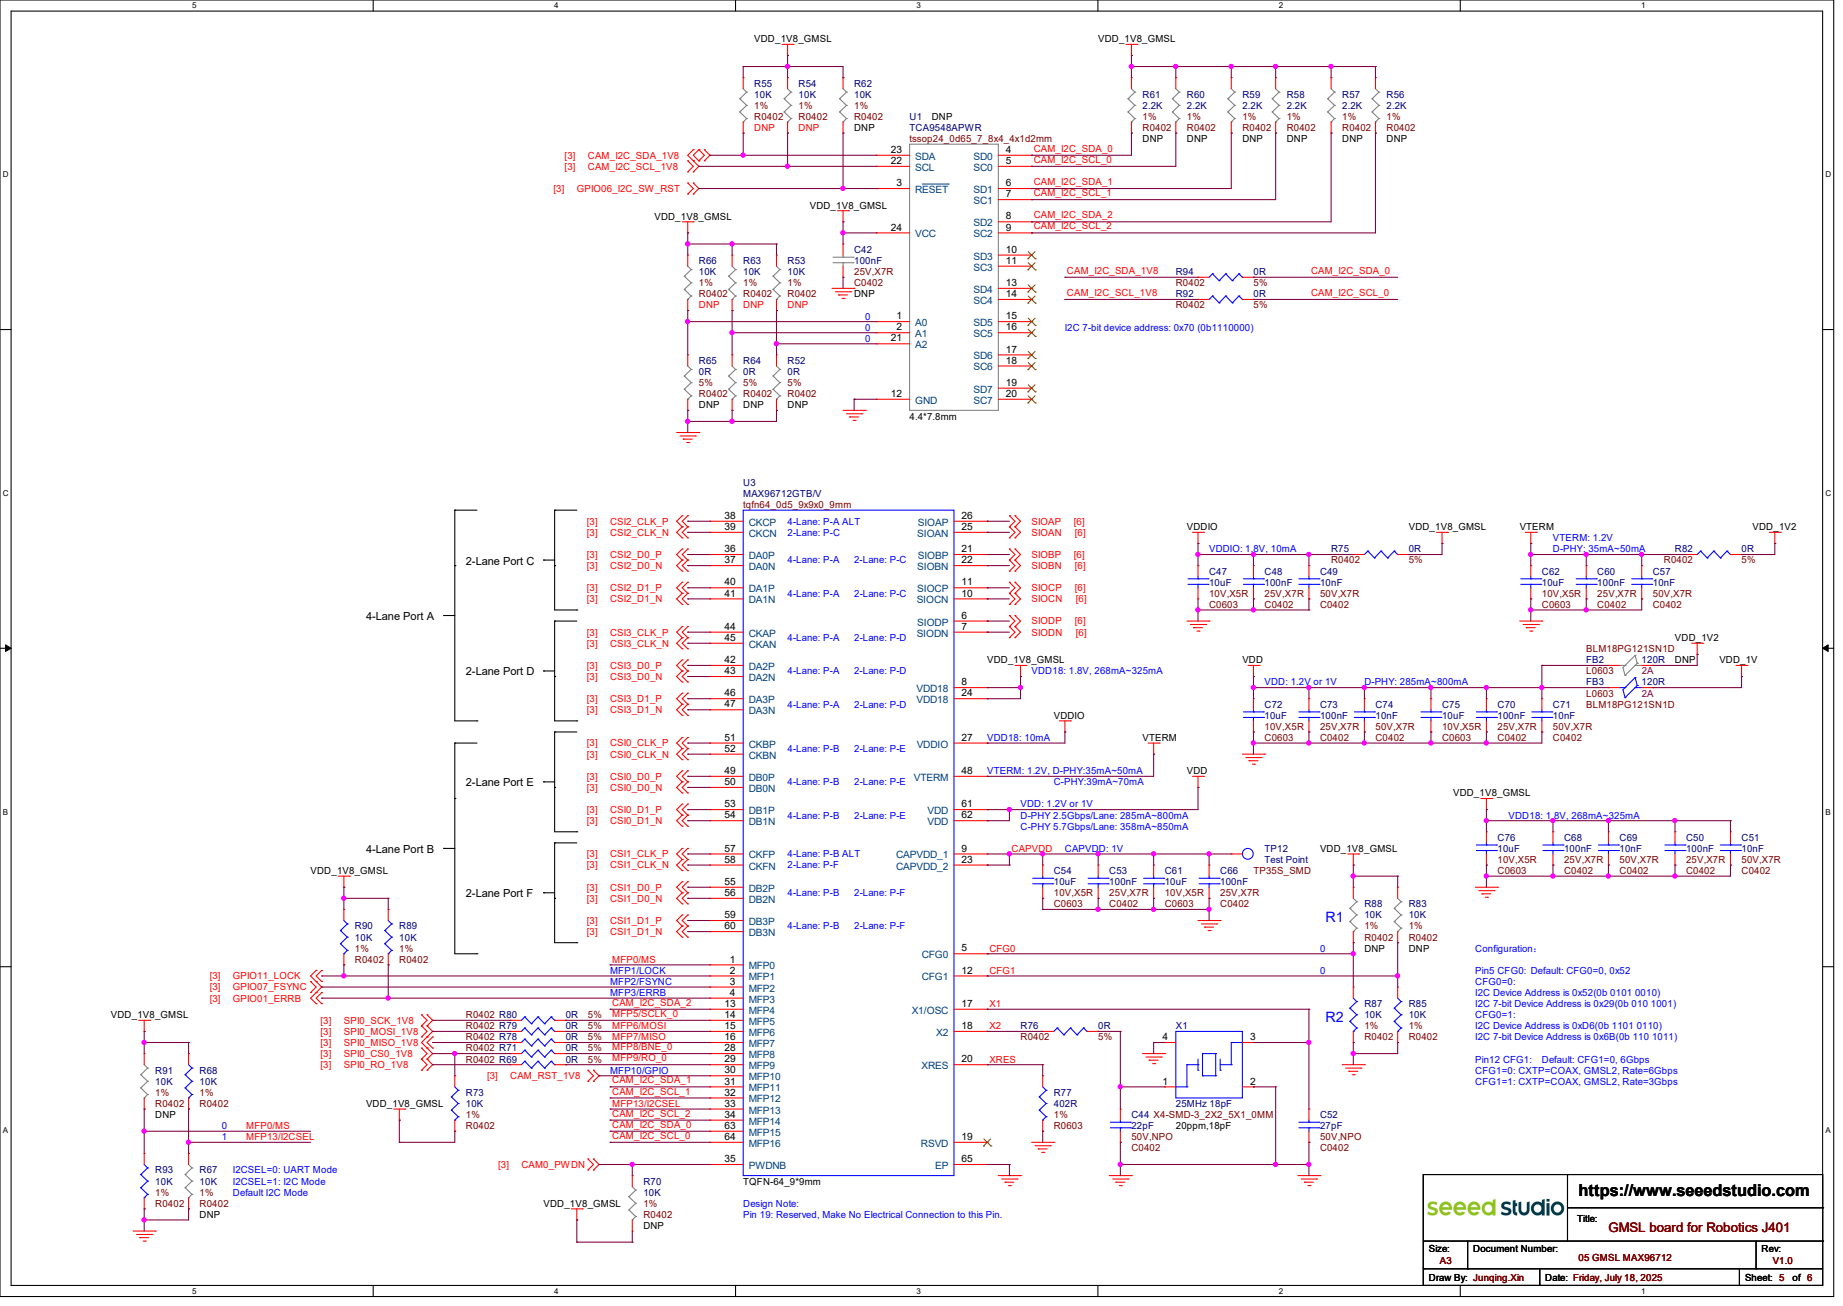
[picture p175: page 5]

VDD: 1.2V or 1V
D-PHY 2.5Gbps/Lane: 285mA~800mA C-PHY 5.7Gbps/Lane: 358mA~850mA

I2C 7-bit Device Address is 0x29(0b 010 1001) Pin5 CFG0: CFG1=0: CXTP=COAX, GMSL2, Rate=6Gbps CFG1=1: CXTP=COAX, GMSL2, Rate=3Gbps 0

Configuration： I2C Device Address is 0x52(0b 0101 0010) Pin12 CFG1:

R2 Design Note: Pin 19: Reserved, Make No Electrical Connection to this Pin.

I2C 7-bit Device Address is 0x6B(0b 110 1011)

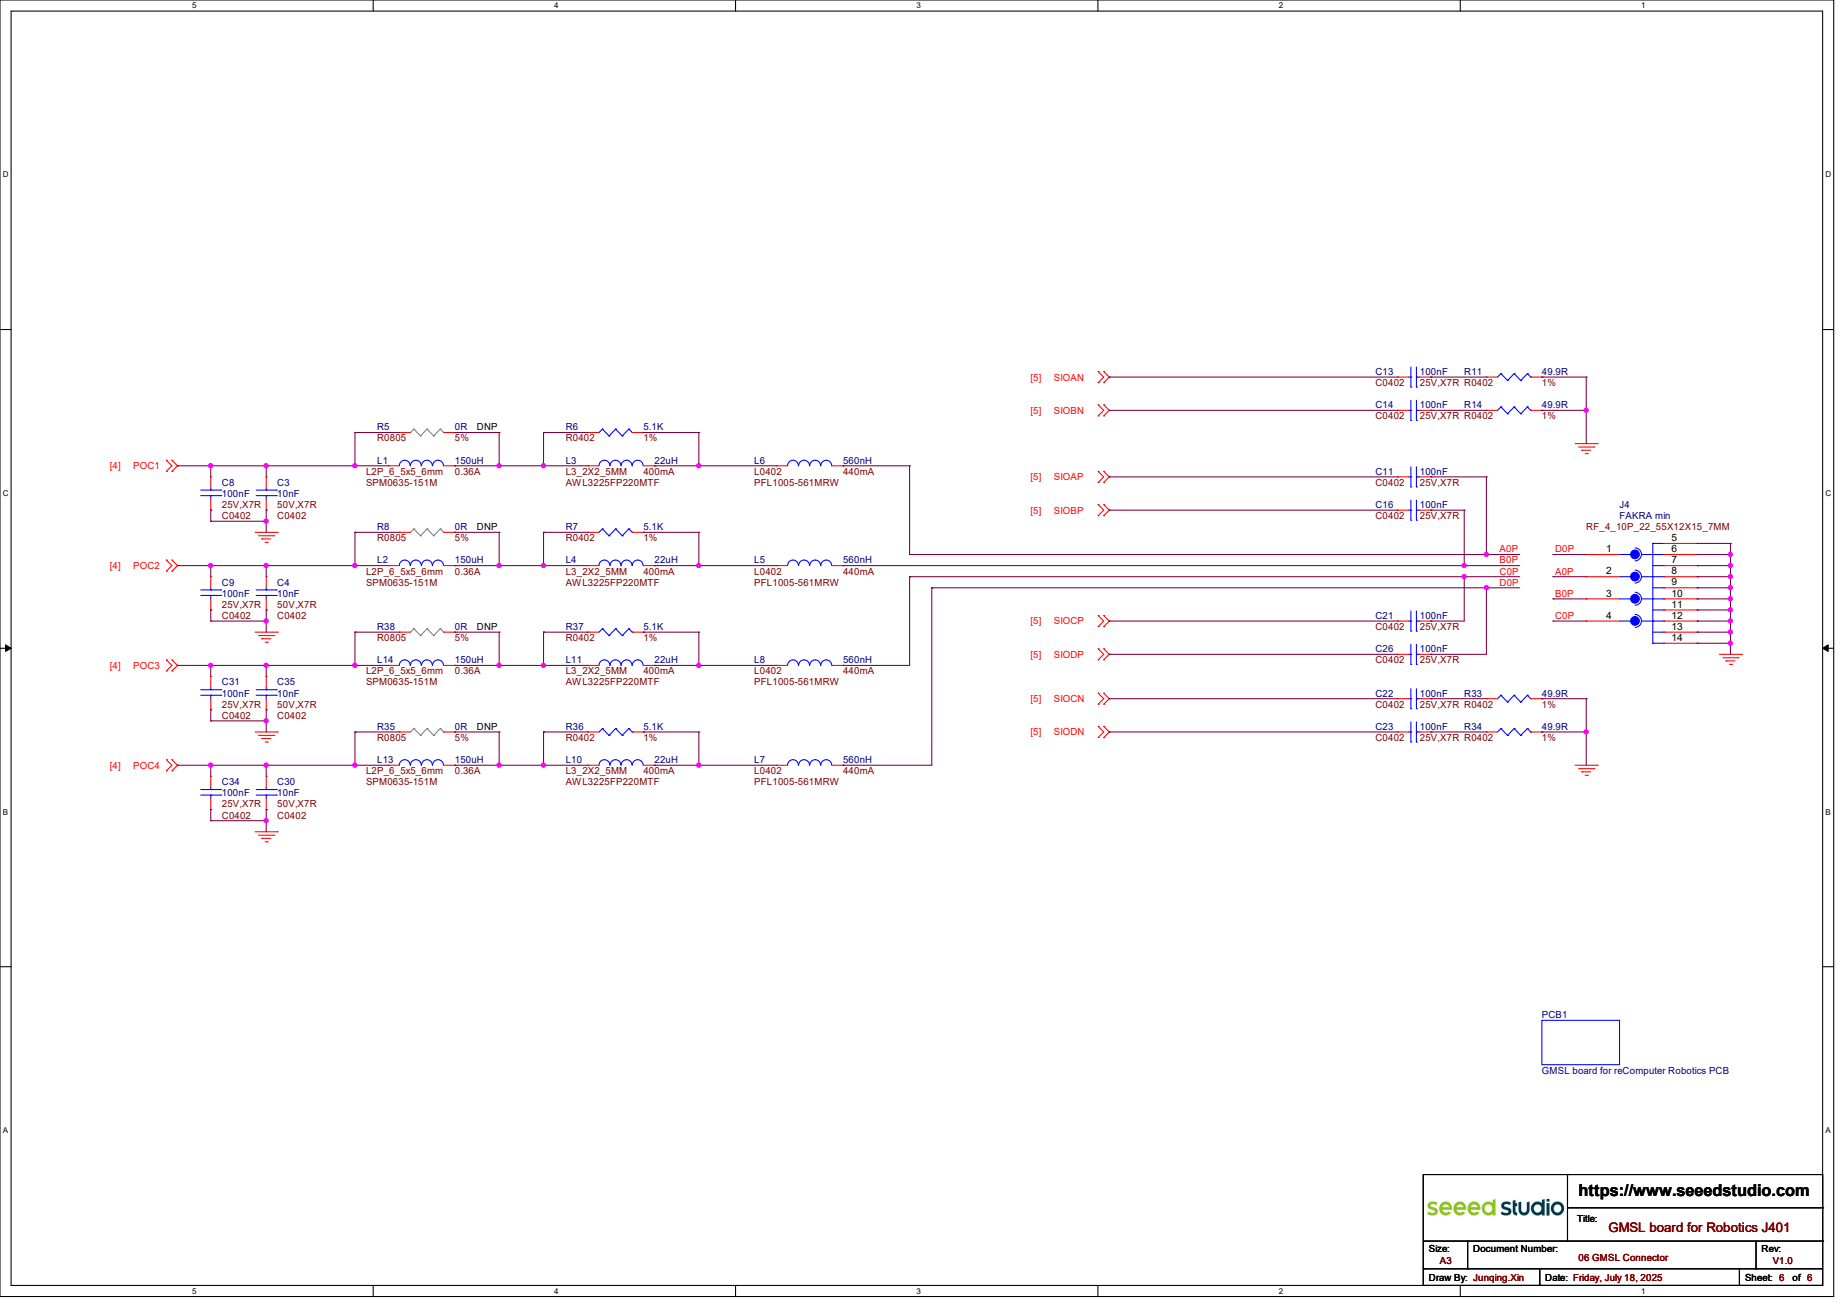
[picture p176: page 6]

GMSL board for Robotics J401 06 GMSL Connector
