Seeed-Studio/OSHW-Jetson-Series/reComputer Jetson carrier board/reComputer Robotics J401/Schematic/Power board for reComputer Robotics_V1.0_SCH_250507.pdf

# 01 Table of Contents

02 | Block Diagram

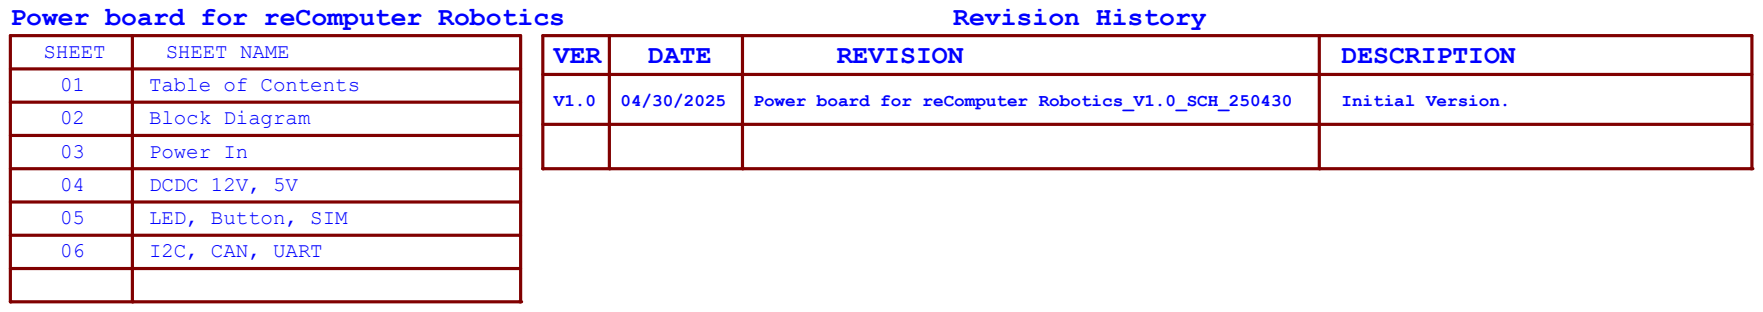
[picture p177: page 1]
SHEET NAME; VER; DATE; REVISION; DESCRIPTION; Revision History; Title: Size:; Document Number:; Rev: Draw By:; Date:; Sheet:; https://www.seeedstudio.com A3; Junqing.Xin; Wednesday, May 07, 2025; Power board for Robotics 01 Table of Contents Title: Size:

Power board for reComputer Robotics
SHEET

V1.0 | 04/30/2025 | Power board for reComputer Robotics_V1.0_SCH_250430 | Initial Version.

03 | Power In
04 | DCDC 12V, 5V
05 | LED, Button, SIM
06 | I2C, CAN, UART

Power board for Robotics 01 Table of Contents

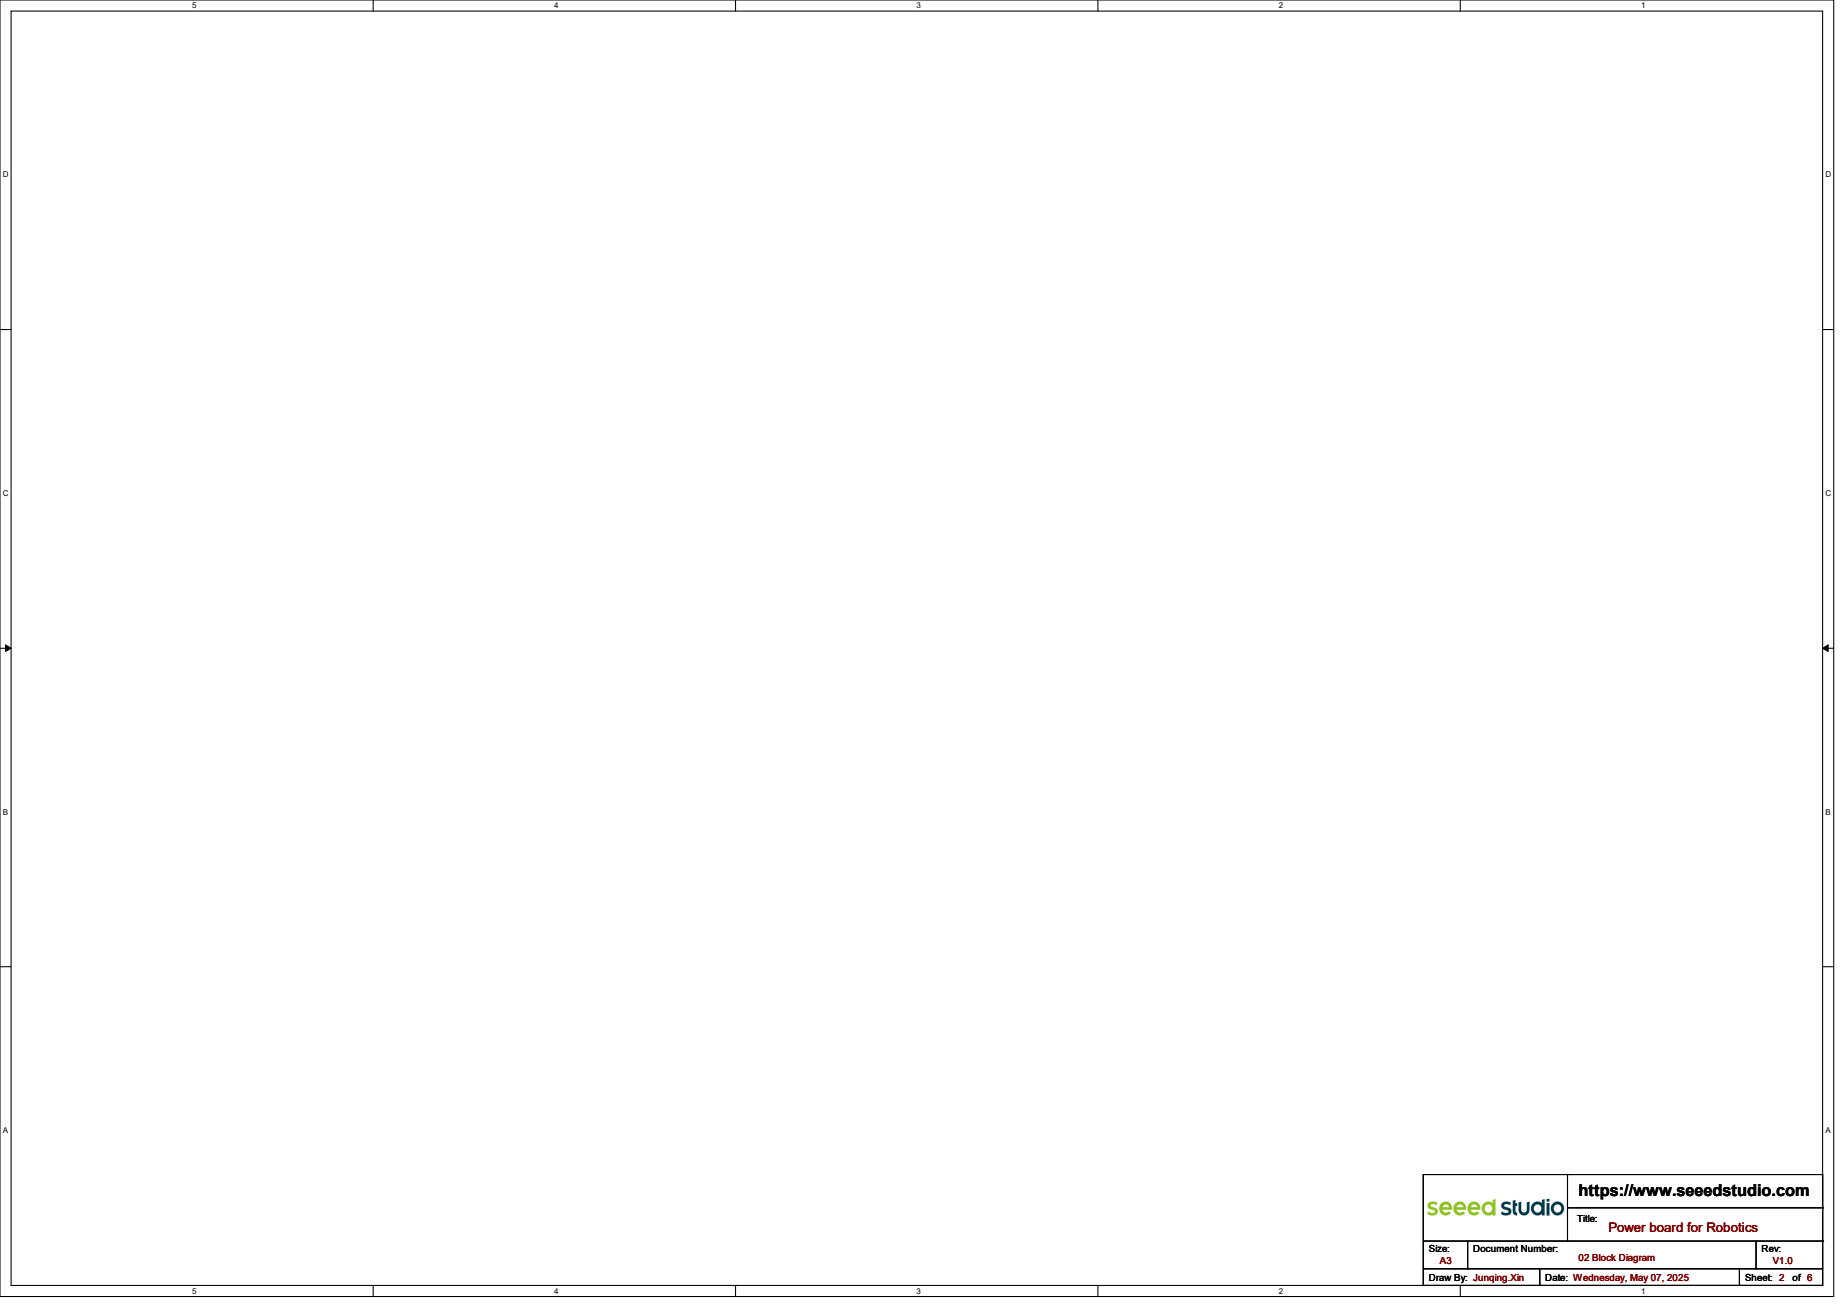
[picture p178: page 2]
A Title: Size:; Document Number:; Rev: Draw By:; Date:; Sheet:; https://www.seeedstudio.com A3; Junqing.Xin; Wednesday, May 07, 2025

Power board for Robotics 02 Block Diagram

# 19V to 54.6V

# 2.2uF x10 =22uF

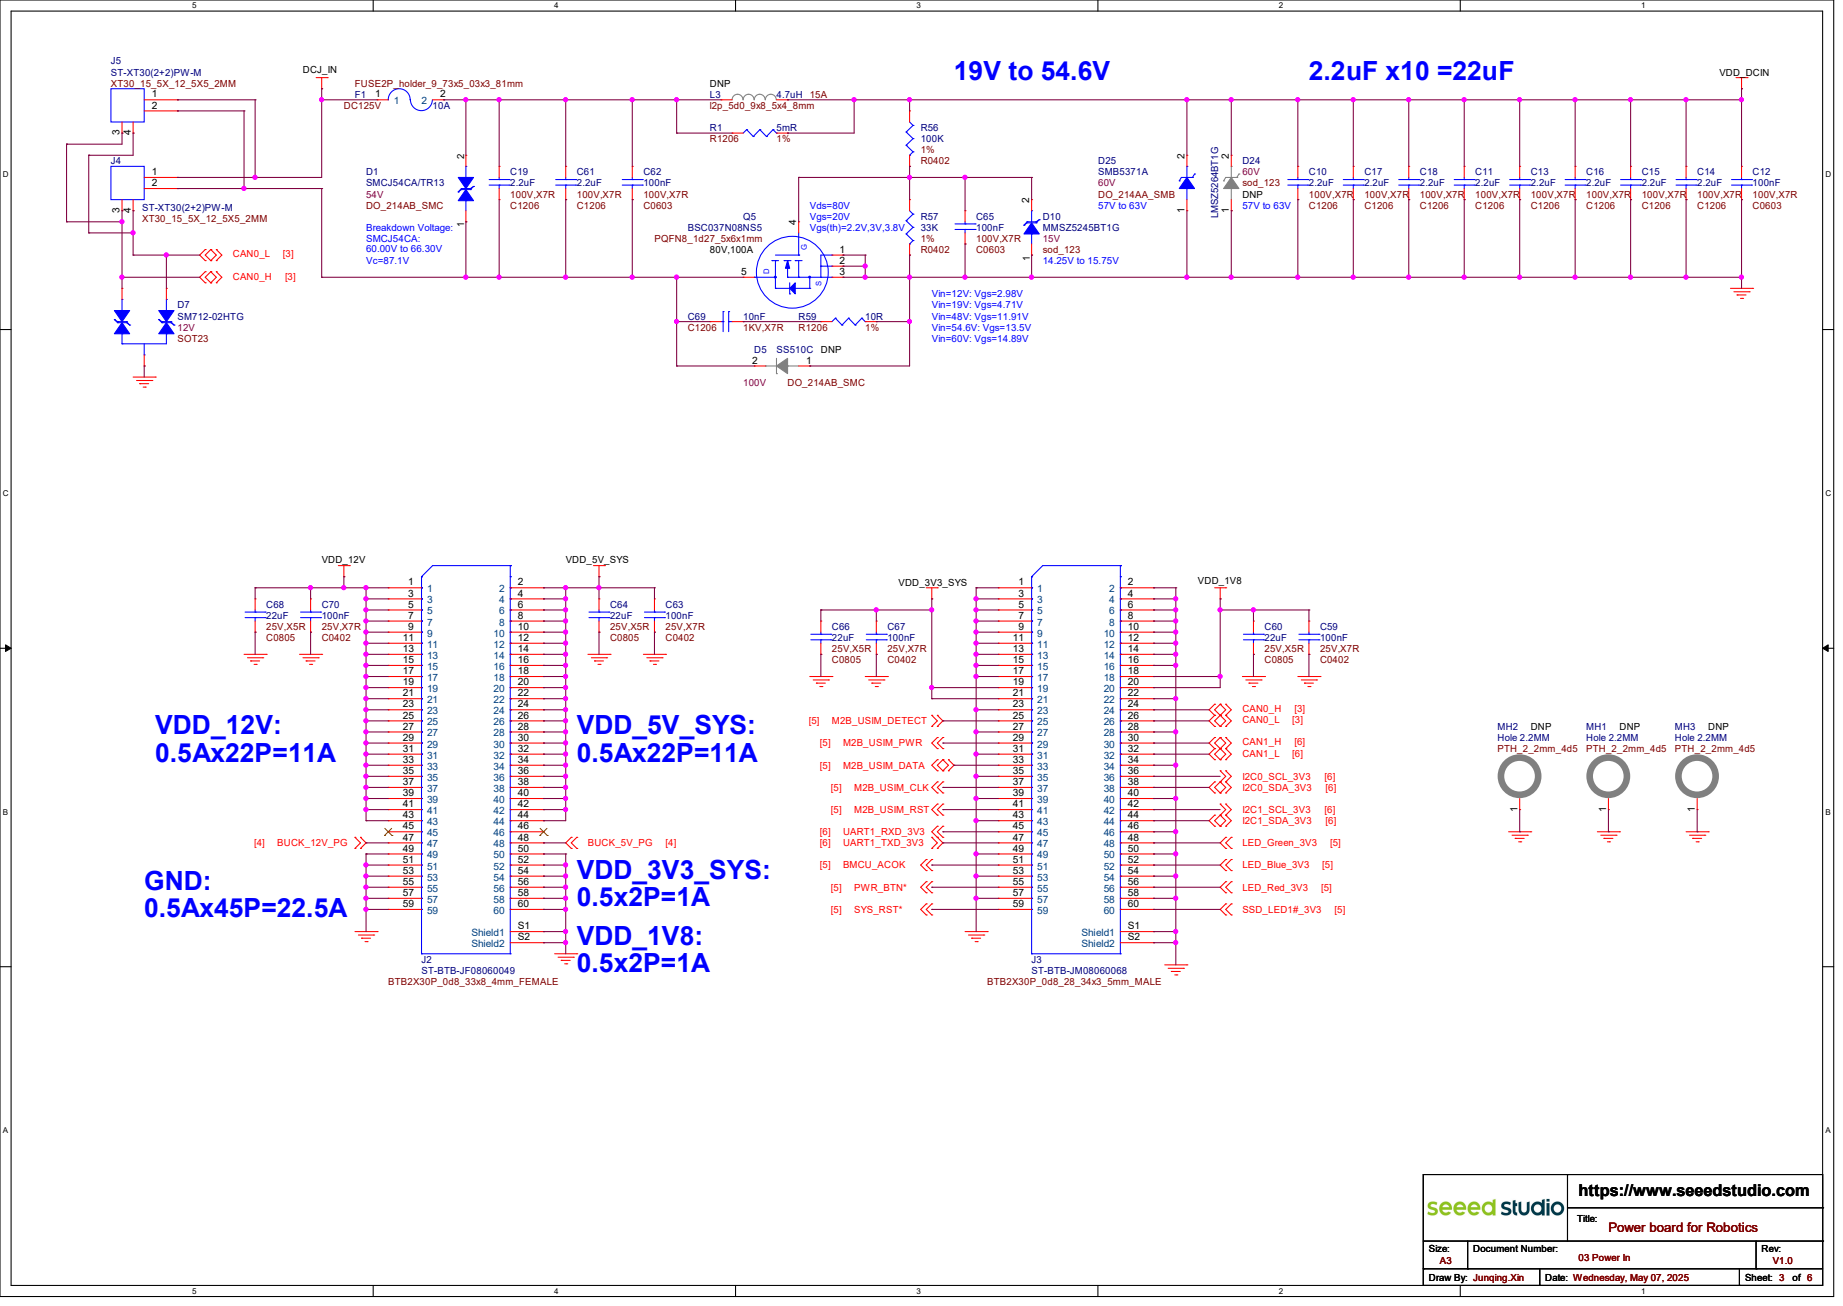
[picture p179: page 3]

Power board for Robotics 03 Power In

# 48V to 12V, Imax=8A

# R0402 R35 0R

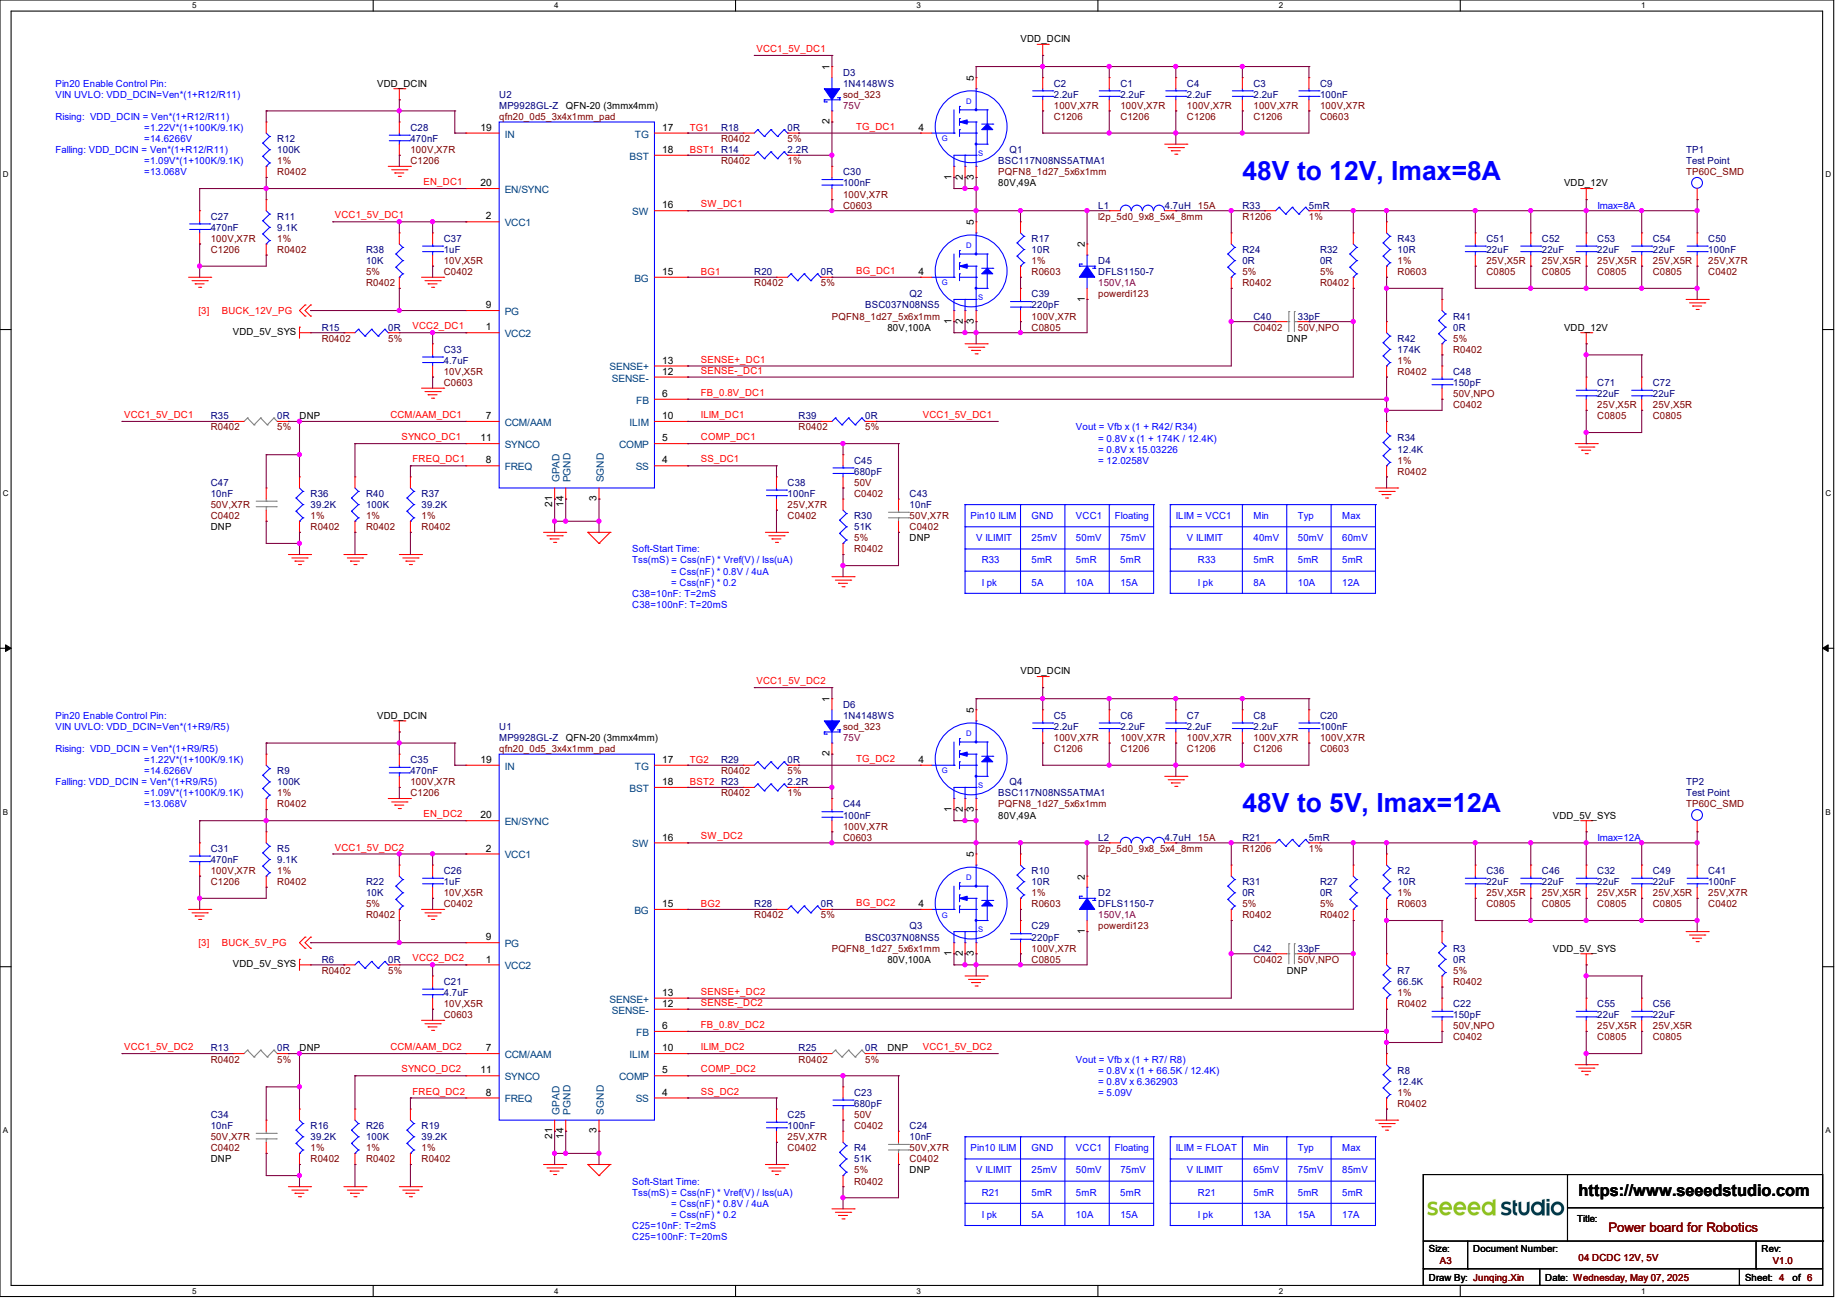
[picture p180: page 4]

Imax=8A Pin20 Enable Control Pin: VIN UVLO: VDD_DCIN=Ven*(1+R12/R11) Rising: VDD_DCIN = Ven*(1+R12/R11) =1.22V*(1+100K/9.1K) =14.6266V

3 SS 4 COMP 5 FB 6 CCM/AAM 7 FREQ 8 PG 9

Soft-Start Time: Tss(mS) = Css(nF) * Vref(V) / Iss(uA) = Css(nF) * 0.8V / 4uA

Imax=12A Pin20 Enable Control Pin:
VIN UVLO: VDD_DCIN=Ven*(1+R9/R5)

Falling: VDD_DCIN = Ven*(1+R9/R5) =1.09V*(1+100K/9.1K) Rising: VDD_DCIN = Ven*(1+R9/R5) =1.22V*(1+100K/9.1K) =13.068V

Tss(mS) = Css(nF) * Vref(V) / Iss(uA) C25=100nF: T=20mS
= Css(nF) * 0.8V / 4uA C25=10nF: T=2mS

Power board for Robotics 04 DCDC 12V, 5V

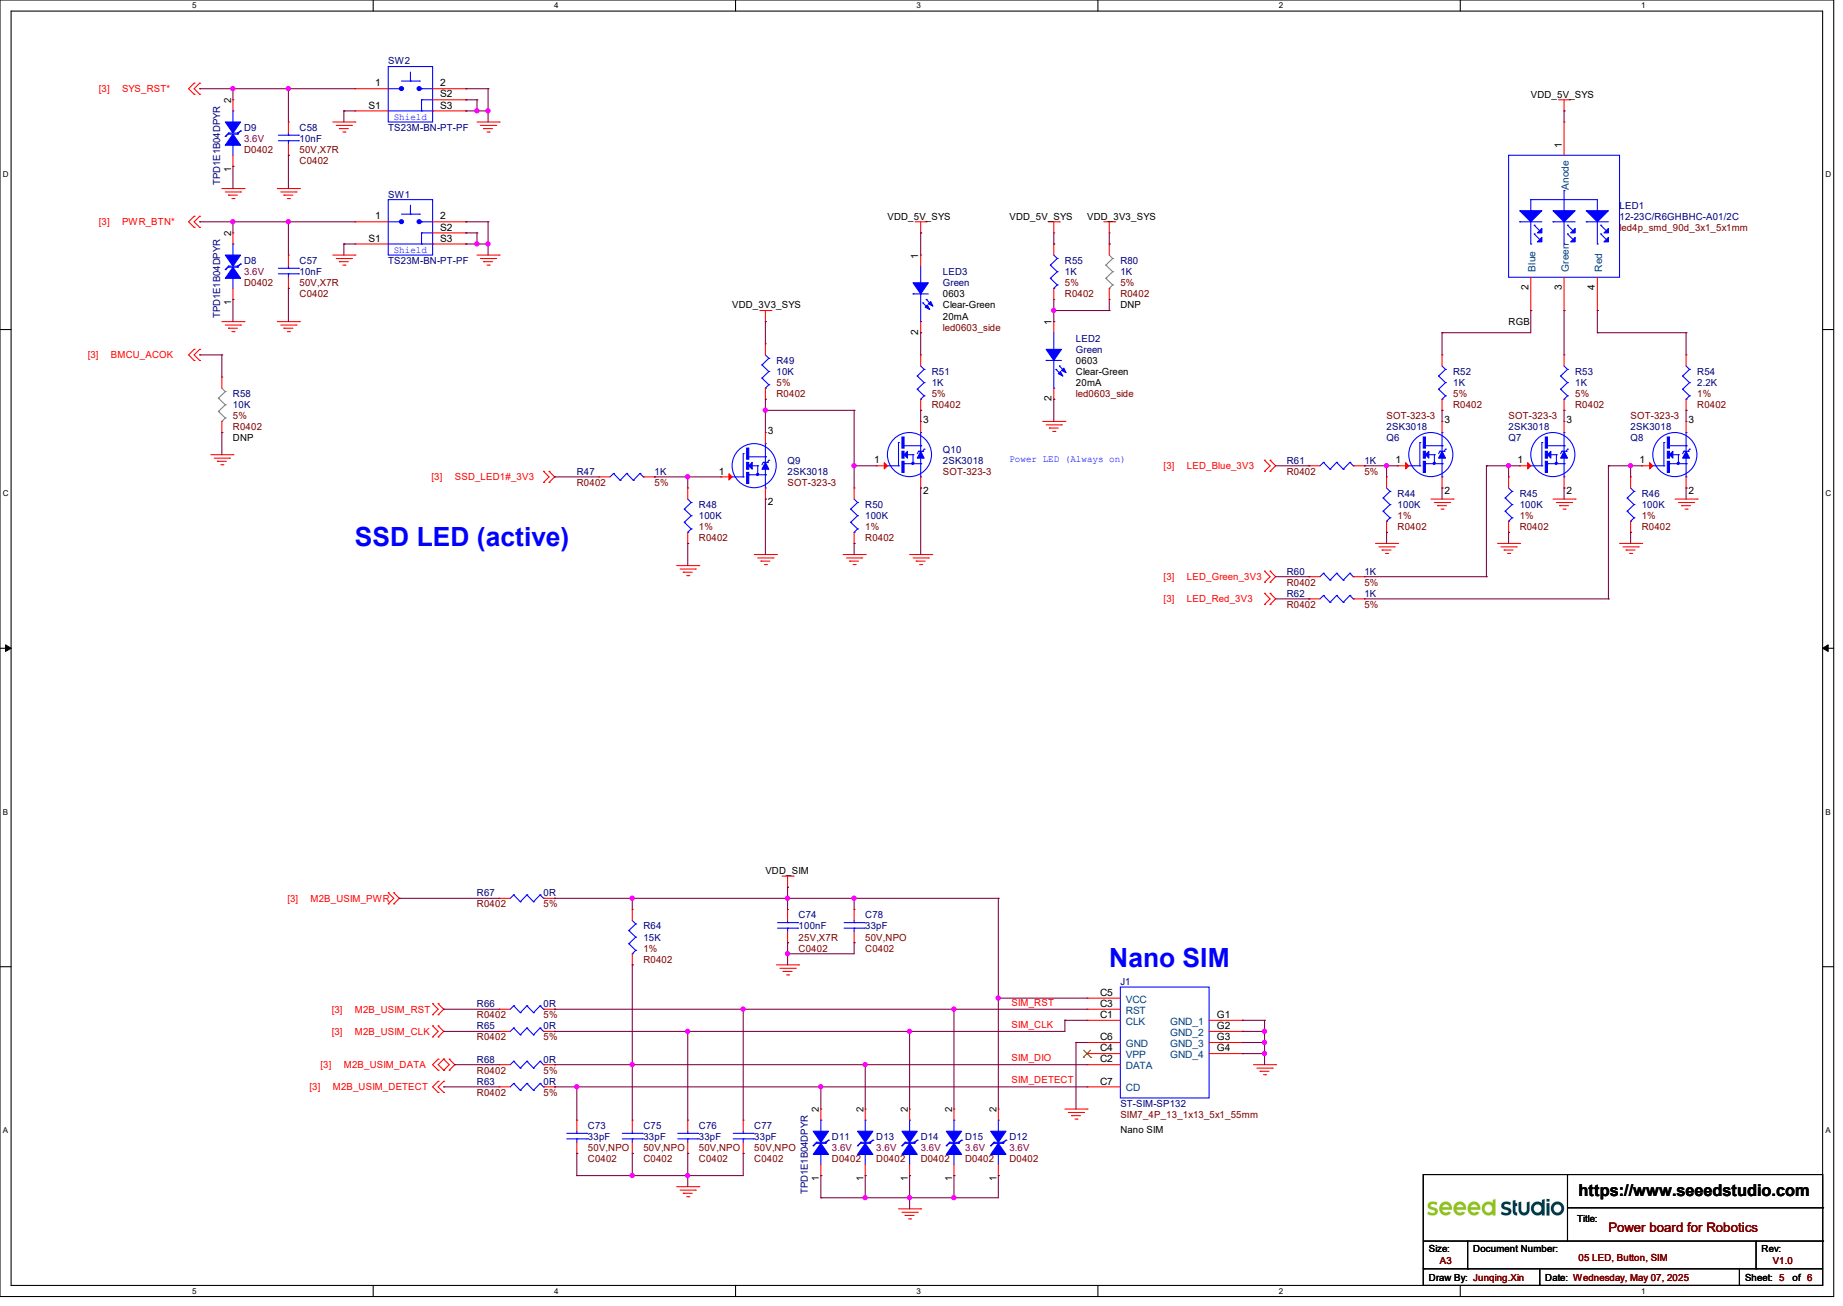
[picture p181: page 5]

Power LED (Always on)

Power board for Robotics 05 LED, Button, SIM

# CAN x3

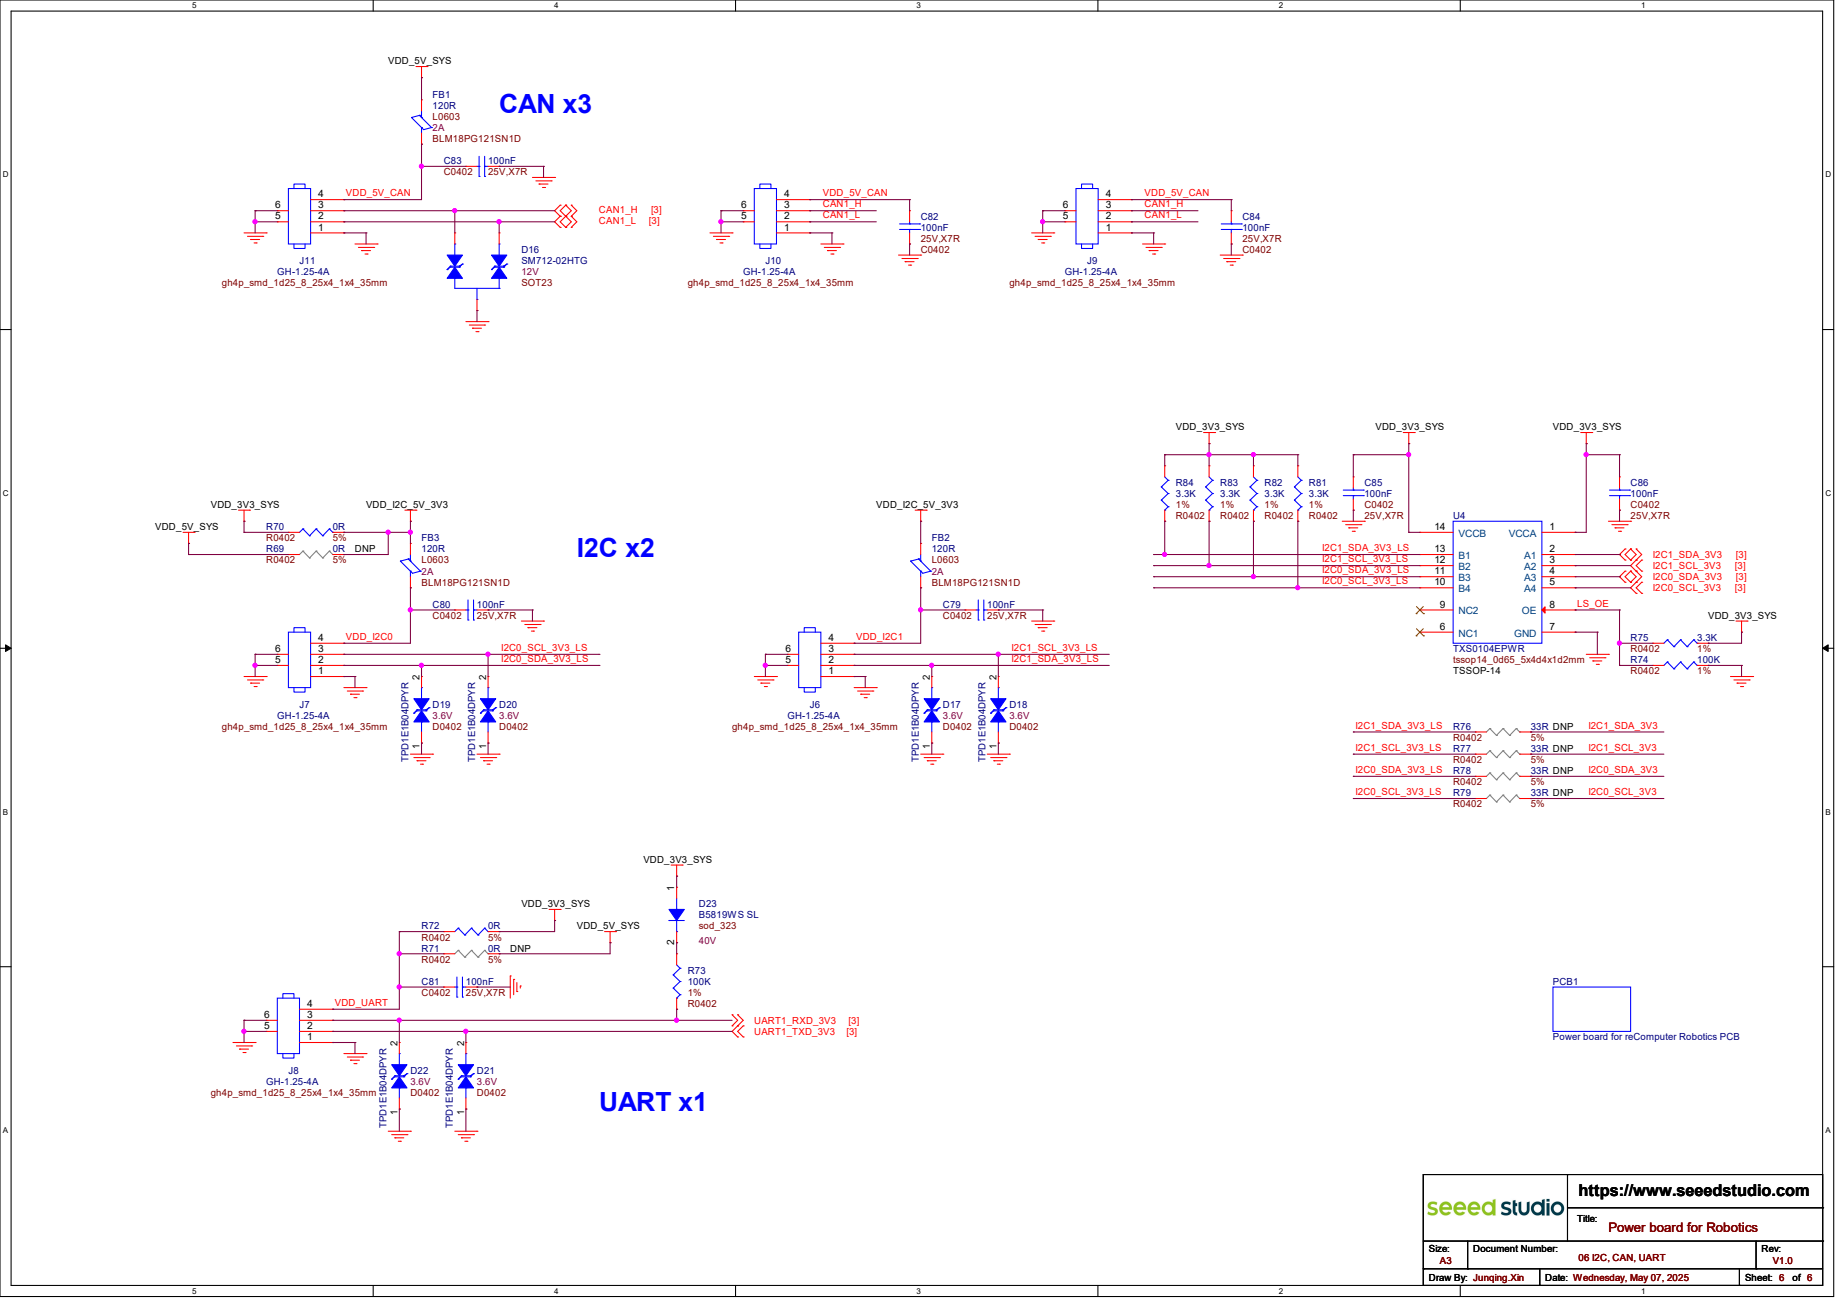
[picture p182: page 6]

Power board for Robotics 06 I2C, CAN, UART
