Seeed-Studio/OSHW-Jetson-Series/reComputer Jetson carrier board/reComputer Robotics J401/Schematic/reComputer Robotics J401_V1.0_SCH_250421.pdf

V1.0 | 04/21/2025 | reComputer Robotics J401_V1.0_SCH_250421 | Initial Version.

# DESCRIPTION

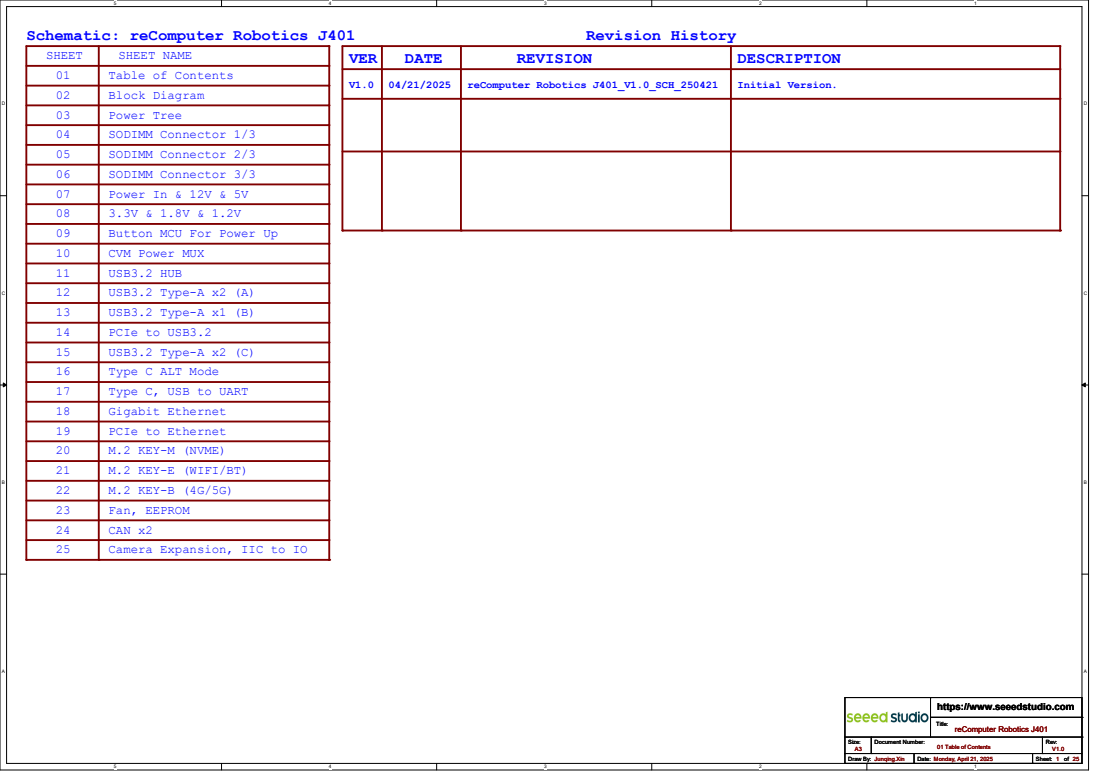
[picture p183: page 1]
REVISION; SHEET; SHEET NAME; VER; Revision History; DATE; Title: Size:; Document Number:; Rev: Draw By:; Date:; Sheet:; https://www.seeedstudio.com A3; Junqing.Xin; Monday, April 21, 2025; reComputer Robotics J401 01 Table of Contents Title: Size:

Schematic: reComputer Robotics J401

01 | Table of Contents
02 | Block Diagram
03 | Power Tree
04 | SODIMM Connector 1/3
05 | SODIMM Connector 2/3
06 | SODIMM Connector 3/3
07 | Power In & 12V & 5V
08 | 3.3V & 1.8V & 1.2V
09 | Button MCU For Power Up
10 | CVM Power MUX
11 | USB3.2 HUB
12 | USB3.2 Type-A x2 (A)
13 | USB3.2 Type-A x1 (B)
14 | PCIe to USB3.2
15 | USB3.2 Type-A x2 (C)
16 | Type C ALT Mode
17 | Type C, USB to UART
18 | Gigabit Ethernet
19 | PCIe to Ethernet
20 | M.2 KEY-M (NVME)
21 | M.2 KEY-E (WIFI/BT)
22 | M.2 KEY-B (4G/5G)
23 | Fan, EEPROM
24 | CAN x2
25 | Camera Expansion, IIC to IO

reComputer Robotics J401 01 Table of Contents

USBSS0 HDMI | UART1 UART0 RECOVERY

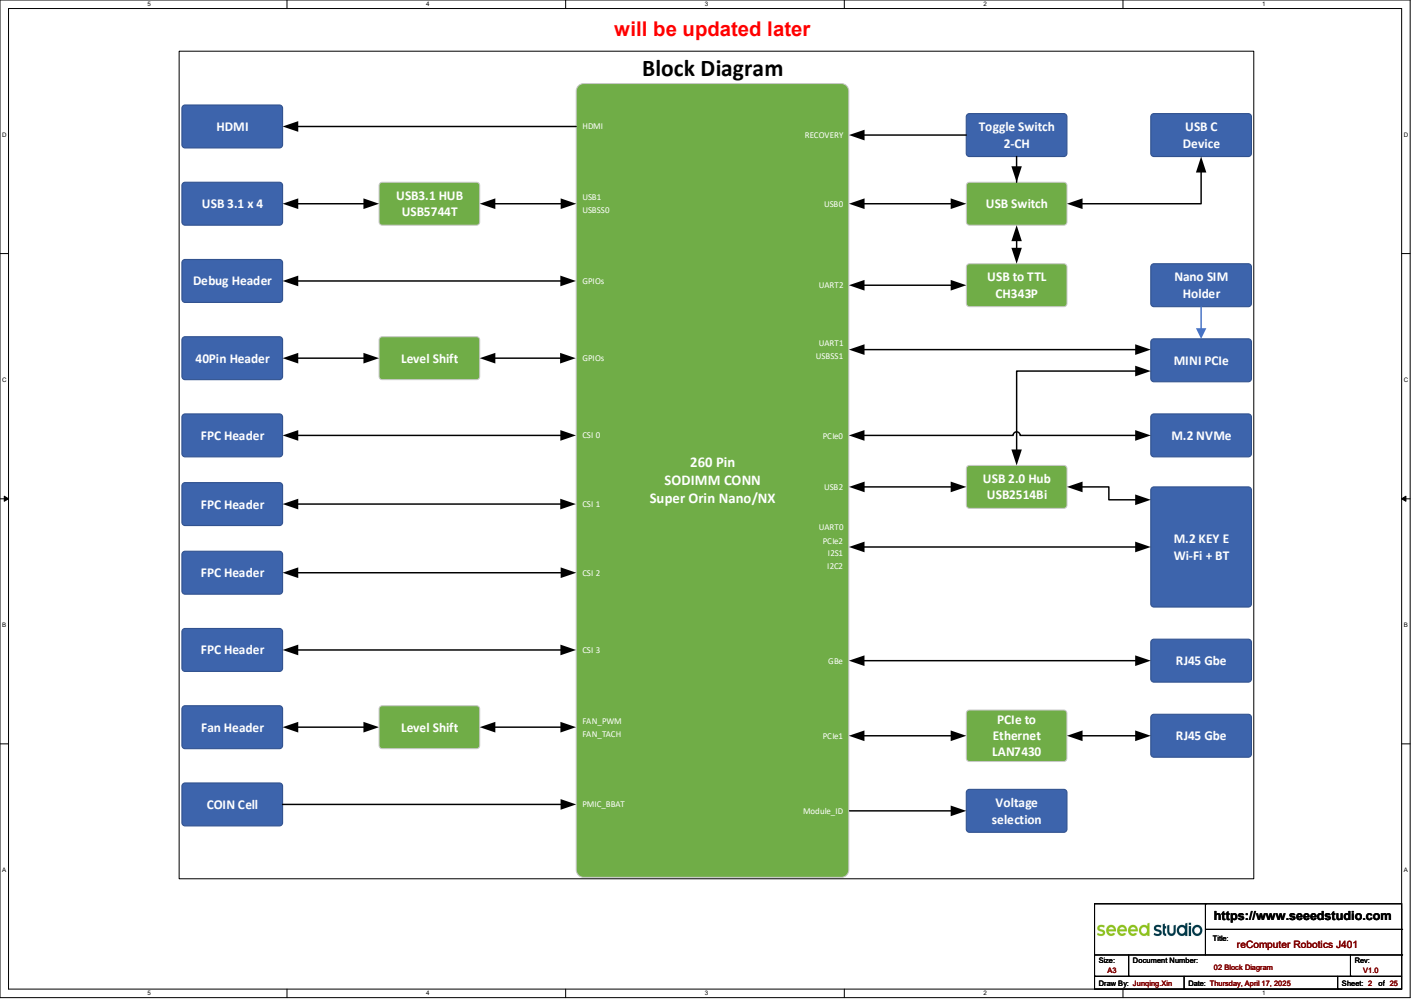
[picture p184: page 2]
USB2; Level Shift; Debug Header; USB 3.1 x 4; USB3.1 HUB; USB5744T; HDMI; USB Switch; USB C Device; Toggle Switch 2-CH; 40Pin Header; FPC Header; Fan Header; COIN Cell; MINI PCIe; M.2 NVMe; RJ45 Gbe; PCIe to Ethernet LAN7430; Voltage selection; FAN_PWM FAN_TACH; PMIC_BBAT; USB0 UART2; Nano SIM; Holder PCIe0 PCIe2 PCIe1; I2S1 I2C2 GBe; USB1; USBSS1; USB 2.0 Hub USB2514Bi; Module_ID; https://www.seeedstudio.com A3; Junqing.Xin; Thursday, April 17, 2025

will be updated later
Block Diagram

GPIOs GPIOs CSI 0 CSI 1 CSI 2 CSI 3

USB to TTL

260 Pin
SODIMM CONN
Super Orin Nano/NX

M.2 KEY E

reComputer Robotics J401 02 Block Diagram

Imax= 3A | Module Voltage Switch

# DC JACK

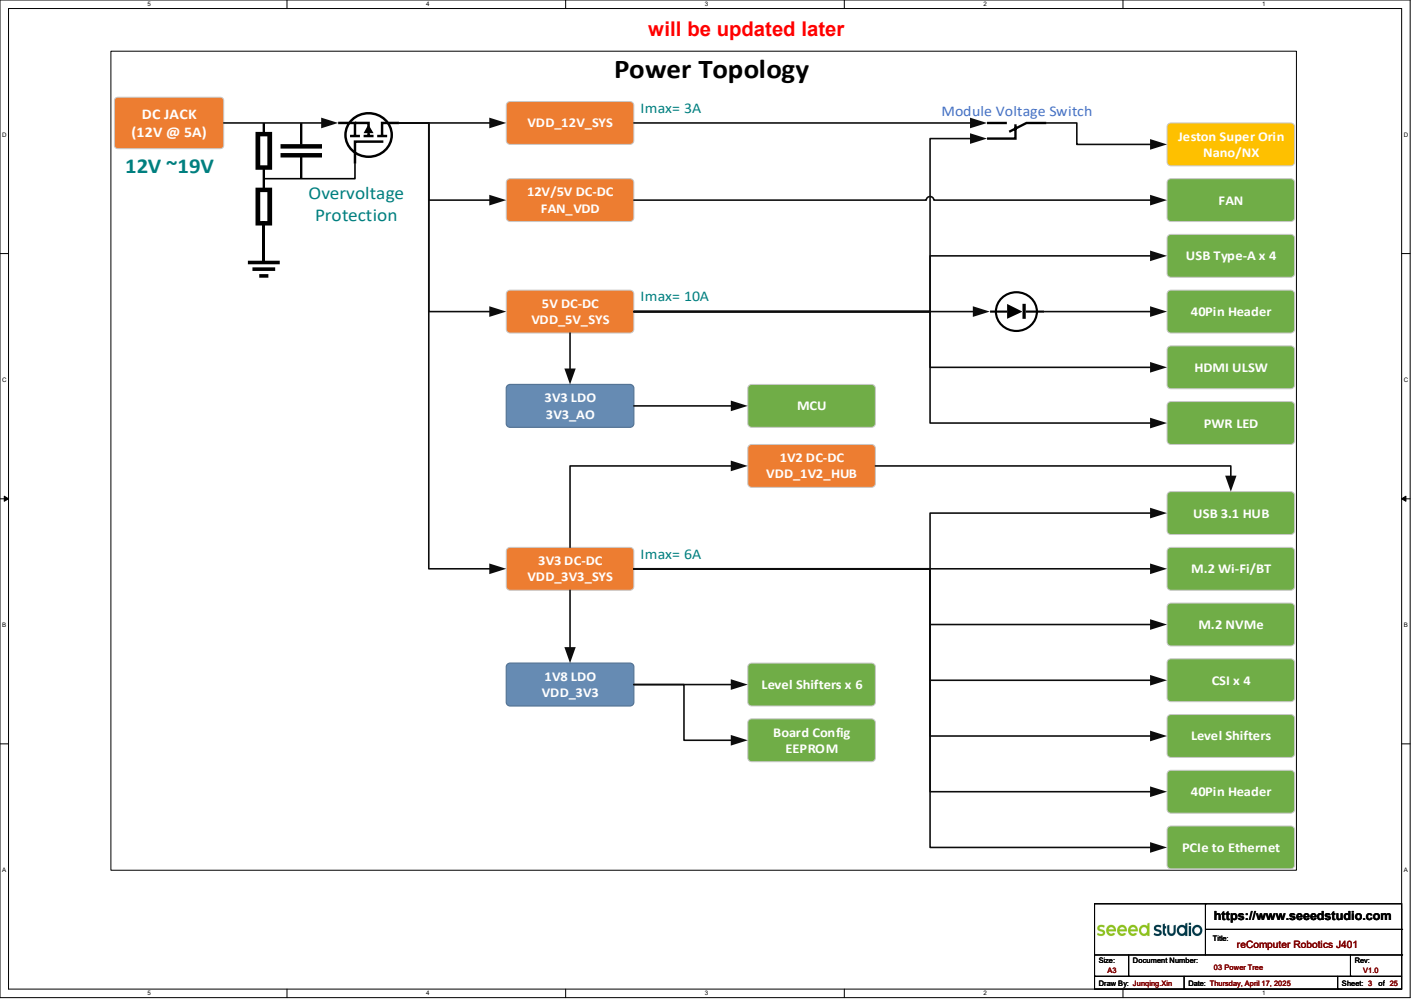
[picture p185: page 3]
Imax= 10A; Imax= 6A; VDD_12V_SYS; 5V DC-DC VDD_5V_SYS; 3V3 LDO; MCU; FAN; 1V2 DC-DC VDD_1V2_HUB; USB Type-A x 4; 40Pin Header; HDMI ULSW; PWR LED; 3V3 DC-DC VDD_3V3_SYS; 1V8 LDO; VDD_3V3; Level Shifters x 6; USB 3.1 HUB; M.2 NVMe; CSI x 4; Level Shifters; Board Config EEPROM; 12V/5V DC-DC FAN_VDD; Overvoltage Protection; https://www.seeedstudio.com A3; Junqing.Xin; Thursday, April 17, 2025; reComputer Robotics J401 03 Power Tree Title: Size:; Document Number:; Rev: Draw By:; Date:; Sheet:

will be updated later
Power Topology

Jeston Super Orin
Nano/NX

PCIe to Ethernet

reComputer Robotics J401 03 Power Tree

# UART, I2C, CAN and GPIOs

I2C0_SCL_3V3 | [7] UART0_TXD_1V8 | [21,22] UART0_RXD_1V8 | [21,22] UART1_TXD_1V8 | [7] UART1_RXD_1V8 | [7] USB_PD_INT_1V8 | [16] UART2_TXD | [17] UART2_RXD | [17] MOD_SLEEP* | [7] POWER_EN | [9] SHUTDOWN_REQ* | [9] SYS_RST* | [7,9] FORCE_RECOVERY* | [17]

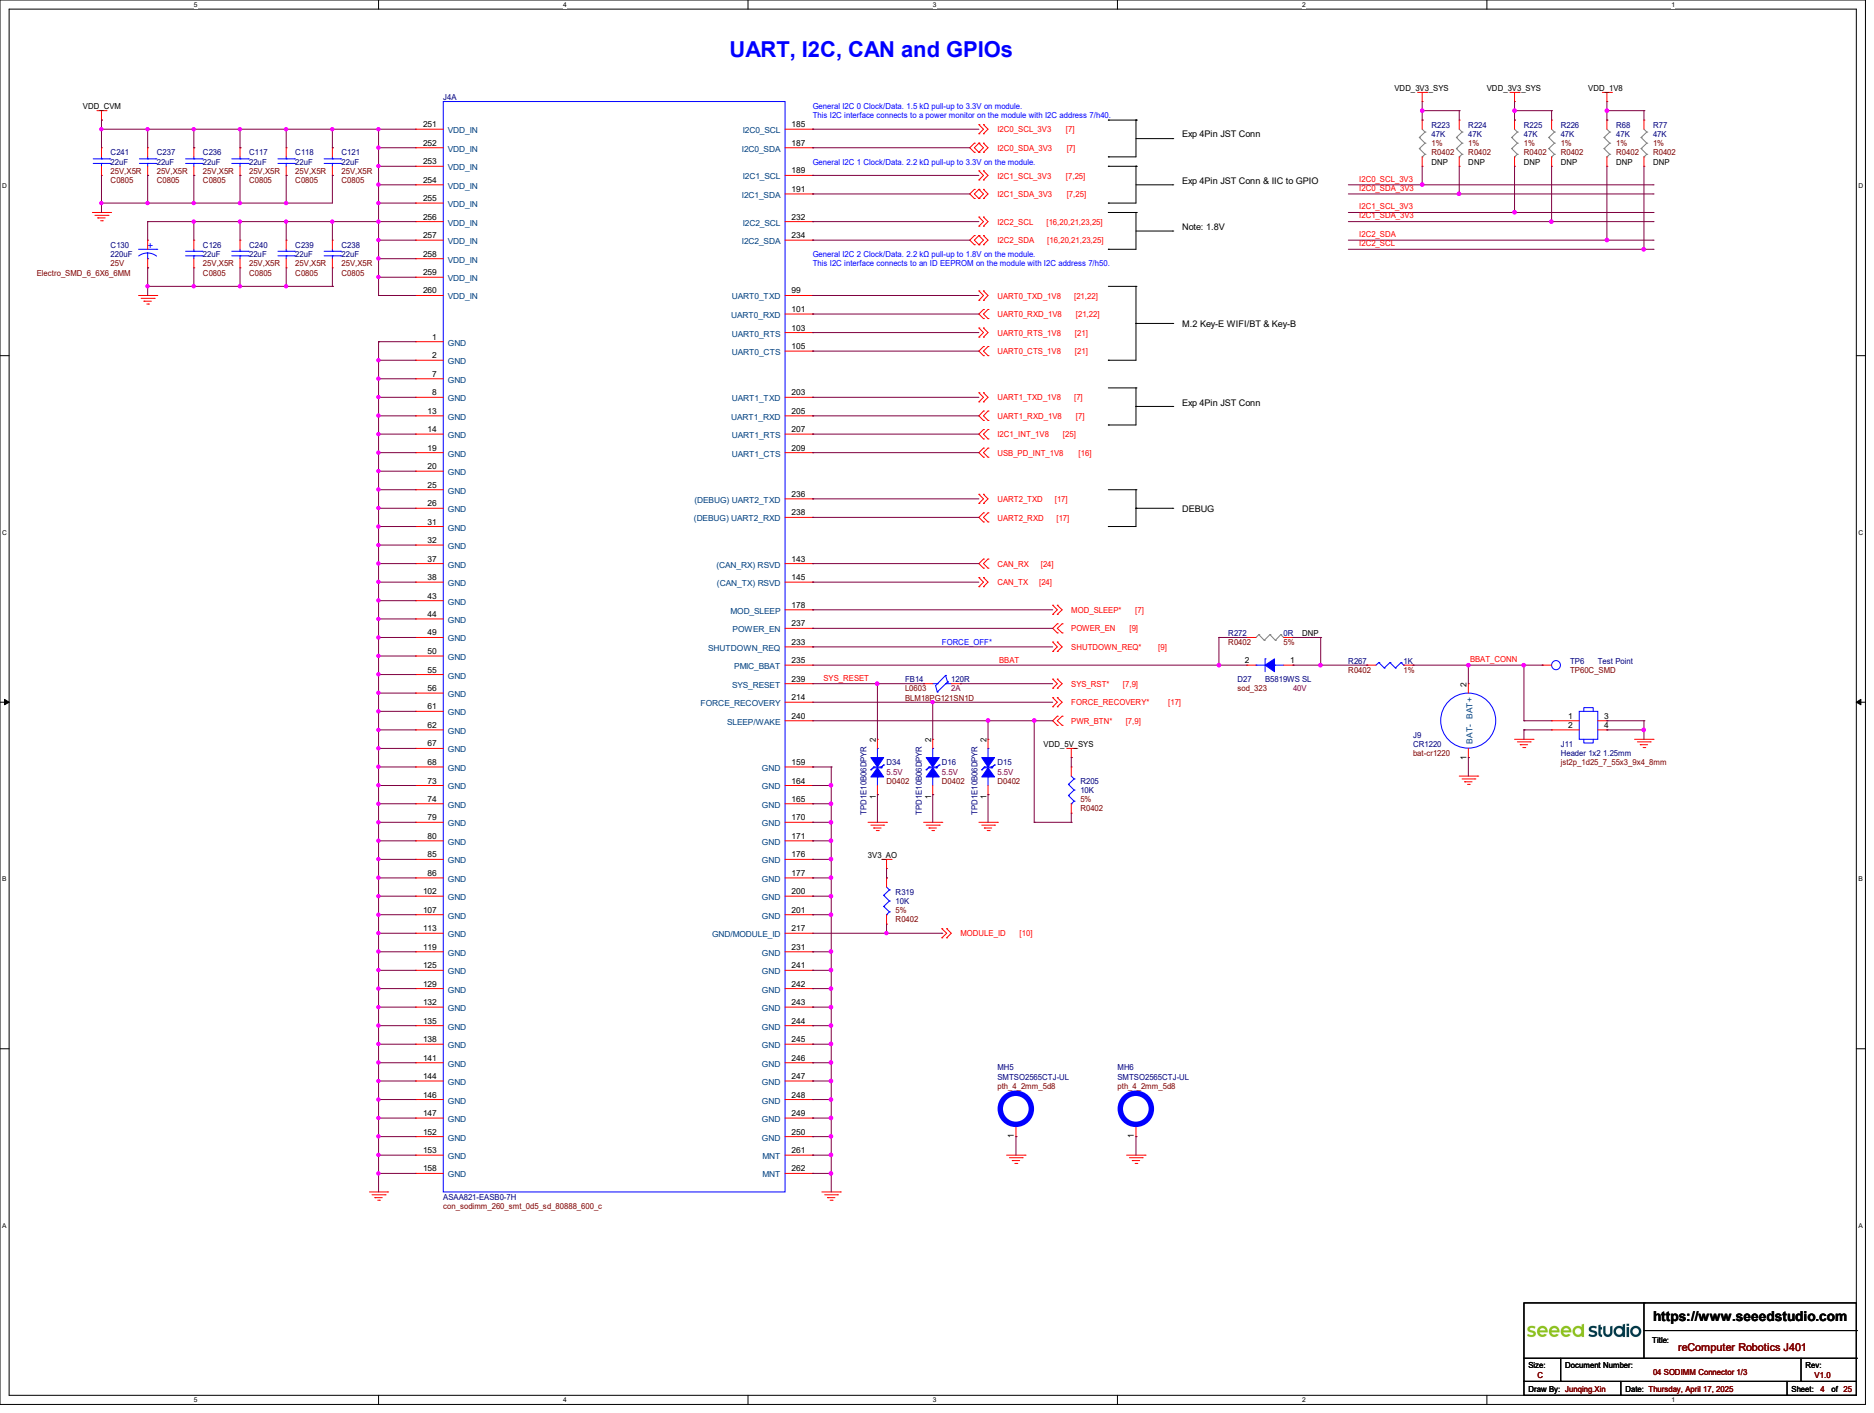
[picture p186: page 4]

VDD_IN 251 VDD_IN 252 VDD_IN 253 VDD_IN 254 VDD_IN 255 VDD_IN 256 VDD_IN 257 VDD_IN 258 VDD_IN 259 VDD_IN 260 GND 1 GND 2 GND 7 GND 8 GND 13 GND 14 GND 19 GND 20 GND 25 GND 26 GND 31 GND 32 GND 37 GND 38 GND 43 GND 44 GND 49 GND 50 GND 55 GND 56 GND 61 GND 62 GND 67 GND 68 GND 73 GND 74 GND 79 GND 80 GND 85 GND 86 GND 102 GND 107 GND 113 GND 119 GND 125 GND 129 GND 132 GND 135 GND 138 GND 141 GND 144 GND 146 GND 147 GND 152 GND 153 GND 158

Note: 1.8V General I2C 0 Clock/Data. 1.5 kΩ pull-up to 3.3V on module. This I2C interface connects to a power monitor on the module with I2C address 7/h40. General I2C 2 Clock/Data. 2.2 kΩ pull-up to 1.8V on the module. This I2C interface connects to an ID EEPROM on the module with I2C address 7/h50. General I2C 1 Clock/Data. 2.2 kΩ pull-up to 3.3V on the module.

M.2 Key-E WIFI/BT & Key-B

reComputer Robotics J401 04 SODIMM Connector 1/3

# GPIOs, USB2.0, I2S, SPI, GBe and CSI

CSI1_D0_P | [25] CSI1_D0_N | [25] CSI1_D1_P | [25] CSI1_D1_N | [25] CSI1_CLK_P | [25] CSI1_CLK_N | [25] CSI3_D0_P | [25] CSI3_D0_N | [25] CSI3_D1_P | [25] CSI3_D1_N | [25] CSI3_CLK_P | [25] CSI3_CLK_N | [25]

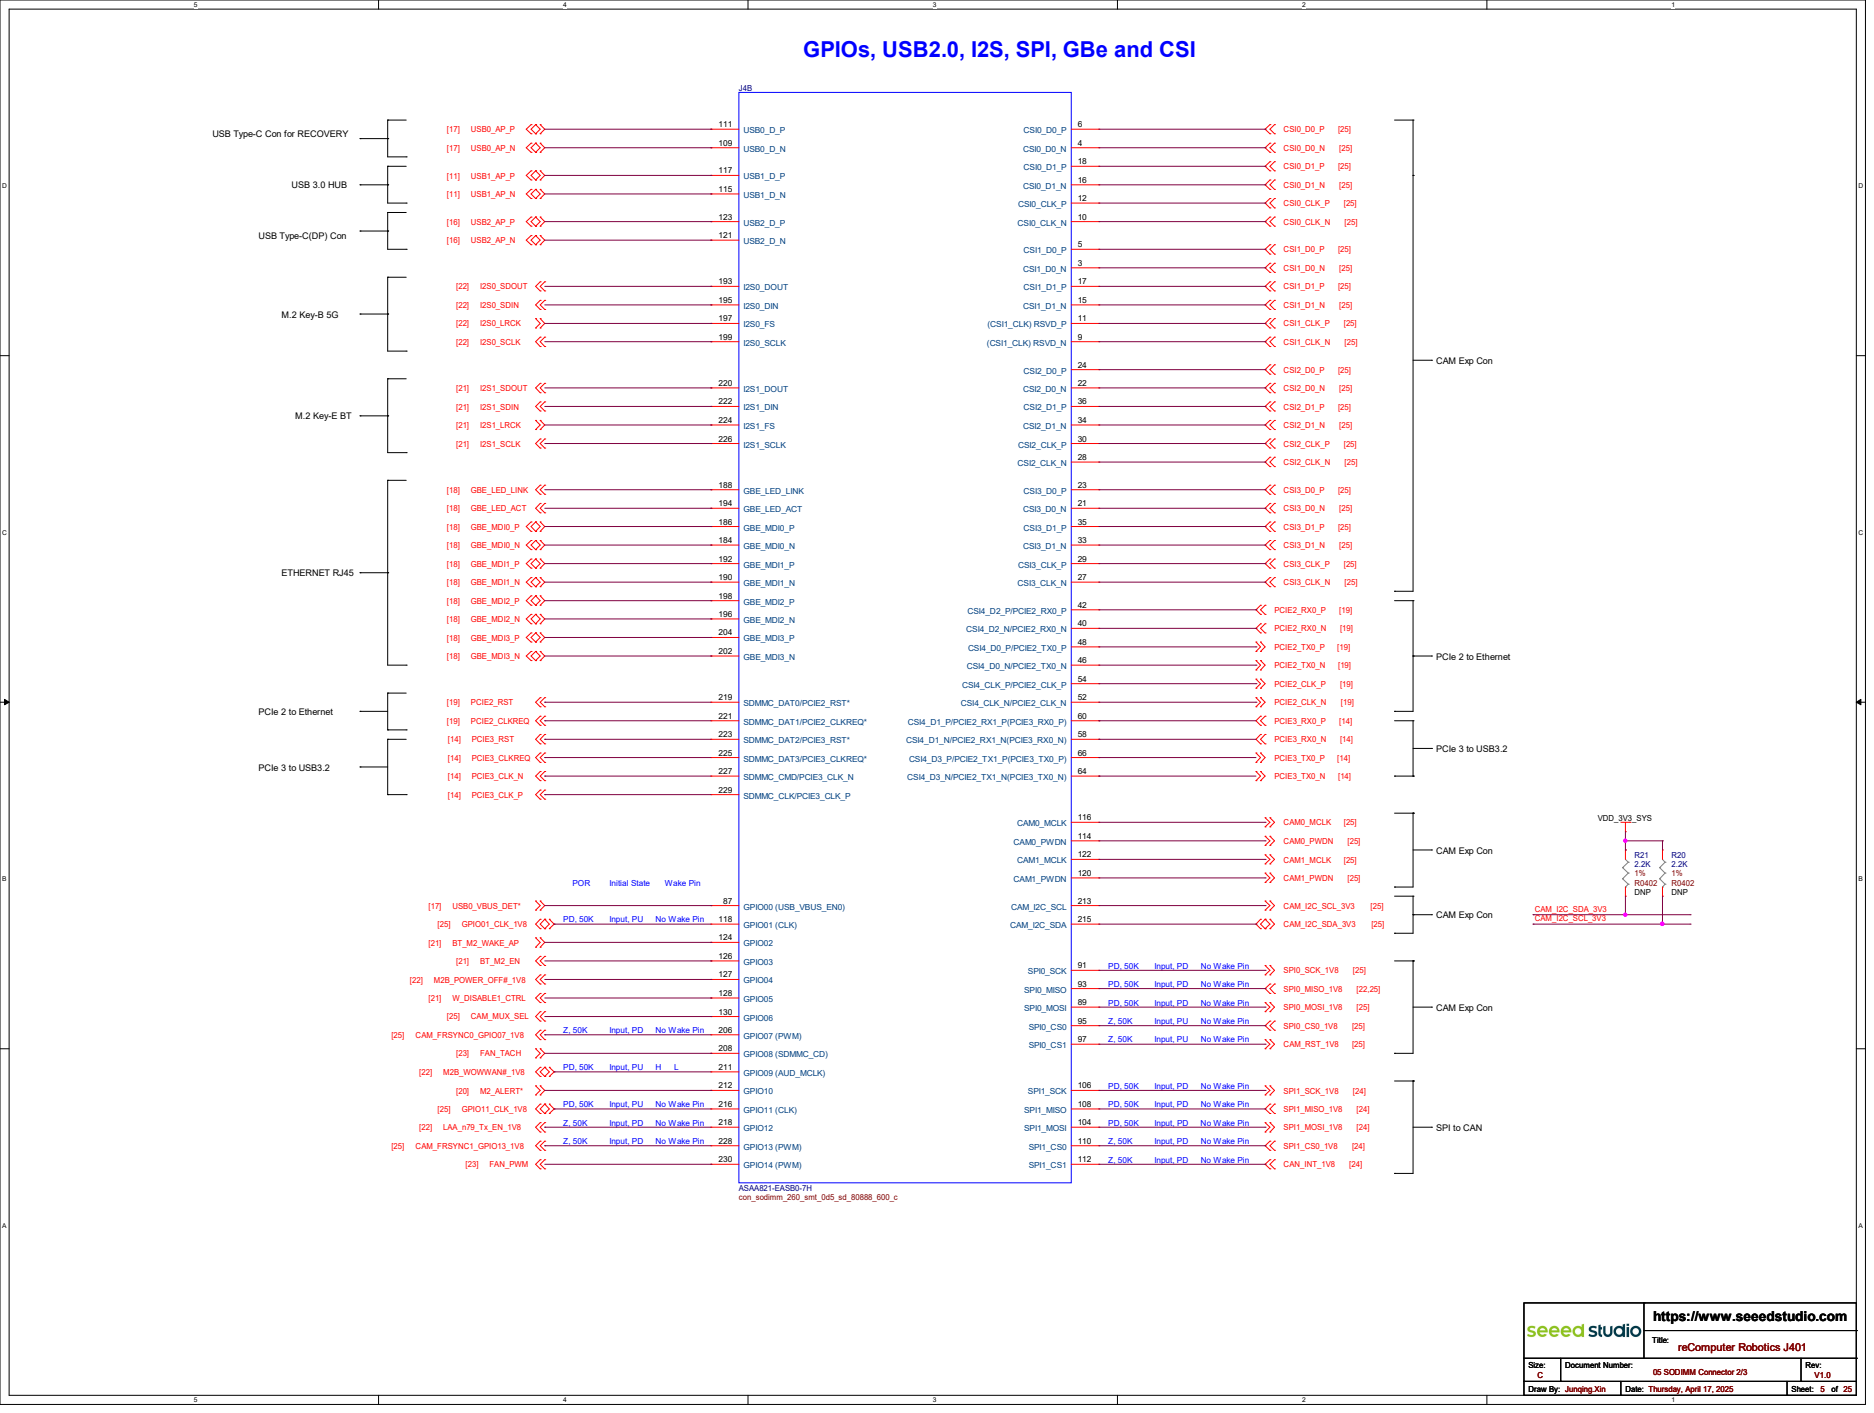
[picture p187: page 5]
M.2 Key-B 5G; M.2 Key-E BT; ETHERNET RJ45; USB 3.0 HUB; PCIe 3 to USB3.2; Input, PD; No Wake Pin; Input, PU; POR; Initial State; Wake Pin; CAM Exp Con; VDD_3V3_SYS; [17] USB0_AP_P; CSI0_D0_P; [17] USB0_AP_N; CSI0_D0_N; [25] CSI0_D1_P; [11] USB1_AP_P; CSI0_D1_N; [11] USB1_AP_N; CSI0_CLK_P; [16] USB2_AP_P; CSI0_CLK_N; [16] USB2_AP_N; [22] I2S0_SDOUT; [22] I2S0_SDIN; [22] I2S0_LRCK; [22] I2S0_SCLK; CSI2_D0_P; [21] I2S1_SDOUT; CSI2_D0_N; [21] I2S1_SDIN; CSI2_D1_P; [21] I2S1_LRCK; CSI2_D1_N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

USB Type-C Con for RECOVERY

I2S1_SCLK 226 GBE_LED_LINK 188 GBE_LED_ACT 194 GBE_MDI0_P 186 GBE_MDI0_N 184 GBE_MDI1_P 192 GBE_MDI1_N 190 GBE_MDI2_P 198 GBE_MDI2_N 196 GBE_MDI3_P 204 GBE_MDI3_N 202 SDMMC_DAT0/PCIE2_RST* 219 SDMMC_DAT1/PCIE2_CLKREQ* 221 SDMMC_DAT2/PCIE3_RST* 223 SDMMC_DAT3/PCIE3_CLKREQ* 225 SDMMC_CMD/PCIE3_CLK_N 227 SDMMC_CLK/PCIE3_CLK_P 229 GPIO00 (USB_VBUS_EN0) 87 GPIO01 (CLK) 118 GPIO02 124 GPIO03 126 GPIO04 127 GPIO05 128 GPIO06 130 GPIO07 (PWM) 206 GPIO08 (SDMMC_CD) 208 GPIO09 (AUD_MCLK) 211 GPIO10 212 GPIO11 (CLK) 216 GPIO12 218 GPIO13 (PWM) 228 GPIO14 (PWM) 230

USB Type-C(DP) Con

CAM Exp Con

PCIe 2 to Ethernet

No Wake Pin

SPI to CAN

reComputer Robotics J401 05 SODIMM Connector 2/3

# HDMI, DP, DSI, USBSS and PCIe

DSI_D0_P/RSVD 72 DSI_D0_N/RSVD 70 DSI_D1_P/RSVD 84 DSI_D1_N/RSVD 82 DSI_CLK_P/RSVD 78 DSI_CLK_N/RSVD 76 DP0_TXD0_P/USBSS1_RX_P 41 DP0_TXD0_N/USBSS1_RX_N 39 DP0_TXD1_P/USBSS1_TX_P 47 DP0_TXD1_N/USBSS1_TX_N 45 DP0_TXD2_P/USBSS2_RX_P 53 DP0_TXD2_N/USBSS2_RX_N 51 DP0_TXD3_P/USBSS2_TX_P 59 DP0_TXD3_N/USBSS2_TX_N 57 DP0_AUX_P/RSVD 92 DP0_AUX_N/RSVD 90 DP0_HPD/RSVD 88 DP1_TXD0 (HDMI_TXD2)_P 65 DP1_TXD0 (HDMI_TXD2)_N 63 DP1_TXD1 (HDMI_TXD1)_P 71 DP1_TXD1 (HDMI_TXD1)_N 69 DP1_TXD2 (HDMI_TXD0)_P 77 DP1_TXD2 (HDMI_TXD0)_N 75 DP1_TXD3 (HDMI_TXC)_P 83 DP1_TXD3 (HDMI_TXC)_N 81 DP1_AUX_P (HDMI_DDC_SCL) 100 DP1_AUX_N (HDMI_DDC_SDA) 98 DP1_HPD (HDMI_HPD) 96 HDMI_CEC 94 CLK_32K_OUT 210

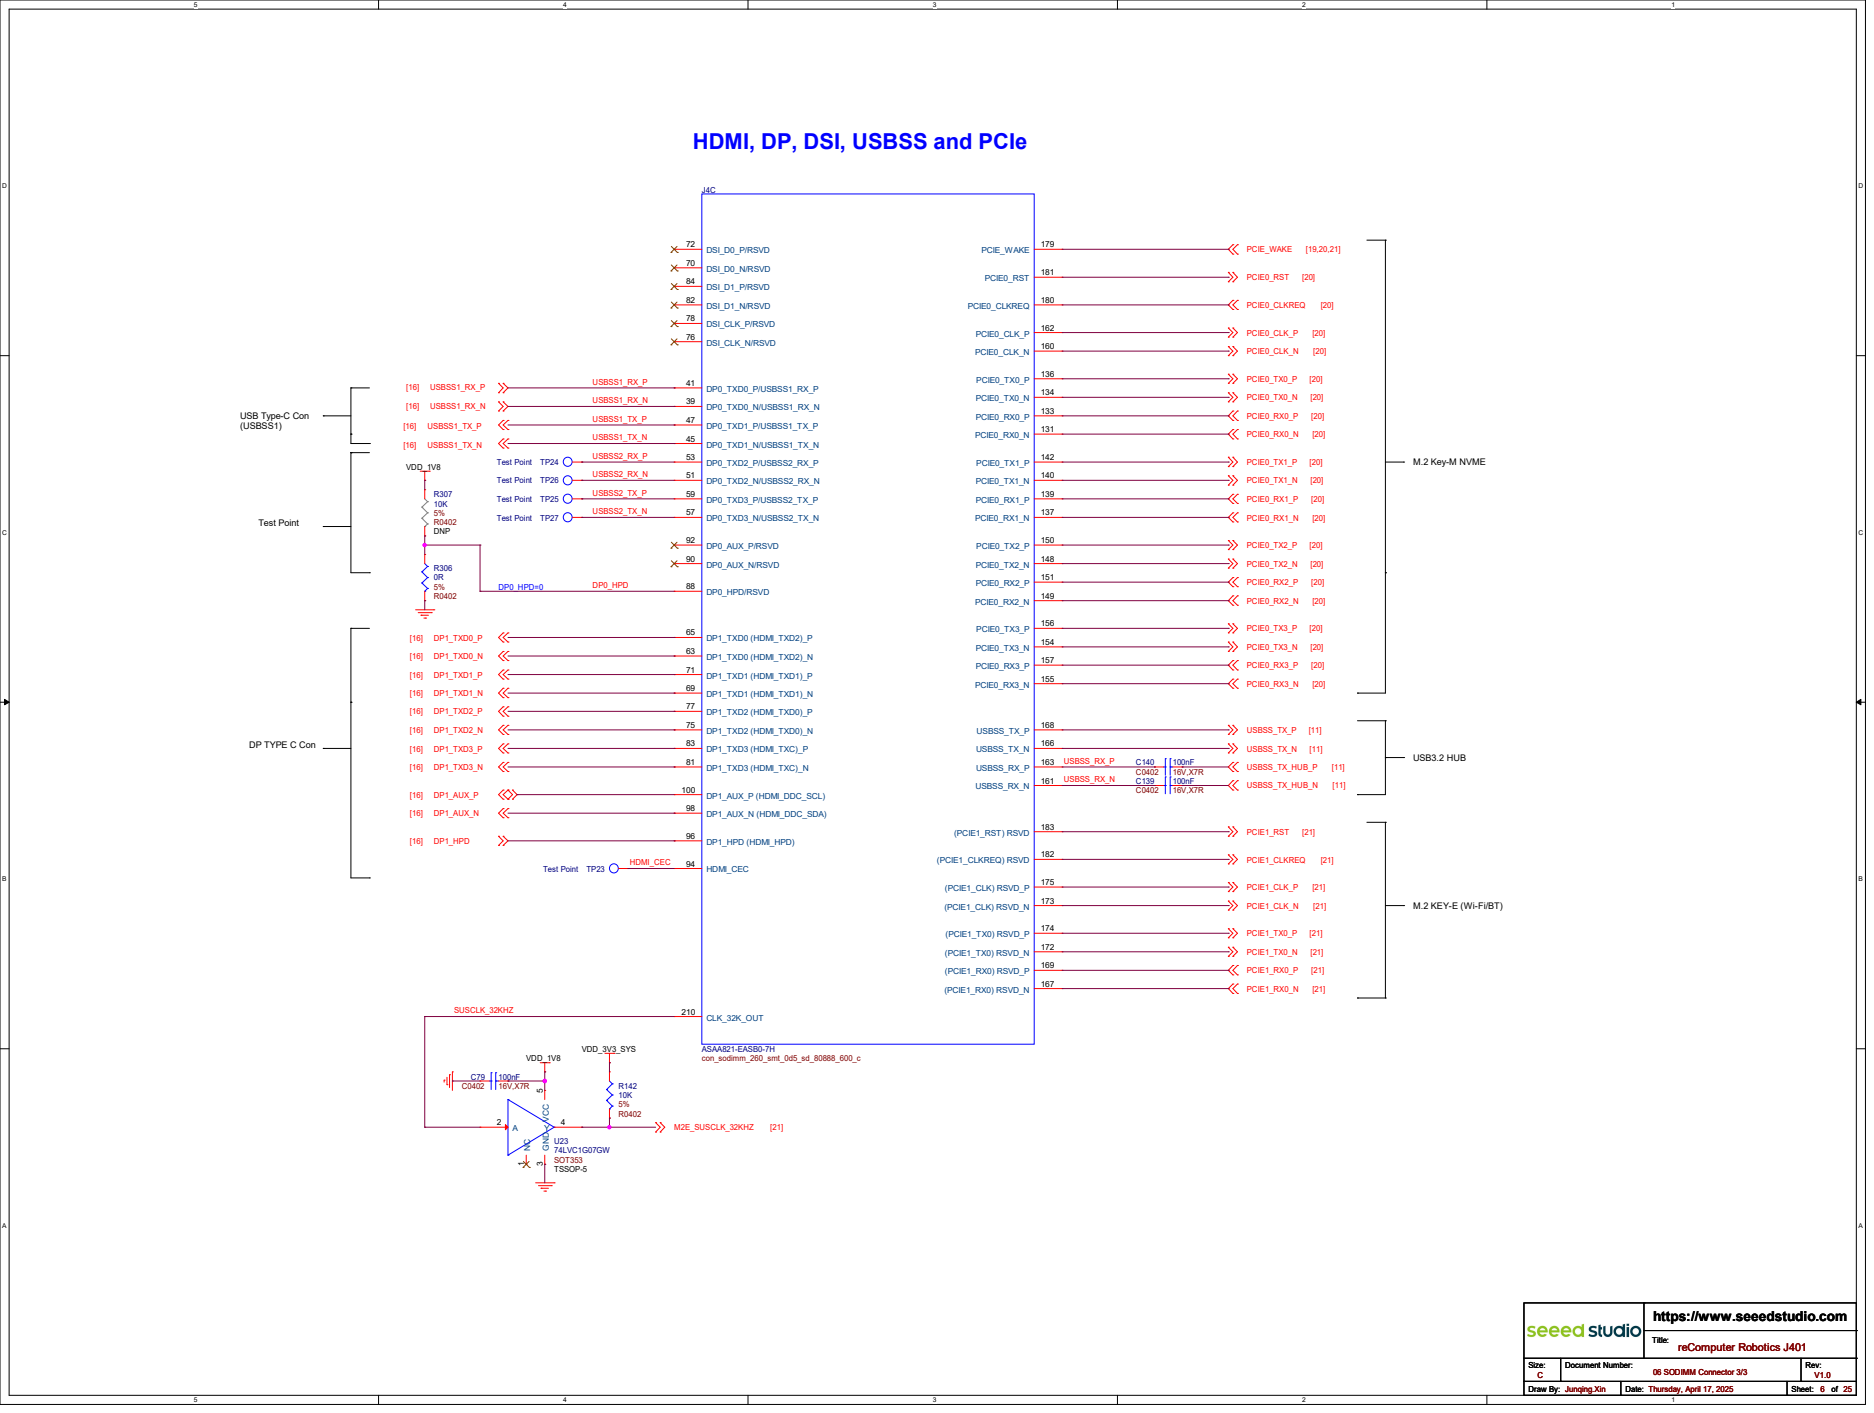
[picture p188: page 6]

Test Point TP24 Test Point TP26 R306

M.2 KEY-E (Wi-Fi/BT)

reComputer Robotics J401 06 SODIMM Connector 3/3

# VDD_12V: 0.5Ax22P=11A

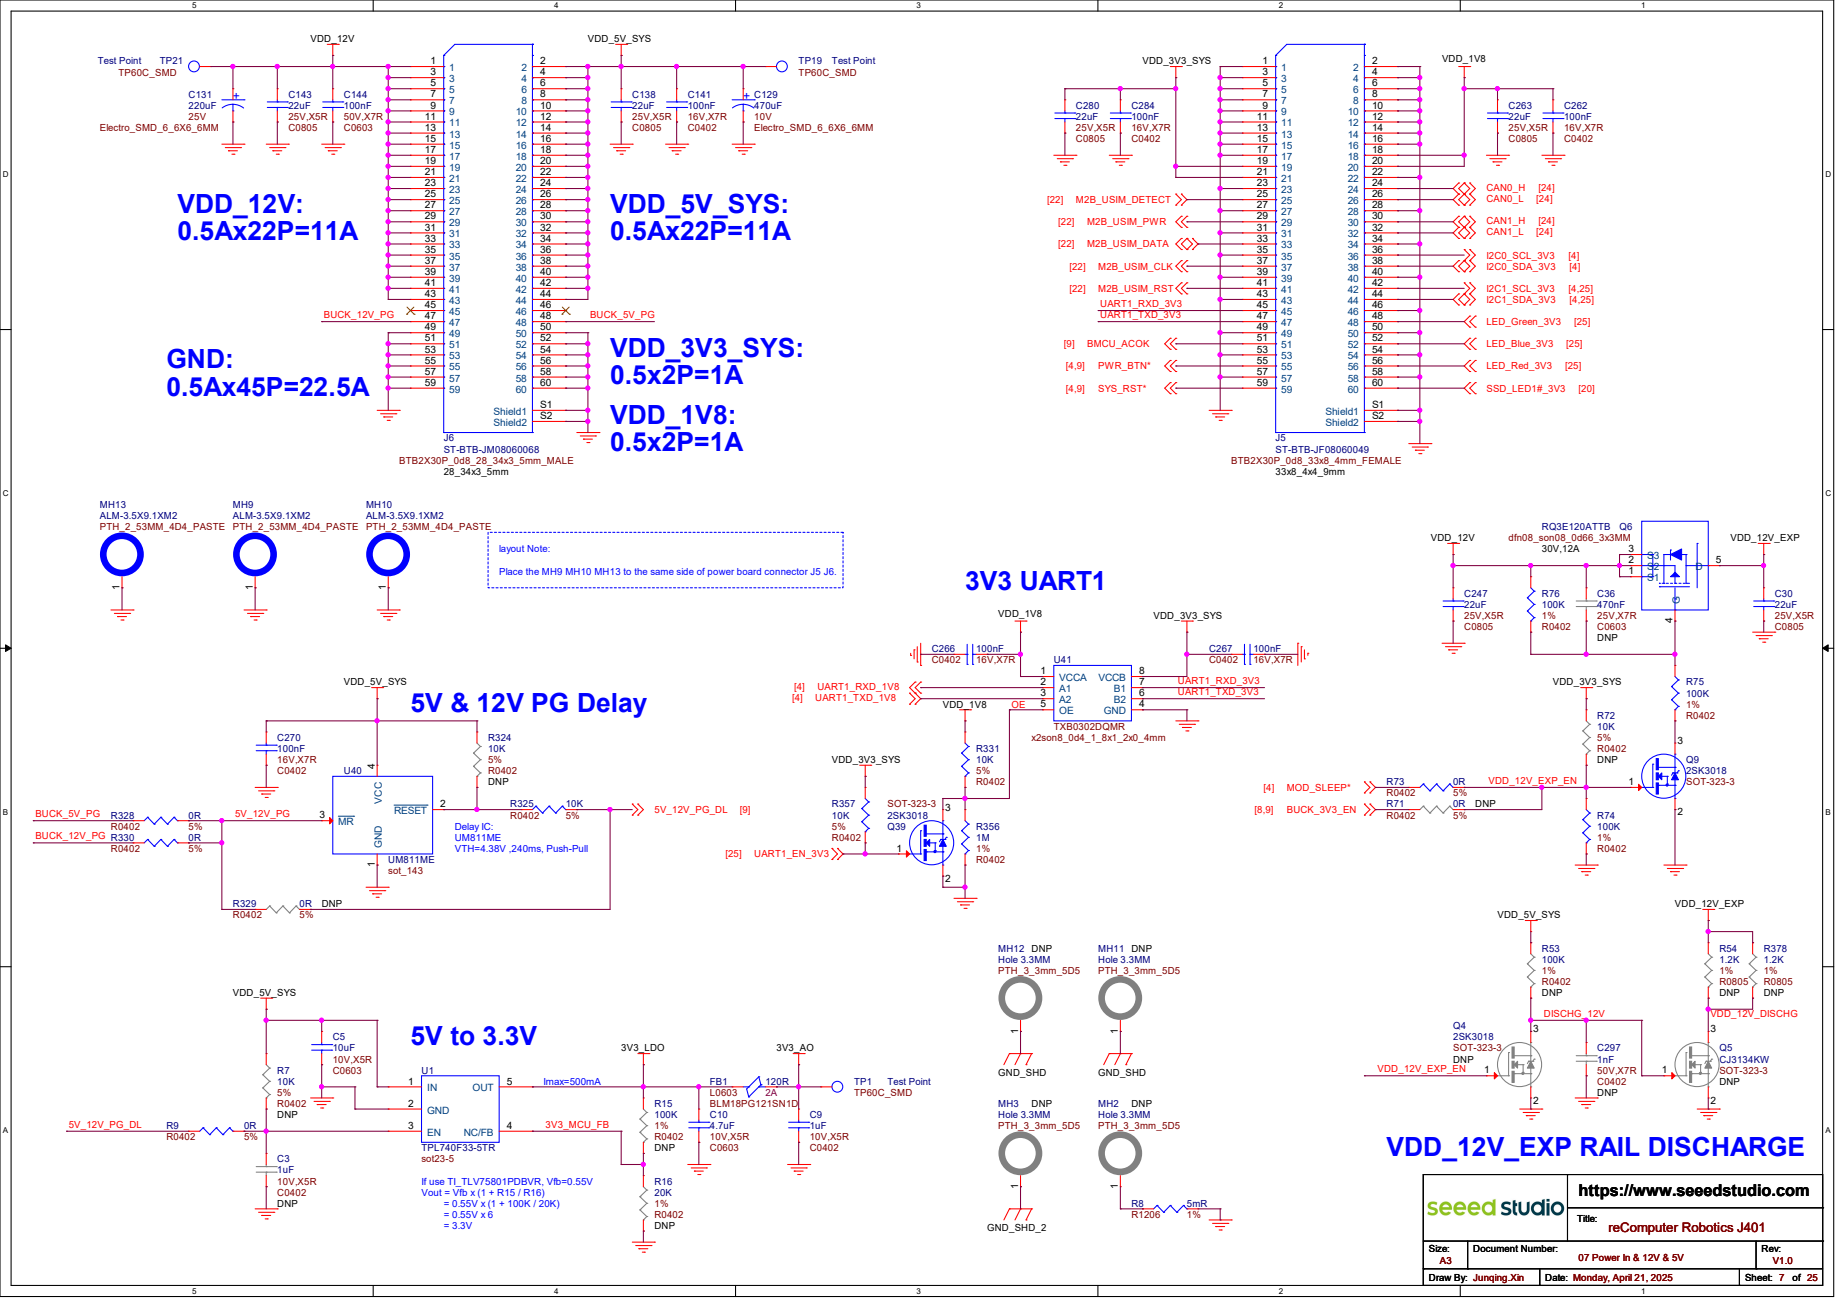
[picture p189: page 7]

0.5x2P=1A layout Note: Place the MH9 MH10 MH13 to the same side of power board connector J5 J6.

reComputer Robotics J401 07 Power In & 12V & 5V

# 12V to 3.3V

R0402 C74

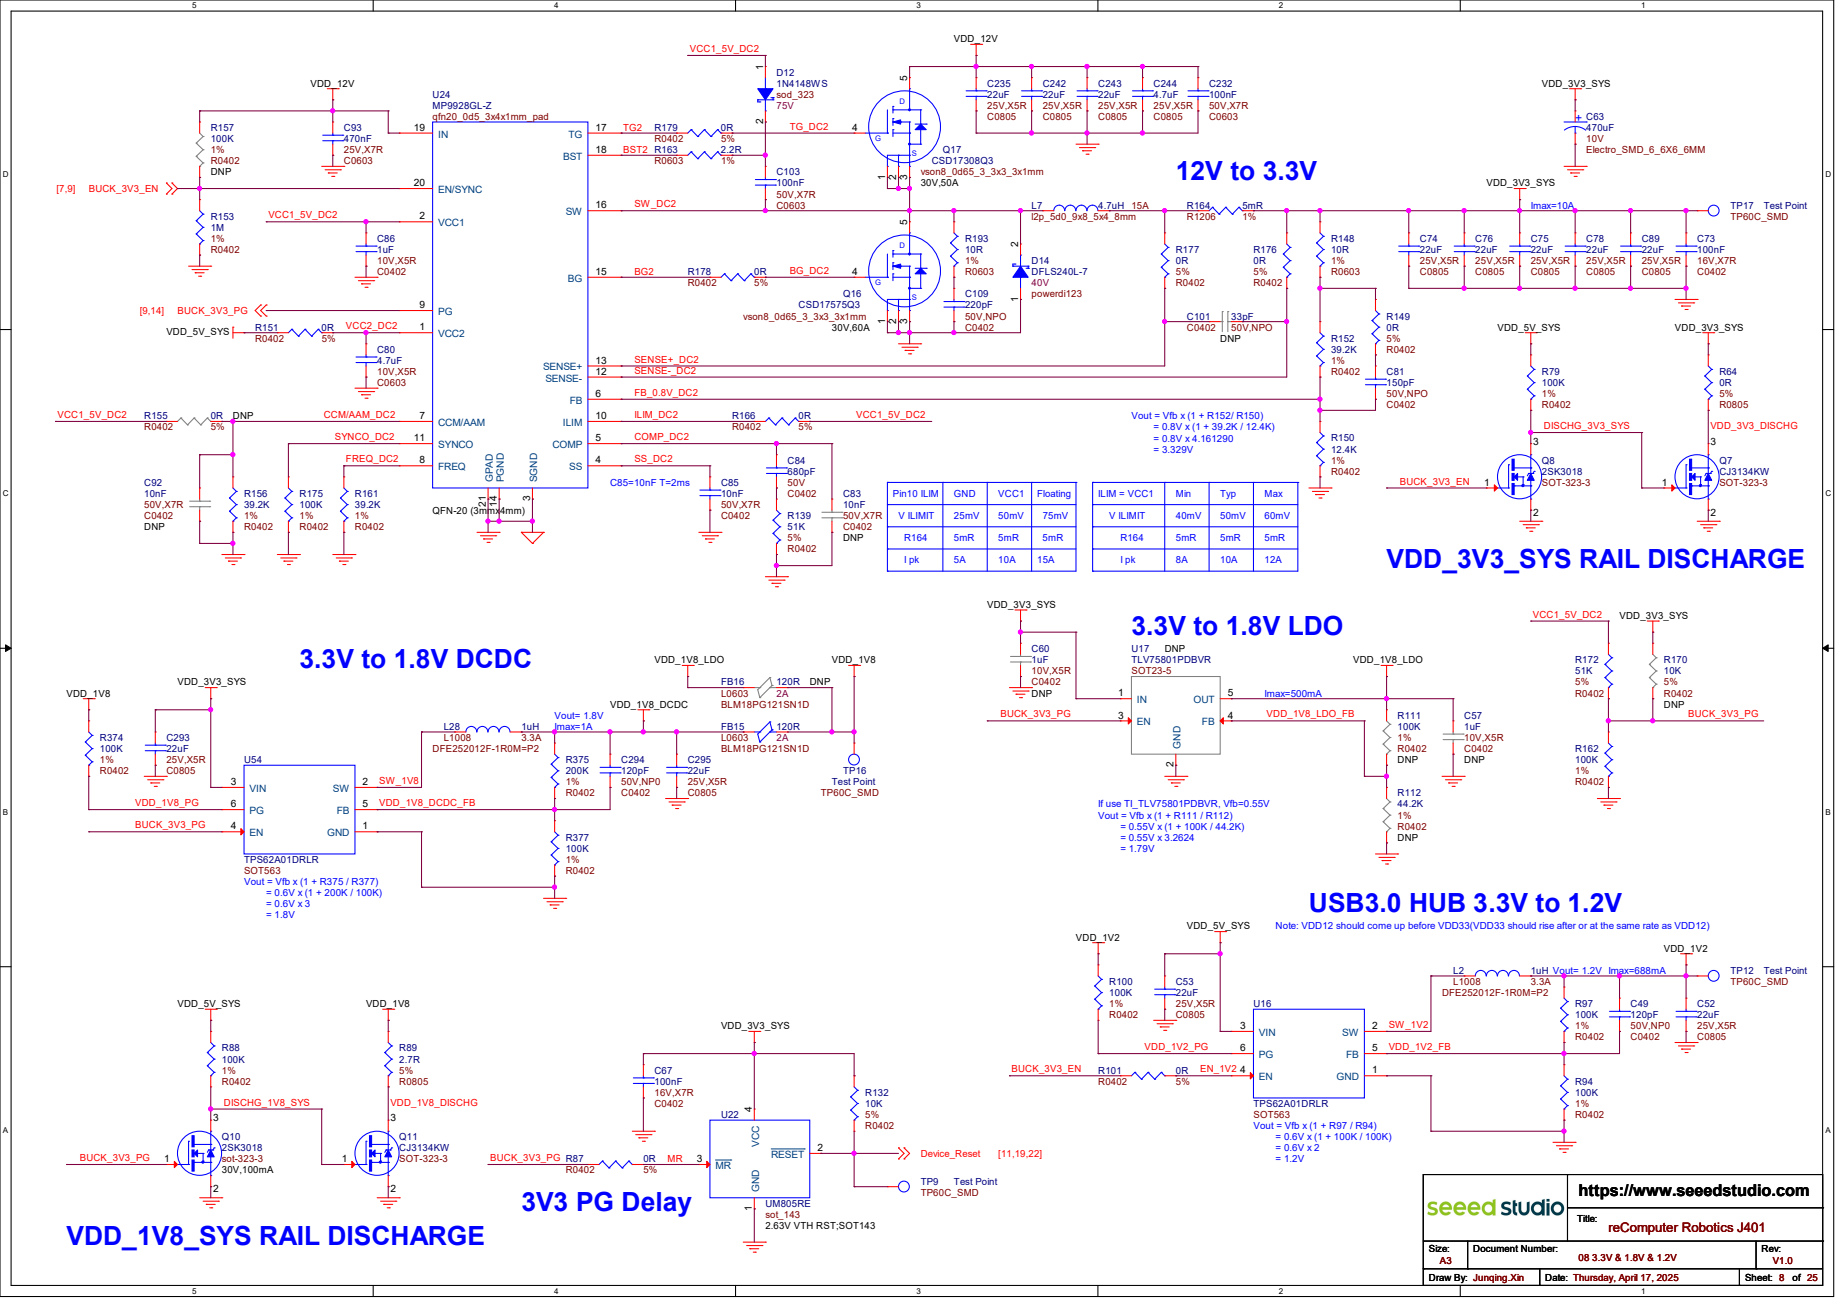
[picture p190: page 8]

3 SS 4 COMP 5 FB 6 CCM/AAM 7 FREQ 8 PG 9

Note: VDD12 should come up before VDD33(VDD33 should rise after or at the same rate as VDD12)

# Button MCU For Power Up

# R0402 R45 0R

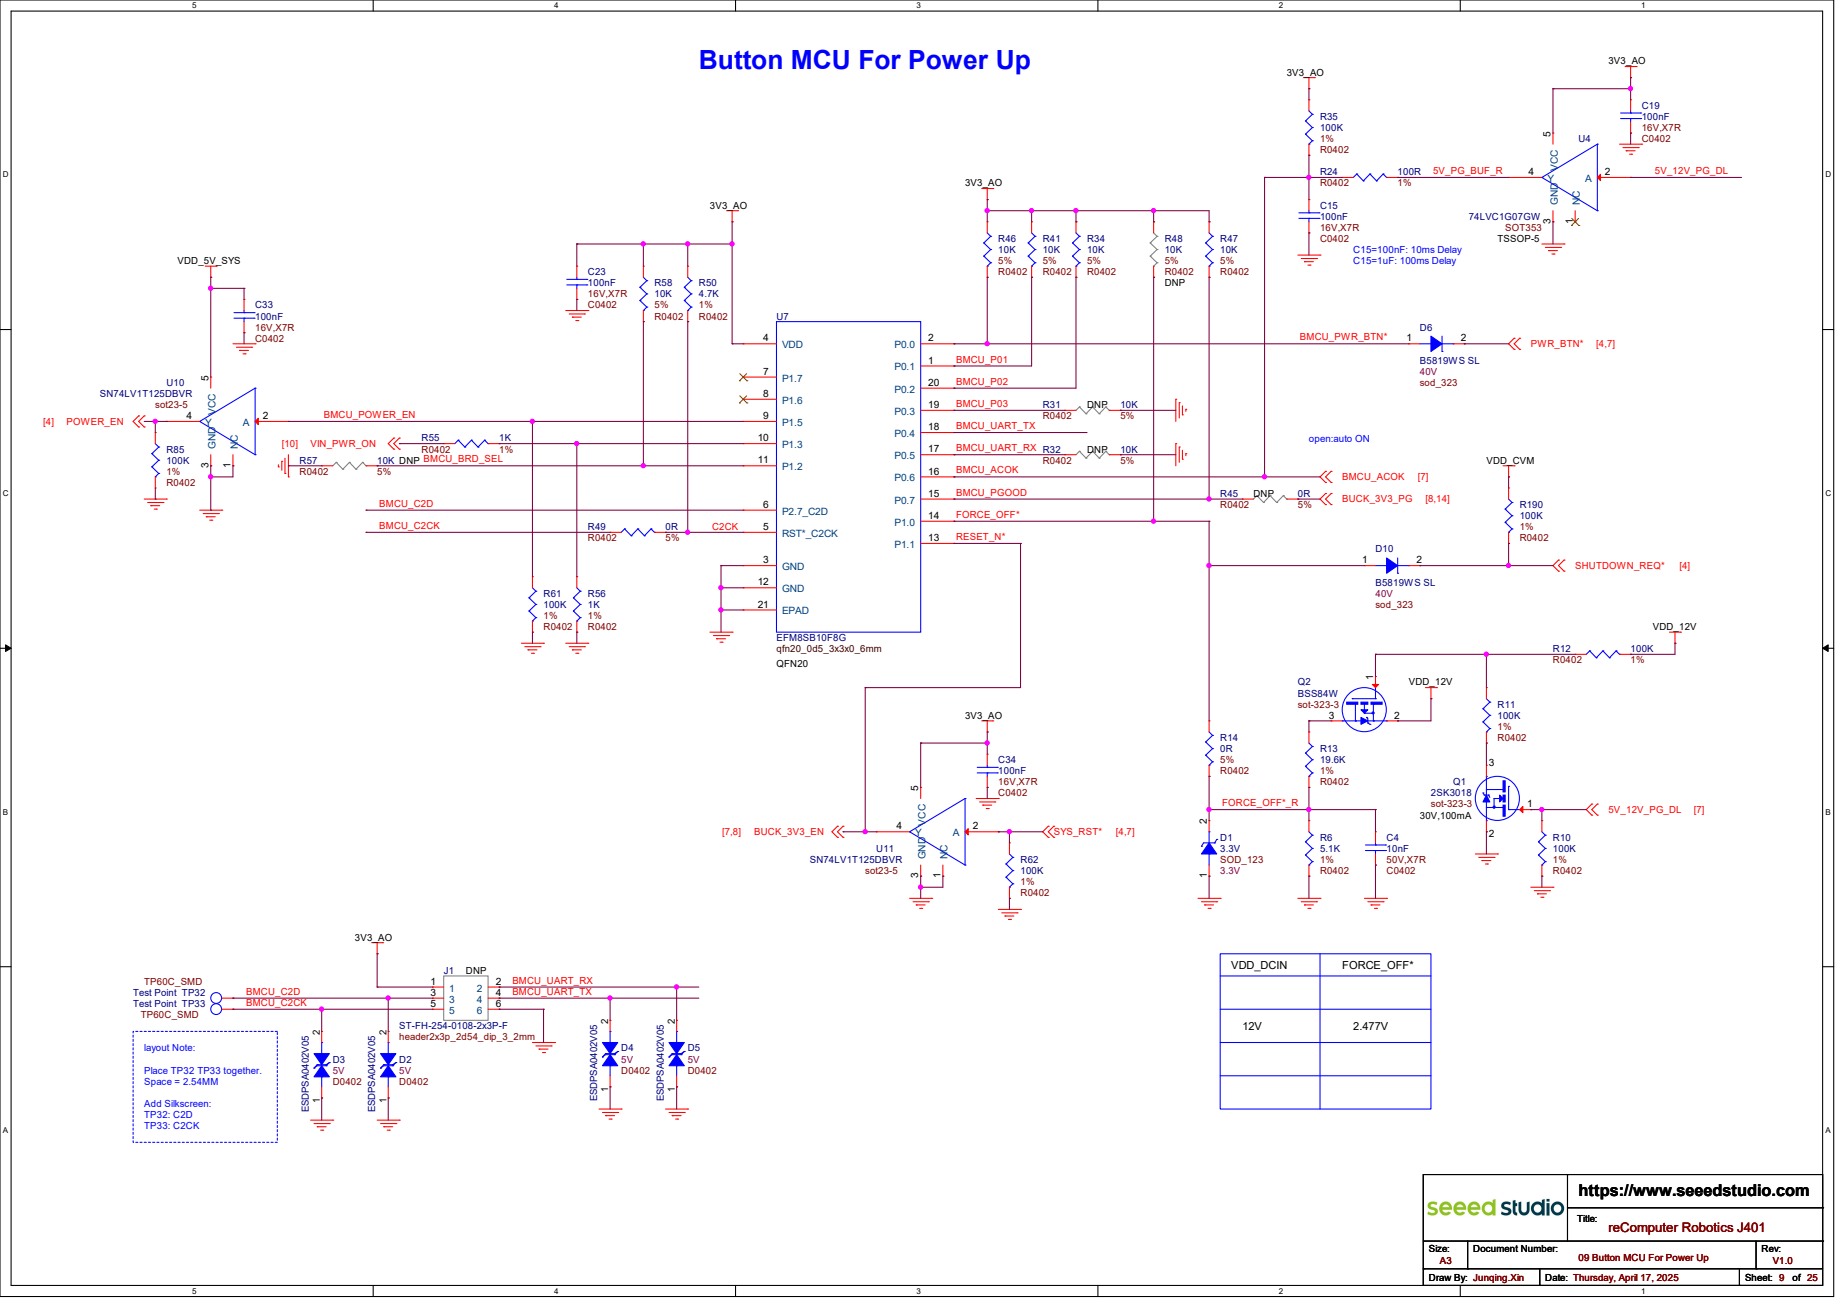
[picture p191: page 9]

VDD 4 P1.7 7 P1.6 8 P1.5 9 P1.3 10 P1.2 11 P2.7_C2D 6 RST*_C2CK 5 GND 3 GND 12 EPAD 21

reComputer Robotics J401 09 Button MCU For Power Up

12V 5A

# 30V,12AG

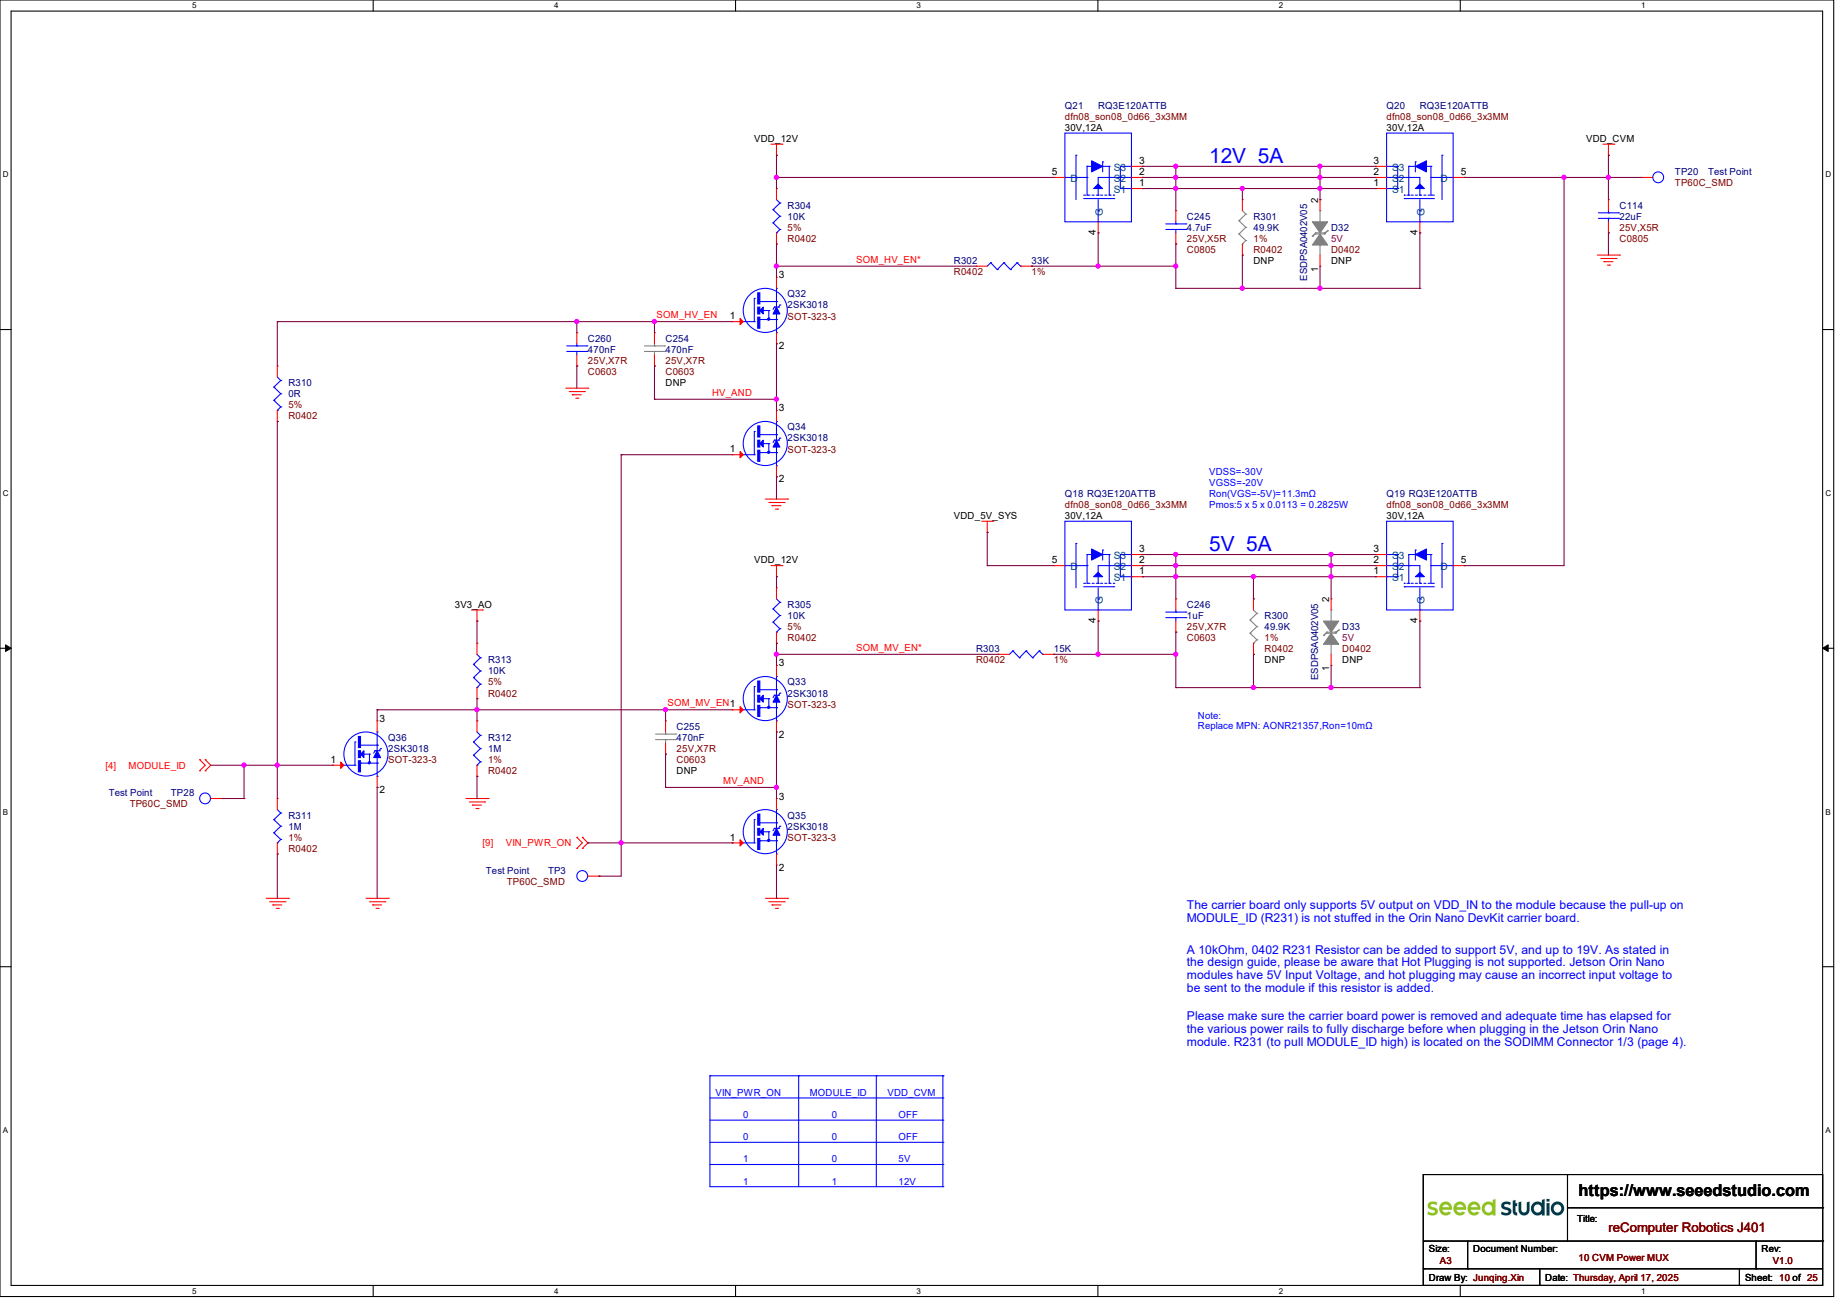
[picture p192: page 10]

Note: Replace MPN: AONR21357,Ron=10mΩ

The carrier board only supports 5V output on VDD_IN to the module because the pull-up on
MODULE_ID (R231) is not stuffed in the Orin Nano DevKit carrier board.

A 10kOhm, 0402 R231 Resistor can be added to support 5V, and up to 19V. As stated in
the design guide, please be aware that Hot Plugging is not supported. Jetson Orin Nano
modules have 5V Input Voltage, and hot plugging may cause an incorrect input voltage to
be sent to the module if this resistor is added.

Please make sure the carrier board power is removed and adequate time has elapsed for
the various power rails to fully discharge before when plugging in the Jetson Orin Nano

0 VIN_PWR_ON | VDD_CVM

0 OFF

reComputer Robotics J401 10 CVM Power MUX

# USB3.1 GEN1 HUB x4 PORTS

HUB_HSD1_P | [12] HUB_HSD1_N | [12] HUB_SSTX1_P [12] HUB_SSTX1_N [12] HUB_SSRX1_P [12] HUB_SSRX1_N [12] HUB_HSD2_P | [12] HUB_HSD2_N | [12] HUB_SSTX2_P [12] HUB_SSTX2_N [12] HUB_SSRX2_P [12] HUB_SSRX2_N [12] HUB_HSD3_P | [13] HUB_HSD3_N | [13] HUB_HSD4_P | [13] HUB_HSD4_N | [13]

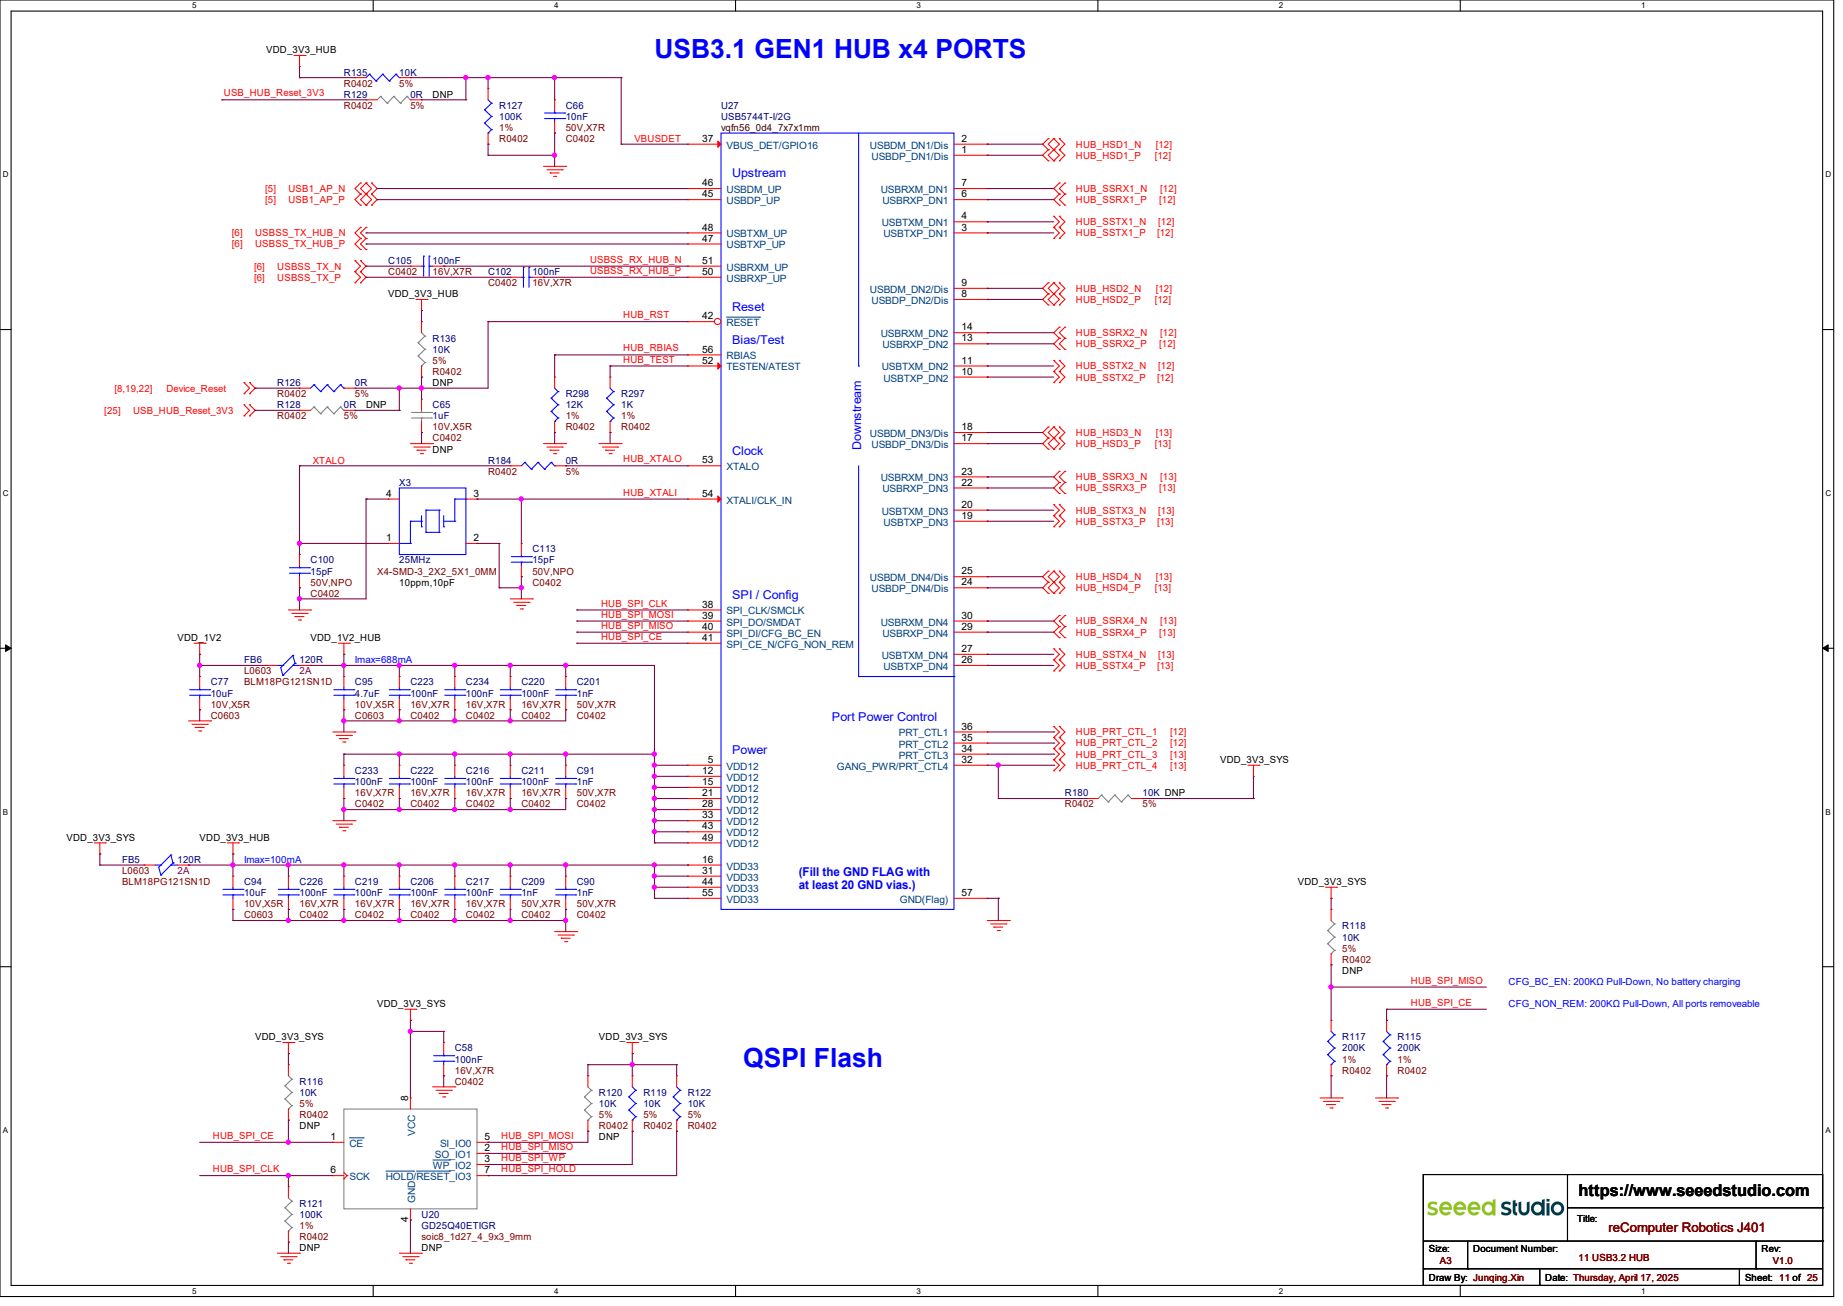
[picture p193: page 11]

VDD_3V3_HUB
RBIAS 56 XTALI/CLK_IN 54 XTALO 53 TESTEN/ATEST 52 USBRXM_UP 51 USBRXP_UP 50
RESET 42 SPI_CE_N/CFG_NON_REM 41 SPI_DI/CFG_BC_EN 40 SPI_DO/SMDAT 39 SPI_CLK/SMCLK 38
USBRXP_DN2 13 USBRXP_DN4 29 USBRXM_DN4 30 GND(Flag) 57 VDD33 55

Port Power Control (Fill the GND FLAG with

at least 20 GND vias.)

CFG_BC_EN: 200KΩ Pull-Down, No battery charging

# USB3.2 TYPE-A x2 (A)

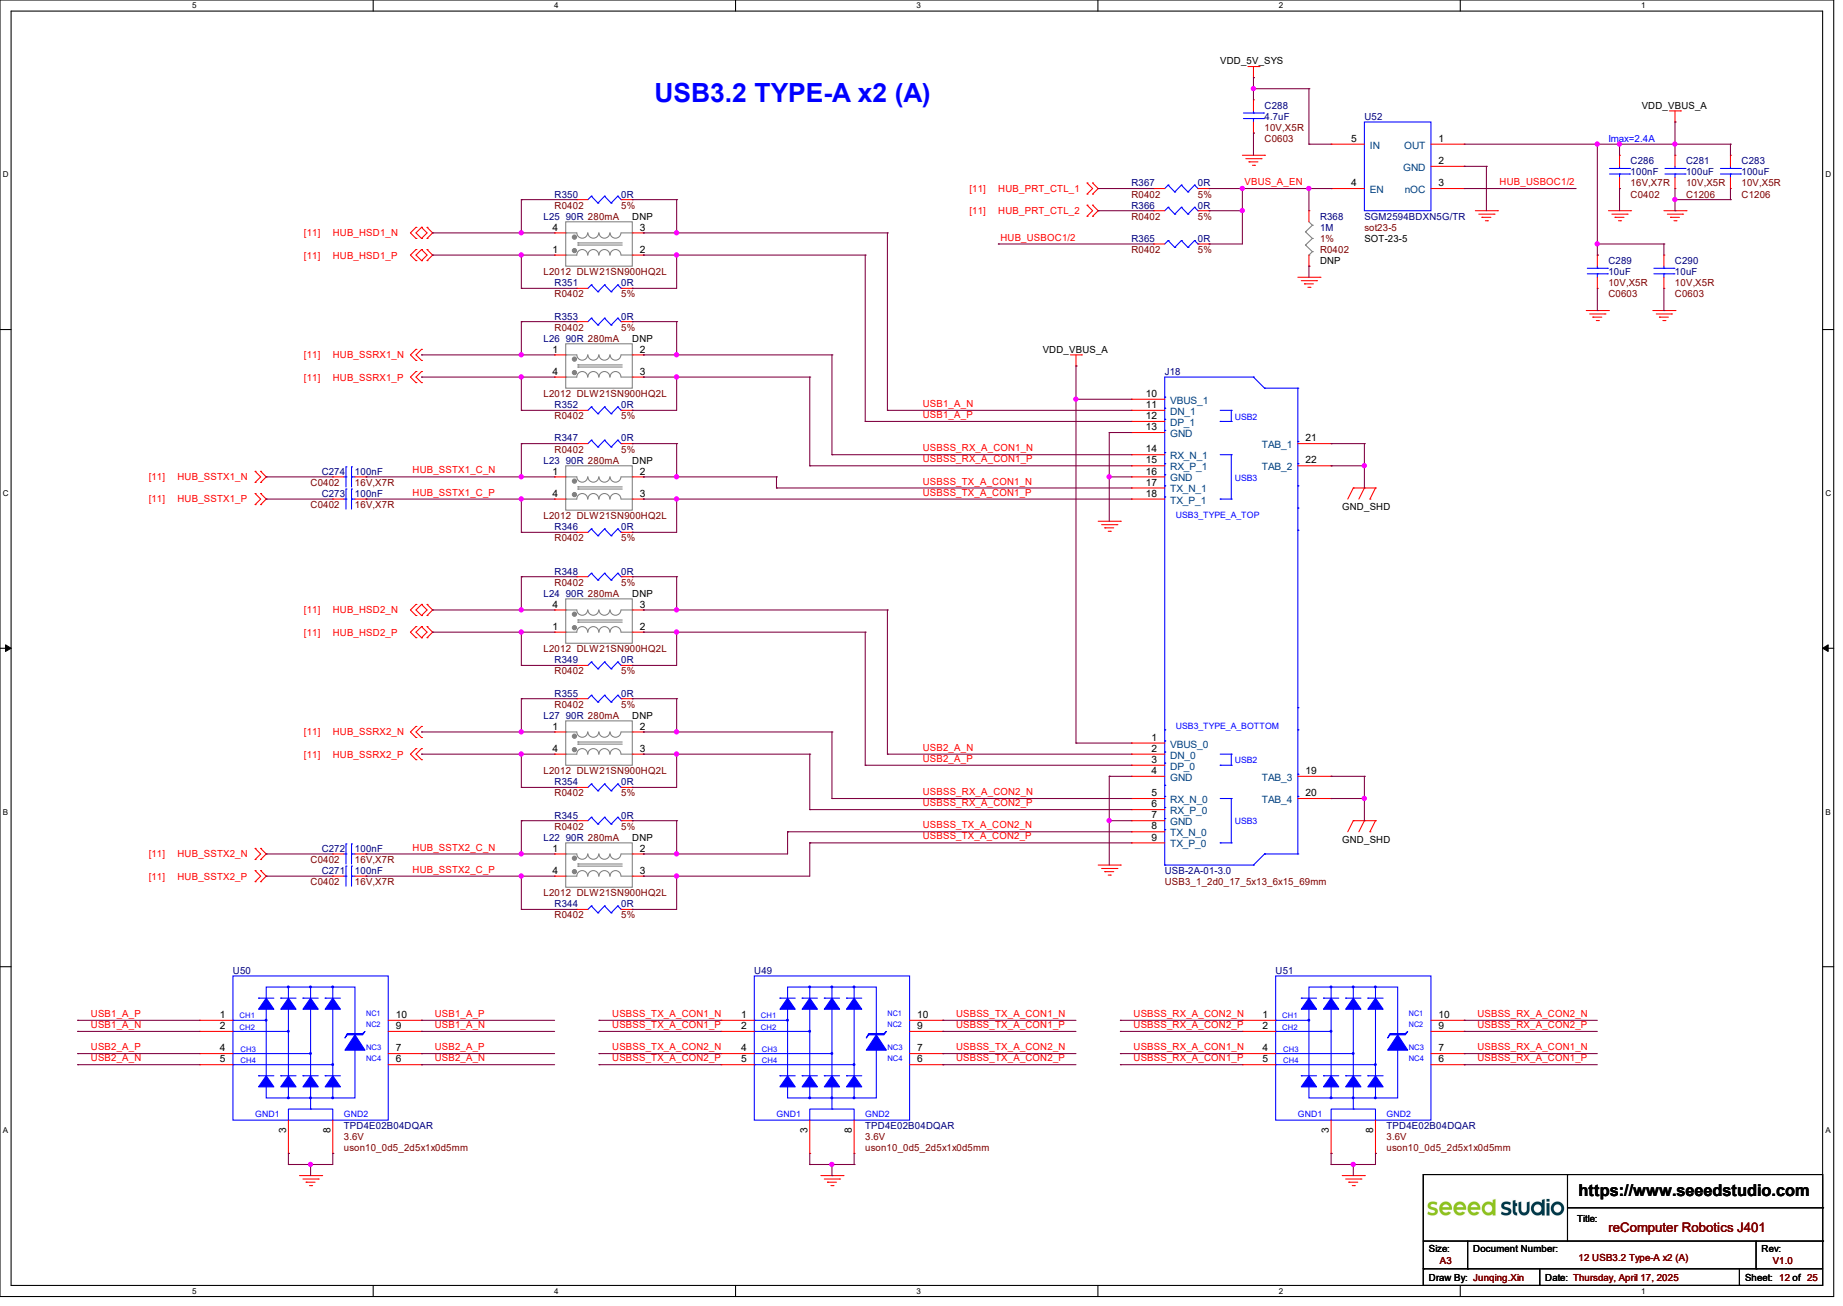
[picture p194: page 12]

# USB3.2 TYPE-A x2 (B)

# VDD_VBUS_B GND_SHD GND_SHD

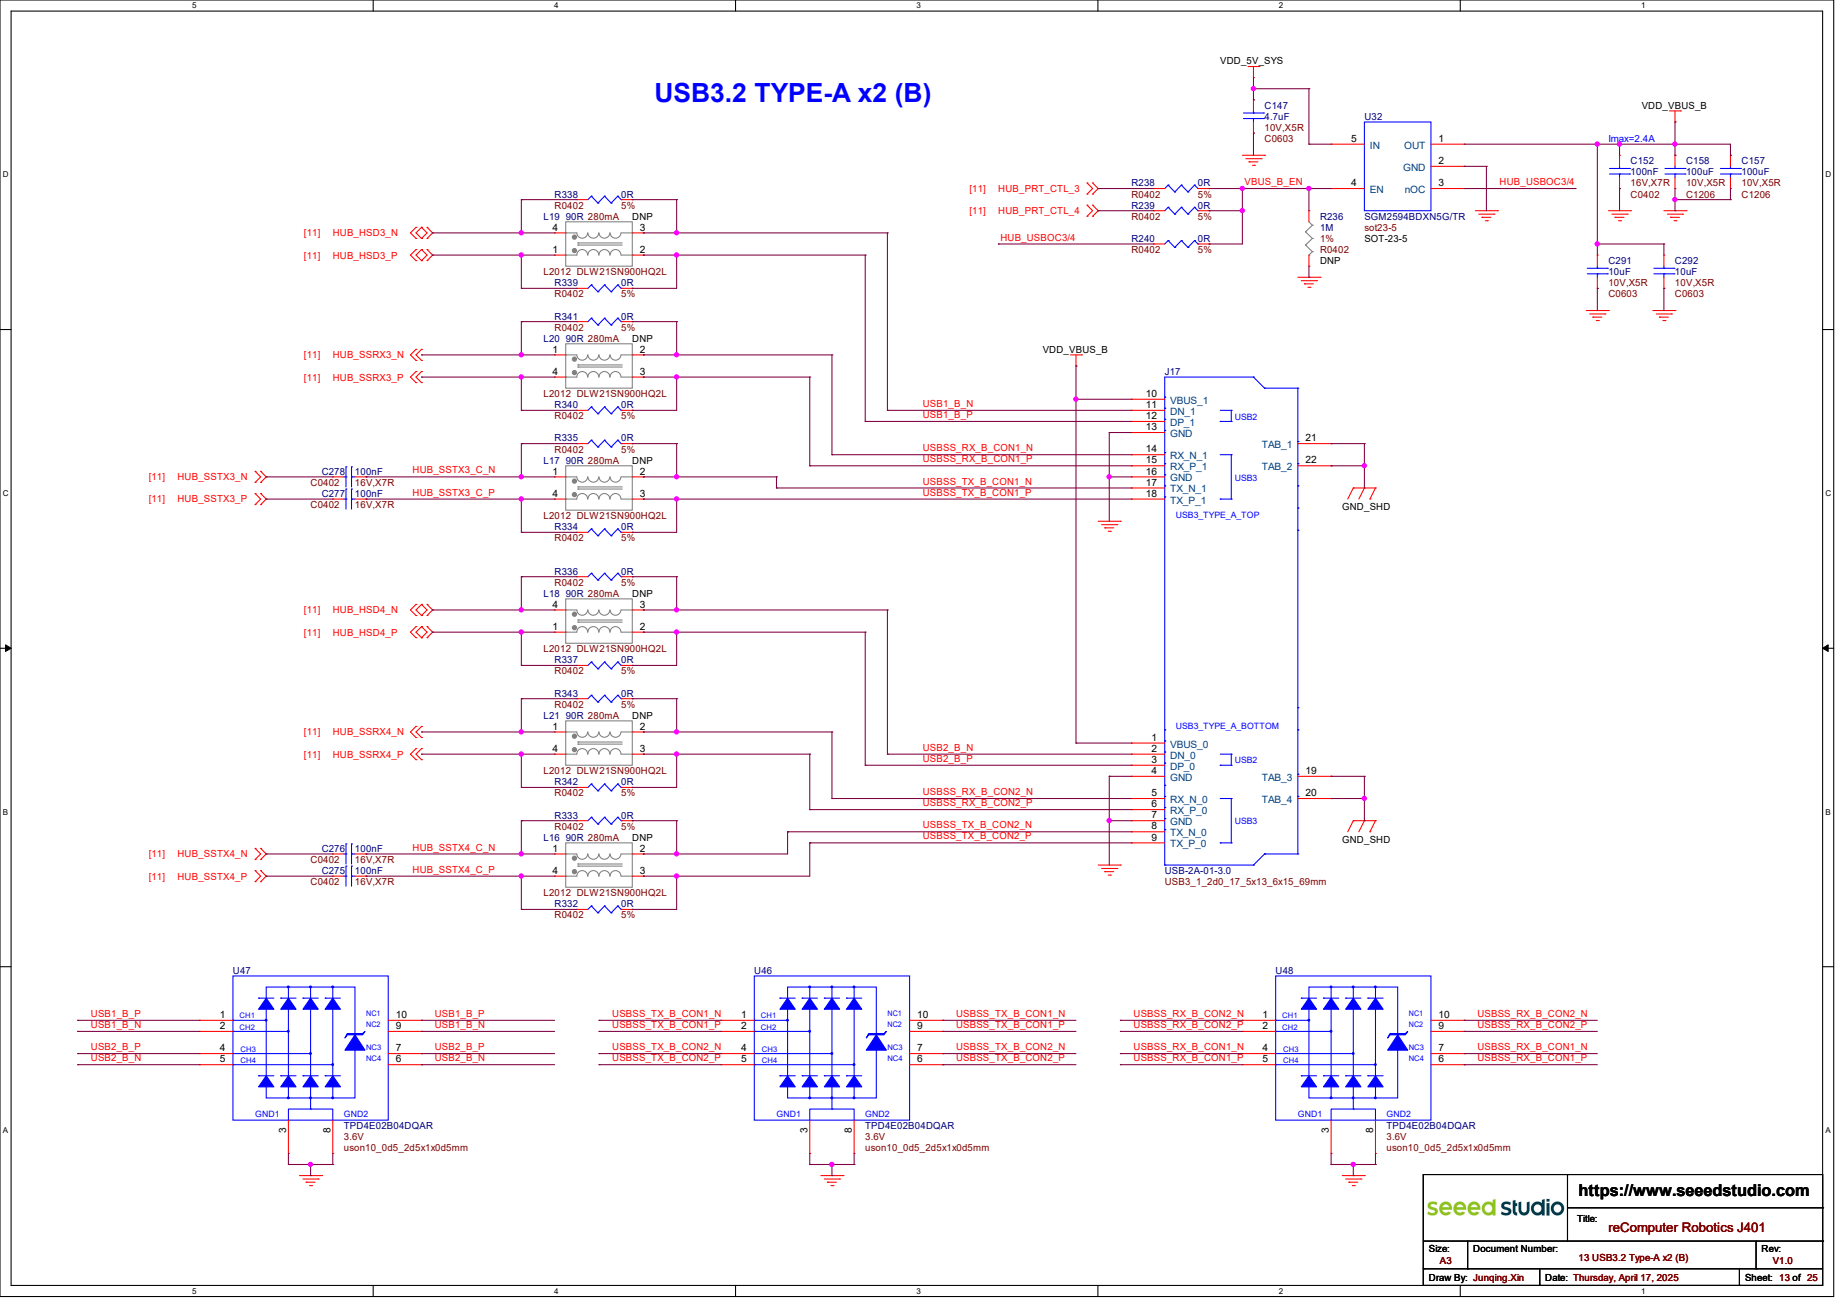
[picture p195: page 13]

# VDD_1V05

# DNP R108

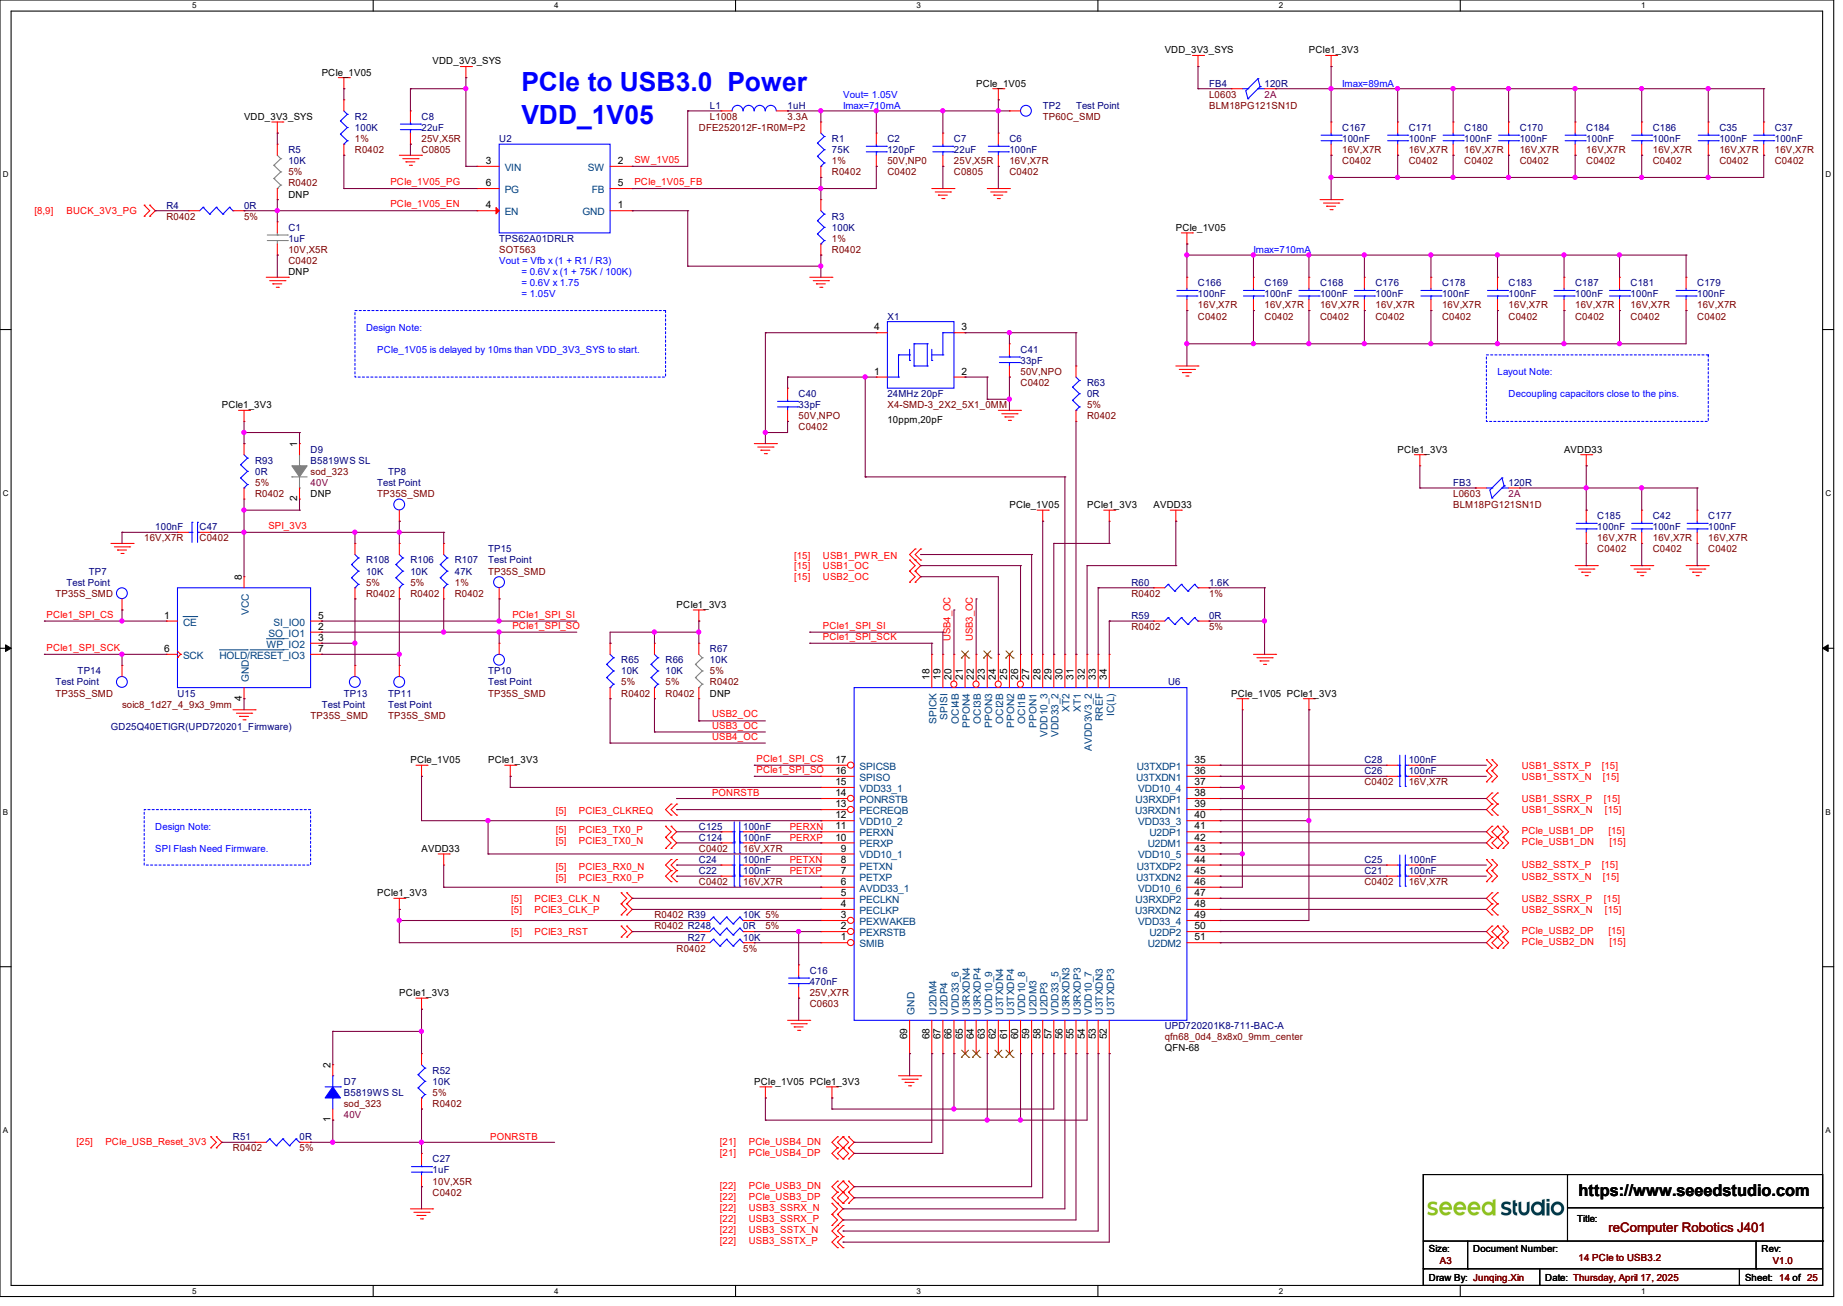
[picture p196: page 14]

SPI Flash Need Firmware. Design Note:

reComputer Robotics J401 14 PCIe to USB3.2

USB3.2 TYPE-A x2 (C) | VDD_VBUS_C

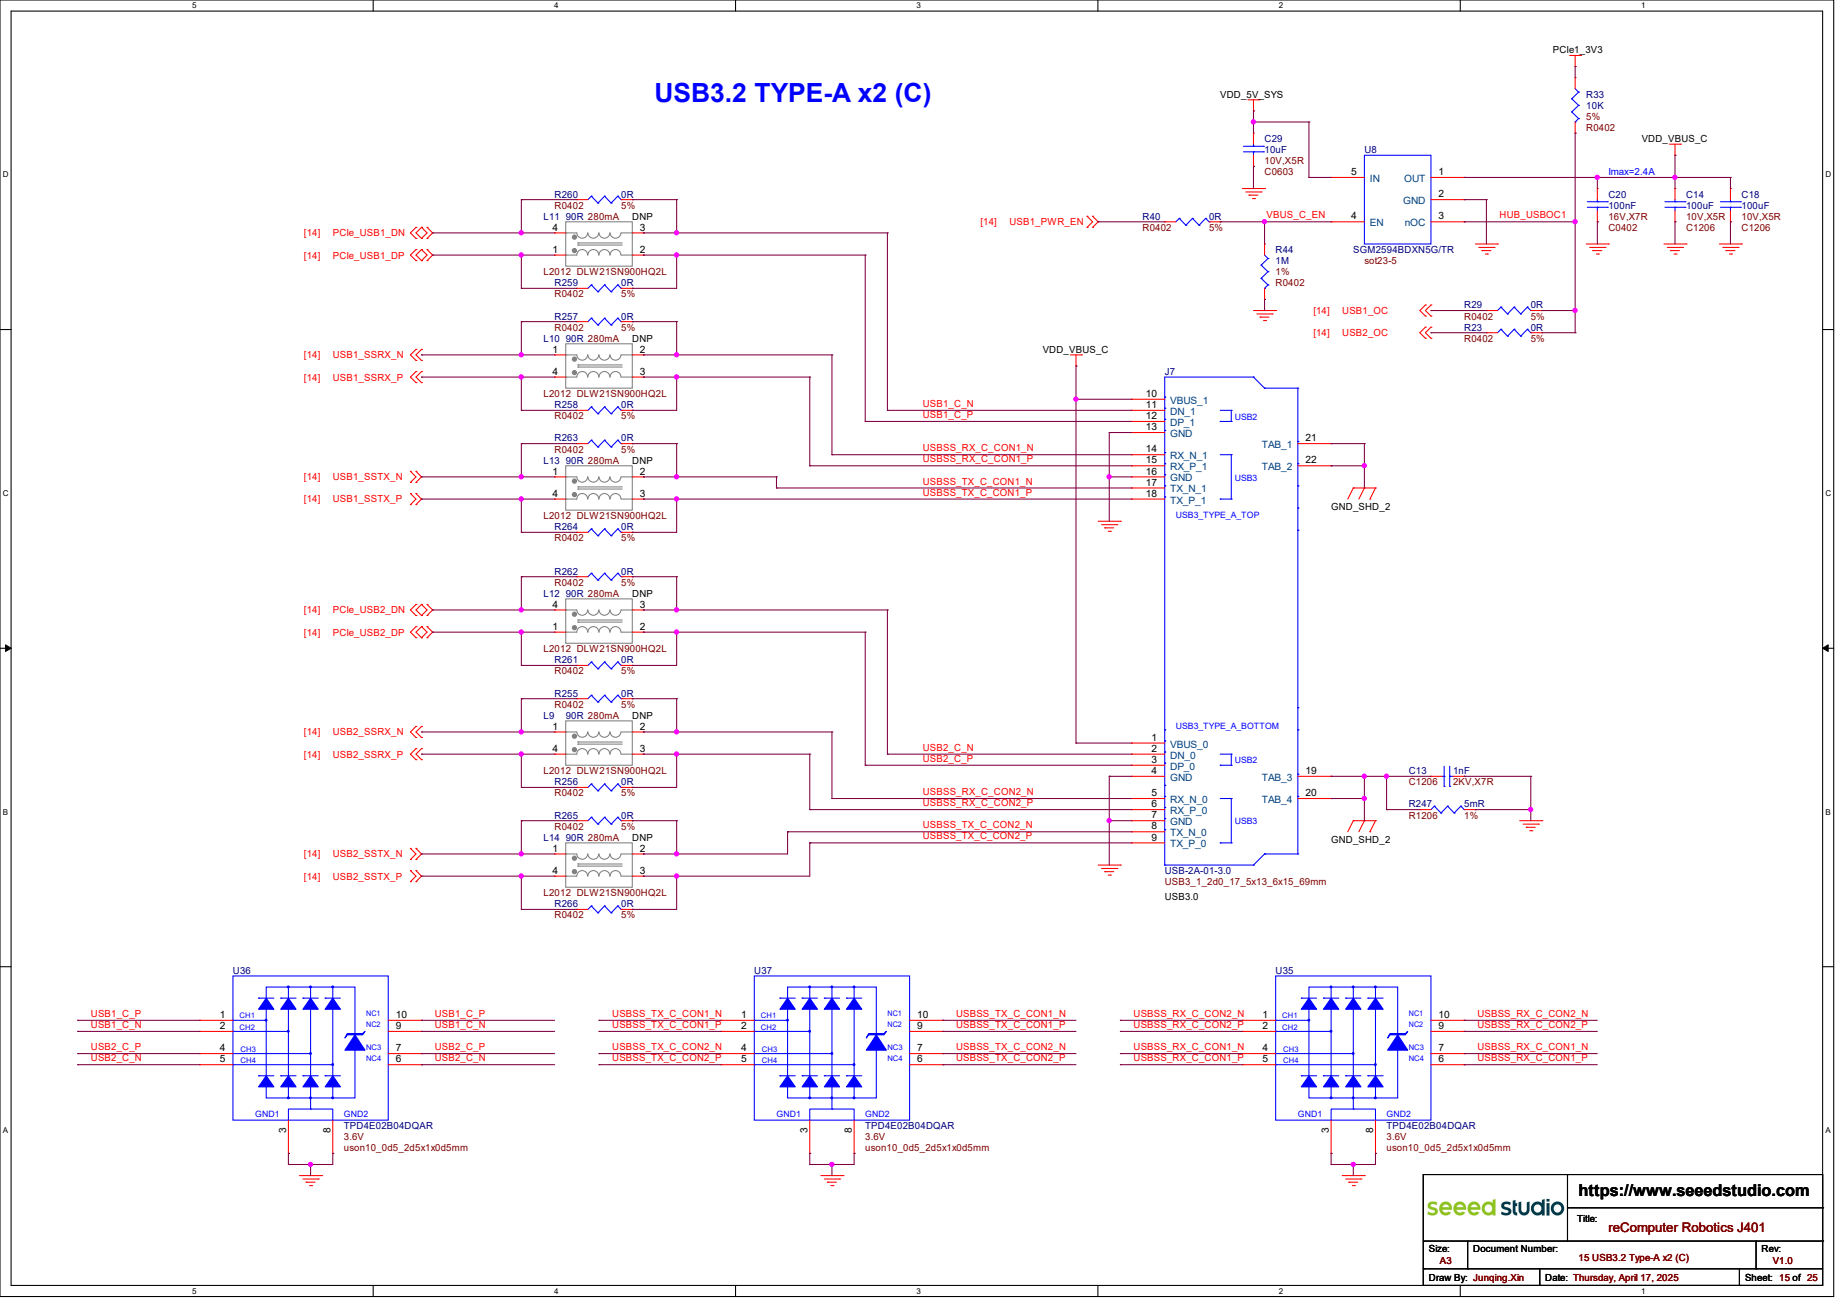
[picture p197: page 15]

I2C_ADR_1 47 I2C_ADR_0 48 | VSS 49 | NC2 27 NC1 14 VBUS_OCP 20 FF1 42 SBU1 19 SBU2 18 AVDD³³ ¹³ AVDD³³ ²⁴ | DVDD_IO ³⁹ | U30 SY6280AAC

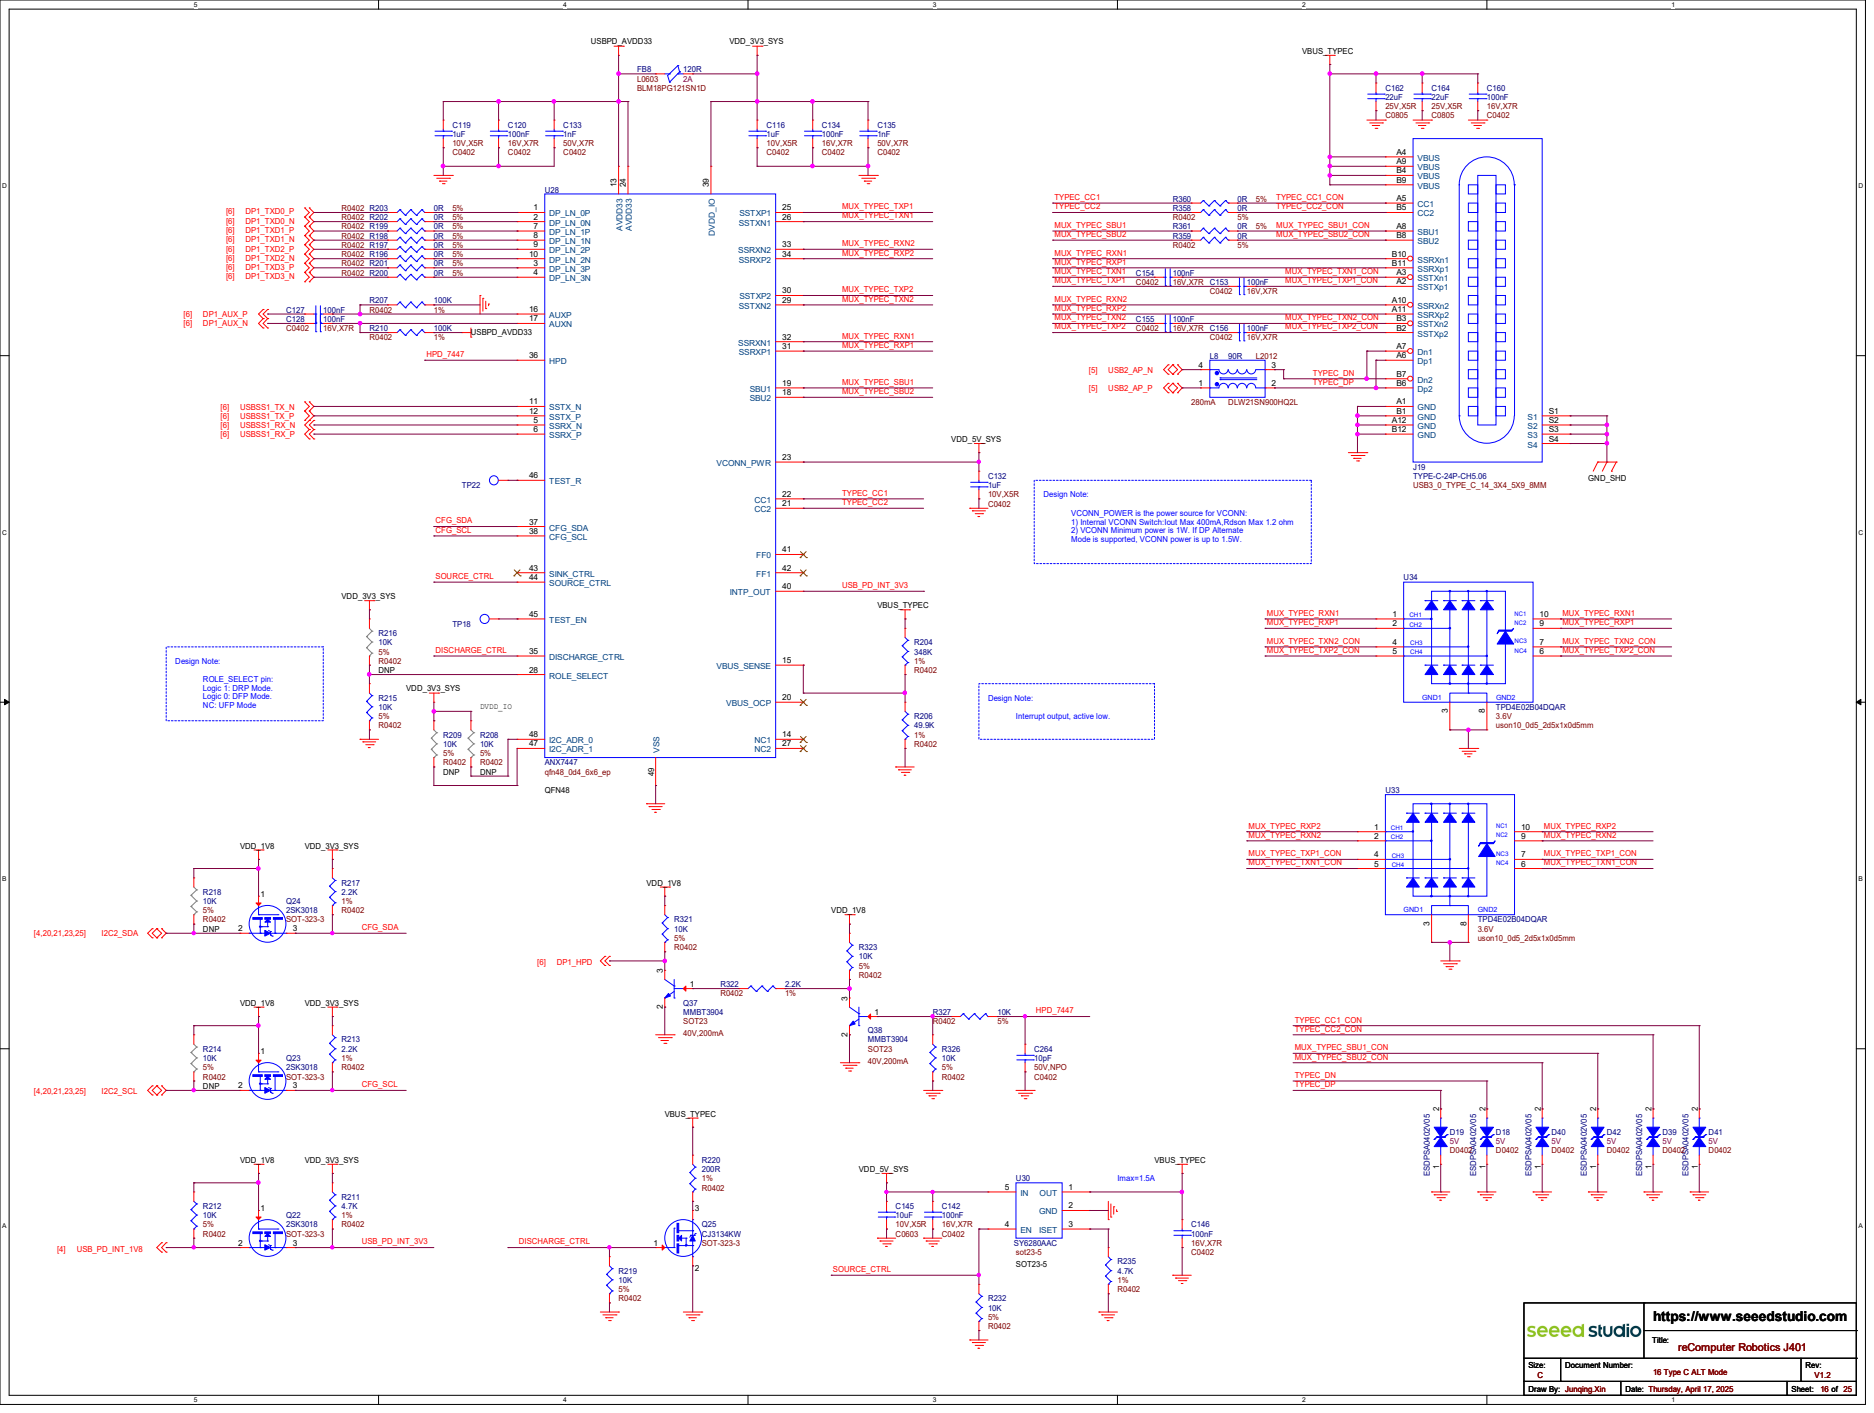
[picture p198: page 16]

2) VCONN Minimum power is 1W. If DP Alternate Mode is supported, VCONN power is up to 1.5W. Design Note:

Interrupt output, active low.

reComputer Robotics J401 16 Type C ALT Mode

# CP2102N

# U31 CP2102N-A02-GQFN24R

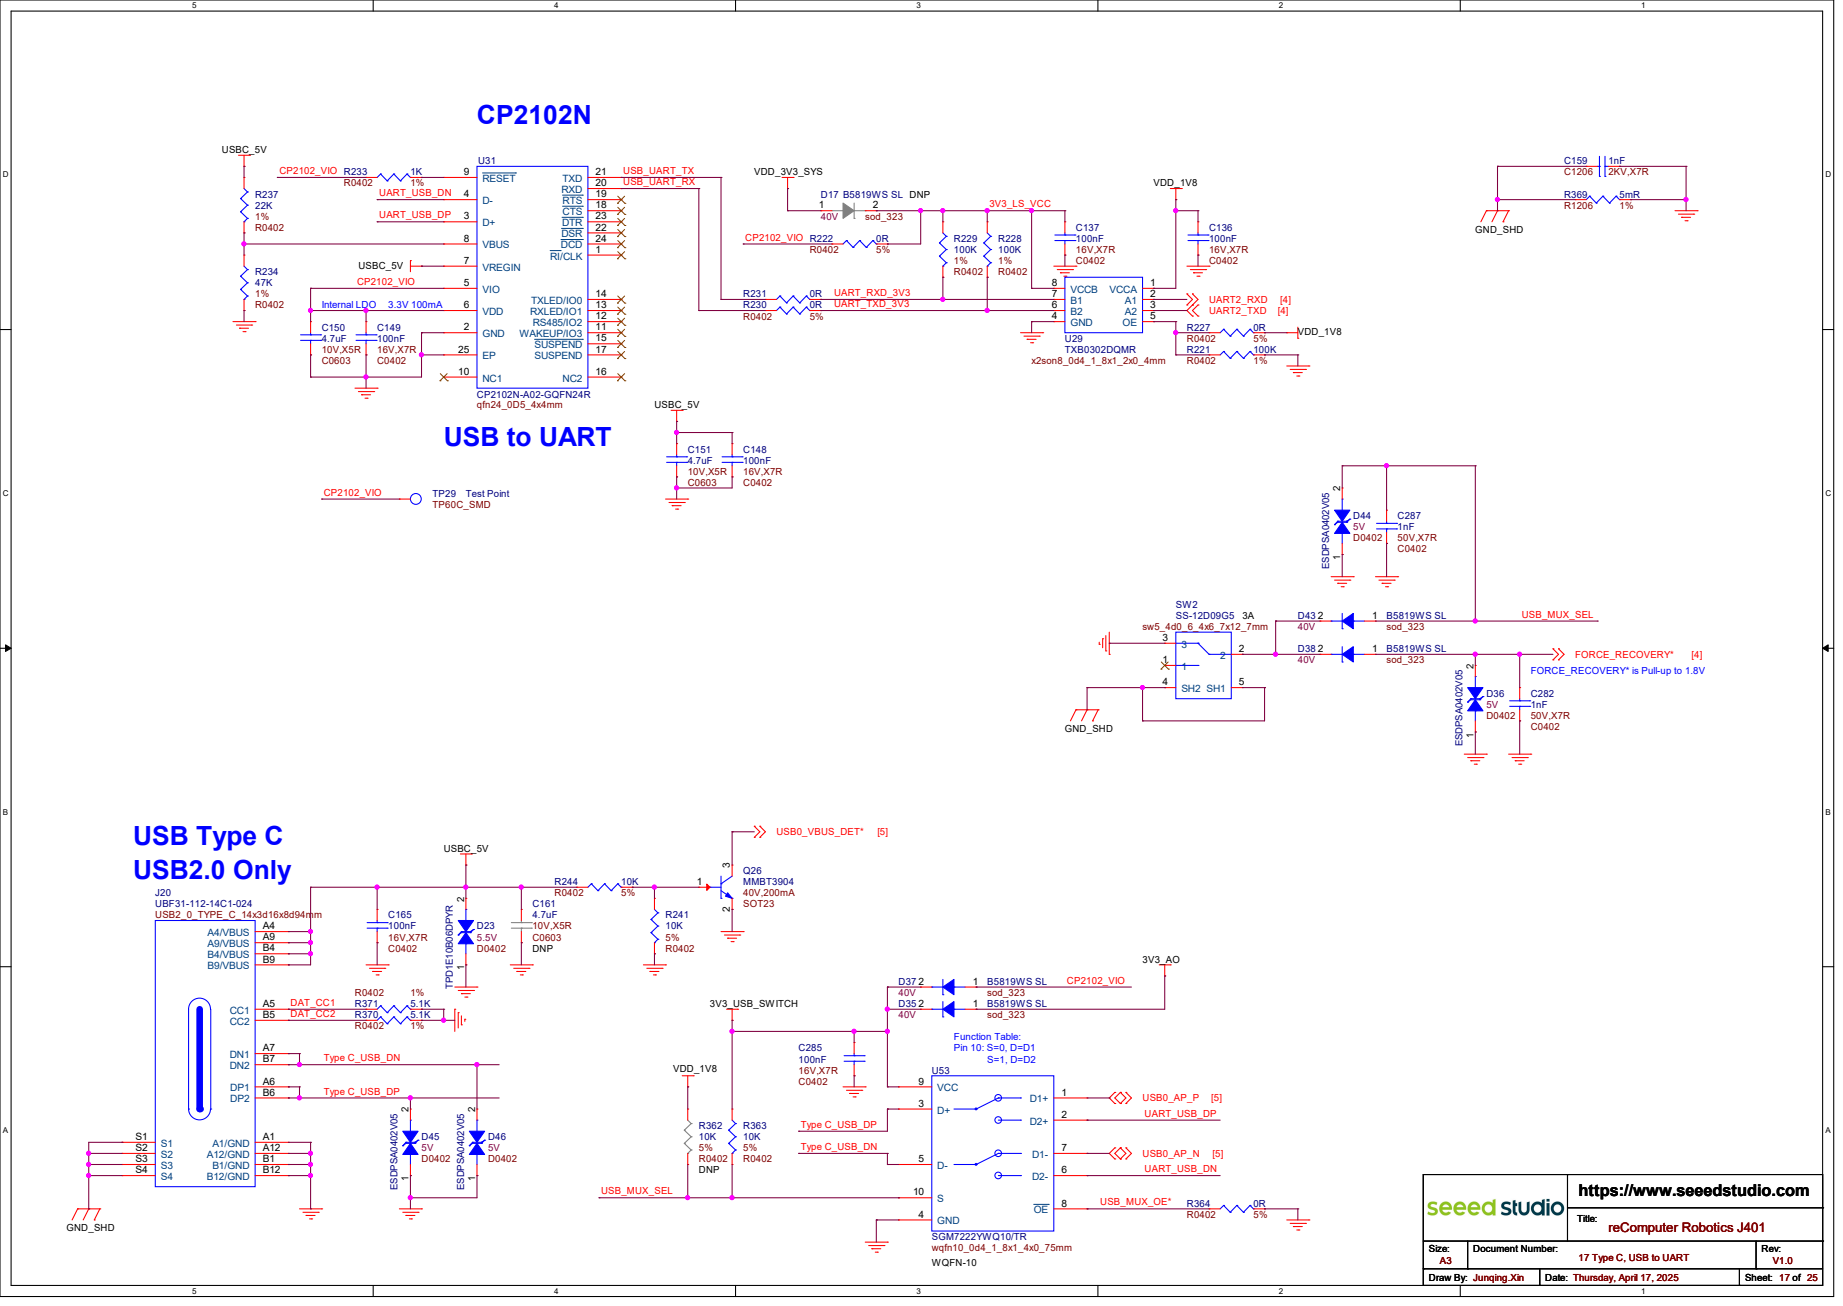
[picture p199: page 17]

FORCE_RECOVERY* is Pull-up to 1.8V

reComputer Robotics J401 17 Type C, USB to UART

# Gigabit Ethernet

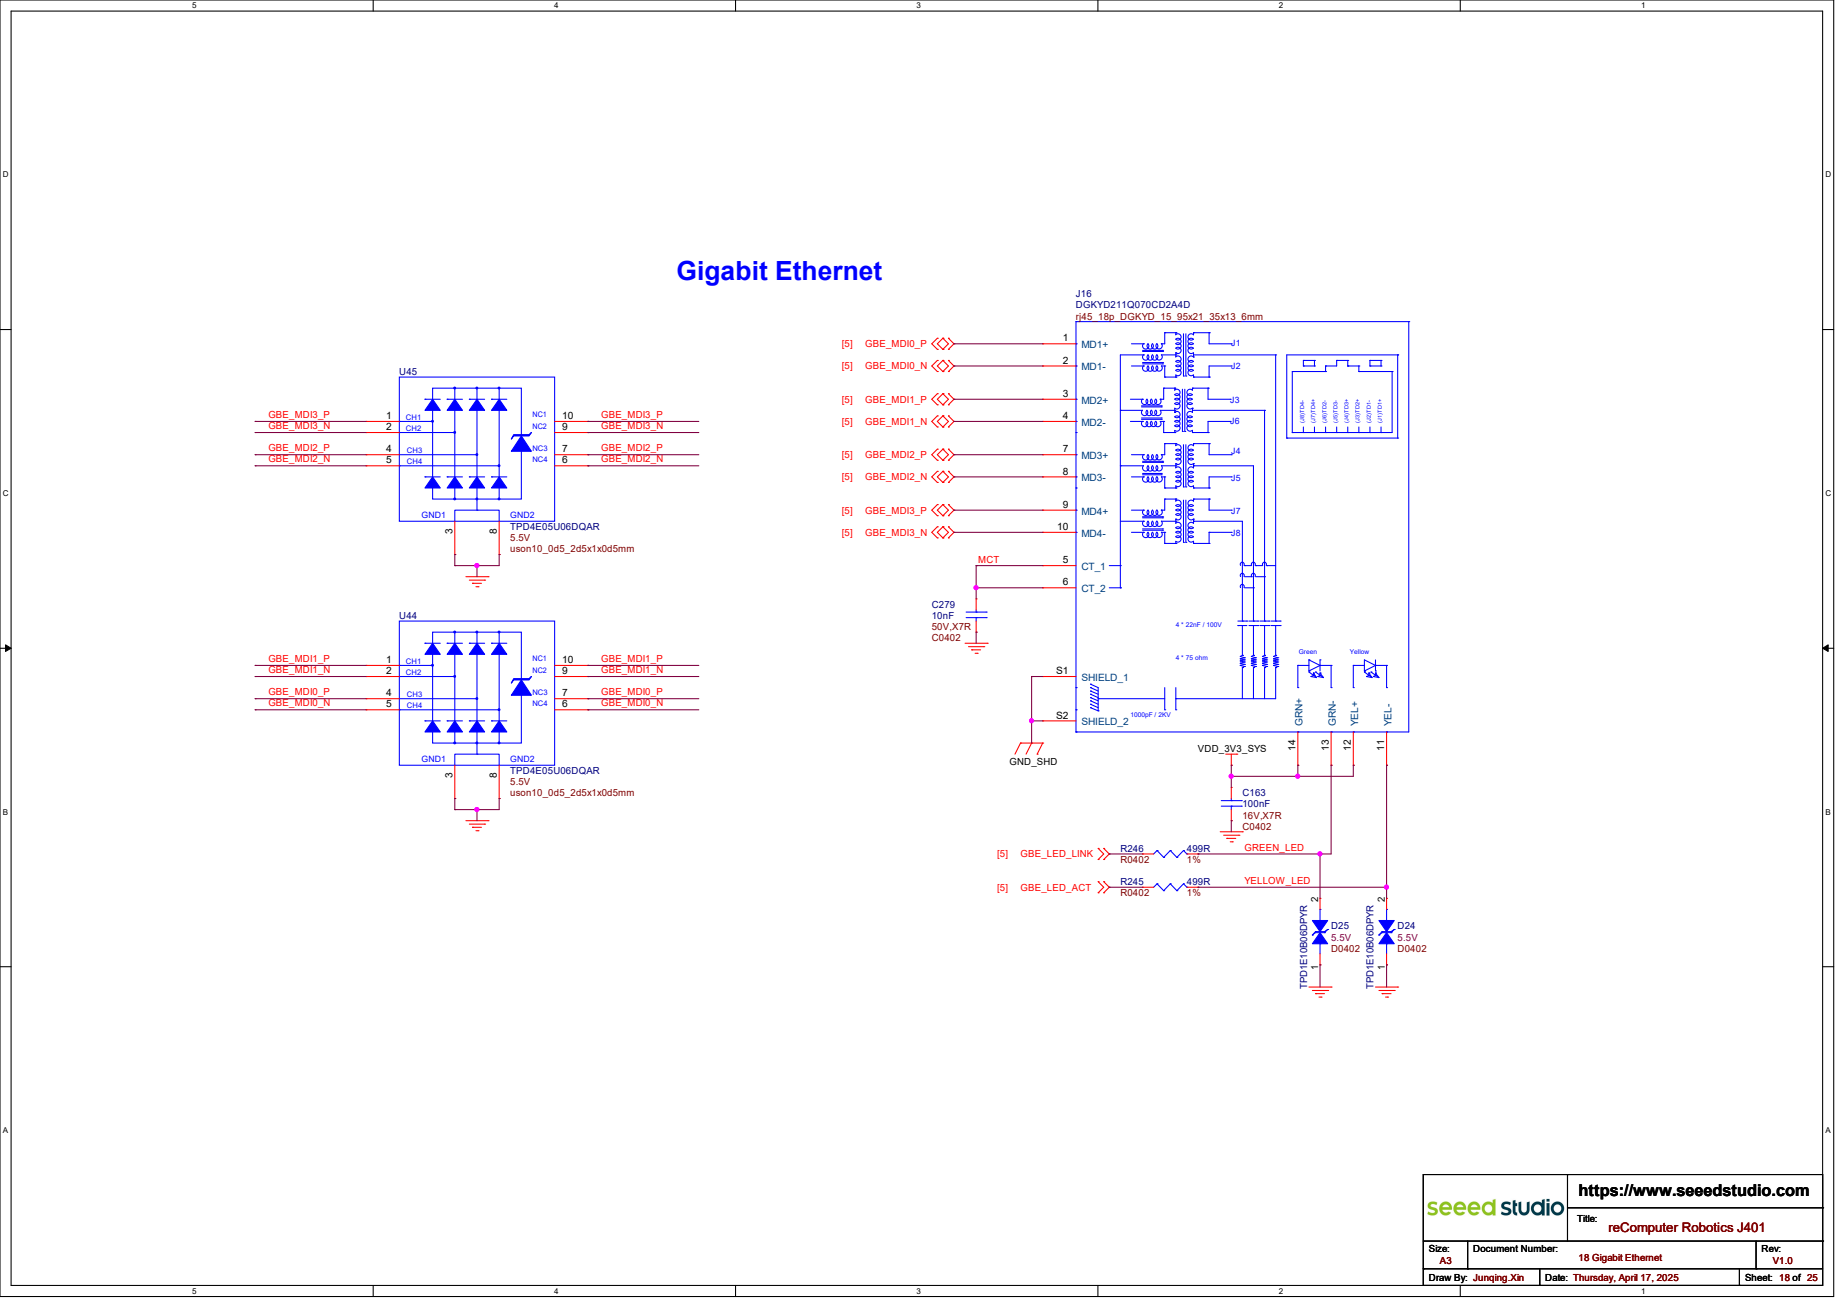
[picture p200: page 18]

reComputer Robotics J401 18 Gigabit Ethernet

# PCIe to Ethernet

## 1 of 2 U26A

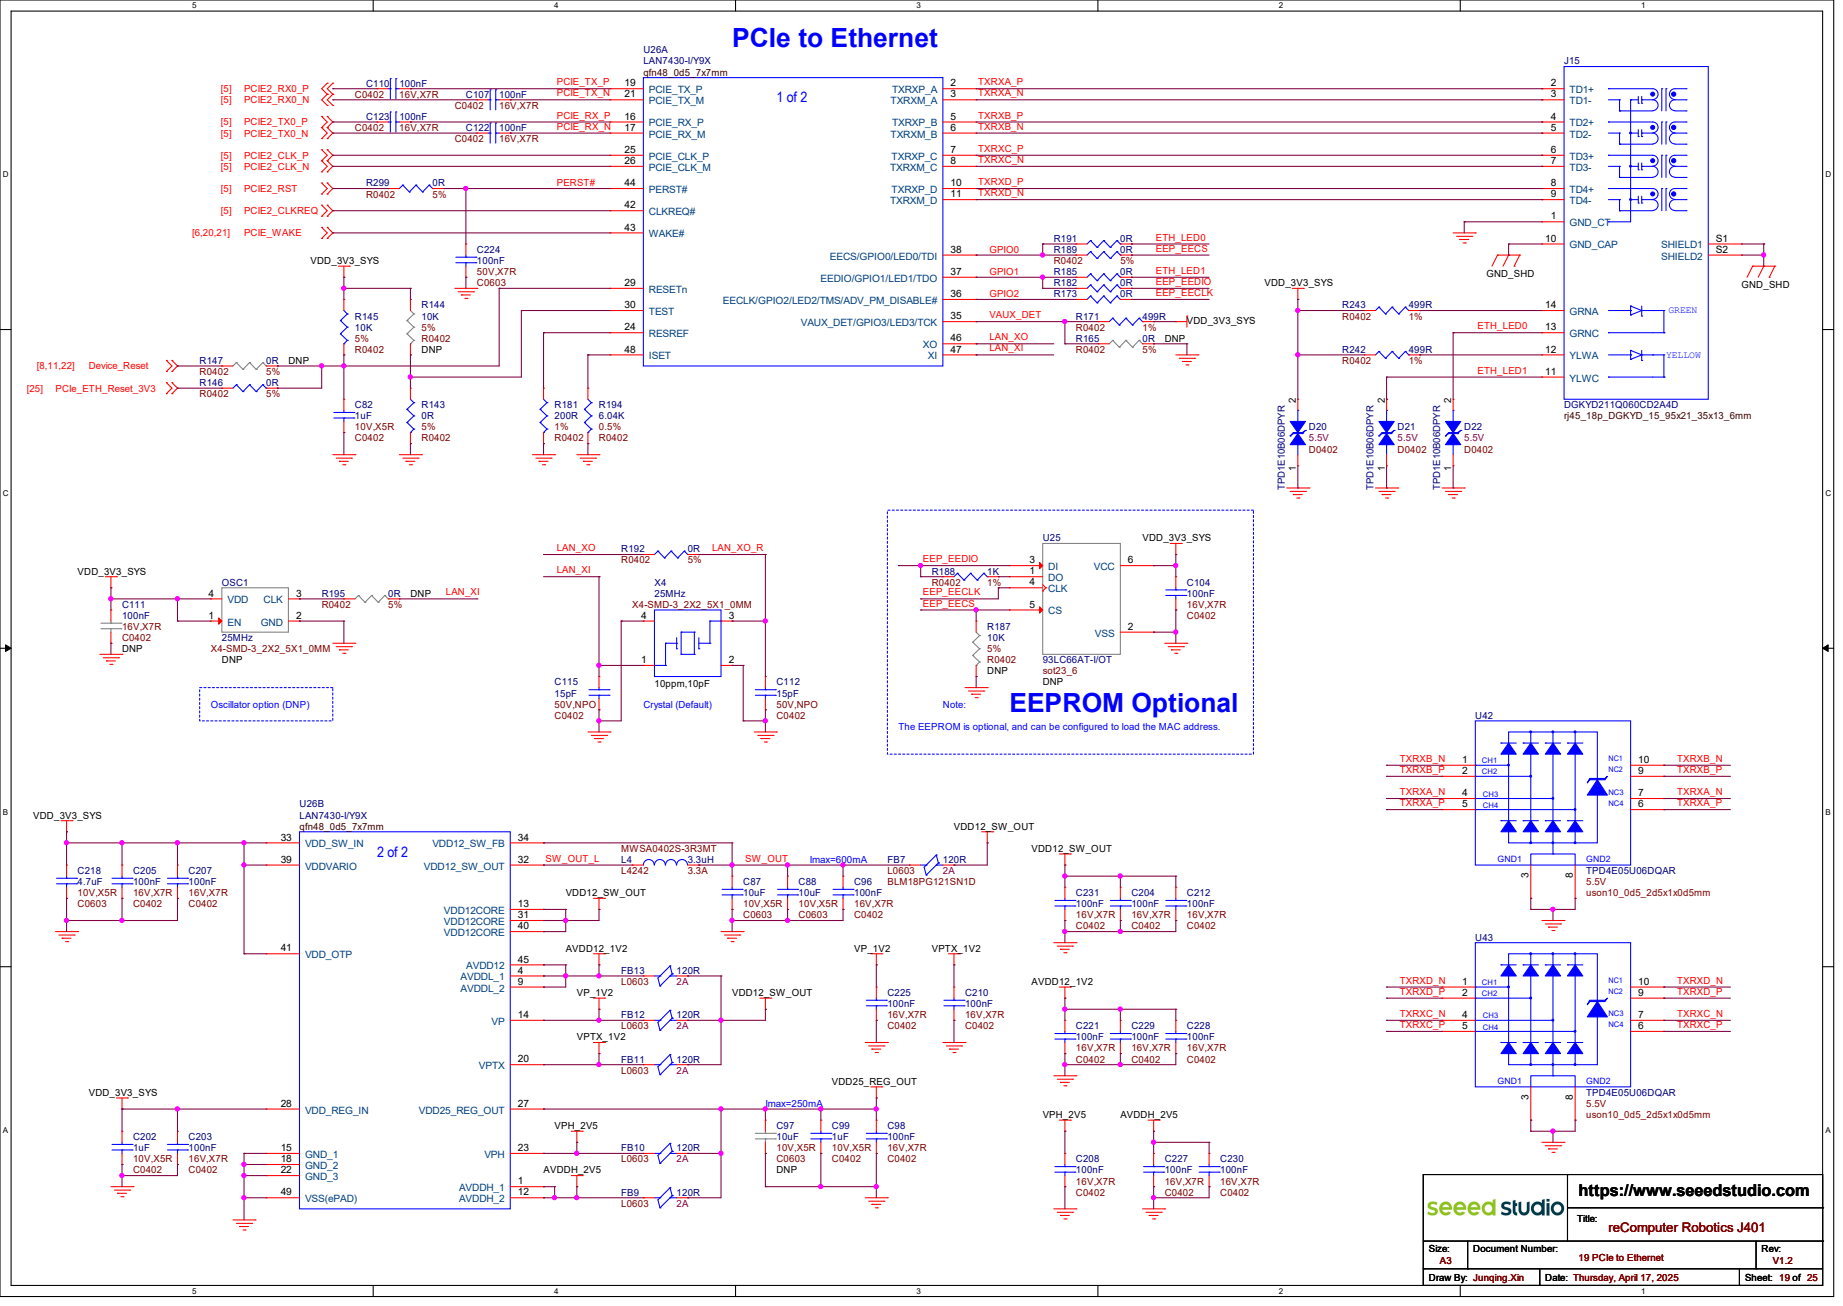
[picture p201: page 19]

LAN7430-I/Y9X
qfn48_0d5_7x7mm
RESETn 29 TEST 30 PERST# 44 PCIE_CLK_P 25 PCIE_CLK_M 26 PCIE_TX_P 19 PCIE_TX_M 21 PCIE_RX_P 16 PCIE_RX_M 17 CLKREQ# 42 WAKE# 43 RESREF 24

reComputer Robotics J401 19 PCIe to Ethernet

# M.2 KEY-M (NVME)

## M.2 KEY M

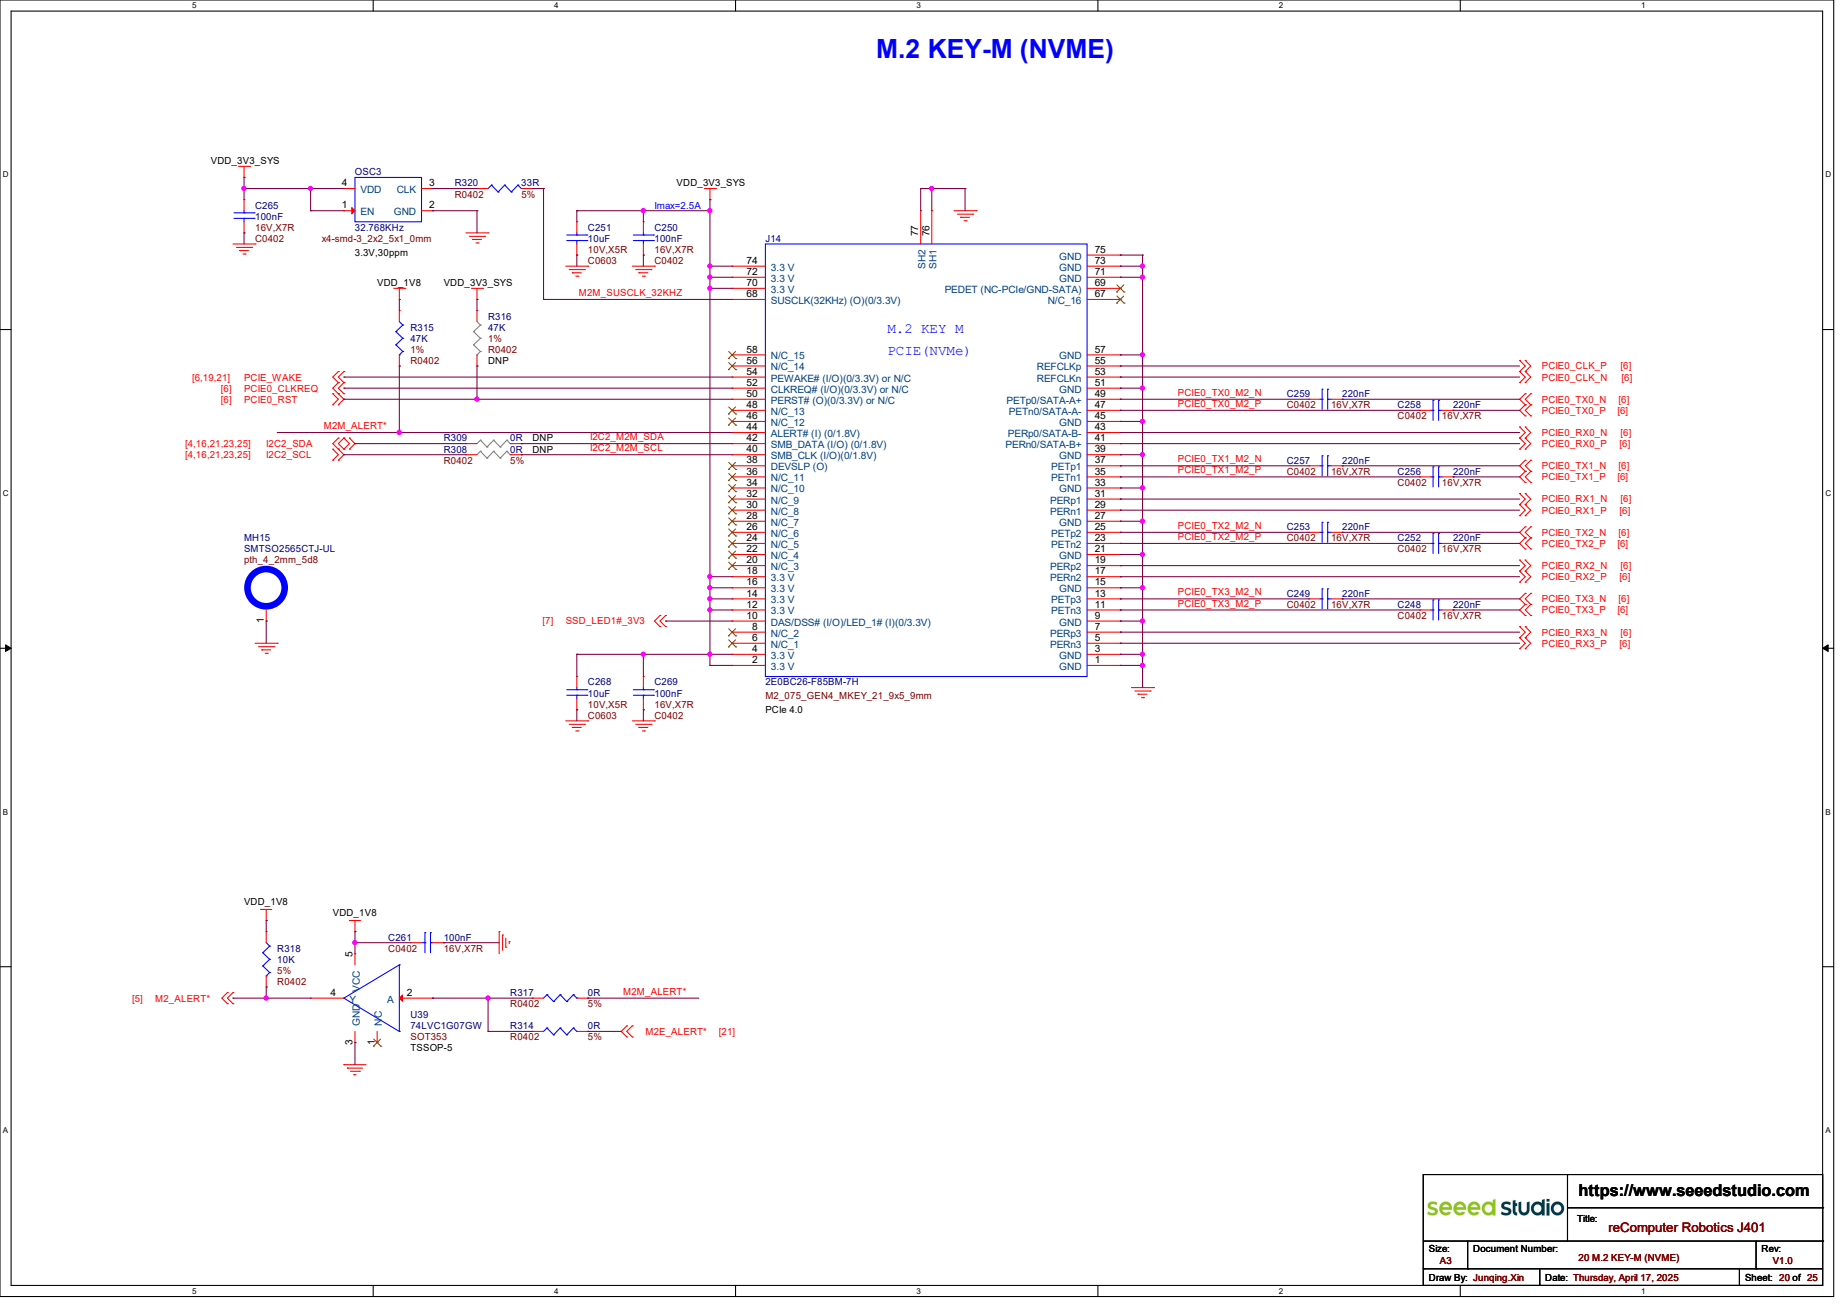
[picture p202: page 20]

reComputer Robotics J401 20 M.2 KEY-M (NVME)

# M.2 KEY-E (WIFI/BT)

LED1# (I)(OD) 6 PCM_CLK/I2S_SCK(I/O)(0/1.8V) 8 PCM_SYNC/I2S_WS(I/O)(0/1.8V) 10 PCM_IN/I2S_SD_IN(I)(0/1.8V) 12 PCM_OUT/I2S_SD_OUT(O)(0/1.8V) 14 LED2#(I)(OD) 16 GND 18 UART_WAKE#(I)(0/3.3V) 20 UART_RXD(I)(0/1.8V) 22 UART_TXD(O)(0/1.8V) 32 UART_CTS(I)(0/1.8V) 34 UART_RTS(O)(0/1.8V) 36 VENDOR_DEFINED1 38 VENDOR_DEFINED2 40 VENDOR_DEFINED3 42 COEX3(I/O)(0/1.8V) 44 COEX2(I/O)(0/1.8V) 46 COEX1(I/O)(0/1.8V) 48 SUSCLK(32kHz) (O)(0/3.3V) 50 PERST0#(O)(0/3.3V) 52 W_DISABLE2#(O)(0/3.3V) 54 W_DISABLE1#(O)(0/3.3V) 56 I2C_DATA(I/O)(0/1.8V) 58 I2C_CLK(O)(0/1.8V) 60 ALERT#(I)(0/1.8V) 62 RSVD 64 UIM_SWP/PERST1# 66 UIM_POWER_SNK/CLKREQ1# 68 UIM_POWER_SRC/GPIO1/PEWAKE1# 70 3.3V 72 3.3V 74 SH¹ ⁷⁶ SH² ⁷⁷

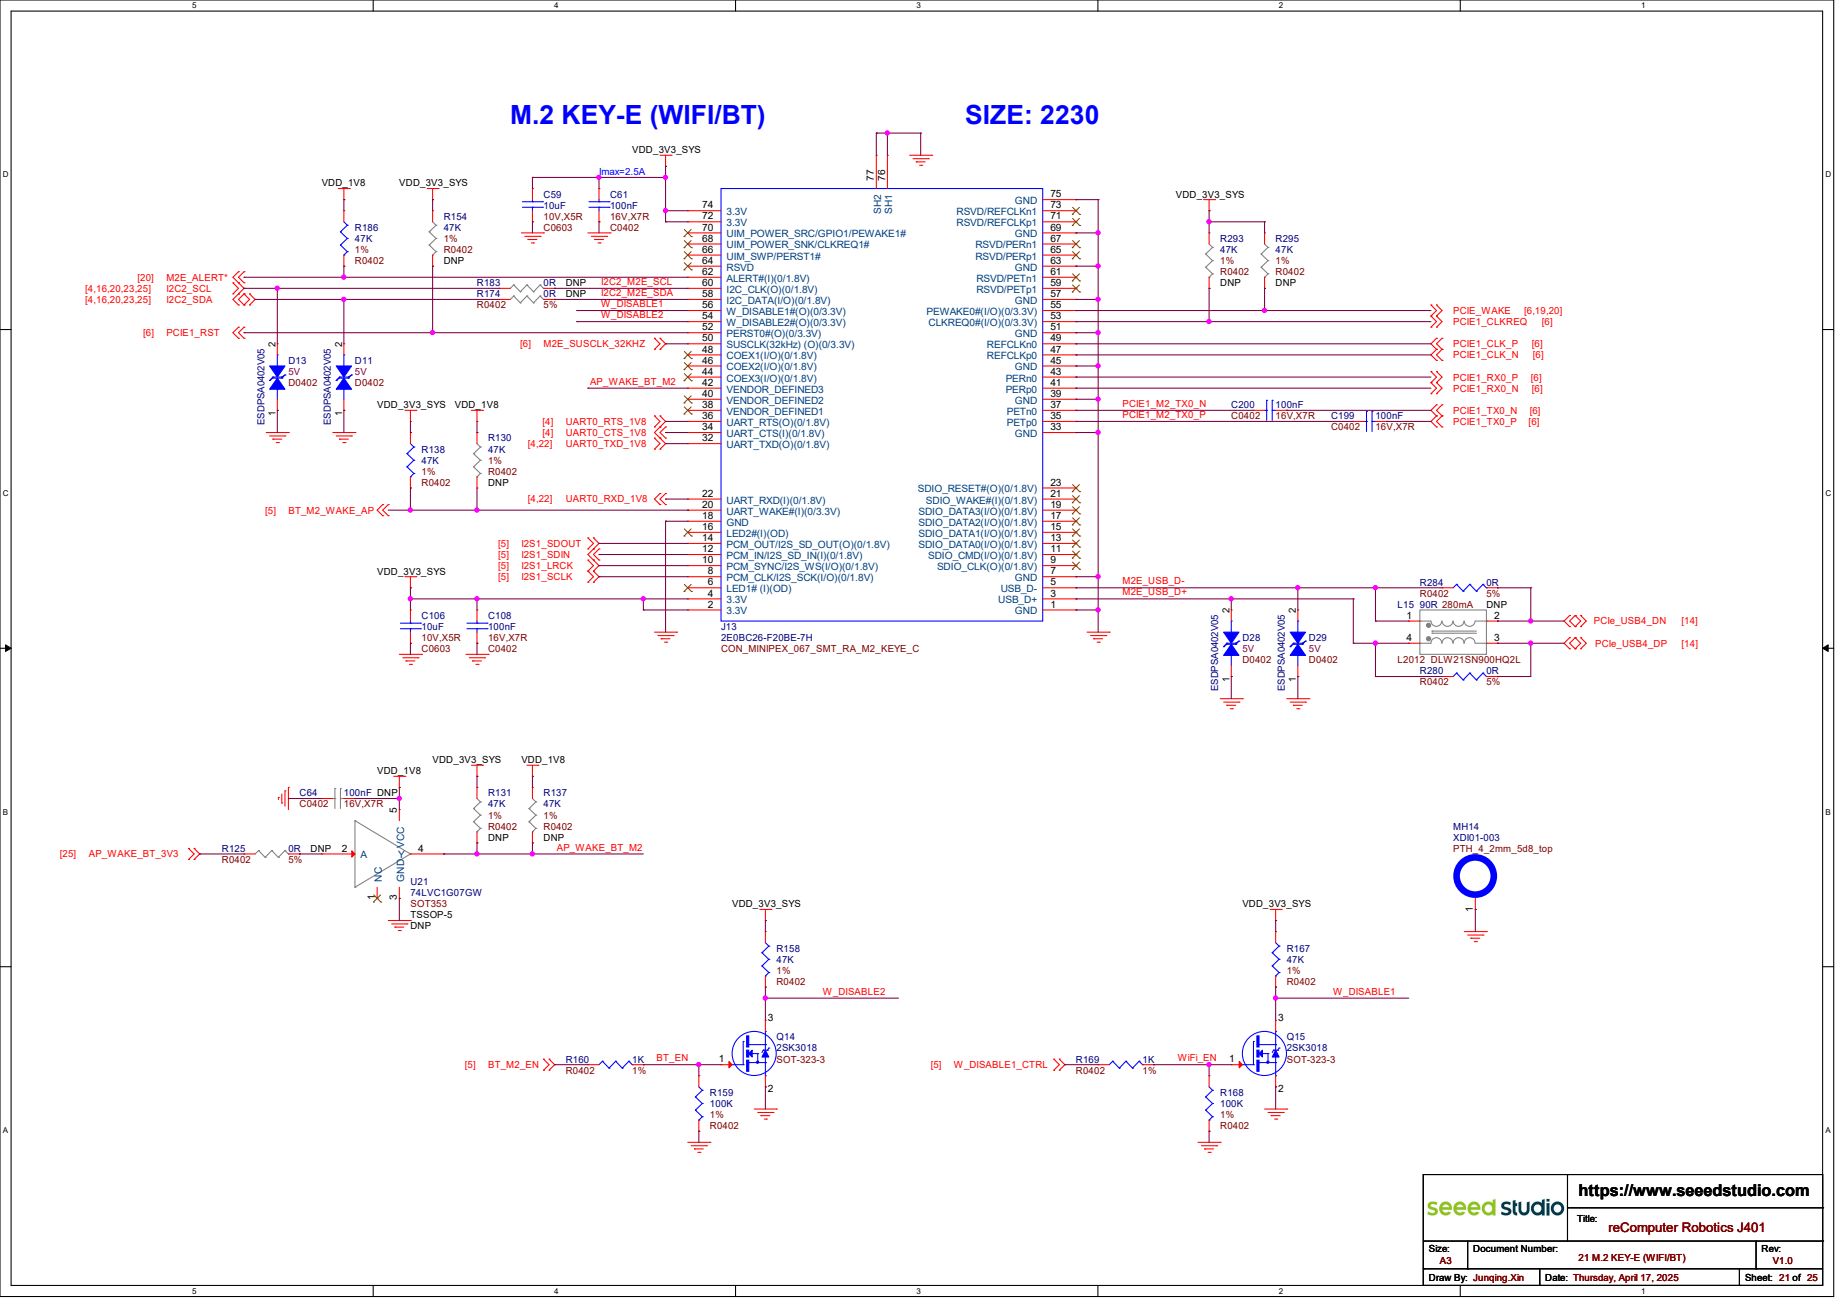
[picture p203: page 21]

reComputer Robotics J401 21 M.2 KEY-E (WIFI/BT)

# M.2 KEY-B (4G/5G)

1 | 2 R133 | 0R

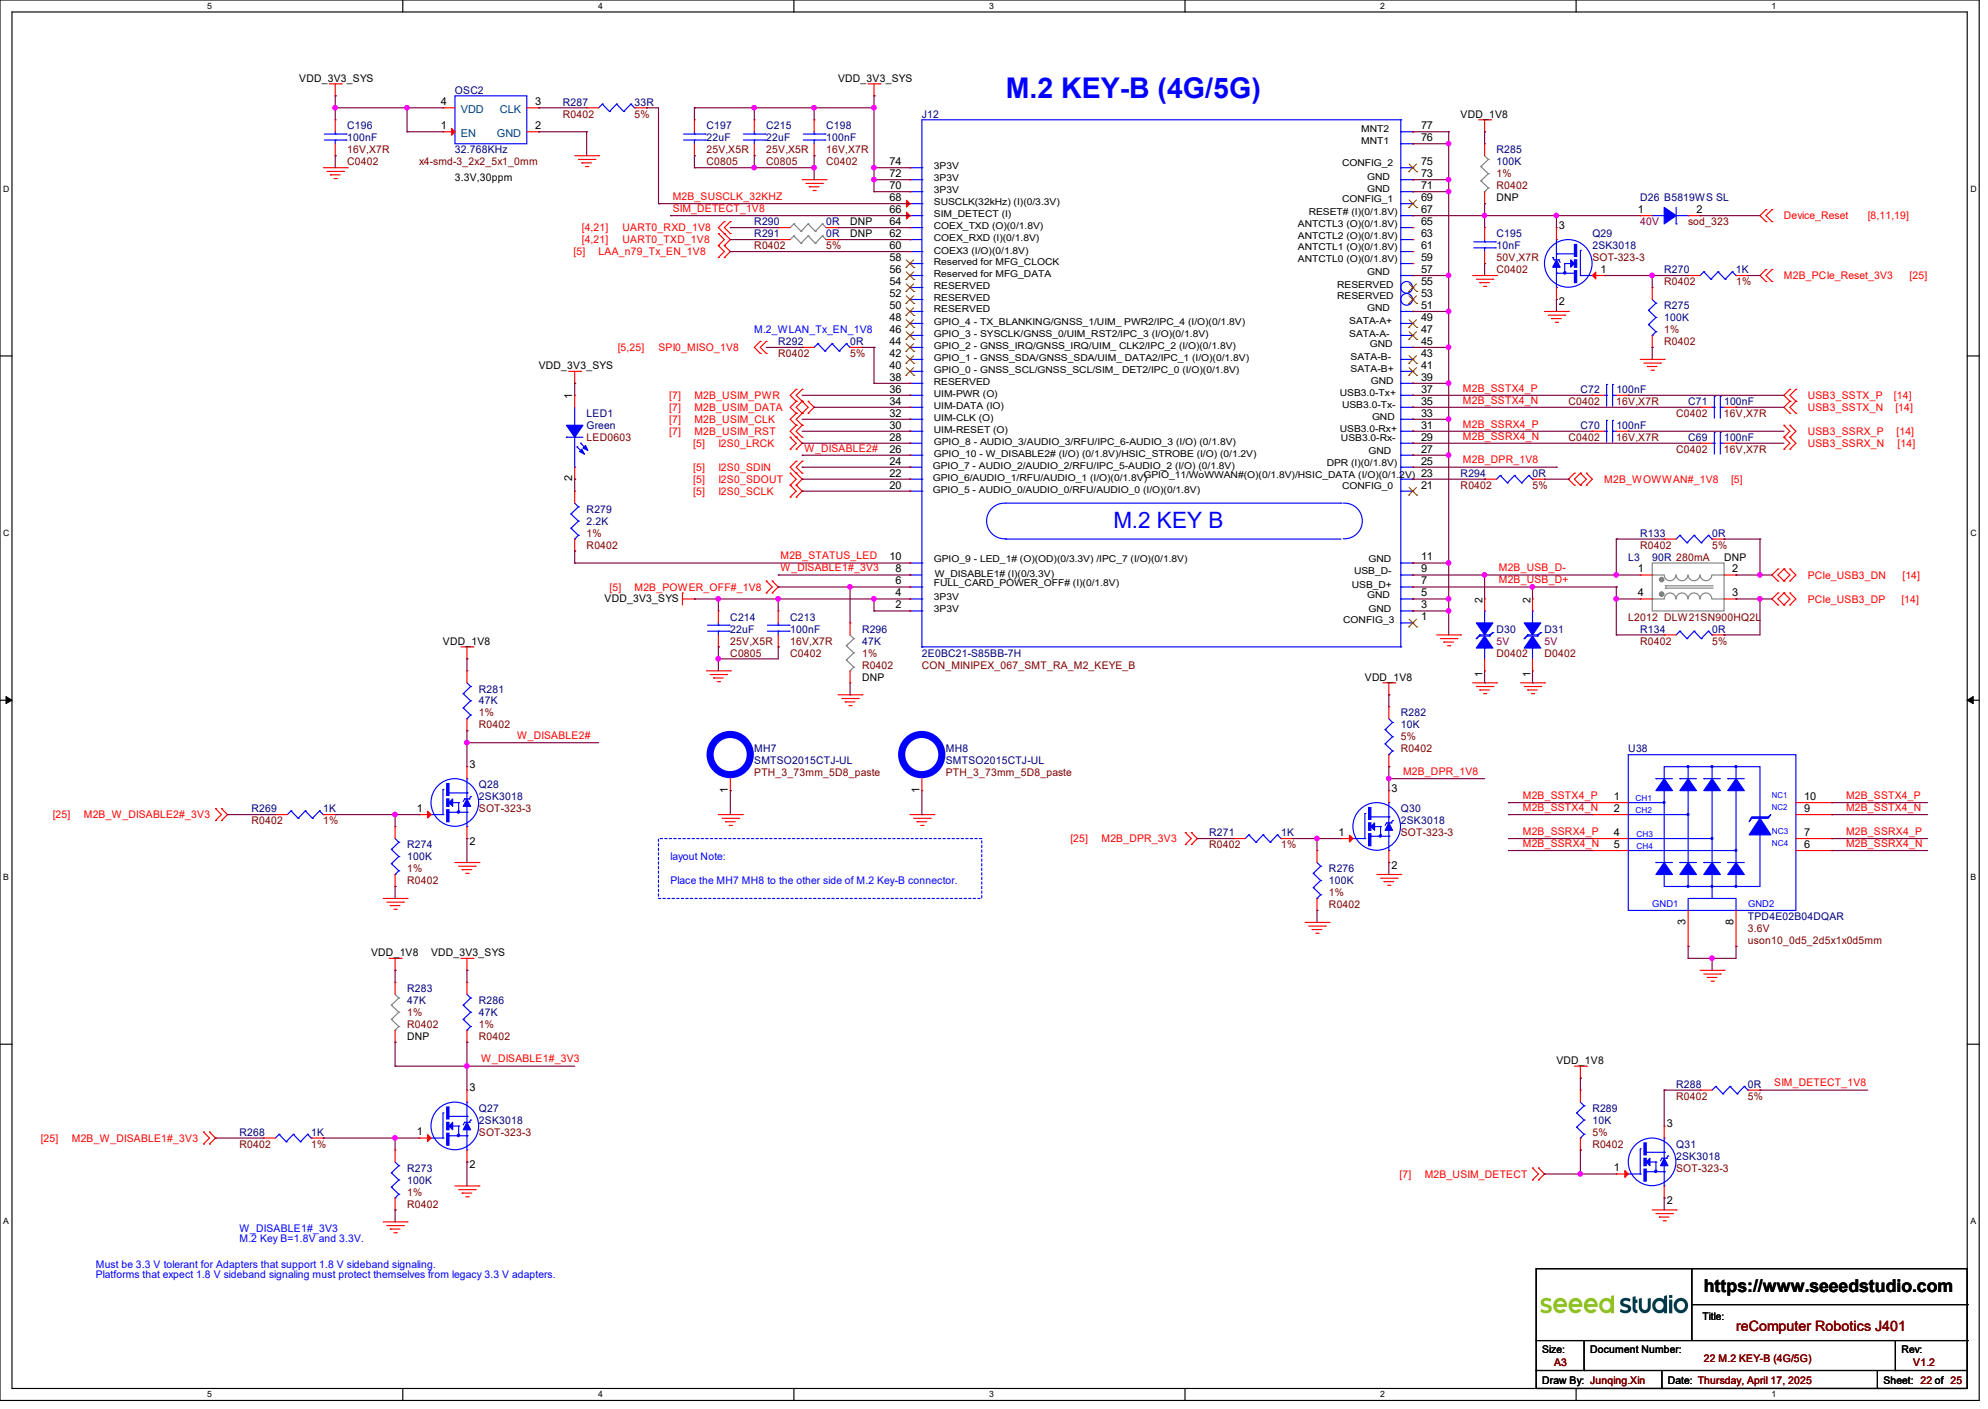
[picture p204: page 22]

layout Note: Place the MH7 MH8 to the other side of M.2 Key-B connector. Must be 3.3 V tolerant for Adapters that support 1.8 V sideband signaling. Platforms that expect 1.8 V sideband signaling must protect themselves from legacy 3.3 V adapters.

SoC Fan Header 4pin | GND

# 5V Fan GND

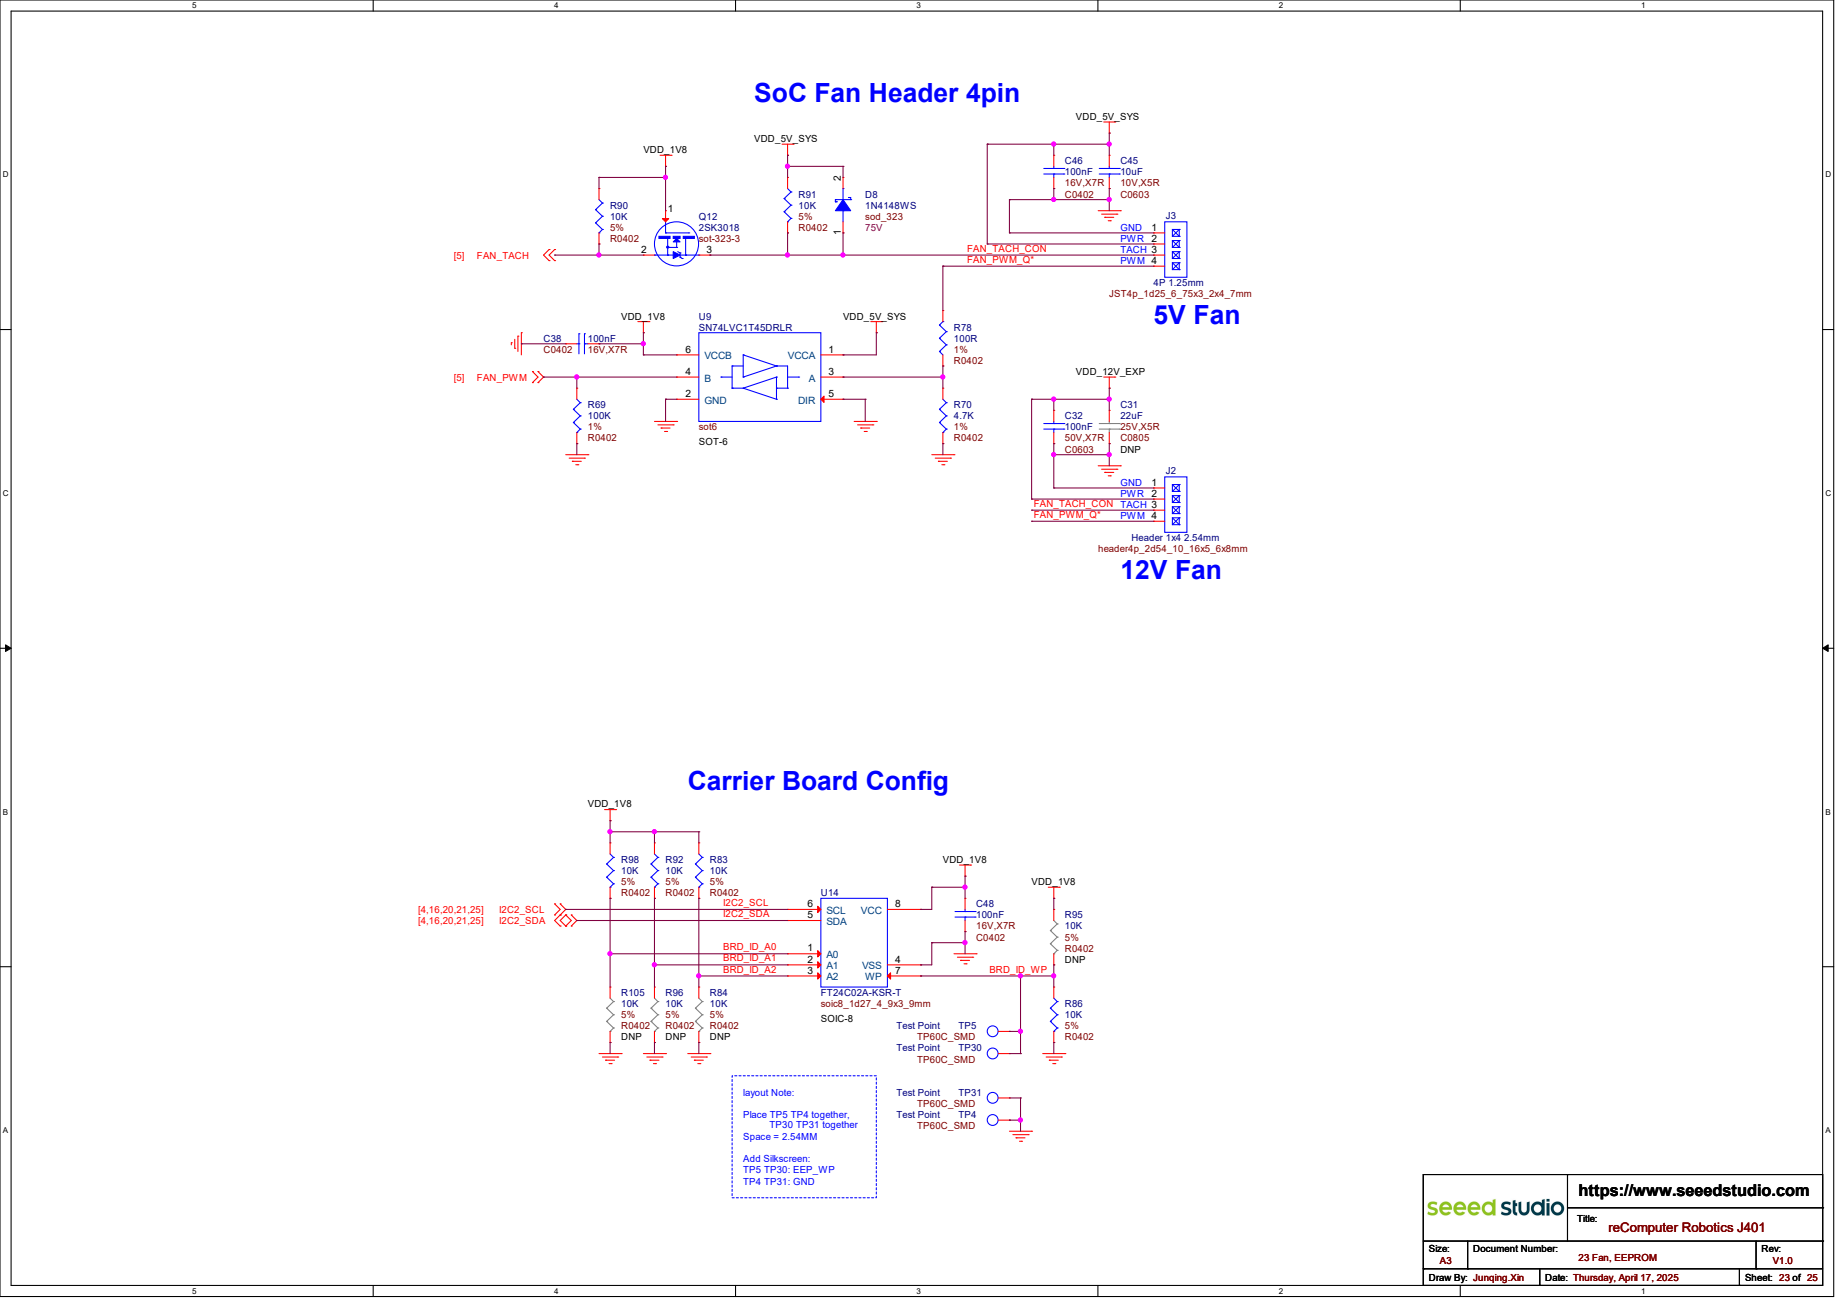
[picture p205: page 23]

layout Note: Place TP5 TP4 together,

reComputer Robotics J401 23 Fan, EEPROM

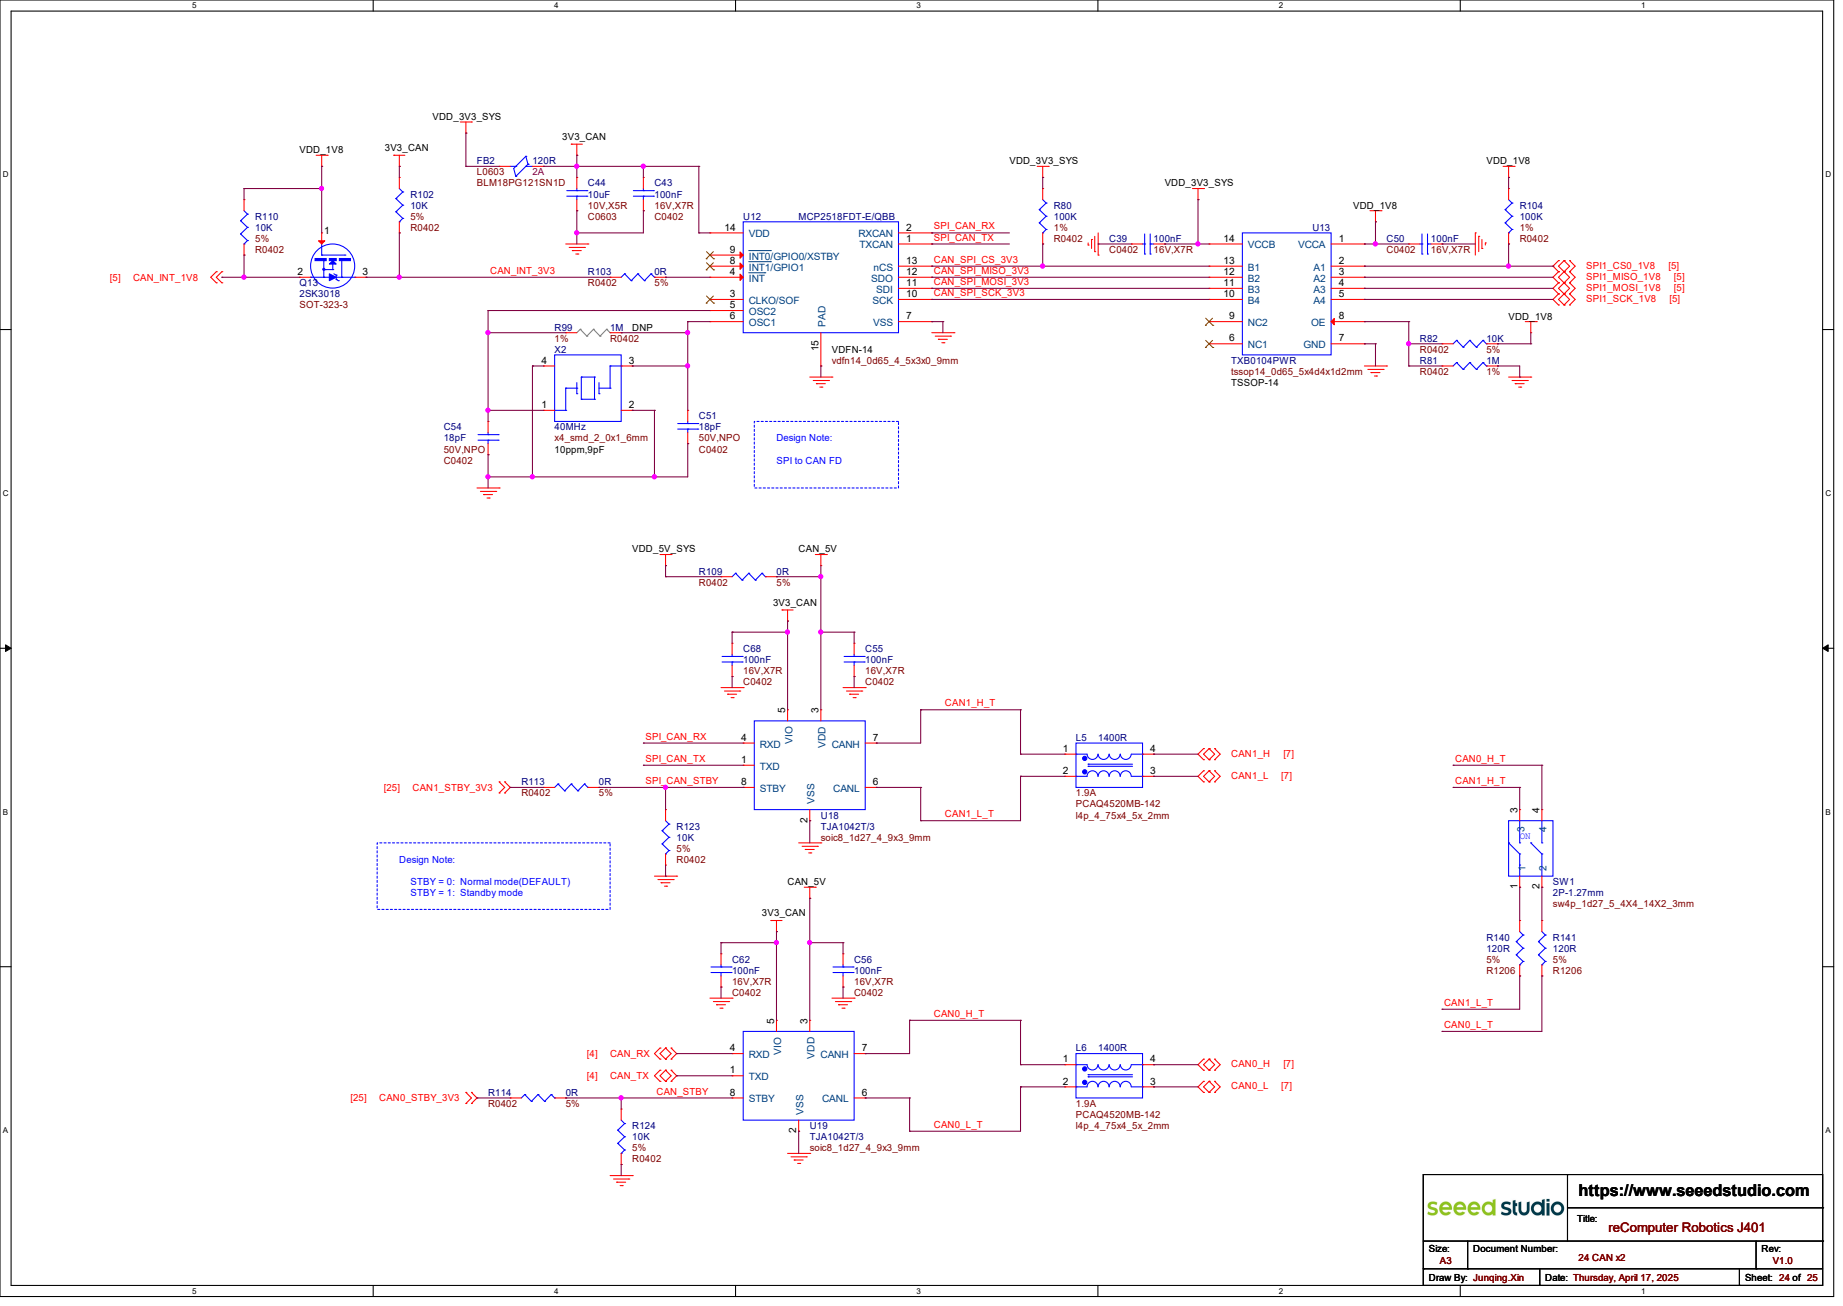
[picture p206: page 24]

VDFN-14 TXCAN 1 RXCAN 2 CLKO/SOF 3

SPI to CAN FD

STBY = 0: Normal mode(DEFAULT) Design Note: STBY = 1: Standby mode

CSI 0 | CSI 1

# J10 QSH-030-01-L-D-A

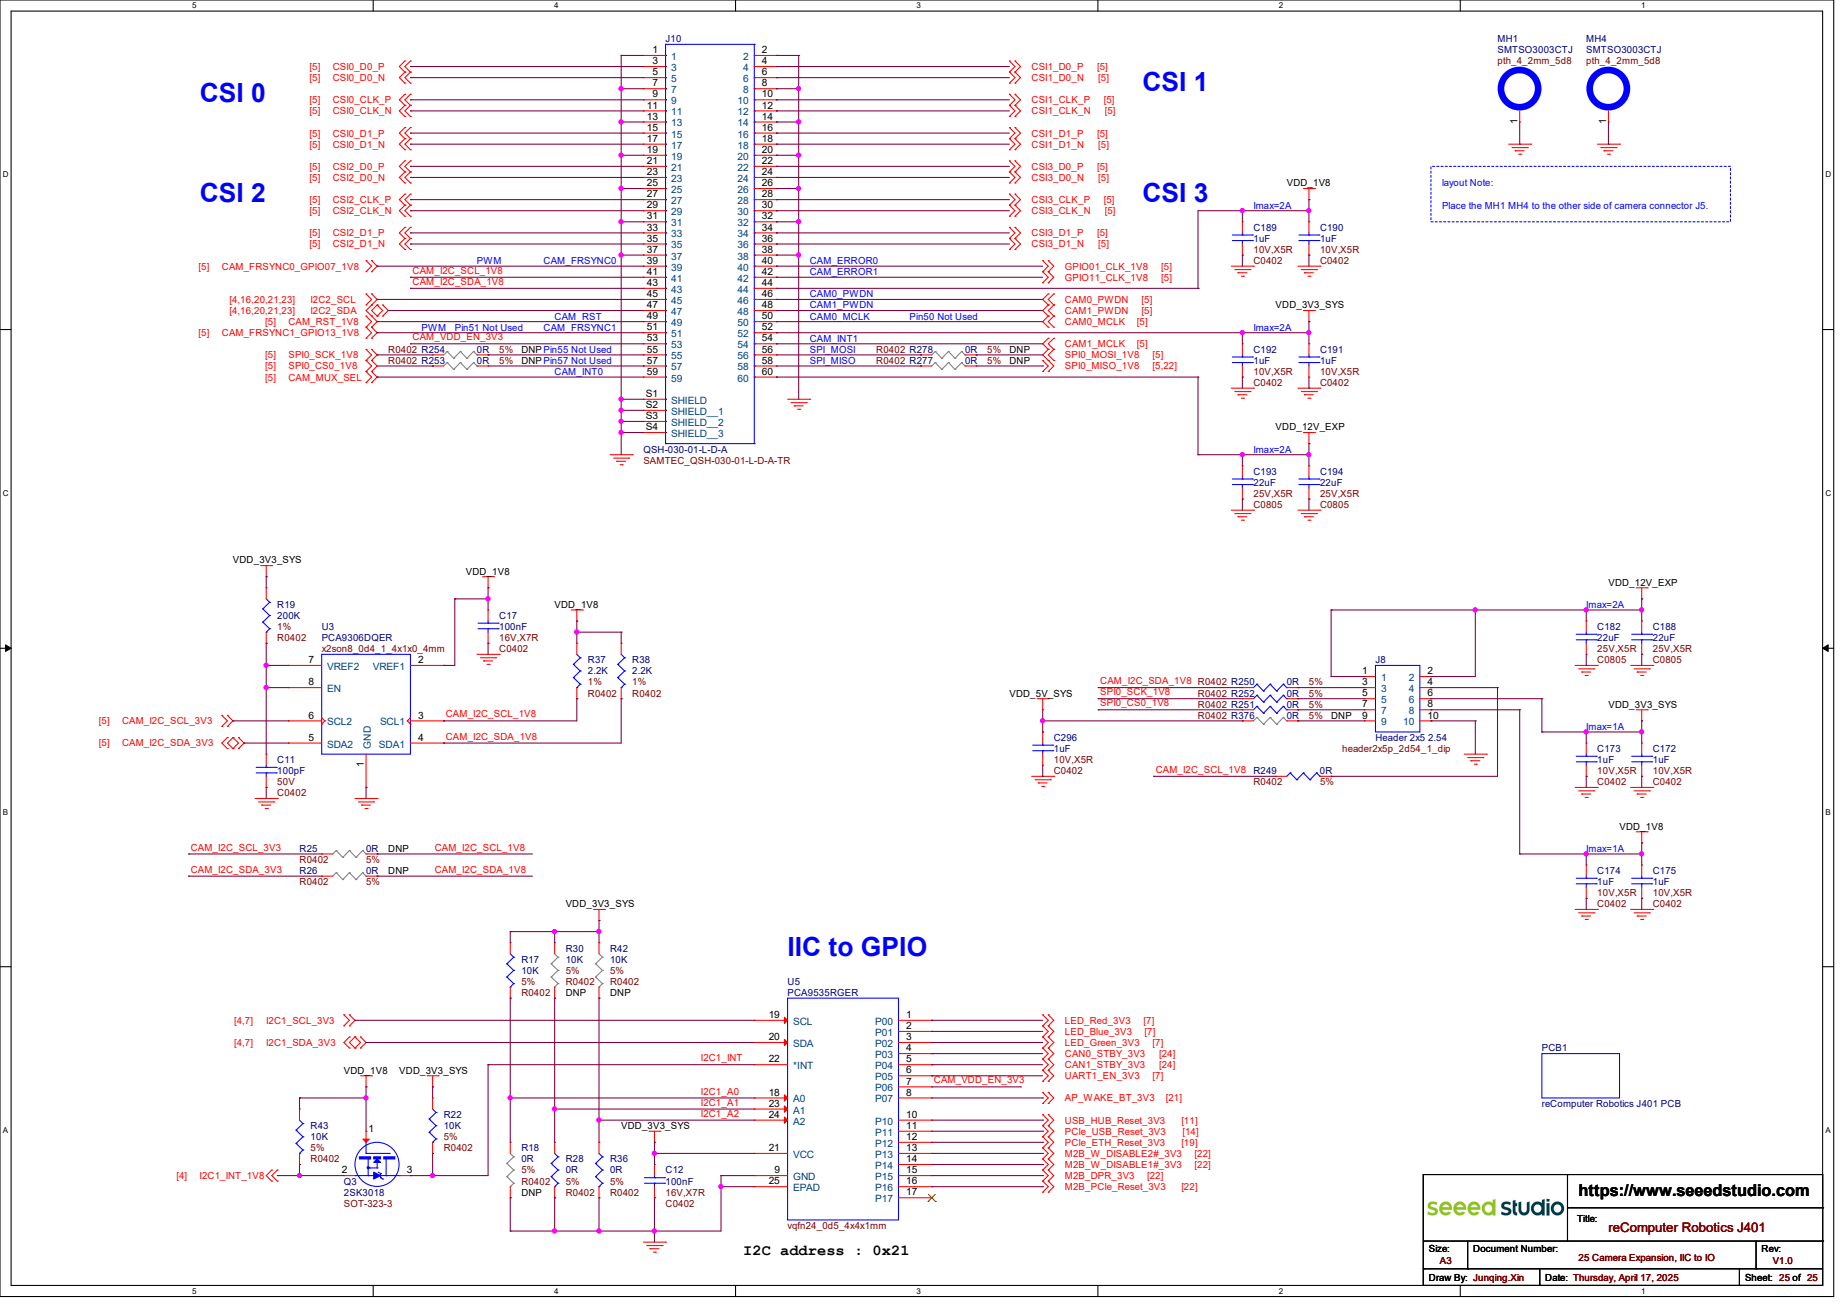
[picture p207: page 25]

reComputer Robotics J401 25 Camera Expansion, IIC to IO
