Seeed-Studio/OSHW-Jetson-Series/reComputer Jetson carrier board/reComputer Robotics J501/Schematic/reComputer Robotics J501 Main Board for Jetson AGX Orin_V1.0_SCH_2512161.pdf

DATE | DESCRIPTION

# Schematic: reComputer industrial J501

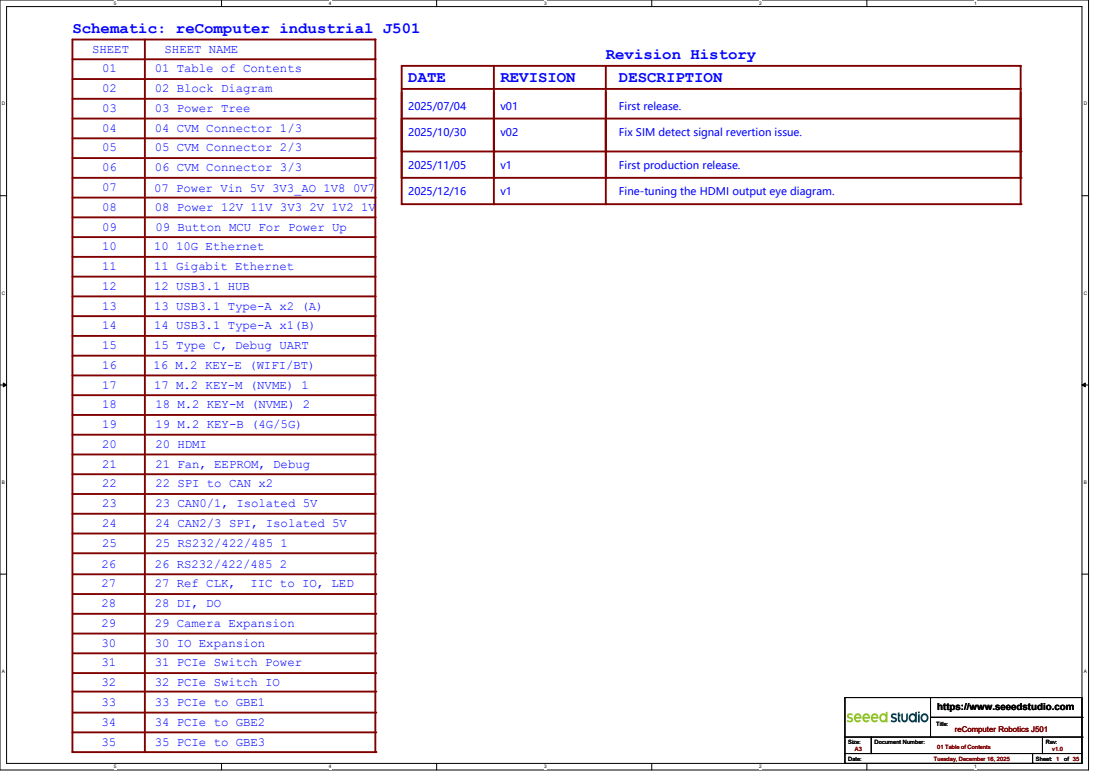
[picture p208: page 1]
SHEET; Revision History; 04 CVM Connector 1/3; 07 Power Vin 5V 3V3_AO 1V8 0V7; First release. v01; Fix SIM detect signal revertion issue. v02; Fine-tuning the HDMI output eye diagram.; REVISION; Title: Size:; Document Number:; Rev: Date:; Sheet:; https://www.seeedstudio.com A3; v1.0 Tuesday, December 16, 2025; reComputer Robotics J501 01 Table of Contents Title: Size:

SHEET NAME

01 01 Table of Contents
02 | 02 Block Diagram
03 03 Power Tree

05 | 05 CVM Connector 2/3
06 | 06 CVM Connector 3/3

2025/11/05 | v1 | First production release.

08 | 08 Power 12V 11V 3V3 2V 1V2 1V
09 | 09 Button MCU For Power Up
10 | 10 10G Ethernet
11 | 11 Gigabit Ethernet
12 12 USB3.1 HUB
13 | 13 USB3.1 Type-A x2 (A)
14 | 14 USB3.1 Type-A x1(B)
15 | 15 Type C, Debug UART
16 | 16 M.2 KEY-E (WIFI/BT)
17 | 17 M.2 KEY-M (NVME) 1
18 | 18 M.2 KEY-M (NVME) 2
19 | 19 M.2 KEY-B (4G/5G)
20 | 20 HDMI
21 | 21 Fan, EEPROM, Debug
22 | 22 SPI to CAN x2
23 | 23 CAN0/1, Isolated 5V
24 | 24 CAN2/3 SPI, Isolated 5V
25 | 25 RS232/422/485 1
26 | 26 RS232/422/485 2
27 | 27 Ref CLK, IIC to IO, LED
28 | 28 DI, DO
29 | 29 Camera Expansion
30 | 30 IO Expansion
31 | 31 PCIe Switch Power
32 | 32 PCIe Switch IO
33 | 33 PCIe to GBE1
34 | 34 PCIe to GBE2
35 | 35 PCIe to GBE3

reComputer Robotics J501 01 Table of Contents

# reComputer Robotics J501

## Power Sequencer

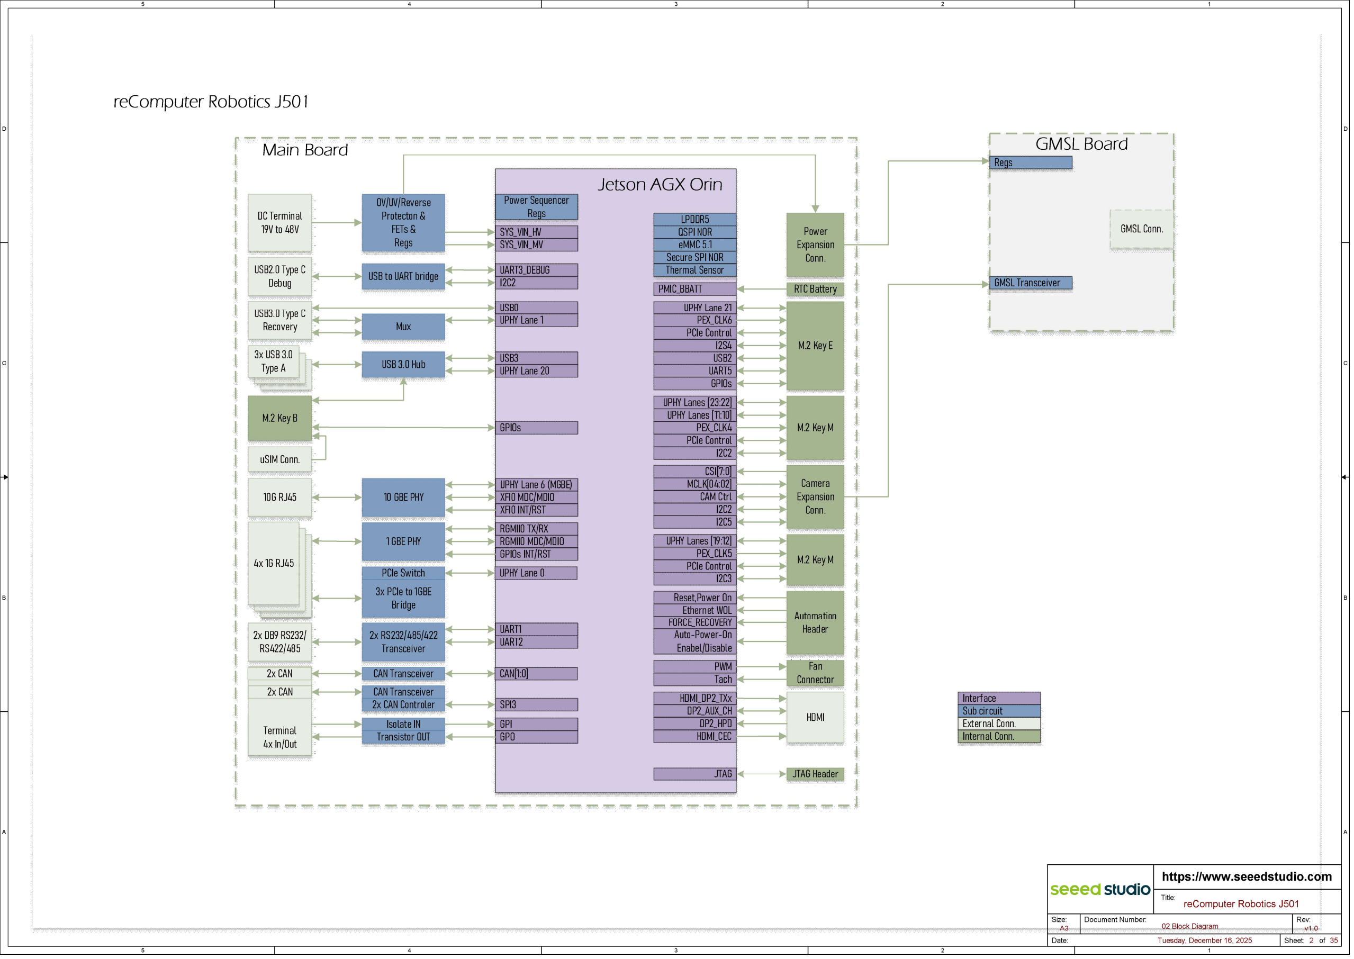
[picture p209: page 2]

D D

C C

B B

A A

## CAN Transceiver

## Terminal 4x In/Out

## 1G RJ45

## 1G RJ45

## 1G RJ45

## 4x 1G RJ45

## Regs

## Isolate IN Transistor OUT

## USB2.0 Type C Debug

## USB3.0 Type C Recovery

## HDMI

## M.2 Key M

## M.2 Key E

## M.2 Key B

## Camera Expansion

Conn.

## Fan Connector

## USB to UART bridge RTC Battery

## USB 3.0 Hub

## 3x USB 3.0 Type A

## PMIC_BBATT

## SYS_VIN_HV SYS_VIN_MV

## USB0 UPHY Lane 1

## UPHY Lane 0

## UPHY Lane 20

## USB3

## UPHY Lane 21 PEX_CLK6

I2S4

## PCIe Control

## USB2 UART5 GPIOs

## UPHY Lanes [23:22]

## PEX_CLK4 PCIe Control

I2C2

## UPHY Lanes [11:10]

## CSI[7:0] MCLK[04:02] CAM Ctrl

I2C2
I2C5

## M.2 Key M

## UPHY Lanes [19:12] PEX_CLK5 PCIe Control

I2C3

## Automation Header

## Reset,Power On Ethernet WOL FORCE_RECOVERY Auto-Power-On Enabel/Disable

## PWM Tach

## 2x CAN Controler

## 2x CAN

## Mux

## UART3_DEBUG

I2C2

## GPIOs

uSIM Conn.

## UART1

## CAN[1:0]

## SPI3

## PCIe Switch

## 10G RJ45

## HDMI_DP2_TXx DP2_AUX_CH DP2_HPD HDMI_CEC

## 10 GBE PHY

## UPHY Lane 6 (MGBE) XFI0 MDC/MDIO XFI0 INT/RST

## 1 GBE PHY

## RGMII0 TX/RX RGMII0 MDC/MDIO GPIOs INT/RST

## 2x DB9 RS232/

RS422/485

## 2x RS232/485/422

Transceiver | UART2

## GPI GPO

JTAG | JTAG Header

## LPDDR5 QSPI NOR eMMC 5.1 Secure SPI NOR Thermal Sensor

# Jetson AGX Orin

## OV/UV/Reverse Protecton & FETs & Regs

## Power Expansion

Conn.

Main Board | GMSL Board

## GMSL Transceiver

## Regs

GMSL Conn.

## Interface Sub circuit

External Conn.
Internal Conn.

## 3x PCIe to 1GBE Bridge

## CAN Transceiver

## 2x CAN

## DC Terminal 19V to 48V

https://www.seeedstudio.com A3 | v1.0 Tuesday, December 16, 2025 | 2 | 35

## reComputer Robotics J501 02 Block Diagram

https://www.seeedstudio.com A3 | v1.0 Tuesday, December 16, 2025 | 2 | 35

## reComputer Robotics J501 02 Block Diagram

https://www.seeedstudio.com A3 | v1.0 Tuesday, December 16, 2025 | 2 | 35

## reComputer Robotics J501 02 Block Diagram

## DC Terminal System Power

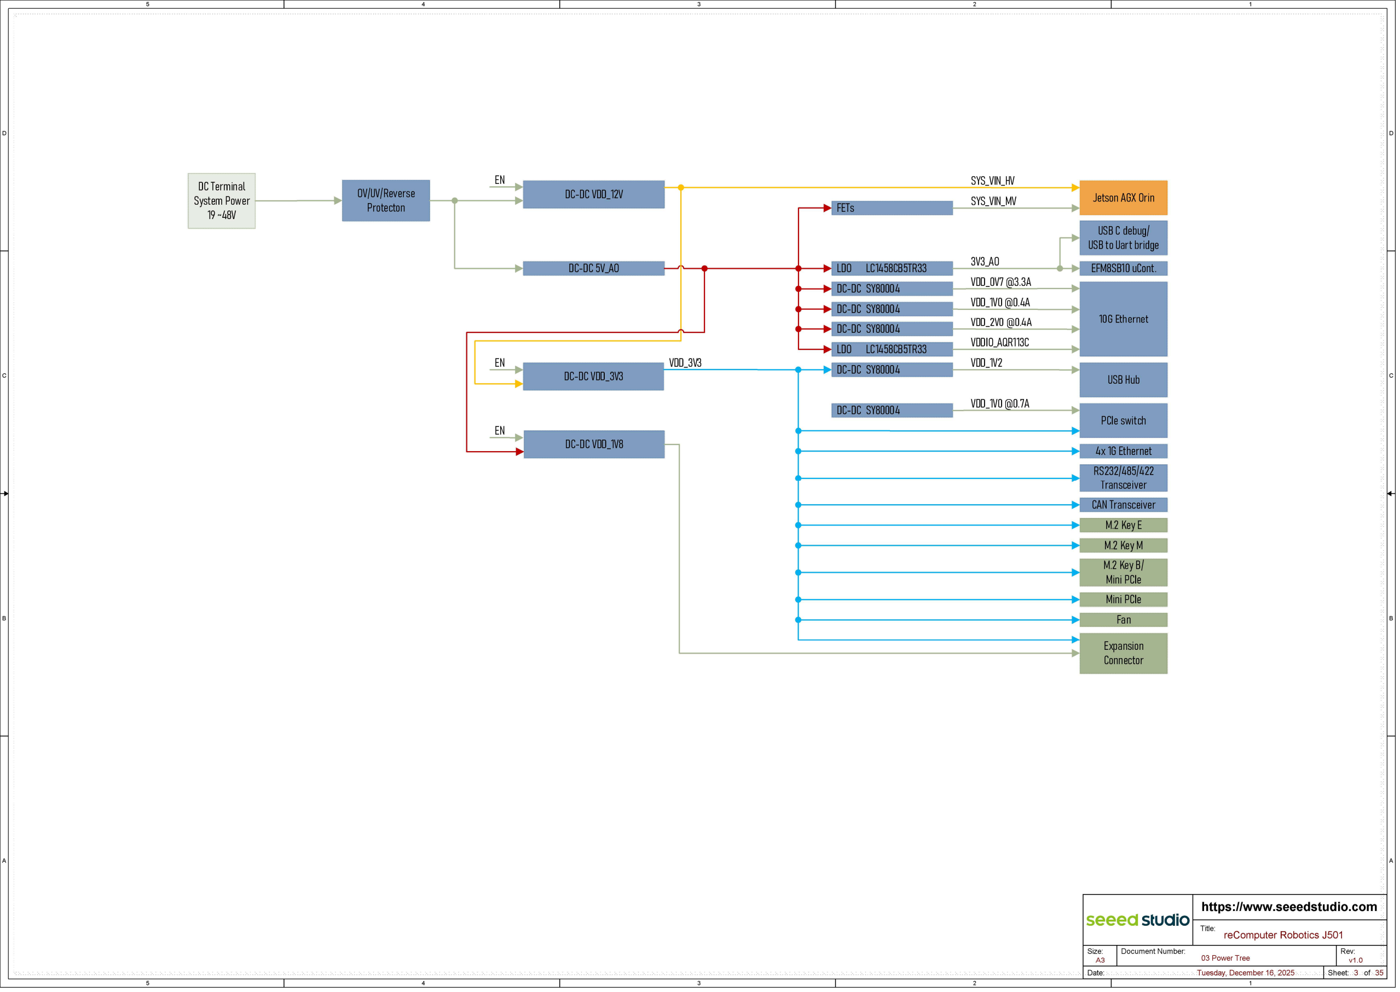
[picture p210: page 3]

D D

C C

B B

A A

19 ~48V

## OV/UV/Reverse Protecton

## DC-DC VDD_12V

## SYS_VIN_HV

DC-DC 5V_AO | 3V3_AO

## FETs

EN
SYS_VIN_MV | Jetson AGX Orin
LDO | LC1458CB5TR33 | EFM8SB10 uCont.

## DC-DC VDD_3V3

EN

DC-DC SY80004 | VDD_0V7 @3.3A
DC-DC SY80004 | VDD_1V0 @0.4A
DC-DC SY80004 | VDD_2V0 @0.4A
LDO | LC1458CB5TR33 | VDDIO_AQR113C

## 10G Ethernet

## USB Hub

## PCIe switch

## 4x 1G Ethernet

RS232/485/422

## Transceiver

## CAN Transceiver

## M.2 Key M

## M.2 Key E

## Mini PCIe

## USB C debug/ USB to Uart bridge

## M.2 Key B/ Mini PCIe

## Fan

DC-DC SY80004 | VDD_1V2
DC-DC SY80004 | VDD_1V0 @0.7A

## VDD_3V3

## DC-DC VDD_1V8

EN

## Expansion Connector

https://www.seeedstudio.com A3 | v1.0 Tuesday, December 16, 2025 | 3 | 35
reComputer Robotics J501 03 Power Tree Title: Size: | Document Number: | Rev: Date: | Sheet: | of
https://www.seeedstudio.com A3 | v1.0 Tuesday, December 16, 2025 | 3 | 35
reComputer Robotics J501 03 Power Tree Title: Size: | Document Number: | Rev: Date: | Sheet: | of
https://www.seeedstudio.com A3 | v1.0 Tuesday, December 16, 2025 | 3 | 35

## reComputer Robotics J501 03 Power Tree

J20 | GND_175 G20 | GND_174 E20 | GND_173 C20 | GND_172 A20 | GND_171 L21 | GND_170 J21 | GND_169 G21 | GND_168 E21 | GND_167 C21 | GND_166 A21 | GND_165 K22 | GND_164 H22 | GND_163 F22 | GND_162 D22 | GND_161 B22 | GND_160 K23 | GND_159 H23 | GND_158 F23 | GND_157 D23 | GND_156 B23 | GND_155 L24 | GND_154 J24 | GND_153 G24 | GND_152 E24 | GND_151 C24 | GND_150 A24 | GND_149 L25 | GND_148 J25 | GND_147 G25 | GND_146 E25 | GND_145 C25 | GND_144 A25 | GND_143 K26 | GND_142 H26 | GND_141 F26 | GND_140 D26 | GND_139 B26 | GND_138 K27 | GND_137 H27 | GND_136 F27 | GND_135 D27 | GND_134 B27 | GND_133 L28 | GND_132 J28 | GND_131 G28 | GND_130 E28 | GND_129 C28 | GND_128 A28 | GND_127 L29 | GND_126 J29 | GND_125 G29 | GND_124 E29 | GND_123 C29 | GND_122 A29 | GND_121 K30 | GND_120 H30 | GND_119 F30 | GND_118 D30 | GND_117 B30 | GND_116 K31 | GND_115 H31 | GND_114 F31 | GND_113 D31 | GND_112 B31 | GND_111 L32 | GND_110 J32 | GND_109 G32 | GND_108 E32 | GND_107 C32 | GND_106 A32 | GND_105 L33 | GND_104 J33 | GND_103 G33 | GND_102 E33 | GND_101 C33 | GND_100 A33 | GND_099 K34 | GND_098 H34 | GND_097 F34 | GND_096 D34 | GND_095 B34 | GND_094 K35 | GND_093 H35 | GND_092 F35 | GND_091 D35 | GND_090 B35 | GND_089 L36 | GND_088 J36 | GND_087 G36 | GND_086 E36 | GND_085 C36 | GND_084 A36 | GND_083 L37 | GND_082 J37 | GND_081 G37 | GND_080 E37 | GND_079 C37 | GND_078 A37 | GND_077 K38 | GND_076 H38 | GND_075 F38 | GND_074 D38 | GND_073 B38 | GND_072 K39 | GND_071 H39 | GND_070 F39 | GND_069 D39 | GND_068 B39 | GND_067 L40 | GND_066
B40 | FSI_GPIO02 D40 | FSI_GPIO01 F40 | FSI_GPIO00 H40 | MID1 K40 | MID0 J1 | SYS_VIN_HV_39 H1 | SYS_VIN_HV_38 G1 | SYS_VIN_HV_37 F1 | SYS_VIN_HV_36 E1 | SYS_VIN_HV_35 D1 | SYS_VIN_HV_34 C1 | SYS_VIN_HV_33 J2 | SYS_VIN_HV_32 H2 | SYS_VIN_HV_31 G2 | SYS_VIN_HV_30 F2 | SYS_VIN_HV_29 E2 | SYS_VIN_HV_28 D2 | SYS_VIN_HV_27 C2 | SYS_VIN_HV_26 K3 | SYS_VIN_HV_25 H3 | SYS_VIN_HV_24 F3 | SYS_VIN_HV_23 D3 | SYS_VIN_HV_22 B3 | SYS_VIN_HV_21 J63 | SYS_VIN_HV_20 G63 | SYS_VIN_HV_19 F63 | SYS_VIN_HV_18 E63 | SYS_VIN_HV_17 C63 | SYS_VIN_HV_16 B63 | SYS_VIN_HV_15 J64 | SYS_VIN_HV_14 H64 | SYS_VIN_HV_13 G64 | SYS_VIN_HV_12 F64 | SYS_VIN_HV_11 E64 | SYS_VIN_HV_10 D64 | SYS_VIN_HV_09 C64 | SYS_VIN_HV_08 J65 | SYS_VIN_HV_07 H65 | SYS_VIN_HV_06 G65 | SYS_VIN_HV_05 F65 | SYS_VIN_HV_04 E65 | SYS_VIN_HV_03 D65 | SYS_VIN_HV_02 C65 | SYS_VIN_HV_01 L22 | SYS_VIN_MV_10 L23 | SYS_VIN_MV_09 L26 | SYS_VIN_MV_08 L27 | SYS_VIN_MV_07 L30 | SYS_VIN_MV_06 L31 | SYS_VIN_MV_05 L34 | SYS_VIN_MV_04 L35 | SYS_VIN_MV_03 L38 | SYS_VIN_MV_02 L39 | SYS_VIN_MV_01

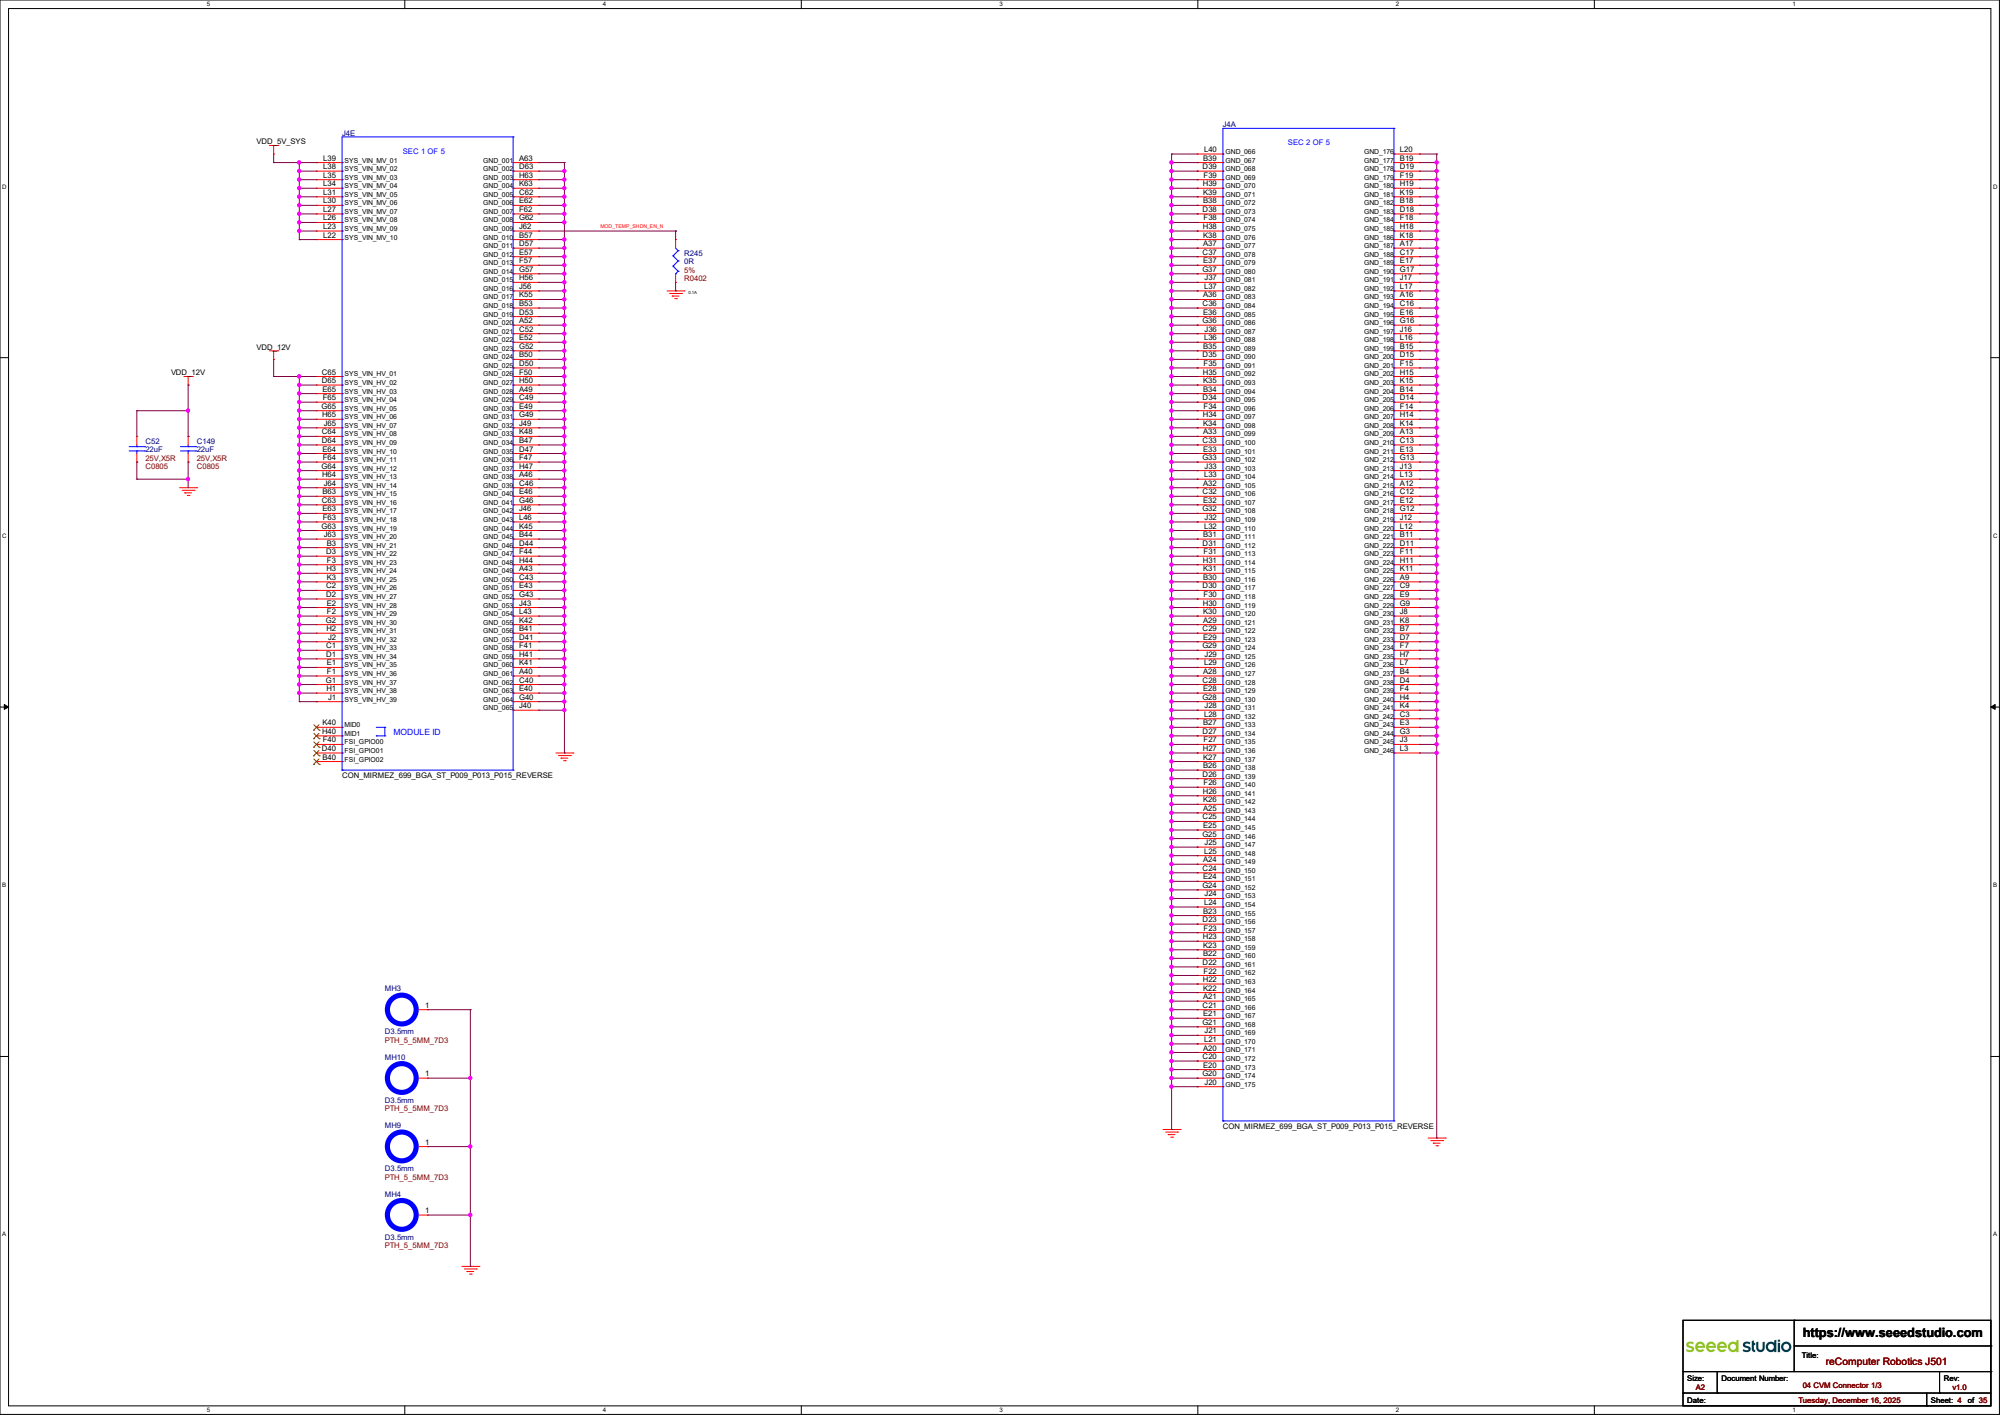
[picture p211: page 4]

reComputer Robotics J501 04 CVM Connector 1/3

E54 | FAN_TACH B55 | GPIO30 B54 | WDT_RESET_OUT_N K57 | PWM01 A55 | GPIO34 C54 | GPIO33 J55 | GPIO32 H54 | UART1_CTS L51 | UART1_RTS K54 | UART1_RX K53 | UART1_TX K56 | GPIO19 C55 | GPIO18 A54 | GPIO17 F53 | I2C3_CLK E53 | I2C3_DAT L57 | MCLK05 H55 | MCLK04 H53 | MCLK03 J54 | MCLK02 L8 | I2C1_DAT K5 | I2C1_CLK E4 | I2S2_FS F6 | I2S2_DIN F5 | I2S2_DOUT G4 | I2S2_CLK L50 | GPIO35 L9 | GPIO28 L48 | UART4_RX L49 | UART4_CTS L4 | UART4_RTS L5 | UART4_TX L6 | GPIO02 J4 | GPIO01 L11 | SLEEP_REQ_N L10 | FORCE_RECOVERY_N J5 | ENET_INT H5 | ENET_RST_N E6 | RGMII_SMA_MDC E7 | RGMII_SMA_MDIO D5 | RGMII_RX_CTL E5 | RGMII_RD3 H6 | RGMII_RD2 K6 | RGMII_RD1 C4 | RGMII_RD0 C5 | RGMII_RXC K7 | RGMII_TX_CTL G6 | RGMII_TD3 J7 | RGMII_TD2 G5 | RGMII_TD1 J6 | RGMII_TD0 B5 | RGMII_TXC D6 | SDCARD_D3 A4 | SDCARD_D2 F8 | SDCARD_D1 E8 | SDCARD_D0 A5 | SDCARD_CMD B6 | SDCARD_CLK A7 | GPIO29 F9 | GPIO16 F10 | GPIO15 L15 | GPIO14 G7 | GPIO13 E10 | GPIO12 B8 | GPIO11 H9 | MCLK01 D8 | I2S1_FS H8 | I2S1_SDIN C7 | I2S1_SDOUT L14 | I2S1_CLK

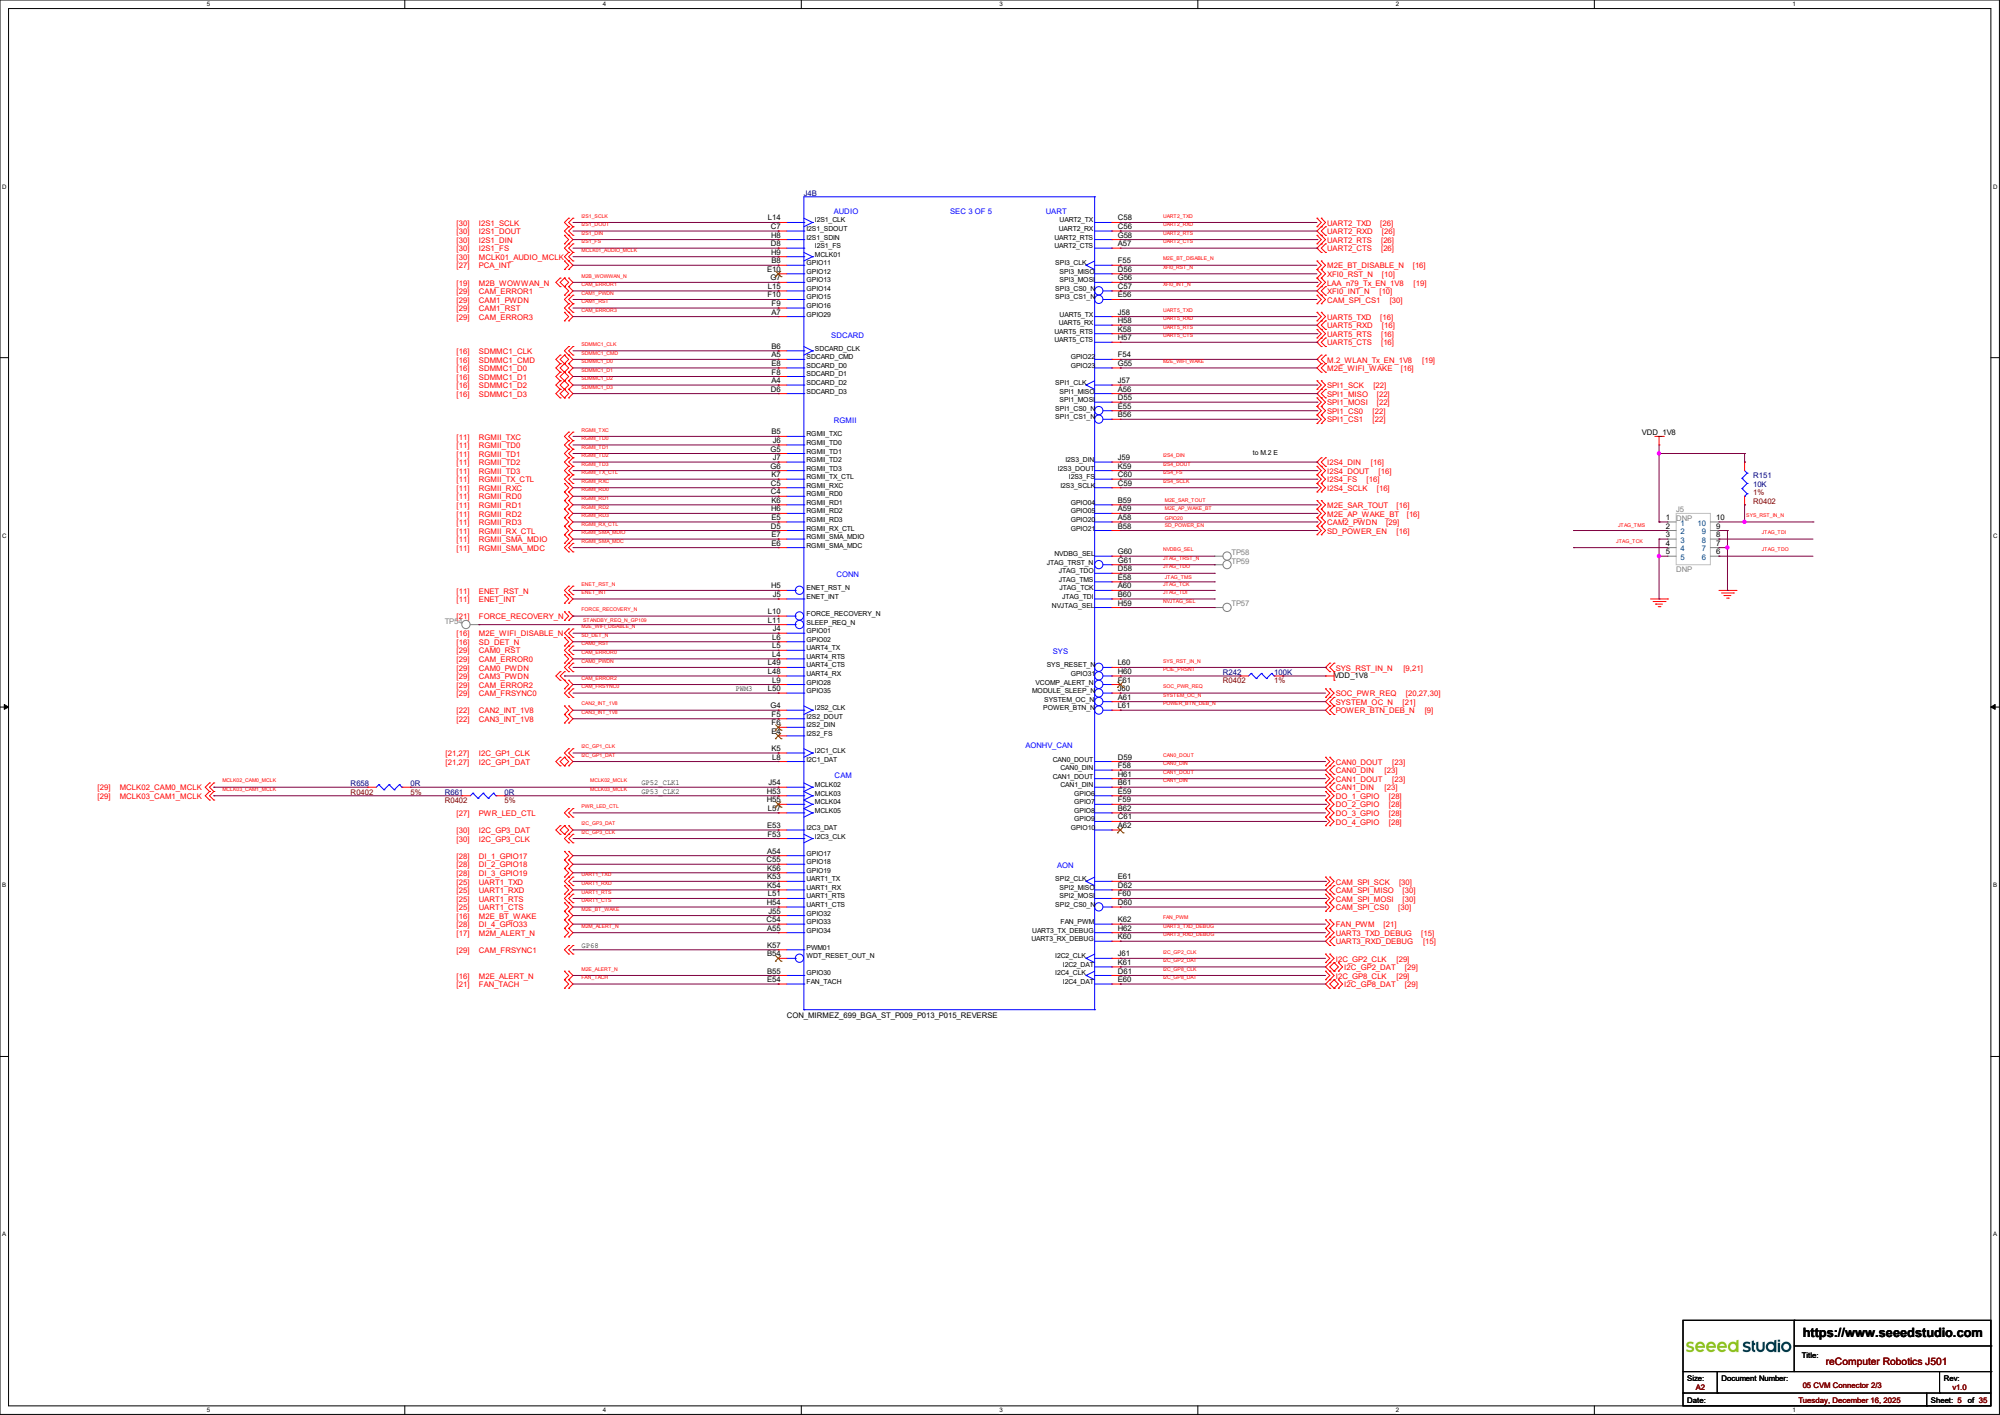
[picture p212: page 5]

reComputer Robotics J501 05 CVM Connector 2/3

# CSI_0_CLK_N [29] CSI_4_D0_N [29] CSI_4_CLK_P [29] CSI_7_CLK_N [29]

# CSI_3_D1_P [29] CSI_5_CLK_P [29] CSI_2_D0_N [29] CSI_3_D1_N [29] CSI_7_D1_N [29]

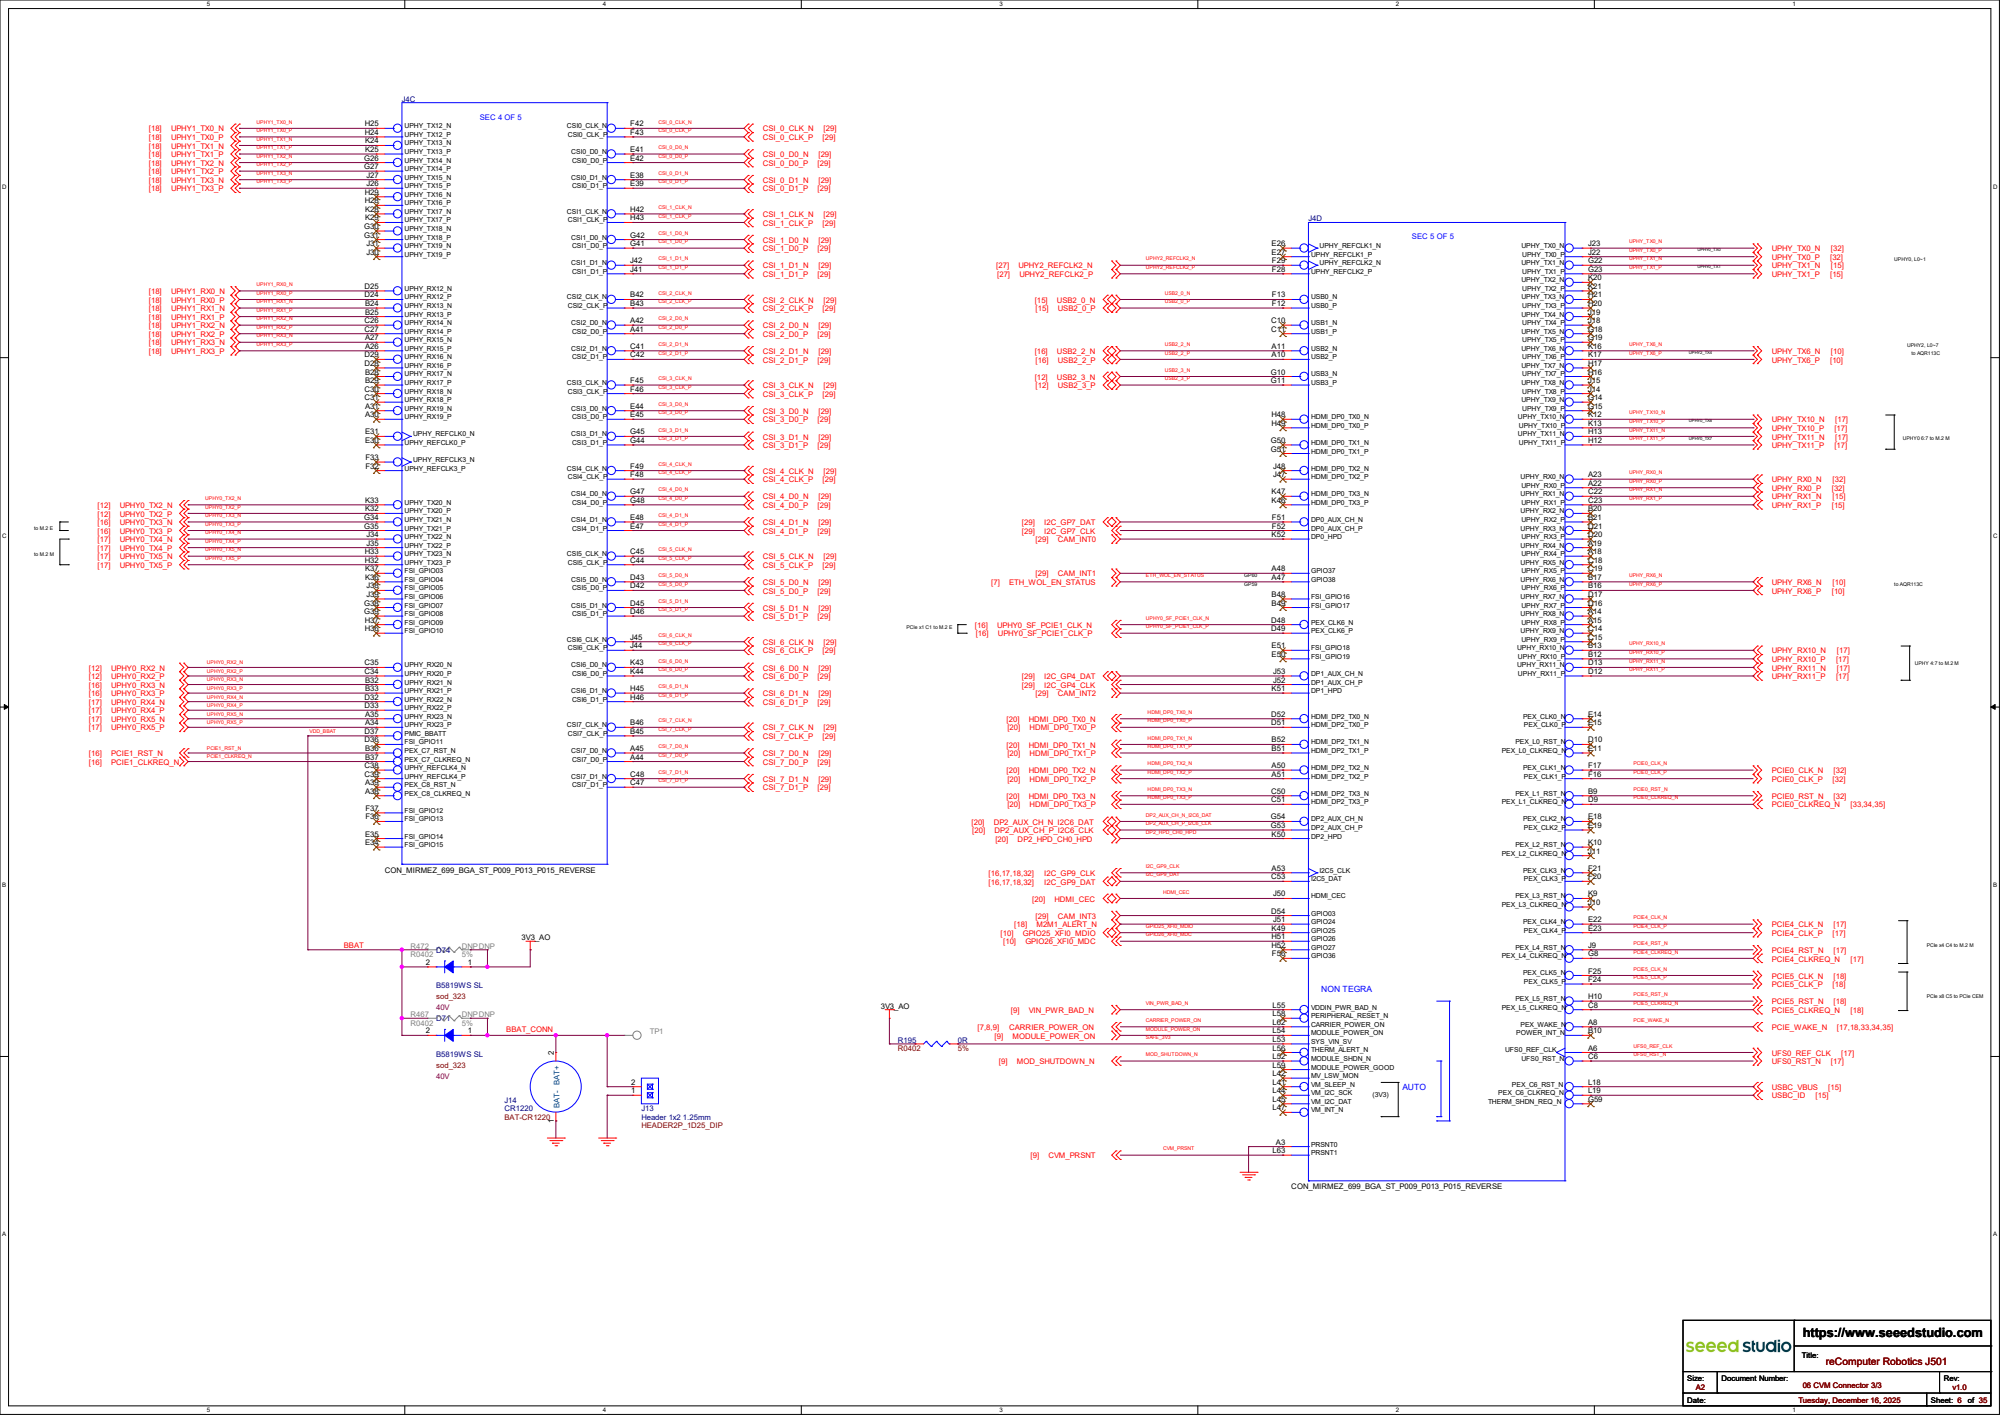
[picture p213: page 6]

PCIe x8 C5 to PCIe CEM

reComputer Robotics J501 06 CVM Connector 3/3

# 3V3_AO

# Vin protection

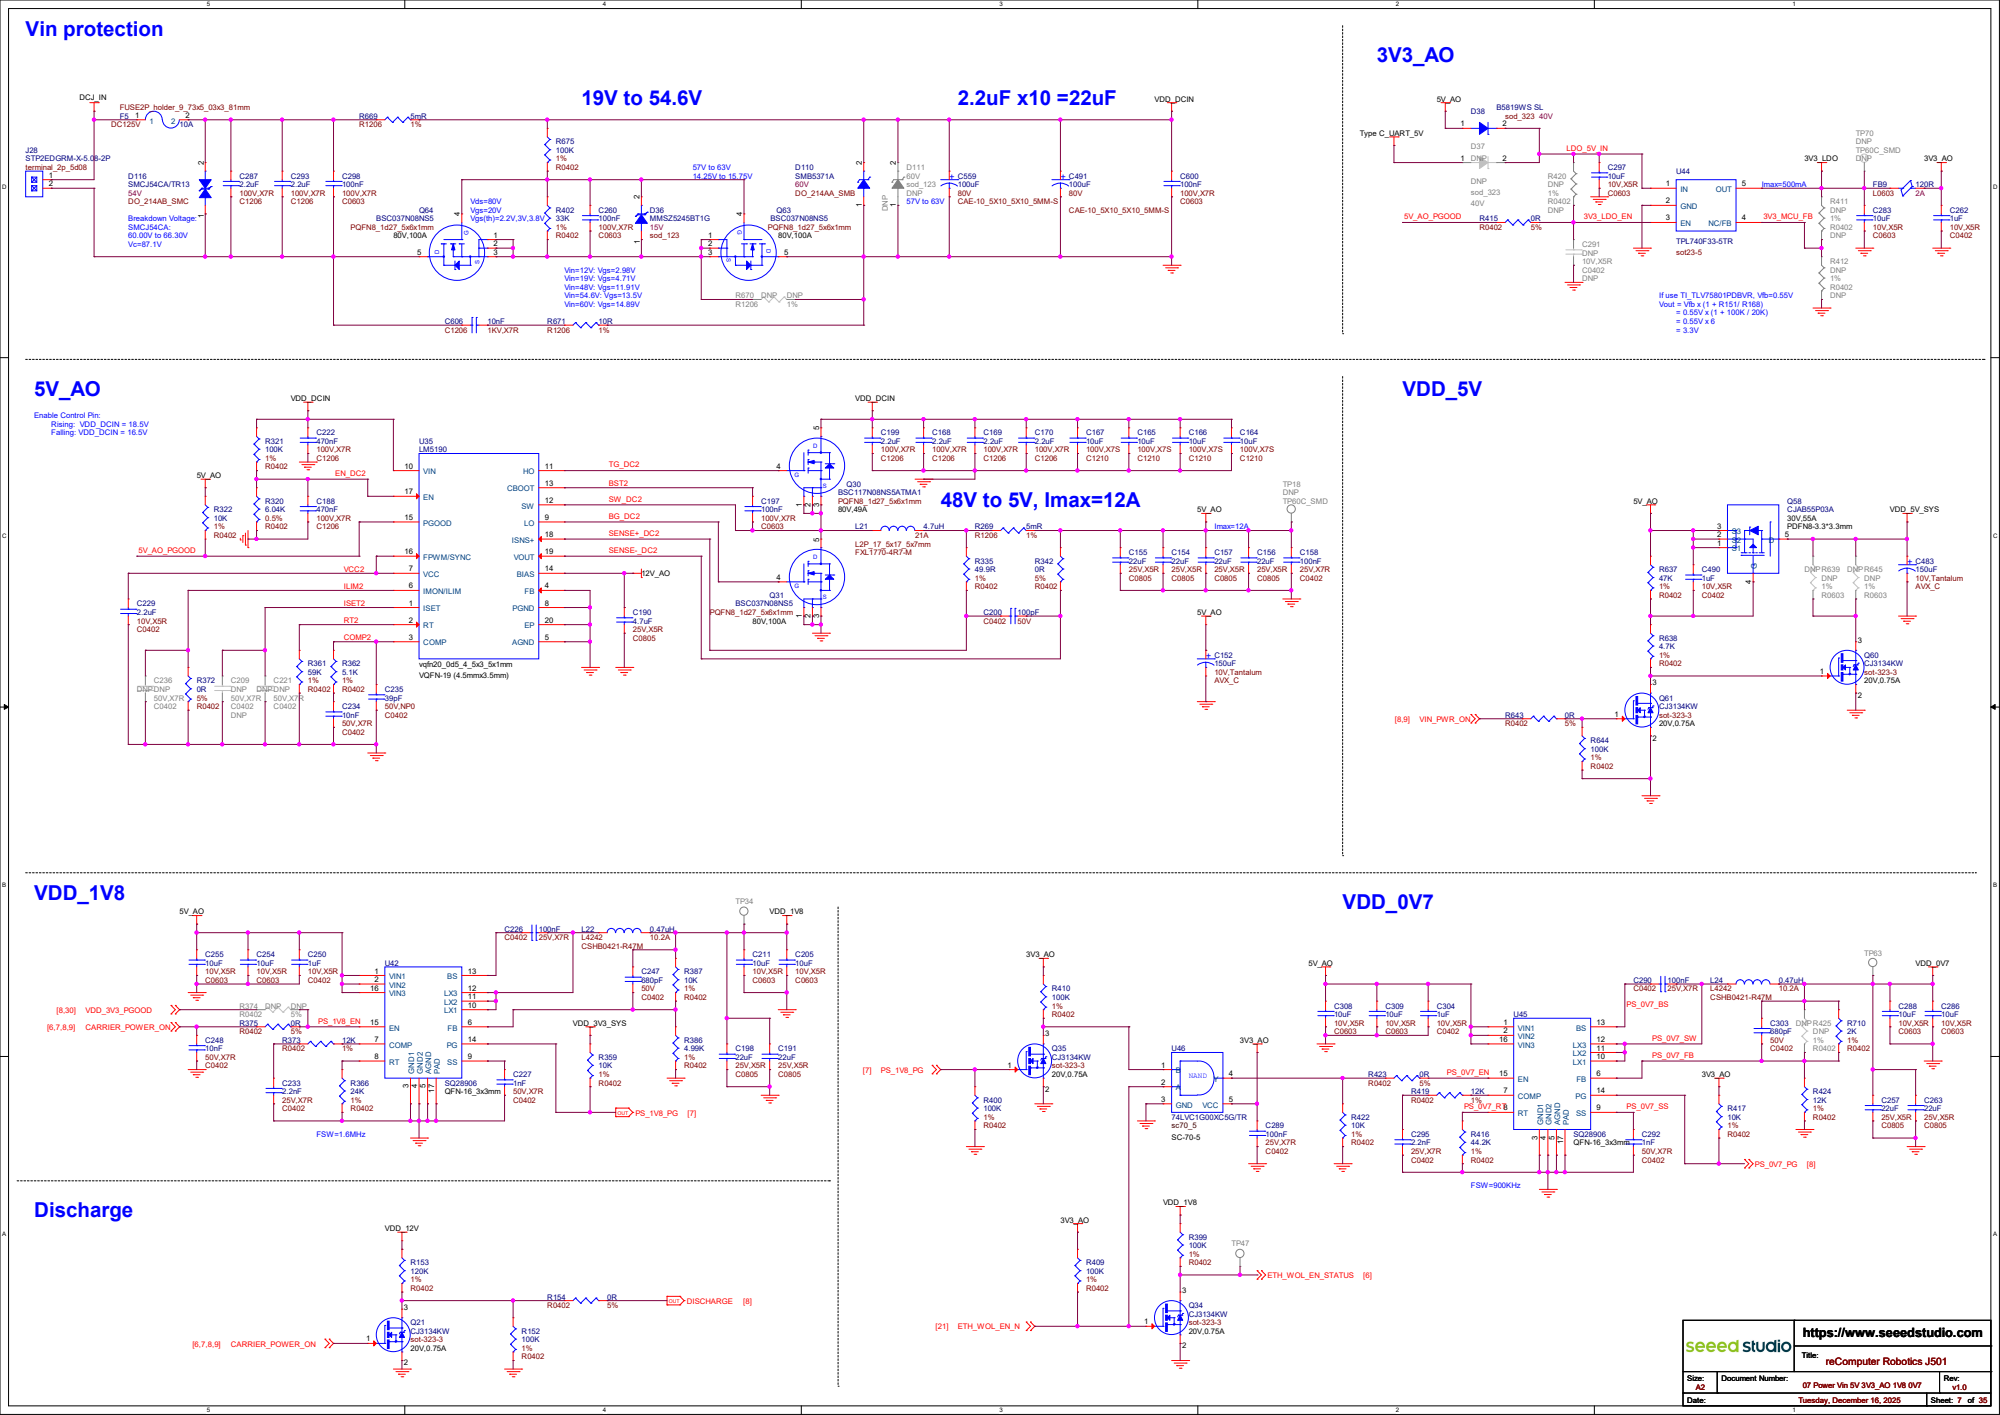
[picture p214: page 7]

Enable Control Pin: Rising: VDD_DCIN = 18.5V

reComputer Robotics J501 07 Power Vin 5V 3V3_AO 1V8 0V7

# VDD_12V Discharge

# VDD_3V3 Supervisor

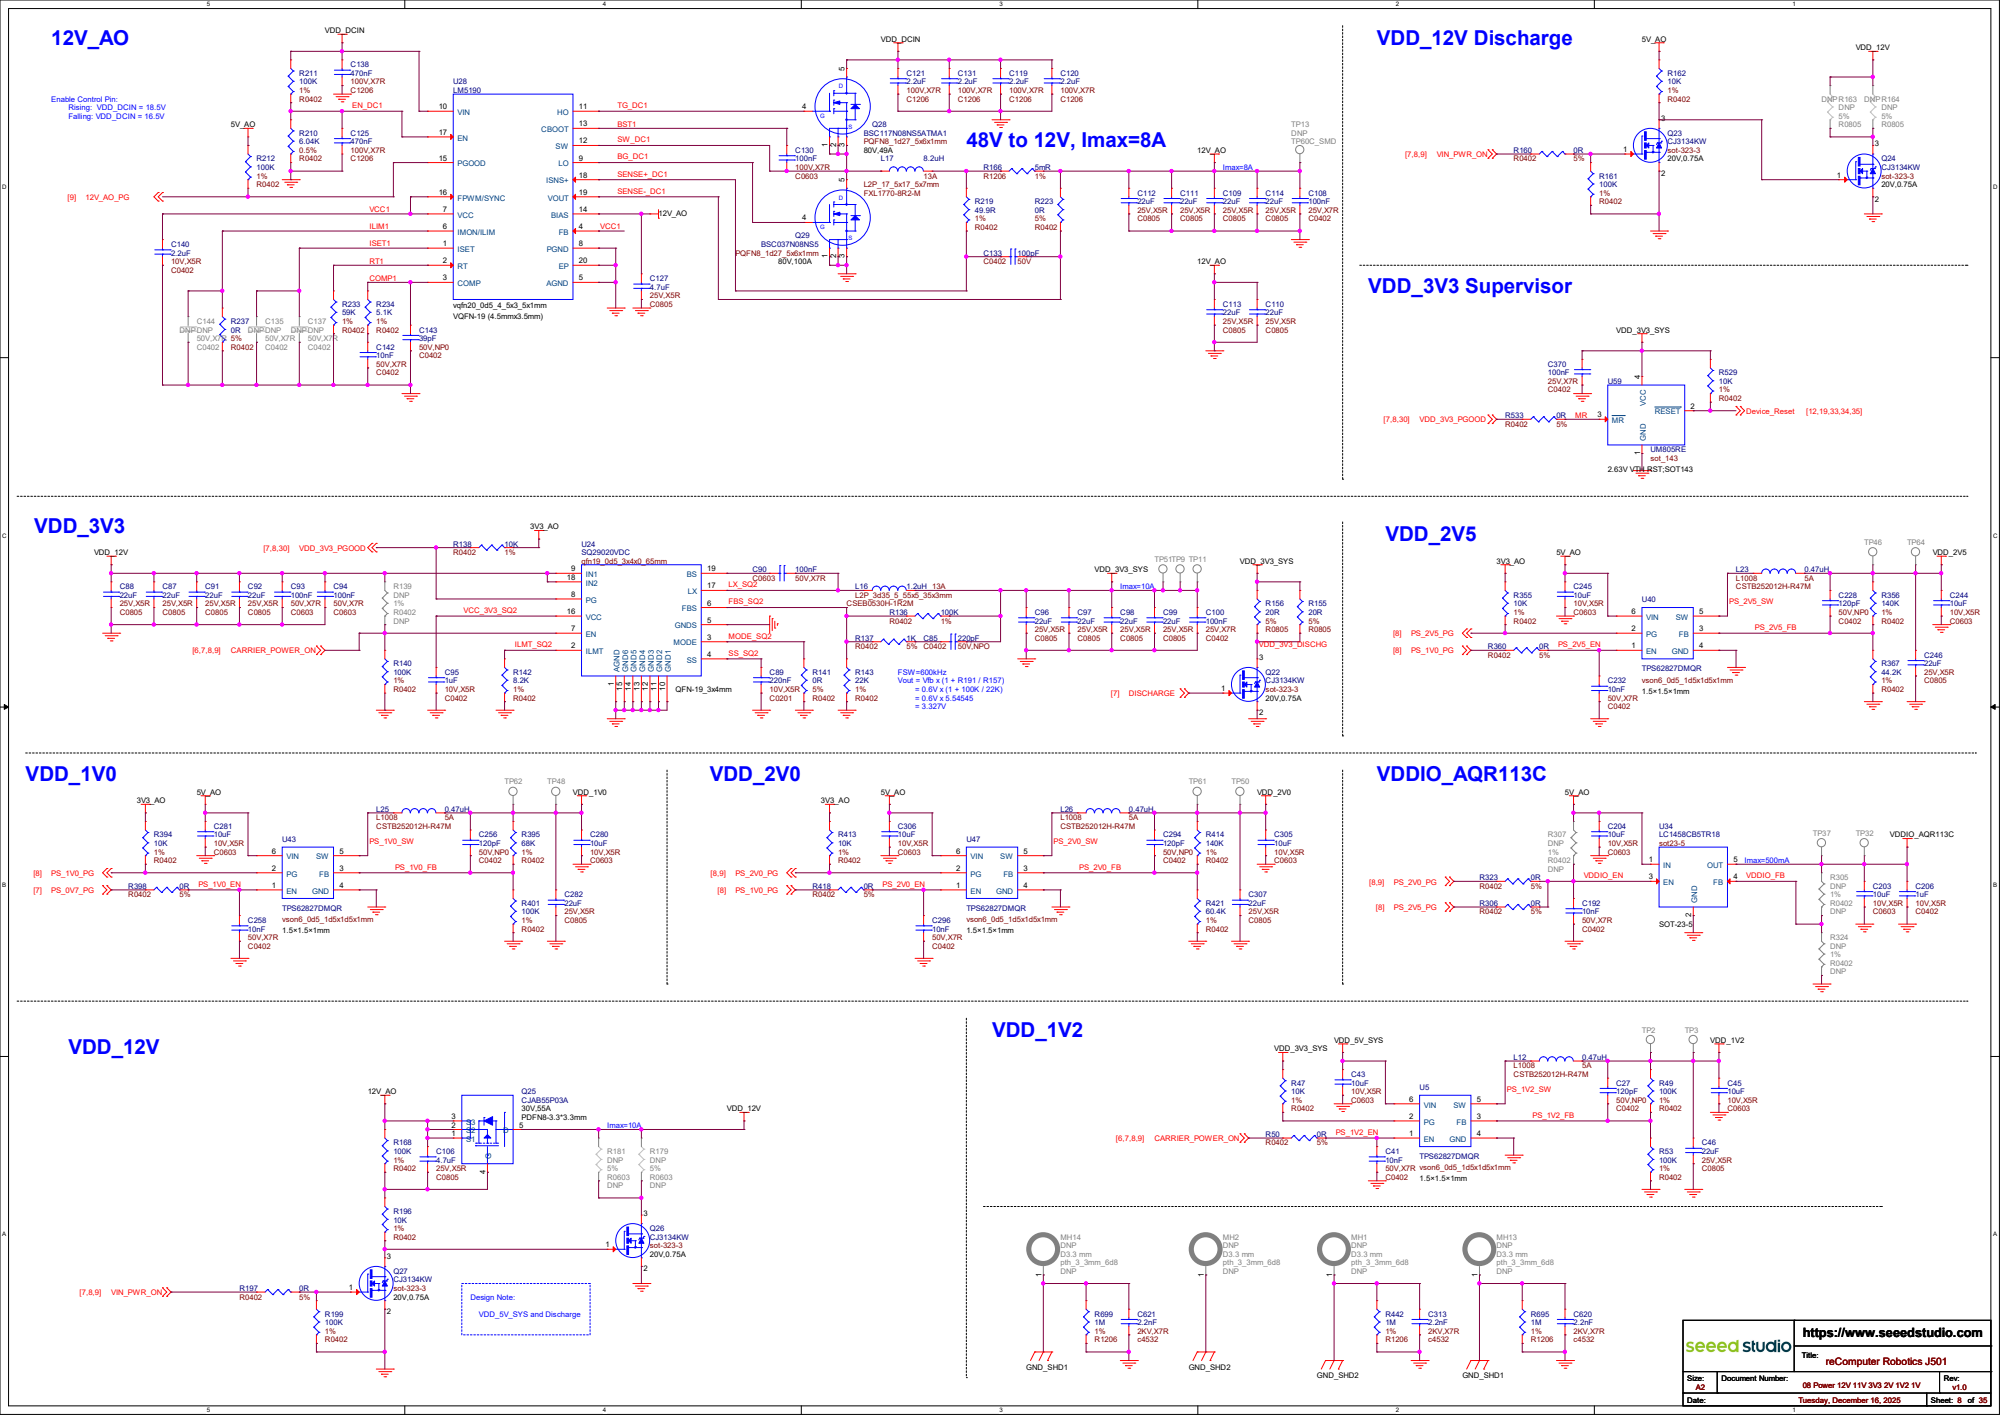
[picture p215: page 8]

# Debug - C2

# Button MCU For Power Up

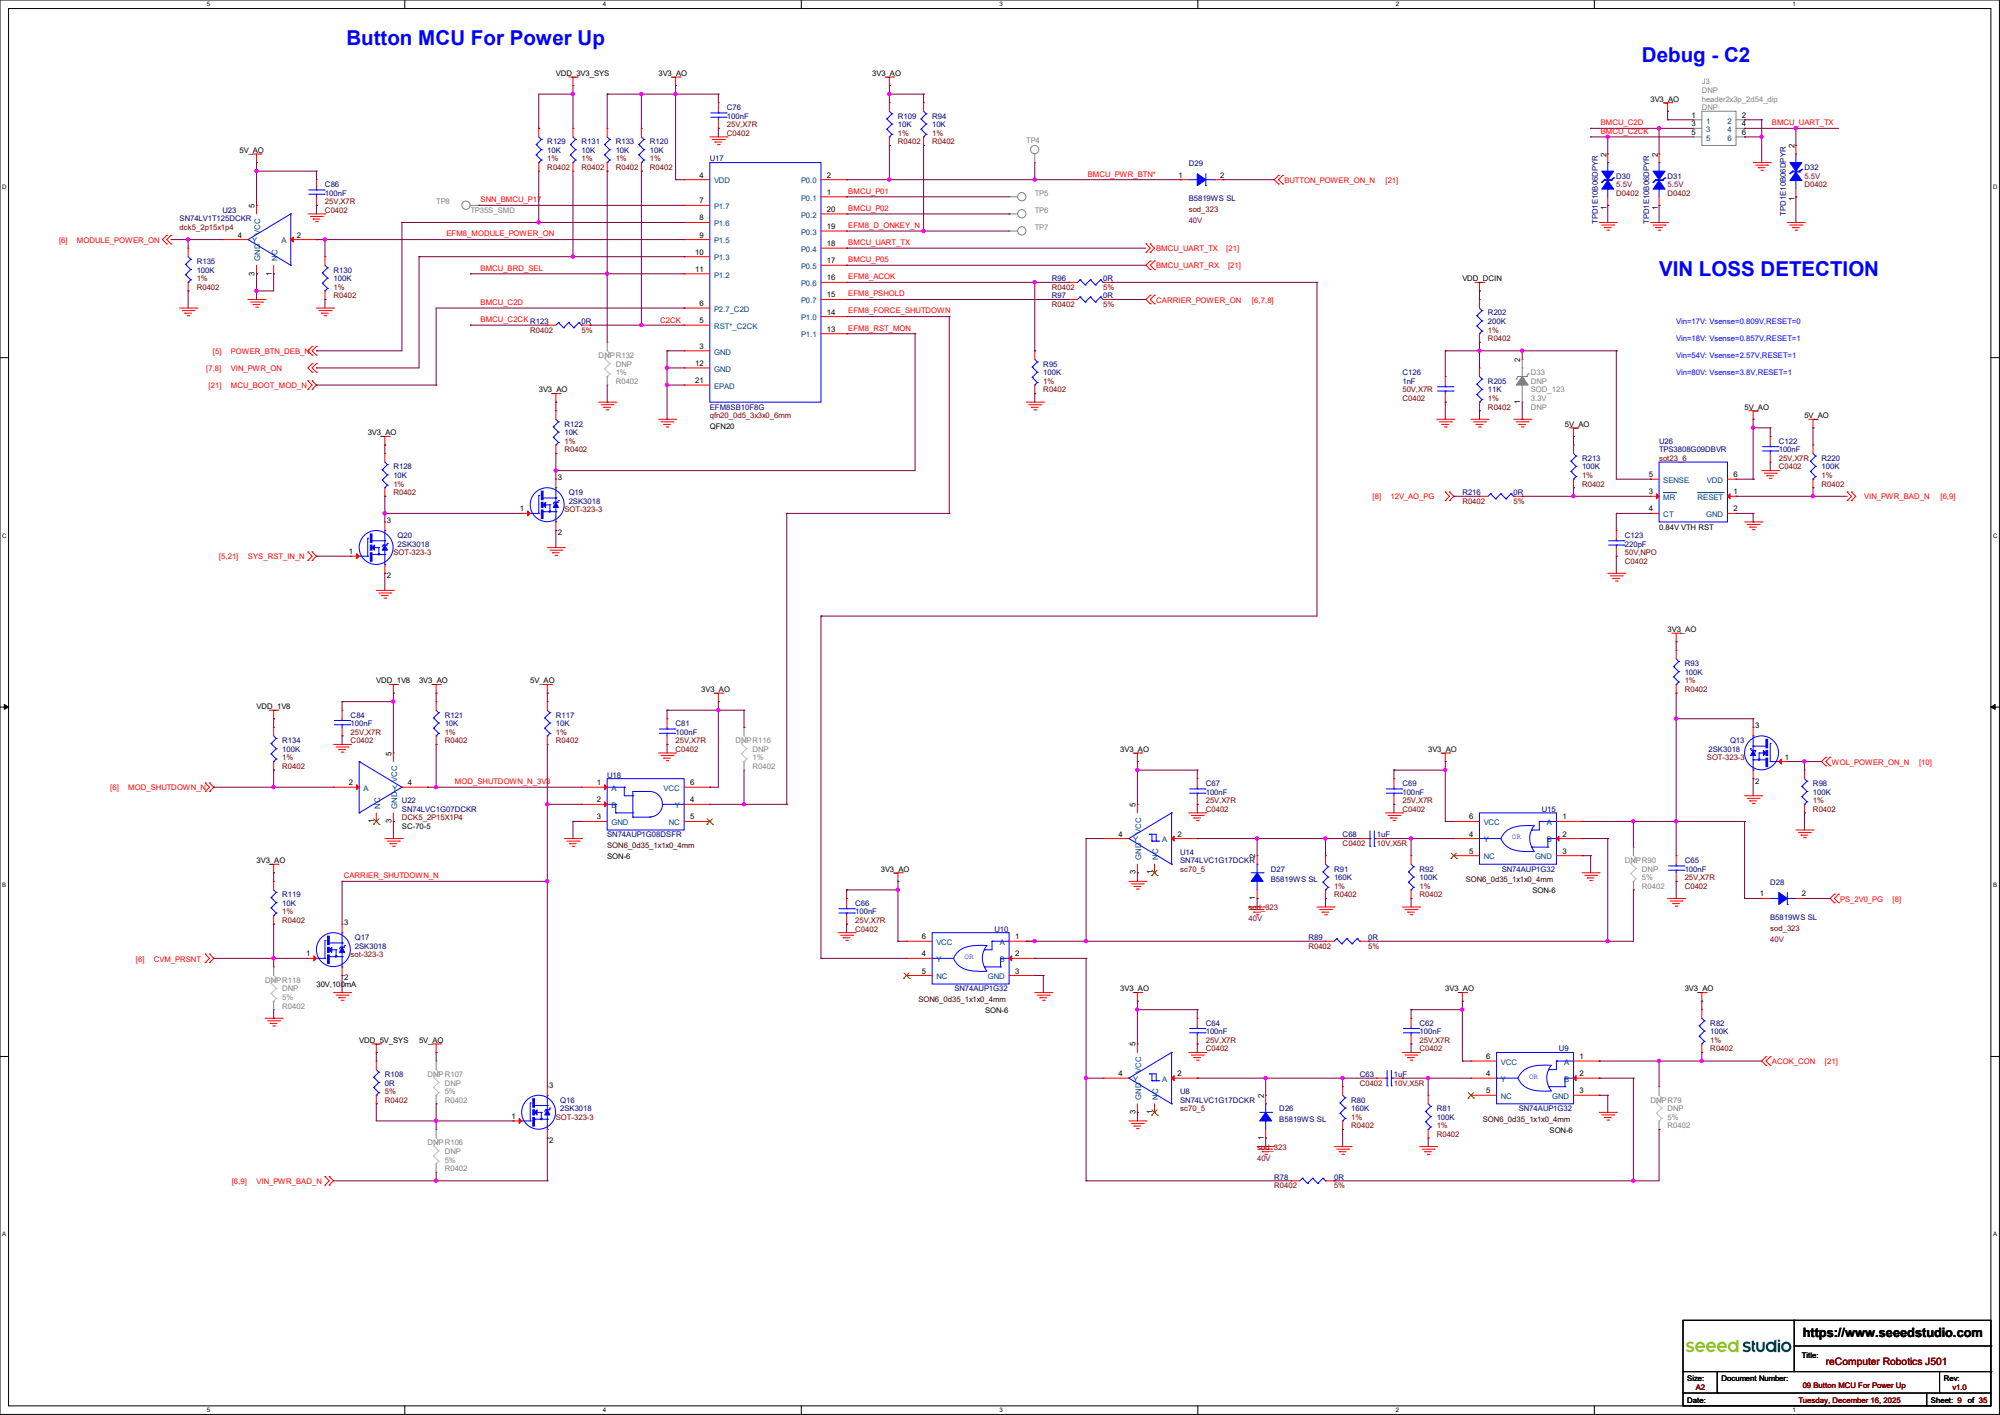
[picture p216: page 9]

reComputer Robotics J501 09 Button MCU For Power Up

# 10GB ETHERNET

# 16 TD1+

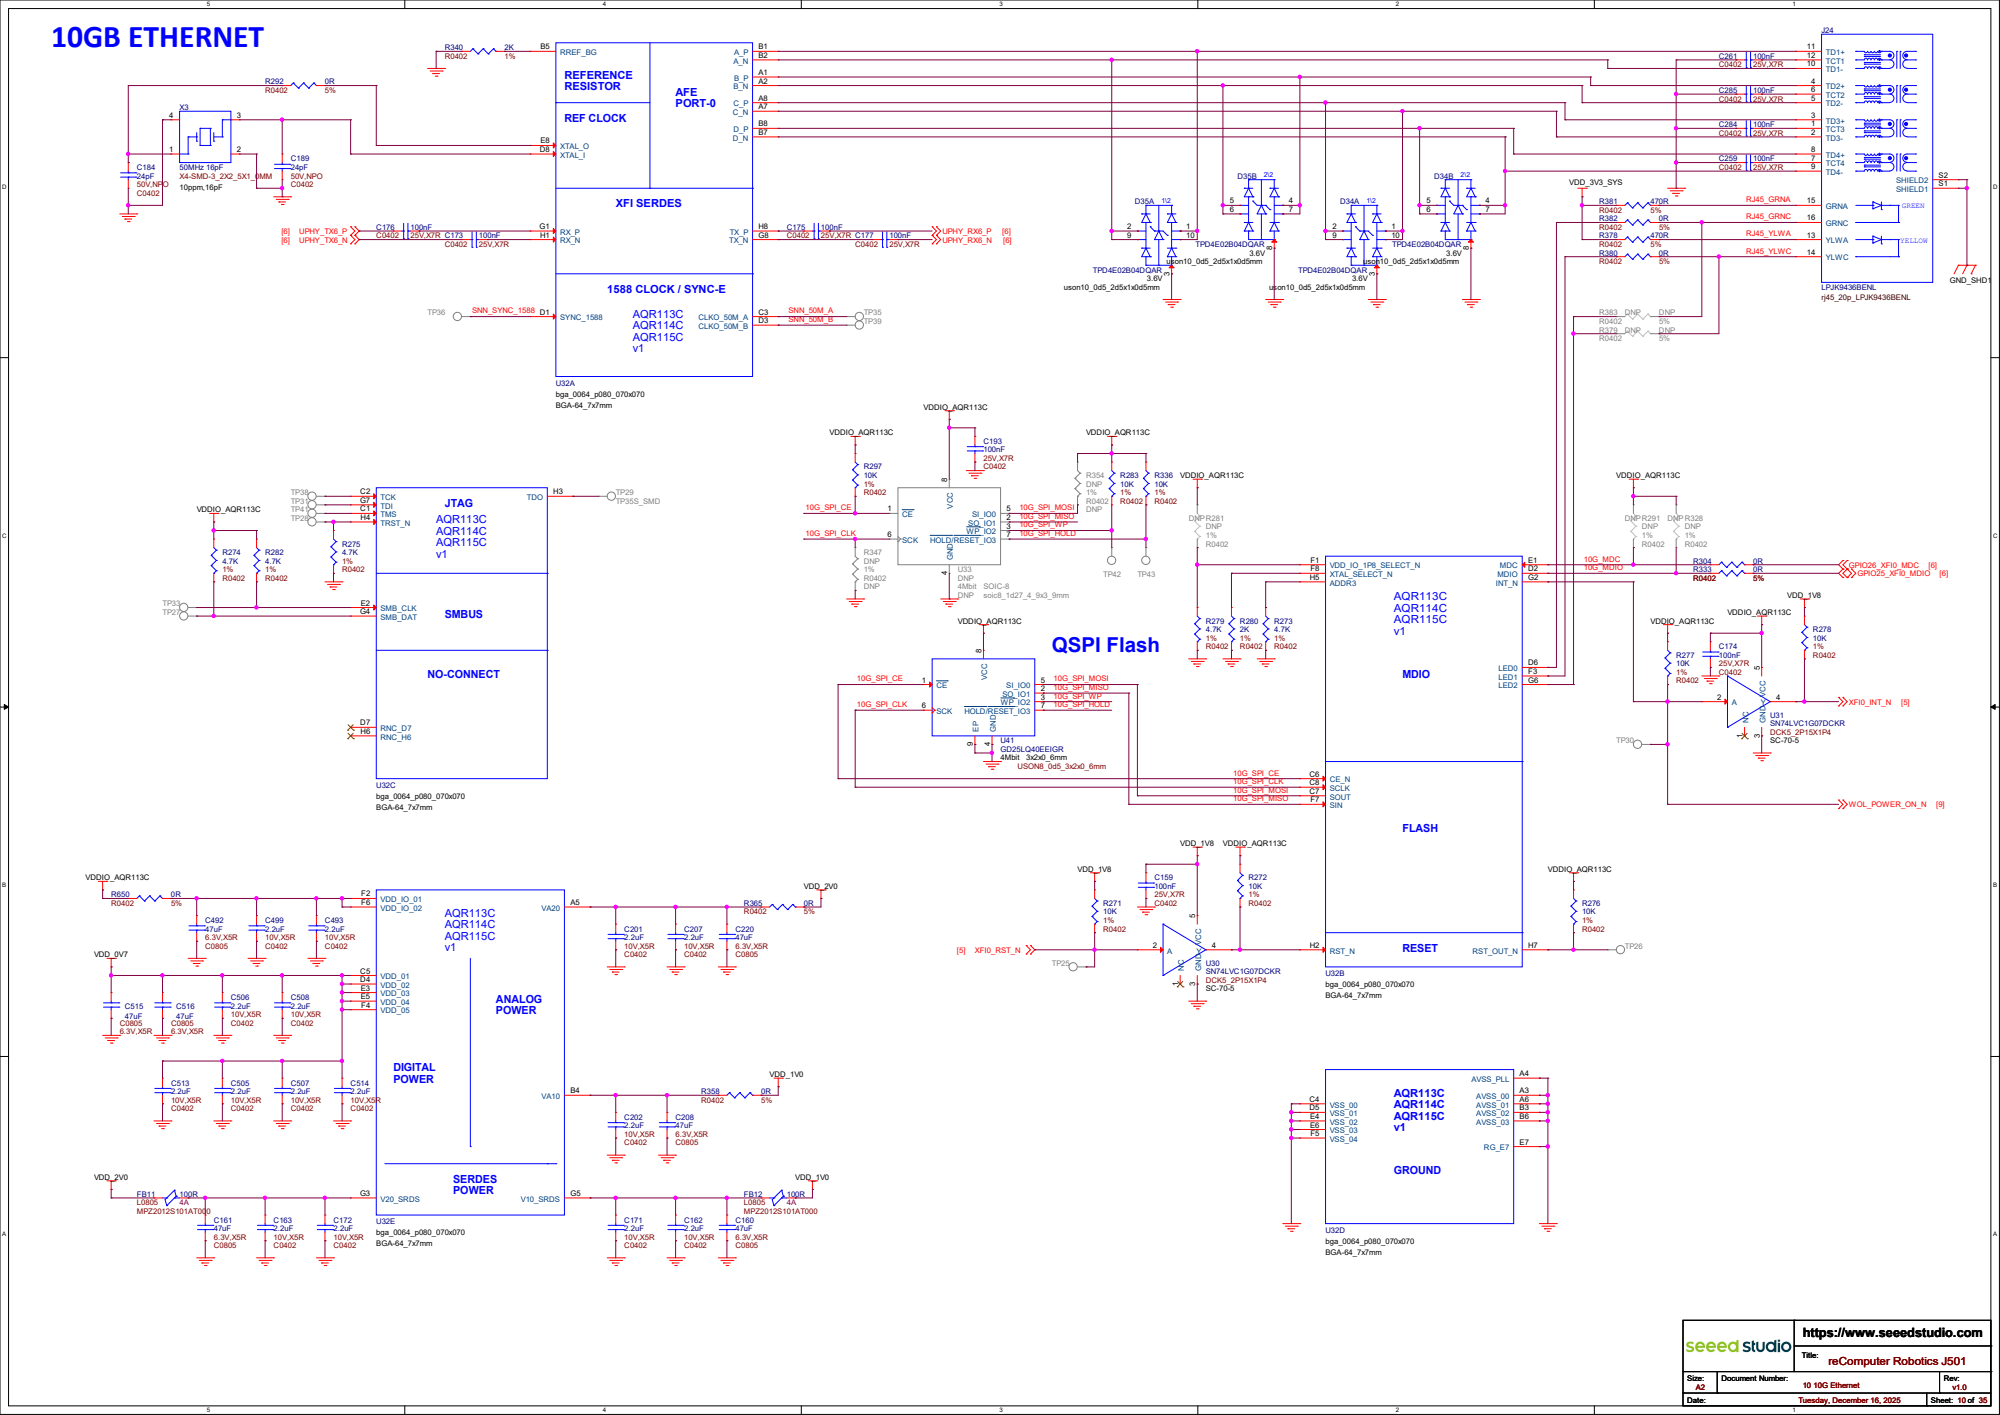
[picture p217: page 10]

# GB ETHERNET

# T1KGX2411PR

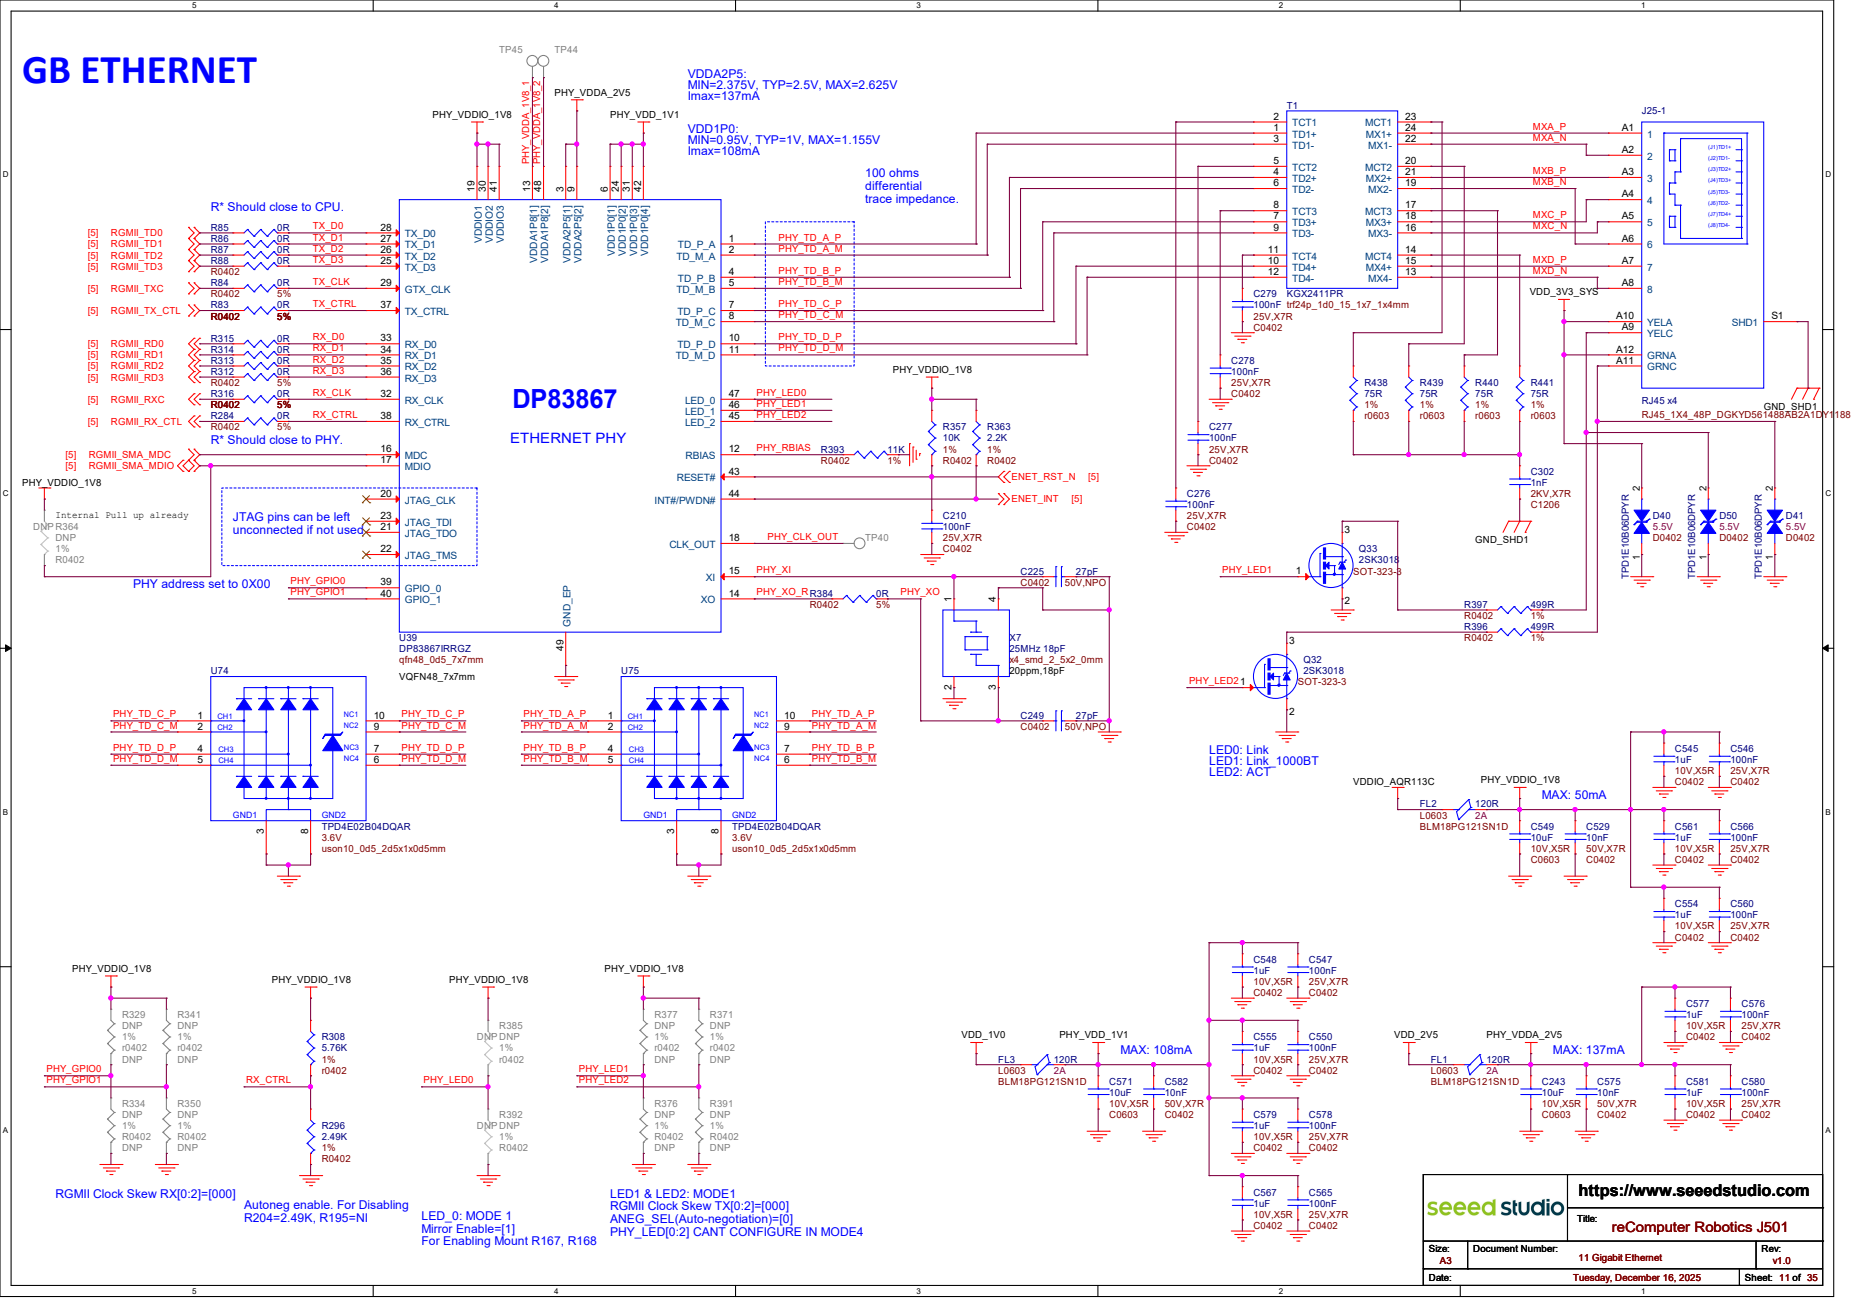
[picture p218: page 11]

R* Should close to CPU.

R* Should close to PHY.

JTAG pins can be left
unconnected if not used

PHY address set to 0X00

RGMII Clock Skew RX[0:2]=[000]

LED1 & LED2: MODE1
RGMII Clock Skew TX[0:2]=[000]
ANEG_SEL(Auto-negotiation)=[0]
PHY_LED[0:2] CANT CONFIGURE IN MODE4

Autoneg enable. For Disabling

# USB3.1 GEN1 HUB x4 PORTS

HUB_HSD2_N | [13] HUB_HSD1_P | [13] HUB_HSD1_N | [13] HUB_HSD2_P | [13] HUB_HSD4_N | [19] HUB_SSRX2_P [13] HUB_SSRX3_P [14]

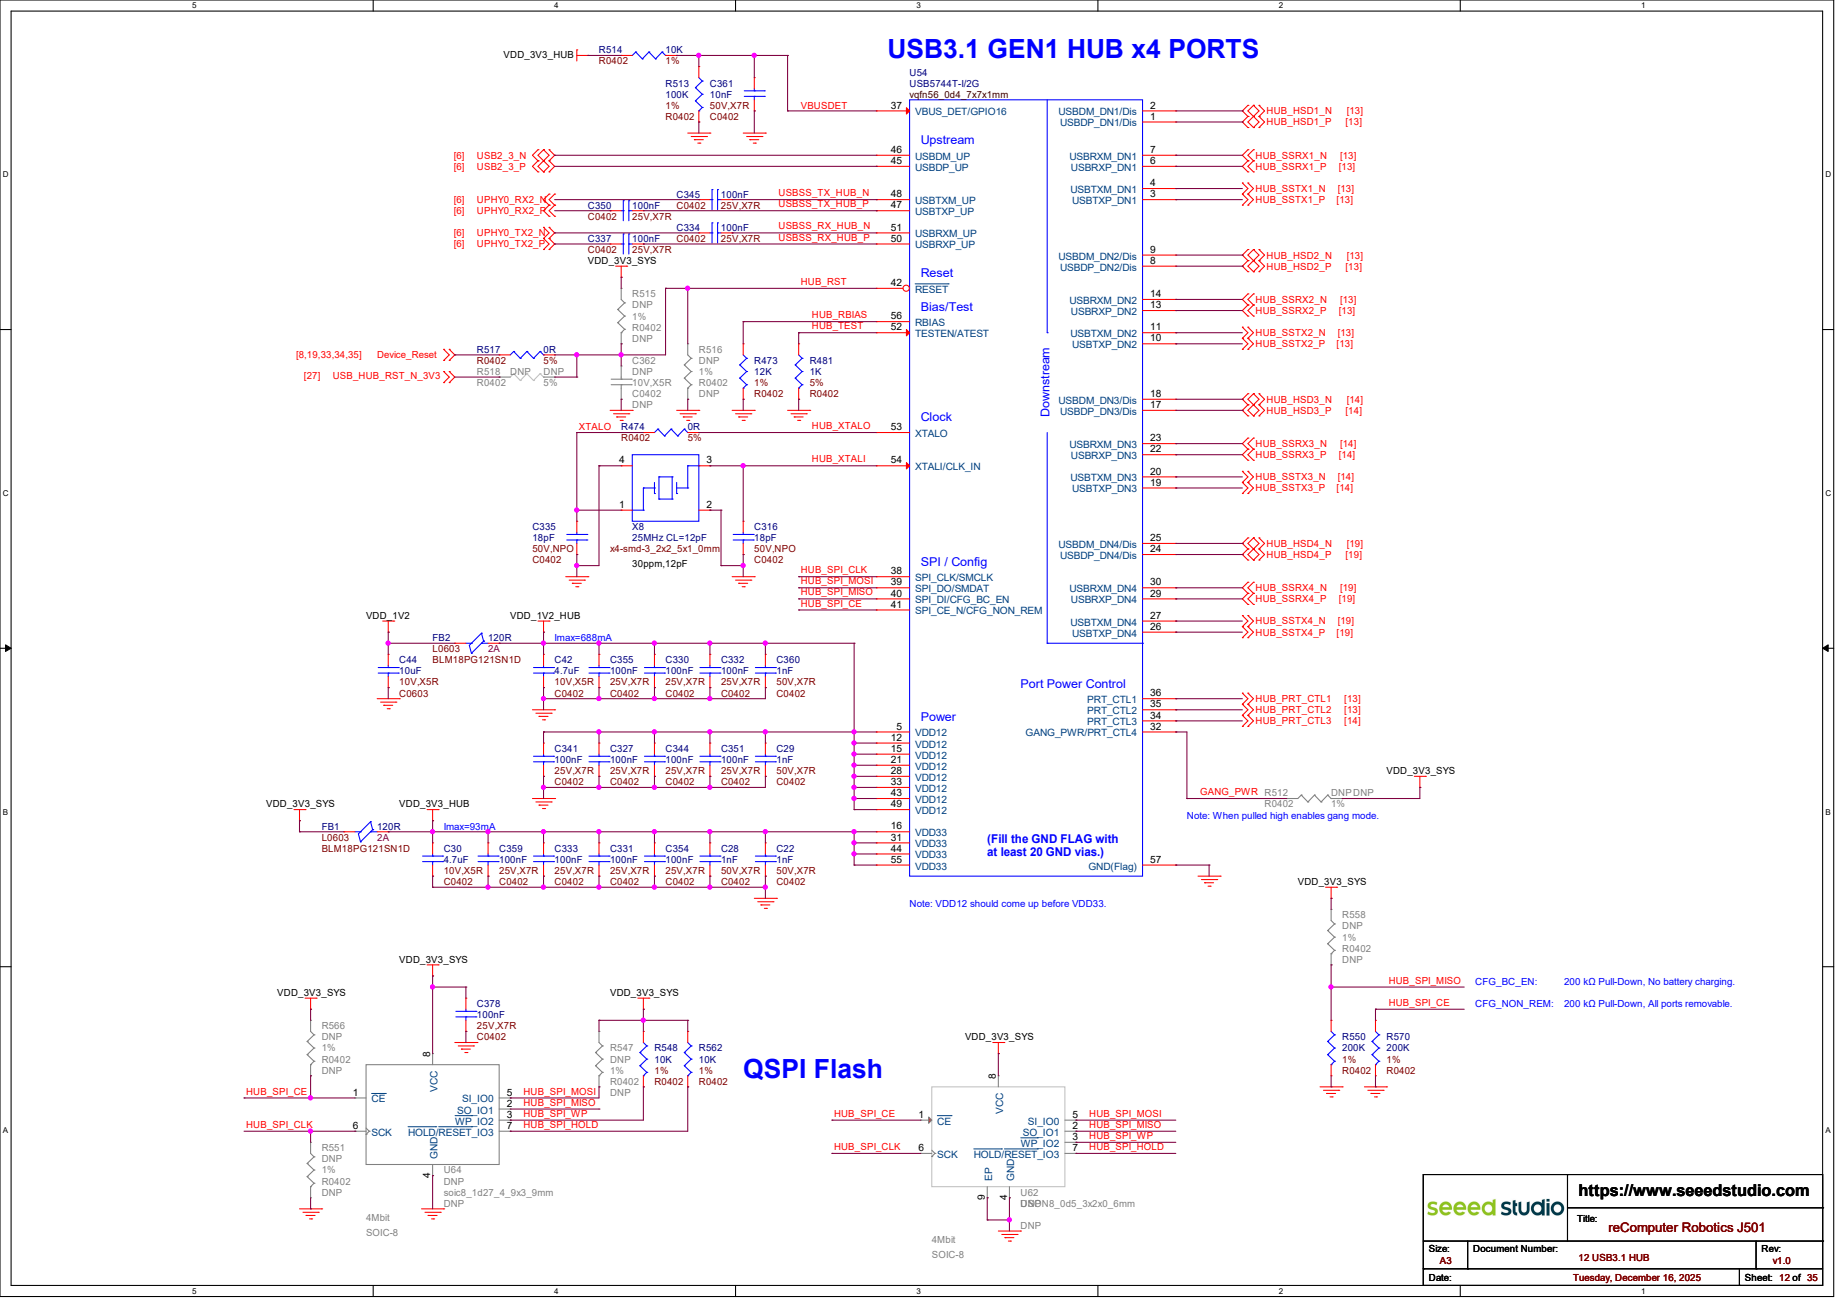
[picture p219: page 12]

RBIAS 56 XTALI/CLK_IN 54 XTALO 53 TESTEN/ATEST 52 USBRXM_UP 51 USBRXP_UP 50
USBSS_RX_HUB_P HUB_XTALO
RESET 42 SPI_CE_N/CFG_NON_REM 41 SPI_DI/CFG_BC_EN 40 SPI_DO/SMDAT 39 SPI_CLK/SMCLK 38

Port Power Control (Fill the GND FLAG with

Note: When pulled high enables gang mode.

at least 20 GND vias.)

Note: VDD12 should come up before VDD33.

200 kΩ Pull-Down, No battery charging.

# USB3.1 TYPE-A x2 (A)

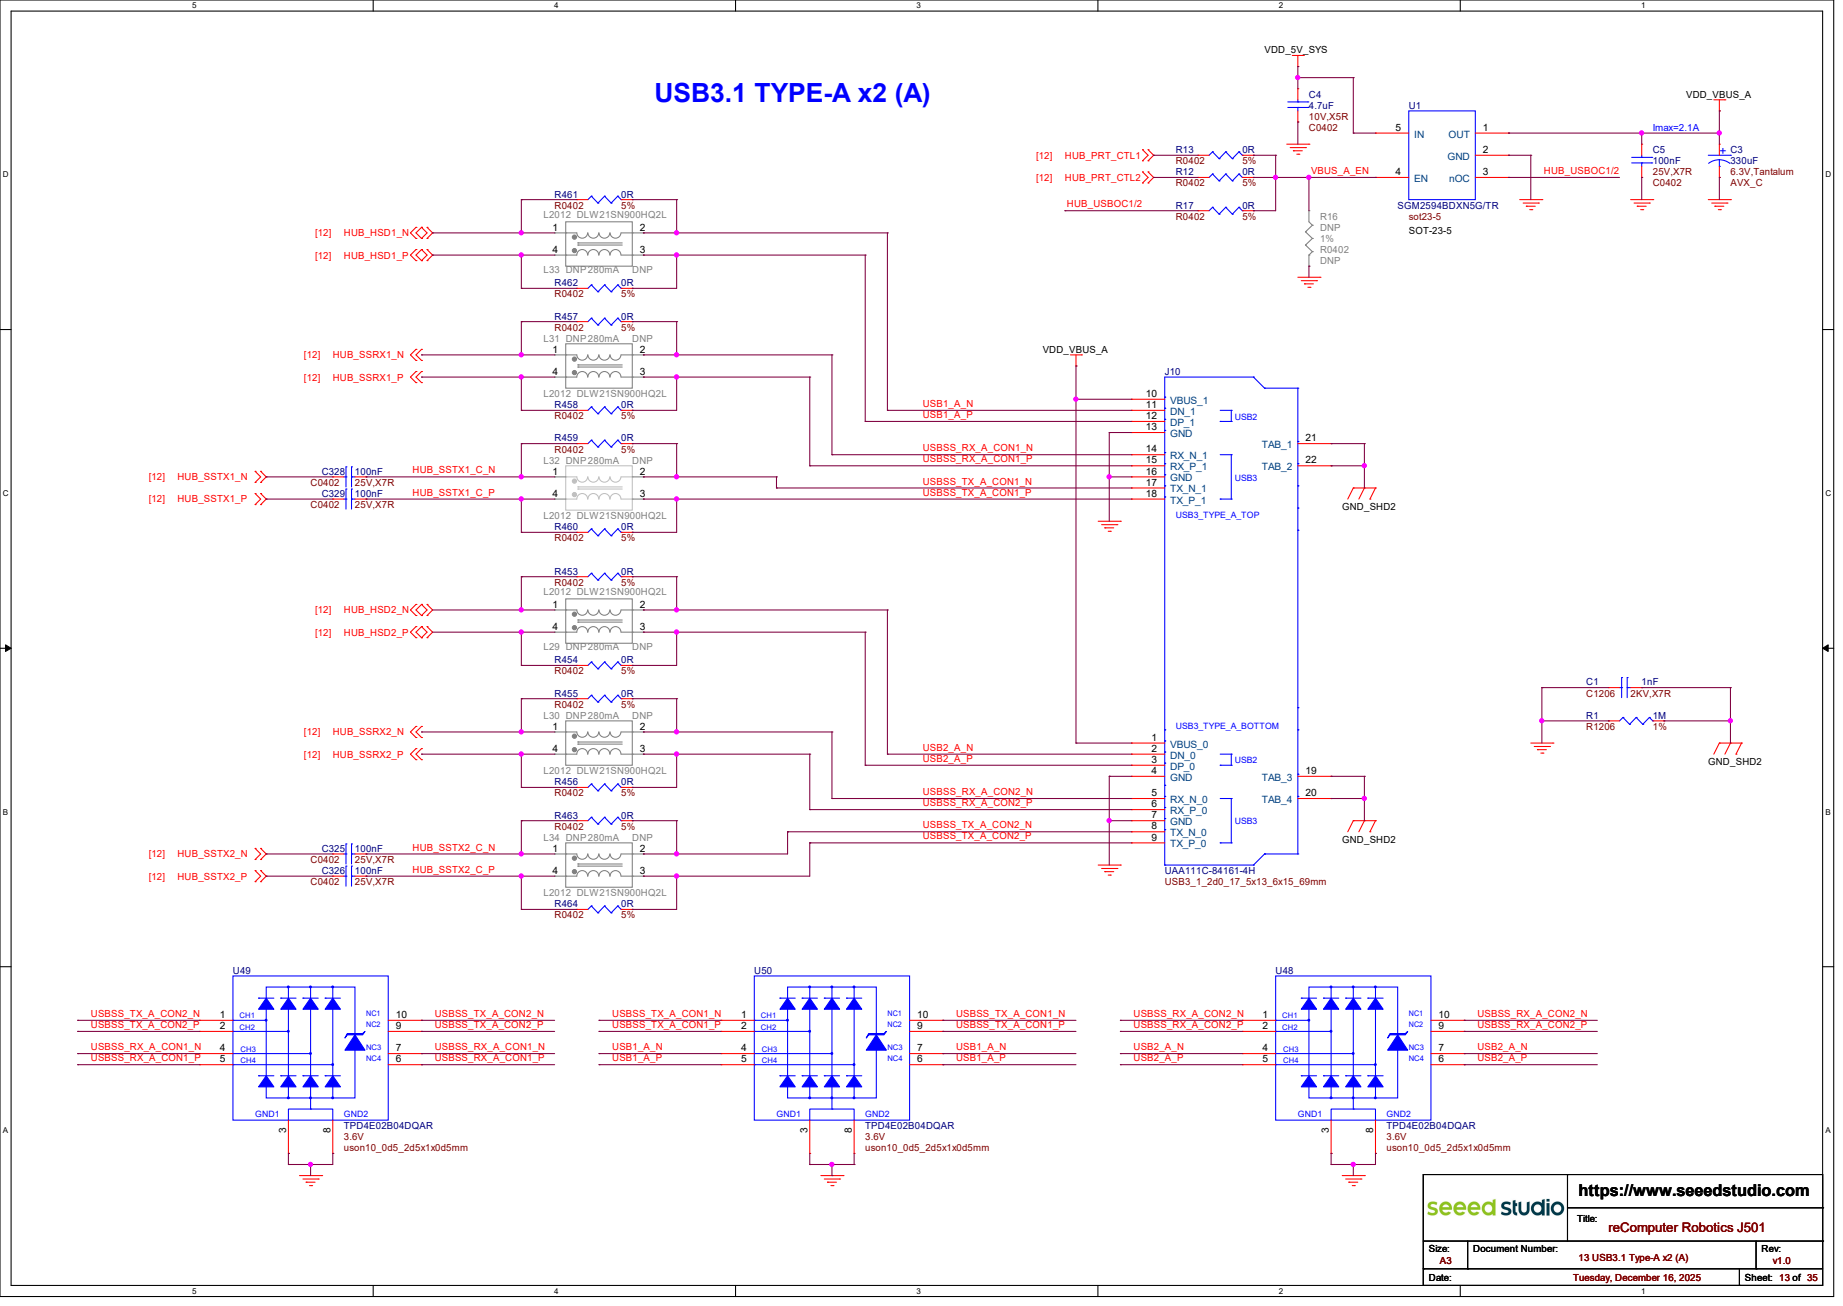
[picture p220: page 13]

# USB3.1 TYPE-A x2 (B)

4 | 3 R445 | 0R

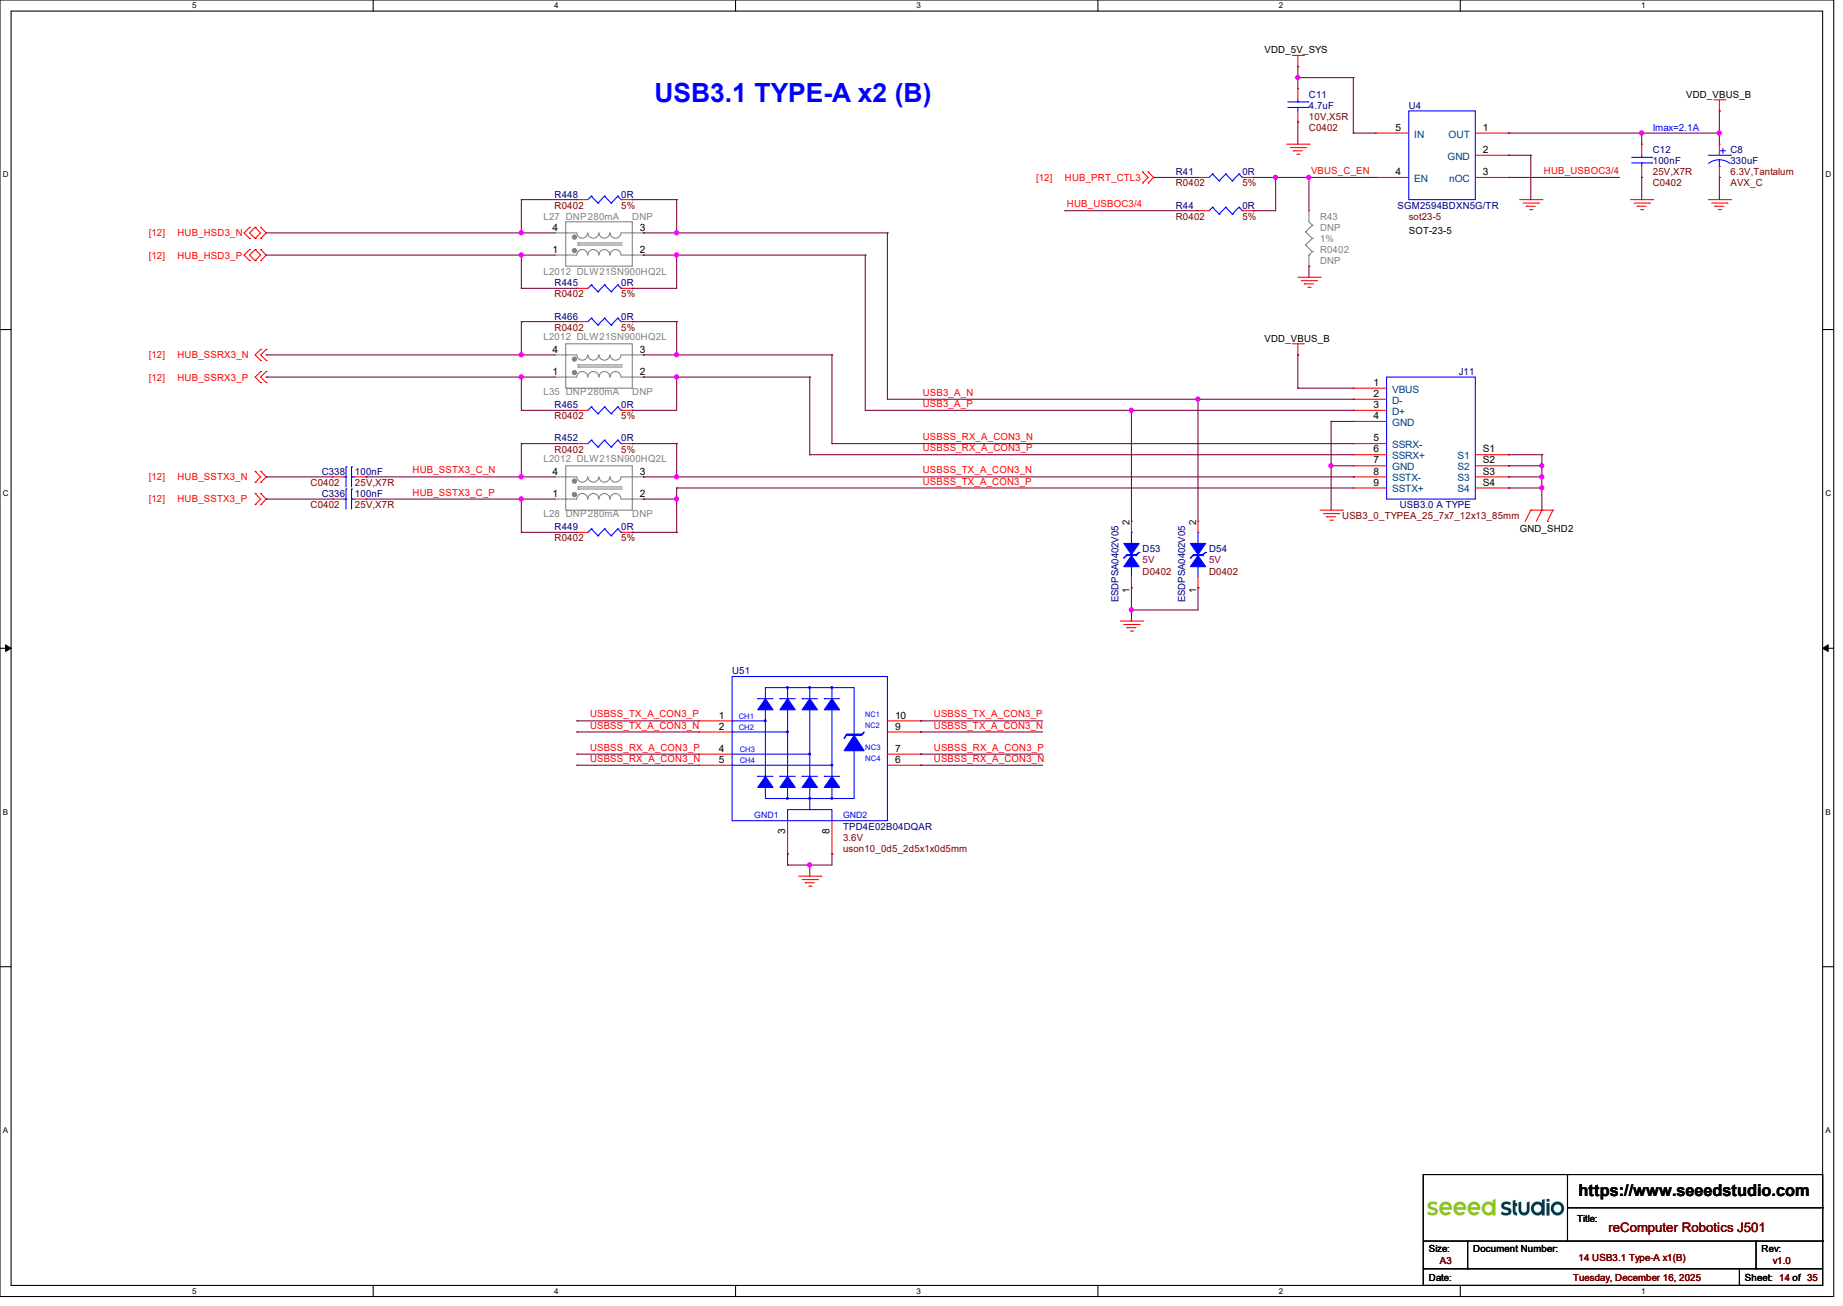
[picture p221: page 14]

# USB Type C For Debug UART USB2.0 Only

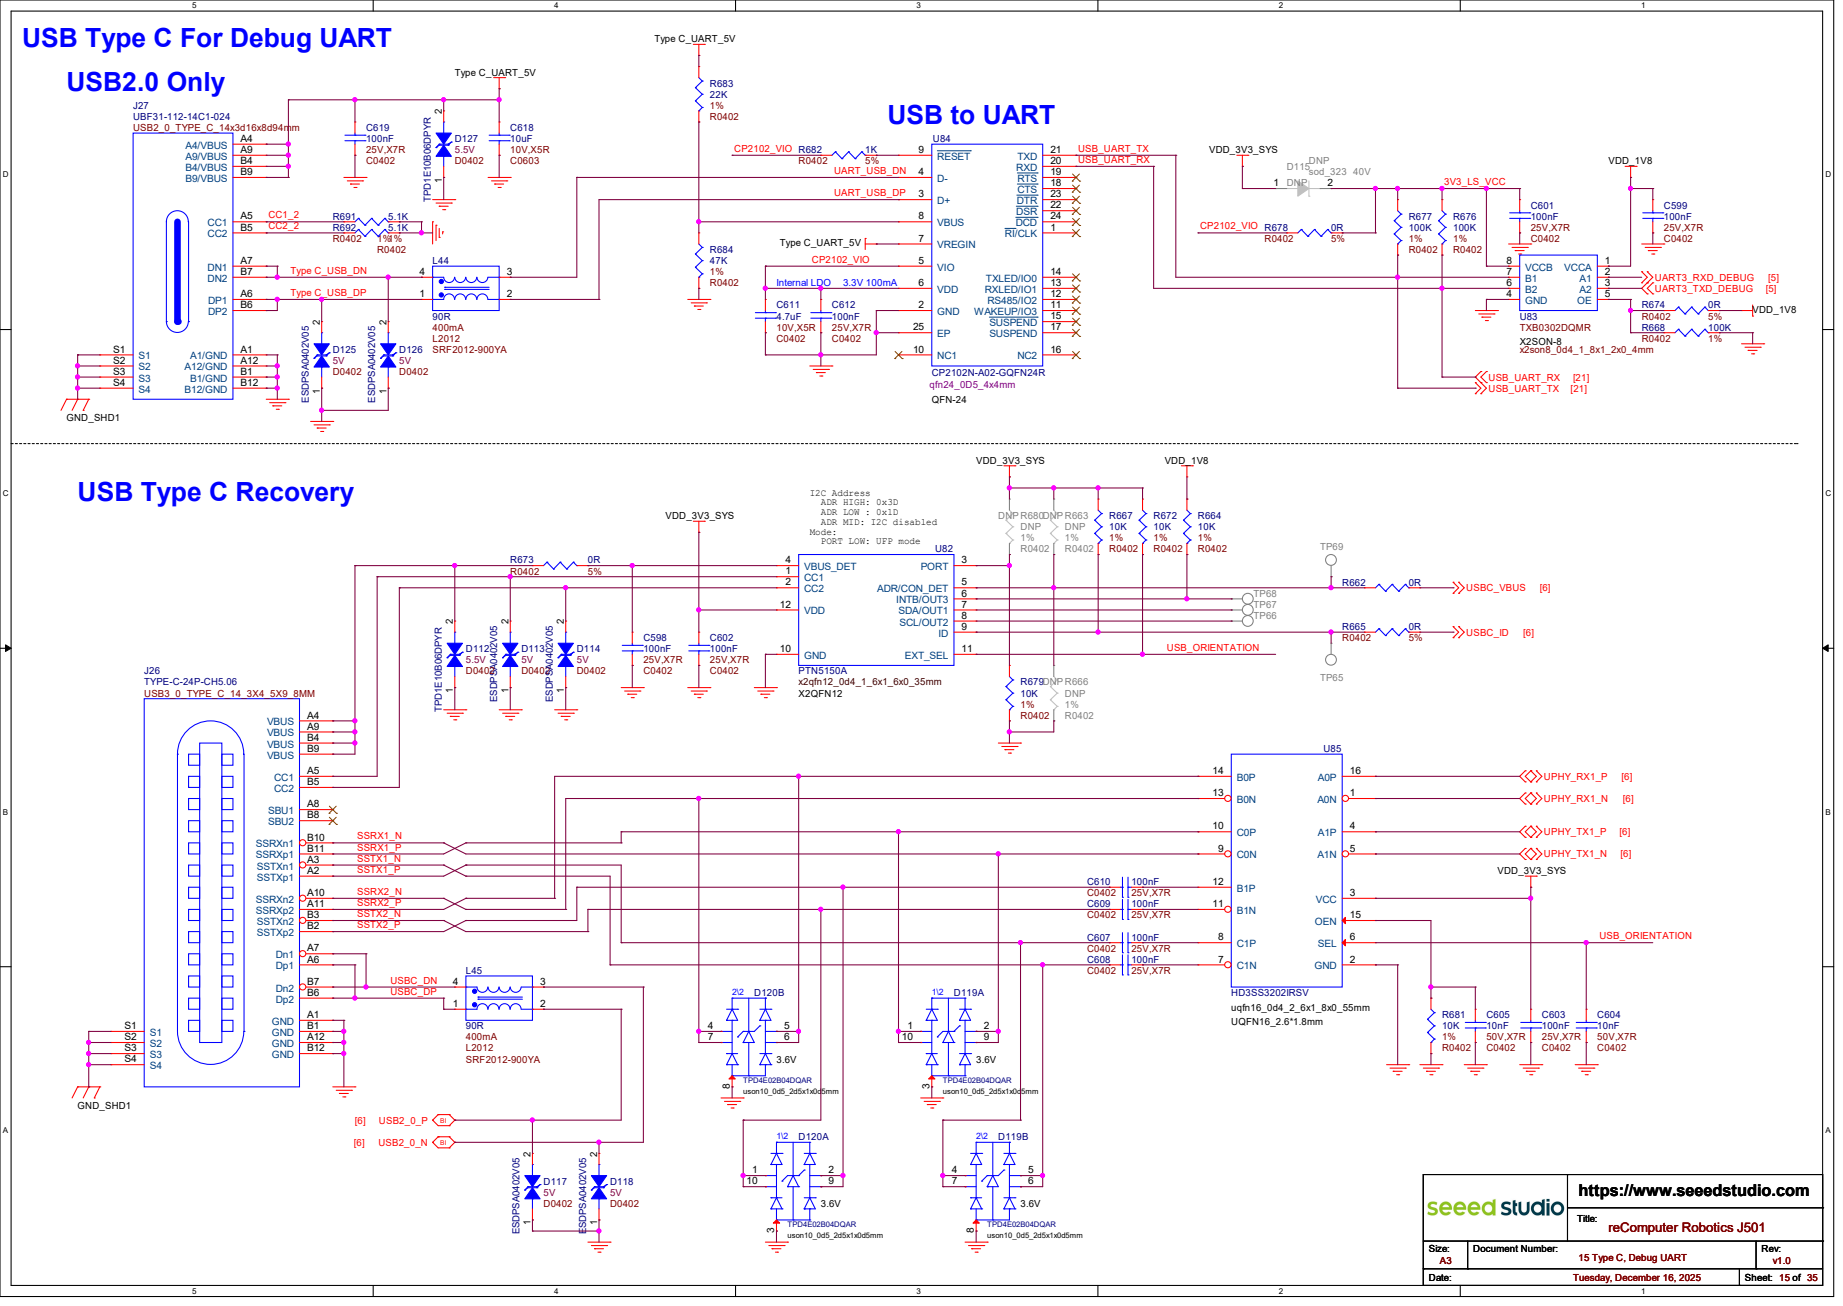
[picture p222: page 15]

ADR HIGH: 0x3D
ADR LOW : 0x1D
ADR MID: I2C disabled
Mode:
PORT LOW: UFP mode
U82 PTN5150A

reComputer Robotics J501 15 Type C, Debug UART

# M.2 KEY-E (WIFI/BT)

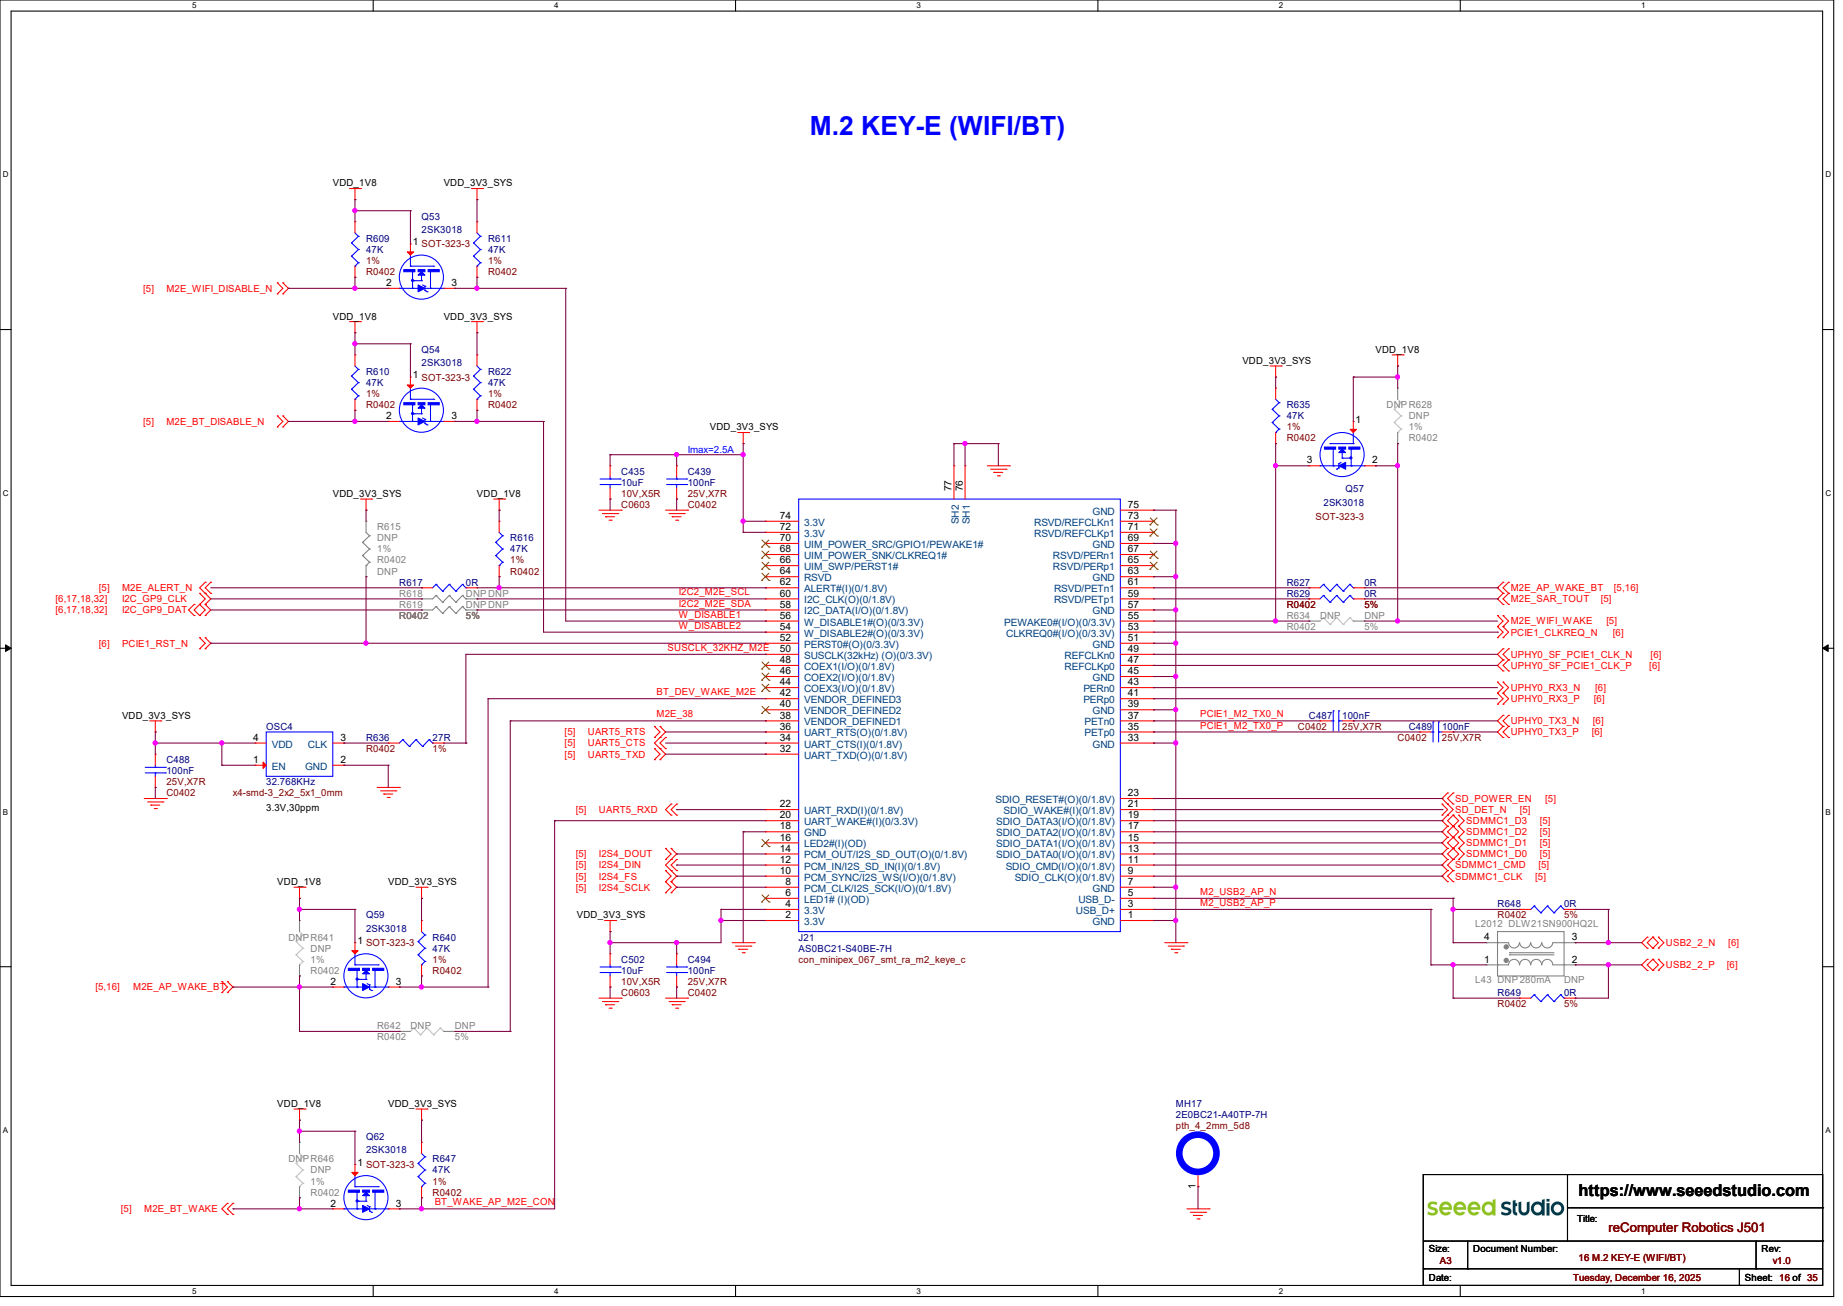
[picture p223: page 16]

reComputer Robotics J501 16 M.2 KEY-E (WIFI/BT)

# M.2 KEY-M (NVME)

# R0402 DNP R583 27R

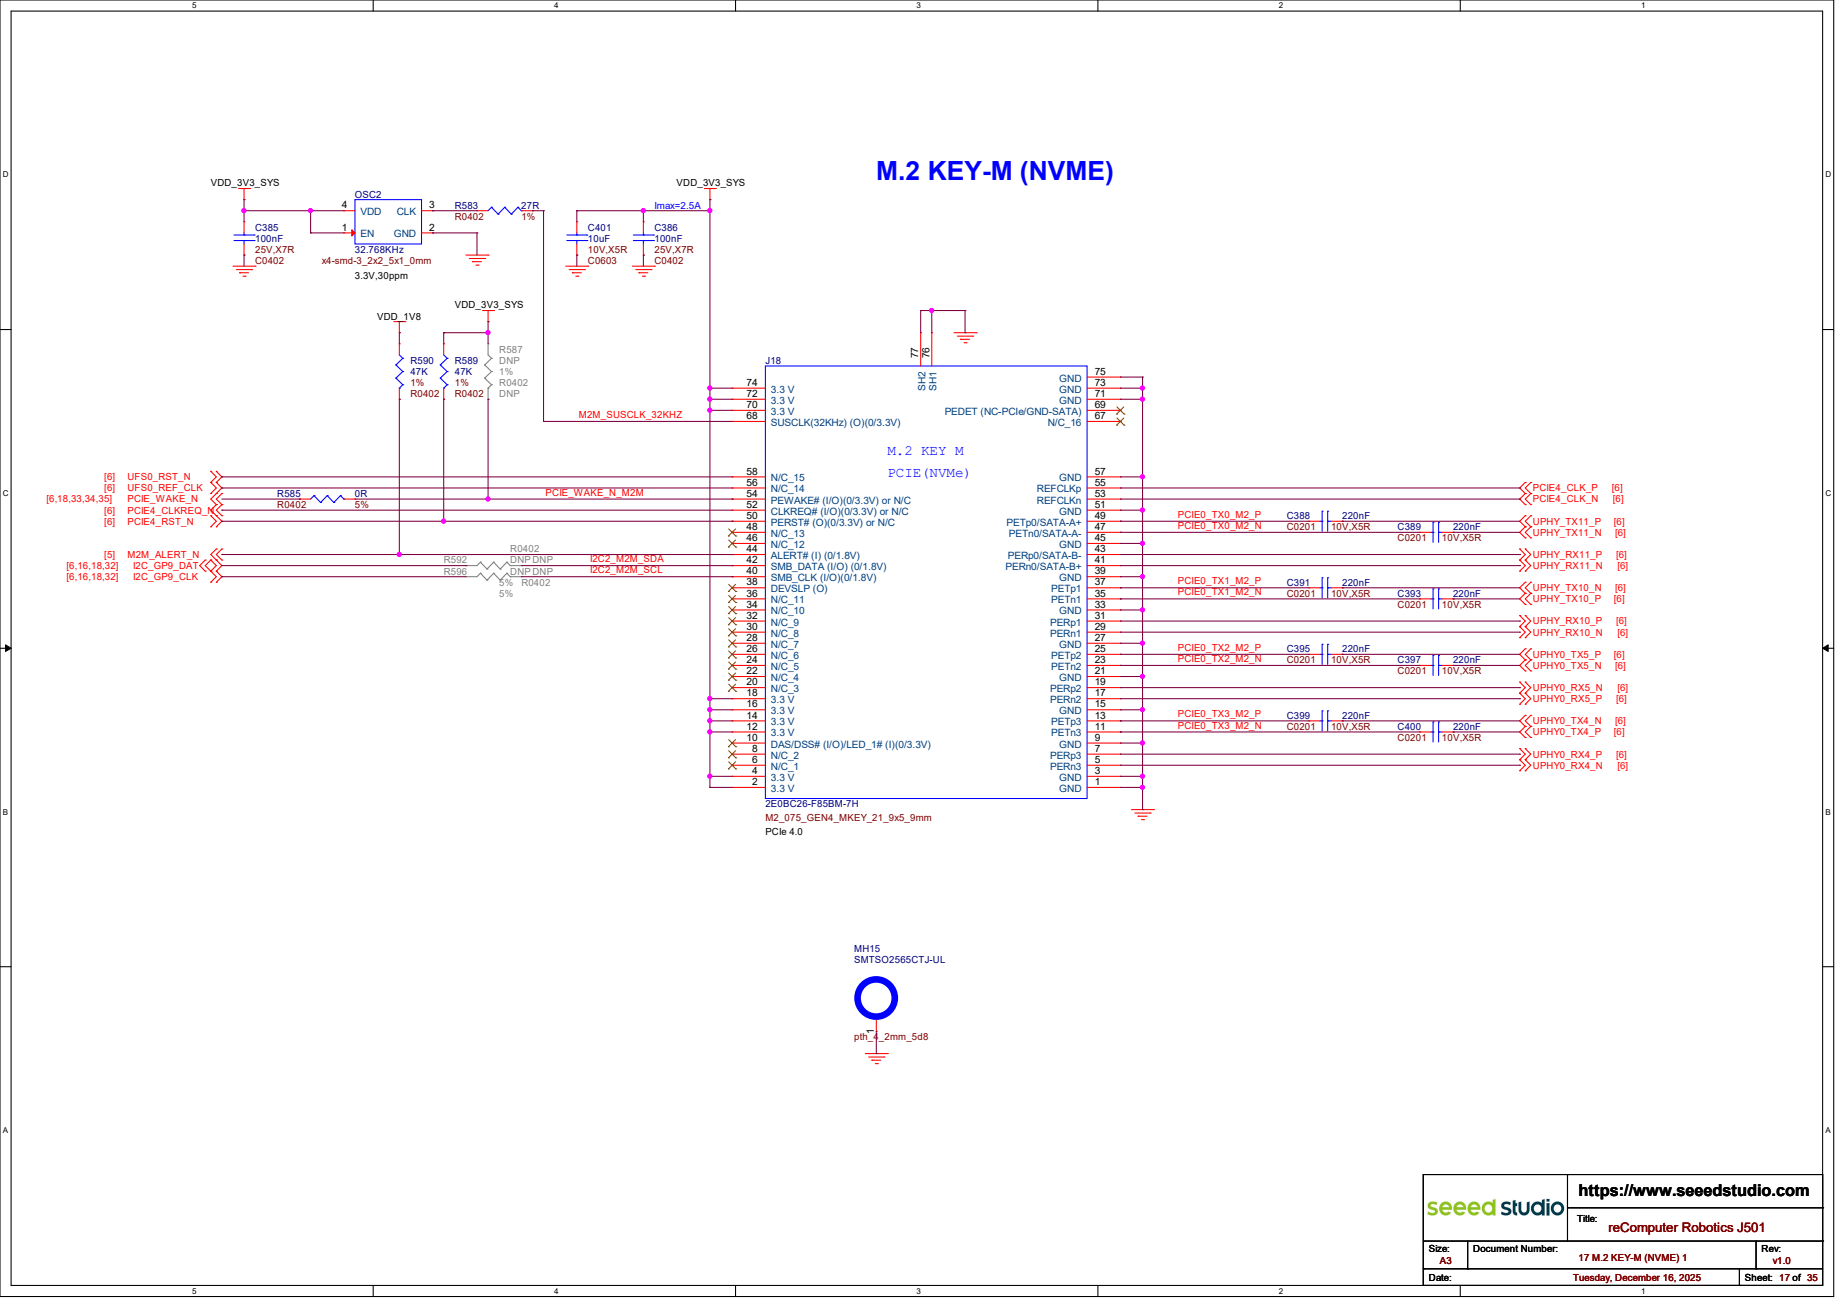
[picture p224: page 17]

reComputer Robotics J501 17 M.2 KEY-M (NVME) 1

# M.2 KEY-M (NVME)

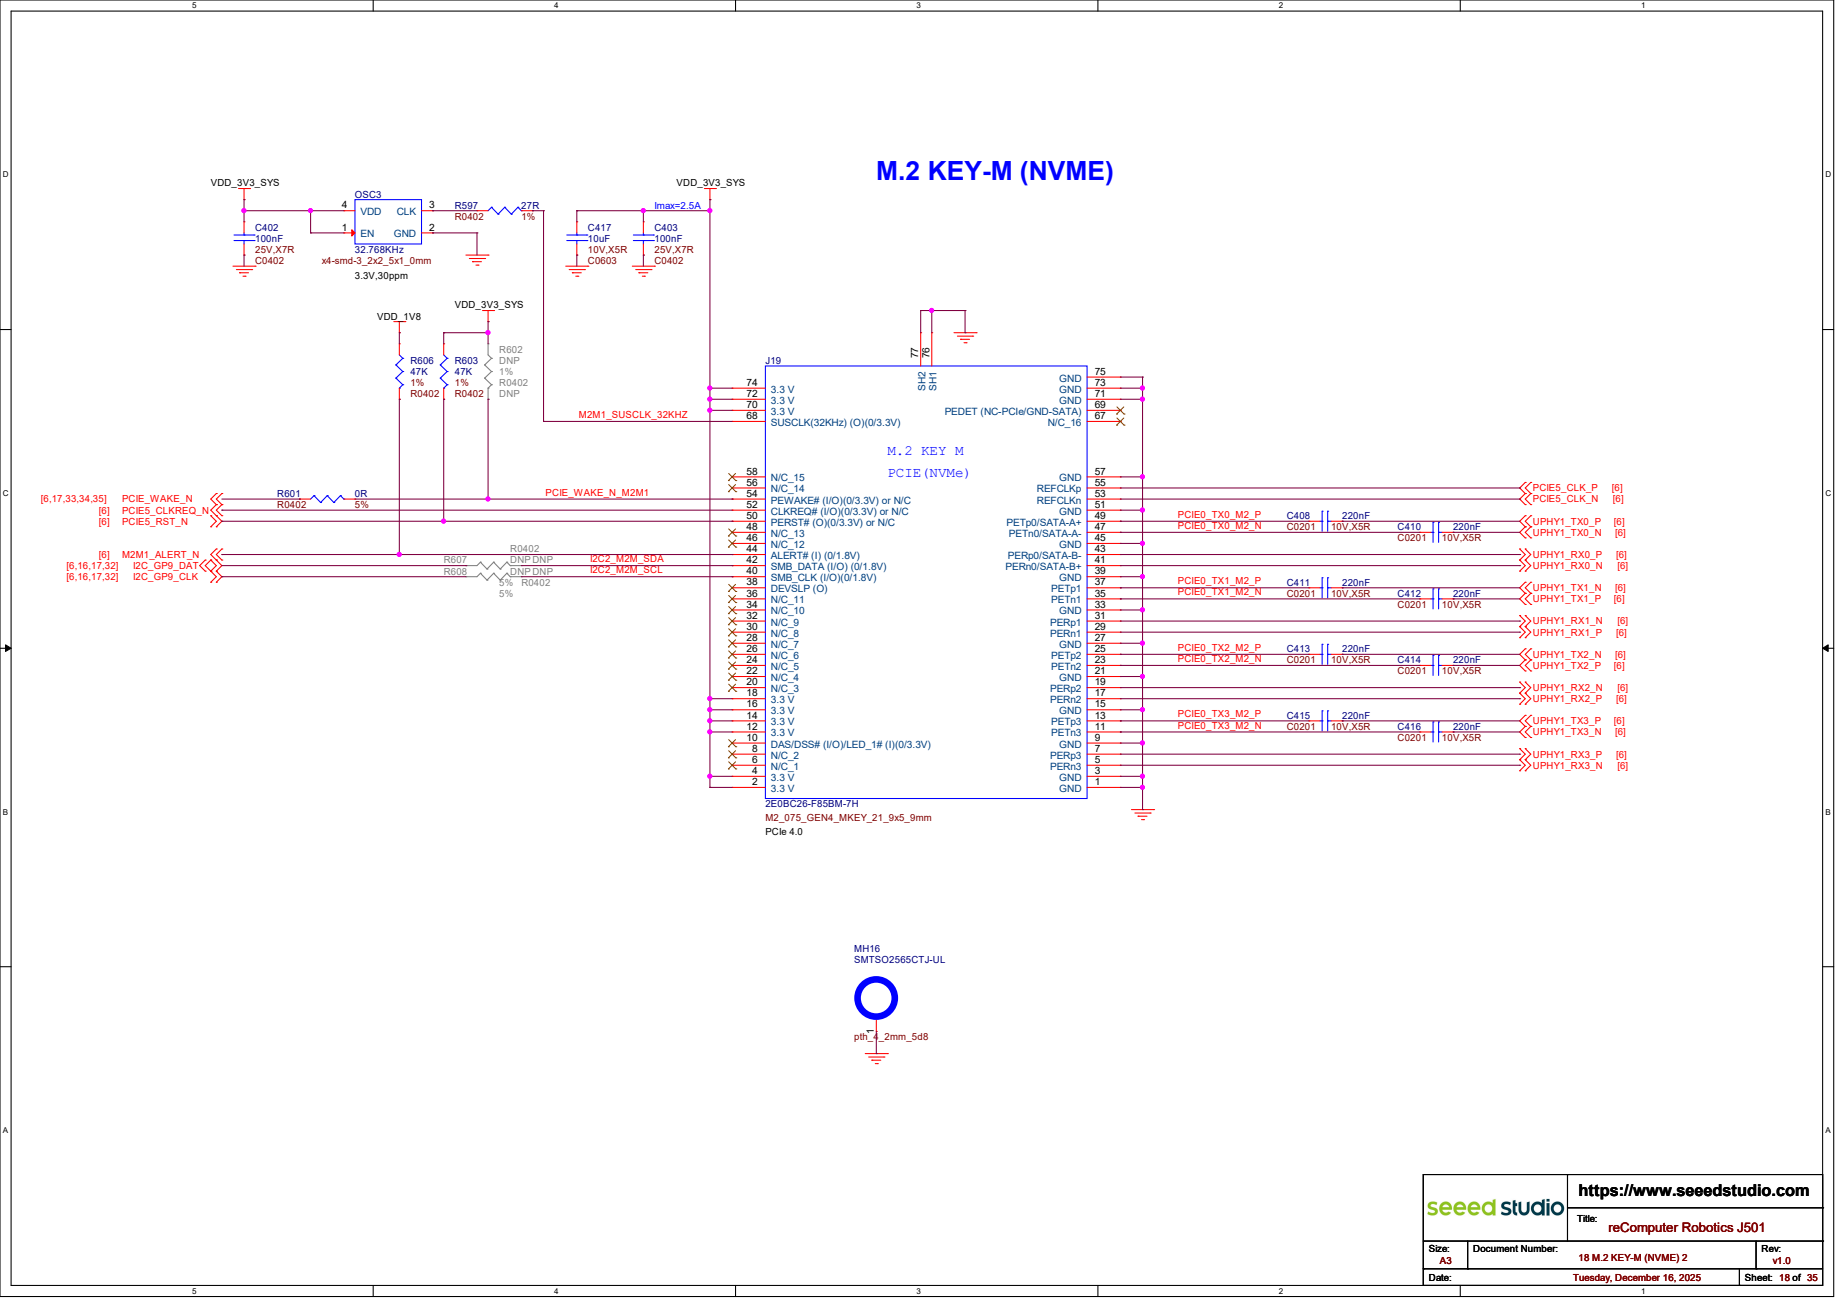
[picture p225: page 18]

reComputer Robotics J501 18 M.2 KEY-M (NVME) 2

# M.2 KEY-B (4G/5G)

# PTH_3_73mm_5D8_paste ¹ R582 DNP

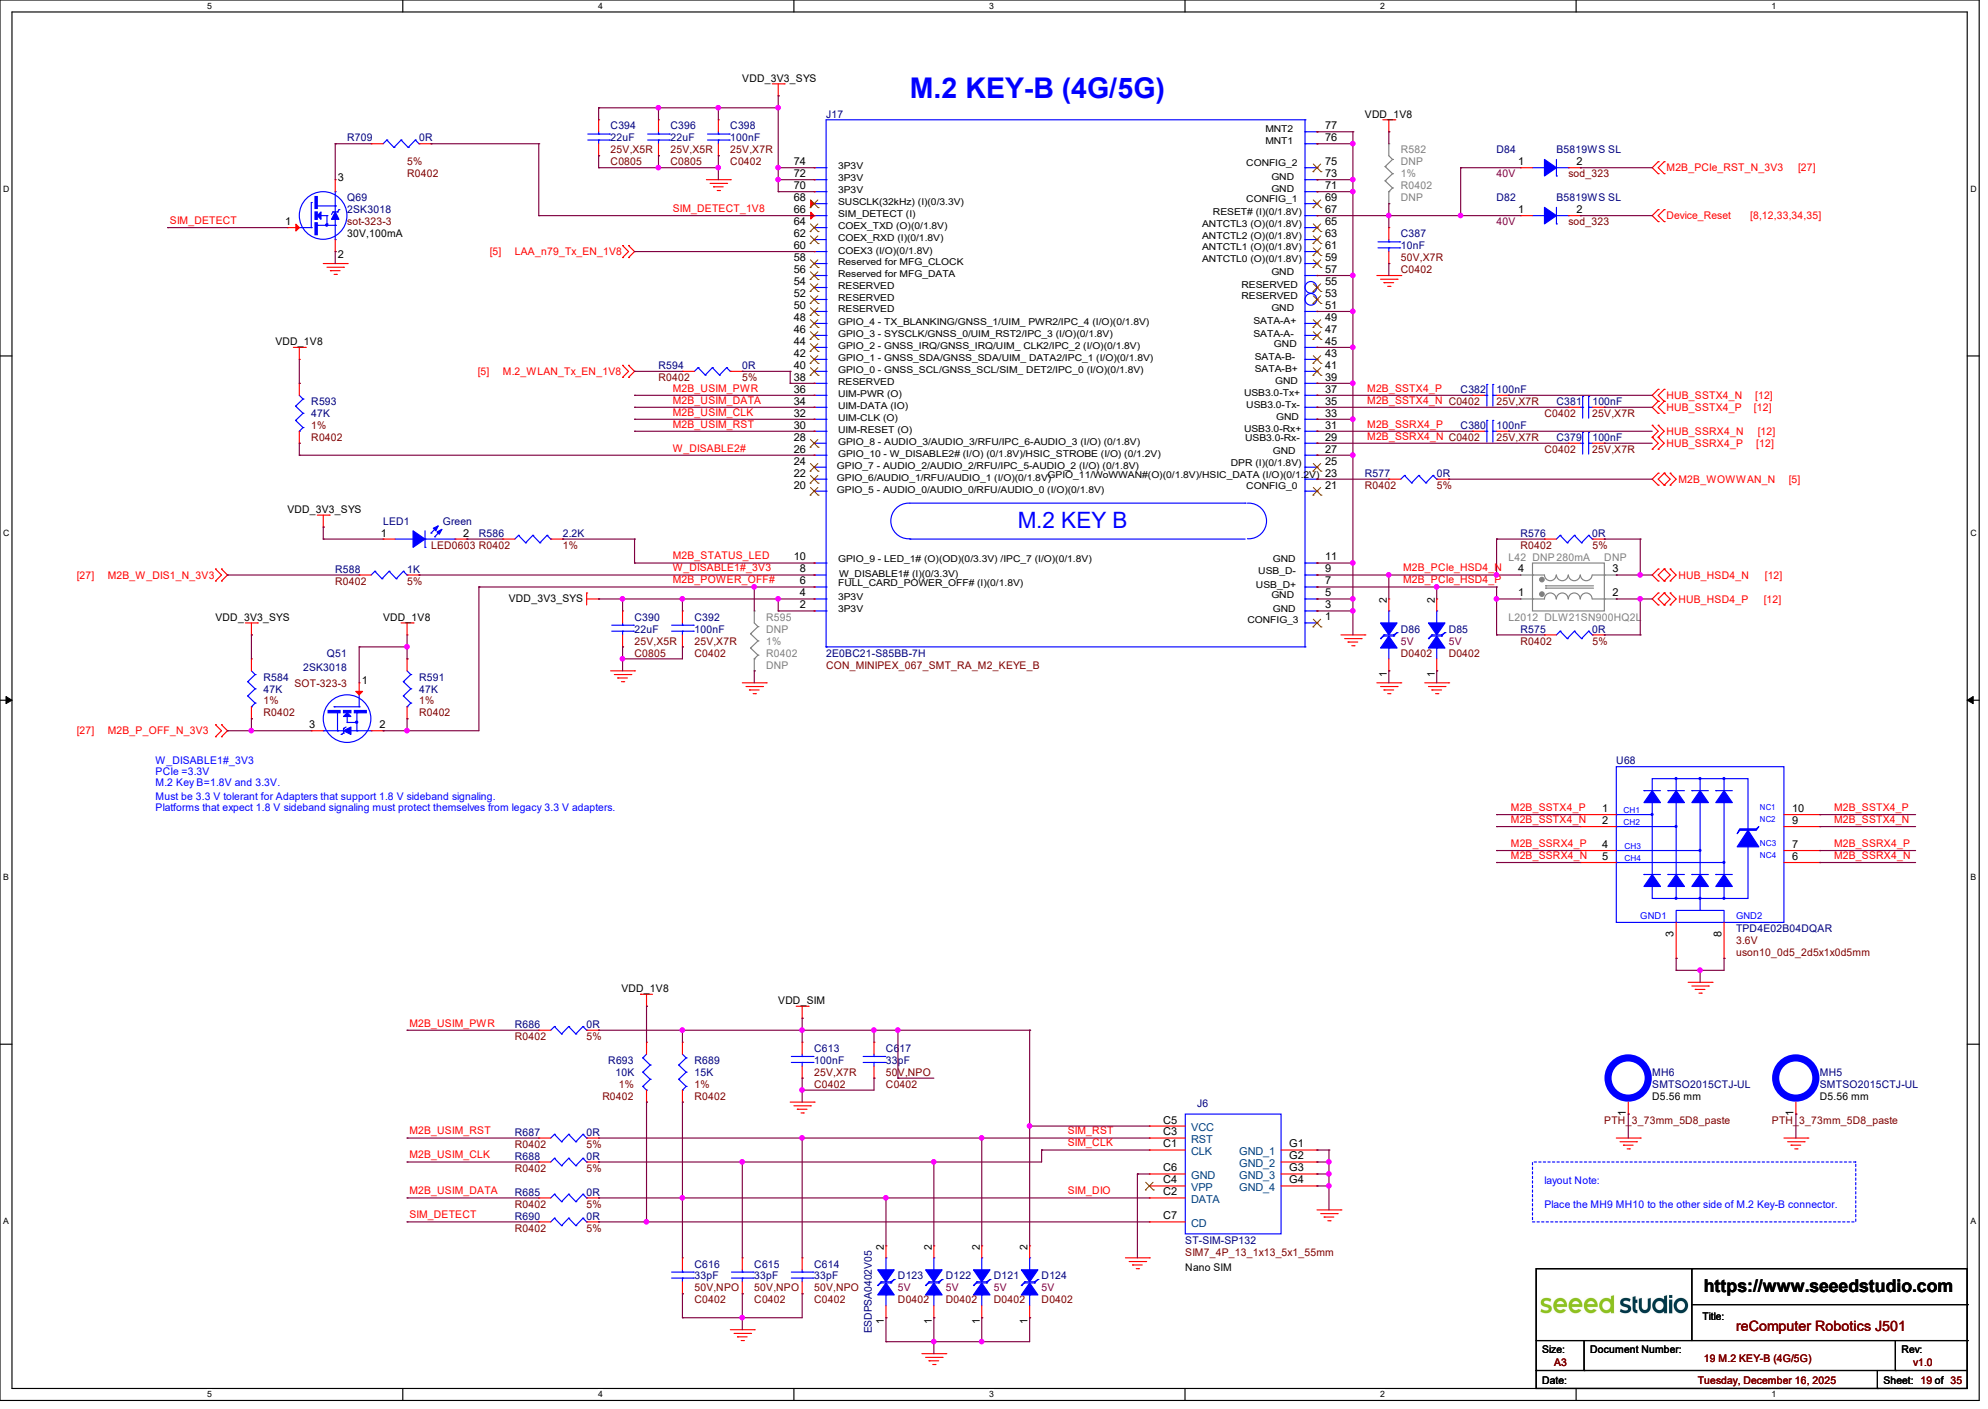
[picture p226: page 19]

layout Note: Place the MH9 MH10 to the other side of M.2 Key-B connector.

# HDMI Connector

# LQG15HS1N0S02D Q43

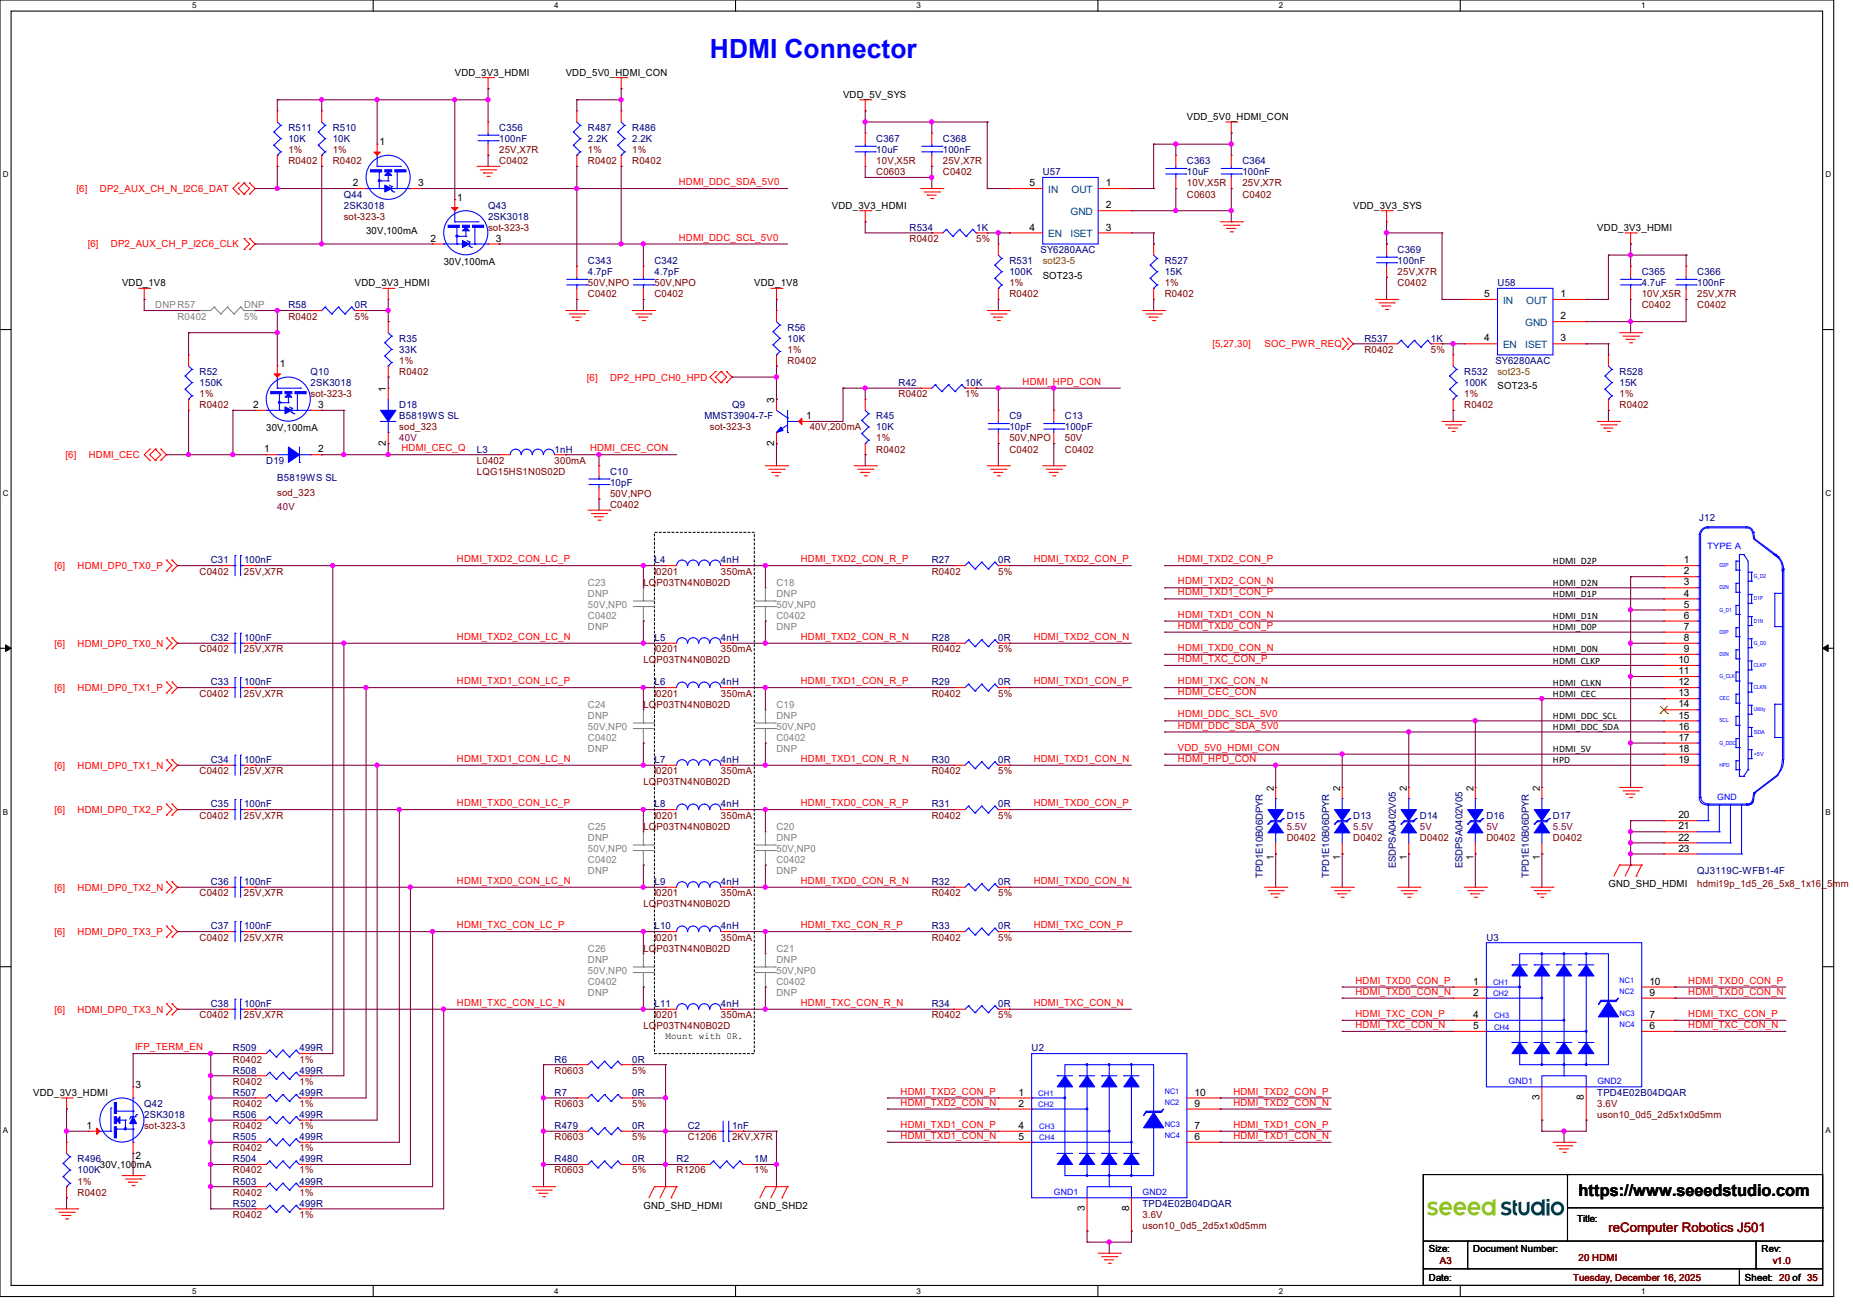
[picture p227: page 20]

SoC Fan Header 4pin | Carrier Board Config

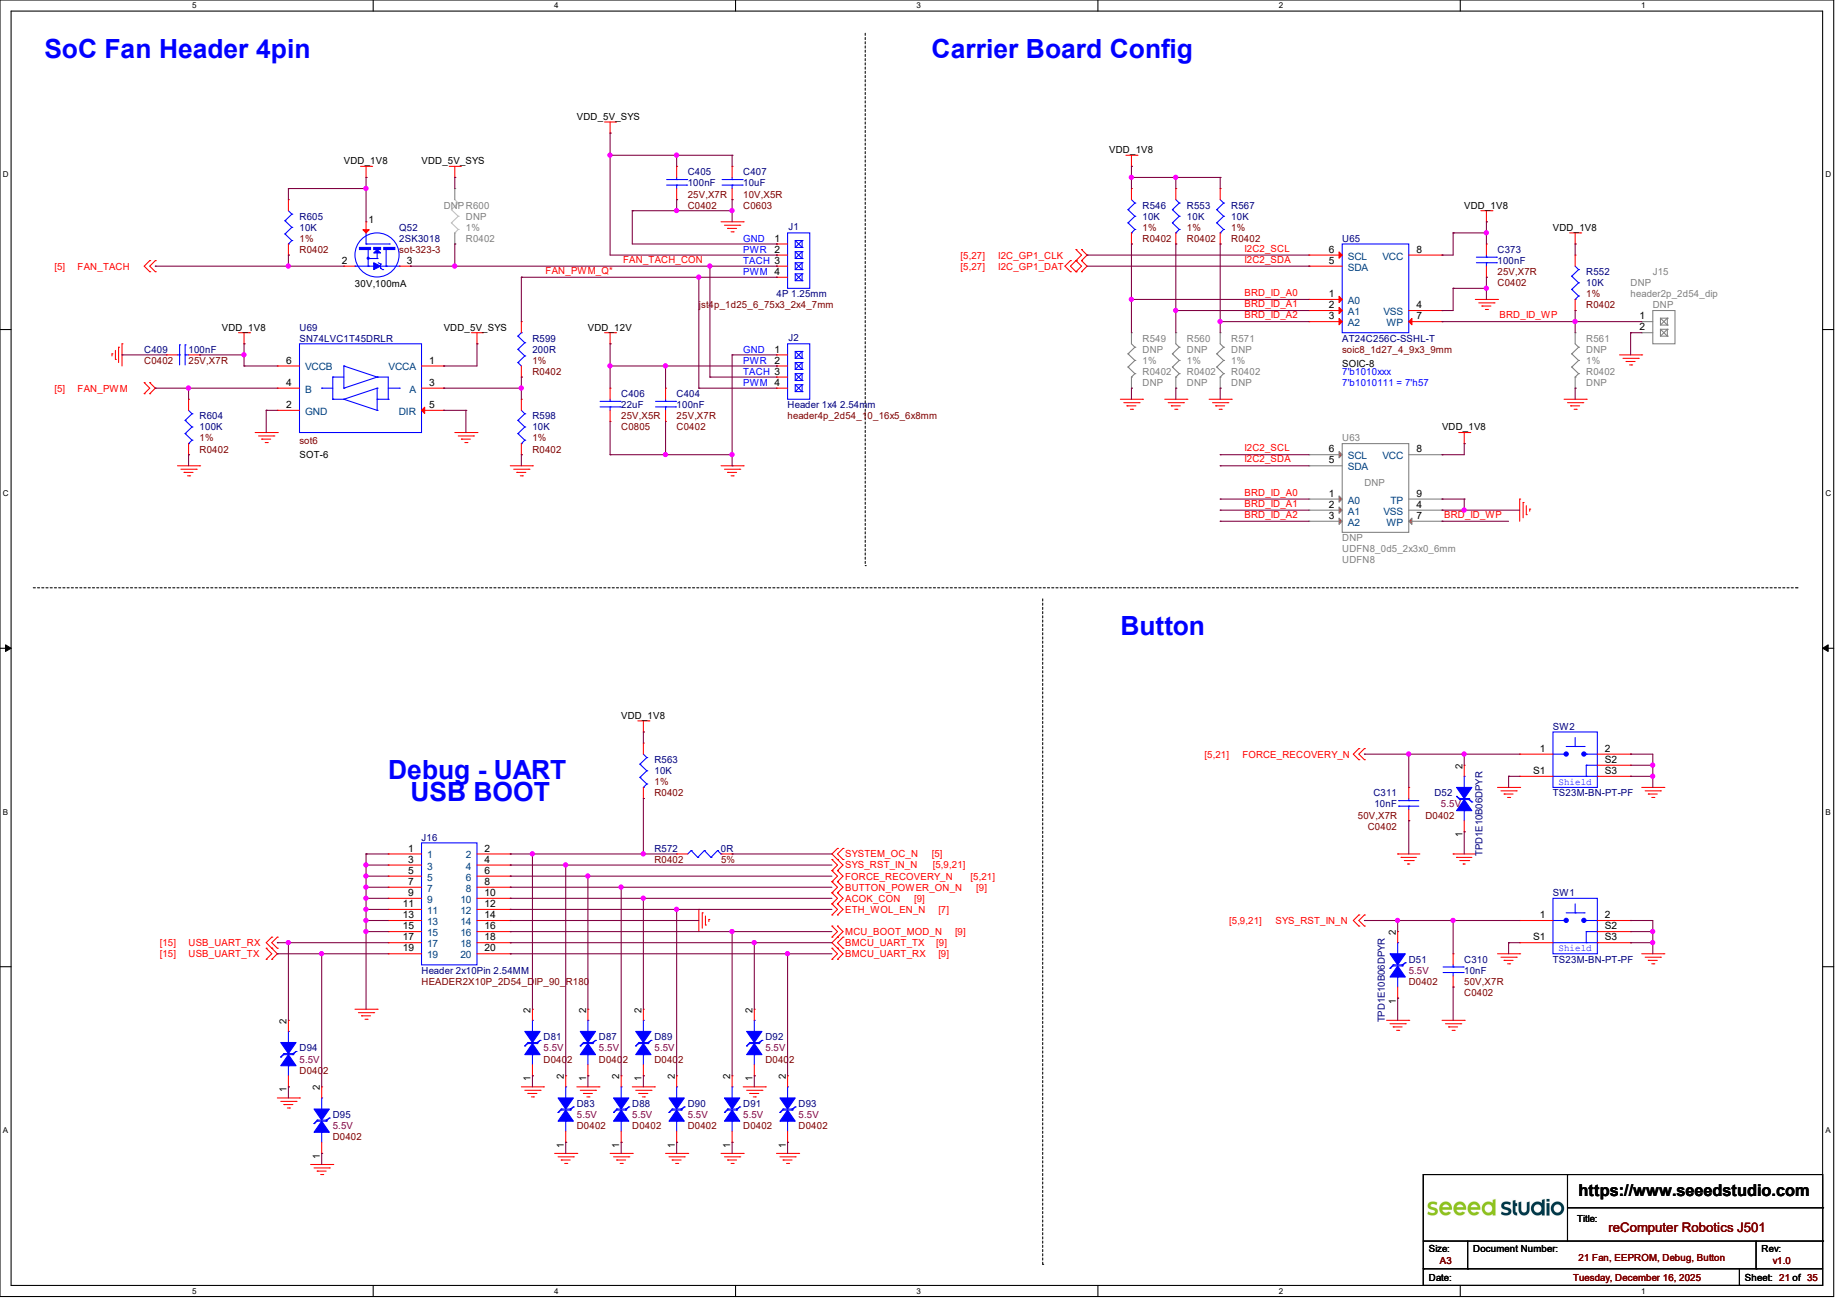
[picture p228: page 21]

reComputer Robotics J501 21 Fan, EEPROM, Debug, Button D95 D0402

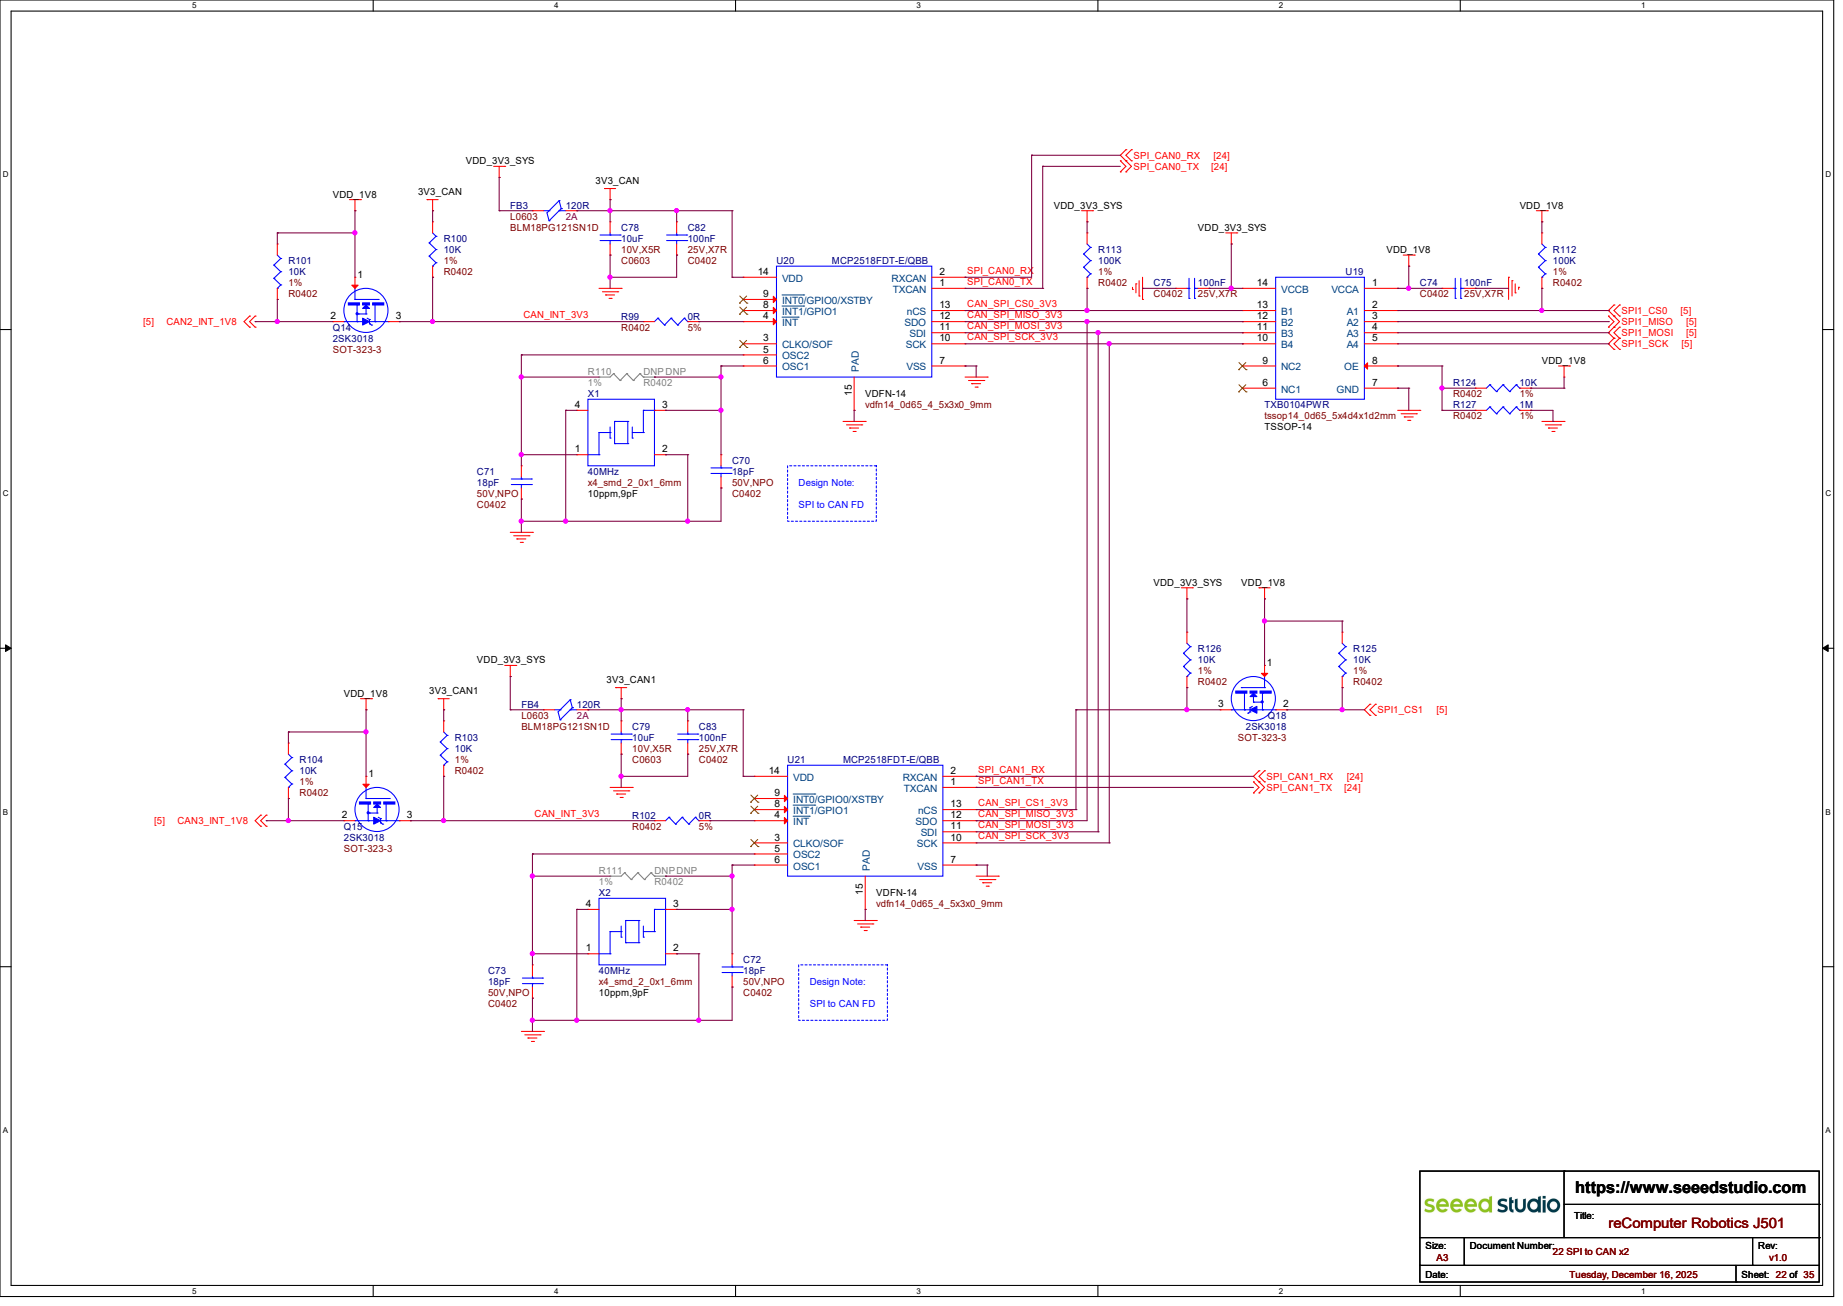
[picture p229: page 22]

VDFN-14 TXCAN 1 RXCAN 2 CLKO/SOF 3

SPI to CAN FD

# Isolated DCDC 5V to 5V

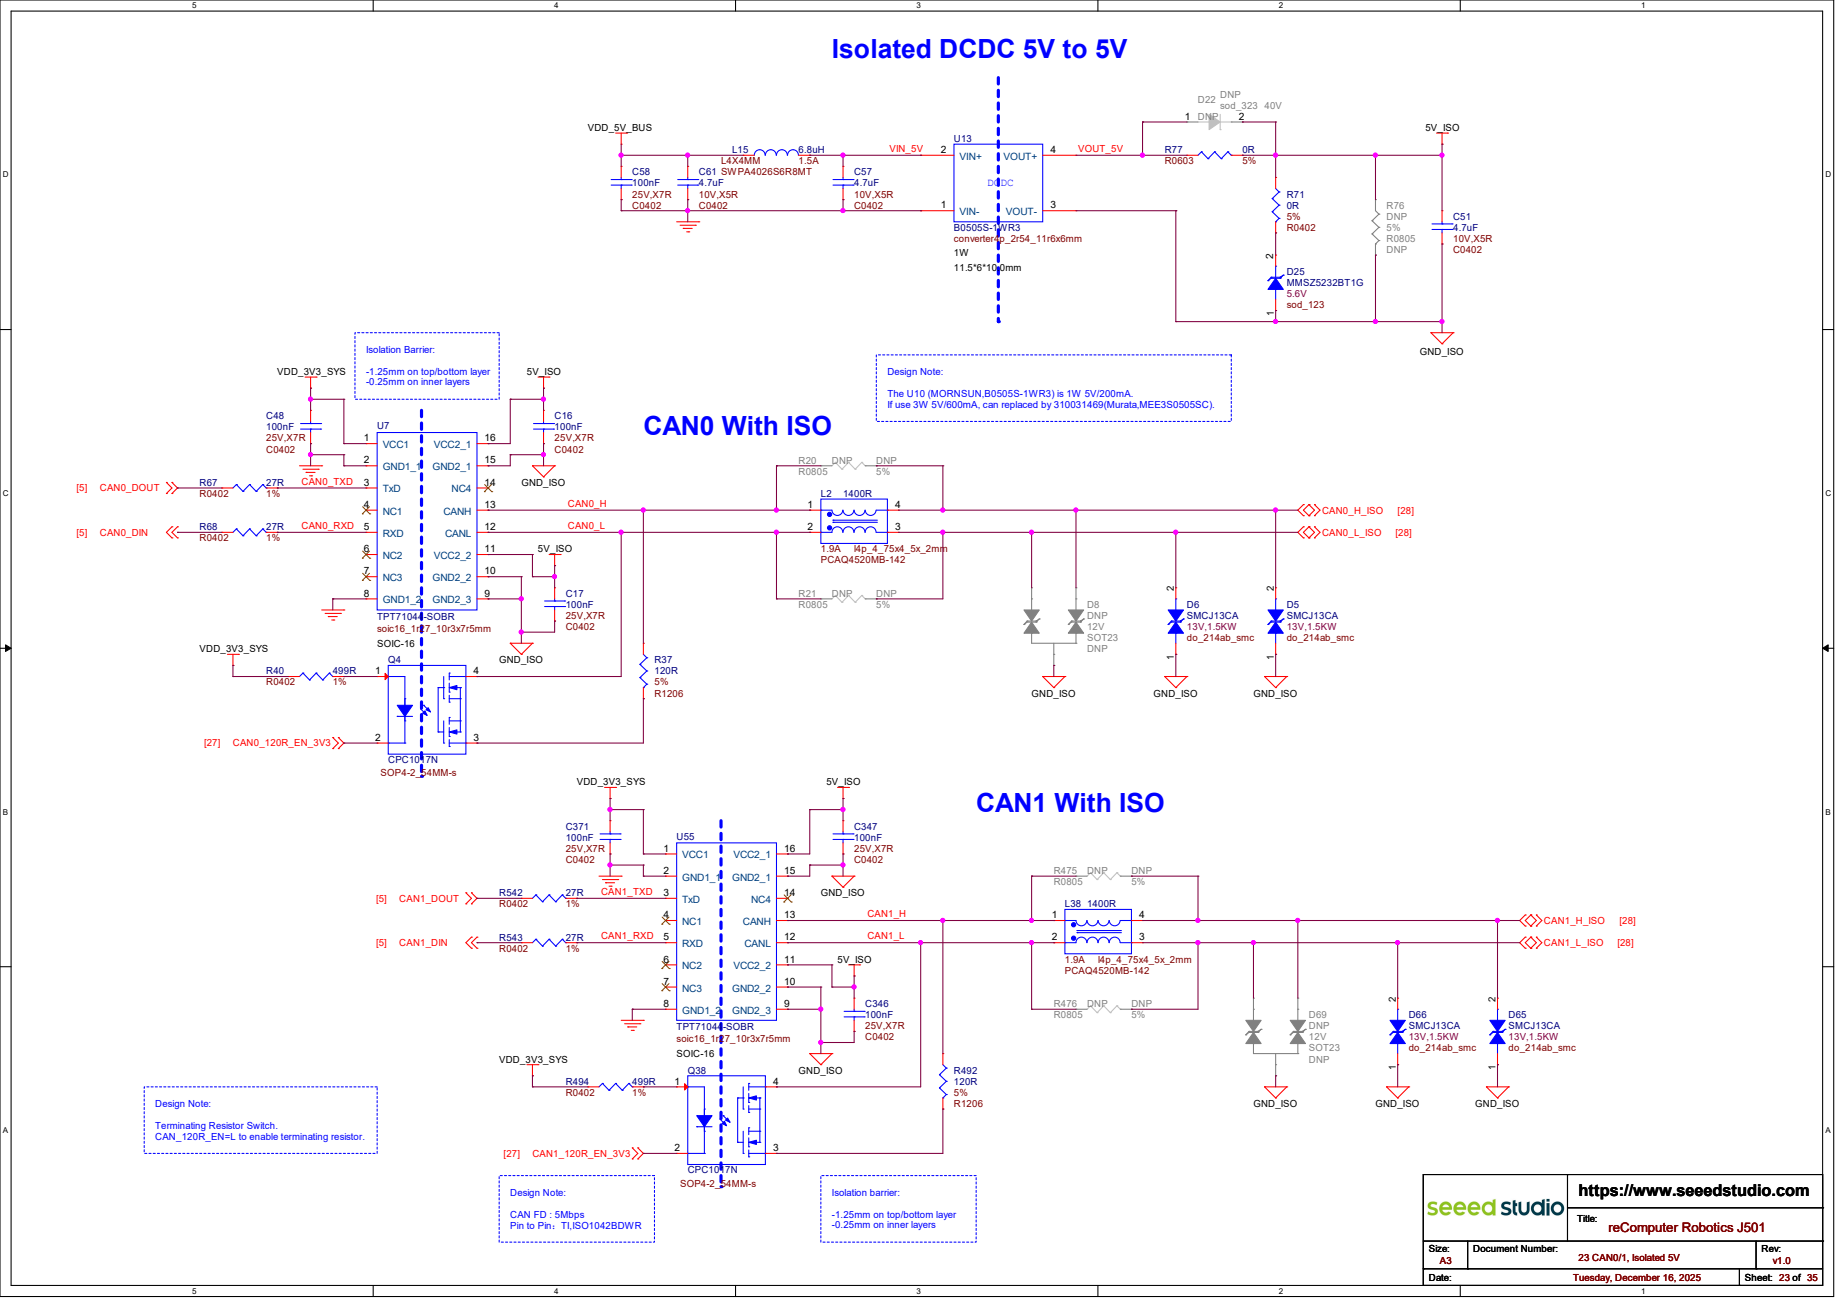
[picture p230: page 23]

Isolation Barrier: -1.25mm on top/bottom layer
U7 TPT71044-SOBR

If use 3W 5V/600mA, can replaced by 310031469(Murata,MEE3S0505SC). Design Note: The U10 (MORNSUN,B0505S-1WR3) is 1W 5V/200mA.

-1.25mm on top/bottom layer
-0.25mm on inner layers

# Isolated DCDC 5V to 5V

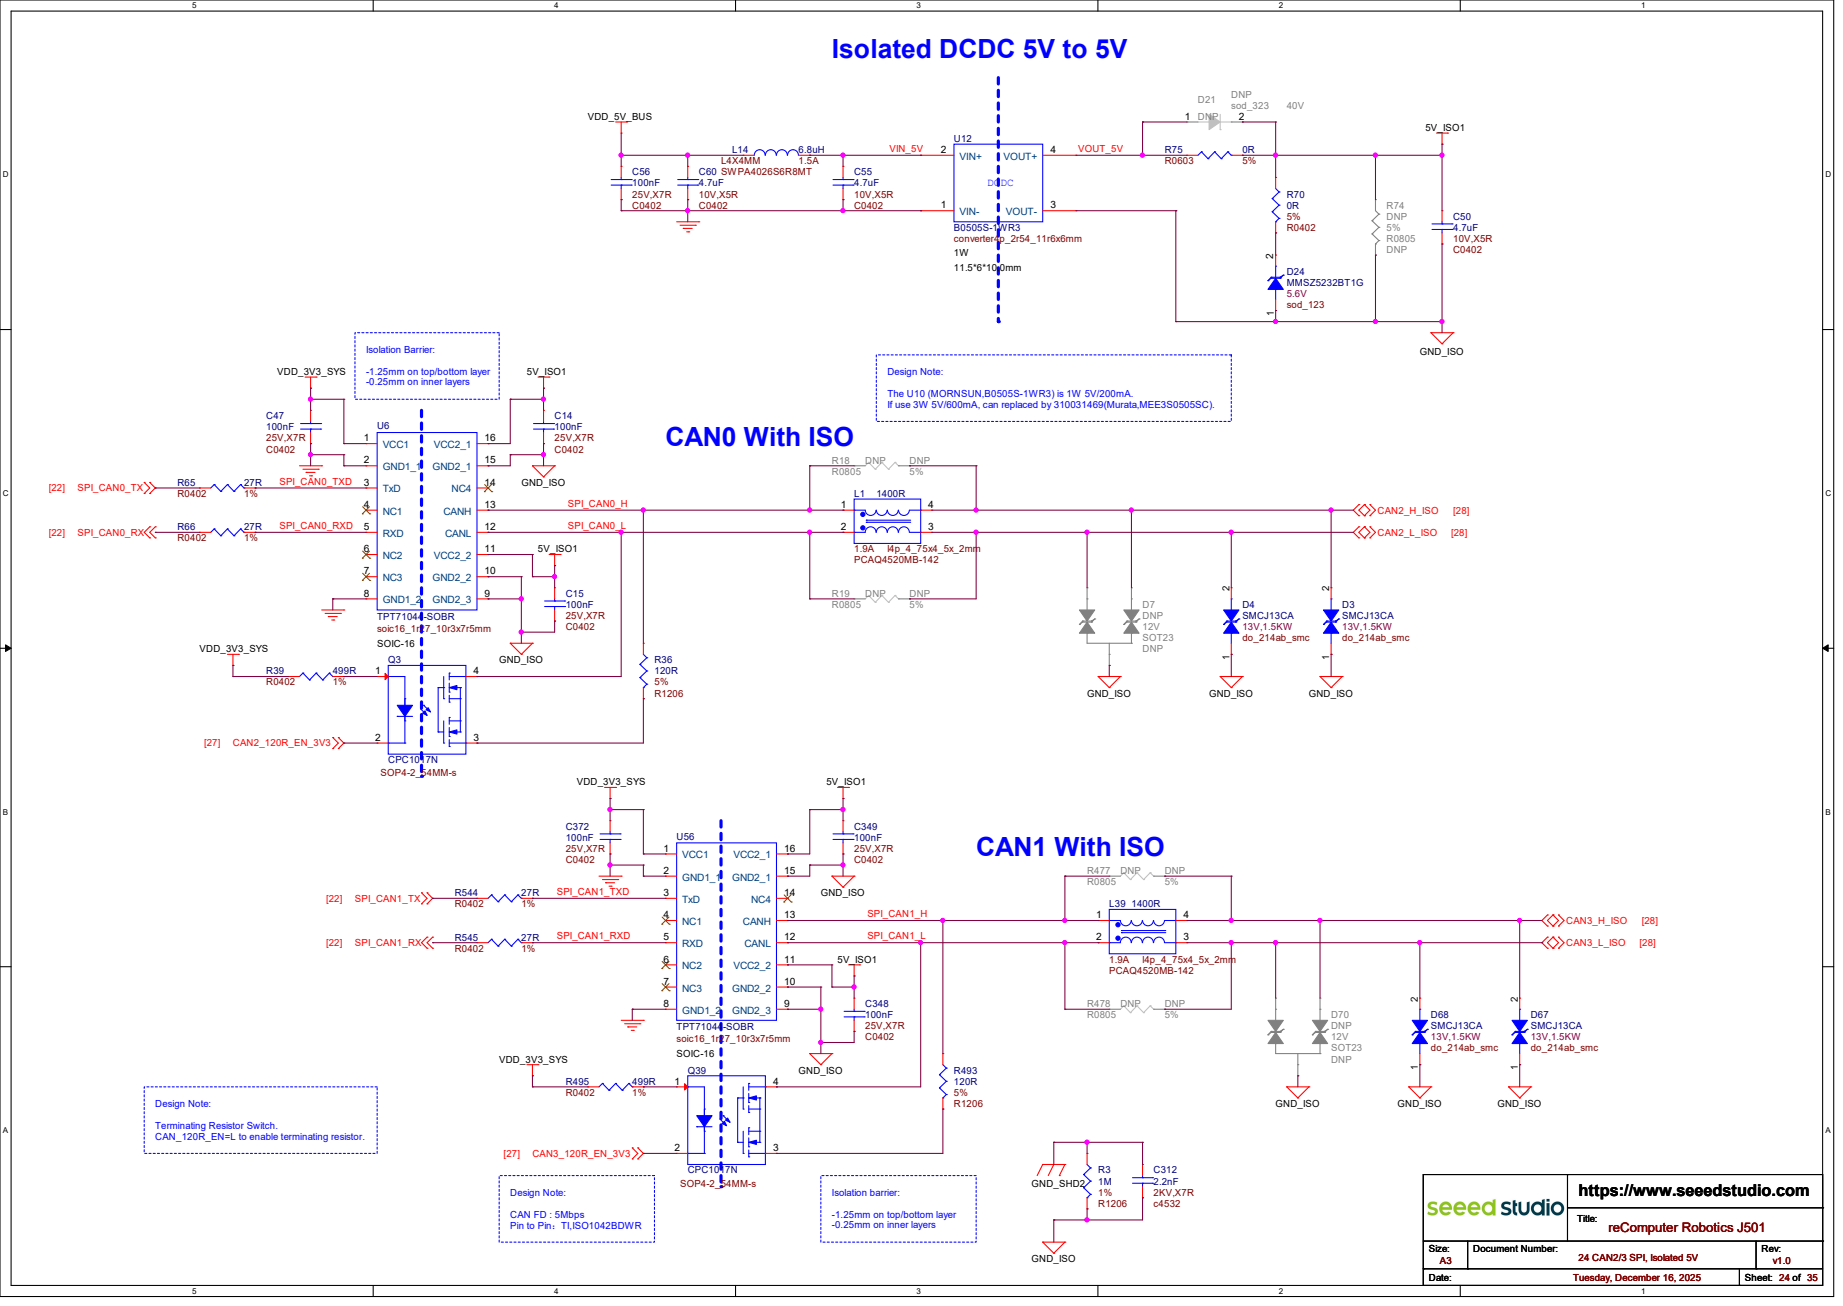
[picture p231: page 24]

Isolation Barrier: -1.25mm on top/bottom layer
U6 TPT71044-SOBR

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

-1.25mm on top/bottom layer
-0.25mm on inner layers

reComputer Robotics J501 24 CAN2/3 SPI, Isolated 5V

# SOIC-16 VCCA 1 GNDA 2

# IN4 11 IN3 12 OUT2 13 OUT1 14 GNDB 15 VCCB 16

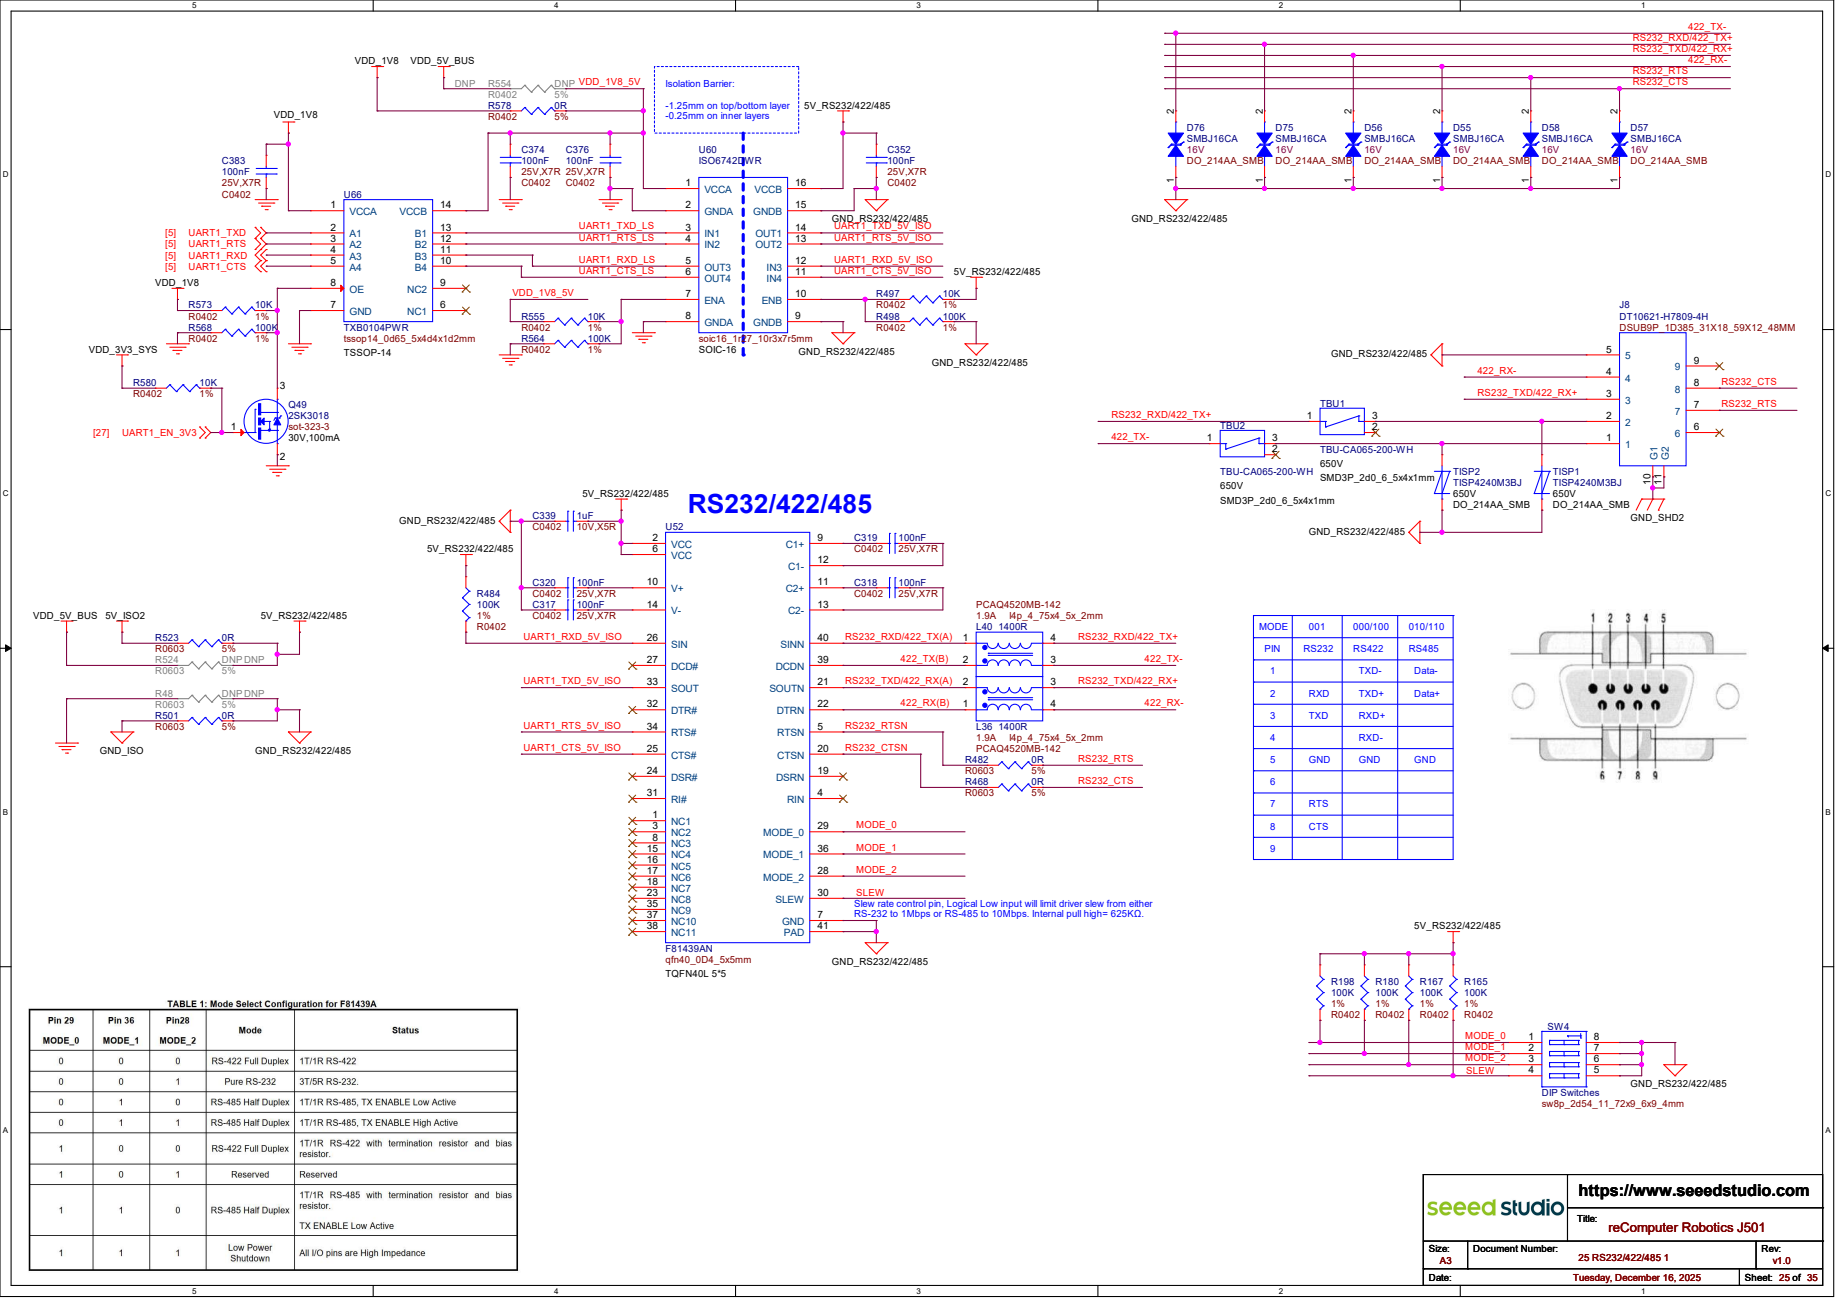
[picture p232: page 25]

-1.25mm on top/bottom layer
-0.25mm on inner layers

001 | 000/100 | 010/110 Slew rate control pin, Logical Low input will limit driver slew from either RS-232 to 1Mbps or RS-485 to 10Mbps. Internal pull high= 625KΩ.

8 MODE 2 1 | | RXD- GND TXD+ RXD+ | RS485 GND Data- TXD

3 | RS232 RXD | RS422 | Data+ TXD- PIN

6 | RTS CTS GND

# SOIC-16 VCCA 1 GNDA 2

# U67 TXB0104PWR

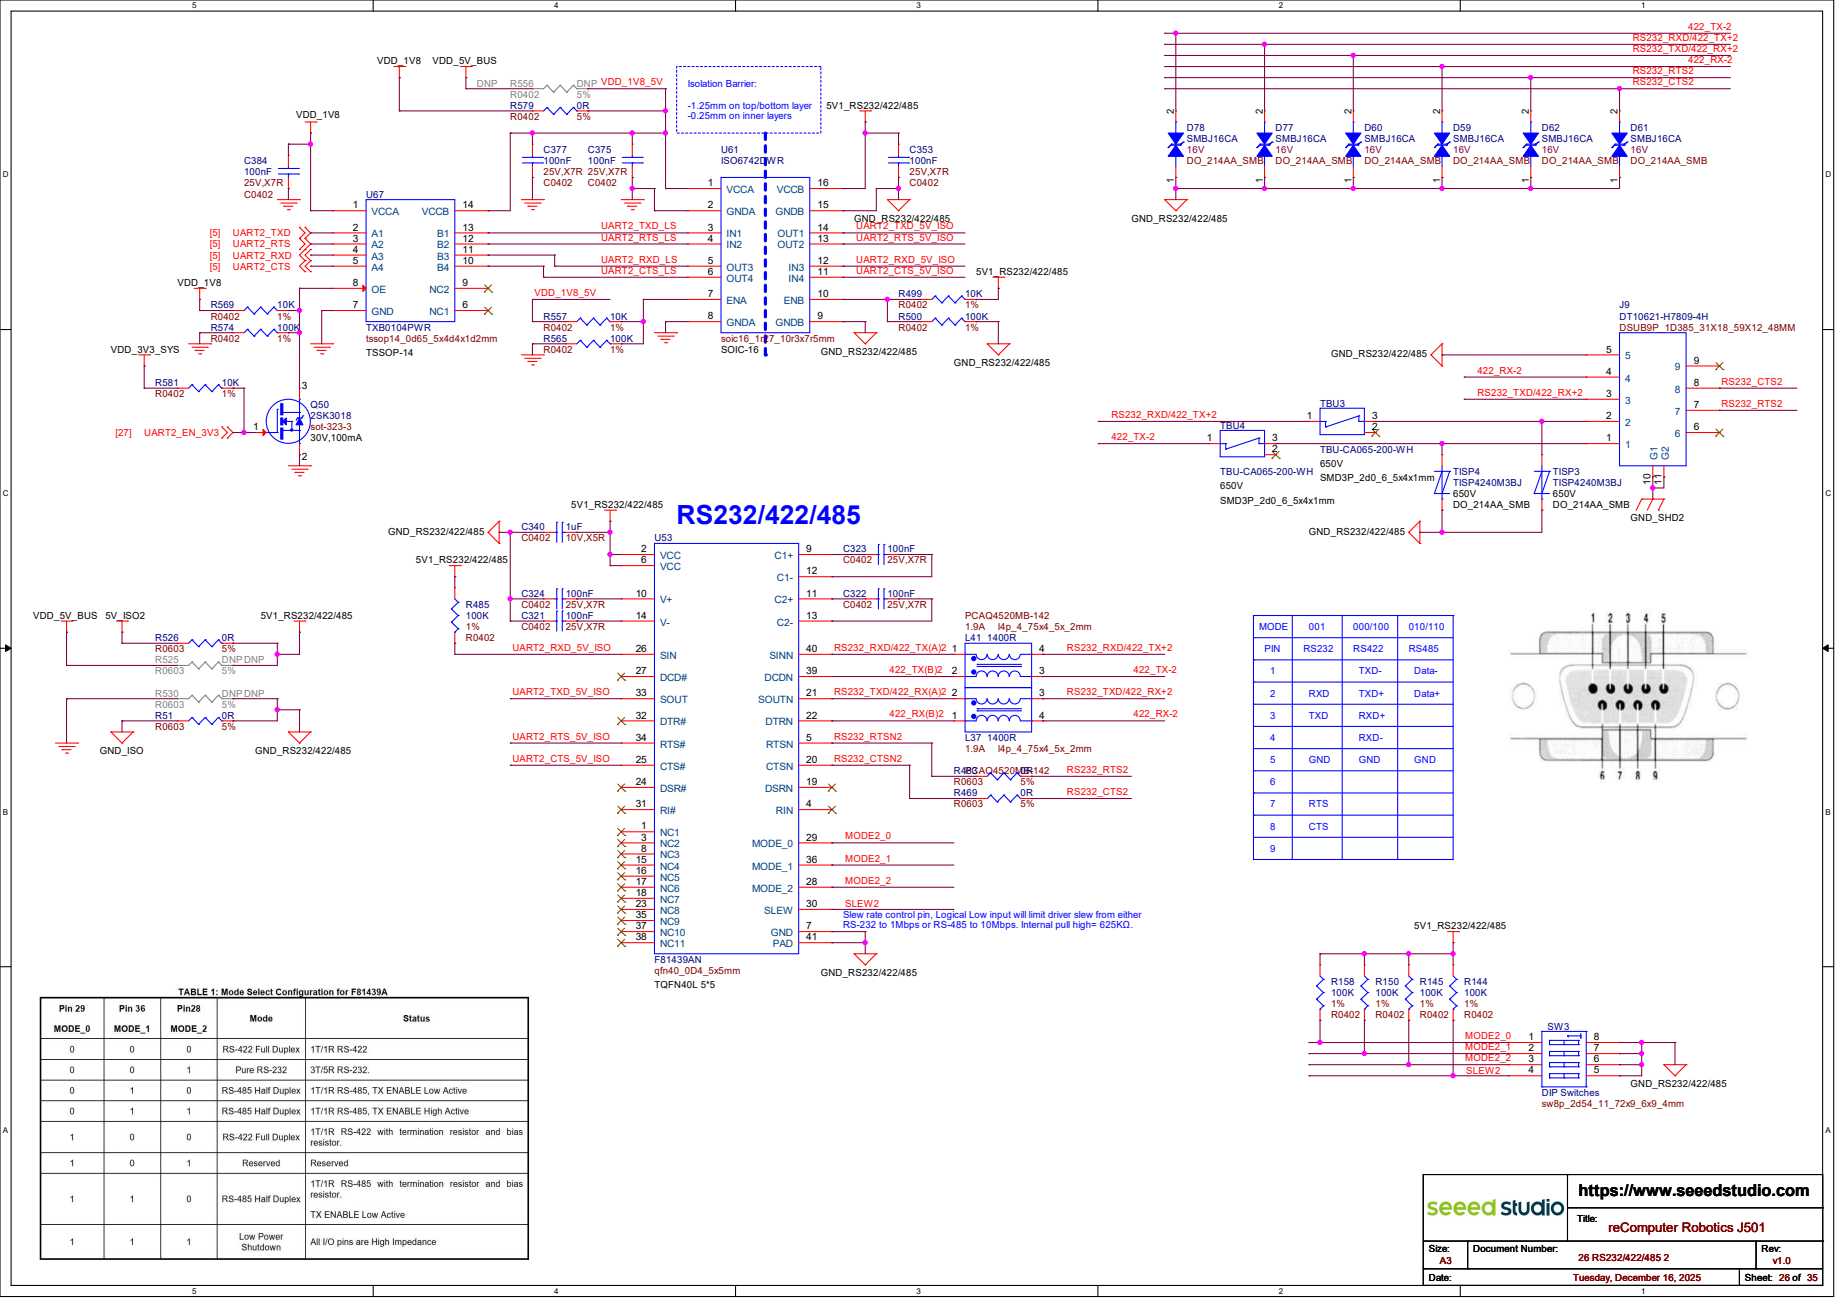
[picture p233: page 26]

-1.25mm on top/bottom layer
-0.25mm on inner layers

8 MODE 2 1 | RXD- GND TXD+ RXD+ | RS485 GND Data- TXD

3 | RS232 RXD | RS422 | Data+ TXD- PIN

6 | RTS CTS GND

# MGBE reference clock

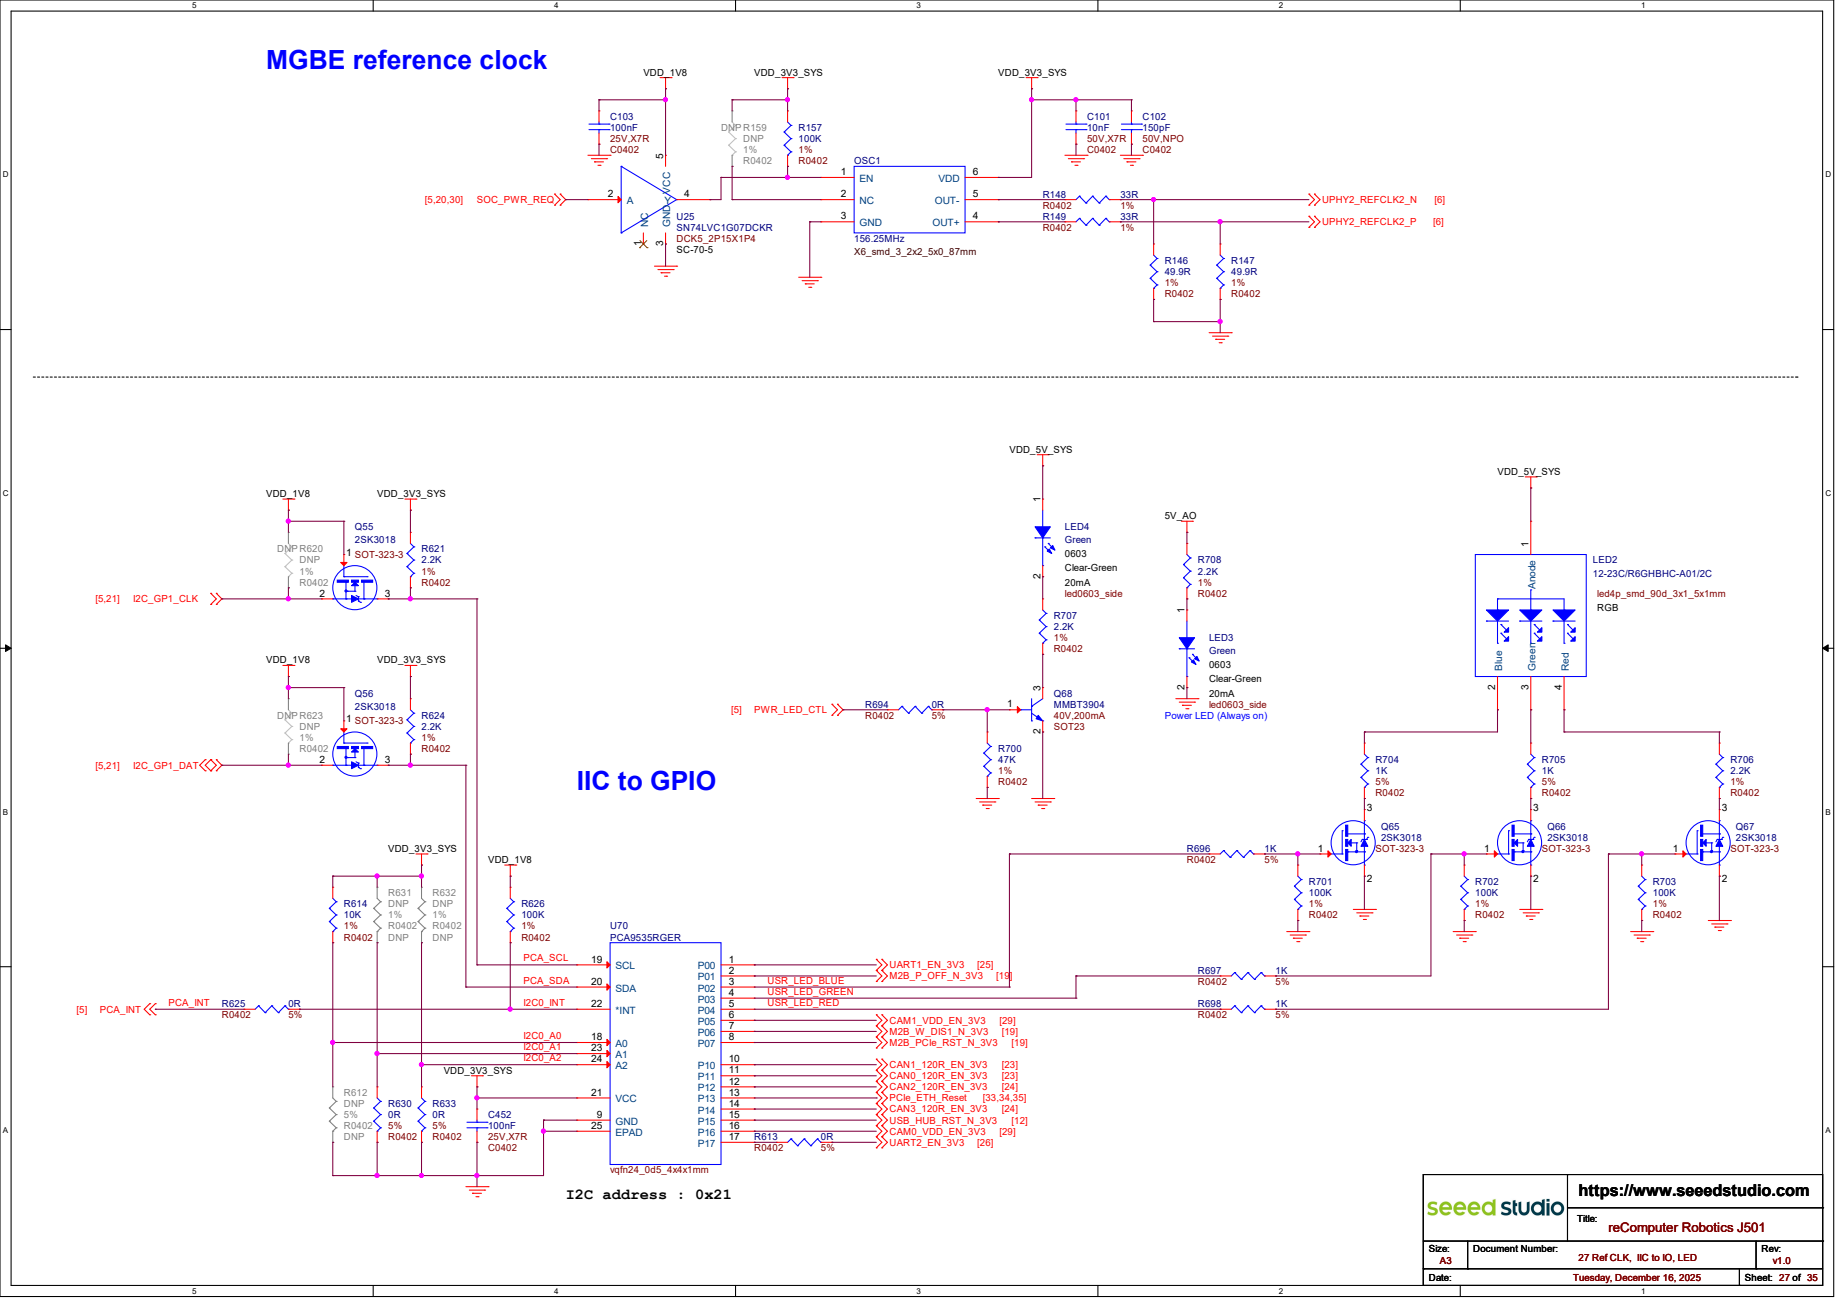
[picture p234: page 27]

Power LED (Always on) VDD_3V3_SYS

reComputer Robotics J501 27 Ref CLK, IIC to IO, LED

# Digital Outputs (DO) rated 40V/0.2A Digital Inputs (DI)

# VDD_1V8 VDD_1V8 VDD_1V8

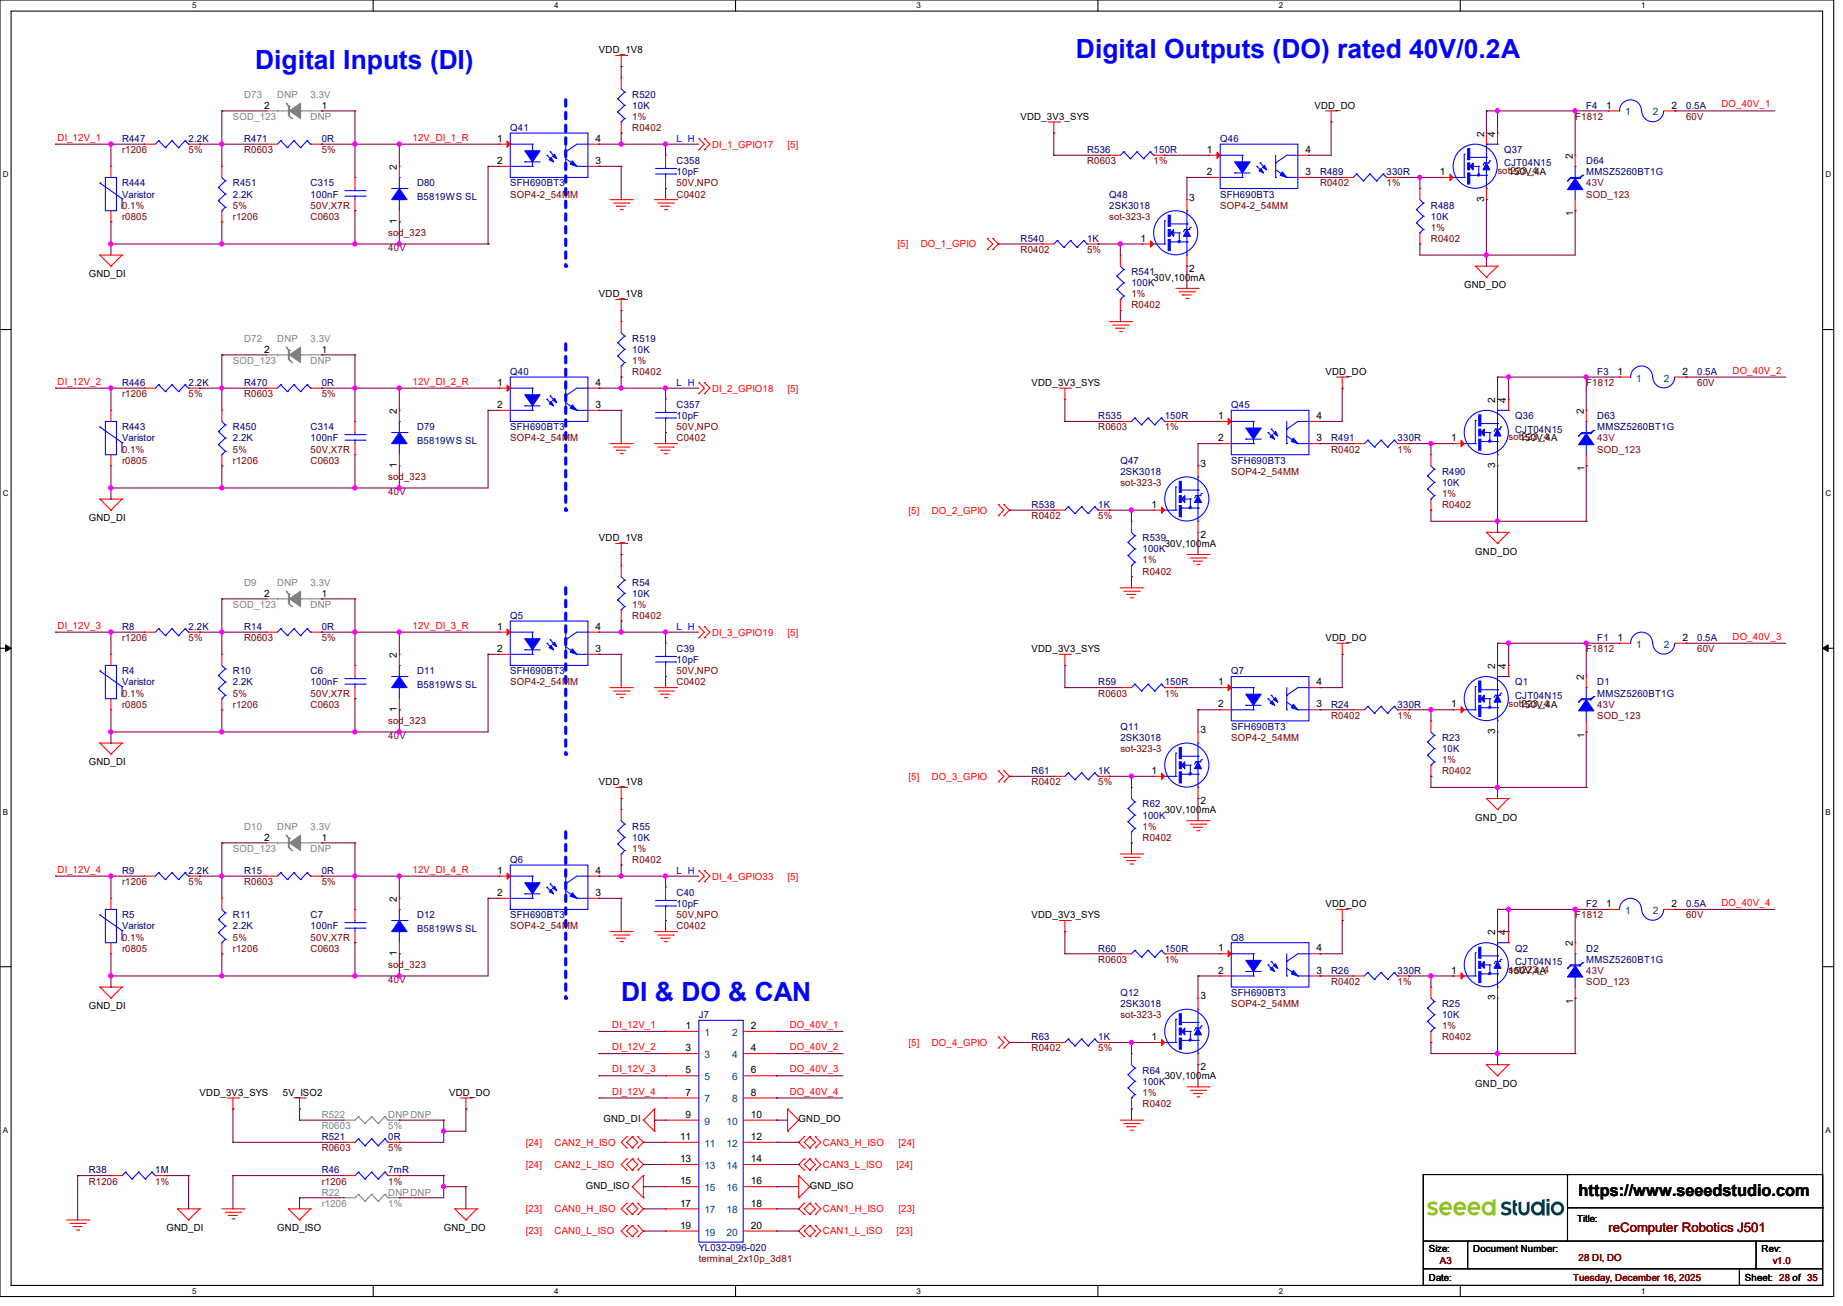
[picture p235: page 28]

reComputer Robotics J501 28 DI, DO

CSI_1_CLK_P | [6] CSI_1_D1_P | [6] CSI_3_D0_P | [6] CSI_3_D1_N | [6] CSI_1_D1_N | [6] CSI_3_CLK_N | [6] CSI_1_D0_N | [6] CSI_1_CLK_N | [6] CSI_3_D1_P | [6] CSI_1_D0_P | [6] CSI_3_D0_N | [6] CSI_3_CLK_P | [6]

# J22 QSH-030-01-L-D-A

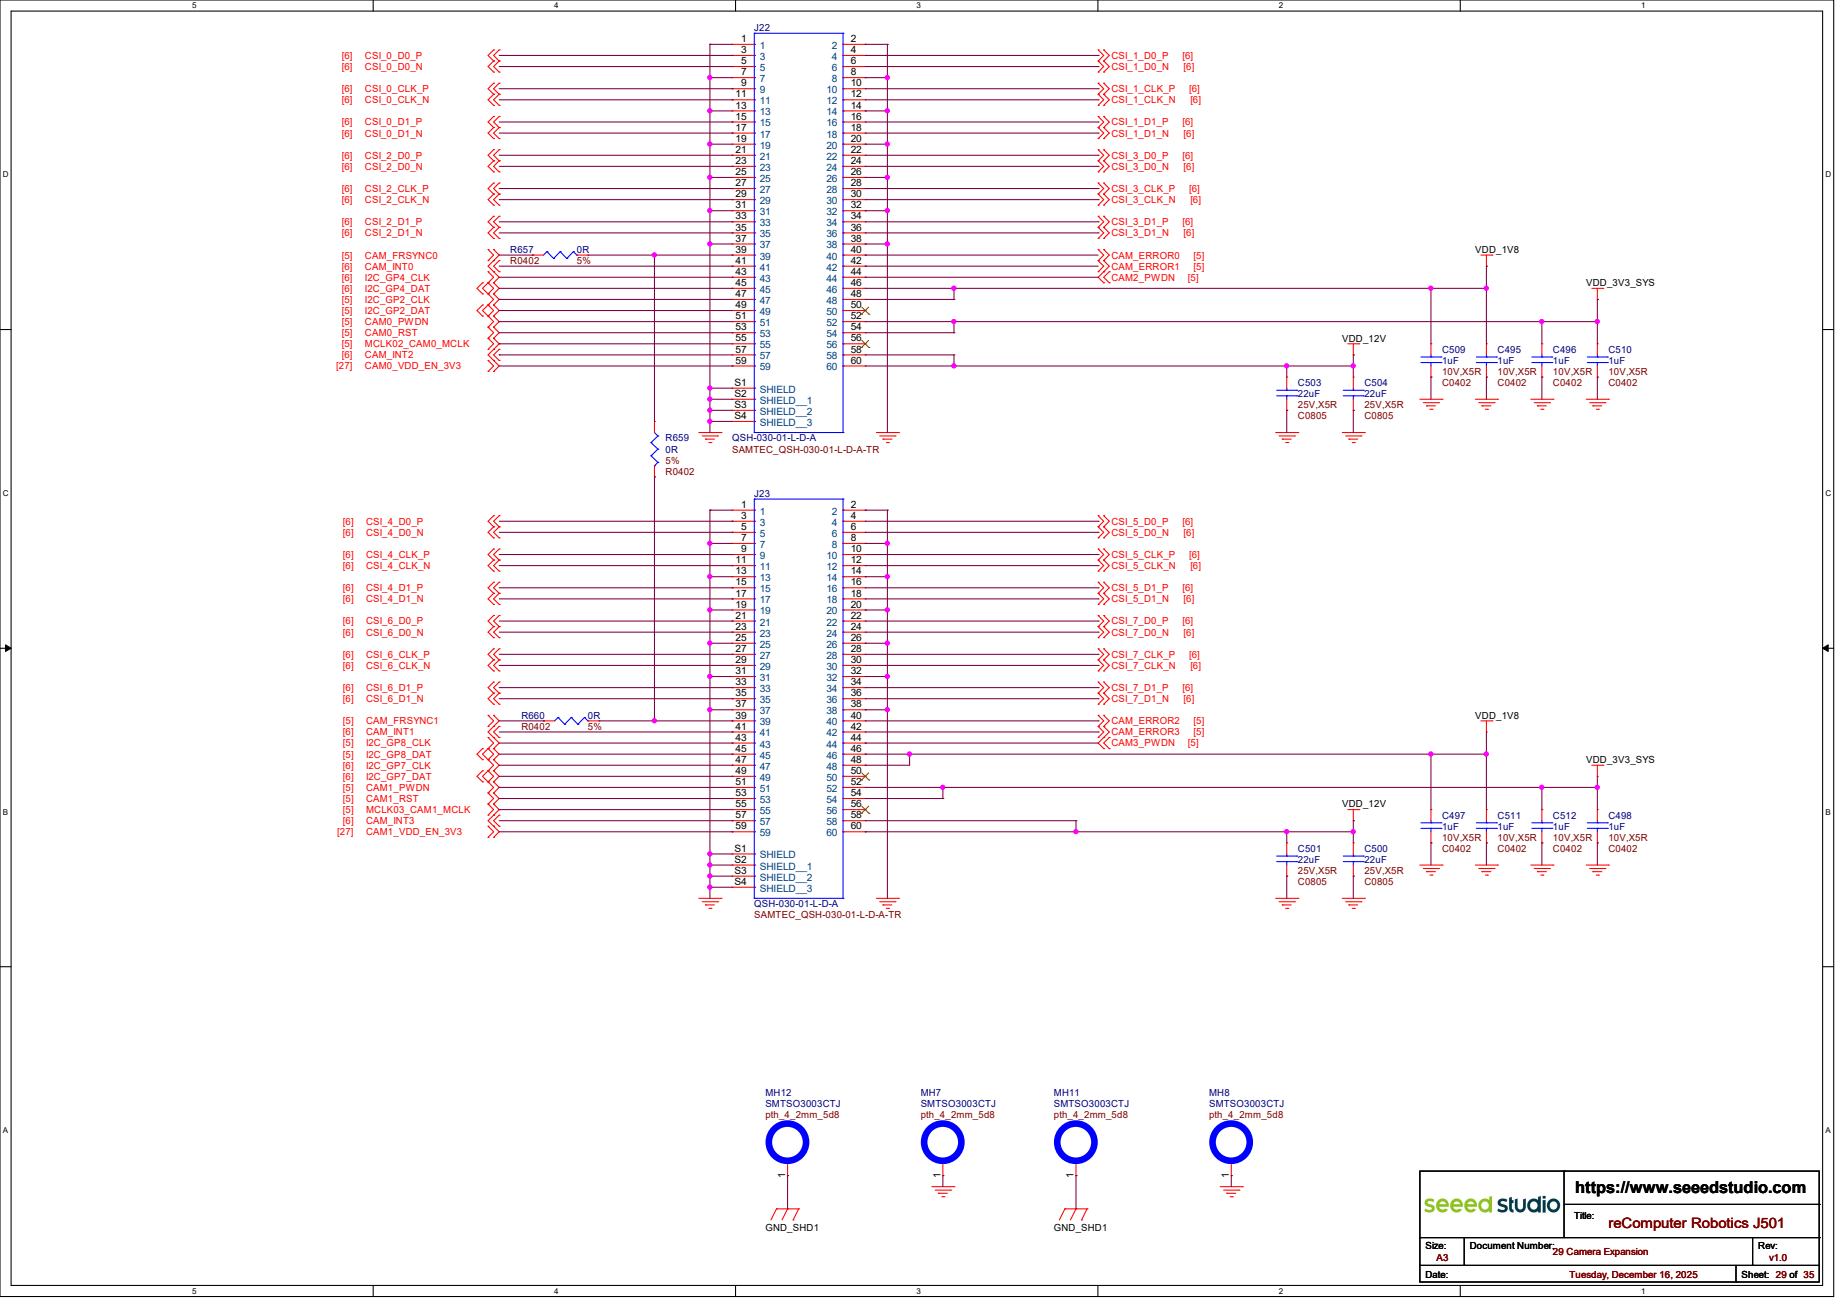
[picture p236: page 29]

# Isolated DCDC 5V to 5V

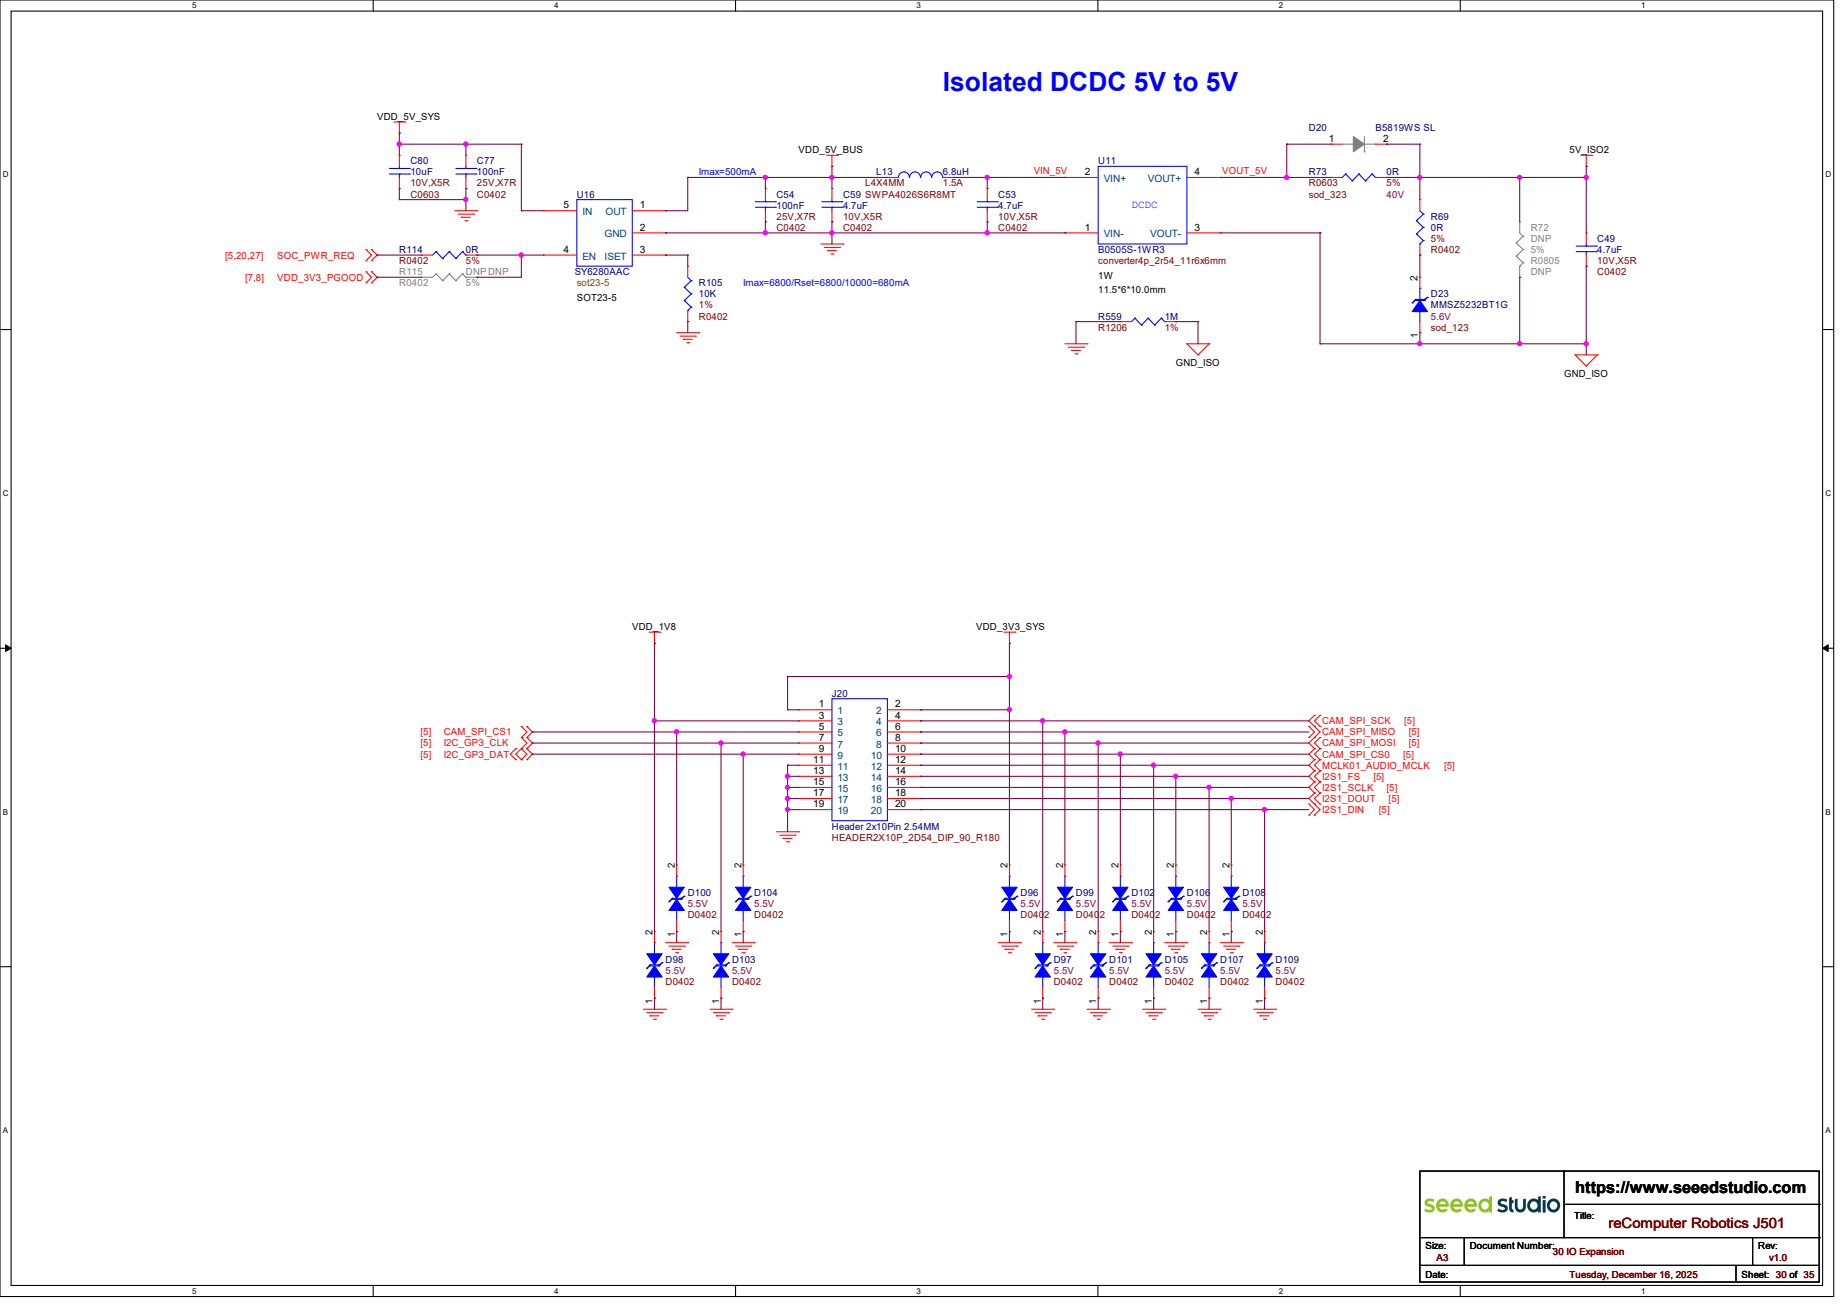
[picture p237: page 30]

VSS1 2 VSS2 4 VSS3 11 VSS4 12 VSS5 30 VSS6 32 VSS7 34 VSS8 41 VSS9 50 VSS10 56 VSS11 61 VSS12 63 VSS13 66 VSS14 87 VSS15 90 VSS16 95 VSS17 104 CGND1 109 CGND2 112 VSS20 120 VSS21 126 VSS22 129

VDDC1 3 VDDC2 23 VDDC3 29 VDDC4 31 VDDC5 40 VDDC6 55 VDDC7 62 VDDC8 65 VDDC9 91 VDDCAUX1 13 VDDCAUX2 14 VDDA2 105 VDDA1 99 VDDA3 108 VDDA4 119 VDDA5 125 AVDDH 113 VDDR1 1 VDDR2 8 VDDR3 49 VDDR4 64 VDDR5 79 VDDR6 82 VDDR7 84 VDDR8 96 VAUX 15 NC_1

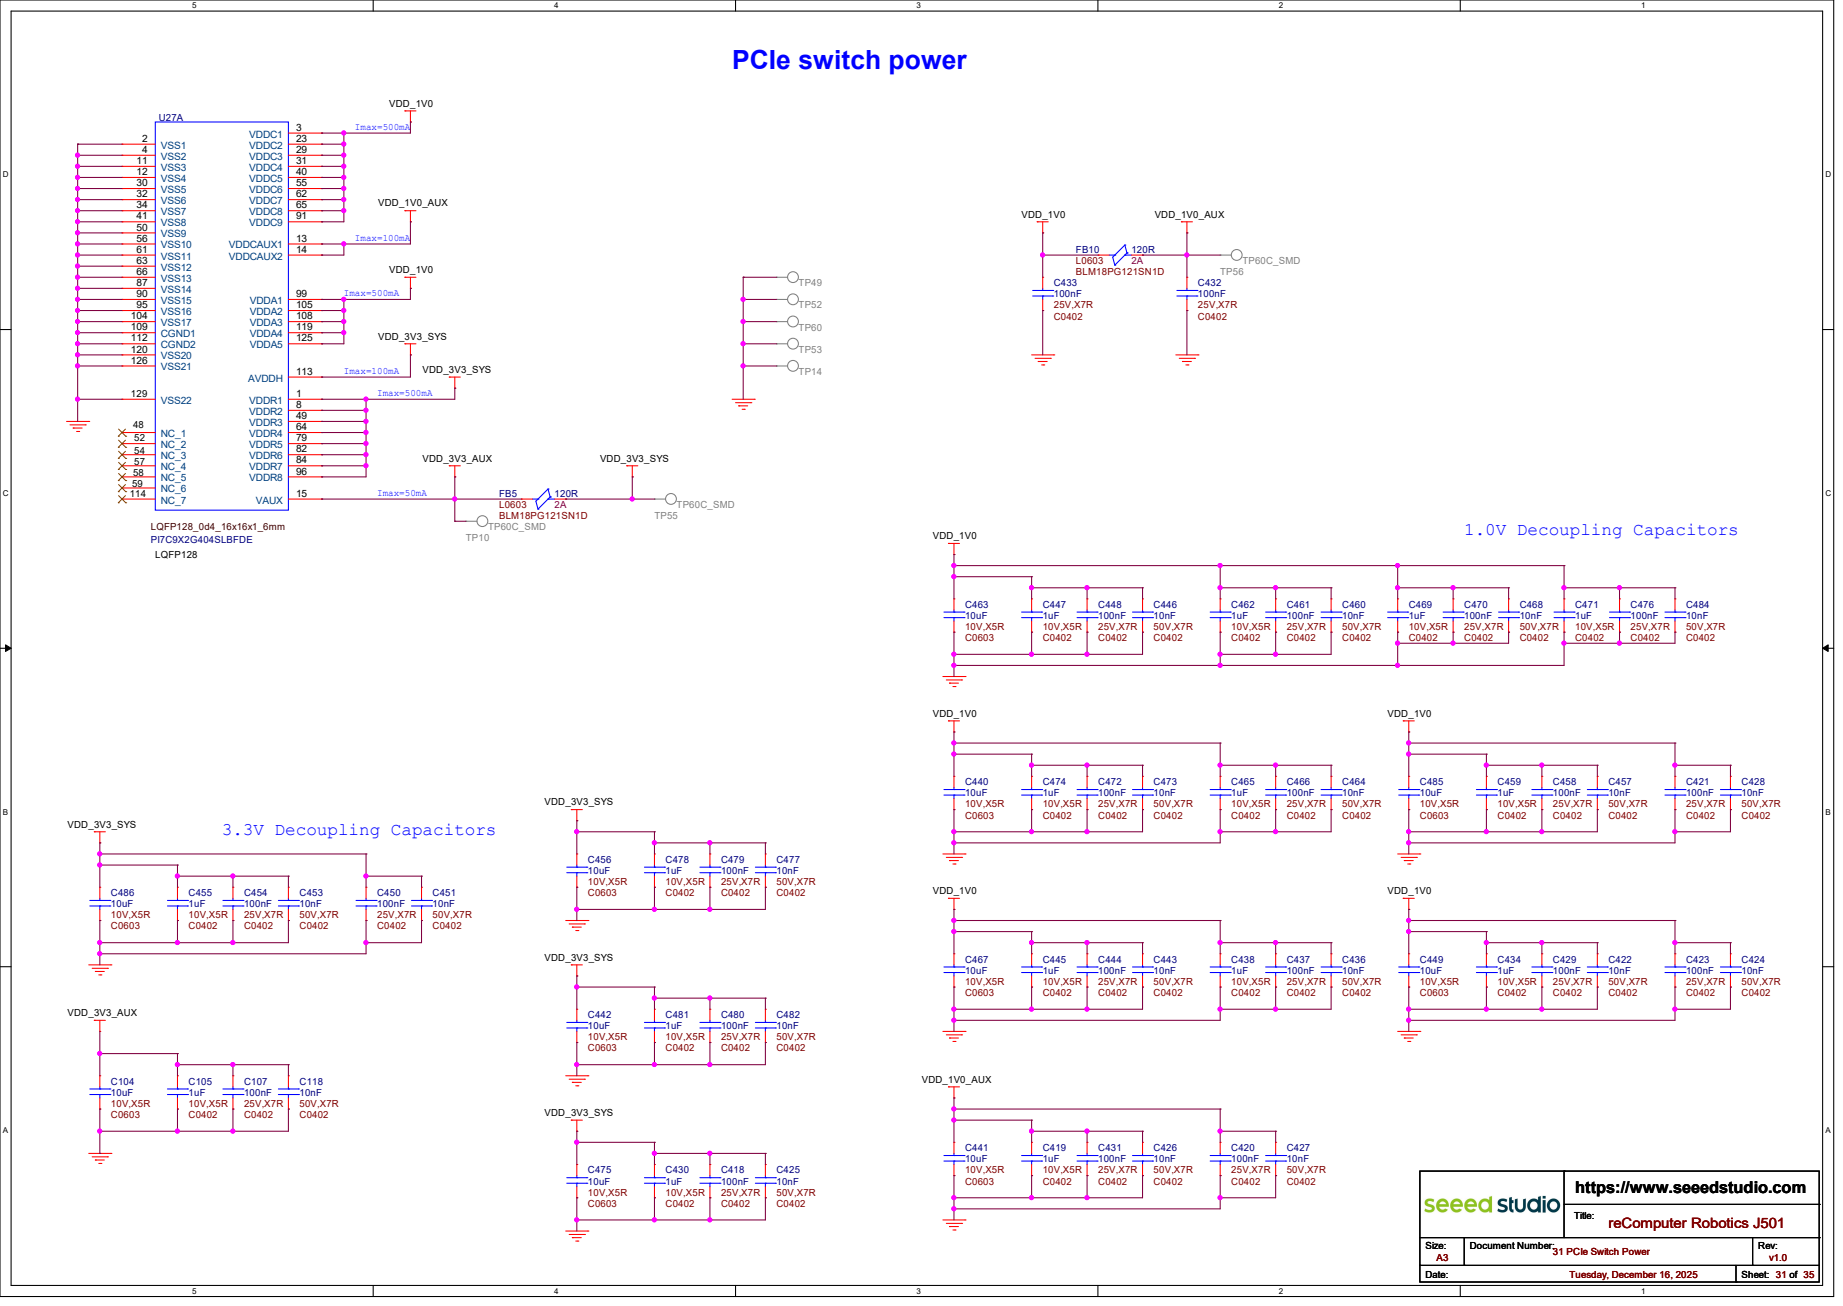
[picture p238: page 31]

# STRAP PIN SETTING

# PCIe switch IO

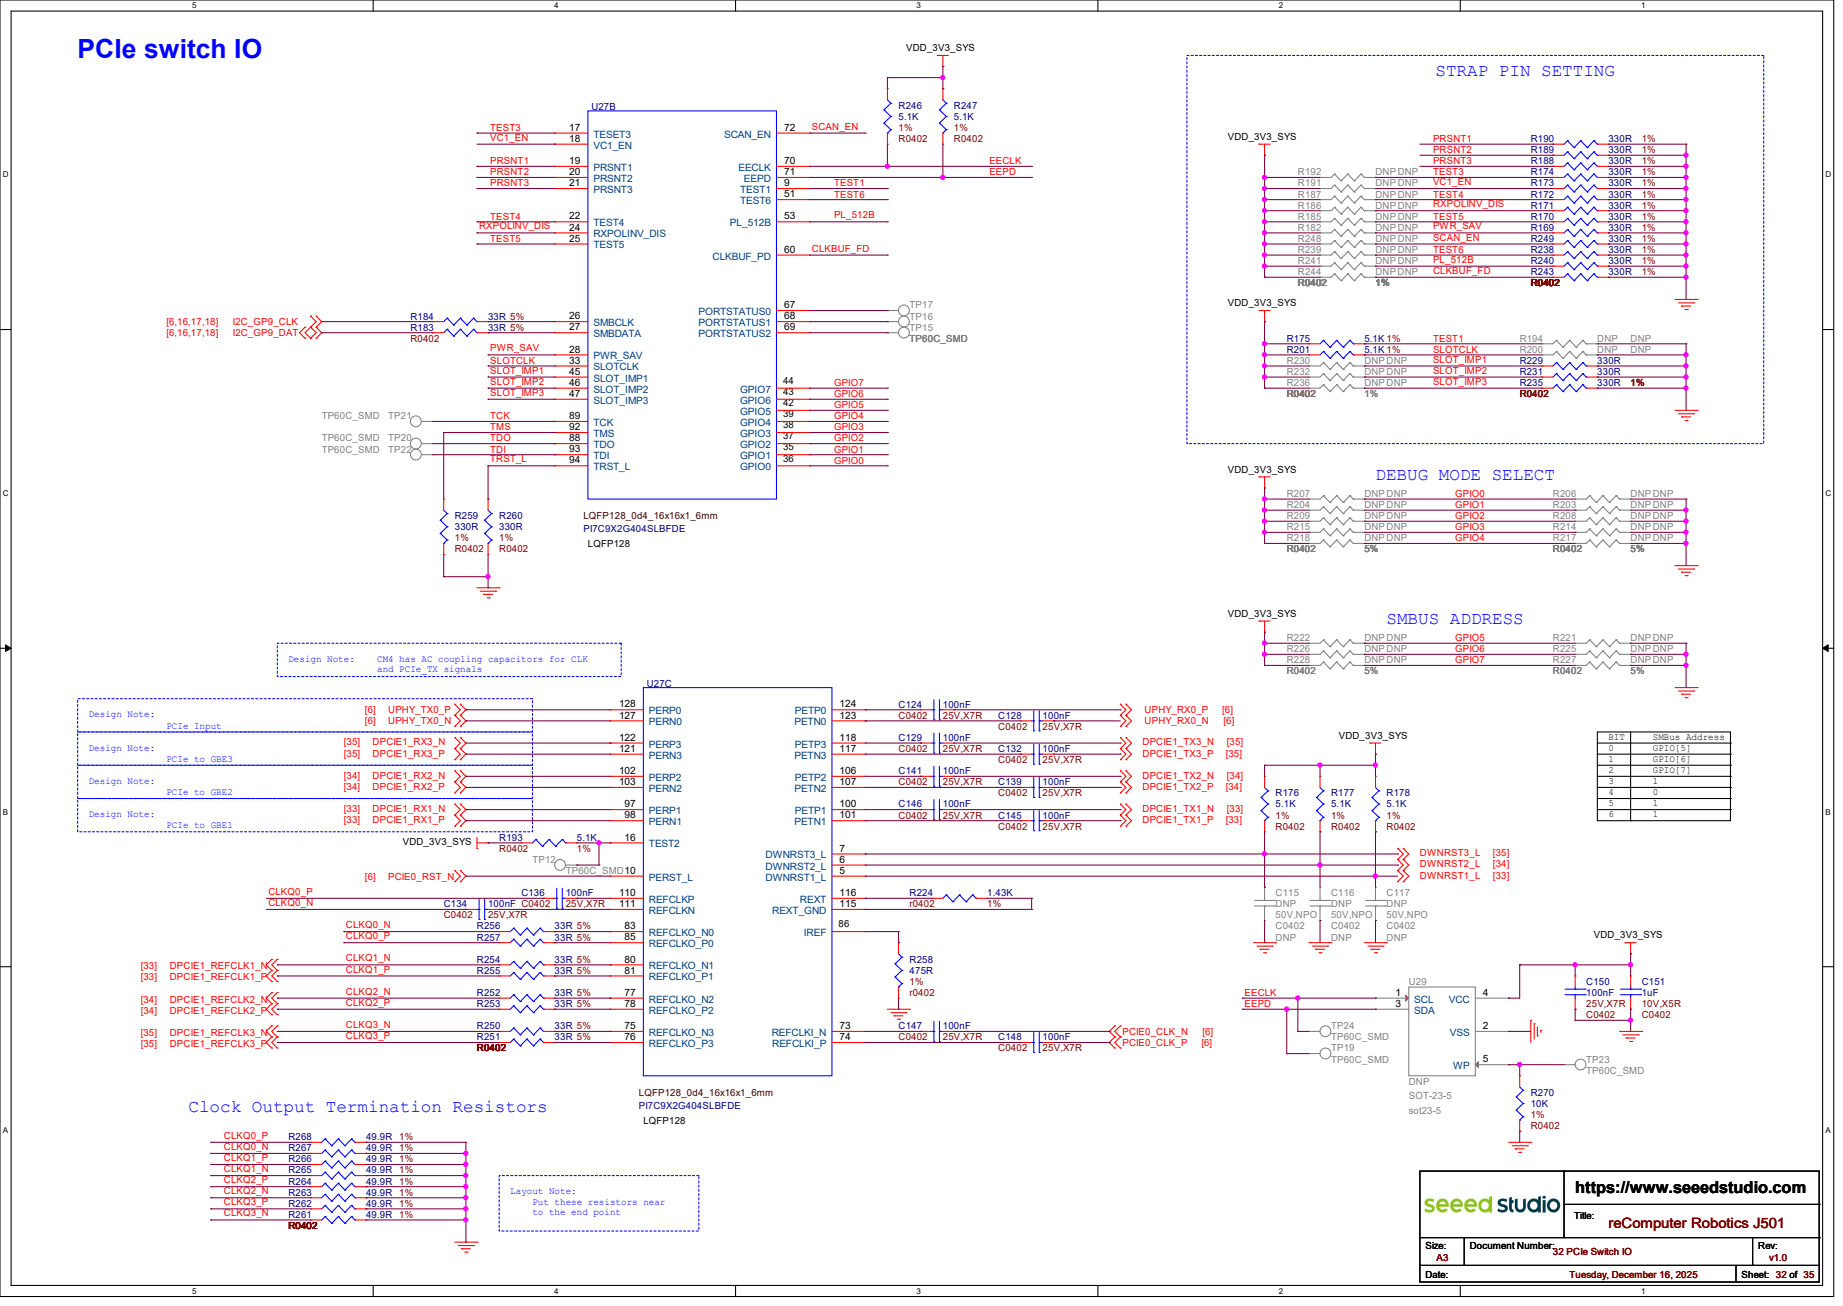
[picture p239: page 32]

Clock Output Termination Resistors

Layout Note:
Put these resistors near
to the end point

# PCIe to Ethernet

## 1 of 2 U36A

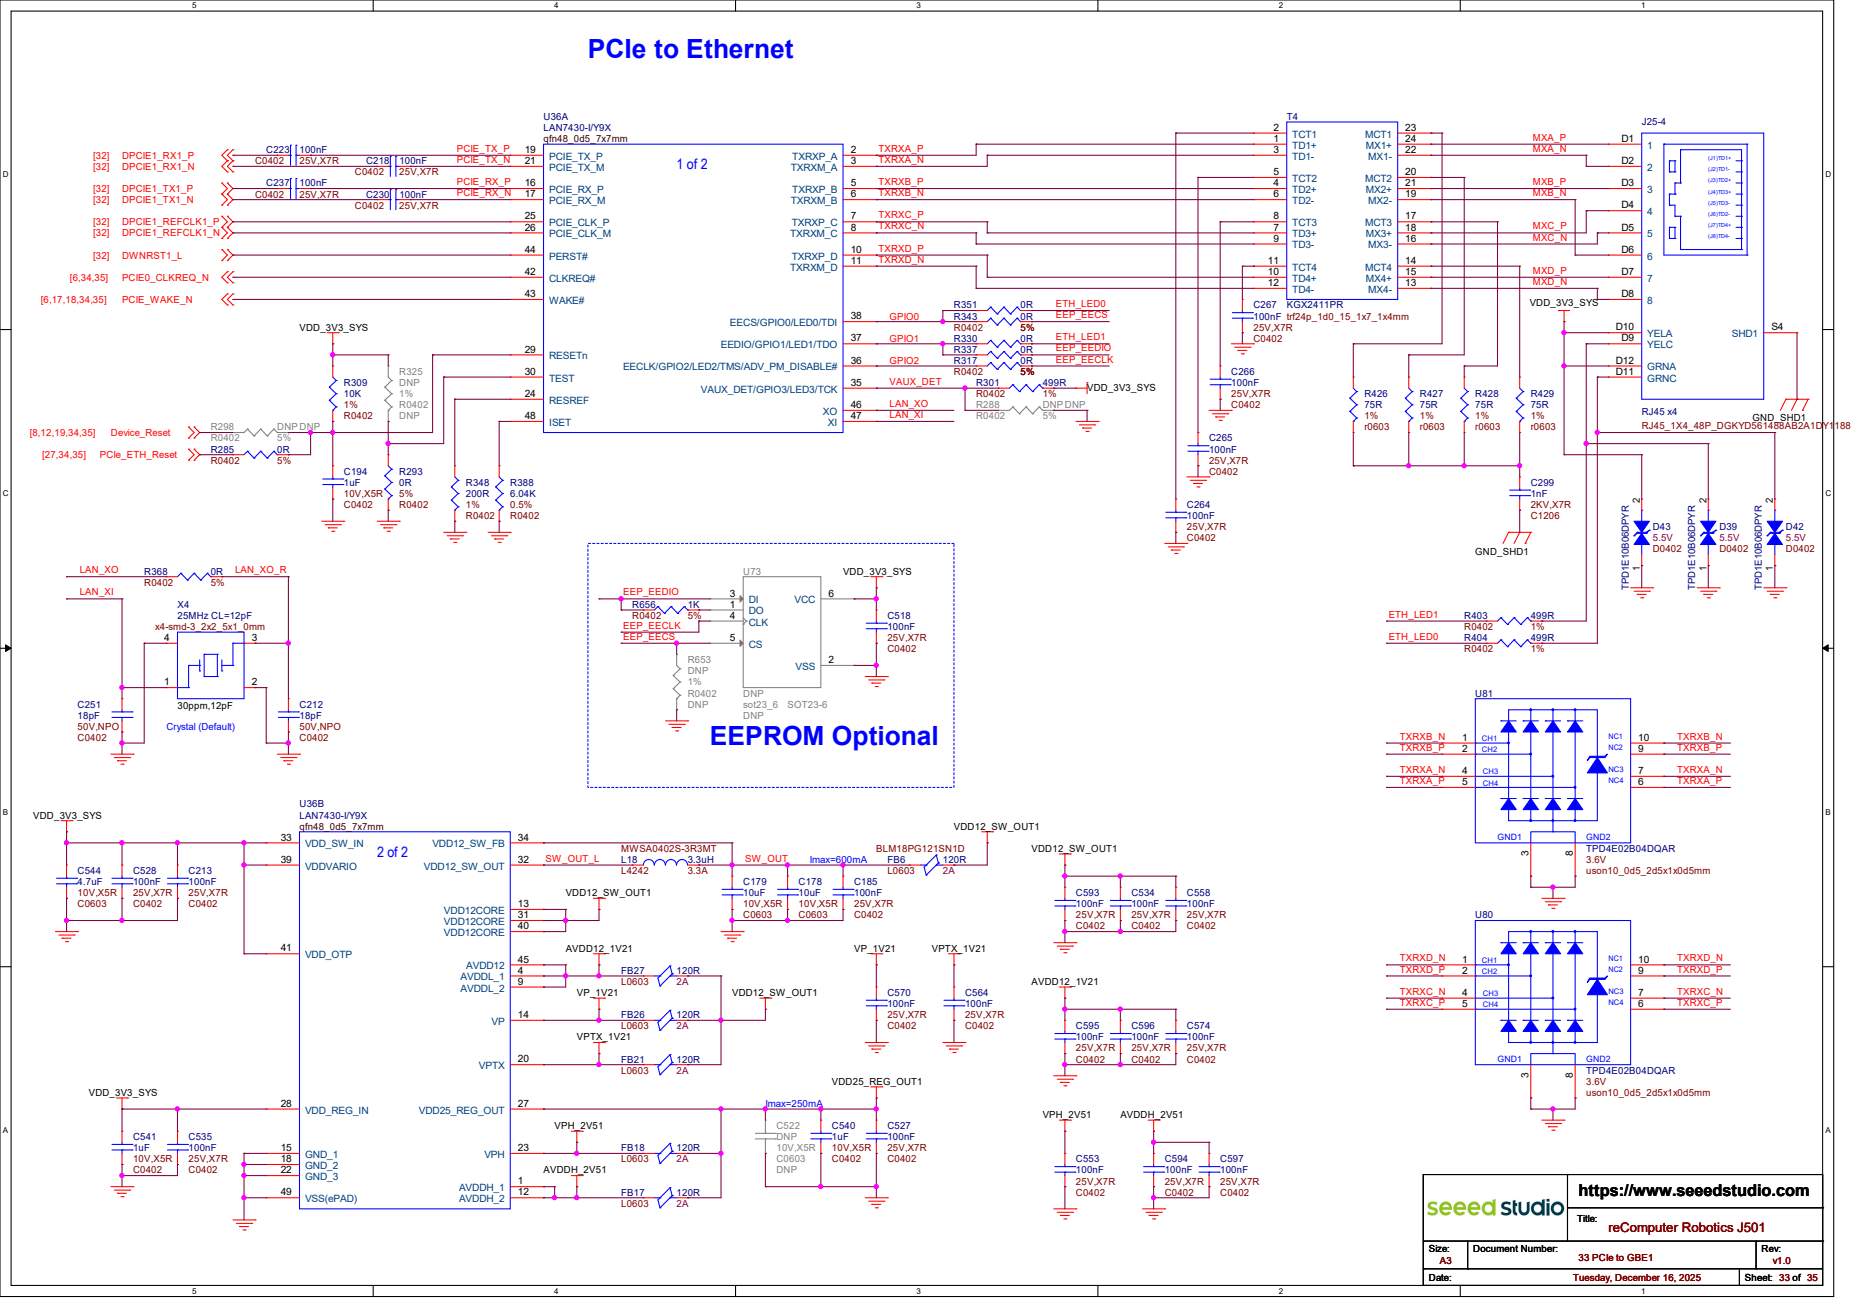
[picture p240: page 33]

LAN7430-I/Y9X
qfn48_0d5_7x7mm
RESETn 29 TEST 30 PERST# 44 PCIE_CLK_P 25 PCIE_CLK_M 26 PCIE_TX_P 19 PCIE_TX_M 21 PCIE_RX_P 16 PCIE_RX_M 17 CLKREQ# 42 WAKE# 43 RESREF 24

reComputer Robotics J501 33 PCIe to GBE1

# PCIe to Ethernet

## 1 of 2 U37A

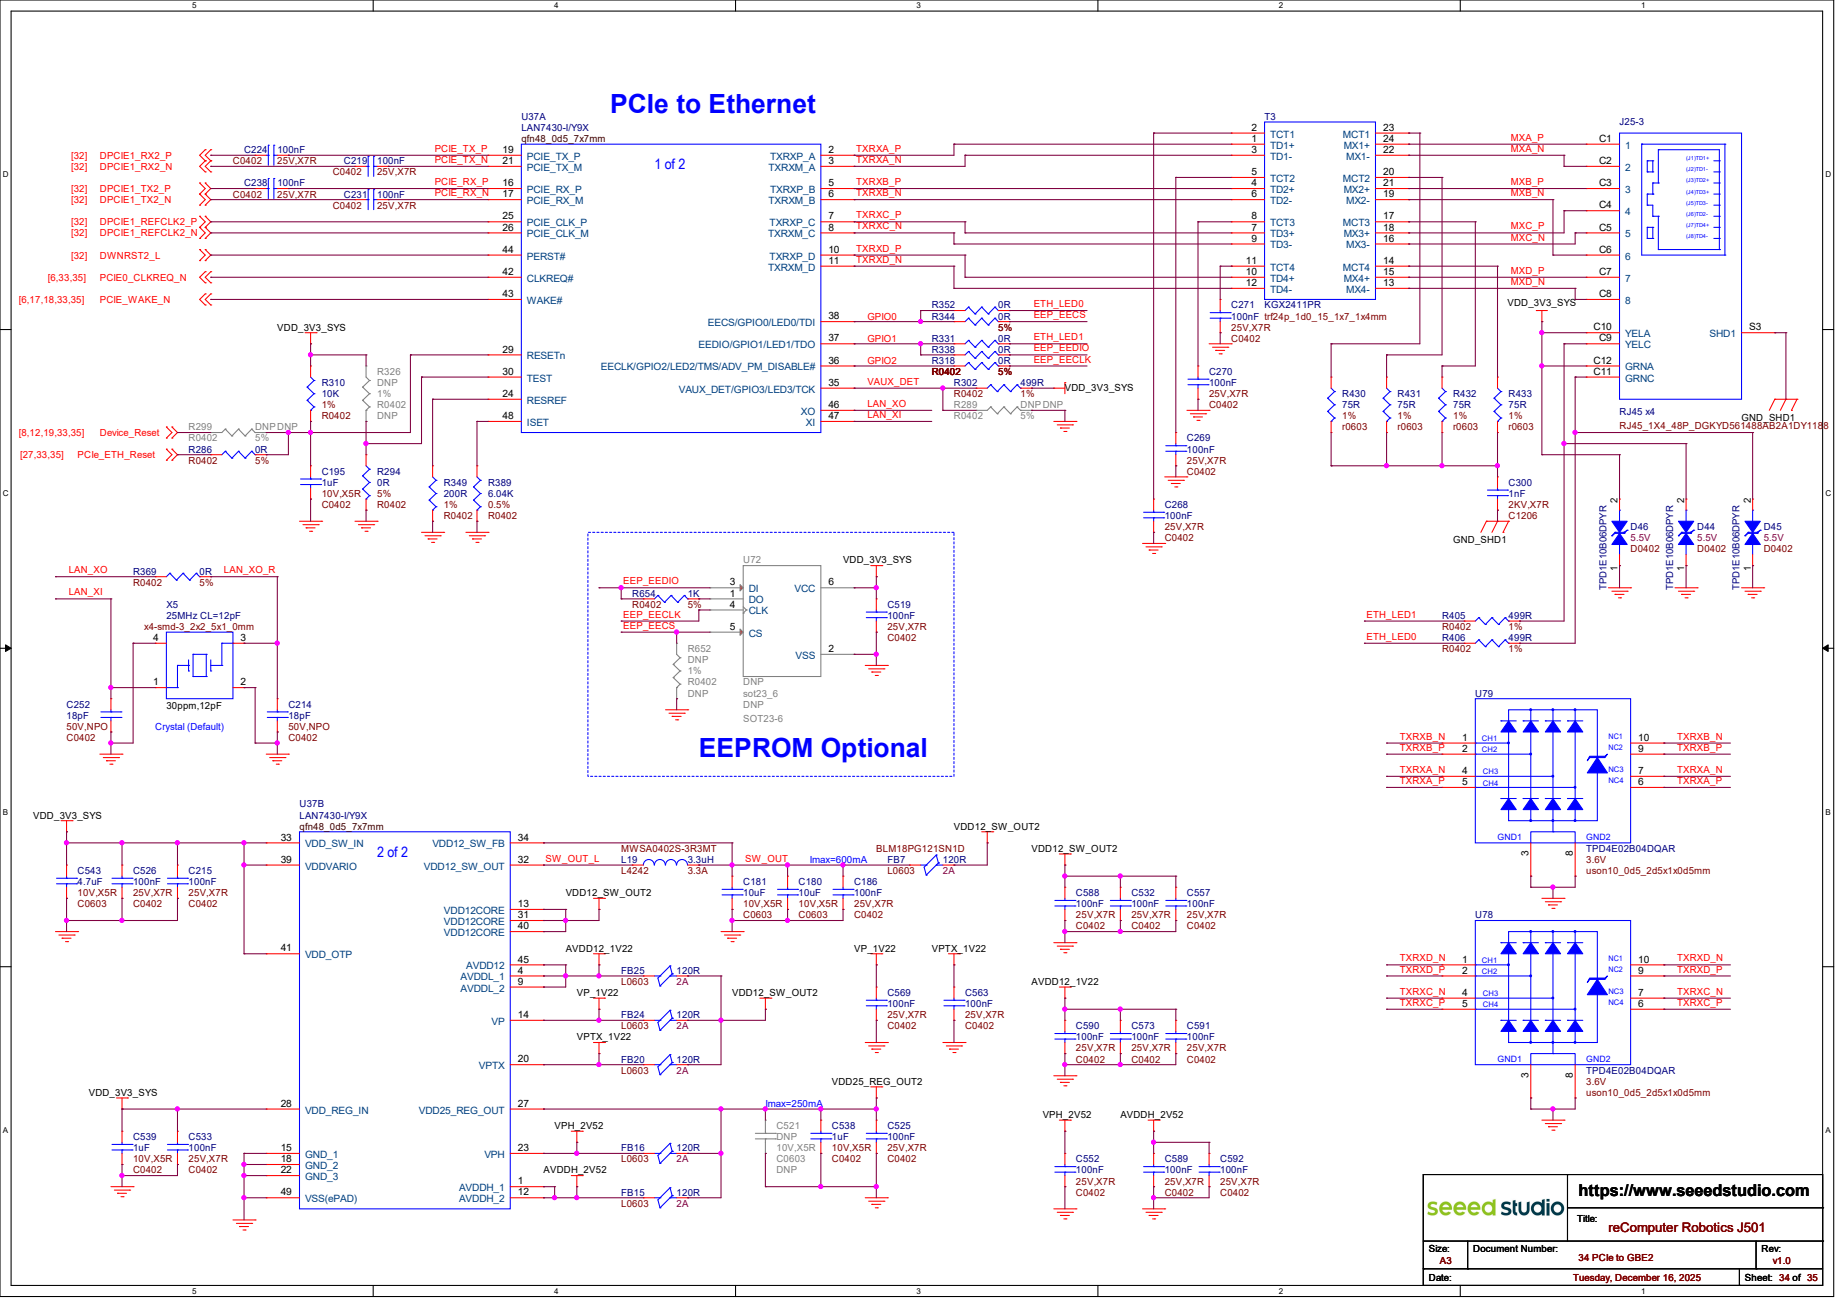
[picture p241: page 34]
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

reComputer Robotics J501 34 PCIe to GBE2

# PCIe to Ethernet

# T2KGX2411PR

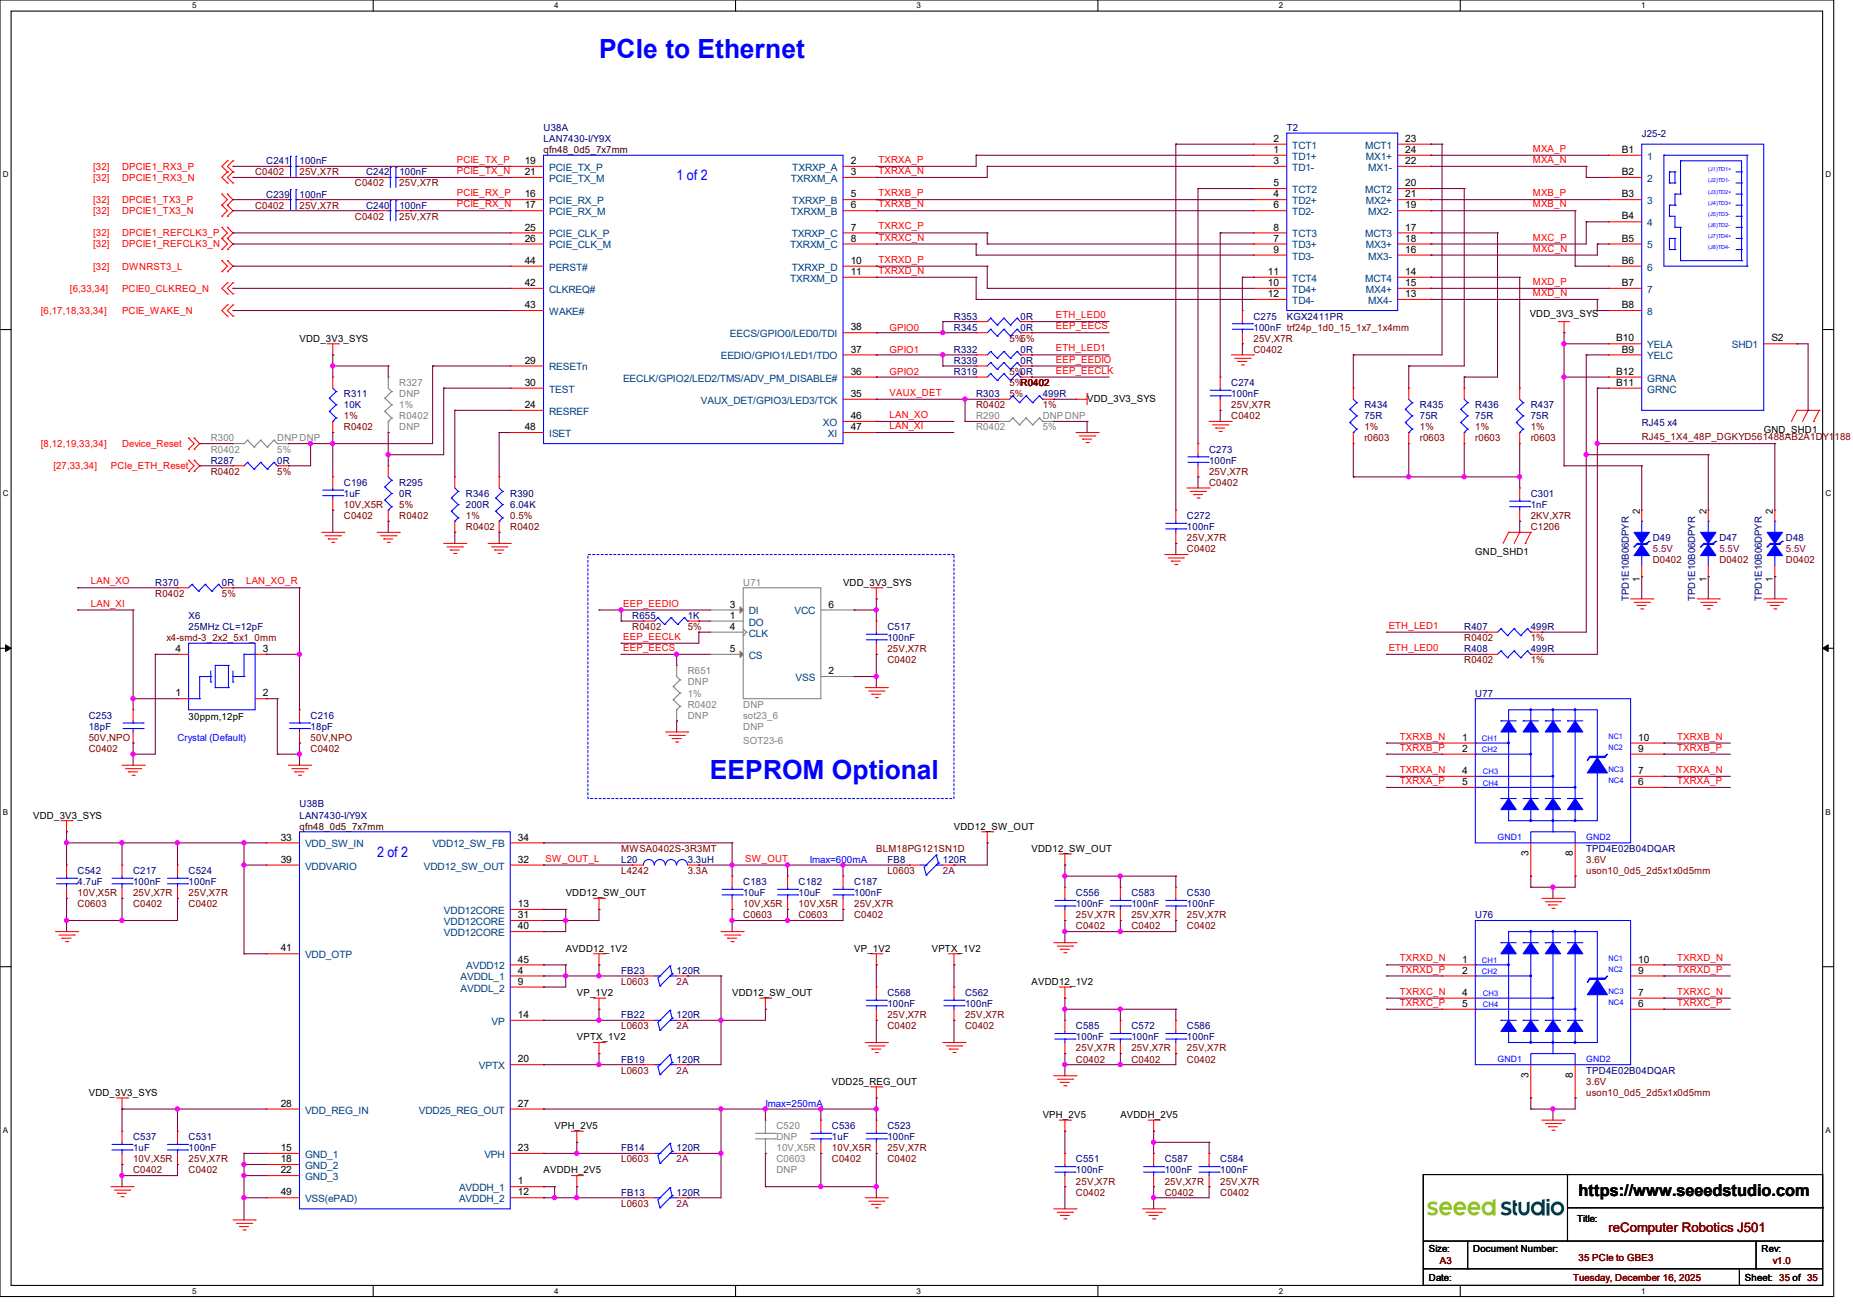
[picture p242: page 35]

reComputer Robotics J501 35 PCIe to GBE3
