Seeed-Studio/OSHW-Jetson-Series/reComputer Jetson carrier board/reComputer Robotics J601/Schematic/reComputer J601 Carrier Board_V1.0_SCH_260612.pdf

# 01 Table of Contents

02 | Block Diagram

SHEET NAME; DESCRIPTION; Revision History; VER; DATE; REVISION; Title: Size:; Document Number:; Rev: Draw By:; Date:; Sheet:; https://www.seeedstudio.com A3; V1.0 Seeed; Friday, June 12, 2026; reComputer J601 Carrier Board 01 Table of Contents Title: Size:

reComputer J601 Carrier Board
SHEET

V1.0 | 06/12/2026 | reComputer J601 Carrier Board_V1.0_SCH_260612 | Initial Version.

03 Power Tree
04 | CVM Connector 1/3
05 | CVM Connector 2/3
06 | CVM Connector 3/3
07 | Power In, 5V_AO, 3V3_AO
08 | Power VDD_VIN_HV, 1V8
09 | Power 12V, 3V3
10 | Power 1V15, 0V7, 1V, 1V8, 2V
11 | Button MCU For Power Up
12 10G Ethernet 1/4
13 | 10G Ethernet 2/4
14 | 10G Ethernet 3/4
15 | 10G Ethernet 4/4
16 | Type-C, Debug UART
17 | USB 3.2 HUB -OK
18 | USB 3.2 Type-A x2 (A)
19 | USB 3.2 Type-A x2 (B)
20 | Display
21 | M.2 Key M (NVMe)
22 | M.2 Key E (WiFi/BT)
23 | M.2 Key B (4G/5G)
24 | SPI to CAN x2
25 | CAN0, CAN1
26 | CAN2, CAN3
27 | RS485
28 | RS232/422/485
29 | Audio
30 | Ref CLK, IIC to GPIO, LED
31 | Fan, EEPROM, Debug, Button
32 I2S, I2C
33 | GPI, GPO

Camera Expansion

reComputer J601 Carrier Board 01 Table of Contents

# reComputer J601 Carrier Board Block Diagram

# Power Subsystem

USB2.0 Type C Debug; USB3.0 Type C Recovery; HDMI; M.2 Key-M NVMe + 32.768KHz M.2 Key-E; WiFi/BT + 32.768KHz; PMIC_BBATT; SYS_VIN_HV SYS_VIN_MV; USB2_0 UPHY0 Lane 1 UPHY0 Lane 20 USB2_3; UPHY0 Lane 3 PCIe1_CLK; SYS_RESET*; FORCE_RECOVERY; PWM Tach; Mux; UART3_DEBUG; UART1 CAN[3:2] x2; HDMI_DP2_TXx; DP2_AUX_CH DP2_HPD HDMI_CEC; UPHY1 L4 (MGBE) XFI0 MDC/MDIO XFI0 INT/RST; RS232/422/485 Transceiver; JTAG; JTAG Header; QSPI NOR; LPDDR5x Thermal Sensor; Carrier Board; Interface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

Jetson Thor CVM
699-PIN

Reverse Protection & FETs & Regs

SSD LED Option (NC)

USB to UART Bridge USB 3.2 HUB + Crystal 25MHz

I2S1 PCIe Control USB2_2 UART5 GPIOs UPHY1 Lanes [3:0]
PCIe5_CLK
PCIe Control I2C3

I2S4 Audio Codec + Crystal

10 GBE PHY + Crystal 50MHz

Internal Connector 4x CAN Transceiver

External Connector
4-CH GMSL Board

Camera Expansion Connector 2x 12V Fan Connector

CSI[3:0]
MCLK[3:2] CAM Ctrl I2C2

Crystal 25MHz
GMSL Transceiver Power

4-CH GMSL CONN

Camera Expansion Connector CSI[7:4]
MCLK[5:4] CAM Ctrl I2C9

2x SPI to CAN + Crystal 40MHz

Reset Button REC Button User LED RGB

JST 2Pin Battery CONN

I2C1 External RTC IC + Crystal 32.768KHz

reComputer J601 Carrier Board 02 Block Diagram

# 19V to 54.6V Map Legend:

# 12V DCDC VDD_12V

Carrier Board I/O Connector; Functional Circuit; 3V3 DCDC VDD_3V3_SYS 10A; USB3.2 HUB USB7206C-I/KDX; 3V3 LDO 3V3_AO 500mA; Button MCU EFM8SB10F8G; 2Pin XT30 Power In; Carrier Board; Power Circuit; 0.7V_DCDC x4; VDD_0V7_PHY 4A; 1V_DCDC VDD_1V0_PHY 2A; 1V8_DCDC VDDIO_AQR113C 2A; 2V_DCDC VDD_2V0_PHY 2A; 10GB Ethernet_4 AQR113C_B1; 10GB Ethernet_3 AQR113C_B1; 10GB Ethernet_2 AQR113C_B1; 10GB Ethernet_1 AQR113C_B1; USB Type-A x4; VDD_VBUS*2; 5Gbps ⁵V/0.9A*4=3.6A; M.2 Key-M NVMe M.2 Key-E; WiFi/BT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

CSI Expansion CONN1 CSI Expansion CONN2

699 Pin BTB CONN

Jetson Thor CVM

BTB Connector Carrier Board

IIC to GPIO
PCA9535RGER

SPI to CAN x2 MCP2518FDT ³.3V/20mA*2=40mA

Fan Header x2 Option 5V

reComputer J601 Carrier Board 03 Power Tree

# CVM Connector 1/3

# Imax=22A@9V VDD_5V_SYS


# CVM Connector 2/3

XFI0_RST_N [12] UART2_RXD [27] UART2_TXD [27] UART2_RTS [27] UART5_RTS [22] UART5_TXD [22] UART5_RXD [22] UART5_CTS [22] XFI2_INT_N [14]


bootchain_sel SMCU drive it accordingly

To JST/Pin Header

E7: Int Pull up 4.7K to 1.8V

H60: to SMCU in devkit, not used, default 0 (10K PD).

I2C1, To EEPROM and IIC to GPIO

GPIO38, GPIO42, GPIO17, GPIO37: DRAM configuration, GPIO 3V3 Output only
These pin statuses are subject to change and are not recommended for use as GPIO

A55: Int Pull up 1K to 1.8V

B55: 1V8 input, OD, 1.8V 10K Pull up in the module.
To SMCU in devkit, not used, default 1.

To ALT I2C_DAT_MGBE_3V3, Not Used

reComputer J601 Carrier Board 05 CVM Connector 2/3

# CVM Connector 3/3

# CSI_0_CLK_N [34] CSI_4_D0_N [34] CSI_4_CLK_P [34] CSI_7_CLK_N [34]


To M.2 Key-M (PCIe TX)
PCIe x4 (C5), DM

PCIe2 TX, To 5Gb Eth NIC in NVIDIA Carrier Board

To 10G ETH (MGBE, TX)

UPHY2, Not used, To SMCU in NVIDIA Carrier Board
FSI SGMII (only IGX T5000 supports)

HDMI_DP2
To Type C in NVIDIA Carrier Board

UPHY0 6:7 TX
To "UFS - M.2 Key M Connector" in NVIDIA Carrier Board

To M.2 Key-M (PCIe RX)

To HDMI in NVIDIA Carrier Board

To 10G ETH (MGBE, RX)

I2C7, To M.2 Key-E(NC) and Audio

PCIe2 RX, To 5Gb Eth NIC in NVIDIA Carrier Board

To M.2 Key-M (PCIe CLK)

To M.2 Key-E (PCIe TX)

I2C0, To RTC, USB3.2 HUB, IIC to GPIO

UPHY0 6:7 RX

PCIe2 CLK, To 5Gb Eth NIC in NVIDIA Carrier Board
A6 FSI_GPIO28_I2C6_CLK
J11 DP_AUX_CH3_N

To DP in NVIDIA Carrier Board

To M.2 Key-E (PCIe RX)

I2C4, To Ext JST I2C (HDMI_DP2, To Type C Host only in NVIDIA Carrier Board)

HDMI_DP3(I2C 8), To Type C RCM in NVIDIA Carrier Board

GPIO 3V3 Output only PD
I2C_GP0_INT_RTC

A38: Pulled up 47K to 3.3V in module

L58: input, A 10K pull-up to 1.8V is on the module.
[7,11] VIN_PWR_BAD_N
TP35S_SMD Test Point TP53
[8,9,11] CARRIER_POWER_ON
[11] MODULE_POWER_ON

PCIe x8 C5 to PCIe CEM

L56: output, A 10K pull-up to 3.3V is on the module.

VM_XX: Voltage Management,
can't be used if without SMCU, set NC.

G59: Pulled up(DNP) to 3V3_AO in Devkit, to SMCU.

1.25mm pitch notebook wired RTC coin battery

reComputer J601 Carrier Board 06 CVM Connector 3/3

# Vin Protection 100uF x3 =300uF


Design Note:
VIN_PWR_BAD_N: A 10kΩ pull-up to 5V is on the module.

=0.95V*(1+100K/6.49K) MIN: VDD_DCIN = Ven*(1+R514/R532) Pin20 Enable Control Pin: =1V*(1+100K/6.49K)
VIN UVLO: VDD_DCIN=Ven*(1+R514/R532) TYP: VDD_DCIN = Ven*(1+R514/R532) =17.2287V

Pull up R To VDDA

49.9 kΩ | External FB divider setting 12 V Not installed

reComputer J601 Carrier Board 07 Power In, 5V_AO, 3V3_AO

# Input Control Sequence: Power On : MV -> HV


Power Off: HV -> MV

Vout External FB divider setting Pull up R To VDDA

There is no power good of VDD_5V_SYS, so used VDD_5V_SYS instead of PG.

Not installed

For testing without CVM, can set CVM_PRSNT_N=0 (R278=0R).

1. DNP in Thor, but installed in AGX Orin, TBD.

reComputer J601 Carrier Board 08 Power VDD_VIN_HV, 1V8

# 48V to 12V, Imax=10A

# VDD_12V


Vout External FB divider setting Pull up R To VDDA

Not installed

reComputer J601 Carrier Board 09 Power 12V, 3V3

# 5V to 1.15V For USB3.2 HUB

# VDD_1V15_HUB Discharge


Note: VCORE should rise after or at the same time as VDD33.

PHY AQR113C Power-Up Sequence Requires:
If VDD_IO is 1.8V: VDD -> 1.0V -> VDD_IO -> 2.0V, Default.
If VDD_IO is 3.3V: VDD -> 1.0V -> 2.0V -> VDD_IO.

reComputer J601 Carrier Board 10 Power 1V15, 0V7, 1V, 1V8, 2V

# Debug - C2

# Button MCU For Power Up


Present 1: Tied to one side of the power button on the carrier board refer to the Design Guide.
But not connected on the Jetson T5000 Carrier Board Reference Desing Files in fact.

power on when see 1->0->1

10k pulldown to minimize the glitch during POR

Can be removed if has not WOL.

Option 1: Similar to "Jetson AGX Thor Carrier Board" + Removed WOL

Option 1.1: Programmable-Delay IC

MR is internally tied to VDD by a 90-kΩ pull-up resistor.

R81=100K: Accelerate discharge for fast power off and auto-On
R78=0R: Reserve debounce ability

DFT For EVT testing without CVM, can
set CVM_PRSNT_N=0 (R278=0R)

Option 2: Similar to "Jetson Orin NX Carrier Board"

reComputer J601 Carrier Board 11 Button MCU For Power Up

# 10GB Ethernet 1/4

# 16 TD1+


MDIO: Pulled up 1.5K to 1.8V in module VDDIO_AQR113C

MDIO Address: ADDR3=0, Address=4'b0000 (0x0 hex)

When operating VDD_IO at 1.8V a 10K pull-up resistor should be used on
the SIN pin to ensure that the device can reliably detect a missing flash device.
When operating VDD_IO at 3.3V, the 10K pull-up resistor is required.

reComputer J601 Carrier Board 12 10G Ethernet 1/4

# 10GB Ethernet 2/4

# 16 TD1+


MDIO: Pulled up 1.5K to 1.8V in module VDDIO_AQR113C

MDIO Address: ADDR3=1, Address=4'b1000 (0x8 hex)

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

# 10GB Ethernet 3/4

## 1588 CLOCK / SYNC-E


MDIO: Pulled up 1.5K to 1.8V in module VDDIO_AQR113C

MDIO Address: ADDR3=0, Address=4'b0000 (0x0 hex)

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

reComputer J601 Carrier Board 14 10G Ethernet 3/4

# 10GB Ethernet 4/4

## 1588 CLOCK / SYNC-E


MDIO: Pulled up 1.5K to 1.8V in module VDDIO_AQR113C

MDIO Address: ADDR3=0, Address=4'b0000 (0x0 hex)

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

reComputer J601 Carrier Board 15 10G Ethernet 4/4

# USB 2.0 Type-C For Debug UART USB 2.0 to UART


reComputer J601 Carrier Board 16 Type-C, Debug UART

# USB 3.2 GEN2 10Gbps HUB x6 Ports

1 of 2 Programming SPI+SQI Utility/Test Strap | Power NC U19A USB7206CT-I/KDX


USB_HUB_Reset_1V8: From Thor GPIO, 1.8V. Design Note: USB_HUB_Reset_3V3: From IIC to GPIO, 3.3V.

U19B USB7206CT-I/KDX
I2S_MCLK(PF7) 48 NC(PF8) 49 PRT_CTL3_U3(PF10) 51 PRT_CTL4/OCS(PF14) 57 PRT_CTL3/OCS(PF15) 58 PRT_CTL2/OCS(PF16) 59 PRT_CTL1/OCS(PF17) 60 MSTR_I2C_CLK(PF18) 61 PF30/VBUS_DET

CFG_BC_EN: 200KΩ Pull-Down, No battery charging

CFG_NON_REM: 200KΩ Pull-Down, All ports removeable

reComputer J601 Carrier Board 17 USB 3.2 HUB

# USB 3.2 Type-A x2 (A)

## Imax=2.4A VDD_5V_SYS


reComputer J601 Carrier Board 18 USB 3.2 Type-A x2 (A)

# USB 3.2 Type-A x2 (B)

## Imax=2.4A VDD_VBUS_B


reComputer J601 Carrier Board 19 USB 3.2 Type-A x2 (B)

# HDMI Connector


HDMI_CEC DP0 DP2 DP3: HPD: Active High When HPD = 0, it indicates that no DP device is plugged in. HDMI_CEC=1.8V

reComputer J601 Carrier Board 20 Display

# M.2 Key M (NVMe)

## Imax=2.5A


reComputer J601 Carrier Board 21 M.2 Key M (NVMe)

# M.2 Key E (WiFi/BT)

VDD_1V8 VDD_1V8 | VDD_3V3_SYS


reComputer J601 Carrier Board 22 M.2 Key E (WiFi/BT)

# M.2 Key B (4G/5G)

NC


layout Note: Place the MH7 MH8 to the other side of M.2 Key-B connector. Must be 3.3 V tolerant for Adapters that support 1.8 V sideband signaling. Platforms that expect 1.8 V sideband signaling must protect themselves from legacy 3.3 V adapters.

reComputer J601 Carrier Board 23 M.2 Key B (4G/5G)

## VDD_3V3_SYS

VDD_1V8 | VDD_3V3_SYS | VDD_1V8 VDD_3V3_SYS | VDD_1V8 | VDD_1V8 VDD_3V3_SYS


SPI to CAN FD 8 Mbps Design Note:

Design Note: SPI to CAN FD 8 Mbps

reComputer J601 Carrier Board 24 SPI to CAN x2

# Isolated DCDC 5V to 5V/200mA

## Imax=6800/Rset=6800/5100=1.333A


Isolation Barrier: -1.25mm on top/bottom layer

-0.25mm on inner layers Design Note:

-1.25mm on top/bottom layer

# Isolated DCDC 5V to 5V/200mA

VDD_5V_BUS | 5V_ISO_2 GND_ISO_2 | GND_ISO_2 VDD_3V3_SYS


Isolation Barrier: -1.25mm on top/bottom layer
U86 TPT71044-SOBR

-0.25mm on inner layers Design Note:

-1.25mm on top/bottom layer

# Isolated DCDC 5V to 5V/200mA

VDD_5V_BUS | 5V_ISO_3 GND_ISO_3 | GND_ISO_3


Layout Note: Review Note: RS485_1_R_E=L to enable terminating resistor. Terminating Resistor Switch.

Signals must be length-matched

-1.25mm on top/bottom layer
-0.25mm on inner layers

## -1.25mm on top/bottom layer -0.25mm on inner layers


8 MODE 2 | | RXD- (B) GND TXD+ (A) | RS485 GND

3 | RS232 RXD | RS422 | Data+ (A) TXD- (B) PIN

1 | | RXD+ (A) 6 | Data- (B) TXD

RTS CTS GND

NC

AUDIO_RSTn_1V8: From Thor GPIO, 1.8V. Design Note: AUDIO_RSTn_3V3: From IIC to GPIO, 3.3V. | AGND


U9 TLV320AIC3104
RESET 31 SCL 8 SDA 9 MCLK 1 WCLK 3 BCLK 2 DIN 4 DOUT 5
LEFT_LOM 28 RIGHT_LOP 29 RIGHT_ROM 30 HPLOUT 19 HPROUT 23 HPRCOM 22 HPLCOM 20 MIC2R/LINE2R 16 MICBIAS 15 MIC2L/LINE2L/MICDET 14 MIC1LP/LINE1LP 10 MIC1LM/LINE1LM 11 MIC1RP/LINE1RP 12 MIC1RM/LINE1RM 13 AVDD_DAC 25 DRVDD 18

IOVDD 7 DVDD 32 DVSS 6 AVSS1_ADC 17 AVSS2_DAC 26 DRVSS 21 DRVDD 24 PAD 33

reComputer J601 Carrier Board 29 Audio

# MGBE Reference Clock

VDD_3V3_SYS | VDD_3V3_SYS


Power LED (Always on)

reComputer J601 Carrier Board 30 Ref CLK, IIC to GPIO, LED

# SoC Fan Header 4pin

## GND


reComputer J601 Carrier Board 31 Fan, EEPROM, Debug, Button

I2S_DIR_1_SEL = 1, Output | DIR = 0 : B -> A DIR = 1 : A -> B Design Note:
I2S_DIR_2_SEL = 1, Output | Design Note: DIR = 0 : B -> A DIR = 1 : A -> B


I2S2_SCLK_1V8: THOR_BC1, I2S2_CLK/BOOT_CHAIN_1, must drive to 0 if as input. Default : Design Note:

# GPO x4 1

1


Design Note: GPO_DIR_2_SEL = 1, Output GPO_DIR_1_SEL = 1, Output Default : GPO or SPI

DIR = 0 : B -> A DIR = 1 : A -> B Design Note:

reComputer J601 Carrier Board 33 GPI, GPO

## PWM1_FSYNC PWM2/CAM4_PWDN


reComputer J601 Carrier Board 34 Camera Expansion MH10 SMTSO3003CTJ pth_4_2mm_5d8 1

reComputer J601 Carrier Board PCB

Place the MH9 MH10 MH13 MH14 to the other side of camera connector. Design Note:
