Seeed-Studio/OSHW-Jetson-Series/reComputer Jetson carrier board/reComputer Rugged J401/Schematic/reComputer Rugged J401 Carrier Board V1.1_SCH.pdf

DATE | REVISION | DESCRIPTION

# 01 Table of Contents

SHEET NAME; Revision History; Oct. 30 2025; reComputer Rugged J401 Carrier Board V1.0; Initial Release.; Aug. 17 2026; reComputer Rugged J401 Carrier Board V1.1; Optimize PCB: Adjust the; Title:; Size:; Document Number:; Rev:; Date:; Sheet:; Monday, August 17, 2026; reComputer Rugged J401; <Core Design>

Schematic: reComputer Rugged J401 Carrier Board
SHEET

02 | Block Diagram
03 Power Tree
04 | SODIMM Connector 1/3
05 | SODIMM Connector 2/3
06 | SODIMM Connector 3/3
07 | Power In, 5V, 3.3V_MCU
08 | Power In, 12V
09 | 3.3V, 1.8V, 1.2V
10 | Power In, 16.8V
11 | PSE,1.0V
12 | Button MCU For Power Up
13 | CVM Power MUX
14 | USB3.1 HUB
15 | USB3.1 Type-A x2 (A)
16 | USB3.1 Type-A x2 (B)
17 | HDMI
18 | Type C, Debug UART
19 | PCIe Switch Power
20 | PCIe Switch IO
21 | M.2 KEY-M (NVME)
22 | M.2 KEY-B (4G/5G)
23 | M.2 KEY-E (WIFI/BT)
24 | Fan, EEPROM, Debug
25 | Concatenate
26 | IIC to IO
27 | Gigabit Ethernet
28 | PCIe to GBE0
29 | PCIe to GBE1
30 | PCIe to GBE2
31 | PCIe to GBE3
32 | USB2.0 HUB

position of the Type C interface

https://www.seeedstudio.com

01 Table of Contents

A A Title:; Monday, August 17, 2026; 02 Block Diagram; <Core Design>

A A Title:; Monday, August 17, 2026; 03 Power Tree; <Core Design>

# UART, I2C, CAN and GPIOs

VDD_IN 251 | VDD_IN 252 | VDD_IN 253 | VDD_IN 254 | VDD_IN 255 | VDD_IN 256 | VDD_IN 257 | VDD_IN 258 | VDD_IN 259 | VDD_IN 260 | GND 1 | GND 2 | GND 7 | GND 8 | GND 13 | GND 14 | GND 19 | GND 20 | GND 25 | GND 26 | GND 31 | GND 32 | GND 37 | GND 38 | GND 43 | GND 44 | GND 49 | GND 50 | GND 55 | GND 56 | GND 61 | GND 62 | GND 67 | GND 68 | GND 73 | GND 74 | GND 79 | GND 80 | GND 85 | GND 86 | GND 102 | GND 107 | GND 113 | GND 119 | GND 125 | GND 129 | GND 132 | GND 135 | GND 138 | GND 141 | GND 144 | GND 146 | GND 147 | GND 152 | GND 153 | GND 158


reComputer Rugged J401 04 SODIMM Connector 1/3 <Core Design>

# GPIOs, USB2.0, I2S, SPI, GBe and CSI

CSI0_D0_P | 6 CSI0_D0_N | 4 CSI0_D1_P | 18 CSI0_D1_N | 16 CSI0_CLK_P 12 CSI0_CLK_N | 10 CSI1_D0_P | 5 CSI1_D0_N | 3 CSI1_D1_P | 17 CSI1_D1_N | 15


TP18 Test Point CSI0_D0_P
TP9 Test Point TP42 Test Point TP21 Test Point

TP26 Test Point
TP19 Test Point TP45 Test Point

reComputer Rugged J401 05 SODIMM Connector 2/3 <Core Design>

# HDMI, DP, DSI, USBSS and PCIe

DSI_D0_P/RSVD 72 | DSI_D0_N/RSVD 70 | DSI_D1_P/RSVD 84 | DSI_D1_N/RSVD 82 | DSI_CLK_P/RSVD 78 | DSI_CLK_N/RSVD 76 | DP0_TXD0_P/USBSS1_RX_P 41 | DP0_TXD0_N/USBSS1_RX_N 39 | DP0_TXD1_P/USBSS1_TX_P 47 | DP0_TXD1_N/USBSS1_TX_N 45 | DP0_TXD2_P/USBSS2_RX_P 53 | DP0_TXD2_N/USBSS2_RX_N 51 | DP0_TXD3_P/USBSS2_TX_P 59 | DP0_TXD3_N/USBSS2_TX_N 57 | DP0_AUX_P/RSVD 92 | DP0_AUX_N/RSVD 90 | DP0_HPD/RSVD 88 | DP1_TXD0 (HDMI_TXD2)_P 65 | DP1_TXD0 (HDMI_TXD2)_N 63 | DP1_TXD1 (HDMI_TXD1)_P 71 | DP1_TXD1 (HDMI_TXD1)_N 69 | DP1_TXD2 (HDMI_TXD0)_P 77 | DP1_TXD2 (HDMI_TXD0)_N 75 | DP1_TXD3 (HDMI_TXC)_P 83 | DP1_TXD3 (HDMI_TXC)_N 81 | DP1_AUX_P (HDMI_DDC_SCL) 100 | DP1_AUX_N (HDMI_DDC_SDA) 98 | DP1_HPD (HDMI_HPD) 96 | HDMI_CEC 94 | CLK_32K_OUT 210


CSI5_D0_P
Test Point TP15 Test Point TP7

Heat sink mount hole

reComputer Rugged J401 06 SODIMM Connector 3/3 <Core Design>

# 19V to 48V

60V 1 2 U26


Pin10 ILIM | GND | VCC1 | Floating

V ILIMIT | 25mV | 50mV | 75mV

# 48V to 12V

# VCC1 2 SGND


# 12V to 3.3V

# VCC1 2 SGND


ILIM = VCC1 | Min | Typ | Max

V ILIMIT | 40mV | 50mV | 60mV

Note: VDD12 should come up before VDD33(VDD33 should rise after or at the same rate as VDD12).


## I2C address : 0x70

# DNP 1 R446 1K


https://www.seeedstudio.com

# Button MCU For Power Up


VDD_12V | FORCE_OFF*

12 Button MCU For Power Up

12V 5A

# 30V,12AG


The carrier board only supports 5V output on VDD_IN to the module because the pull-up on
MODULE_ID (R137) is not stuffed in the Orin Nano DevKit carrier board.

A 10kOhm, 0402 R137 Resistor can be added to support 5V, and up to 19V. As stated in
the design guide, please be aware that Hot Plugging is not supported. Jetson Orin Nano
modules have 5V Input Voltage, and hot plugging may cause an incorrect input voltage to
be sent to the module if this resistor is added.

Please make sure the carrier board power is removed and adequate time has elapsed for
the various power rails to fully discharge before when plugging in the Jetson Orin Nano
module. R137 (to pull MODULE_ID high) is located on the SODIMM Connector 1/3 (page 4).

0 1 | | OFF

https://www.seeedstudio.com

# USB3.1 GEN1 HUB x4 PORTS

### Reset


Note: When pulled high enables gang mode.

(Fill the GND FLAG with
at least 20 GND vias.)

Note: VDD12 should come up before VDD33.

200 kΩ Pull-Down, No battery charging.

200 kΩ Pull-Down, All ports removable.

# USB3.1 TYPE-A x2 (A)


# USB3.1 TYPE-A x2 (B)


# HDMI Connector


# USB Type C For NX USB3.0 Only


I2C Address
ADR HIGH: 0x3D
ADR LOW : 0x1D
ADR MID: I2C disabled
Mode:
PORT LOW: UFP mode

VDD 12

USB Type C For Debug UART
USB2.0 Only

# PCIe switch power


https://www.seeedstudio.com

# STRAP PIN SETTING

# PCIe switch IO


Clock Output Termination Resistors

Layout Note:
Put these resistors near
to the end point

https://www.seeedstudio.com

# M.2 KEY-M (NVME)

# H8.5mm


# M.2 KEY-B (4G/5G)


Must be 3.3 V tolerant for Adapters that support 1.8 V sideband signaling.
Platforms that expect 1.8 V sideband signaling must protect themselves from legacy 3.3 V adapters.

Place the MH9 MH10 to the other side of M.2 Key-B connector.

# M.2 KEY-E (WIFI/BT)

# H2.25mm


GND 33 PETp0 35 PETn0 37 GND 39 PERp0 41 PERn0 43 GND 45 REFCLKp0 47 REFCLKn0 49 GND 51 CLKREQ0#(I/O)(0/3.3V) 53 PEWAKE0#(I/O)(0/3.3V) 55 GND 57 RSVD/PETp1 59 RSVD/PETn1 61 GND 63 RSVD/PERp1 65 RSVD/PERn1 67 GND 69 RSVD/REFCLKp1 71 RSVD/REFCLKn1 73 GND 75

# SoC Fan Header 4pin

# Carrier Board Config




# Gigabit Ethernet


# PCIe to Ethernet

# PSE input


The EEPROM is optional, and can be configured to load USB
descriptors, USB device configuration, and the MAC address.

PCIe to Ethernet | PSE input

## 1 of 2

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

# PCIe to Ethernet

# PSE input

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

PCIe to Ethernet | PSE input

## 1 of 2

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

# USB2.0_HUB


https://www.seeedstudio.com
