Seeed-Studio/OSHW-Jetson-Series/reComputer Jetson carrier board/reComputer Rugged J401/Schematic/reComputer Rugged J401 PSE Board V1.1_SCH.pdf

DATE | REVISION | DESCRIPTION

# 01 Table of Contents

SHEET NAME; First Release.; Revision History; Oct 30, 2025; reComputer Rugged J401 PSE Board V1.0; positions of screen printing and buttons Aug 17, 2025; reComputer Rugged J401 PSE Board V1.1; Size:; Document Number:; Rev:; Date:; Sheet:; Monday, August 17, 2026

Schematic: reComputer Rugged J401 PSE Board
SHEET

02 | Block Diagram
03 PSE_54V
04 PSE Controller
05 SIM Card & Conn
06 DI/DO
07 CAN0, Isolated 5V
08 CAN1,SPI to CAN
09 RS232/422/485
10 LED & Button

Optimize PCB: Adjust the

https://www.seeedstudio.com

Title:
reComputer Rugged J401 PES

01 Table of Contents

A A Title:; Monday, August 17, 2026; 02 Block Diagram

# DNP 1 R445


https://www.seeedstudio.com


PORTN3 10 NC⁻¹¹ 11 NC⁻¹² 12

EN_REG: 0: Internal LDO-3.3, 1: Disable LDO connect External 3.3 to pin20
NSTD: 0: Standard, 1: User mode
AD0~AD2: I2C addr: 1110000b (0x70)
SCAN<1:0>: 00: Auto Mode, 01: Manual, 10: Diagnostic, 11: Scan


# Digital Inputs (DI)

VDD_1V8 | Digital Outputs (DO) rated 30V/0.2A


TXD-/DATE-/NC 2 RXD/TXD+/DATE+/NC 1

https://www.seeedstudio.com

# Isolated DCDC 5V to 5V


-1.25mm on top/bottom layer
-0.25mm on inner layers

TXD-/DATE-/NC 2 RXD/TXD+/DATE+/NC 1

Terminating Resistor Switch.
CAN_120R_EN=L to enable terminating resistor.

https://www.seeedstudio.com

CAN FD : 5Mbps
Pin to Pin：TI,ISO1042BDWR


SCK 10 SDI 11 SDO 12 nCS 13

SPI to CAN FD

-1.25mm on top/bottom layer
-0.25mm on inner layers

Terminating Resistor Switch.
CAN_120R_EN=L to enable terminating resistor.

Pin to Pin：TI,ISO1042BDWR

https://www.seeedstudio.com


-1.25mm on top/bottom layer
-0.25mm on inner layers

MODE | 001 | 000/100 | 010/110

PIN | RS232 | RS422 | RS485

1 | RXD | TXD+ | Data+

2 | | TXD- | Data-

3 | TXD | RXD+

4 | | RXD-

Slew rate control pin, Logical Low input will limit driver slew from either
RS-232 to 1Mbps or RS-485 to 10Mbps. Internal pull high= 625KΩ.

5 | GND | GND | GND

7 | RTS

8 | CTS

# LED & Button


Power LED (Always on)
