Seeed-Studio/OSHW-Jetson-Series/reComputer Jetson carrier board/reComputer Super J401/Schematic/reComputer Super J401_v1.0_SCH_PDF_250401.pdf

## PAGE NAME

## AUTHOR

First release; Linus.Liao; VER #; Revision History; REVISION HISTORY; PAGE; DATE; DESCRIPTION OF CHANGES; PAGE LIST; reComputer Super J401; Title: Size:; Document Number:; Rev: Draw By:; Date:; Sheet:; https://www.seeedstudio.com A3; Tuesday, April 01, 2025; reComputer Super J401 01 Table of Contents Title: Size:

Block Diagram
Power Tree
SODIMM Connector 1/3
SODIMM Connector 2/3
SODIMM Connector 3/3
Power IN & 5V & 3.3V_AO
Button MCU For Power Up
SOM Power
USB3.2 Gen1 HUB
PCIe to Ethernet
USB3.2 Type-A x2
USB3.2 TYPE-A, Gbe RJ45 A
USB3.2 TYPE-A, Gbe RJ45 B
HDMI
CAM Connector A
CAM Connector B
USB2.0 HUB, Type C
M.2 KEY-E (WIFI/BT)
M.2 KEY-M (NVME)
Mini PCIe & SIM Board Header
40Pin GPIO Expansion Header
Debug & EEPROM & IO Expansion
FAN

reComputer Super J401 01 Table of Contents

# USBSS0 HDMI

# Debug Header

UART0; RECOVERY; USB2; Level Shift TXB0108; USB 3.2 x 4 5Gbps; USB3.1 HUB USB5744T; HDMI; USB Switch; USB C Device; Toggle Switch 2-CH; 40Pin Header; CAM 0; CAM 1; CAM 2; CAM 3; Fan Header; mini PCIe; M.2 NVMe; RJ45 Gbe; PCIe to Ethernet LAN7430; Voltage selection; FAN_PWM FAN_TACH; USB0 UART2; Nano SIM; Holder PCIe0 PCIe2 PCIe1; I2S1 I2C2 GBe; USB1; Level Shift; USB 2.0 Hub FE1.1-sBQFN24 Module_ID; Block Diagram; Switch; IO Extension PCA9554; CAM I2C; EEPROM; Title: Size:; Document Number: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

USB to TTL

GPIOs GPIOs CSI 0 CSI 1 CSI 2 CSI 3

260 Pin
SODIMM CONN
Super Orin Nano/NX

M.2 KEY E

reComputer Super J401 02 Block Diagram

Imax= 3A | Module Voltage Switch

# Imax= 10A

Imax= 8A; DC JACK; VDD_12V_SYS; 5V DC-DC VDD_5V_SYS; 3V3 LDO; MCU; 12V FAN; 1V2 DC-DC VDD_1V2_HUB; USB Type-A x 4; 40Pin Header HDMI; IO Extension; 3V3 DC-DC VDD_3V3_SYS; 1V8 LDO; VDD_3V3; Level Shifters x 6; USB 3.1 HUB; M.2 NVMe; CSI x 4; Level Shifters; 40Pin Header; Board Config EEPROM; Power Topology; 12V DC-DC FAN_VDD; Support; Overvoltage Protection; Mini PCIe; 5V FAN; https://www.seeedstudio.com A3; Linus.Liao; Tuesday, April 01, 2025; reComputer Super J401 03 Power Tree Title: Size: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

Jeston Super Orin
Nano/NX

PCIe to Ethernet

reComputer Super J401 03 Power Tree

# UART, I2C, CAN and GPIOs

ID_I2C_SCL | [18,23] UART0_TXD | [20] UART0_RXD | [20] UART1_TXD | [23] UART1_RXD | [23] UART1_RTS | [23] UART1_CTS | [23] UART2_TXD | [24] UART2_RXD | [24] MOD_SLEEP* | [16,22,24] POWER_EN | [9] SHUTDOWN_REQ* | [7,9] SYS_RST* | [9,22,24] FORCE_RECOVERY* | [19,24]


VDD_IN 251 VDD_IN 252 VDD_IN 253 VDD_IN 254 VDD_IN 255 VDD_IN 256 VDD_IN 257 VDD_IN 258 VDD_IN 259 VDD_IN 260 GND 1 GND 2 GND 7 GND 8 GND 13 GND 14 GND 19 GND 20 GND 25 GND 26 GND 31 GND 32 GND 37 GND 38 GND 43 GND 44 GND 49 GND 50 GND 55 GND 56 GND 61 GND 62 GND 67 GND 68 GND 73 GND 74 GND 79 GND 80 GND 85 GND 86 GND 102 GND 107 GND 113 GND 119 GND 125 GND 129 GND 132 GND 135 GND 138 GND 141 GND 144 GND 146 GND 147 GND 152 GND 153 GND 158

Note: 1.8V
Note: Internal EEPROM address is 0x50

reComputer Super J401 04 SODIMM Connector 1/3

# GPIOs, USB2.0, I2S, SPI, GBe and CSI

CSI1_D0_P | [17] CSI1_D0_N | [17] CSI1_D1_P | [17] CSI1_D1_N | [17] CSI1_CLK_P | [17] CSI1_CLK_N | [17] CSI3_D0_P | [18] CSI3_D0_N | [18] CSI3_D1_P | [18] CSI3_D1_N | [18] CSI3_CLK_P | [18] CSI3_CLK_N | [18]

M.2 Key-E BT; 40Pin GPIO HDR; ETHERNET CON; USB 3.0 HUB; 40Pin GPIO Header; Input, PU; No Wake Pin; POR; Initial State; Wake Pin; Input, PD; H Input, PU; No Wake Pin Input, PD; No Wake Pin Input, PU; VDD_3V3_SYS; [19] USB0_AP_P; CSI0_D0_P; [19] USB0_AP_N; CSI0_D0_N; [17] CSI0_D1_P; [11] USB1_AP_P; CSI0_D1_N; [11] USB1_AP_N; CSI0_CLK_P; [19] USB2_AP_P; CSI0_CLK_N; [19] USB2_AP_N; [23] I2S0_SDOUT; [23] I2S0_SDIN; [23] I2S0_LRCK; [23] I2S0_SCLK; CSI2_D0_P; [20] I2S1_SDOUT; CSI2_D0_N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

USB Type-C Con

I2S1_SCLK 226 GBE_LED_LINK 188 GBE_LED_ACT 194 GBE_MDI0_P 186 GBE_MDI0_N 184 GBE_MDI1_P 192 GBE_MDI1_N 190 GBE_MDI2_P 198 GBE_MDI2_N 196 GBE_MDI3_P 204 GBE_MDI3_N 202 SDMMC_DAT0/PCIE2_RST* 219 SDMMC_DAT1/PCIE2_CLKREQ* 221 SDMMC_DAT2/PCIE3_RST* 223 SDMMC_DAT3/PCIE3_CLKREQ* 225 SDMMC_CMD/PCIE3_CLK_N 227 SDMMC_CLK/PCIE3_CLK_P 229 GPIO00 (USB_VBUS_EN0) 87 GPIO01 (CLK) 118 GPIO02 124 GPIO03 126 GPIO04 127 GPIO05 128 GPIO06 130 GPIO07 (PWM) 206 GPIO08 (SDMMC_CD) 208 GPIO09 (AUD_MCLK) 211 GPIO10 212 GPIO11 (CLK) 216 GPIO12 218 GPIO13 (PWM) 228 GPIO14 (PWM) 230

CAM FPC Con

M.2 KEY-E (Wi-Fi/BT)

Note: GPIO01
If four cameras are used, this signal will be utilized to provide MCLK for CSI2.

Note: GPIO11
If four cameras are used, this signal will be utilized to provide MCLK for CSI3.

reComputer Super J401 05 SODIMM Connector 2/3

# HDMI, DP, DSI, USBSS and PCIe

PCIE_WAKE | [12,20,21] PCIE0_RST | [21] PCIE0_CLKREQ | [21] PCIE0_CLK_P | [21] PCIE0_CLK_N | [21] PCIE0_TX0_P | [21] PCIE0_TX0_N | [21] PCIE0_RX0_P | [21] PCIE0_RX0_N | [21] USBSS_TX_P | [11] USBSS_TX_N | [11] USBSS_TX_HUB_P | [11] USBSS_TX_HUB_N | [11]


DSI_D0_P/RSVD 72 DSI_D0_N/RSVD 70 DSI_D1_P/RSVD 84 DSI_D1_N/RSVD 82 DSI_CLK_P/RSVD 78 DSI_CLK_N/RSVD 76 DP0_TXD0_P/USBSS1_RX_P 41 DP0_TXD0_N/USBSS1_RX_N 39 DP0_TXD1_P/USBSS1_TX_P 47 DP0_TXD1_N/USBSS1_TX_N 45 DP0_TXD2_P/USBSS2_RX_P 53 DP0_TXD2_N/USBSS2_RX_N 51 DP0_TXD3_P/USBSS2_TX_P 59 DP0_TXD3_N/USBSS2_TX_N 57 DP0_AUX_P/RSVD 92 DP0_AUX_N/RSVD 90 DP0_HPD/RSVD 88 DP1_TXD0 (HDMI_TXD2)_P 65 DP1_TXD0 (HDMI_TXD2)_N 63 DP1_TXD1 (HDMI_TXD1)_P 71 DP1_TXD1 (HDMI_TXD1)_N 69 DP1_TXD2 (HDMI_TXD0)_P 77 DP1_TXD2 (HDMI_TXD0)_N 75 DP1_TXD3 (HDMI_TXC)_P 83 DP1_TXD3 (HDMI_TXC)_N 81 DP1_AUX_P (HDMI_DDC_SCL) 100 DP1_AUX_N (HDMI_DDC_SDA) 98 DP1_HPD (HDMI_HPD) 96 HDMI_CEC 94 CLK_32K_OUT 210

Test Point TP18 Test Point TP26

CSI5_D0_P CSI5_D0_N
Test Point TP20 Test Point TP50
Test Point TP51 Test Point TP28 Test Point TP52 Test Point TP44
Test Point TP53 Test Point TP45 Test Point TP19

Test Point TP48 Test Point TP49

USB Type-A Con (USBSS)

reComputer Super J401 06 SODIMM Connector 3/3

# DC IN: 12V to 19V

## Overvoltage Protection:


3 SS 4 COMP 5 FB 6 CCM/AAM 7 FREQ 8 PG 9

Pin20 Enable Control Pin: VIN UVLO: VDD_DCIN=Ven*(1+R13/R24) Rising: VDD_DCIN = Ven*(1+R13/R24) =1.22V*(1+100K/15K) =9.353V

reComputer Super J401 07 Power In & 5V & 3.3V_AO

# 19V to 3.3V

R0402 C132


3 SS 4 COMP 5 FB 6 CCM/AAM 7 FREQ 8 PG 9

= 0.8V x 4.161290 I pk | Min | Typ

ILIM = VCC1 R161 V ILIMIT | 40mV | 7mR 50mV | Max 7.143A 60mV

Note: VDD12 should come up before VDD33(VDD33 should rise after or at the same rate as VDD12)

# Button MCU For Power Up

# R0402 R164 0R


VDD 4 P1.7 7 P1.6 8 P1.5 9 P1.3 10 P1.2 11 P2.7_C2D 6 RST*_C2CK 5 GND 3 GND 12 EPAD 21

DNP: Auto-Power-ON VDD_5V_SYS

Install: Button Power-ON

VDD_DCIN | FORCE_OFF*

19V | XXXXXX

20V | XXXXXX

reComputer Super J401 09 Button MCU For Power Up

# 12V~19V 3A


Note: Replace MPN: AONR21357,Ron=10mΩ

The carrier board only supports 5V output on VDD_IN to the module because the pull-up on
MODULE_ID (R231) is not stuffed in the Orin Nano DevKit carrier board.

A 10kOhm, 0402 R231 Resistor can be added to support 5V, and up to 19V. As stated in
the design guide, please be aware that Hot Plugging is not supported. Jetson Orin Nano
modules have 5V Input Voltage, and hot plugging may cause an incorrect input voltage to
be sent to the module if this resistor is added.

Please make sure the carrier board power is removed and adequate time has elapsed for
the various power rails to fully discharge before when plugging in the Jetson Orin Nano

0 VIN_PWR_ON | VDD_SOM

0 OFF

reComputer Super J401 10 SOM Power

# USB3.2 Gen1 HUB x4 PORTS

HUB_HSD1_P | [13] HUB_HSD1_N | [13] HUB_SSTX1_P [13] HUB_SSTX1_N [13] HUB_SSRX1_P [13] HUB_SSRX1_N [13] HUB_HSD2_P | [13] HUB_HSD2_N | [13] HUB_SSTX2_P [13] HUB_SSTX2_N [13] HUB_SSRX2_P [13] HUB_SSRX2_N [13] HUB_HSD3_P | [14] HUB_HSD3_N | [14] HUB_SSTX3_P [14] HUB_SSTX3_N [14] HUB_SSRX3_P [14] HUB_SSRX3_N [14] HUB_HSD4_P | [15] HUB_HSD4_N | [15] HUB_SSTX4_P [15] HUB_SSTX4_N [15] HUB_SSRX4_P [15] HUB_SSRX4_N [15]


Port Power Control (Fill the GND FLAG with

at least 20 GND vias.)

CFG_BC_EN: 200KΩ Pull-Down, No battery charging

# PCIe to 1000M Ethernet

## 1 of 2 U33A


LAN7430-I/Y9X
qfn48_0d5_7x7mm
RESETn 29 TEST 30 PERST# 44 PCIE_CLK_P 25 PCIE_CLK_M 26 PCIE_TX_P 19 PCIE_TX_M 21 PCIE_RX_P 16 PCIE_RX_M 17 CLKREQ# 42 WAKE# 43 RESREF 24

Note: C237 Close to IC

Note: Pull-up to 3.3V by 100k Resistor

reComputer Super J401 12 PCIe to Ethernet

# USB3.2 TYPE-A x2 (A)


# USB3.2 TYPE-A + Gbe RJ45


reComputer Super J401 14 USB3.2 TYPE-A, Gbe RJ45 A

USB3.2 TYPE-A + Gbe RJ45 | VDD_3V3_SYS
CT0 12 CT1 6 CT2 1 CT3 7 | YEL+ 14 YEL- 13 VBUS U1 DP U3 GND_1 U4 GND_2 U7 RX_N U5 RX_P U6 TX_N U8 TX_P U9 DN U2 | SHIELD_3 S3 SHIELD_4 S4 USB_SHIELD_1 S⁵ | USB_SHIELD_2 S⁶ R49 | 0R


reComputer Super J401 15 USB3.2 TYPE-A, Gbe RJ45 B

# HDMI Connector


# CSI CAM CONNECTOR

# CSI 0


Note:
CSI 1, CSI3 I2C is connected to ID_I2C

reComputer Super J401 17 CAM Connector A

# CSI CAM CONNECTOR

# CSI 2


Note: Pull-up to 3.3V by 100k Resistor

reComputer Super J401 18 CAM Connector B

# USB2.0_HUB

# LED2 23 PWRJ 24 GND_EP 25


FORCE_RECOVERY* is Pull-up to 1.8V

reComputer Super J401 19 USB2.0 HUB, Type C

# M.2 KEY-E (WIFI/BT)

LED1# (I)(OD) 6 PCM_CLK/I2S_SCK(I/O)(0/1.8V) 8 PCM_SYNC/I2S_WS(I/O)(0/1.8V) 10 PCM_IN/I2S_SD_IN(I)(0/1.8V) 12 PCM_OUT/I2S_SD_OUT(O)(0/1.8V) 14 LED2#(I)(OD) 16 GND 18 UART_WAKE#(I)(0/3.3V) 20 UART_RXD(I)(0/1.8V) 22 UART_TXD(O)(0/1.8V) 32 UART_CTS(I)(0/1.8V) 34 UART_RTS(O)(0/1.8V) 36 VENDOR_DEFINED1 38 VENDOR_DEFINED2 40 VENDOR_DEFINED3 42 COEX3(I/O)(0/1.8V) 44 COEX2(I/O)(0/1.8V) 46 COEX1(I/O)(0/1.8V) 48 SUSCLK(32kHz) (O)(0/3.3V) 50 PERST0#(O)(0/3.3V) 52 W_DISABLE2#(O)(0/3.3V) 54 W_DISABLE1#(O)(0/3.3V) 56 I2C_DATA(I/O)(0/1.8V) 58 I2C_CLK(O)(0/1.8V) 60 ALERT#(I)(0/1.8V) 62 RSVD 64 UIM_SWP/PERST1# 66 UIM_POWER_SNK/CLKREQ1# 68 UIM_POWER_SRC/GPIO1/PEWAKE1# 70 3.3V 72 3.3V 74 | SH¹ ⁷⁶ SH² ⁷⁷ | R266 | 1K R0402 | 1%


Place R126 R128 in the bottom of PCB

reComputer Super J401 20 M.2 KEY-E (WIFI/BT)

# M.2 KEY-M (NVME)

## M.2 KEY M


reComputer Super J401 21 M.2 KEY-M (NVME)

# Mini PCIe H=4.0mm


Note: Pull-up to 3.3V by 100k Resistor MINI_3V3

Design Note: Fit SIM Board Nut H6.6

reComputer Super J401 22 Mini PCIe & SIM Board Header

# 40Pin GPIO Expansion Header & Level Shifters

# U19 TXB0108RGYR


IDEAL DIODE USED TO BLOCK BACK POWER

If an external pull-up resistor is required, please use a resistor which value at least 100kΩ.

reComputer Super J401 23 40Pin GPIO Expansion Header

# Carrier Board Config Serial Port

R0402 R355


Optional Button Header Pinout

Note: P0 ~P7 ,Pull-up to VCC by 100K Resistor

reComputer Super J401 24 Debug & EEPROM & IO EXP

# DC-DC 11.2V
