Seeed-Studio/OSHW-Jetson-Series/reServer Jetson carrier board/reServer Industrial J30-J40/Schematic/reServer industrial J401 Carrier Board v11_SCH_PDF_240822.pdf

DATE | REVISION | DESCRIPTION
02 | Block Diagram

SHEET NAME; Revision History; Oct. 3 2023; reServer industrial J401 Carrier Board v1.0; Initial Release.; Title: Size:; Document Number:; Rev: Draw By:; Date:; Sheet:; https://www.seeedstudio.com A3; qxn; Wednesday, August 21, 2024; reServer industrial J401 01 Table of Contents Title: Size:

Schematic: reComputer Industrial J201
SHEET
01 Table of Contents

03 Power Tree
04 | SODIMM Connector 1/3
05 | SODIMM Connector 2/3
06 | SODIMM Connector 3/3
07 | Power In, 5V, 3.3V_MCU
08 | 3.3V, 1.8V, 1.2V
09 | PSE, 1.25V, 1.0V
10 | Button MCU For Power Up
11 | USB3.1 HUB
12 USB3.1 Type-A x2 (A)
13 | USB3.1 Type-A x2 (B)
14 | HDMI
15 | Type C, Debug UART
16 | PCIe Switch Power
17 | PCIe Switch IO
18 | M.2 KEY-M (NVME)
19 | M.2 KEY-B (4G/5G)
20 | Mini PCIe (4G/LoRa)
21 | Fan, EEPROM, Debug
22 | DI, DO
23 | CAN, Isolated 5V
24 | TPM, IIC to IO
25 | RS232/422/485
26 | Gigabit Ethernet
27 | PCIe to GBE0
28 | PCIe to GBE1
29 | PCIe to GBE2
30 | PCIe to GBE3
31 | SATA_Controller
32 | SATA_Connector

Oct. 16 2023 | reServer industrial J401 Carrier Board v1.1 | Correct power input reverse protection issue.

Aug. 6 2024 | reServer industrial J401 Carrier Board v1.1 | Replace the 32.768k crystal oscillator at OSC2.

Aug. 9 2024 | reServer industrial J401 Carrier Board v1.1 | Replace the 12M crystal oscillator at X2. Change C73 and C75 for 33pF.

reServer industrial J401 01 Table of Contents

## PSE Subsystem

## RJ45 GBE x4

M.2 Key-M; M.2 Key-B; miniPCIE; RJ45 GBE x1; HDMI; USB2 Type C; USB3 Type A x4; Recovery; USB2 Type C Debug; DI x4 DO x4 CAN x1; SATA x2; RS232 Transceiver; RS485/422 Transceiver; CAN Transceiver; PoE PSE Controller; 2Pin Terminal Block; PCIE0, x4; USB0_D_N/P; VDD_IN; PCIe to GBE; PCIE1, x1; PCIE2, x1; PCIE3, x1; Analog switch; GBE; USB2_D_N/P; PMIC_BBAT; UART2; Fan 5V; TPM; PCIe Switch up x1, down x3 Diodes; PCIe to 2x SATA Bridge JMB582; USB3 Hub; USBSS2; SPI1; UART0; UART1; CAN; GPIO; SPI0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

PCIe to GBE
Microchip

260 Pin
SODIMM CONN
Orin NX/Nano

Button Power MCU

USB to UART
Bridge

RTC Battery holder

Nano SIM holder

reServer industrial J401 02 Block Diagram

## 2Pin Terminal Block Power input

A A PSE subsystem connector; 5V DCDC VDD_5V_SYS; 3V3 DCDC VDD_3V3_SYS; 1V0 DCDC VDD_1V0; 1V2 DCDC VDD_1V2; 1V8 LDO VDD_1V8; 3V3 LDO; VDD_3V3; Button Power MCU; EEPROM; TPM; RS485/232 Transceiver; CAN Transceiver; PCIe Switch up x1, down x3 Diodes; PoE PSE Controller; USB3 Hub; Jetson Orin NX; HDMI ULSW; x4 USB Type-A; PWR LED; 54V DC/DC VDD_PSE; 1V25 DCDC VDD_1V25; 5V Isolated 5V_ISO; USB Type-C Debug; EXT.POWER SOURCE; ON BOARD CIRCUIT; POWER DCDC; POWER LDO; https://www.seeedstudio.com A3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

Overvoltage
protection + Soft Start

USB to UART
Bridge

PCIe to 2x SATA

x4 PCIe to GBE

Voltage Level Shifter

reServer industrial J401 03 Power Tree

# UART, I2C, CAN and GPIOs

I2C0_SCL | [9,24] UART0_TXD | [19,20] UART0_RXD | [19,20] UART1_TXD | [25] UART1_RXD | [25] UART1_RTS | [25] UART1_CTS | [25] UART2_TXD | [15] UART2_RXD | [15] MOD_SLEEP* | [14,21,23] POWER_EN | [10] SHUTDOWN_REQ* | [7,10] SYS_RST* | [10,21] FORCE_RECOVERY* | [21]


VDD_IN 251 VDD_IN 252 VDD_IN 253 VDD_IN 254 VDD_IN 255 VDD_IN 256 VDD_IN 257 VDD_IN 258 VDD_IN 259 VDD_IN 260 GND 1 GND 2 GND 7 GND 8 GND 13 GND 14 GND 19 GND 20 GND 25 GND 26 GND 31 GND 32 GND 37 GND 38 GND 43 GND 44 GND 49 GND 50 GND 55 GND 56 GND 61 GND 62 GND 67 GND 68 GND 73 GND 74 GND 79 GND 80 GND 85 GND 86 GND 102 GND 107 GND 113 GND 119 GND 125 GND 129 GND 132 GND 135 GND 138 GND 141 GND 144 GND 146 GND 147 GND 152 GND 153 GND 158

M.2 Key-B & Mini PCIe WIFI/BT

reServer industrial J401 04 SODIMM Connector 1/3

# GPIOs, USB2.0, I2S, SPI, GBe and CSI

CSI0_D0_P 6 CSI0_D0_N 4 CSI0_D1_P 18 CSI0_D1_N 16 CSI0_CLK_P 12 CSI0_CLK_N 10 CSI1_D0_P 5 CSI1_D0_N 3 CSI1_D1_P 17 CSI1_D1_N 15


TP18 Test Point CSI0_D0_P CSI0_D0_N
TP8 Test Point TP20 Test Point
TP9 Test Point TP42 Test Point TP21 Test Point

[19] USB2_AP_N
I2S1_SCLK 226 GBE_LED_LINK 188 GBE_LED_ACT 194 GBE_MDI0_P 186 GBE_MDI0_N 184 GBE_MDI1_P 192 GBE_MDI1_N 190 GBE_MDI2_P 198 GBE_MDI2_N 196 GBE_MDI3_P 204 GBE_MDI3_N 202 SDMMC_DAT0/PCIE2_RST* 219 SDMMC_DAT1/PCIE2_CLKREQ* 221 SDMMC_DAT2/PCIE3_RST* 223 SDMMC_DAT3/PCIE3_CLKREQ* 225 SDMMC_CMD/PCIE3_CLK_N 227 SDMMC_CLK/PCIE3_CLK_P 229 GPIO00 (USB_VBUS_EN0) 87 GPIO01 (CLK) 118 GPIO02 124 GPIO03 126 GPIO04 127 GPIO05 128 GPIO06 130 GPIO07 (PWM) 206 GPIO08 (SDMMC_CD) 208 GPIO09 (AUD_MCLK) 211 GPIO10 212 GPIO11 (CLK) 216 GPIO12 218 GPIO13 (PWM) 228 GPIO14 (PWM) 230

TP41 Test Point
TP19 Test Point TP45 Test Point

TP29 Test Point TP44 Test Point

reServer industrial J401 05 SODIMM Connector 2/3

# HDMI, DP, DSI, USBSS and PCIe

PCIE_WAKE | [18,27,28,29,30] PCIE0_RST | [18] PCIE0_CLKREQ | [18] PCIE0_CLK_P | [18] PCIE0_CLK_N | [18] PCIE0_TX0_P | [18] PCIE0_TX0_N | [18] PCIE0_RX0_P | [18] PCIE0_RX0_N | [18] USBSS_TX_P | [11] USBSS_TX_N | [11] USBSS_TX_HUB_P | [11] USBSS_TX_HUB_N | [11]


USBSS2_RX_P USBSS2_TX_P USBSS1_TX_P CSI5_D0_P CSI5_D0_N
DSI_D0_P/RSVD 72 DSI_D0_N/RSVD 70 DSI_D1_P/RSVD 84 DSI_D1_N/RSVD 82 DSI_CLK_P/RSVD 78 DSI_CLK_N/RSVD 76 DP0_TXD0_P/USBSS1_RX_P 41 DP0_TXD0_N/USBSS1_RX_N 39 DP0_TXD1_P/USBSS1_TX_P 47 DP0_TXD1_N/USBSS1_TX_N 45 DP0_TXD2_P/USBSS2_RX_P 53 DP0_TXD2_N/USBSS2_RX_N 51 DP0_TXD3_P/USBSS2_TX_P 59 DP0_TXD3_N/USBSS2_TX_N 57 DP0_AUX_P/RSVD 92 DP0_AUX_N/RSVD 90 DP0_HPD/RSVD 88 DP1_TXD0 (HDMI_TXD2)_P 65 DP1_TXD0 (HDMI_TXD2)_N 63 DP1_TXD1 (HDMI_TXD1)_P 71 DP1_TXD1 (HDMI_TXD1)_N 69 DP1_TXD2 (HDMI_TXD0)_P 77 DP1_TXD2 (HDMI_TXD0)_N 75 DP1_TXD3 (HDMI_TXC)_P 83 DP1_TXD3 (HDMI_TXC)_N 81 DP1_AUX_P (HDMI_DDC_SCL) 100 DP1_AUX_N (HDMI_DDC_SDA) 98 DP1_HPD (HDMI_HPD) 96 HDMI_CEC 94 CLK_32K_OUT 210

Test Point TP23
Test Point TP15 Test Point TP7
Test Point TP17 Test Point TP24

USB Type-A Con (USBSS)

GBE0 Heat sink mount hole

reServer industrial J401 06 SODIMM Connector 3/3

# U49 SOT23-5 DNP

# J17_TB1 YL032-099-002 G2


3 SS 4 COMP 5 FB 6 CCM/AAM 7 FREQ 8 PG 9

Pin20 Enable Control Pin: VIN UVLO: VDD_DCIN=Ven*(1+R185/R181) Rising: VDD_DCIN = Ven*(1+R185/R181) =1.22V*(1+100K/22K) =6.765V

reServer industrial J401 07 Power In, 5V, 3.3V_MCU

# 24V to 3.3V

# DNP C95


3 SS 4 COMP 5 FB 6 CCM/AAM 7 FREQ 8 PG 9

ILIM = FLOAT | | Typ

65mV | 75mV R112 V ILIMIT | Max 9.286A Min 85mV

Note: VDD12 should come up before VDD33(VDD33 should rise after or at the same rate as VDD12).

## I2C address : 0x70

# pth_3_3mm_6d8 DNP 1 D79 D0402


# Button MCU For Power Up

# R0402 DNP C96


VDD_DCIN

reComputer J101 | 1 GPIO23 1 | 1

reComputer J202/J201 | 0 | 1

reComputer J401 | | 0

reServer industrial J401 10 Button MCU For Power Up

# USB3.1 GEN1 HUB x4 PORTS

HUB_HSD1_P | [12] HUB_HSD1_N | [12] HUB_SSTX1_P [12] HUB_SSTX1_N [12] HUB_SSRX1_P [12] HUB_SSRX1_N [12] HUB_HSD2_P | [12] HUB_HSD2_N | [12] HUB_HSD3_P | [13] HUB_HSD3_N | [13] HUB_SSTX3_P [13] HUB_SSTX3_N [13] HUB_SSRX3_P [13] HUB_SSRX3_N [13] HUB_HSD4_P | [13] HUB_HSD4_N | [13] HUB_SSTX4_P [13] HUB_SSTX4_N [13] HUB_SSRX4_P [13] HUB_SSRX4_N [13] HUB_PRT_CTL1 [12] HUB_PRT_CTL2 [12] HUB_PRT_CTL3 [13]


RBIAS 56 XTALI/CLK_IN 54 XTALO 53 TESTEN/ATEST 52 USBRXM_UP 51 USBRXP_UP 50
USBSS_RX_HUB_P HUB_XTALO
RESET 42 SPI_CE_N/CFG_NON_REM 41 SPI_DI/CFG_BC_EN 40 SPI_DO/SMDAT 39 SPI_CLK/SMCLK 38

Port Power Control (Fill the GND FLAG with

Note: When pulled high enables gang mode.

at least 20 GND vias.)

Note: VDD12 should come up before VDD33.

200 kΩ Pull-Down, No battery charging.

# USB3.1 TYPE-A x2 (A)


# USB3.1 TYPE-A x2 (B)

4 | 3 R283 | 0R


# HDMI Connector


# USB Type C For NX USB2.0 Only


USB Type C For Debug UART & RP2040
USB2.0 Only

reServer industrial J401 15 Type C, Debug UART

VSS1 2 VSS2 4 VSS3 11 VSS4 12 VSS5 30 VSS6 32 VSS7 34 VSS8 41 VSS9 50 VSS10 56 VSS11 61 VSS12 63 VSS13 66 VSS14 87 VSS15 90 VSS16 95 VSS17 104 CGND1 109 CGND2 112 VSS20 120 VSS21 126 VSS22 129

VDDC1 3 VDDC2 23 VDDC3 29 VDDC4 31 VDDC5 40 VDDC6 55 VDDC7 62 VDDC8 65 VDDC9 91 VDDCAUX1 13 VDDCAUX2 14 VDDA2 105 VDDA1 99 VDDA3 108 VDDA4 119 VDDA5 125 AVDDH 113 VDDR1 1 VDDR2 8 VDDR3 49 VDDR4 64 VDDR5 79 VDDR6 82 VDDR7 84 VDDR8 96 VAUX 15 NC_1


# STRAP PIN SETTING

# PCIe switch IO


Clock Output Termination Resistors

Layout Note:
Put these resistors near
to the end point

# M.2 KEY-M (NVME)


reServer industrial J401 18 M.2 KEY-M (NVME)

# M.2 KEY-B (4G/5G)


# U18 TXB0108PWR


layout Note: Place the MH3 MH4 to the same side of PCIe connector.

Pin10: SX1261_RST, 3.3V, 10K Pull-Up in the LoRa module. Pin8: SX1261_BUSY, 3.3V, No Pull-Up/Down in the LoRa module, active high.

CTS RTS Need Check?

reServer industrial J401 20 Mini PCIe (4G/LoRa)

# SoC Fan Header 4pin

# Carrier Board Config


reServer industrial J401 21 Fan, EEPROM, Debug

# Digital Outputs (DO) rated 40V/0.2A Digital Inputs (DI)

# VDD_1V8 VDD_1V8 VDD_1V8


reServer industrial J401 22 DI, DO

# Isolated DCDC 5V to 5V


If use 3W 5V/600mA, can replaced by 310031469(Murata,MEE3S0505SC). Design Note: The U10 (MORNSUN,B0505S-1WR3) is 1W 5V/200mA.

Isolation Barrier: -1.25mm on top/bottom layer
U7 TPT71044-SOBR

-1.25mm on top/bottom layer
-0.25mm on inner layers

reServer industrial J401 23 CAN, Isolated 5V

# U57 TXB0104PWR

# U6 TXS0104EPWR


reServer industrial J401 24 TPM, IIC to IO

# 9 G¹ 10 G² 11


-1.25mm on top/bottom layer
-0.25mm on inner layers

3 | 001 RS232 RXD | 000/100 RS422 | 010/110 Slew rate control pin, Logical Low input will limit driver slew from either RS-232 to 1Mbps or RS-485 to 10Mbps. Internal pull high= 625KΩ. Data+ TXD- PIN

8 MODE 2 1 | RXD- GND TXD+ RXD+ | RS485 GND Data- TXD

6 | RTS CTS GND

# J14 DGKYD111Q180AJ5A1D


reServer industrial J401 26 Gigabit Ethernet

# PCIe to Ethernet

# PSE input


PCIe to Ethernet | PSE input

# 2 C423


reServer industrial J401 28 PCIe to GBE1

# PCIe to Ethernet

# PSE input


reServer industrial J401 29 PCIe to GBE2

PCIe to Ethernet | PSE input

## 1 of 2 U71A


LAN7430-I/Y9X
qfn48_0d5_7x7mm
RESETn 29 TEST 30 PERST# 44 PCIE_CLK_P 25 PCIE_CLK_M 26 PCIE_TX_P 19 PCIE_TX_M 21 PCIE_RX_P 16 PCIE_RX_M 17 CLKREQ# 42 WAKE# 43 RESREF 24

reServer industrial J401 30 PCIe to GBE3

# Sata Controller

# L0603 FB32 120R


C176,C177 is placed close to the J5
C178,C179 is placed close to the U21

# SATA PORT 0

# (To SATA HDD)
