Seeed-Studio/OSHW-Jetson-Series/reServer Jetson carrier board/reServer Industrial J501/Schematic/202003906_reServer_Industrial_J501_Carrier_Board_v1.0_SCH_PDF_20240529.pdf

DATE | REVISION | DESCRIPTION

# 01 01 Table of Contents

SHEET NAME; Revision History; May 15, 2024; First release. v1.0; Title:; Size:; Document Number:; Rev:; Draw By:; Date:; Sheet:; qxn; Wednesday, May 29, 2024; reServer industrial J501

Schematic: reServer Industrial J501
SHEET

02 | 02 Block Diagram
03 03 Power Tree
04 | 04 CVM Connector 1/3
05 | 05 CVM Connector 2/3
06 | 06 CVM Connector 3/3
07 | 07 Power Vin 5V 3V3_AO 1V8 0V7
08 | 08 Power 12V 11V 3V3 2V 1V2 1V
09 | 09 Button MCU For Power Up
10 | 10 10G Ethernet
11 | 11 Gigabit Ethernet
12 12 USB3.1 HUB
13 | 13 USB3.1 Type-A x2 (A)
14 | 14 USB3.1 Type-A x1(B)
15 | 15 Type C, Debug UART
16 | 16 M.2 KEY-E (WIFI/BT)
17 | 17 M.2 KEY-M (NVME)
18 | 18 M.2 KEY-B (4G/5G)
19 | 19 Mini PCIe (4G/LoRa)
20 | 20 HDMI
21 | 21 Fan, EEPROM, Debug
22 | 22 DI, DO
23 | 23 CAN, Isolated 5V
24 | 24 TPM, IIC to IO
25 | 25 RS232/422/485
26 | 26 SATA_Controller
27 | 27 SATA_Connector
28 | 28 Audio Codecss
29 | 29 Camera Expansion
30 | 30 PCIe Expansion

https://www.seeedstudio.com

01 Table of Contents

## Power Sequencer Regs


D D

C C

B B

A A

## Isolate IN Transistor OUT

## USB2.0 Type C Debug

## USB3.0 Type C Recovery

## 1G RJ45

## HDMI

## TPM Header

## M.2 Key M

## M.2 Key E

## M.2 Key B

## Mini PCIe

## Camera Expansion

Conn.

## Fan Connector

## USB to UART bridge

## DC Terminal

## RTC Battery

## USB 3.0 Hub

## 3x USB 3.0 Type A

## PMIC_BBATT

## SYS_VIN_HV SYS_VIN_MV

## USB0 UPHY Lane 1

## UPHY Lane 0

## UPHY Lane 20

## USB3

## UPHY Lane 21 PEX_CLK6

I2S4

## PCIe Control

## USB2 UART5 GPIOs

## UPHY Lanes [23:22]

## PEX_CLK4 PCIe Control

I2C2

## UPHY Lanes [11:10]

## CSI[7:0] MCLK[04:02] CAM Ctrl

I2C2
I2C5

## PCIe x8 Expansion

Conn.

## UPHY Lanes [19:12] PEX_CLK5 PCIe Control

I2C3

## Automation Header

## Reset,Power On Ethernet WOL FORCE_RECOVERY Auto-Power-On Enabel/Disable

## PWM Tach

## Audio Codec 3.5mm Audio Conn. In/OUT

## Mux

## UART3_DEBUG

I2C2

## USB1

I2S2

## UART1 GPIOs

uSIM Conn. | Mux

## UART1 SPI3

I2S1
I2C5

## MCLK01

PCIe to SATA Bridge 2x SATA Conn.

## 10G RJ45

## SPI3

## HDMI_DP2_TXx DP2_AUX_CH DP2_HPD HDMI_CEC

## 10 GBE PHY

## UPHY Lane 6 (MGBE) XFI0 MDC/MDIO XFI0 INT/RST

## 1 GBE PHY

## RGMII0 TX/RX RGMII0 MDC/MDIO GPIOs INT/RST

## DB9 RS232/

RS422/485

RS232/485/422
| Transceiver | UART2

## Terminal 4x In/Out

2x CAN | CAN Transceiver | CAN[1:0] GPI
| | GPO
JTAG | JTAG Header

## LPDDR5 QSPI NOR eMMC 5.1 Secure SPI NOR Thermal Sensor

# Jetson AGX Orin

## OV/UV/Reverse Protecton & FETs & Regs

## Power Expansion

Conn.

# Camera Board

# PCIe Board

# Main Board

## 16x1G RJ45

## 8x1G RJ45

## 4x1G RJ45

## PoE Controller

## PCIe NIC

## GMSL Transceiver

## Regs

GMSL Conn.

## Interface Sub circuit

External Conn.
Internal Conn.
qxn | Wednesday, May 29, 2024 | 2 | 30
| 02 Block Diagram
qxn | Wednesday, May 29, 2024 | 2 | 30
| 02 Block Diagram
qxn | Wednesday, May 29, 2024 | 2 | 30
| 02 Block Diagram

## DC Terminal System Power


D D

C C

B B

A A

12 ~36V

## OV/UV/Reverse Protecton

## DC-DC VDD_11V

## SYS_VIN_HV

DC-DC 5V_AO | 3V3_AO

## FETs

EN
SYS_VIN_MV | Jetson AGX Orin
LDO | LC1458CB5TR33 | EFM8SB10 uCont.

## DC-DC VDD_3V3

EN

DC-DC SY80004 | VDD_0V7
DC-DC SY80004 | VDD_1V0
DC-DC SY80004 | VDD_2V0
LDO | LC1458CB5TR33 | VDDIO_AQR113C

## 10G Ethernet

## USB Hub

## PCIe to Sata bridge

## 1G Ethernet

RS232/485/422

## Transceiver

## CAN Transceiver

## M.2 Key M

## M.2 Key E

## USB C debug/ USB to Uart bridge

## M.2 Key B/ Mini PCIe

## Fan

DC-DC SY80004 | VDD_1V2
DC-DC SY80004 | VDD_1V25

## VDD_3V3

## DC-DC VDD_1V8

EN

## Expansion Connector

## DC-DC VDD_12V

DC-DC SY80004 | VDD_2V5

## SATA

qxn | Wednesday, May 29, 2024 | 3 | 30
| 03 Power Tree
qxn | Wednesday, May 29, 2024 | 3 | 30
| 03 Power Tree
qxn | Wednesday, May 29, 2024 | 3 | 30
| 03 Power Tree

J20 | GND_175 G20 | GND_174 E20 | GND_173 C20 | GND_172 A20 | GND_171 L21 | GND_170 J21 | GND_169 G21 | GND_168 E21 | GND_167 C21 | GND_166 A21 | GND_165 K22 | GND_164 H22 | GND_163 F22 | GND_162 D22 | GND_161 B22 | GND_160 K23 | GND_159 H23 | GND_158 F23 | GND_157 D23 | GND_156 B23 | GND_155 L24 | GND_154 J24 | GND_153 G24 | GND_152 E24 | GND_151 C24 | GND_150 A24 | GND_149 L25 | GND_148 J25 | GND_147 G25 | GND_146 E25 | GND_145 C25 | GND_144 A25 | GND_143 K26 | GND_142 H26 | GND_141 F26 | GND_140 D26 | GND_139 B26 | GND_138 K27 | GND_137 H27 | GND_136 F27 | GND_135 D27 | GND_134 B27 | GND_133 L28 | GND_132 J28 | GND_131 G28 | GND_130 E28 | GND_129 C28 | GND_128 A28 | GND_127 L29 | GND_126 J29 | GND_125 G29 | GND_124 E29 | GND_123 C29 | GND_122 A29 | GND_121 K30 | GND_120 H30 | GND_119 F30 | GND_118 D30 | GND_117 B30 | GND_116 K31 | GND_115 H31 | GND_114 F31 | GND_113 D31 | GND_112 B31 | GND_111 L32 | GND_110 J32 | GND_109 G32 | GND_108 E32 | GND_107 C32 | GND_106 A32 | GND_105 L33 | GND_104 J33 | GND_103 G33 | GND_102 E33 | GND_101 C33 | GND_100 A33 | GND_099 K34 | GND_098 H34 | GND_097 F34 | GND_096 D34 | GND_095 B34 | GND_094 K35 | GND_093 H35 | GND_092 F35 | GND_091 D35 | GND_090 B35 | GND_089 L36 | GND_088 J36 | GND_087 G36 | GND_086 E36 | GND_085 C36 | GND_084 A36 | GND_083 L37 | GND_082 J37 | GND_081 G37 | GND_080 E37 | GND_079 C37 | GND_078 A37 | GND_077 K38 | GND_076 H38 | GND_075 F38 | GND_074 D38 | GND_073 B38 | GND_072 K39 | GND_071 H39 | GND_070 F39 | GND_069 D39 | GND_068 B39 | GND_067 L40 | GND_066
B40 | FSI_GPIO02 D40 | FSI_GPIO01 F40 | FSI_GPIO00 H40 | MID1 K40 | MID0 J1 | SYS_VIN_HV_39 H1 | SYS_VIN_HV_38 G1 | SYS_VIN_HV_37 F1 | SYS_VIN_HV_36 E1 | SYS_VIN_HV_35 D1 | SYS_VIN_HV_34 C1 | SYS_VIN_HV_33 J2 | SYS_VIN_HV_32 H2 | SYS_VIN_HV_31 G2 | SYS_VIN_HV_30 F2 | SYS_VIN_HV_29 E2 | SYS_VIN_HV_28 D2 | SYS_VIN_HV_27 C2 | SYS_VIN_HV_26 K3 | SYS_VIN_HV_25 H3 | SYS_VIN_HV_24 F3 | SYS_VIN_HV_23 D3 | SYS_VIN_HV_22 B3 | SYS_VIN_HV_21 J63 | SYS_VIN_HV_20 G63 | SYS_VIN_HV_19 F63 | SYS_VIN_HV_18 E63 | SYS_VIN_HV_17 C63 | SYS_VIN_HV_16 B63 | SYS_VIN_HV_15 J64 | SYS_VIN_HV_14 H64 | SYS_VIN_HV_13 G64 | SYS_VIN_HV_12 F64 | SYS_VIN_HV_11 E64 | SYS_VIN_HV_10 D64 | SYS_VIN_HV_09 C64 | SYS_VIN_HV_08 J65 | SYS_VIN_HV_07 H65 | SYS_VIN_HV_06 G65 | SYS_VIN_HV_05 F65 | SYS_VIN_HV_04 E65 | SYS_VIN_HV_03 D65 | SYS_VIN_HV_02 C65 | SYS_VIN_HV_01 L22 | SYS_VIN_MV_10 L23 | SYS_VIN_MV_09 L26 | SYS_VIN_MV_08 L27 | SYS_VIN_MV_07 L30 | SYS_VIN_MV_06 L31 | SYS_VIN_MV_05 L34 | SYS_VIN_MV_04 L35 | SYS_VIN_MV_03 L38 | SYS_VIN_MV_02 L39 | SYS_VIN_MV_01


reServer industrial J501 04 CVM Connector 1/3

E54 | FAN_TACH B55 | GPIO30 B54 | WDT_RESET_OUT_N K57 | PWM01 A55 | GPIO34 C54 | GPIO33 J55 | GPIO32 H54 | UART1_CTS L51 | UART1_RTS K54 | UART1_RX K53 | UART1_TX K56 | GPIO19 C55 | GPIO18 A54 | GPIO17 F53 | I2C3_CLK E53 | I2C3_DAT L57 | MCLK05 H55 | MCLK04 H53 | MCLK03 J54 | MCLK02 L8 | I2C1_DAT K5 | I2C1_CLK E4 | I2S2_FS F6 | I2S2_DIN F5 | I2S2_DOUT G4 | I2S2_CLK L50 | GPIO35 L9 | GPIO28 L48 | UART4_RX L49 | UART4_CTS L4 | UART4_RTS L5 | UART4_TX L6 | GPIO02 J4 | GPIO01 L11 | SLEEP_REQ_N L10 | FORCE_RECOVERY_N J5 | ENET_INT H5 | ENET_RST_N E6 | RGMII_SMA_MDC E7 | RGMII_SMA_MDIO D5 | RGMII_RX_CTL E5 | RGMII_RD3 H6 | RGMII_RD2 K6 | RGMII_RD1 C4 | RGMII_RD0 C5 | RGMII_RXC K7 | RGMII_TX_CTL G6 | RGMII_TD3 J7 | RGMII_TD2 G5 | RGMII_TD1 J6 | RGMII_TD0 B5 | RGMII_TXC D6 | SDCARD_D3 A4 | SDCARD_D2 F8 | SDCARD_D1 E8 | SDCARD_D0 A5 | SDCARD_CMD B6 | SDCARD_CLK A7 | GPIO29 F9 | GPIO16 F10 | GPIO15 L15 | GPIO14 G7 | GPIO13 E10 | GPIO12 B8 | GPIO11 H9 | MCLK01 D8 | I2S1_FS H8 | I2S1_SDIN C7 | I2S1_SDOUT L14 | I2S1_CLK


I2S1_DOUT | UART2_RXD
I2S1_DIN | UART2_RTS

RGMII_TD3 | I2S4_DOUT
RGMII_TX_CTL | I2S4_FS
RGMII_RXC | I2S4_SCLK

reServer industrial J501 05 CVM Connector 2/3

[30] | IN [30] | IN [30] | IN [30] | IN [30] | IN [30] | IN [30] | IN [30] | IN [30] | IN [30] | IN [30] | IN [30] | IN [30] | IN [30] | IN [30] | IN [30] | IN [30] | IN [30] | IN
E34 | FSI_GPIO15 E35 | FSI_GPIO14 F36 | FSI_GPIO13 F37 | FSI_GPIO12 A38 | PEX_C8_CLKREQ_N A39 | PEX_C8_RST_N C39 | UPHY_REFCLK4_P C38 | UPHY_REFCLK4_N B37 | PEX_C7_CLKREQ_N B36 | PEX_C7_RST_N D36 | FSI_GPIO11 D37 | PMIC_BBATT A34 | UPHY_RX23_P A35 | UPHY_RX23_N D33 | UPHY_RX22_P D32 | UPHY_RX22_N B33 | UPHY_RX21_P B32 | UPHY_RX21_N C34 | UPHY_RX20_P C35 | UPHY_RX20_N H36 | FSI_GPIO10 H37 | FSI_GPIO09 G39 | FSI_GPIO08 G38 | FSI_GPIO07 J39 | FSI_GPIO06 J38 | FSI_GPIO05 K36 | FSI_GPIO04 K37 | FSI_GPIO03 H32 | UPHY_TX23_P H33 | UPHY_TX23_N J35 | UPHY_TX22_P J34 | UPHY_TX22_N G35 | UPHY_TX21_P G34 | UPHY_TX21_N K32 | UPHY_TX20_P K33 | UPHY_TX20_N F32 | UPHY_REFCLK3_P F33 | UPHY_REFCLK3_N E30 | UPHY_REFCLK0_P E31 | UPHY_REFCLK0_N A30 | UPHY_RX19_P A31 | UPHY_RX19_N C31 | UPHY_RX18_P C30 | UPHY_RX18_N B29 | UPHY_RX17_P B28 | UPHY_RX17_N D28 | UPHY_RX16_P D29 | UPHY_RX16_N A26 | UPHY_RX15_P A27 | UPHY_RX15_N C27 | UPHY_RX14_P C26 | UPHY_RX14_N B25 | UPHY_RX13_P B24 | UPHY_RX13_N D24 | UPHY_RX12_P D25 | UPHY_RX12_N J30 | UPHY_TX19_P J31 | UPHY_TX19_N G31 | UPHY_TX18_P G30 | UPHY_TX18_N K29 | UPHY_TX17_P K28 | UPHY_TX17_N H28 | UPHY_TX16_P H29 | UPHY_TX16_N J26 | UPHY_TX15_P J27 | UPHY_TX15_N G27 | UPHY_TX14_P G26 | UPHY_TX14_N K25 | UPHY_TX13_P K24 | UPHY_TX13_N H24 | UPHY_TX12_P H25 | UPHY_TX12_N


PCIe x8 C5 to PCIe CEM

reServer industrial J501 06 CVM Connector 3/3

# 3V3_AO

# Vin protection


3 SS 4 COMP 5 FB 6 CCM/AAM 7 FREQ 8 PG 9

5 FB 6 COMP 7 RT 8 VIN3 16 EN 15 PG 14 BS 13

reServer industrial J501 07 Power Vin 5V 3V3_AO 1V8 0V7

VDD_11V | VDD_11V Discharge

# VDD_3V3 Supervisor


3 SS 4 COMP 5 FB 6 CCM/AAM 7 FREQ 8 PG 9

ILIM = FLOAT | Min | Typ

V ILIMIT | | 75mV | 85mV

# Debug - C2

# Button MCU For Power Up


U61 EFM8SB10F8G
VDD 4 P1.7 7 P1.6 8 P1.5 9 P1.3 10 P1.2 11 P2.7_C2D 6 RST*_C2CK 5 GND 3 GND 12 EPAD 21

reServer industrial J501 09 Button MCU For Power Up

# 10GB ETHERNET

# 16 TD1+


# GB ETHERNET

### 100 ohms differential


R* Should close to CPU.

R* Should close to PHY.

JTAG pins can be left
unconnected if not used

PHY address set to 0X00

RGMII Clock Skew RX[0:2]=[000]

Autoneg enable. For Disabling

LED1 & LED2: MODE1
RGMII Clock Skew TX[0:2]=[000]
ANEG_SEL(Auto-negotiation)=[0]
PHY_LED[0:2] CANT CONFIGURE IN MODE4

# USB3.1 GEN1 HUB x4 PORTS

### Reset


Note: When pulled high enables gang mode.

(Fill the GND FLAG with
at least 20 GND vias.)

Note: VDD12 should come up before VDD33.

200 kΩ Pull-Down, No battery charging.

200 kΩ Pull-Down, All ports removable.

# USB3.1 TYPE-A x2 (A)


# USB3.1 TYPE-A x2 (B)


# USB Type C For Debug UART USB2.0 Only


ADR HIGH: 0x3D
ADR LOW : 0x1D
ADR MID: I2C disabled
Mode:
PORT LOW: UFP mode

# M.2 KEY-E (WIFI/BT)


GND 33 PETp0 35 PETn0 37 GND 39 PERp0 41 PERn0 43 GND 45 REFCLKp0 47 REFCLKn0 49 GND 51 CLKREQ0#(I/O)(0/3.3V) 53 PEWAKE0#(I/O)(0/3.3V) 55 GND 57 RSVD/PETp1 59 RSVD/PETn1 61 GND 63 RSVD/PERp1 65 RSVD/PERn1 67 GND 69 RSVD/REFCLKp1 71 RSVD/REFCLKn1 73 GND 75

# M.2 KEY-M (NVME)


# M.2 KEY-B (4G/5G)


M2B_SSRX4_N | C0402 | 25V,X7R C160 | 100nF

M2B_DPR_1V8

W_DISABLE1#_3V3
PCIe =3.3V
M.2 Key B=1.8V and 3.3V.
Must be 3.3 V tolerant for Adapters that support 1.8 V sideband signaling.
Platforms that expect 1.8 V sideband signaling must protect themselves from legacy 3.3 V adapters.

Place the MH9 MH10 to the other side of M.2 Key-B connector.


Place the MH3 MH4 to the same side of PCIe connector.

sot-323-3
Pin8: SX1261_BUSY, 3.3V, No Pull-Up/Down in the LoRa module, active high.
Pin10: SX1261_RST, 3.3V, 10K Pull-Up in the LoRa module.

# HDMI Connector


SoC Fan Header 4pin | Carrier Board Config


BRD_ID_A1

# Digital Outputs (DO) rated 40V/0.2A Digital Inputs (DI)


# Isolated DCDC 5V to 5V


-1.25mm on top/bottom layer
-0.25mm on inner layers

The U10 (MORNSUN,B0505S-1WR3) is 1W 5V/200mA.
If use 3W 5V/600mA, can replaced by 310031469(Murata,MEE3S0505SC).

Terminating Resistor Switch.
CAN_120R_EN=L to enable terminating resistor.

CAN FD : 5Mbps
Pin to Pin：TI,ISO1042BDWR


24 TPM, IIC to IO


-1.25mm on top/bottom layer
-0.25mm on inner layers

MODE | 001 | 000/100 | 010/110

PIN | RS232 | RS422 | RS485

1 Data- | | TXD-

2 TXD+ | RXD | | Data+

3 | TXD | RXD+

4 | | RXD-

5 | GND | GND | GND

7 | RTS

8 | CTS

SLEW
Slew rate control pin, Logical Low input will limit driver slew from either
RS-232 to 1Mbps or RS-485 to 10Mbps. Internal pull high= 625KΩ.

# Sata Controller


# SATA PORT 0

# (To SATA HDD)


* Place Capacitors close to Connector

# OUTPUT

# INPUT


https://www.seeedstudio.com

SHIELD__3 S4 | 1 1 | 2 | 2 3 3 | 4 | 4 5 5 | 6 | 6 7 7 | 8 | 8 9 9


https://www.seeedstudio.com


https://www.seeedstudio.com
