Seeed-Studio/OSHW-Jetson-Series/reServer Jetson carrier board/reServer Industrial J501/Schematic/GMSL2_Adapter_Board_For_J501_v1_SCH.pdf

DATE | REVISION | DESCRIPTION
02 | Block Diagram

SHEET NAME; Revision History; Jun.17 2024; First release.; Title: Size:; Document Number:; Rev: Draw By:; Date:; Sheet:; https://www.seeedstudio.com A3; qxn; Monday, June 17, 2024; GMSL2 Adapter Board For J501 01 Table of Contents Title: Size:

Schematic: GMSL2 Adapter Board For J501
SHEET
01 Table of Contents

03 03 Power
04 | 04 GMSL1
05 | 05 GMSL2
06 | 06 Camera Connector1
07 07 Camera Expansion

GMSL2 Adapter Board For J501 01 Table of Contents

## Power 12V DC

Expansion Conn.; Camera Expansion Conn.; GMSL Deserializer HUB; Power Switch; GMSL Conn. Mini Fakra 4x Coaxi; CSI 2.5Gbps x 4Lane; GMSL2 3Gpbs x 4; POC Filters; https://www.seeedstudio.com A3; qxn; Monday, June 17, 2024

Board ID EEPROM

GMSL2 Adapter Board For J501 02 Block Diagram

# R0402 R11 DNP

# TP5 C6


# 1 of 2 U1A MAX96724RGTNV

# SIOAN 22 SIOAP 23 SIOCN 9 SIOCP 10 X1/OSC 15 X2 16 XRES 17


NC 43 NC_2 44 NC_3 45 NC_4 46 NC_5 47 NC_6 48 NC_7 49 NC_8 50 NC_9 51 NC_10 52 NC_11 53 NC_12 54 CAP_VDD 8 CAP_VDD_2 20 VDD 55 VDD_2 56 VDD18 7 VDD18_2 21 VDDIO 24 VTERM 30 GND 57

# 1 of 2 U5A MAX96724RGTNV

# SIOAN 22 SIOAP 23 SIOCN 9 SIOCP 10 X1/OSC 15 X2 16 XRES 17

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

[3] | POC1 | IN [3] | POC2 | IN [3] | POC3 | IN [3] | POC4 | IN

# B0P C0P D0P


A Place AC capacitor as close as
possible to the chip, maximum
500mil

# MIPI Connector

# J1 QTH-030-04-L-D-A


9 | 10 10
