Seeed-Studio/OSHW-Jetson-Series/reComputer Jetson carrier board/reComputer Industrial J201/Schematic/reComputer Industrial J201_V1.2.pdf

# 01 Table of Contents

02 | SODIMM Connector 1/3

SHEET NAME; VER; DATE; REVISION; DESCRIPTION; reComputer Industrial J201_V1.1_SCH_230615 06/15/2023; reComputer Industrial J201_V1.2_SCH_231011 10/11/2023; Revision History; Title: Size:; Document Number:; Rev: Draw By:; Date:; Sheet:; https://www.seeedstudio.com A3; Junqing.Xin; Wednesday, October 11, 2023; reComputer Industrial J201 01 Table of Contents Title: Size:

Schematic: reComputer Industrial J201
SHEET

V1.0 | 04/23/2023 | reComputer Industrial J201_V1.0_SCH_230423 | Initial Version.

03 | SODIMM Connector 2/3
04 | SODIMM Connector 3/3
05 | Power In, 5V, 3.3V_MCU
06 | 3.3V, 1.8V, 1.2V
07 | Button MCU For Power Up
08 | USB3.1 HUB
09 | USB3.1 Type-A x2 (A)
10 | USB3.1 Type-A x1 (B)
11 | HDMI
12 | CAM Connector
13 | Type C, Debug UART
14 | Gigabit Ethernet, POE
15 | PCIe to Ethernet
16 | M.2 KEY-M (NVME)
17 | M.2 KEY-B (4G/5G)
18 | Mini PCIe (4G/LoRa)
19 | Fan, EEPROM, Debug
20 | DI, DO
21 | CAN, Isolated 5V
22 | TPM, USB to WiFi, IIC to IO
23 | RS232/422/485

Page 04:Added R448=0R in net DP0_HPD.
Page 14:Added TVS D102,D103,D104 in PoE.
Page 18:Added series diode D101 to R287.

Page 07:Changed R107 from 499R to 0R;

Changed X2 12MHz from CL=18pF to CL=10pF;
Changed C73,C75 from 27pF to 12pF.

Page 05:Moved R373,C248 from the Drain of Q17 to

Source for "reverse polarity protection".

reComputer Industrial J201 01 Table of Contents

# UART, I2C, CAN and GPIOs

I2C0_SCL | [22] UART0_TXD | [17,18] UART0_RXD | [17,18] UART1_TXD | [23] UART1_RXD | [23] UART1_RTS | [23] UART1_CTS | [23] UART2_TXD | [13] UART2_RXD | [13] MOD_SLEEP* | [11,14,19,21] POWER_EN | [7] SHUTDOWN_REQ* | [5,7] SYS_RST* | [7,19] FORCE_RECOVERY* | [19]


VDD_IN 251 VDD_IN 252 VDD_IN 253 VDD_IN 254 VDD_IN 255 VDD_IN 256 VDD_IN 257 VDD_IN 258 VDD_IN 259 VDD_IN 260 GND 1 GND 2 GND 7 GND 8 GND 13 GND 14 GND 19 GND 20 GND 25 GND 26 GND 31 GND 32 GND 37 GND 38 GND 43 GND 44 GND 49 GND 50 GND 55 GND 56 GND 61 GND 62 GND 67 GND 68 GND 73 GND 74 GND 79 GND 80 GND 85 GND 86 GND 102 GND 107 GND 113 GND 119 GND 125 GND 129 GND 132 GND 135 GND 138 GND 141 GND 144 GND 146 GND 147 GND 152 GND 153 GND 158

M.2 Key-B & Mini PCIe WIFI/BT

reComputer Industrial J201 02 SODIMM Connector 1/3

# GPIOs, USB2.0, I2S, SPI, GBe and CSI

CSI0_D0_P 6 CSI0_D0_N 4 CSI0_D1_P 18 CSI0_D1_N 16 CSI0_CLK_P 12 CSI0_CLK_N 10 CSI1_D0_P 5 CSI1_D0_N 3 CSI1_D1_P 17 CSI1_D1_N 15


USB to WiFi
I2S1_SCLK 226 GBE_LED_LINK 188 GBE_LED_ACT 194 GBE_MDI0_P 186 GBE_MDI0_N 184 GBE_MDI1_P 192 GBE_MDI1_N 190 GBE_MDI2_P 198 GBE_MDI2_N 196 GBE_MDI3_P 204 GBE_MDI3_N 202 SDMMC_DAT0/PCIE2_RST* 219 SDMMC_DAT1/PCIE2_CLKREQ* 221 SDMMC_DAT2/PCIE3_RST* 223 SDMMC_DAT3/PCIE3_CLKREQ* 225 SDMMC_CMD/PCIE3_CLK_N 227 SDMMC_CLK/PCIE3_CLK_P 229 GPIO00 (USB_VBUS_EN0) 87 GPIO01 (CLK) 118 GPIO02 124 GPIO03 126 GPIO04 127 GPIO05 128 GPIO06 130 GPIO07 (PWM) 206 GPIO08 (SDMMC_CD) 208 GPIO09 (AUD_MCLK) 211 GPIO10 212 GPIO11 (CLK) 216 GPIO12 218 GPIO13 (PWM) 228 GPIO14 (PWM) 230

CAM FPC Con
TP10 Test Point TP31 Test Point
TP21 Test Point TP36 Test Point
TP11 Test Point TP30 Test Point
TP22 Test Point TP45 Test Point
TP12 Test Point TP18 Test Point

reComputer Industrial J201 03 SODIMM Connector 2/3

# HDMI, DP, DSI, USBSS and PCIe

PCIE_WAKE | [15,16] PCIE0_RST | [16] PCIE0_CLKREQ | [16] PCIE0_CLK_P | [16] PCIE0_CLK_N | [16] PCIE0_TX0_P | [16] PCIE0_TX0_N | [16] PCIE0_RX0_P | [16] PCIE0_RX0_N | [16] USBSS_TX_P | [8] USBSS_TX_N | [8] USBSS_TX_HUB_P | [8] USBSS_TX_HUB_N | [8]


DSI_D0_P/RSVD 72 DSI_D0_N/RSVD 70 DSI_D1_P/RSVD 84 DSI_D1_N/RSVD 82 DSI_CLK_P/RSVD 78 DSI_CLK_N/RSVD 76 DP0_TXD0_P/USBSS1_RX_P 41 DP0_TXD0_N/USBSS1_RX_N 39 DP0_TXD1_P/USBSS1_TX_P 47 DP0_TXD1_N/USBSS1_TX_N 45 DP0_TXD2_P/USBSS2_RX_P 53 DP0_TXD2_N/USBSS2_RX_N 51 DP0_TXD3_P/USBSS2_TX_P 59 DP0_TXD3_N/USBSS2_TX_N 57 DP0_AUX_P/RSVD 92 DP0_AUX_N/RSVD 90 DP0_HPD/RSVD 88 DP1_TXD0 (HDMI_TXD2)_P 65 DP1_TXD0 (HDMI_TXD2)_N 63 DP1_TXD1 (HDMI_TXD1)_P 71 DP1_TXD1 (HDMI_TXD1)_N 69 DP1_TXD2 (HDMI_TXD0)_P 77 DP1_TXD2 (HDMI_TXD0)_N 75 DP1_TXD3 (HDMI_TXC)_P 83 DP1_TXD3 (HDMI_TXC)_N 81 DP1_AUX_P (HDMI_DDC_SCL) 100 DP1_AUX_N (HDMI_DDC_SDA) 98 DP1_HPD (HDMI_HPD) 96 HDMI_CEC 94 CLK_32K_OUT 210

CSI5_D0_P CSI5_D0_N
Test Point TP32 Test Point TP37 Test Point TP23
Test Point TP35 Test Point TP25
Test Point TP40 Test Point TP15 Test Point TP7 Test Point TP33
Test Point TP17 Test Point TP38 Test Point TP24

USB Type-A Con (USBSS)

reComputer Industrial J201 04 SODIMM Connector 3/3

# U49 SOT23-5 DNP

DNP 1 2 | R164 | 0R


3 SS 4 COMP 5 FB 6 CCM/AAM 7 FREQ 8 PG 9

Pin20 Enable Control Pin: VIN UVLO: VDD_DCIN=Ven*(1+R185/R181) Rising: VDD_DCIN = Ven*(1+R185/R181) =1.22V*(1+100K/22K) =6.765V

reComputer Industrial J201 05 Power In, 5V, 3.3V_MCU

# 24V to 3.3V

# DNP C95


3 SS 4 COMP 5 FB 6 CCM/AAM 7 FREQ 8 PG 9

ILIM = FLOAT | | Typ

65mV | 75mV R112 V ILIMIT | Max 9.286A Min 85mV

Note: VDD12 should come up before VDD33(VDD33 should rise after or at the same rate as VDD12).

# Button MCU For Power Up

1A 1 2 C98


GPIO0 2 GPIO1 3 GPIO2 4 GPIO3 5 GPIO4 6 GPIO5 7 GPIO6 8 GPIO7 9 GPIO8 11 GPIO9 12 GPIO10 13 GPIO11 14 GPIO12 15 GPIO13 16 GPIO14 17 GPIO15 18 GPIO16 27 GPIO17 28 GPIO18 29 GPIO19 30 GPIO20 31 GPIO21 32 GPIO22 34 GPIO23 35 GPIO24 36 GPIO25 37 GPIO26/ADC0 38 GPIO27/ADC1 39 GPIO28/ADC2 40 GPIO29/ADC3 41 RUN 26 SWCLK 24 SWDIO 25 TESTEN 19 XIN 20 XOUT 21

VDD_DCIN

reComputer J101 | 1 GPIO23 1 | 1

reComputer J202/J201 | 0 | 1

reComputer J401 | | 0

reComputer Industrial J201 07 Button MCU For Power Up

# USB3.1 GEN1 HUB x4 PORTS

HUB_HSD1_P | [9] HUB_HSD1_N | [9] HUB_SSTX1_P [9] HUB_SSTX1_N [9] HUB_SSRX1_P [9] HUB_SSRX1_N [9] HUB_HSD2_P | [9] HUB_HSD2_N | [9] HUB_HSD3_P | [10] HUB_HSD3_N | [10] HUB_SSTX3_P [10] HUB_SSTX3_N [10] HUB_SSRX3_P [10] HUB_SSRX3_N [10] HUB_HSD4_P | [17] HUB_HSD4_N | [17] HUB_SSTX4_P [17] HUB_SSTX4_N [17] HUB_SSRX4_P [17] HUB_SSRX4_N [17] HUB_PRT_CTL1 [9] HUB_PRT_CTL2 [9] HUB_PRT_CTL3 [10]


RBIAS 56 XTALI/CLK_IN 54 XTALO 53 TESTEN/ATEST 52 USBRXM_UP 51 USBRXP_UP 50
USBSS_RX_HUB_P HUB_XTALO
RESET 42 SPI_CE_N/CFG_NON_REM 41 SPI_DI/CFG_BC_EN 40 SPI_DO/SMDAT 39 SPI_CLK/SMCLK 38

Port Power Control (Fill the GND FLAG with

at least 20 GND vias.)

Note: VDD12 should come up before VDD33.

200 kΩ Pull-Down, No battery charging.

# USB3.1 TYPE-A x2 (A)


# USB3.1 TYPE-A x1 (B)

4 | 3 R19 | 0R


# HDMI Connector


CSI CAM CONNECTOR | VDD_3V3_SYS
15 15 | 16 16 17 17


reComputer Industrial J201 12 CAM Connector

# USB Type C For NX USB2.0 Only


USB Type C For Debug UART & RP2040
USB2.0 Only

USB2_0_TYPE_C_long CC1 A5 DP1 A6 DN1 A7 SBU1 A8 A1/B12/GND B12 A12/B1/GND B1 A9/B4/VBUS B4 CC2 B5 DP2 B6 DN2 B7 SBU2 B8 A4/B9/VBUS B9 S1 S1 S2 S2 S3 S3 S4 S4 S5 S5 S6 S6

reComputer Industrial J201 13 Type C, Debug UART

# Gigabit Ethernet with PoE

SHIELD_1 19 | SHIELD_2 20 | MCT_1 4 | MCT_2 5


Vin+ 1 Vin+ 2 Vin- 3 Vin- 4 PSE+ 5 PSE- 6 D102 SMBJ58CA DO_214AA_SMB

reComputer Industrial J201 14 Gigabit Ethernet, POE

PCIe to Ethernet | VDD_3V3_SYS

## 1 of 2 U38A


LAN7430-I/Y9X
qfn48_0d5_7x7mm
RESETn 29 TEST 30 PERST# 44 PCIE_CLK_P 25 PCIE_CLK_M 26 PCIE_TX_P 19 PCIE_TX_M 21 PCIE_RX_P 16 PCIE_RX_M 17 CLKREQ# 42 WAKE# 43 RESREF 24

# M.2 KEY-M (NVME)


reComputer Industrial J201 16 M.2 KEY-M (NVME)

# M.2 KEY-B (4G/5G)


layout Note: Place the MH9 MH10 to the other side of M.2 Key-B connector. Must be 3.3 V tolerant for Adapters that support 1.8 V sideband signaling. Platforms that expect 1.8 V sideband signaling must protect themselves from legacy 3.3 V adapters.


layout Note: Place the MH3 MH4 to the same side of PCIe connector.

Pin10: SX1261_RST, 3.3V, 10K Pull-Up in the LoRa module. Pin8: SX1261_BUSY, 3.3V, No Pull-Up/Down in the LoRa module, active high.

CTS RTS Need Check?

reComputer Industrial J201 18 Mini PCIe (4G/LoRa)

# SoC Fan Header 4pin

# Carrier Board Config


reComputer Industrial J201 19 Fan, EEPROM, Debug

# Digital Outputs (DO) rated 40V/0.4A Digital Inputs (DI)

# VDD_1V8 VDD_1V8 VDD_1V8


reComputer Industrial J201 20 DI, DO

# Isolated DCDC 5V to 5V


If use 3W 5V/600mA, can be replaced by 310031469(Murata,MEE3S0505SC). Design Note:

If use 1W 5V/200mA, can be replaced by 310032274(MORNSUN,B0505S-1WR3) The U10 (MORNSUN,IB0505S-W75R3) is 0.75W 5V/150mA. GND_ISO

Isolation Barrier: -1.25mm on top/bottom layer
U7 TPT71044-SOBR

-1.25mm on top/bottom layer
-0.25mm on inner layers

reComputer Industrial J201 21 CAN, Isolated 5V

# U57 TXB0104PWR


USB to WiFi/Bluetooth

reComputer Industrial J201 22 TPM, USB to WiFi, IIC to IO

# 9 G¹ 10 G² 11

# U47 TXB0104PWR


-1.25mm on top/bottom layer
-0.25mm on inner layers

8 MODE 2 1 | RXD- GND TXD+ RXD+ | RS485 GND Data- TXD

3 | RS232 RXD | RS422 | Data+ TXD- PIN

6 | RTS CTS GND

2 | 5 TP60C_SMD Test Point TP52 TP60C_SMD Test Point TP50 7
