Seeed-Studio/OSHW-Jetson-Series/reComputer Jetson carrier board/reComputer J301-J401/Schematic/reComputer_J401_SCH_V1.0.pdf

DATE | REVISION | DESCRIPTION
02 | Block Diagram

SHEET NAME; Initial Release.; Revision History; reComputer J401_V1.0_SCH_230105; Title: Size:; Document Number:; Rev: Draw By:; Date:; Sheet:; https://www.seeedstudio.com A3; Junqing.Xin; Wednesday, February 15, 2023; reComputer J401 01 Table of Contents Title: Size:

Schematic: reComputer J401
SHEET
01 Table of Contents

03 Power Tree
04 | SODIMM Connector 1/3
05 | SODIMM Connector 2/3
06 | SODIMM Connector 3/3
07 | Power In & 5V & 3.3V_MCU
08 | 3.3V & 1.8V & 1.05V
09 | Button MCU For Power Up
10 USB3.2 HUB
11 USB3.2 Type-A x2 (A)
12 | USB3.2 Type-A x2 (B)
13 HDMI
14 | CAM Connector
15 | Gigabit Ethernet, Type C
16 | M.2 KEY-E (WIFI/BT)
17 | M.2 KEY-M (NVME)
18 40Pin GPIO Expansion Header
19 | Fan, Debug and EEPROM

reComputer J401 01 Table of Contents

# BASEBOARD CIRCUIT

POWER; BASEBOARD I/O CONN; SODIMM CONN; RF Antenna; Map Legend:; Block Diagram; USBSS2 PCIE2 PCIE3; UART0 UART1 UART2; GPIO (AUD_MCLK) GPIO (CAM_AF_EN) GPIO_PE6 (CAM_STROBE) GPIO_PZ0 (CAM_RST) GPIO (LCD_BL_PWM) GPIO (LCD_TE); CSI4; CSI3; CSI0 CSI2 GPIO (CAM1_MCLK) GPIO (CAM1_PWDN) GPIO (CAM2_MCLK) GPIO (CAM2_PWDN); GPIO (FAN_PWM) GPIO (FAN_TACH); PMIC_BBAT; SYS_RESET_IN*; GPIO (FORCE_RECOVERY*); GPIO (BUTTON_PWR_ON*); USB0; USB1 USB2; PCIE0_LAN0 PCIE0_LAN1 PCIE0_LAN2 PCIE0_LAN3; PCIE1_LAN0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

260 Pin
SODIMM CONN
Xavier/Orin NX

reComputer J401 02 Block Diagram

# Jetson Xavier/Orin NX

BUTTON MCU; BOARD CONFIG EEPROM; LEVEL SHIFTERS x6; 3V3 DCDC VDD_3V3_SYS; 5V DCDC VDD_5V_SYS; 1V05 DCDC VDD_1V05; USB 3.2 HUB; M.2 WIFI/BT; M.2 NMVe; CSI0 CAMERA CONNECTOR; CSI2 CAMERA CONNECTOR; 40PIN HDR; ETHERNET RJ45/LEDs/POE; HDMI ULSW; x4 USB Type-A; 3V3 LDO 3V3_MCU; 1V8 LDO VDD_1V8; DCIN (1x2 HDR) 9V-19V@3A; POE PD (optional); DC Jack (19V@5A); Jetson Xavier/Orin NX; EXT.POWER SOURCE; POWER DC DC; POWER LDO; BASEBOARD CIRCUIT; DNP (user option); Map Legend:; Power Topology; PWR LED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

Overvoltage protection
Soft start circuit +

POE HV(1x4 HDR)

reComputer J401 03 Power Tree

# UART, I2C, CAN and GPIOs

ID_I2C_SCL | [18] UART0_TXD | [16] UART0_RXD | [16] UART1_TXD | [18] UART1_RXD | [18] UART1_RTS | [18] UART1_CTS | [18] UART2_TXD | [19] UART2_RXD | [19] MOD_SLEEP* | [13,19] POWER_EN | [9] SHUTDOWN_REQ* | [7,9] SYS_RST* | [9,19] FORCE_RECOVERY* | [19]


VDD_IN 251 VDD_IN 252 VDD_IN 253 VDD_IN 254 VDD_IN 255 VDD_IN 256 VDD_IN 257 VDD_IN 258 VDD_IN 259 VDD_IN 260 GND 1 GND 2 GND 7 GND 8 GND 13 GND 14 GND 19 GND 20 GND 25 GND 26 GND 31 GND 32 GND 37 GND 38 GND 43 GND 44 GND 49 GND 50 GND 55 GND 56 GND 61 GND 62 GND 67 GND 68 GND 73 GND 74 GND 79 GND 80 GND 85 GND 86 GND 102 GND 107 GND 113 GND 119 GND 125 GND 129 GND 132 GND 135 GND 138 GND 141 GND 144 GND 146 GND 147 GND 152 GND 153 GND 158

# GPIOs, USB2.0, I2S, SPI, GBe and CSI

CSI0_D0_P 6 CSI0_D0_N 4 CSI0_D1_P 18 CSI0_D1_N 16 CSI0_CLK_P 12 CSI0_CLK_N 10 CSI1_D0_P 5 CSI1_D0_N 3 CSI1_D1_P 17 CSI1_D1_N 15


M.2 Key-E BT
I2S1_SCLK 226 GBE_LED_LINK 188 GBE_LED_ACT 194 GBE_MDI0_P 186 GBE_MDI0_N 184 GBE_MDI1_P 192 GBE_MDI1_N 190 GBE_MDI2_P 198 GBE_MDI2_N 196 GBE_MDI3_P 204 GBE_MDI3_N 202 SDMMC_DAT0/PCIE2_RST* 219 SDMMC_DAT1/PCIE2_CLKREQ* 221 SDMMC_DAT2/PCIE3_RST* 223 SDMMC_DAT3/PCIE3_CLKREQ* 225 SDMMC_CMD/PCIE3_CLK_N 227 SDMMC_CLK/PCIE3_CLK_P 229 GPIO00 (USB_VBUS_EN0) 87 GPIO01 (CLK) 118 GPIO02 124 GPIO03 126 GPIO04 127 GPIO05 128 GPIO06 130 GPIO07 (PWM) 206 GPIO08 (SDMMC_CD) 208 GPIO09 (AUD_MCLK) 211 GPIO10 212 GPIO11 (CLK) 216 GPIO12 218 GPIO13 (PWM) 228 GPIO14 (PWM) 230

CAM FPC Con
TP12 Test Point TP23 Test Point

# HDMI, DP, DSI, USBSS and PCIe

PCIE_WAKE | [16,17] PCIE0_RST | [17] PCIE0_CLKREQ | [17] PCIE0_CLK_P | [17] PCIE0_CLK_N | [17] PCIE0_TX0_P | [17] PCIE0_TX0_N | [17] PCIE0_RX0_P | [17] PCIE0_RX0_N | [17] USBSS_TX_P | [10] USBSS_TX_N | [10] USBSS_TX_HUB_P | [10] USBSS_TX_HUB_N | [10]


DSI_D0_P/RSVD 72 DSI_D0_N/RSVD 70 DSI_D1_P/RSVD 84 DSI_D1_N/RSVD 82 DSI_CLK_P/RSVD 78 DSI_CLK_N/RSVD 76 DP0_TXD0_P/USBSS1_RX_P 41 DP0_TXD0_N/USBSS1_RX_N 39 DP0_TXD1_P/USBSS1_TX_P 47 DP0_TXD1_N/USBSS1_TX_N 45 DP0_TXD2_P/USBSS2_RX_P 53 DP0_TXD2_N/USBSS2_RX_N 51 DP0_TXD3_P/USBSS2_TX_P 59 DP0_TXD3_N/USBSS2_TX_N 57 DP0_AUX_P/RSVD 92 DP0_AUX_N/RSVD 90 DP0_HPD/RSVD 88 DP1_TXD0 (HDMI_TXD2)_P 65 DP1_TXD0 (HDMI_TXD2)_N 63 DP1_TXD1 (HDMI_TXD1)_P 71 DP1_TXD1 (HDMI_TXD1)_N 69 DP1_TXD2 (HDMI_TXD0)_P 77 DP1_TXD2 (HDMI_TXD0)_N 75 DP1_TXD3 (HDMI_TXC)_P 83 DP1_TXD3 (HDMI_TXC)_N 81 DP1_AUX_P (HDMI_DDC_SCL) 100 DP1_AUX_N (HDMI_DDC_SDA) 98 DP1_HPD (HDMI_HPD) 96 HDMI_CEC 94 CLK_32K_OUT 210

CSI5_D0_P CSI5_D0_N
Test Point TP48 Test Point TP49 Test Point TP18 Test Point TP26
Test Point TP20 Test Point TP50
Test Point TP51 Test Point TP28 Test Point TP52 Test Point TP44
Test Point TP53 Test Point TP45 Test Point TP19

USB Type-A Con (USBSS)

# U43 SOT23-5 DNP

# DNP R37


3 SS 4 COMP 5 FB 6 CCM/AAM 7 FREQ 8 PG 9

Pin20 Enable Control Pin: VIN UVLO: VDD_DCIN=Ven*(1+R13/R24) Rising: VDD_DCIN = Ven*(1+R13/R24) =1.22V*(1+100K/22K) =6.765V

# 19V to 3.3V

R0402 C132


3 SS 4 COMP 5 FB 6 CCM/AAM 7 FREQ 8 PG 9

= 0.8V x 4.161290 I pk | Min | Typ

ILIM = VCC1 R161 V ILIMIT | 40mV | 7mR 50mV | Max 7.143A 60mV

# Button MCU For Power Up MCU


GPIO0 2 GPIO1 3 GPIO2 4 GPIO3 5 GPIO4 6 GPIO5 7 GPIO6 8 GPIO7 9 GPIO8 11 GPIO9 12 GPIO10 13 GPIO11 14 GPIO12 15 GPIO13 16 GPIO14 17 GPIO15 18 GPIO16 27 GPIO17 28 GPIO18 29 GPIO19 30 GPIO20 31 GPIO21 32 GPIO22 34 GPIO23 35 GPIO24 36 GPIO25 37 GPIO26/ADC0 38 GPIO27/ADC1 39 GPIO28/ADC2 40 GPIO29/ADC3 41 RUN 26 SWCLK 24 SWDIO 25 TESTEN 19 XIN 20 XOUT 21

VDD_DCIN

reComputer J101 | 1 GPIO23 1 | 1

reComputer J202 | 0 | 1

reComputer J401 | | 0

VDD_DCIN 9V | FORCE_OFF* 19V 1.725V

23V | XXXXX

reComputer J401 09 Button MCU For Power Up

# VCC33_4 62 GPIO5/EXTPWRON/WAKE 63 GPIO6 / USBSUS 64 GPIO7 / SMDAT 65 GPIO8 / SMCLK 66

VDD_3 67 RESET# 68 USBLED1 / SPISI 69 USBLED2 / SPICK 70 USBLED3 / SPISO 71 USBLED4 / SPICS 72


# USB3.2 TYPE-A x2 (A)


# USB3.2 TYPE-A x2 (B)


# HDMI Connector


# CSI CAM CONNECTOR

# J12 YL002-007


# Gigabit Ethernet with PoE

SHIELD_1 19 | SHIELD_2 20 | MCT_1 4 | MCT_2 5


reComputer J401 15 Gigabit Ethernet, Type C

# M.2 KEY-E (WIFI/BT)

LED1# (I)(OD) 6 PCM_CLK/I2S_SCK(I/O)(0/1.8V) 8 PCM_SYNC/I2S_WS(I/O)(0/1.8V) 10 PCM_IN/I2S_SD_IN(I)(0/1.8V) 12 PCM_OUT/I2S_SD_OUT(O)(0/1.8V) 14 LED2#(I)(OD) 16 GND 18 UART_WAKE#(I)(0/3.3V) 20 UART_RXD(I)(0/1.8V) 22 UART_TXD(O)(0/1.8V) 32 UART_CTS(I)(0/1.8V) 34 UART_RTS(O)(0/1.8V) 36 VENDOR_DEFINED1 38 VENDOR_DEFINED2 40 VENDOR_DEFINED3 42 COEX3(I/O)(0/1.8V) 44 COEX2(I/O)(0/1.8V) 46 COEX1(I/O)(0/1.8V) 48 SUSCLK(32kHz) (O)(0/3.3V) 50 PERST0#(O)(0/3.3V) 52 W_DISABLE2#(O)(0/3.3V) 54 W_DISABLE1#(O)(0/3.3V) 56 I2C_DATA(I/O)(0/1.8V) 58 I2C_CLK(O)(0/1.8V) 60 ALERT#(I)(0/1.8V) 62 RSVD 64 UIM_SWP/PERST1# 66 UIM_POWER_SNK/CLKREQ1# 68 UIM_POWER_SRC/GPIO1/PEWAKE1# 70 3.3V 72 3.3V 74 SH¹ ⁷⁶ SH² ⁷⁷


Place R126 R128 in the bottom of PCB

reComputer J401 16 M.2 KEY-E (WIFI/BT)

# M.2 KEY-M (NVME)

R112 | 0R DNP R268 | 27R


# 40PIN GPIO EXPANSION HEADER & LEVEL SHIFTERS

# U19 TXB0108RGYR


IDEAL DIODE USED TO BLOCK BACK POWER

reComputer J401 18 40Pin GPIO Expansion Header

# SoC Fan Header 4pin

# Carrier Board Config


reComputer J401 19 Fan, Debug and EEPROM
