Seeed-Studio/OSHW-Jetson-Series/(list of files, drawings)

Other design files:
reComputer Jetson carrier board/reComputer J202/Schematic/reComputer J202_V1.0.DSN
reComputer Jetson carrier board/reComputer J401/Schematic/reComputer J401_V1.0.DSN
