Seeed-Studio/OSHW-Jetson-Series/(commit log)

2024-07-09 The first version of the repository was created and the home page Readme was updated.
    [reComputer J202_V1.0.DSN, reComputer J401_V1.0.DSN]
2024-07-09 Add reComputer J202 Readme
    [reComputer J202_V1.0.DSN, reComputer J401_V1.0.DSN]
2026-10-08 resources: upload reComputer & reServer Jetson carrier board content
    [203_paba.stp, 603.stp, A203_Mini_PC_3D.stp, A203_V2_BOTTOM.dwg, A203_V2_top.dwg, A205E_Mini_PC_3D.stp, A205E_PCBA_3D.stp, A205_BOTTOM.dwg]
2026-10-08 resources: remove erroneous DualMCU/ESP32 docs from reComputer J501
2026-10-08 resources: organize 3D models, dedupe cross-folder copies, remove A206 files from A203 v2
    [203_paba.stp, 603.stp, A206_BOTTOM.dwg, A206_TOP.dwg, A603_pcba.stp, A607_pcba.stp, A608_3D_File.stp, FL_A205_PCBA_3D.stp]
2026-10-08 resources: categorize remaining files into Schematic/Manual/Mechanical dirs
    [A203_V2_BOTTOM.dwg, A203_V2_top.dwg, A205_BOTTOM.dwg, A205_TOP.dwg, A206_BOTTOM.dwg, A206_TOP.dwg]
2026-10-08 ci: use static product list, drop wiki from repo; fix push to HEAD:main
    [products.tsv]
2026-10-09 chore: gitignore Resources/scripts, remove local tooling & sync workflow
    [products.tsv]
